imagestream/kicad/AP2000/README.TXT

These files have been created in prerelease version 6 of KiCAD. If Version 6 isn't released yet then to use them you will need to download a nightly build of KiCAD. NB Nightly builds my have issues so please check the issue tracker.   

To generate proper SMT positioning file for JLCPCB use this script:
~/JLCKicadTools//jlc_kicad_tools/generate_jlc_files.py -n AP3500 .
