imagestream/kicad/AP2100.ls1043/docs/AP2100-timeline-10-16.pdf

| | | 5/20 6/20 7/20 8/20 9/20 10/20 11/20 12/20
20 | 25 | 1 | 8 | 15 | 22 | 29 | 6 | 13 | 20 | 27 | 3 | 10 | 17 | 24 | 31 | 7 | 14 | 21 | 28 | 5 | 12 | 19 | 26 | 2 | 9 | 16 | 23 | 30 | 7 | 14
AP2100 | 0h | 60%
Block design | 0h | 100%
Initial design discussions, specificati... | 0 | 100%
CAD program evaluation | 0 | 100%
BOM / Parts management evaluation | 0 | 100%
KiCad training | 0 | 100%
Initial project setup, cad symbol libra... | 0 | 100%
Power requirements / spec design | 0 | 100%
Requirements review / refinement wi... | 0 | 100%
PoE block | 0 | 100%
Power block | 0 | 100%
Memory block | 0 | 100%
Add missing voltages to power | 0 | 100%
eMMC flash block | 0 | 100%
CPU Power Block | 0 | 100%
Camera research | 0 | 100%
JTAG / Serial / Reset block | 0 | 100%
USB | 0 | 100%
Ethernet block | 0 | 100%
mPCIe block | 0 | 100%
Mounting holes / heatsink block | 0 | 100%
Review | 0 | 100%
Layout / Routing | 0h | 23%
PoE | 0 | 100%
Power | 0 | 20%
Ethernet | 0 | 0%
eMMC flash | 0 | 0%
Memory | 0 | 0%
USB | 0 | 0%
JTAG / Serial | 0 | 0%
Camera mounting | 0 | 0%
Review | 0 | 0%
Production / assembly | 0h | 0%
BOM Parts acquisition 5 units | 0 | 0%
PCB fab - PCBWay | 0 | 0%
PCB assembly 1 unit | 0 | 0%
Debugging / initial turn on | 0 | 0%
Software load / initial testing | 0 | 0%
Rework layout for issues discovered | 0 | 0%
PCB fab - PCBWay | 0 | 0%
PCB assembly 3 units | 0 | 0%
Testing / prep to ship 3 units to Mexi... | 0 | 0%
Software | 0h | 0%
Add custom device tree to Opuntia / ... | 0 | 0%
Custom flash layout for MAC storage... | 0 | 0%
Customize scripts for board | 0 | 0%

Scott Yoder
Scott Yoder
Scott Yoder
Scott Yoder
Scott Yoder
Scott Yoder
Scott Yoder
Scott Yoder
Scott Yoder
Scott Yoder
Scott Yoder
Scott Yoder
Scott Yoder
Josh Snyder, Scott Yoder
Scott Yoder
Scott Yoder
Scott Yoder
Scott Yoder
Scott Yoder
Scott Yoder

Scott Yoder
Scott Yoder
Scott Yoder
Scott Yoder
Scott Yoder
Scott Yoder
Scott Yoder
Scott Yoder
Scott Yoder

Scott Yoder
Scott Yoder
Scott Yoder
Scott Yoder
Josh Snyder, Scott Yoder
Scott Yoder
Scott Yoder
Scott Yoder
Scott Yoder

Scott Yoder
Scott Yoder
Scott Yoder

20 | 25 | 1 | 8 | 15 | 22 | 29 | 6 | 13 | 20 | 27 | 3 | 10 | 17 | 24 | 31 | 7 | 14 | 21 | 28 | 5 | 12 | 19 | 26 | 2 | 9 | 16 | 23 | 30 | 7 | 14
5/20 | 6/20 | 7/20 | 8/20 | 9/20 | 10/20 | 11/20 | 12/20
Make custom U-boot | 0 | 0%
Camera software | 0 | 0%
Security chip programming | 0 | 0%
Production system integrations | 0 | 0%
Unrelated tasks | 0h | 100%
Reinstall / fix Queretero Cloud | 0 | 100%
Envoy-based Prototype | 0 | 100%

Scott Yoder
Scott Yoder
Scott Yoder
Scott Yoder

Scott Yoder
Scott Yoder

Powered by TCPDF (www.tcpdf.org)
