imagestream/kicad/AP2100.ls1043/docs/AP2100-timeline-09-23.pdf

20 | 25 | 1 | 8 | 15 | 22 | 29 | 6 | 13 | 20 | 27 | 3 | 10 | 17 | 24 | 31 | 7 | 14 | 21 | 28 | 5 | 12 | 19 | 26 | 2 | 9 | 16 | 23 | 30 | 7
5/20 | 6/20 | 7/20 | 8/20 | 9/20 | 10/20 | 11/20 | 12/20
AP2100 | 52%
Block design | 84%
Initial design discussions, specificati... | 100%
CAD program evaluation | 100%
BOM / Parts management evaluation | 100%
KiCad training | 100%
Initial project setup, cad symbol libra... | 100%
Power requirements / spec design | 100%
Requirements review / refinement wi... | 100%
PoE block | 100%
Power block | 100%
Memory block | 100%
Add missing voltages to power | 100%
eMMC flash block | 100%
CPU Power Block | 100%
Camera research | 100%
JTAG / Serial / Reset block | 20%
USB | 0%
Ethernet block | 0%
mPCIe block | 0%
Mounting holes / heatsink block | 0%
Review | 0%
Layout / Routing | 0%
Memory | 0%
eMMC flash | 0%
Ethernet | 0%
USB | 0%
MIPI | 0%
JTAG / Serial | 0%
PoE | 0%
Power | 0%
Camera mounting | 0%
Review | 0%
Production / assembly | 0%
BOM Parts acquisition 5 units | 0%
PCB fab - PCBWay | 0%
PCB assembly 1 unit | 0%
Debugging / initial turn on | 0%
Software load / initial testing | 0%
Rework layout for issues discovered | 0%
PCB fab - PCBWay | 0%
PCB assembly 3 units | 0%
Testing / prep to ship 3 units to Mexi... | 0%
Software | 0%
Add custom device tree to Opuntia / ... | 0%
Custom flash layout for MAC storage... | 0%

Scott Yoder
Scott Yoder
Scott Yoder
Scott Yoder
Scott Yoder
Scott Yoder
Scott Yoder
Scott Yoder
Scott Yoder
Scott Yoder
Scott Yoder
Scott Yoder
Scott Yoder
Scott Yoder
Scott Yoder
Scott Yoder
Scott Yoder
Scott Yoder
Scott Yoder
Scott Yoder

Scott Yoder
Scott Yoder
Scott Yoder
Scott Yoder
Scott Yoder
Scott Yoder
Scott Yoder
Scott Yoder
Scott Yoder
Scott Yoder

Scott Yoder
Scott Yoder
Scott Yoder
Scott Yoder
Scott Yoder
Scott Yoder
Scott Yoder
Scott Yoder
Scott Yoder

Scott Yoder
Scott Yoder

20 | 25 | 1 | 8 | 15 | 22 | 29 | 6 | 13 | 20 | 27 | 3 | 10 | 17 | 24 | 31 | 7 | 14 | 21 | 28 | 5 | 12 | 19 | 26 | 2 | 9 | 16 | 23 | 30 | 7
5/20 | 6/20 | 7/20 | 8/20 | 9/20 | 10/20 | 11/20 | 12/20
Customize scripts for board | 0%
Make custom U-boot | 0%
Camera software | 0%
Security chip programming | 0%
Production system integrations | 0%
Unrelated tasks | 100%
Reinstall / fix Queretero Cloud | 100%
Envoy-based Prototype | 100%

Scott Yoder
Scott Yoder
Scott Yoder
Scott Yoder
Scott Yoder

Scott Yoder
Scott Yoder

Powered by TCPDF (www.tcpdf.org)
