imagestream/kicad/AP2100.ls1043/docs/AP2100-timeline.pdf

| | | 5/20 6/20 7/20 8/20 9/20 10/20 11/20
20 | 25 | 1 | 8 | 15 | 22 | 29 | 6 | 13 | 20 | 27 | 3 | 10 | 17 | 24 | 31 | 7 | 14 | 21 | 28 | 5 | 12 | 19 | 26 | 2 | 9 | 16 | 23
AP2100 | 0h | 33%
Block design | 0h | 80%
Initial design discussions, specificati... | 0 | 100%
CAD program evaluation | 0 | 100%
BOM / Parts management evaluation | 0 | 100%
KiCad training | 0 | 100%
Initial project setup, cad symbol libra... | 0 | 100%
Power requirements / spec design | 0 | 100%
Requirements review / refinement wi... | 0 | 100%
PoE block | 0 | 100%
Power block | 0 | 100%
Memory block | 0 | 100%
eMMC flash block | 0 | 30%
JTAG / Serial / Reset block | 0 | 0%
USB / mipi block | 0 | 0%
Ethernet block | 0 | 0%
mPCIe block | 0 | 0%
Mounting holes / heatsink block | 0 | 0%
Review | 0 | 0%
Layout / Routing | 0h | 0%
Memory | 0 | 0%
eMMC flash | 0 | 0%
Ethernet | 0 | 0%
USB | 0 | 0%
MIPI | 0 | 0%
JTAG / Serial | 0 | 0%
PoE | 0 | 0%
Power | 0 | 0%
Review | 0 | 0%
Production / assembly | 0h | 0%
BOM Parts acquisition 5 units | 0 | 0%
PCB fab - PCBWay | 0 | 0%
PCB assembly 1 unit | 0 | 0%
Debugging / initial turn on | 0 | 0%
Software load / initial testing | 0 | 0%
Rework layout for issues discovered | 0 | 0%
PCB fab - PCBWay | 0 | 0%
PCB assembly 3 units | 0 | 0%
Testing / prep to ship 3 units to Mexi... | 0 | 0%
Software | 0h | 0%
Add custom device tree to Opuntia / ... | 0 | 0%
Custom flash layout for MAC storage... | 0 | 0%
Customize scripts for board | 0 | 0%
Make custom U-boot | 0 | 0%
Security chip programming | 0 | 0%
Production system integrations | 0 | 0%

Scott Yoder
Scott Yoder
Scott Yoder
Scott Yoder
Scott Yoder
Scott Yoder
Scott Yoder
Scott Yoder
Scott Yoder
Scott Yoder
Scott Yoder
Scott Yoder
Scott Yoder
Scott Yoder
Scott Yoder
Scott Yoder
Scott Yoder

Scott Yoder
Scott Yoder
Scott Yoder
Scott Yoder
Scott Yoder
Scott Yoder
Scott Yoder
Scott Yoder
Scott Yoder

Scott Yoder
Scott Yoder
Scott Yoder
Scott Yoder
Scott Yoder
Scott Yoder
Scott Yoder
Scott Yoder
Scott Yoder

Scott Yoder
Scott Yoder
Scott Yoder
Scott Yoder
Scott Yoder
Scott Yoder

Powered by TCPDF (www.tcpdf.org)
