imagestream/kicad/AP2100.ls1043/docs/Future-For-ImageStream-5.pdf

CONFIDENTIAL | 1

# Future Electronics Intelligent Solutions For IS ImageStream Internet Solutions

# WiFi AP / Router June 2, 2020

## Michael.Leung@FutureElectronics.com

# http://www.imagestream.com/ Selma, Texas

# Imagestream Team

# Scott Yoder, syoder@imagestream.com Josh Snyder, josh@imagestream.com

# Carlos.Martinez@FutureElectronics.com, Strategic Account Manager Puspa.Kunwor@FutureElectronics.com, Applications Engineer

Erwin.Wolniewitz@FutureElectronics.com, Regional Sales Manager, Future Intelligent Solutions

# Michael.Leung@FutureElectronics.com, Networking Specialist, Future Intelligent Solutions

# Requirements

# - SFP+ - 2.5G PoE (802.at) - GigE - 2 mPCIe to 3 mPCIe - 1 GB DDR to 2GB - Unique ID, to generate unique password per device - WiFI Modules

- 88w9064
- 88w8964

# - OpenWRT - Open vSwitch

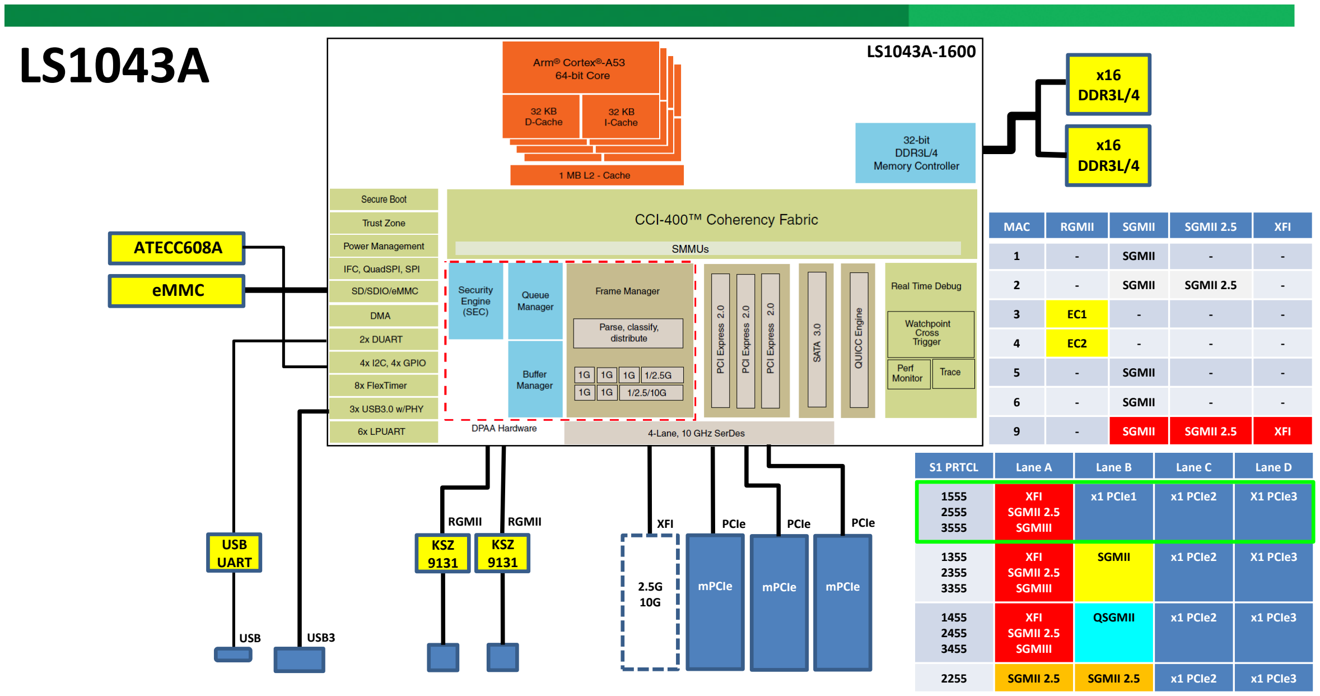
[picture p1: figure]
eMMC; mPCIe; USB; USB3; S1 PRTCL; Lane A; Lane B; Lane C; Lane D; XFI SGMII 2.5 SGMIII; x1 PCIe1; x1 PCIe2; X1 PCIe3; SGMII; QSGMII; x1 PCIe3; SGMII 2.5; RGMII; KSZ 9131; PCIe; MAC; XFI; x16 DDR3L/4; ATECC608A; USB UART

# Design Details

# LS1043A

### LS1043A-1600

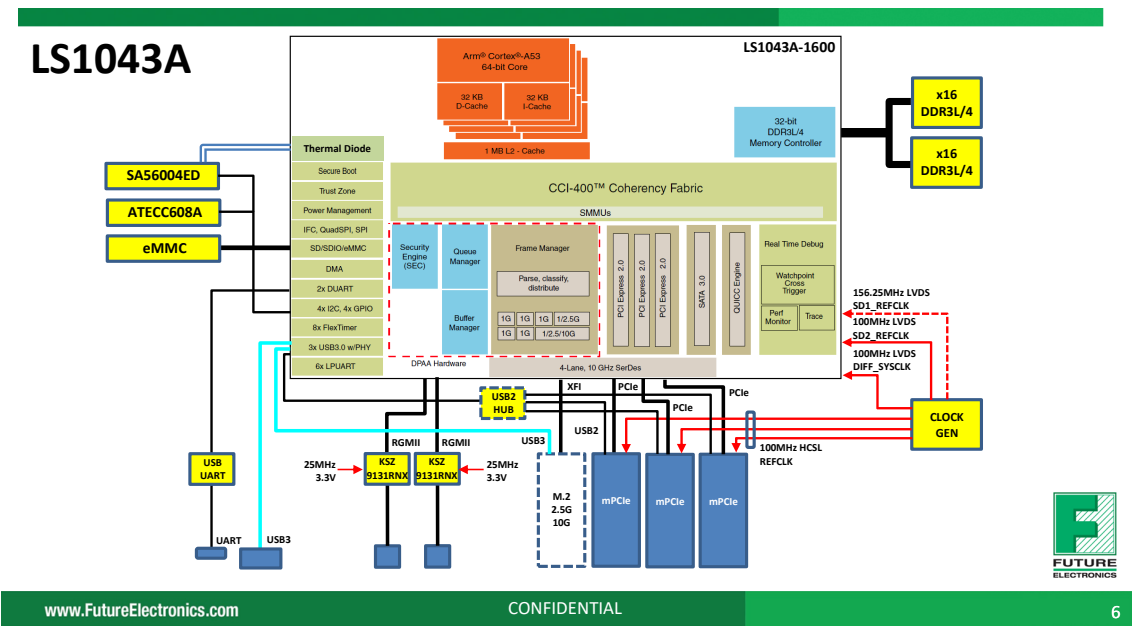
[picture p2: page 6]
eMMC; mPCIe; UART; USB3; RGMII; KSZ 9131RNX; PCIe; x16 DDR3L/4; ATECC608A; XFI; CLOCK; USB2; GEN; USB UART; USB2 HUB; 100MHz HCSL REFCLK; Thermal Diode; 100MHz LVDS SD2_REFCLK; 156.25MHz LVDS SD1_REFCLK; 100MHz LVDS DIFF_SYSCLK; 25MHz 3.3V

# LS1043A Clocks

156.25

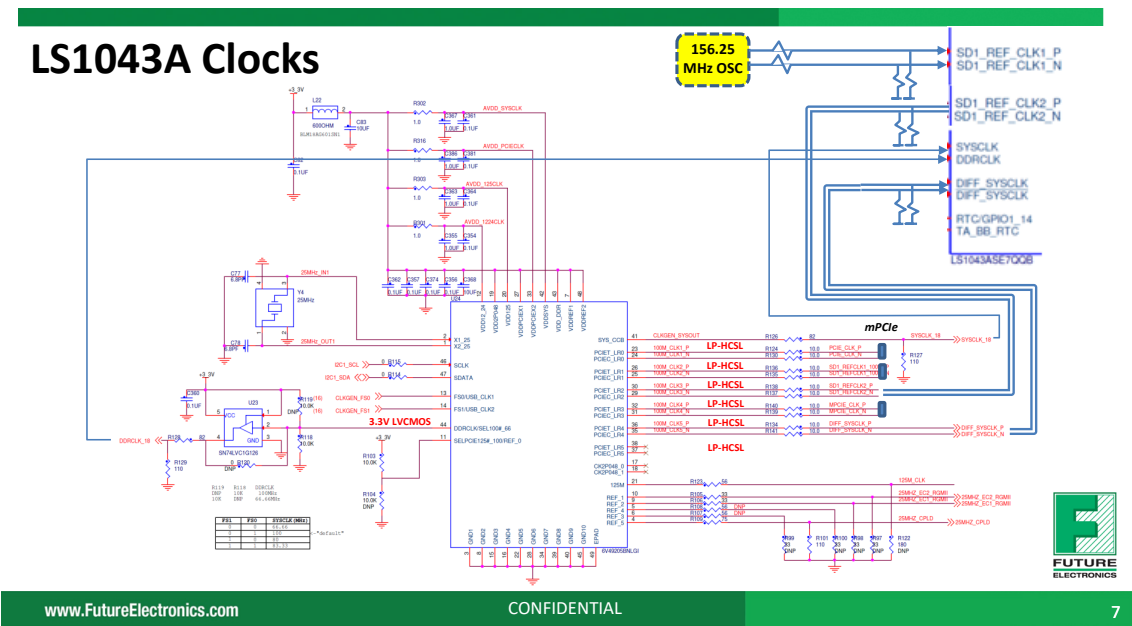
[picture p3: page 7]
mPCIe; MHz OSC; 3.3V LVCMOS; LP-HCSL

MFR | Qty | Devices (all commercial Temp) | Description | Stuffing Option
NXP | 1 | LS1043ASN7KQB LS1043ASN7MQB LS1043ASN7PQB LS1043ASN7QQB | LS1043A-1000, DDR-1600, (use ASE if crypto rqd) LS1043A-1200, DDR-1600, (use ASE if crypto rqd) LS1043A-1400, DDR-1600, (use ASE if crypto rqd) LS1043A-1600, DDR-1600, (use ASE if crypto rqd)
Kingston | 1 | EMMC04G-M627 | 4GB eMMC
Alliance Memory Alliance Memory Kingston Kingston ------------------------------Alliance Memory Kingston Samsung | 2 AS4C512M16D3LC-12BCN | AS4C512M16D3L-12BCN D2516ECBDXGGGB-U B5116ECMDXGGB-U -----------------------------------------------------------------AS4C256M16D4-93BCN D2516ACPCXGPH-U K4A8G165WC-BCRC | 4Gbit DDR3L (256Mx16)-1600 8Gbit DDR3L (512Mx16)-1600 4Gbit DDR3L (256Mx16)-1600 8Gbit DDR3L (512Mx16)-1600 ---------------------------------------------------------------------4Gbit DDR4 (256Mx16)-2400 4Gbit DDR4 (256Mx16)-2400 8Gbit DDR4 (512Mx16)-2400
Microchip | 1 | ATECC608A-TFLXTLSU | Secure Element (TrustFlexTLS Provisioned) UDFN
Microchip | 2 | KSZ9131RNX | RGMII GigE PHY
NXP Onsemi | 1 SA56004AD | ADM1032ARZ | Remote and Local Thermal Monitor (± 1⁰C)
FTDI Microchip | 1 FT230XQ | MCP2200-I/MQ | USB UART
Microchip | 1 | USB2513B/M2 USB2514B/M2 | 3-port USB2 Hub 4-port USB2 Hub | Optional
Renesas/IDT | 1 | 6V49205BNLGI | Clock Generator
Renesas/IDT | 1 | XUN515156.250000 | 156.25MHz HCSL Osc, Pin 1 Enb, 1.8V, 50ppm, 400fs,5x3mm | Optional
| 3 mPCIe Socket
| 1 | | M.2 Socket | Optional

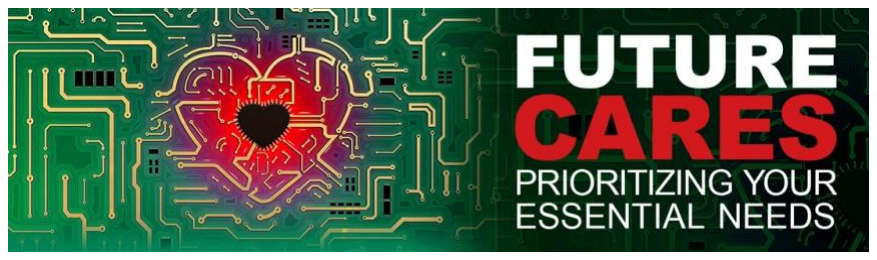
[picture p4: figure]
