imagestream/kicad/AP2000/Labels/TopLabel-Body.pdf

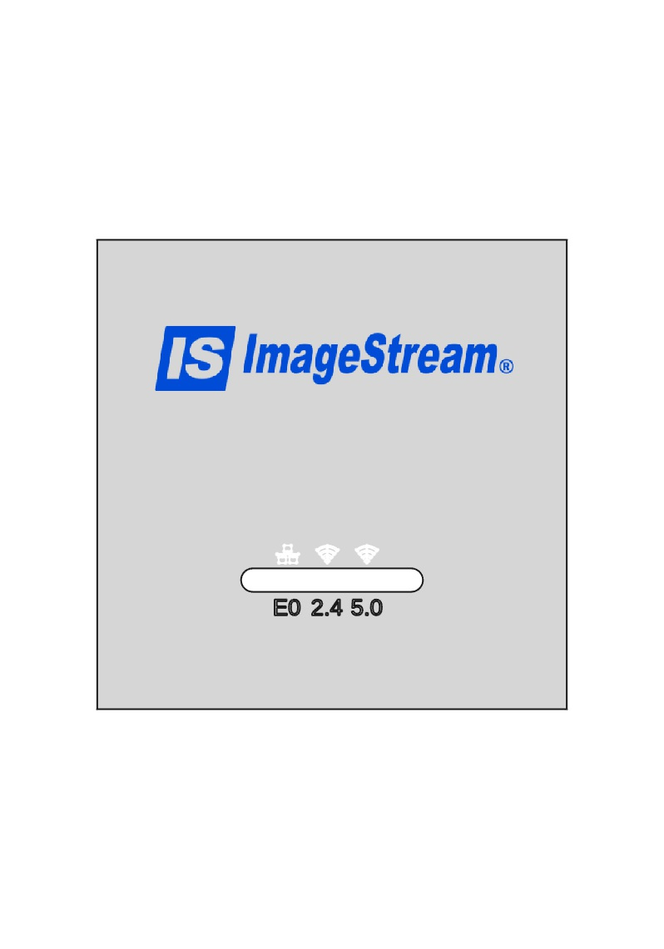
[picture p5: page 1]
