imagestream/kicad/AP2100.ls1043/docs/Future-For-ImageStream-3.pdf

CONFIDENTIAL | 1

# Future Electronics Intelligent Solutions For IS ImageStream Internet Solutions

# WiFi AP / Router May 22, 2020

# Michael.Leung@FutureElectronics.com

# http://www.imagestream.com/ Selma, Texas

# Imagestream Team

# Scott Yoder, syoder@imagestream.com Josh Snyder, josh@imagestream.com

# Carlos.Martinez@FutureElectronics.com, Strategic Account Manager Puspa.Kunwor@FutureElectronics.com, Applications Engineer

Erwin.Wolniewitz@FutureElectronics.com, Regional Sales Manager, Future Intelligent Solutions

# Michael.Leung@FutureElectronics.com, Networking Specialist, Future Intelligent Solutions

# Requirements

# - SFP+ - 2.5G PoE (802.at) - GigE - 2 mPCIe to 3 mPCIe - 1 GB DDR to 2GB - Unique ID, to generate unique password per device - WiFI Modules

- 88w9064
- 88w8964

# - OpenWRT - Open vSwitch

# Options

# Low End - LS1012A

# High End - LS1023A/LS1043A - LS1026A/LS1046A

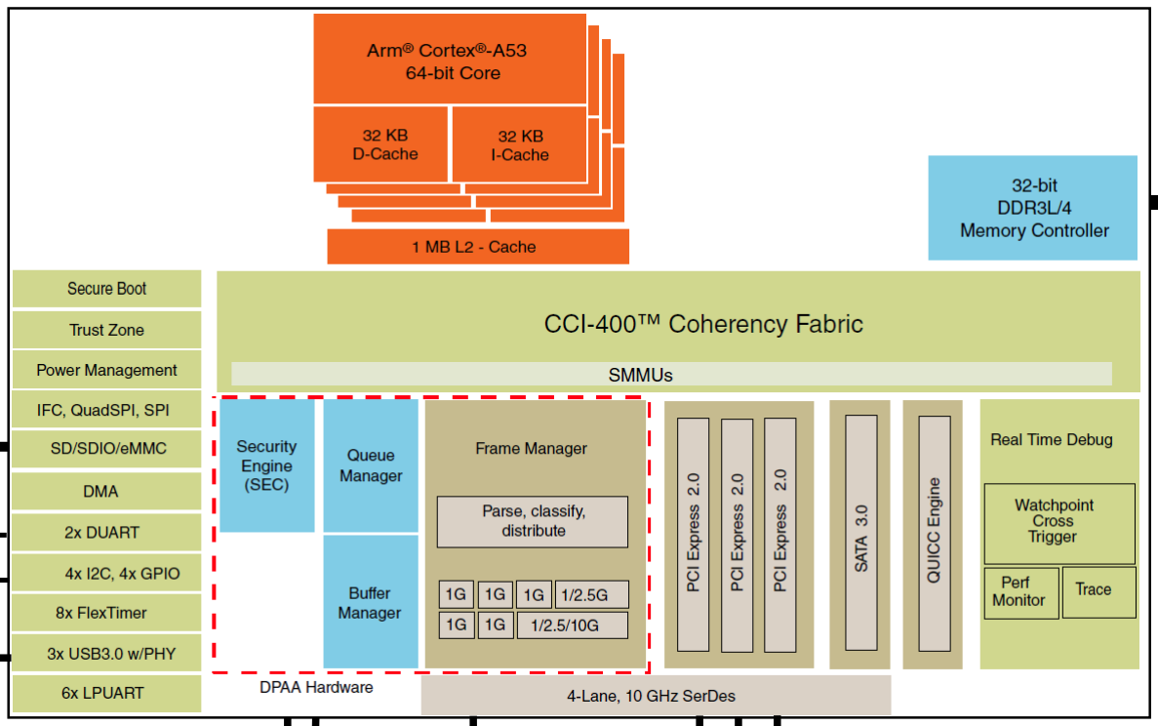
[picture p6: figure]

## eMMC

1/2.5G/
10G
SFP+

1/2.5G
SFP

M.2/
mPCIe

UART USB3

VSC
7224

M.2/
mPCIe
S1 PRTCL | Lane A | Lane B | Lane C | Lane D
1555 2555 3555 | XFI SGMII 2.5 SGMIII | x1 PCIe1 | x1 PCIe2 | X1 PCIe3
1355 2355 3355 | XFI SGMII 2.5 SGMIII | SGMII | x1 PCIe2 | X1 PCIe3
1455 2455 3455 | XFI SGMII 2.5 SGMIII | QSGMII | x1 PCIe2 | x1 PCIe3
2255 | SGMII 2.5 | SGMII 2.5 | x1 PCIe2 | x1 PCIe3
RGMII | RGMII
KSZ
9131

KSZ
9131

XFI

PCIe | PCIe

M.2/
mPCIe

PCIe

MAC | RGMII | SGMII | SGMII 2.5 | XFI
1 | - | SGMII | - | -
2 | - | SGMII | SGMII 2.5 | -
3 | EC1 | - | - | -
4 | EC2 | - | - | -
5 | - | SGMII | - | -
6 | - | SGMII | - | -
9 | - | SGMII | SGMII 2.5 | XFI

# [1] LS1043A

x16

### DDR3L/4

x16

### DDR3L/4

## ATECC608A

802.3at
PoE PD

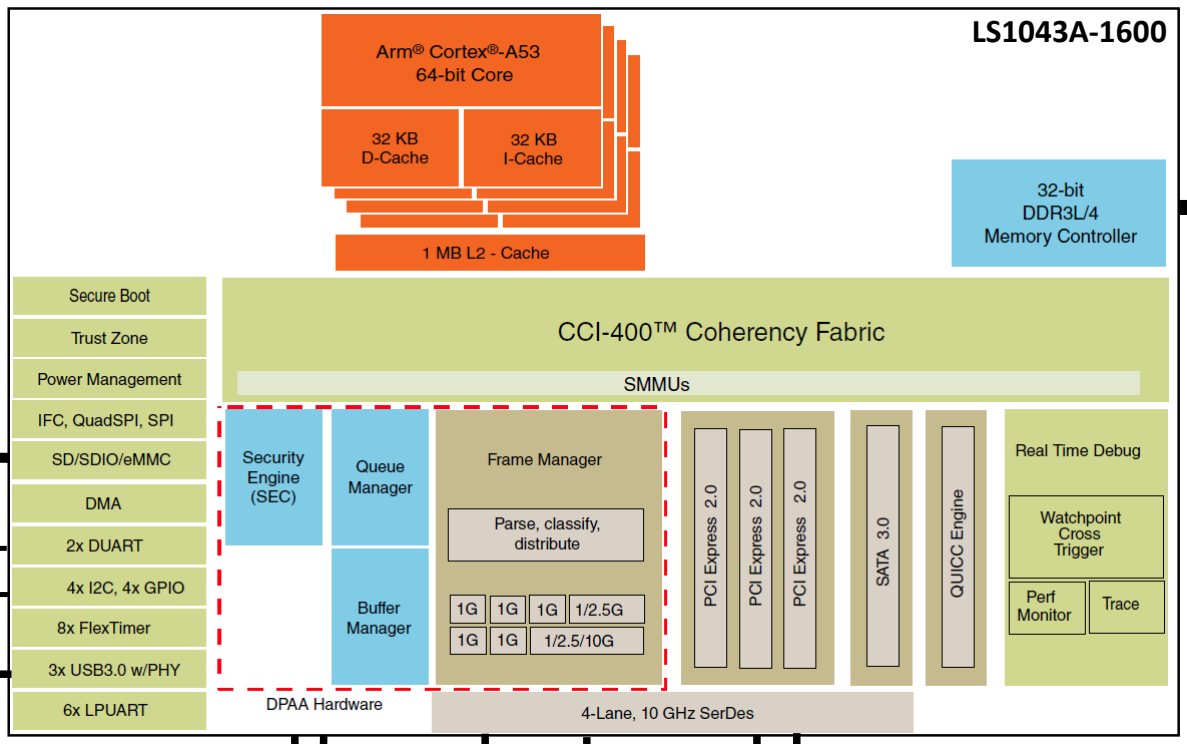
[picture p7: figure]

## eMMC

1/2.5G/
10G
SFP+

M.2/
mPCIe

UART USB3

VSC
7224

M.2/
mPCIe
S1 PRTCL | Lane A | Lane B | Lane C | Lane D
1555 2555 3555 | XFI SGMII 2.5 SGMIII | x1 PCIe1 | x1 PCIe2 | X1 PCIe3
1355 2355 3355 | XFI SGMII 2.5 SGMIII | SGMII | x1 PCIe2 | X1 PCIe3
1455 2455 3455 | XFI SGMII 2.5 SGMIII | QSGMII | x1 PCIe2 | x1 PCIe3
RGMII | RGMII
KSZ
9131

KSZ
9131

XFI

PCIe | PCIe
MAC | RGMII | SGMII | SGMII 2.5 | XFI
1 | - | SGMII | - | -
2 | - | SGMII | SGMII 2.5 | -
3 | EC1 | - | - | -
4 | EC2 | - | - | -
5 | - | SGMII | - | -
6 | - | SGMII | - | -
9 | - | SGMII | SGMII 2.5 | XFI

1/2.5G
SFP

AQR
109

1000BASE-T

# [2] LS1043A

x16

### DDR3L/4

x16

### DDR3L/4

## ATECC608A

802.3at
PoE PD

## eMMC

1/2.5G
SFP

M.2/
mPCIe

UART USB3

VSC
7224

M.2/
mPCIe
S1 PRTCL | Lane A | Lane B | Lane C | Lane D
1555 2555 3555 | XFI SGMII 2.5 SGMIII | x1 PCIe1 | x1 PCIe2 | X1 PCIe3
1355 2355 3355 | XFI SGMII 2.5 SGMIII | SGMII | x1 PCIe2 | X1 PCIe3
1455 2455 3455 | XFI SGMII 2.5 SGMIII | QSGMII | x1 PCIe2 | x1 PCIe3
RGMII | RGMII
KSZ
9131

KSZ
9131

XFI

PCIe | PCIe
MAC | RGMII | SGMII | SGMII 2.5 | XFI
1 | - | SGMII | - | -
2 | - | SGMII | SGMII 2.5 | -
3 | EC1 | - | - | -
4 | EC2 | - | - | -
5 | - | SGMII | - | -
6 | - | SGMII | - | -
9 | - | SGMII | SGMII 2.5 | XFI

1/2.5G
SFP

AQR
109

2.5GBASE-T

# [3] LS1043A

x16

### DDR3L/4

x16

### DDR3L/4

## ATECC608A

802.3at
PoE PD

1/2.5G
SFP

AQR
109

1000BASE-T

## eMMC

1/2.5G/
10G
SFP+

M.2/
mPCIe

UART USB3

VSC
7224

M.2/
mPCIe
S1 PRTCL | Lane A | Lane B | Lane C | Lane D
1555 2555 3555 | XFI SGMII 2.5 SGMIII | x1 PCIe1 | x1 PCIe2 | X1 PCIe3
1355 2355 3355 | XFI SGMII 2.5 SGMIII | SGMII | x1 PCIe2 | X1 PCIe3
1455 2455 3455 | XFI SGMII 2.5 SGMIII | QSGMII | x1 PCIe2 | x1 PCIe3
RGMII | RGMII
KSZ
9131

KSZ
9131

XFI

PCIe | PCIe

M.2/
mPCIe

PCIe

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

# [4] LS1043A

x16

### DDR3L/4

x16

### DDR3L/4

## ATECC608A

802.3at
PoE PD

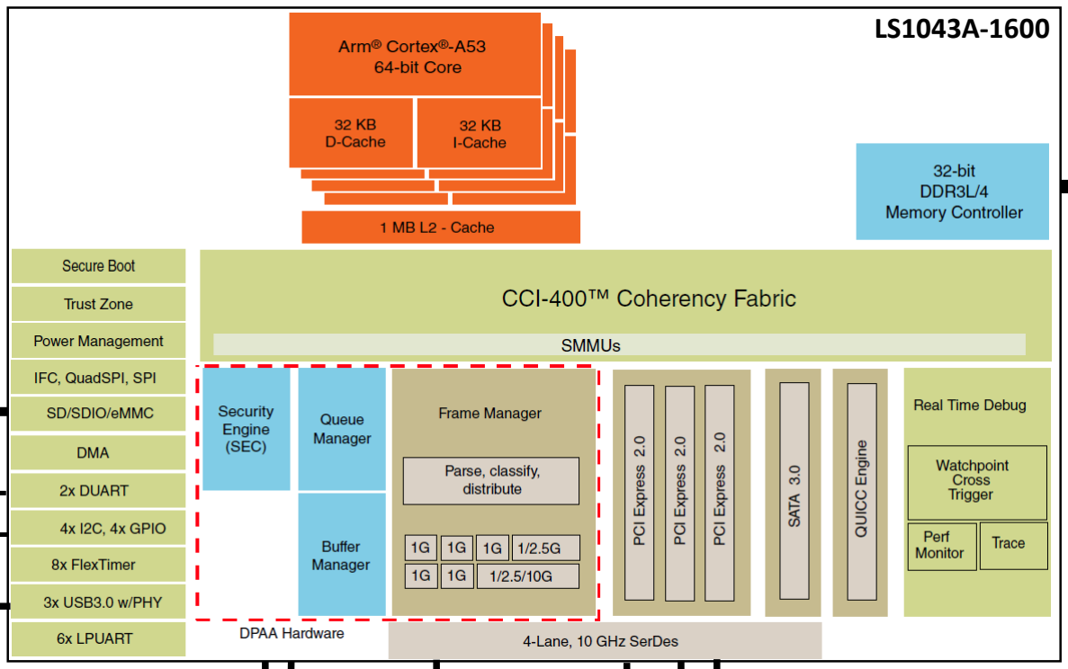
[picture p8: figure]

# [5] LS1043A

AQR
107/9

nBASE-T

## eMMC

1/2.5G/
10G
SFP+

M.2/
mPCIe

UART USB3

VSC
7224

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

KSZ
9131
PCIe | PCIe

M.2/
mPCIe

PCIe

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

x16

### DDR3L/4

x16

### DDR3L/4

## ATECC608A

802.3at
PoE PD

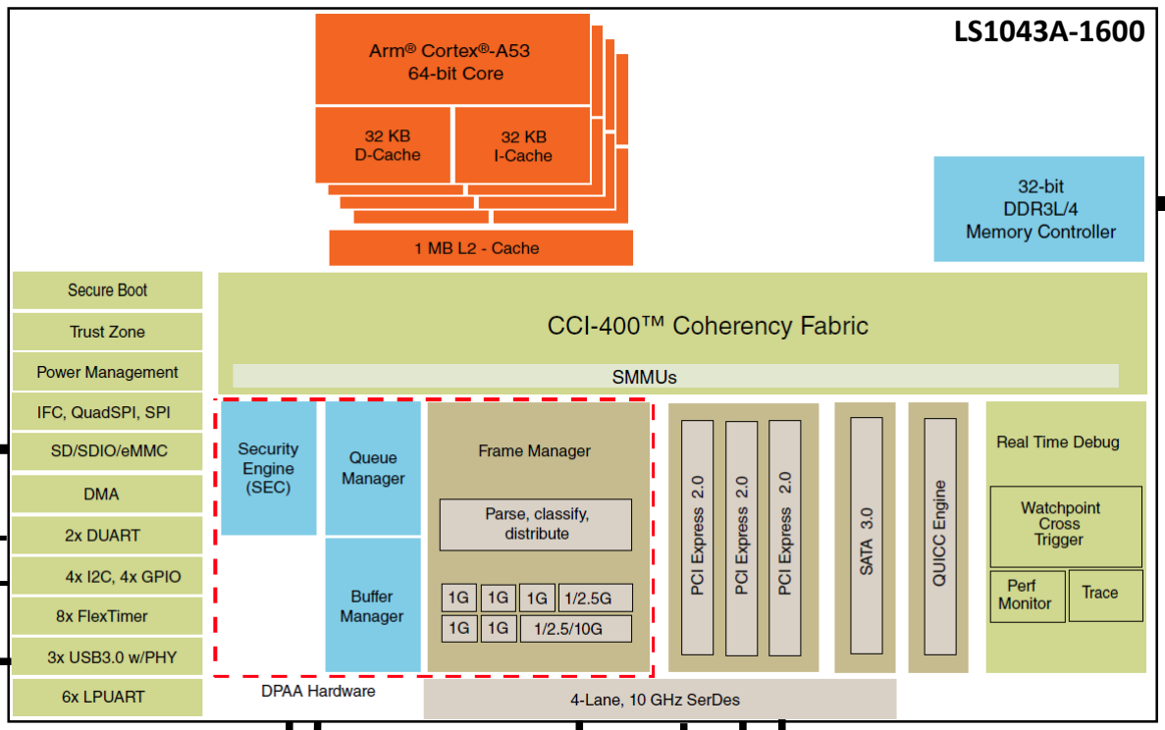
[picture p9: figure]

1/2.5G
SFP

AQR
107/9

10GBASE-T
2.5GBASE-T

## eMMC

M.2/
mPCIe

UART USB3

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

KSZ
9131
PCIe | PCIe

M.2/
mPCIe

PCIe

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

# [6] LS1043A

x16

### DDR3L/4

x16

### DDR3L/4

## ATECC608A

802.3at
PoE PD

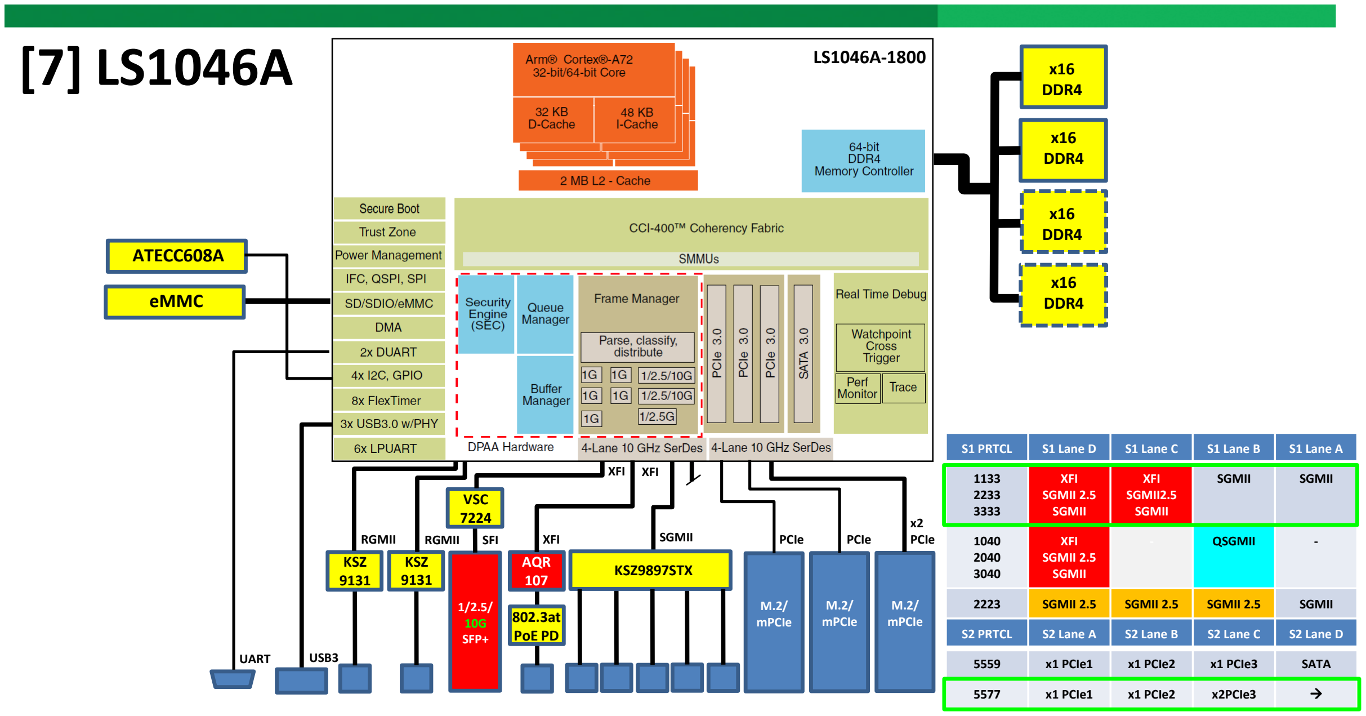
[picture p10: figure]
S2 PRTCL; S2 Lane A; S2 Lane B; S2 Lane C; S2 Lane D; x1 PCIe1; x1 PCIe2; x1 PCIe3; SATA; x2PCIe3; eMMC; 1/2.5/ 10G SFP+; UART; USB3; S1 PRTCL; S1 Lane D; S1 Lane C; S1 Lane B; S1 Lane A; XFI SGMII 2.5 SGMII; XFI SGMII2.5 SGMII; SGMII; QSGMII; SGMII 2.5; VSC 7224; M.2/ mPCIe; RGMII; KSZ 9131; XFI; SFI; 1/2.5G SFP; AQR 107; KSZ9897STX; PCIe; x2 PCIe; x16 DDR4; ATECC608A; 802.3at PoE PD

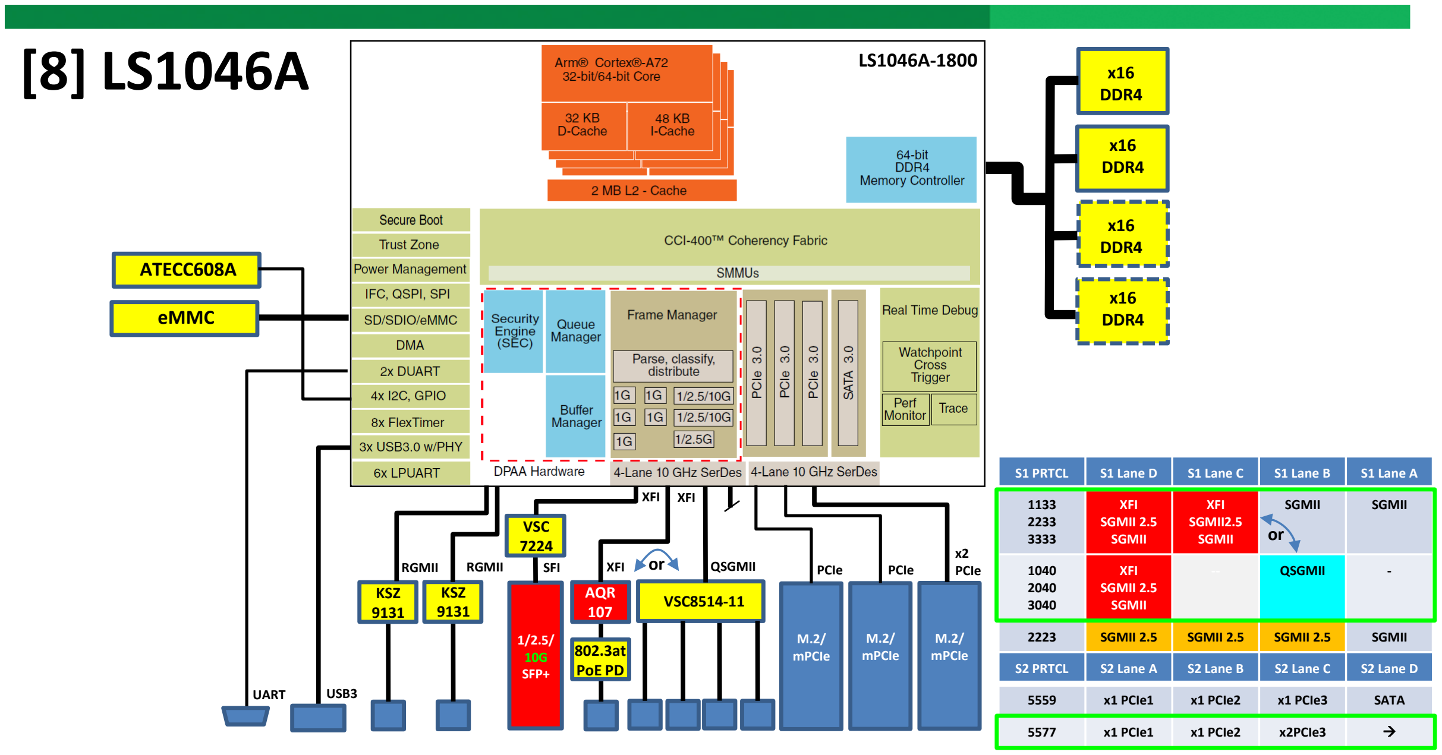
[picture p11: figure]
S2 PRTCL; S2 Lane A; S2 Lane B; S2 Lane C; S2 Lane D; x1 PCIe1; x1 PCIe2; x1 PCIe3; SATA; x2PCIe3; eMMC; 1/2.5/ 10G SFP+; UART; USB3; S1 PRTCL; S1 Lane D; S1 Lane C; S1 Lane B; S1 Lane A; XFI SGMII 2.5 SGMII; XFI SGMII2.5 SGMII; SGMII or; SGMII; QSGMII; SGMII 2.5; VSC 7224; M.2/ mPCIe; RGMII; KSZ 9131; XFI; SFI; 1/2.5G SFP; AQR 107; VSC8514-11; PCIe; x2 PCIe; x16 DDR4; ATECC608A; 802.3at PoE PD

# Summary

Option | 1 | 2 | 3 | 4 | 5 | 6 | 7 | 8
Processor | LS1043A | LS1043A | LS1043A | LS1043A | LS1043A | LS1043A | LS1046A | LS1046A
mPCIe/M.2 | 3 mPCIe | 2 mPCIe | 2 mPCIe | 2/[3]mPCIe | 3 mPCIe | 3 mPCIe | 3 mPCIe | 3 mPCIe
SFP+ | 1G SFP 2.5G SFP 10G SFP+ | 1G SFP 2.5G SFP 10G SFP+ | 1G SFP 2.5G SFP - | 1G SFP 2.5G SFP [10G SFP+] | [1G SFP 2.5G SFP 10G SFP+ ] | - 1G SFP | 2.5G SFP 10G SFP+ | 1G SFP 2.5G SFP 10G SFP+
nBase-T | -- | 1GBase-T - | 1GBase-T 2.5GBase-T | [1GBase-T] [2.5GBase-T] | [1GBase-T 2.5GBase-T 10GBaseT] | 1GBase-T 2.5GBase-T 10GBaseT | 1GBase-T 2.5GBase-T 10GBaseT | [1GBase-T 2.5GBase-T 10GBaseT]
1000Base-T | 2 GigE | 2 GigE | 2 GigE | 2 GigE | 2 GigE | 2 GigE | 2 GigE + 5 Switched | 2+[4] GigE
Notes | | | | Configurable Combo | Either SFP+ or 10GBase-T | | Both SFP+ and 10GBase-T | Either 4 more 1G or 10GBase-T
