imagestream/kicad/AP2000/Labels/AP2000.png

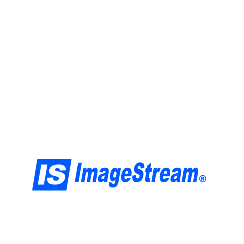
AP2000/Labels/AP2000.png
