imagestream/kicad/AP2000/Labels/TopLabel.FCStd

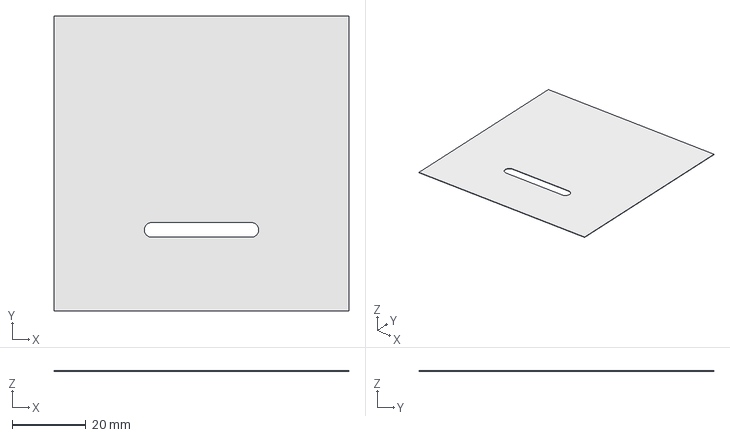
[picture p13: CAD file, 2021-09-24]
AP2000/Labels/TopLabel.FCStd
80.0 x 80.0 x 0.175 mm
