imagestream/kicad/AP2100.ls1043/docs/Enclosure_Top.FCStd

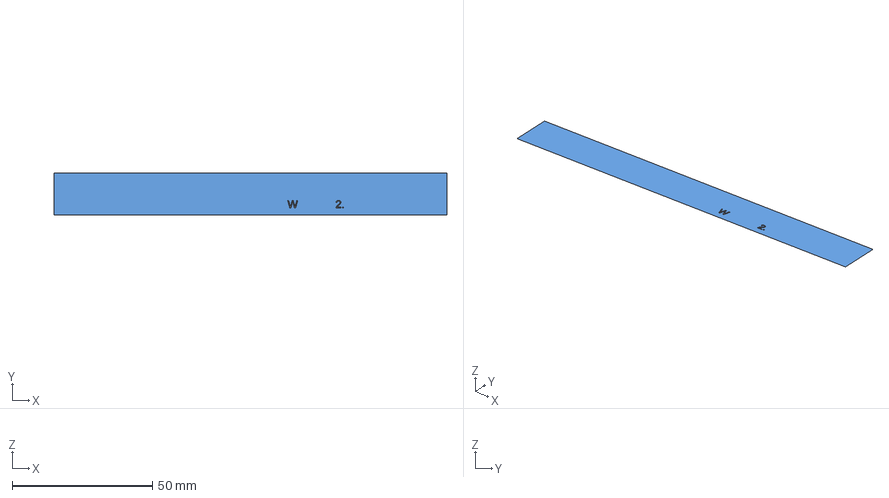
[picture p14: CAD file, 2020-09-23]
AP2100.ls1043/docs/Enclosure_Top.FCStd
140.0 x 15.0 x 0 mm
ShapeString
ShapeString001
ShapeString003
ShapeString002
Rectangle
