imagestream/kicad/AP2000/HeatSink/AP2000_HeatSink.FCStd

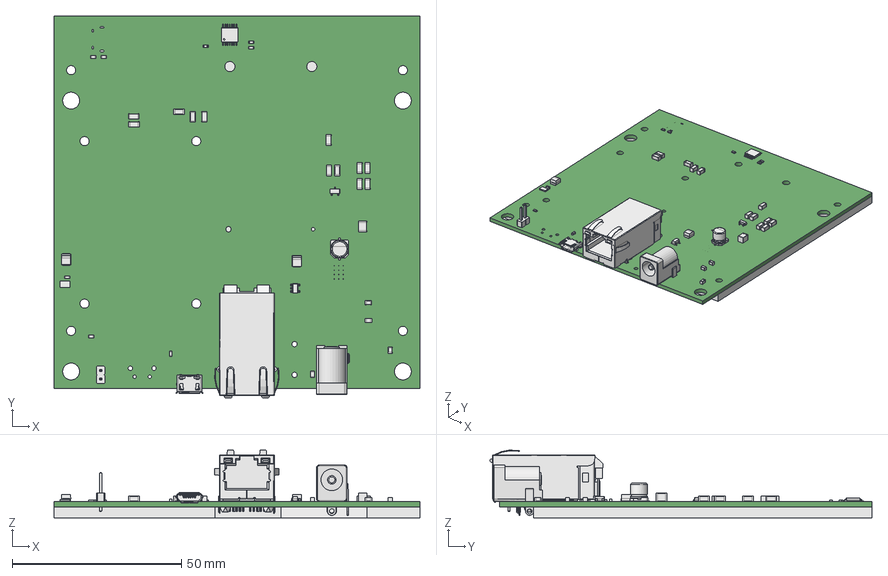
[picture p15: CAD file, 2021-09-24]
AP2000/HeatSink/AP2000_HeatSink.FCStd
108.0 x 112.8 x 20.0 mm
AP2000_PCB
