imagestream/kicad/AP2000/Labels/TopLabel-Body.dxf

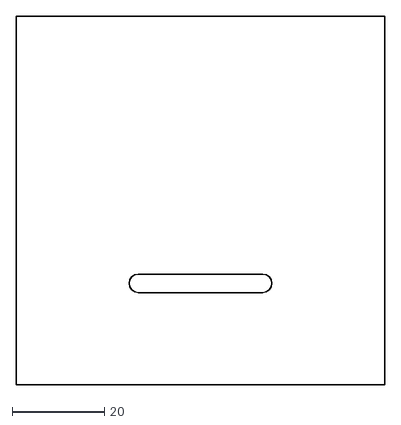
[picture p16: CAD file, 2021-09-24]
AP2000/Labels/TopLabel-Body.dxf
80.0 x 80.0
