imagestream/kicad/AP2100.ls1043/docs/Enclosure Bottom_2020-07-15_19-27-11.dxf

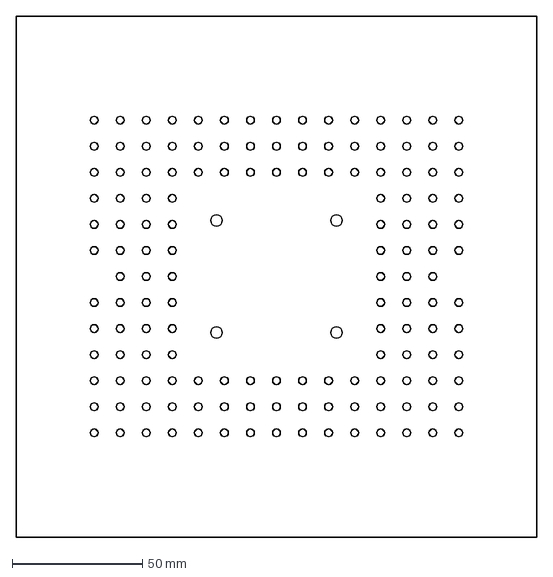
[picture p17: CAD file, 2020-09-23]
AP2100.ls1043/docs/Enclosure Bottom_2020-07-15_19-27-11.dxf
200.0 x 200.0 mm
