imagestream/kicad/AP2000/HeatSink/AP2000_HeatSink-BodyPocket001.dxf

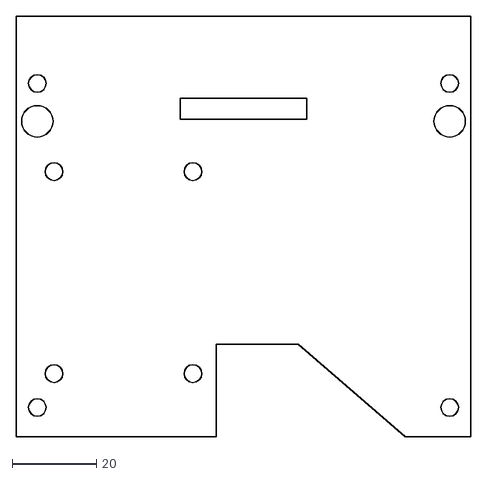
[picture p18: CAD file, 2021-09-24]
AP2000/HeatSink/AP2000_HeatSink-BodyPocket001.dxf
108.0 x 100.0
