imagestream/kicad/AP2100.ls1043/docs/Front Cutout_2020-07-15_19-18-49.dxf

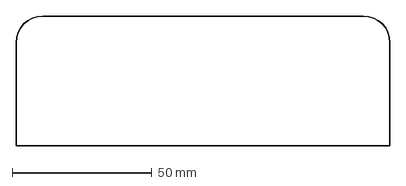
[picture p19: CAD file, 2020-09-23]
AP2100.ls1043/docs/Front Cutout_2020-07-15_19-18-49.dxf
134.0 x 46.5 mm
