imagestream/kicad/AP2100.ls1043/docs/Enclosure top_2020-07-15_19-33-49.dxf

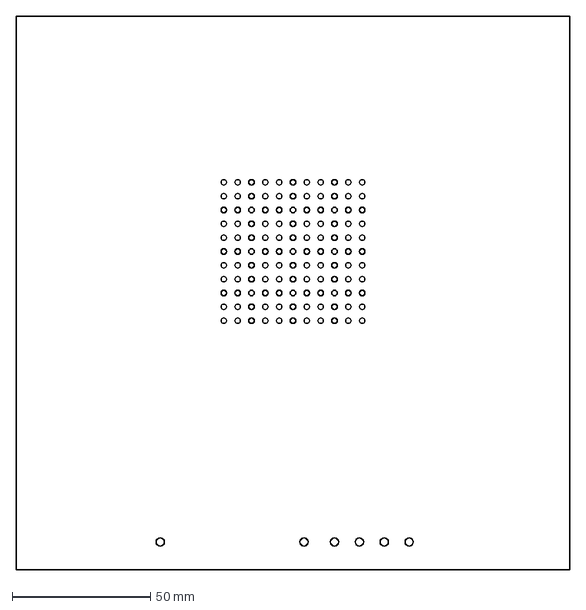
[picture p20: CAD file, 2020-09-23]
AP2100.ls1043/docs/Enclosure top_2020-07-15_19-33-49.dxf
200.0 x 200.0 mm
