imagestream/kicad/AP2000/shapes3D/10118194-0001LF.step

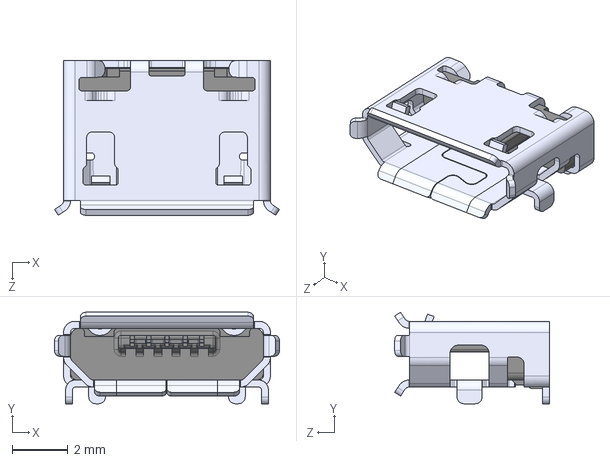
[picture p21: CAD file, 2021-09-22]
AP2000/shapes3D/10118194-0001LF.step
8.05 x 3.27 x 5.53 mm
