imagestream/kicad/(list of files, cad)

Other CAD files:
AP2000/HeatSink/AP2000_HeatSink-BodyXY_Plane039.dxf
AP2000/Labels/ISLogo.dxf
AP2000/HeatSink/AP2000_HeatSink-AP2000 1.dxf
