imagestream/kicad/AP2000/TopCoverVents/FoxAlienSetup.txt

Machine coords for 0 0 0: -38.2 -60.5 2.172

baud 115200
