imagestream/kicad/AP2100.ls1043/docs/Reference Docs/Other Designs/SPF-28673_B.pdf

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
# Table of Contents

# DDR

# 2 Notes

3

# Revisions

Rev | Description
X1 | Original Release

Approved Date

### Dec 05, 2014

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
# IFC BUS CPU MISC & MBED ETHERNET RGMII & 1588 ETHERNET SGMII SERDES & CLK SDHC & USB CPLD & DIP SW CPU POWER

# TWR-LS1021A-PB

# POWER SUPPLY (3.3V & MISC) POWER SUPPLY (VR500 PMIC) TWR-ELEV CON

### TWR-LS1021A draft revision for Rev2.0 LS1021A/LS1020A silicon

# Revision History

X1

### Rev

# 15 2D-ACE

### 1. Change PWR Solution by FSL parts 2. Support deep-sleep 3. Changed NOR flash to MT28EW01GABA1HJS-0SIT

4. Changed IFC_ADDR[16:18] connection from SOC to NOR directly.

### 5. Added IFC_ADDR[15] to ELEV D76 pin

6. Added C363 for USB_HVDD filter circuit.

### Tom Sun

A | RevA Final Release | Jan 20, 2015 | Tom Sun
A | No circuit change only upgrade document revision.
B | 1. Remove mux part U39, U38 and C331, C348;
2. Change SATA connector to Molex 67800-5025.
3. Add J24 SATA PWR.
4. Add U54, U55 INA220 instead of LTC2945 current monitor.
5. RGMII_PHY_INT_N_18 go through CPLD then to SOC INT.

### 6. Asleep LED driver changed to always ON +3V3_PMIC

7. Connect IRQ_C from ELEV to CPLD.
8. R746 changed to 47ohm.
B | RevB Final Release | May 29, 2015 | Tom Sun

Drawing Title:

Size | Document Number | Rev
Date: | Sheet | of

Page Title:

Designer:

Drawn by:

Approved:

## Digital Networking Product Group

6501 William Cannon Drive West
Austin, TX 78735-8598
This document contains information proprietary to Freescale and shall not be used for engineering design, procurement or manufacture in whole or in part without the express written permission of Freescale.
ICAP Classification: | FCP: | FIUO: | PUBI:
SCH-28673 PDF: SPF-28673 | B

# TWR-LS1021A-PB

C

Sunday, May 31, 2015

## COVER PAGE

Gan Fulian/B27268

Tom Sun

Gan Fulian/B27268

1 | 15 ____ | ____ X Drawing Title: Size | Document Number | Rev Date: | Sheet | of Page Title: Designer: Drawn by: Approved:

## Digital Networking Product Group

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

## COVER PAGE

Gan Fulian/B27268

Tom Sun

Gan Fulian/B27268

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

## Digital Networking Product Group

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

## COVER PAGE

Gan Fulian/B27268

Tom Sun

Gan Fulian/B27268

1 | 15 ____ | ____ X

Copyright 2015, by Freescale.

# The enclosed files are for reference purposes only and are not warranted as

to suitability for any other purposes.

# Copyright Freescale, 1999-2015 ALL RIGHTS RESERVED

# You are hereby granted a copyright license to use, modify the enclosed PCB layout and/or Schematics files, soley in conjunction with the development and marketing of your products whitch use and incorporate microprocessors whitch implement the PowerPC(TM) architecture

manufactured by Freescale.

# No licenses are granted by implication, estoppels or otherwise under any

patents or trademarks of Freescale.

These files are provided on an "AS IS" basis and without warranty. To the maximum extent permitted by applicable law, FREESCALE DISCLAIMS ALL WARRANTIES WHETHER EXPRESS OR IMPLIED, INCLUDING IMPLIED WARRANTIES OF MECHANTABILTY OR FITNESS FOR A PARTICULAR PURPOSE AND ANY WARRANTY AGAINST INFRINGEMENT WITH REGARD TO THE DESIGN FILES (INCLUDING ANY ANY MODIFIED VERSIONS THEREOF) AND ANY ACCOMPANYING

WRITTEN MATERIALS.

# To the maximum extent permitted by applicable law, IN NO EVENT SHALL FREESCALE BE LIABLE FOR ANY DAMAGES WHATSOEVER (INCLUDING WITHOUT LIMITATION, DAMAGES FOR LOSS OF BUSINESS PROFITS, BUSINESS INTERRUPTION, LOSS OF BUSINESS INFORMATION, OR OTHER PECUNIARY LOSS)

ARISING OF THE USE OR INABILITY TO USE THESE DESIGN FILES.

# Freescale assumes no responsibility for the maintenance and

support of the PCB design files.

Copyright 2015, by Freescale.

# The enclosed files are for reference purposes only and are not warranted as

to suitability for any other purposes.

# Copyright Freescale, 1999-2015 ALL RIGHTS RESERVED

# You are hereby granted a copyright license to use, modify the enclosed PCB layout and/or Schematics files, soley in conjunction with the development and marketing of your products whitch use and incorporate microprocessors whitch implement the PowerPC(TM) architecture

manufactured by Freescale.

# No licenses are granted by implication, estoppels or otherwise under any

patents or trademarks of Freescale.

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

WRITTEN MATERIALS.

# To the maximum extent permitted by applicable law, IN NO EVENT SHALL FREESCALE BE LIABLE FOR ANY DAMAGES WHATSOEVER (INCLUDING WITHOUT LIMITATION, DAMAGES FOR LOSS OF BUSINESS PROFITS, BUSINESS INTERRUPTION, LOSS OF BUSINESS INFORMATION, OR OTHER PECUNIARY LOSS)

ARISING OF THE USE OR INABILITY TO USE THESE DESIGN FILES.

# Freescale assumes no responsibility for the maintenance and

support of the PCB design files.

Copyright 2015, by Freescale.

# The enclosed files are for reference purposes only and are not warranted as

to suitability for any other purposes.

# Copyright Freescale, 1999-2015 ALL RIGHTS RESERVED

# You are hereby granted a copyright license to use, modify the enclosed PCB layout and/or Schematics files, soley in conjunction with the development and marketing of your products whitch use and incorporate microprocessors whitch implement the PowerPC(TM) architecture

manufactured by Freescale.

# No licenses are granted by implication, estoppels or otherwise under any

patents or trademarks of Freescale.

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

WRITTEN MATERIALS.

# To the maximum extent permitted by applicable law, IN NO EVENT SHALL FREESCALE BE LIABLE FOR ANY DAMAGES WHATSOEVER (INCLUDING WITHOUT LIMITATION, DAMAGES FOR LOSS OF BUSINESS PROFITS, BUSINESS INTERRUPTION, LOSS OF BUSINESS INFORMATION, OR OTHER PECUNIARY LOSS)

ARISING OF THE USE OR INABILITY TO USE THESE DESIGN FILES.

# Freescale assumes no responsibility for the maintenance and

support of the PCB design files.

# 1. Unless Otherwise Specified: All resistors are in ohms, 5%, 1/8 Watt

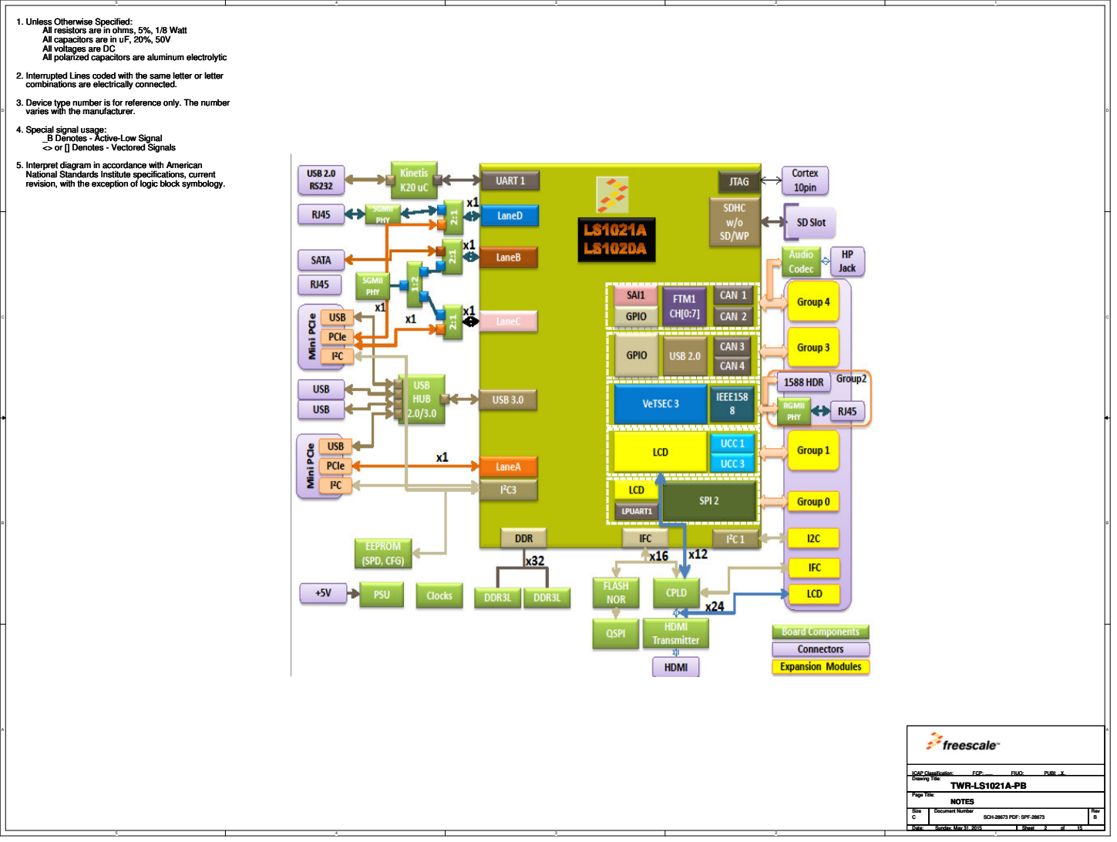
[picture p22: page 2]
NOTES; ___X Drawing Title: Size; Document Number; Rev Date:; Sheet; of Page Title: ICAP Classification:; FCP:; FIUO:; PUBI: SCH-28673 PDF: SPF-28673; B TWR-LS1021A-PB C; Sunday, May 31, 2015 NOTES

1. Unless Otherwise Specified:

All resistors are in ohms, 5%, 1/8 Watt
All capacitors are in uF, 20%, 50V
All voltages are DC
All polarized capacitors are aluminum electrolytic

2. Interrupted Lines coded with the same letter or letter
combinations are electrically connected.

3. Device type number is for reference only. The number
varies with the manufacturer.

4. Special signal usage:

_B Denotes - Active-Low Signal
<> or [] Denotes - Vectored Signals

5. Interpret diagram in accordance with American
National Standards Institute specifications, current
revision, with the exception of logic block symbology.

### 4G_DDR3_SDRAM_256MX16

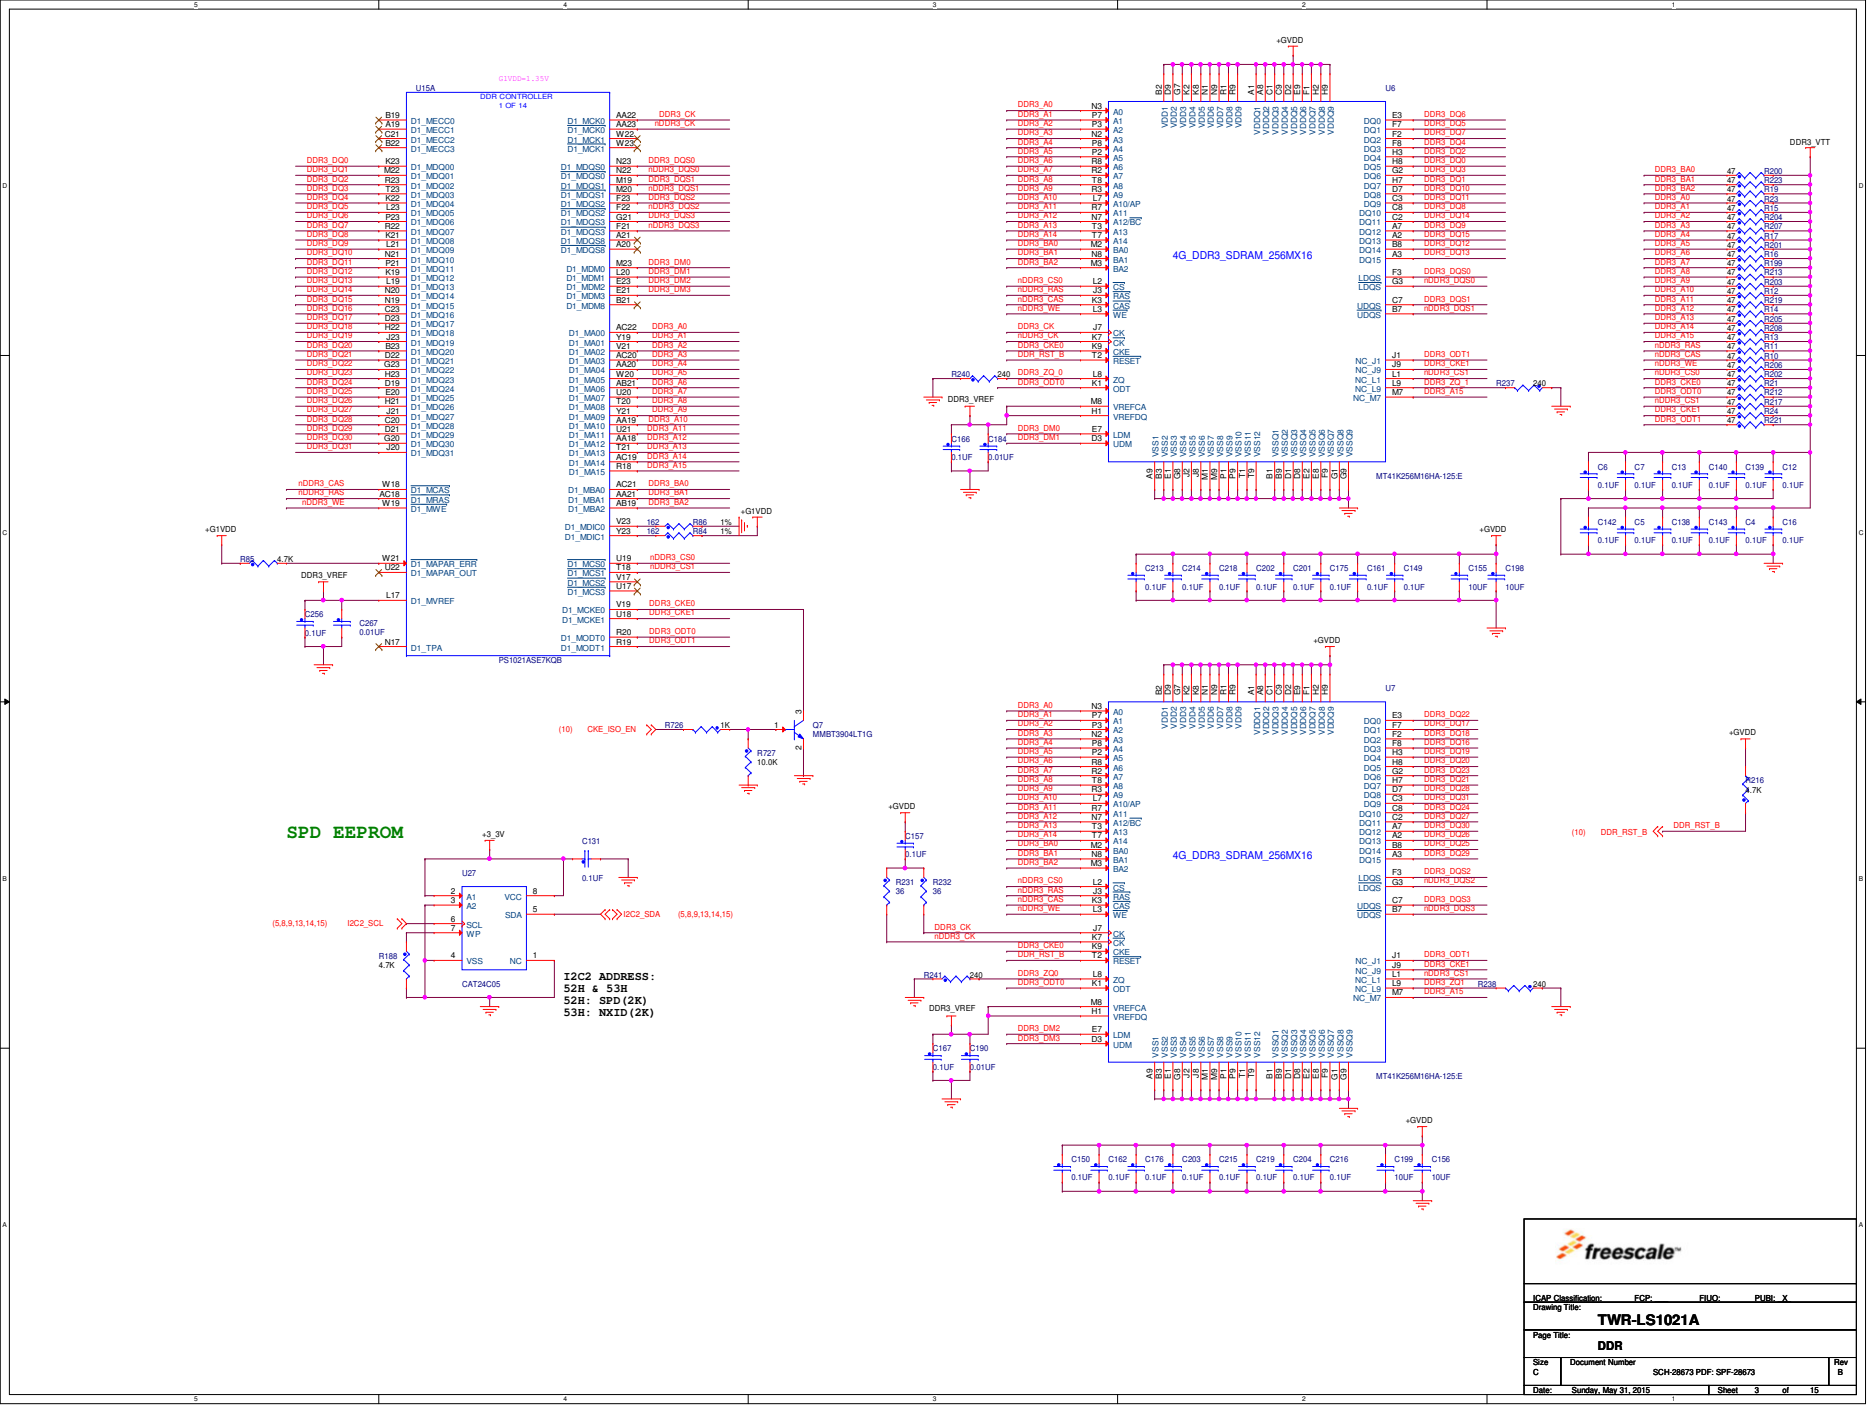
[picture p23: page 3]

## NOR FLASH

# BVDD-3.3V

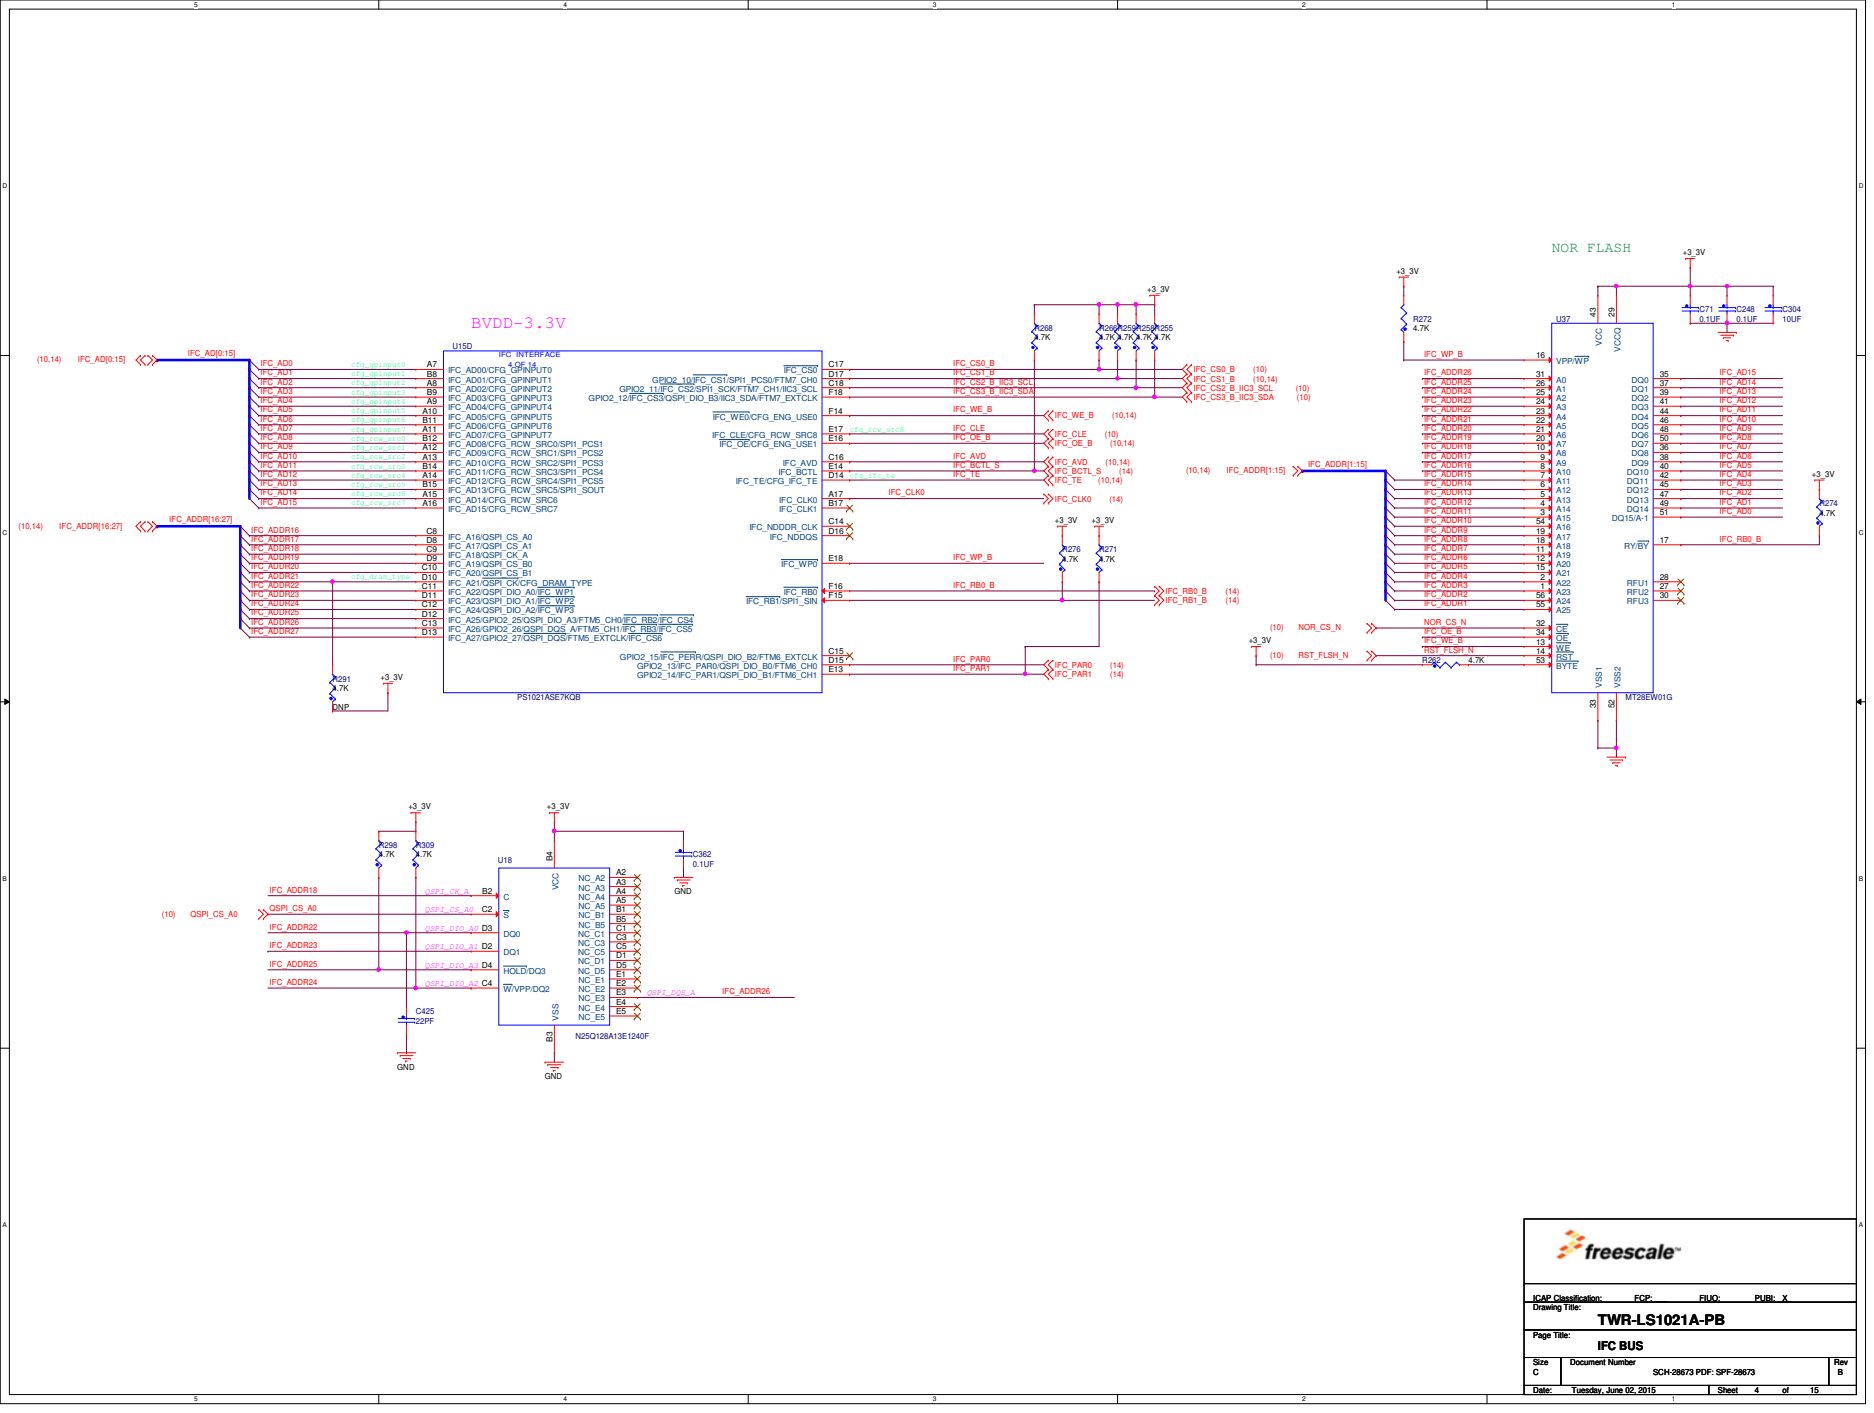
[picture p24: page 4]

# JTAG

## SPI2 MUX

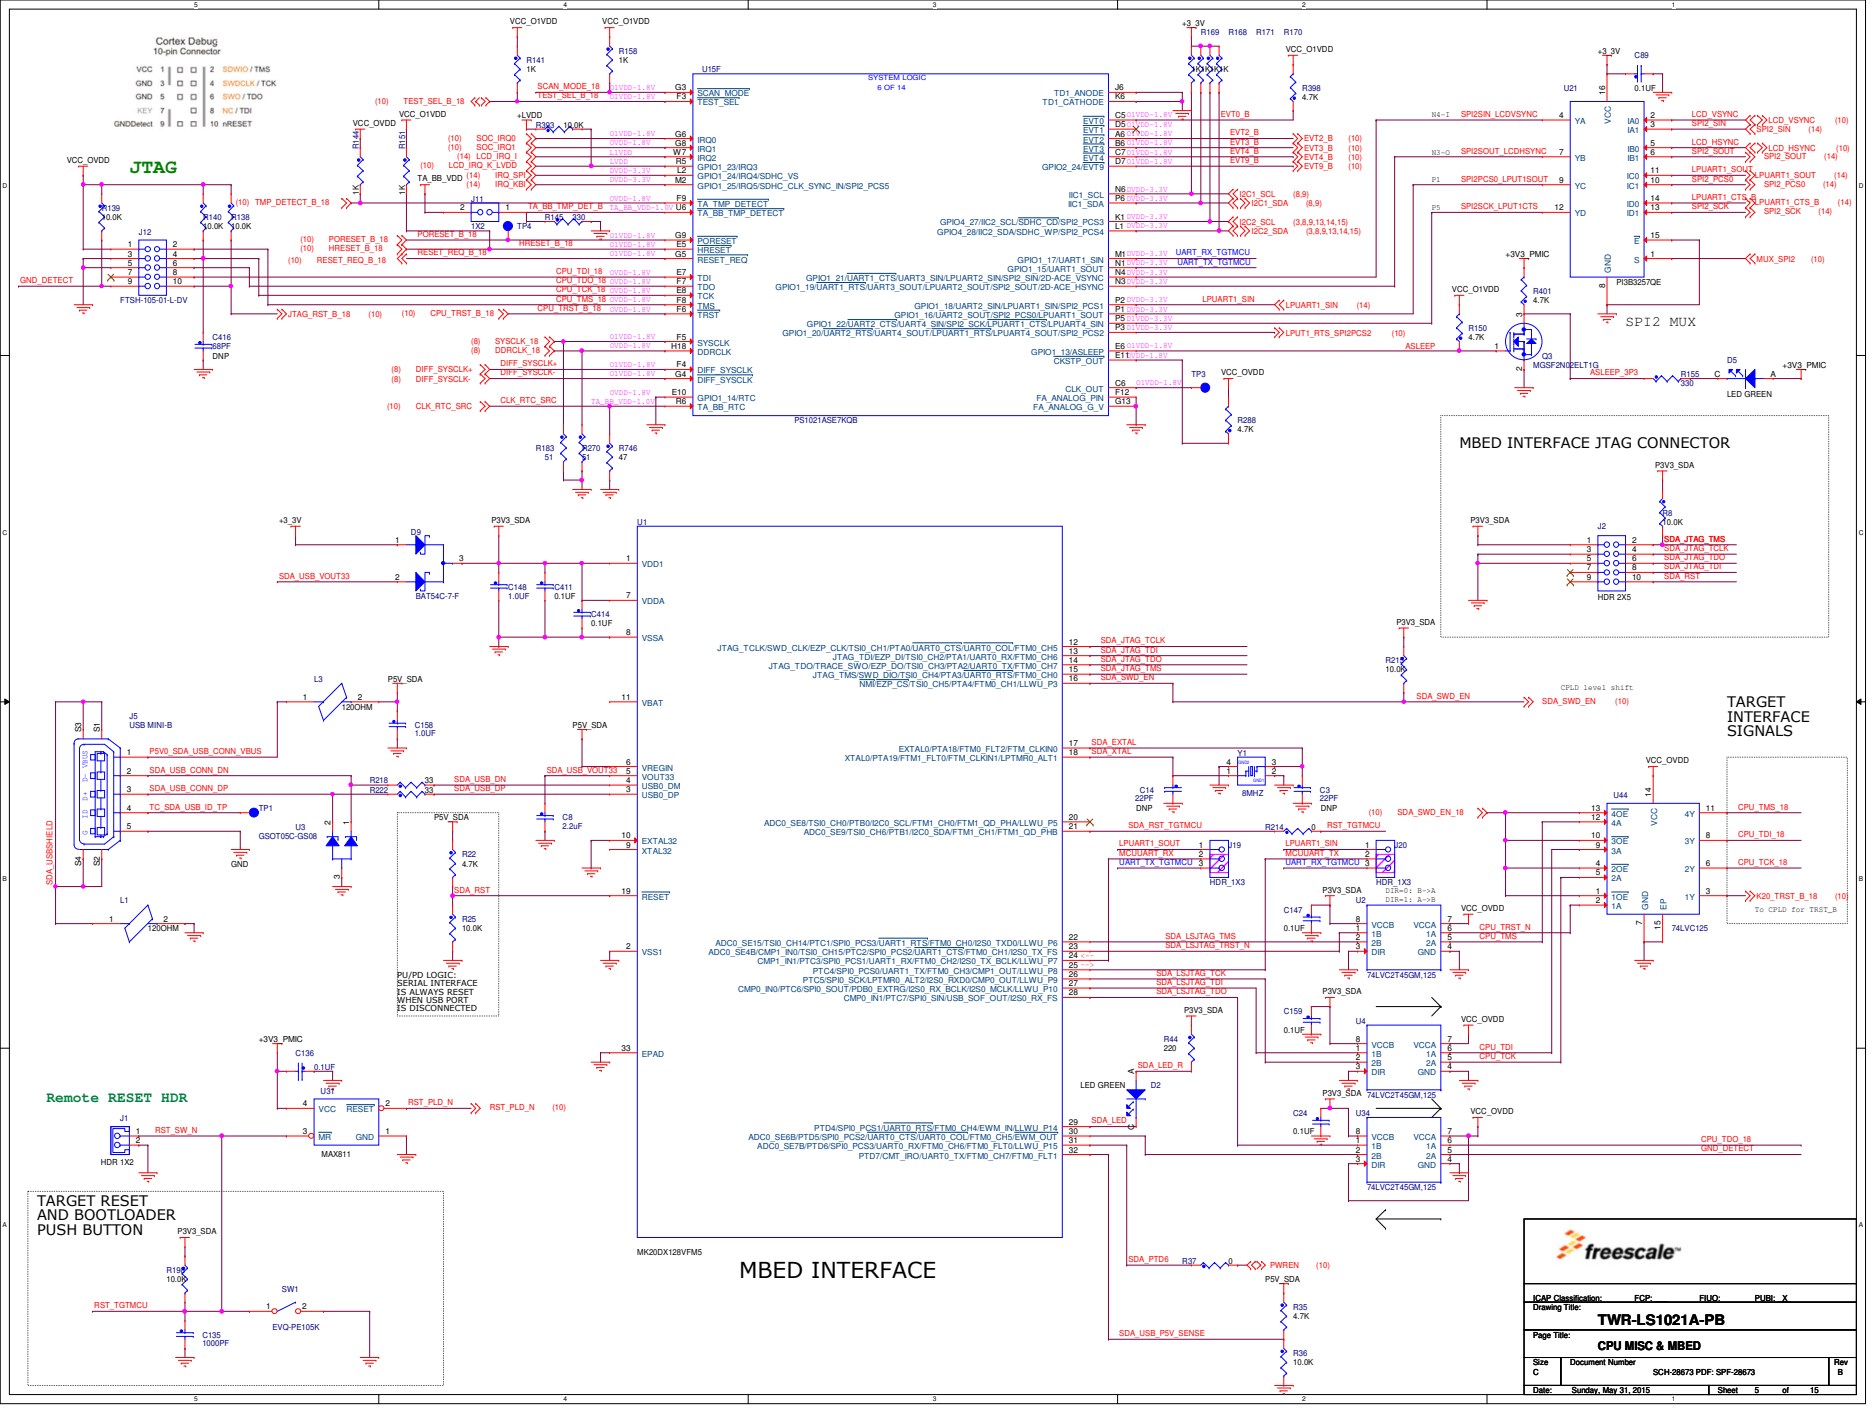
[picture p25: page 5]

MBED INTERFACE JTAG CONNECTOR

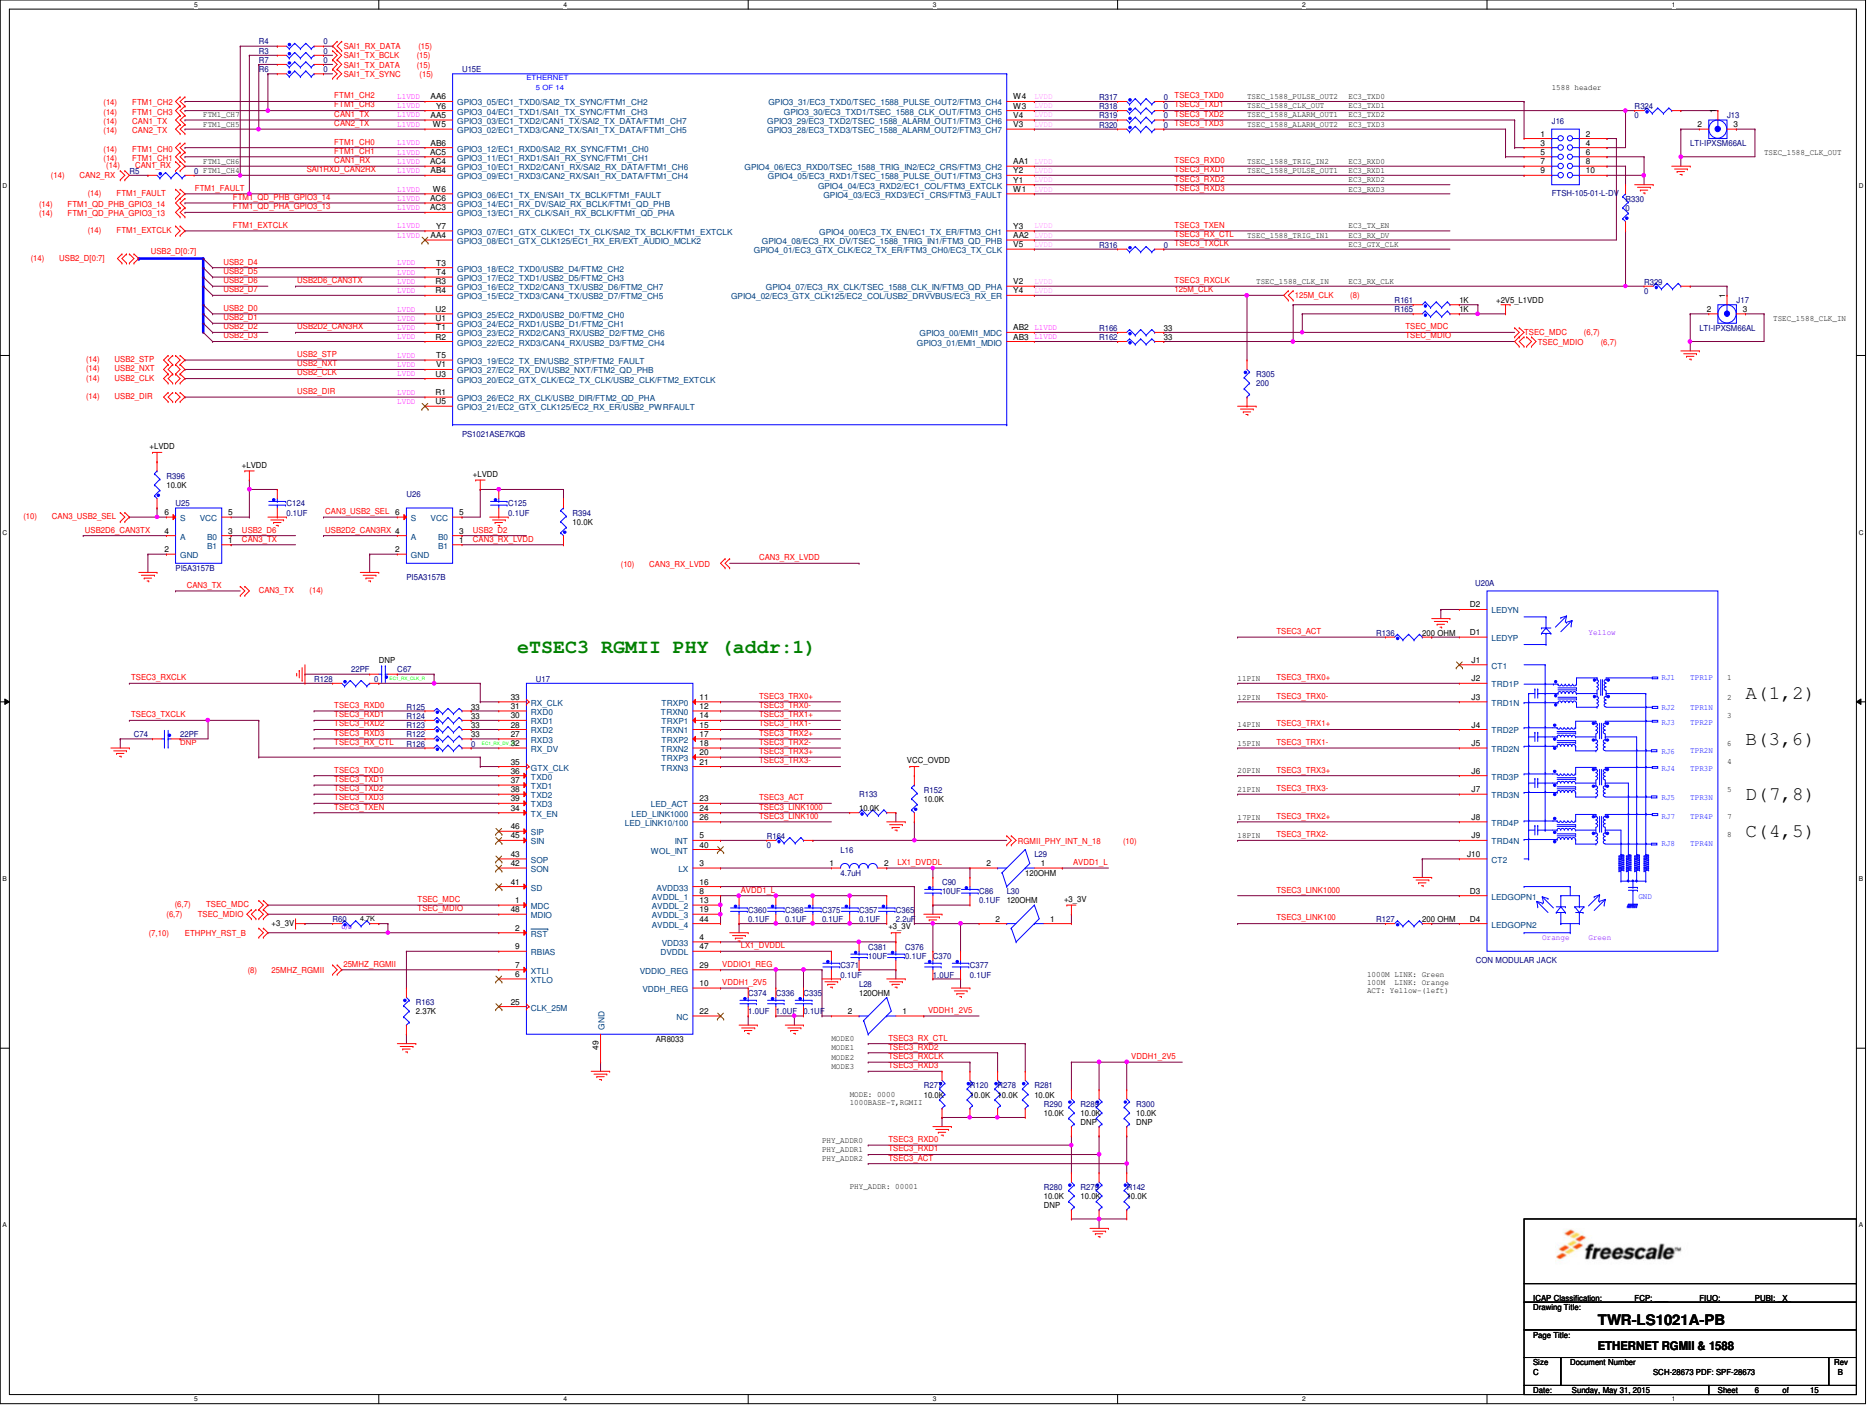
[picture p26: page 6]

# eTSEC2 SGMII2 PHY (addr:0)

B

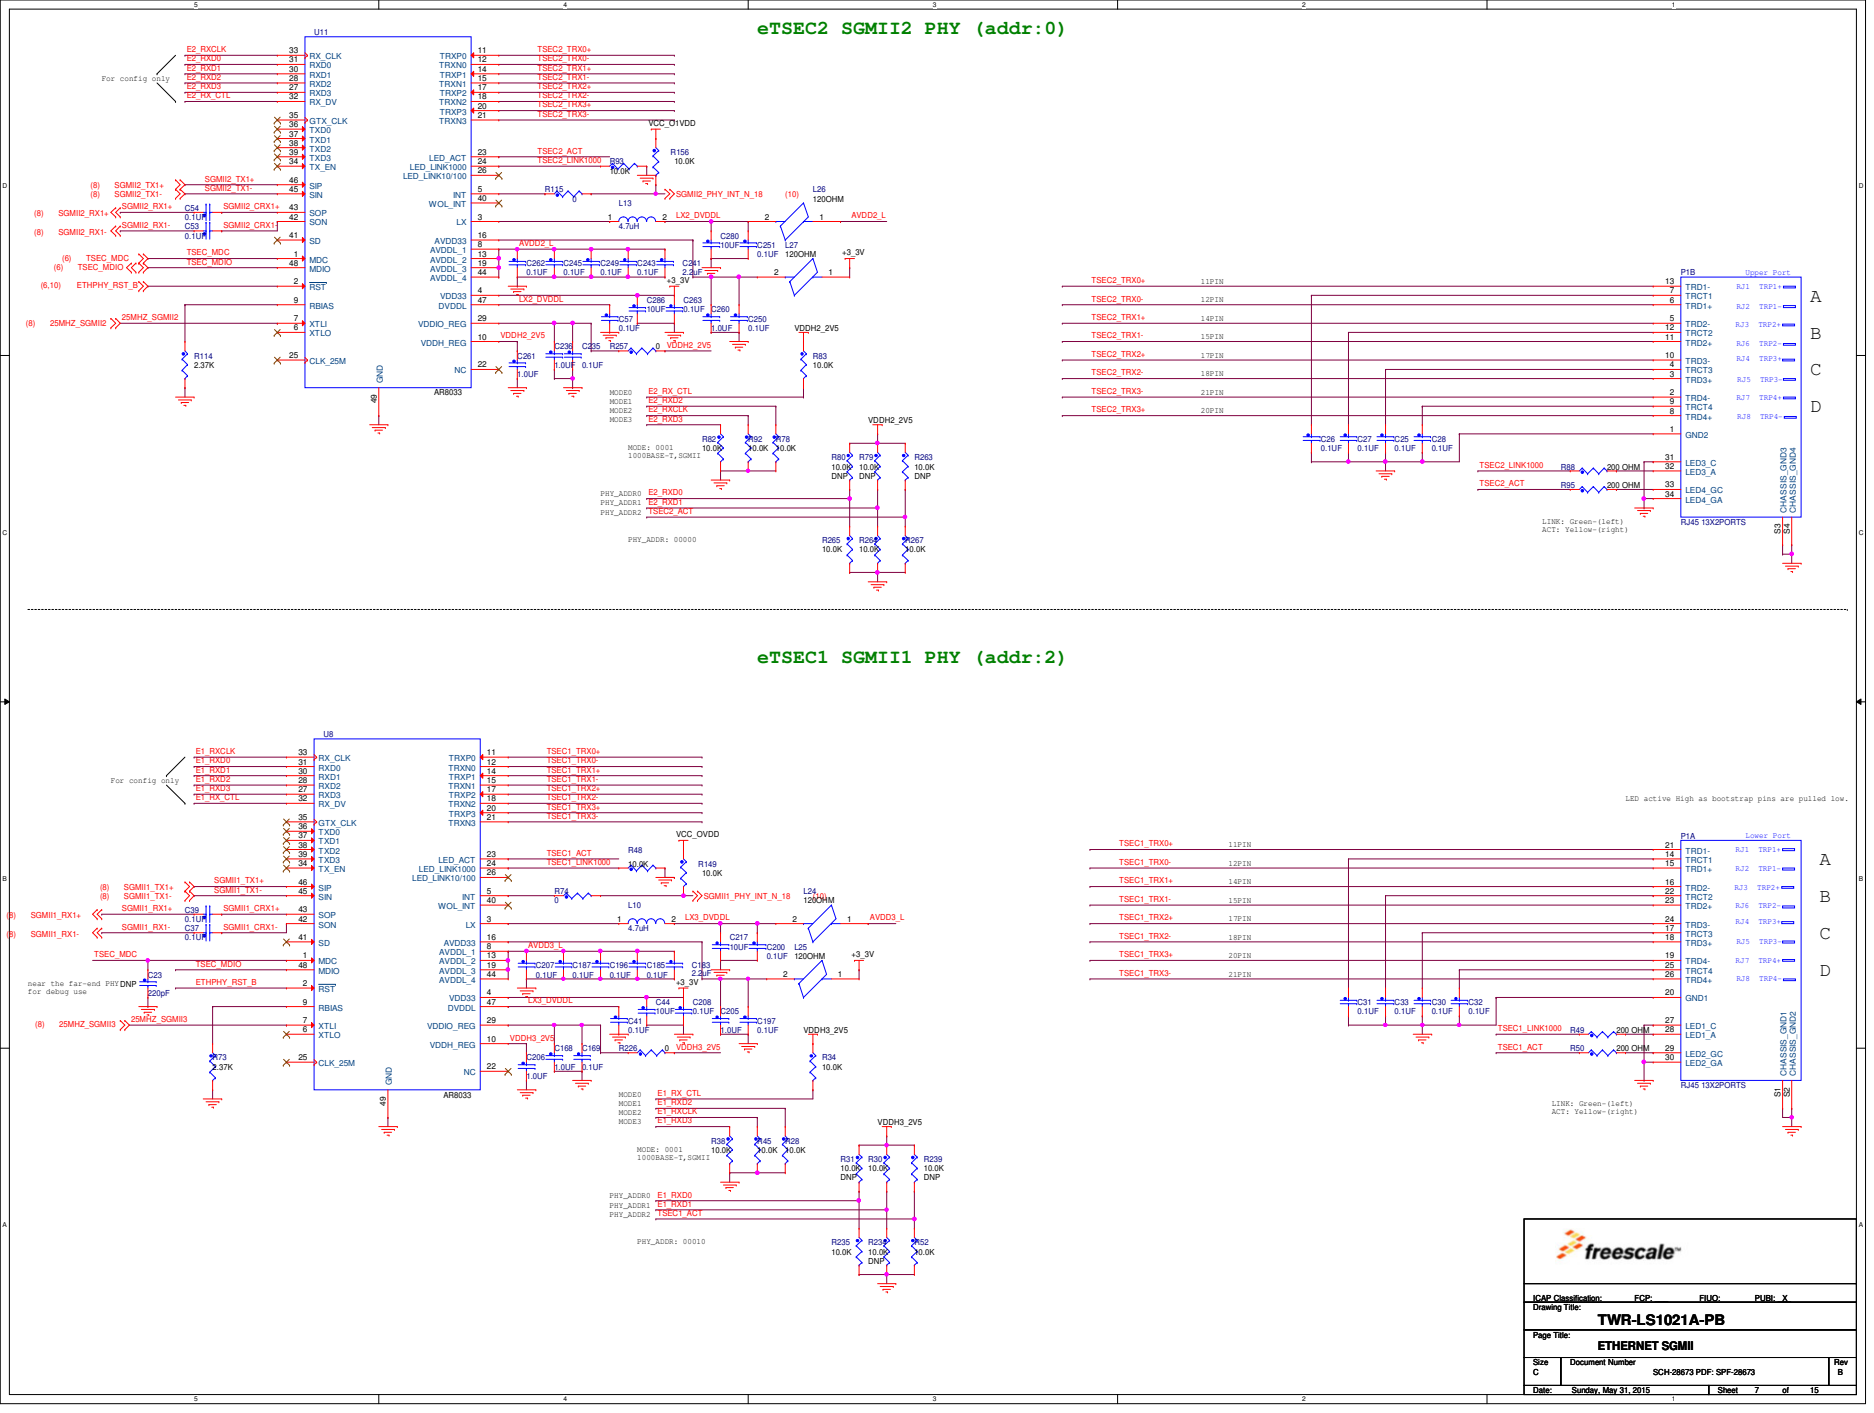
[picture p27: page 7]

LED active High as bootstrap pins are pulled low.

near the far-end PHY
for debug use

# MINI PCI EXPRESS1

# SATA

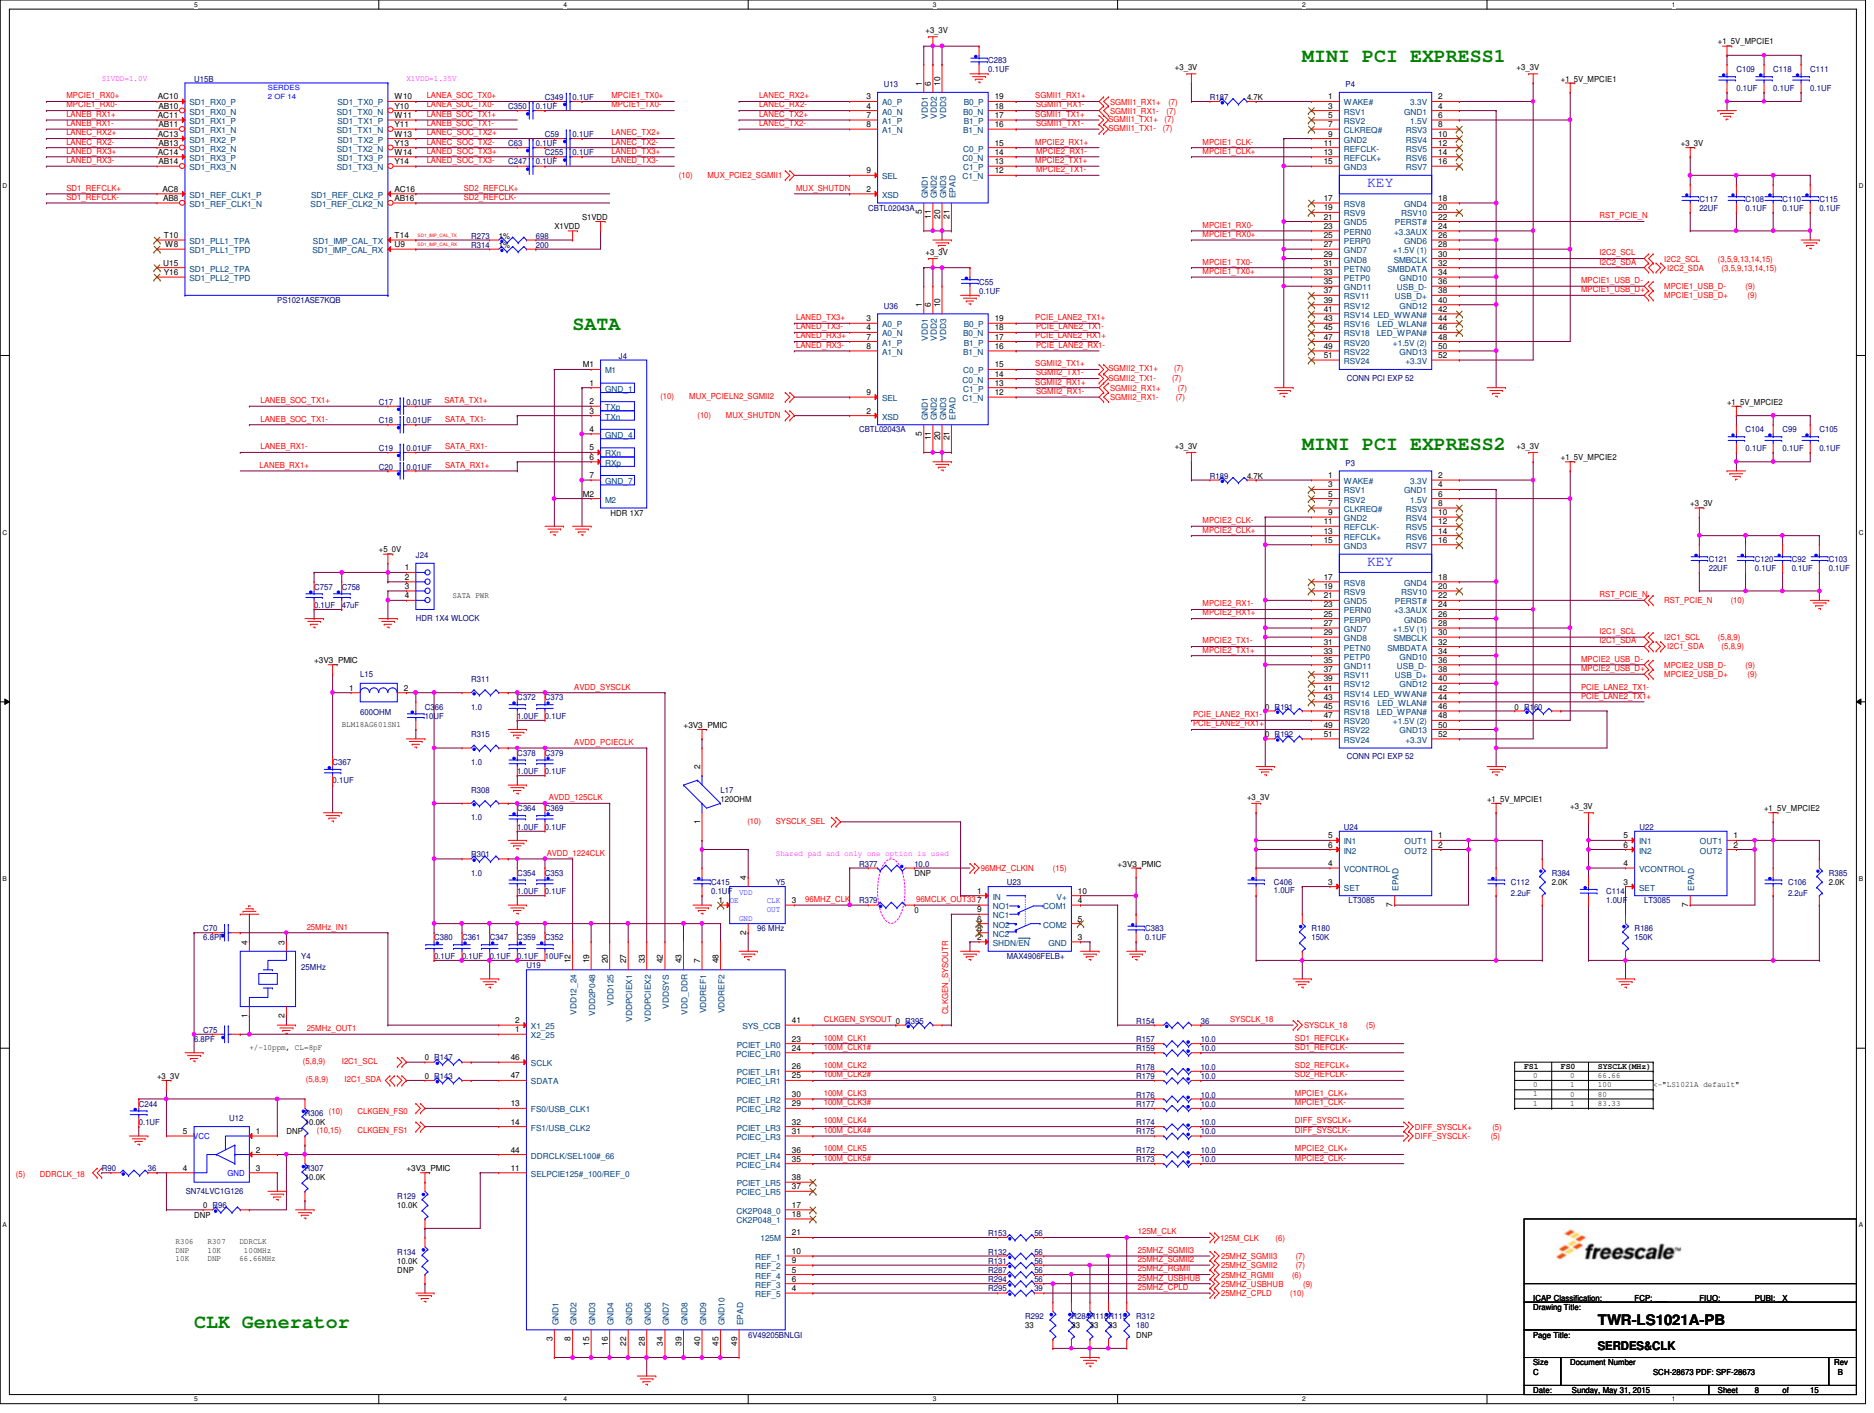
[picture p28: page 8]

Shared pad and only one option is used

FS1 | FS0 | SYSCLK(MHz)
0 | 0 | 66.66
0 | 1 | 100
1 | 0 | 80
1 | 1 | 83.33

# SDHC

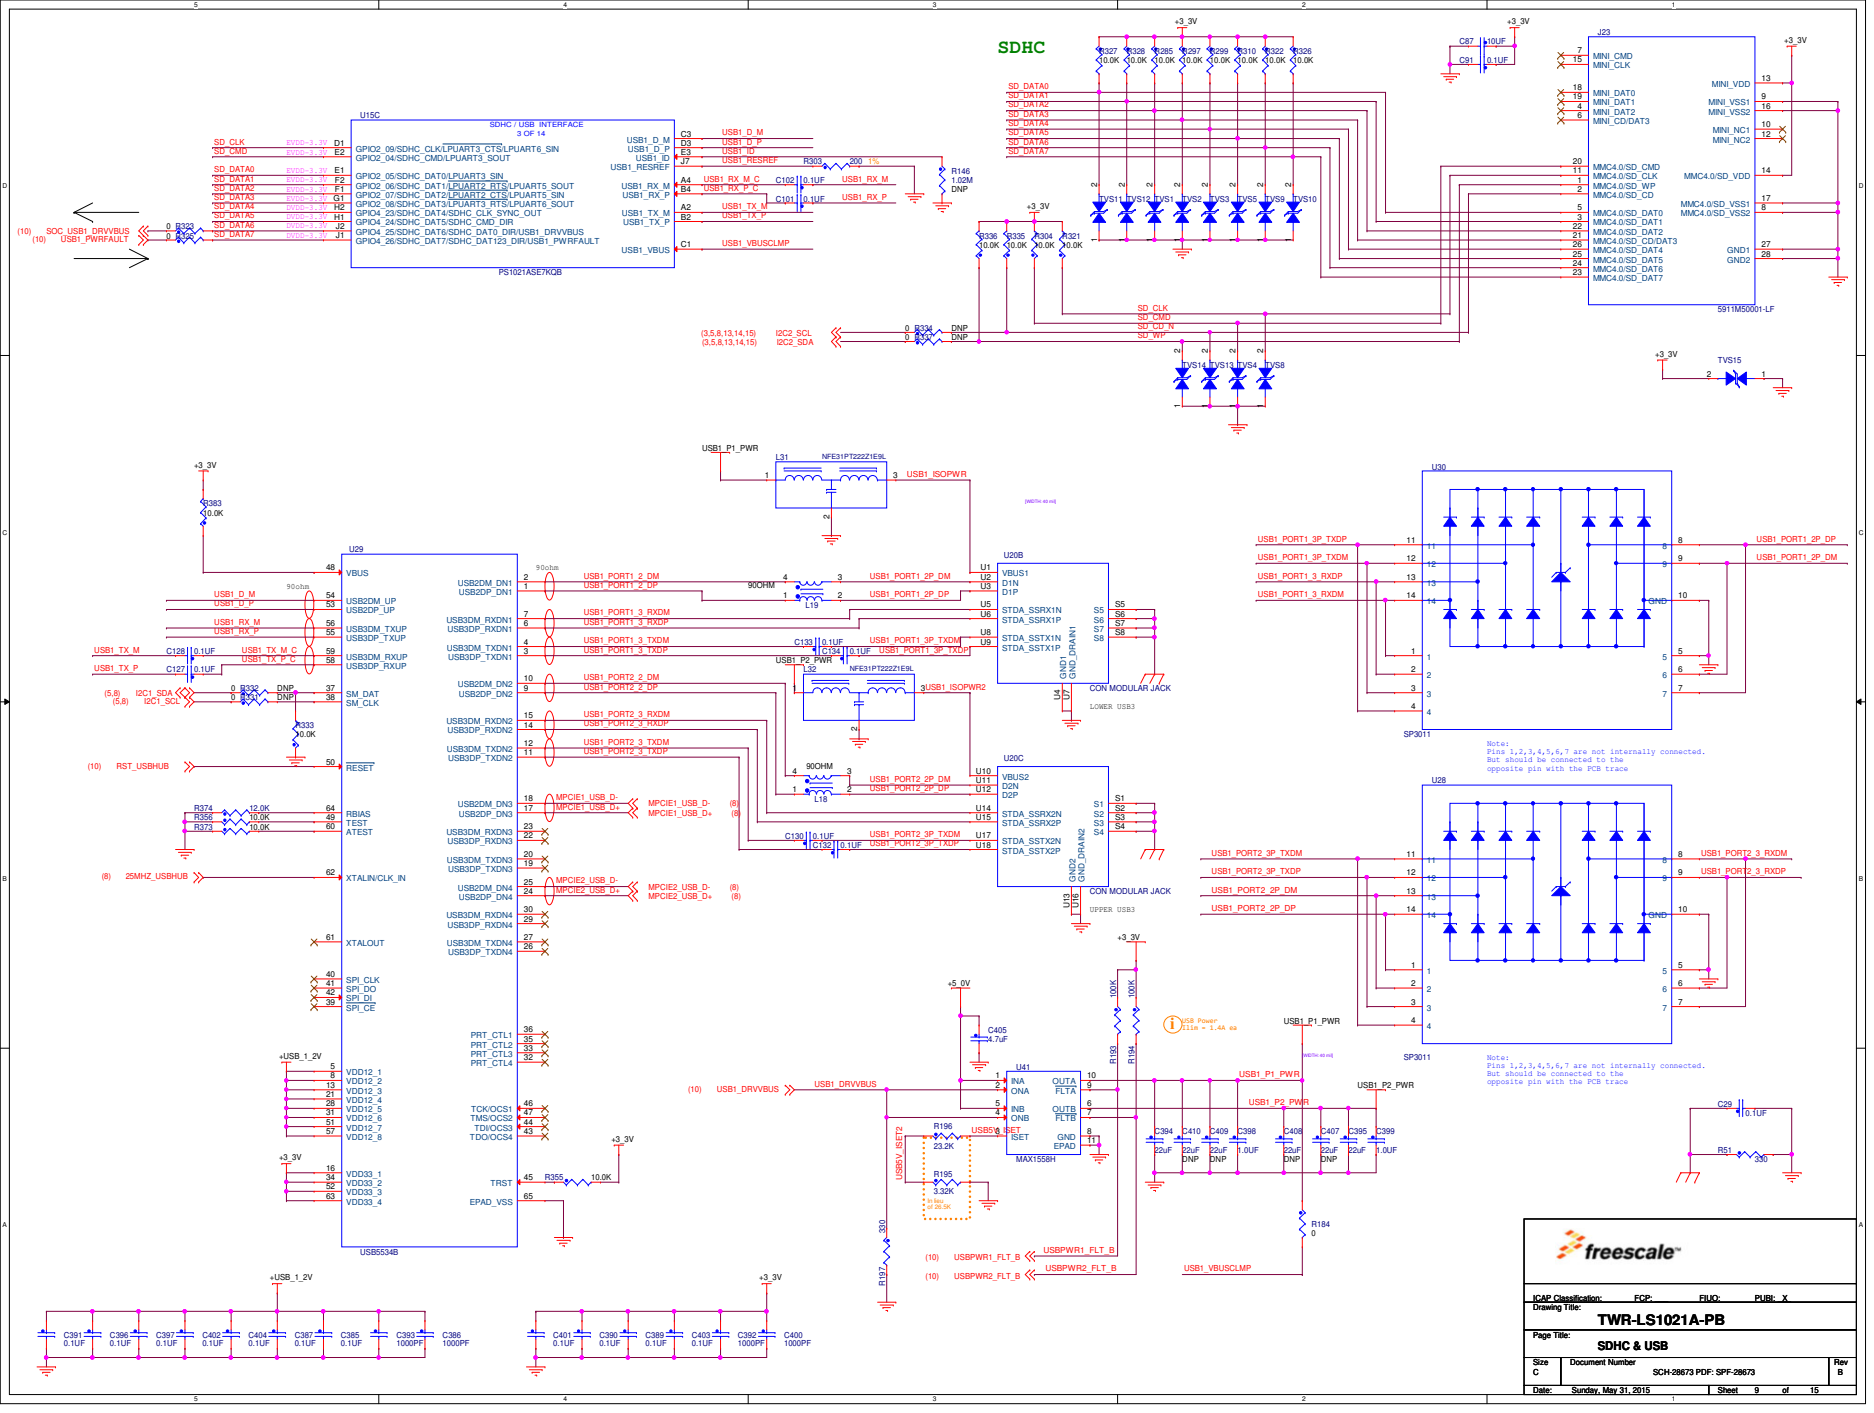
[picture p29: page 9]

Note:
Pins 1,2,3,4,5,6,7 are not internally connected.
But should be connected to the
opposite pin with the PCB trace

i USB Power Ilim = 1.4A ea

BANK7 | BANK6
BANK2 | BANK3

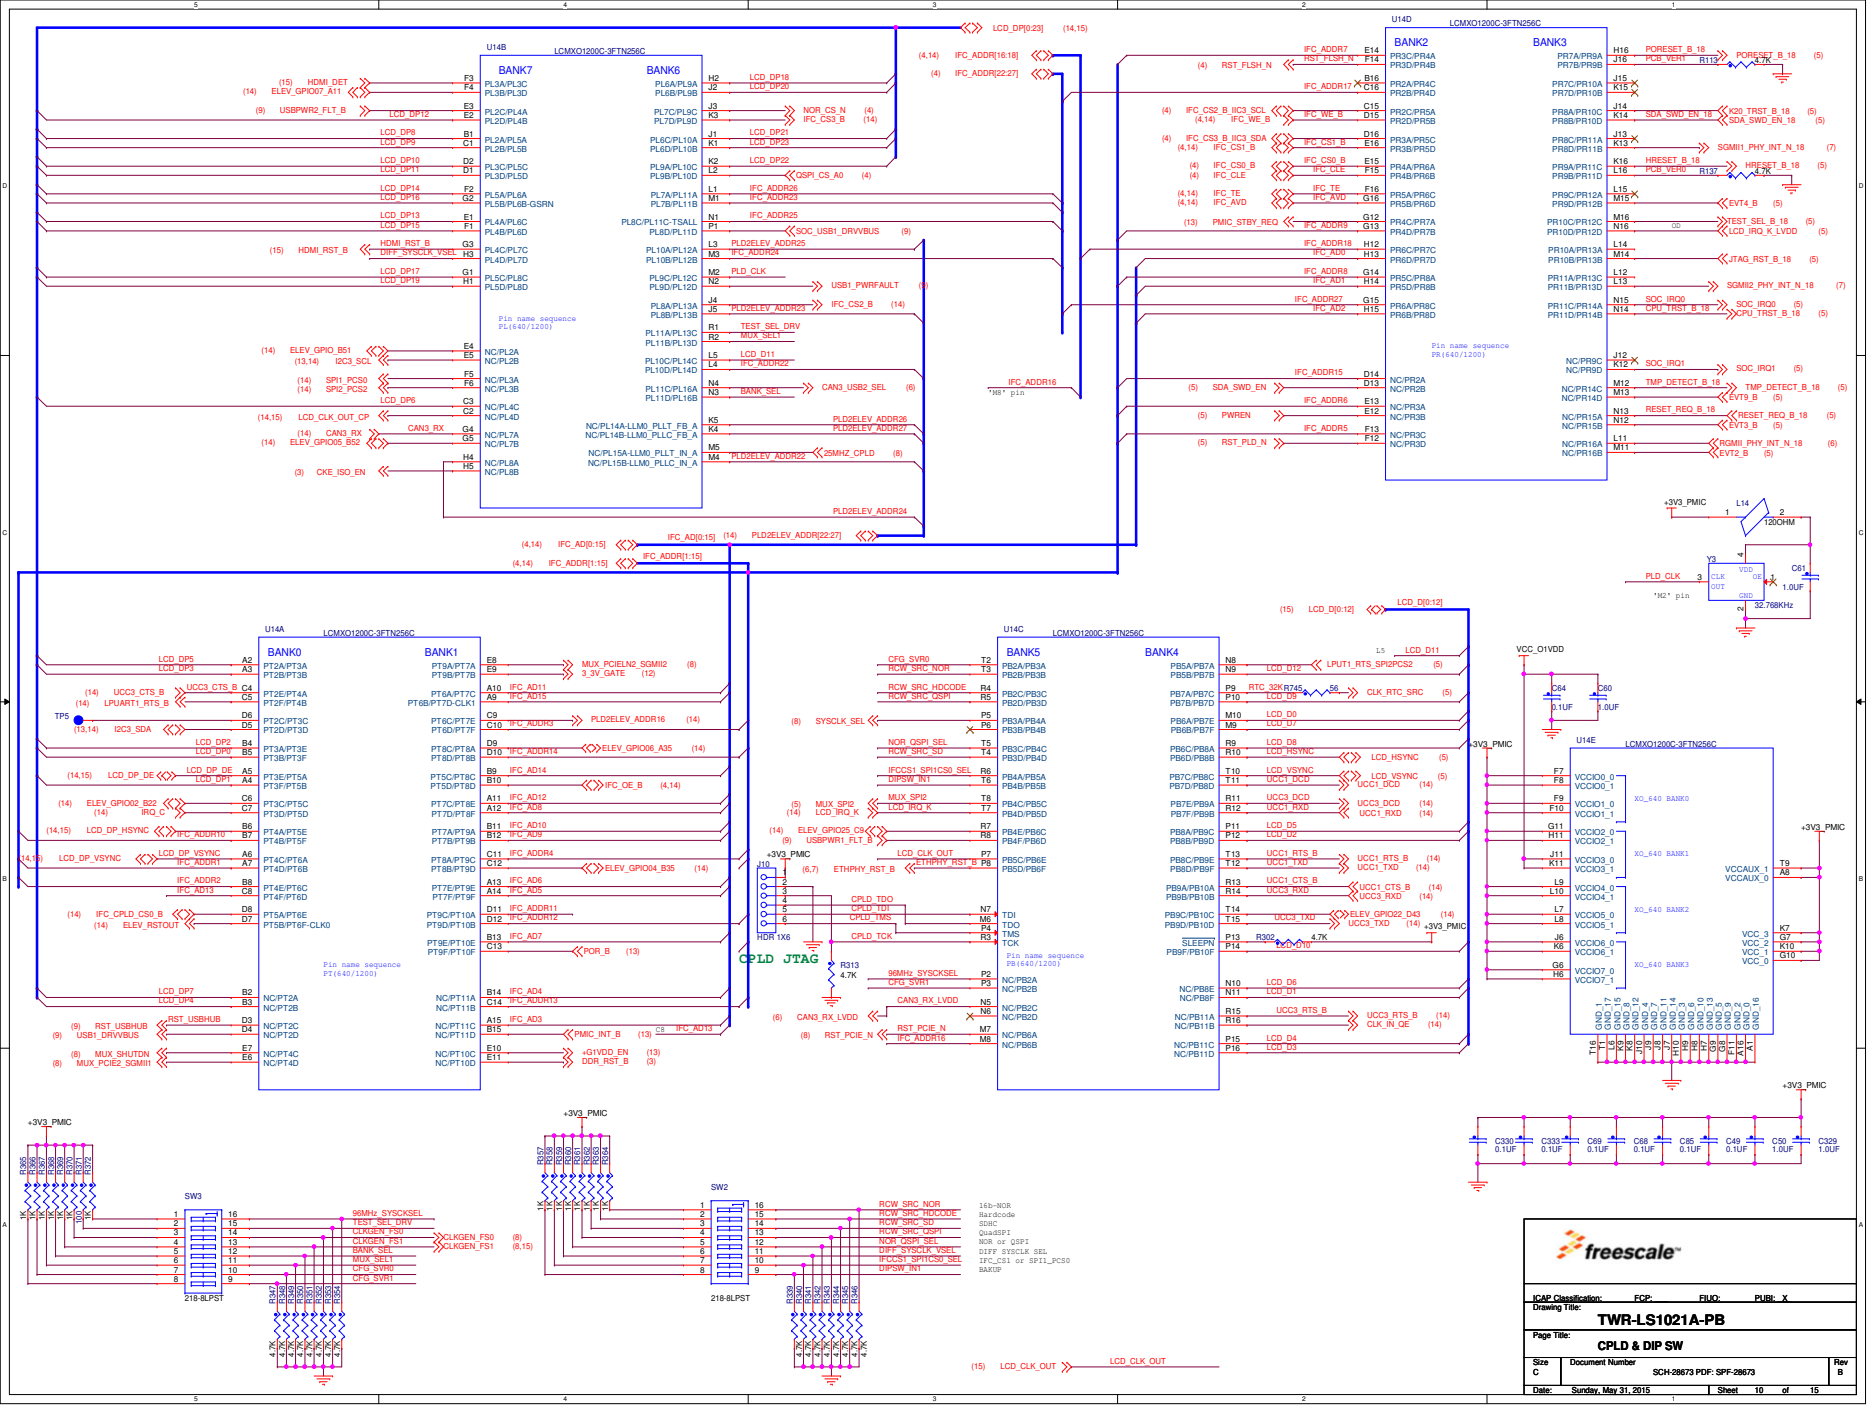
[picture p30: page 10]

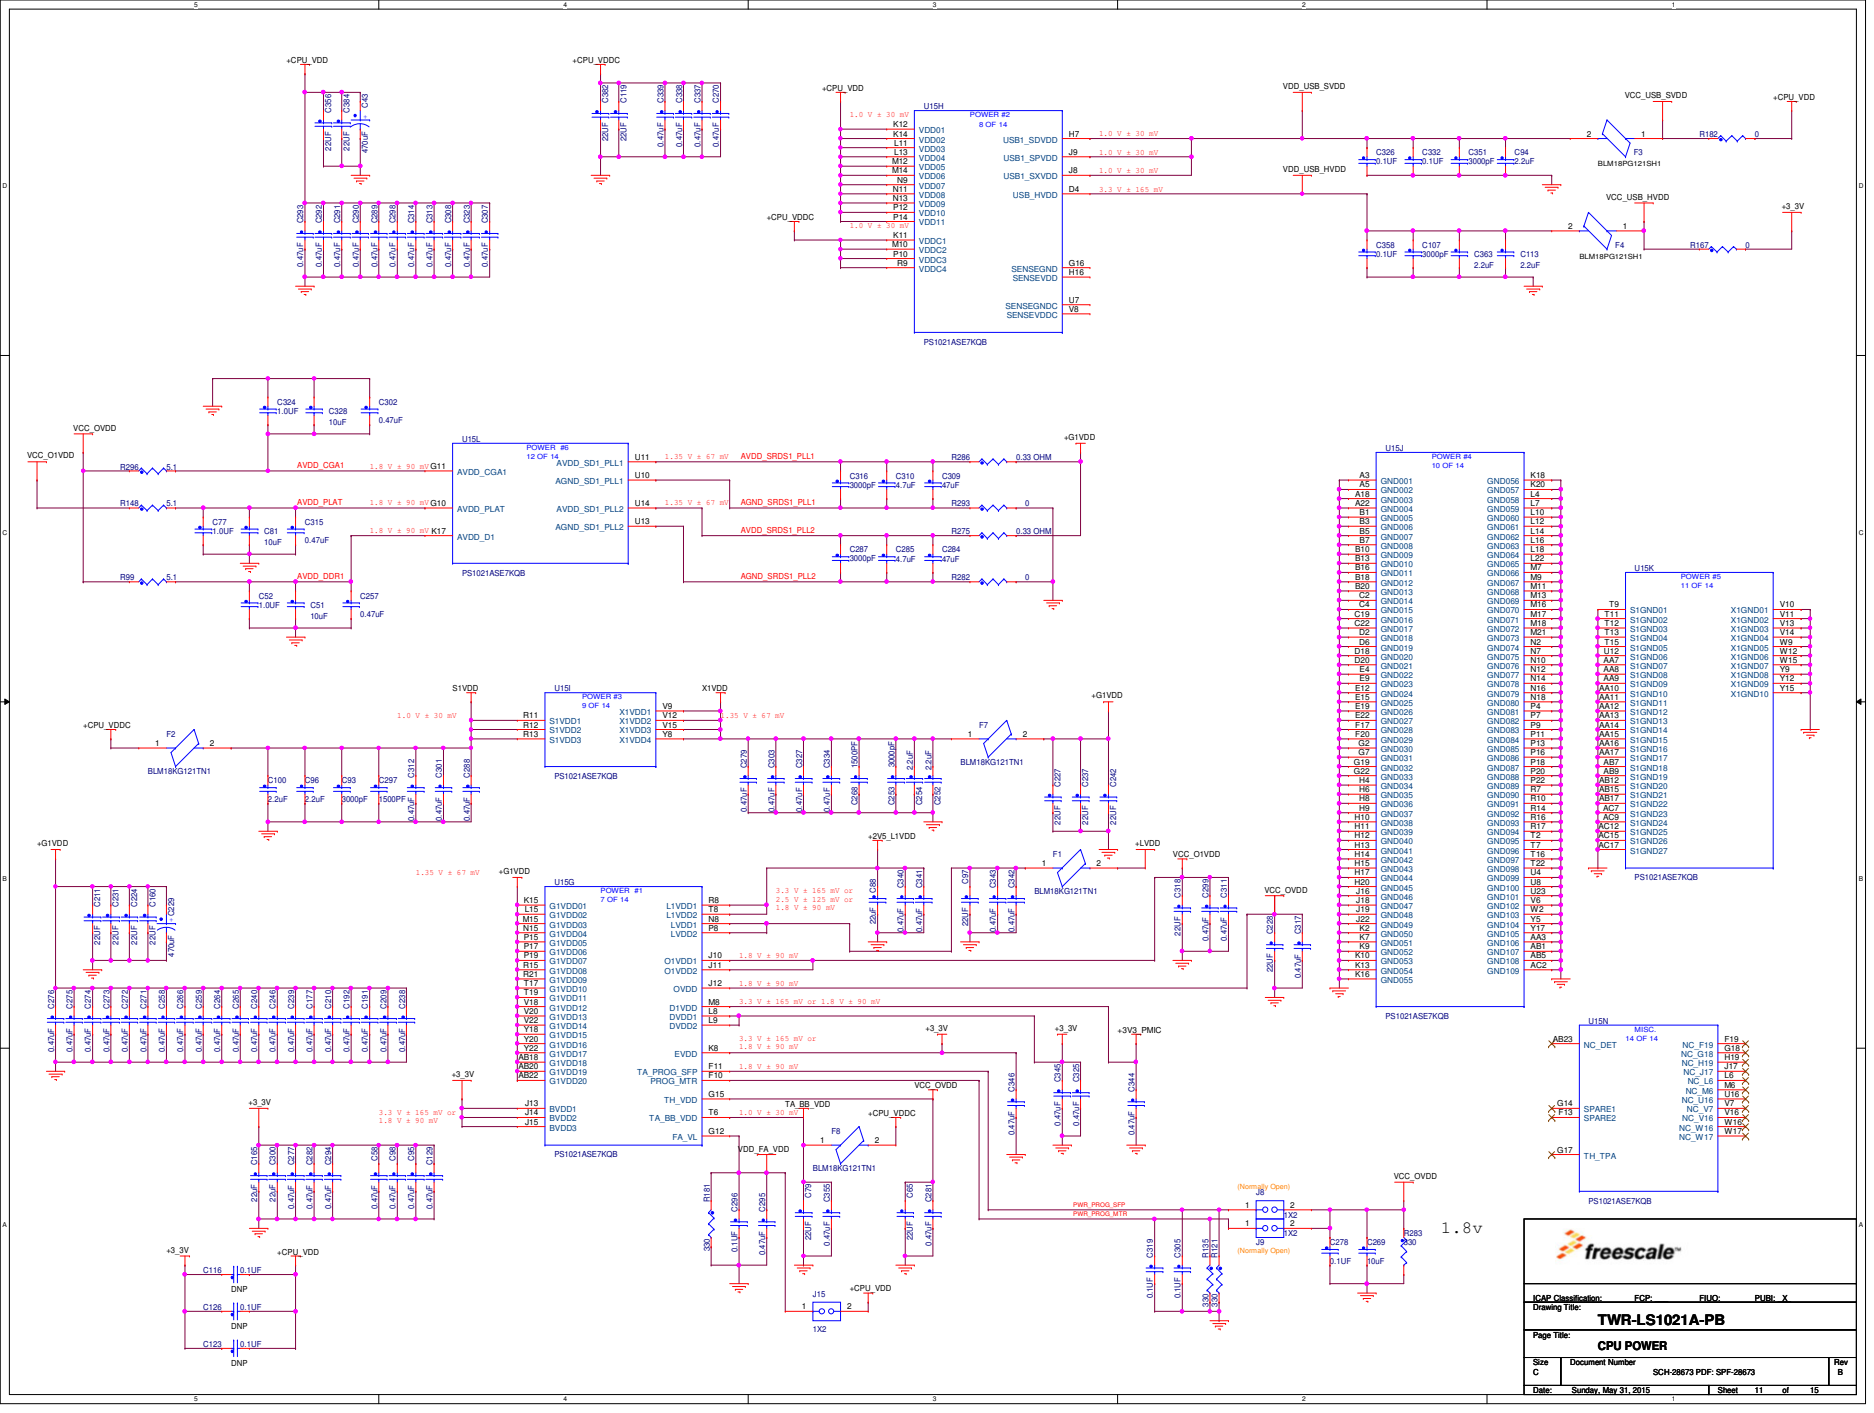
[picture p31: page 11]

# ALWAYS ON

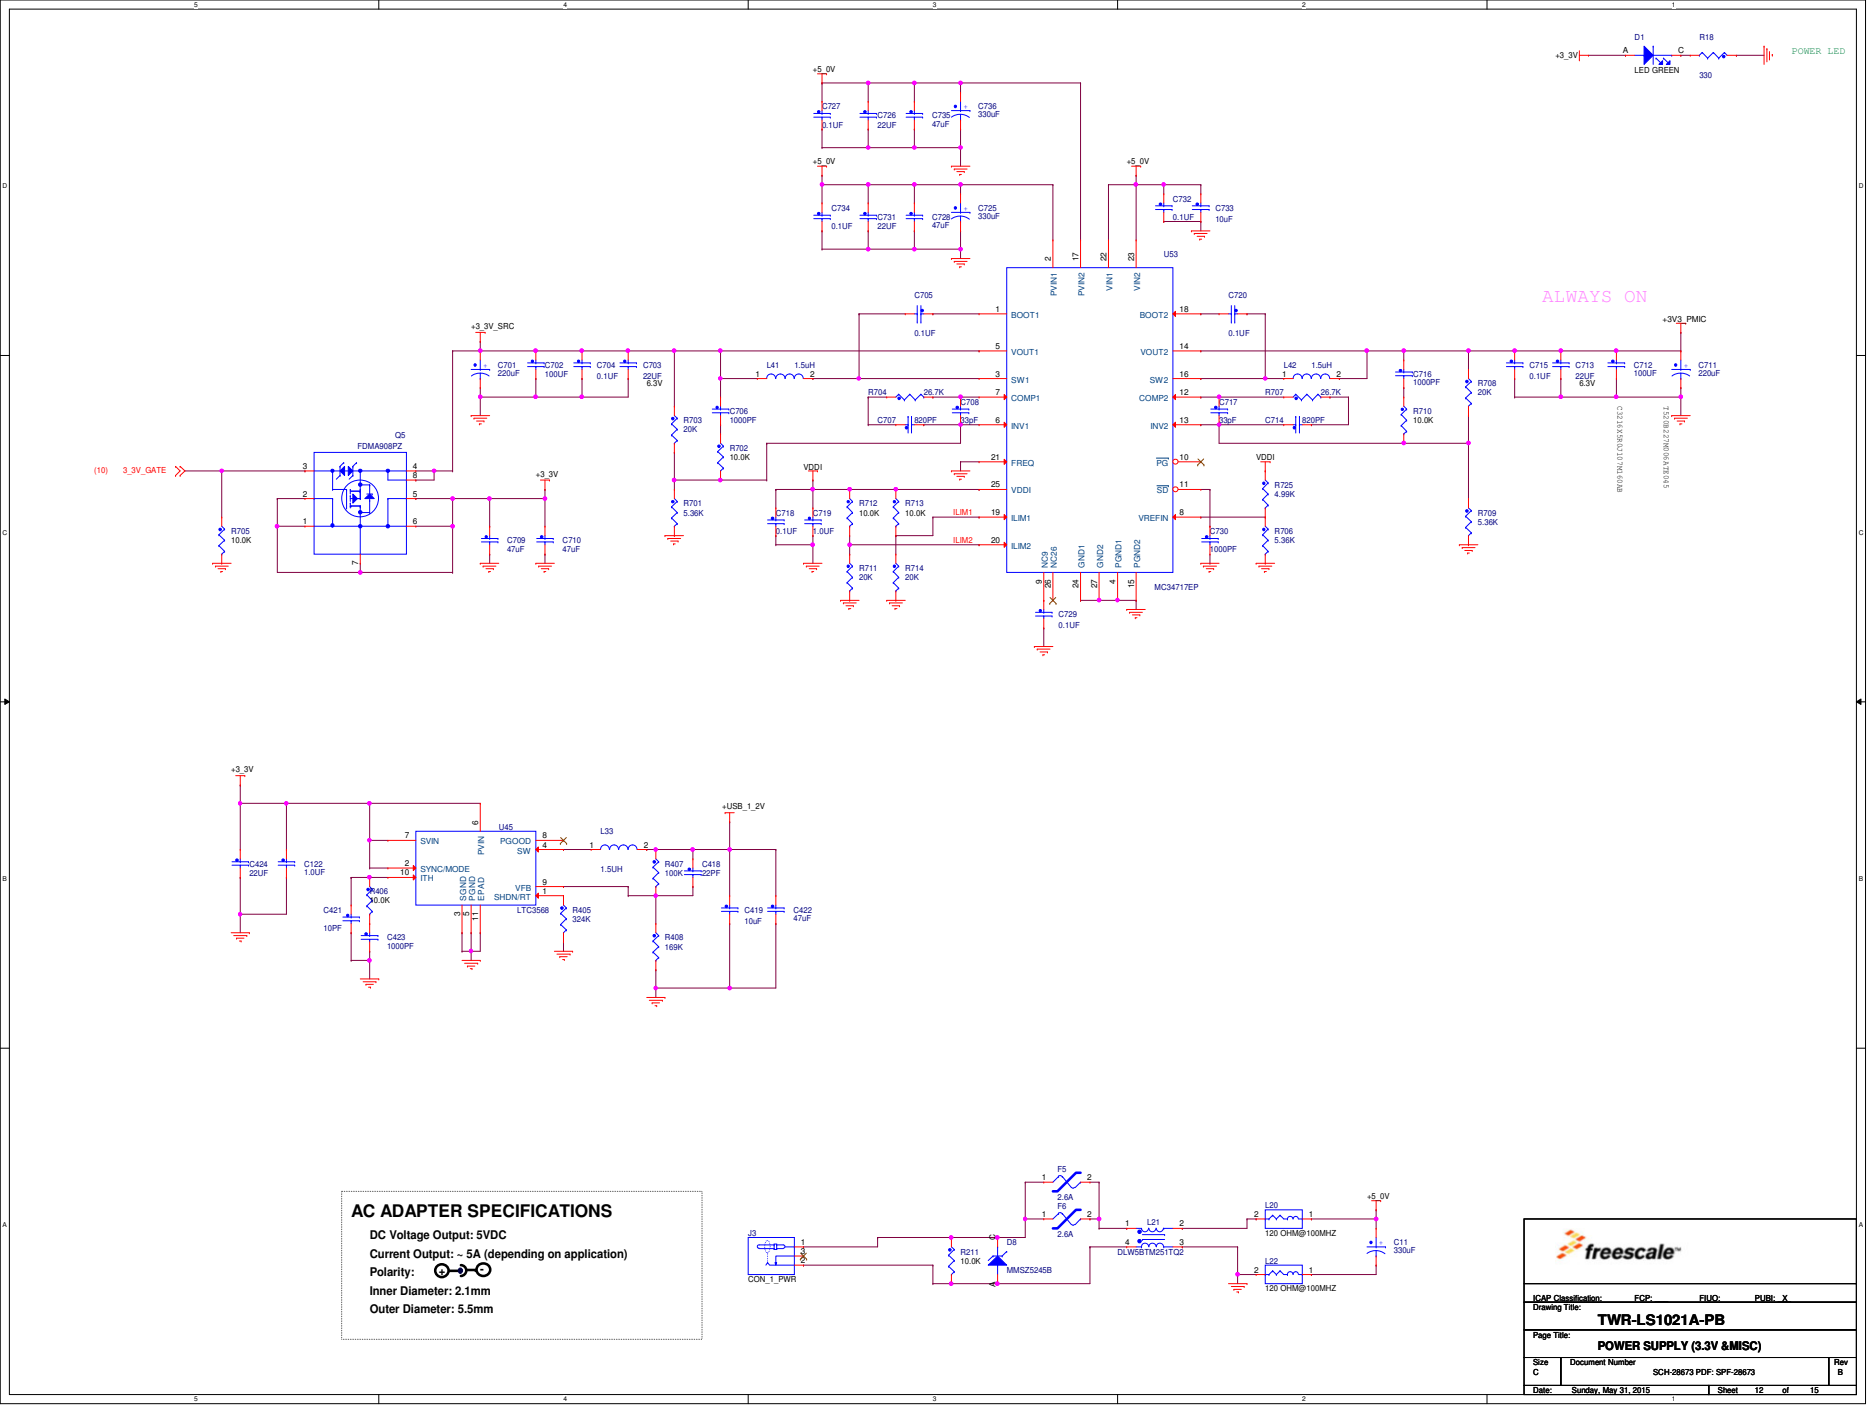
[picture p32: page 12]

DC Voltage Output: 5VDC
Current Output: ~ 5A (depending on application)
Polarity:
Inner Diameter: 2.1mm
Outer Diameter: 5.5mm

250mA

350mA

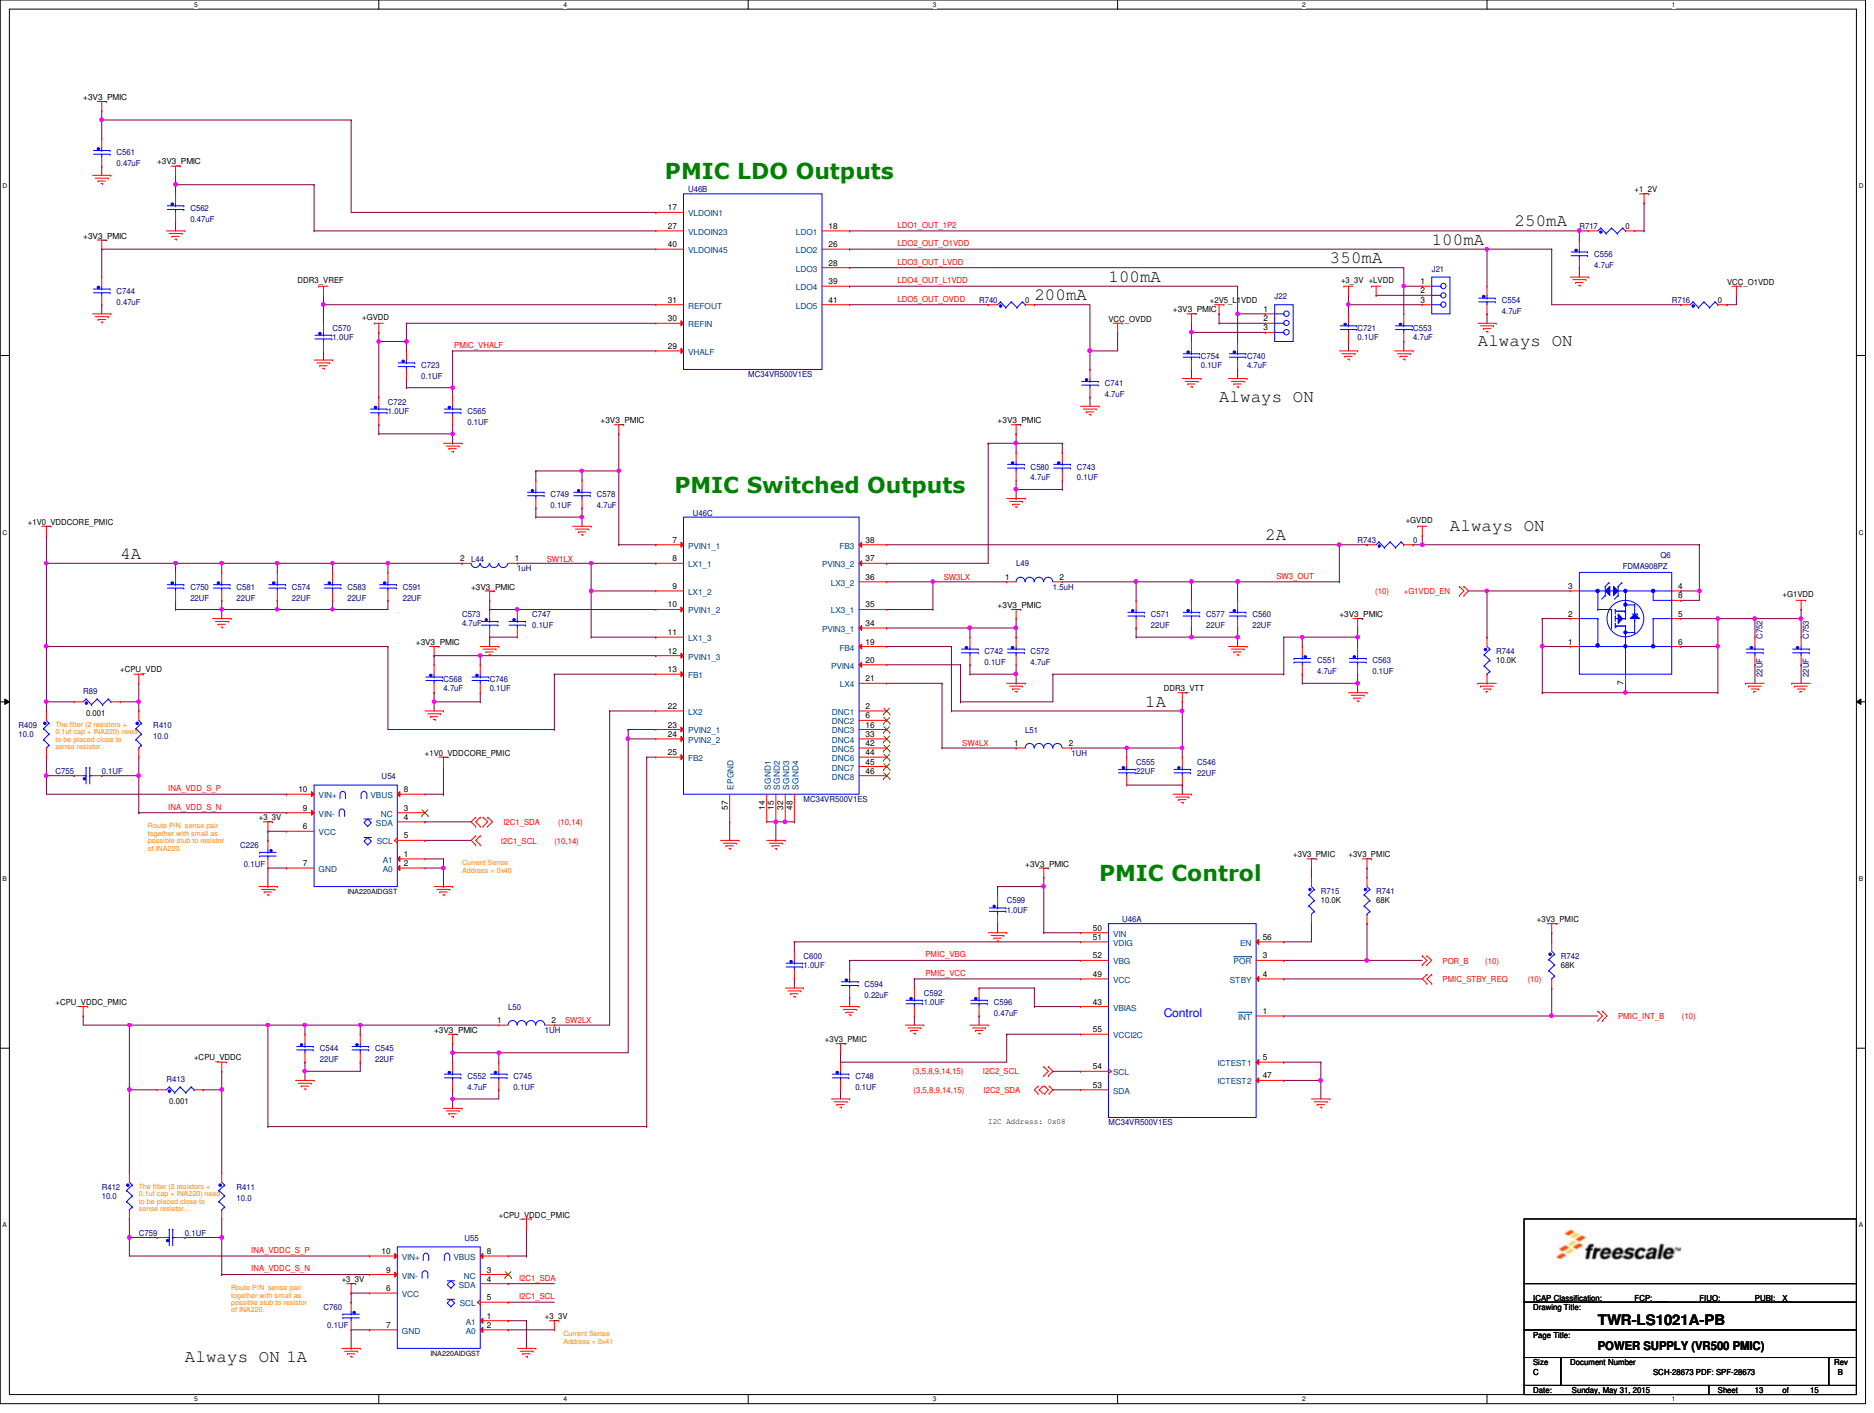
[picture p33: page 13]

The filter (2 resistors +
0.1uf cap + INA220) need
to be placed close to
sense resistor .

Route P/N sense pair
together with small as
possible stub to resistor
of INA220.

PRIMARY | SECONDARY

# SPI1

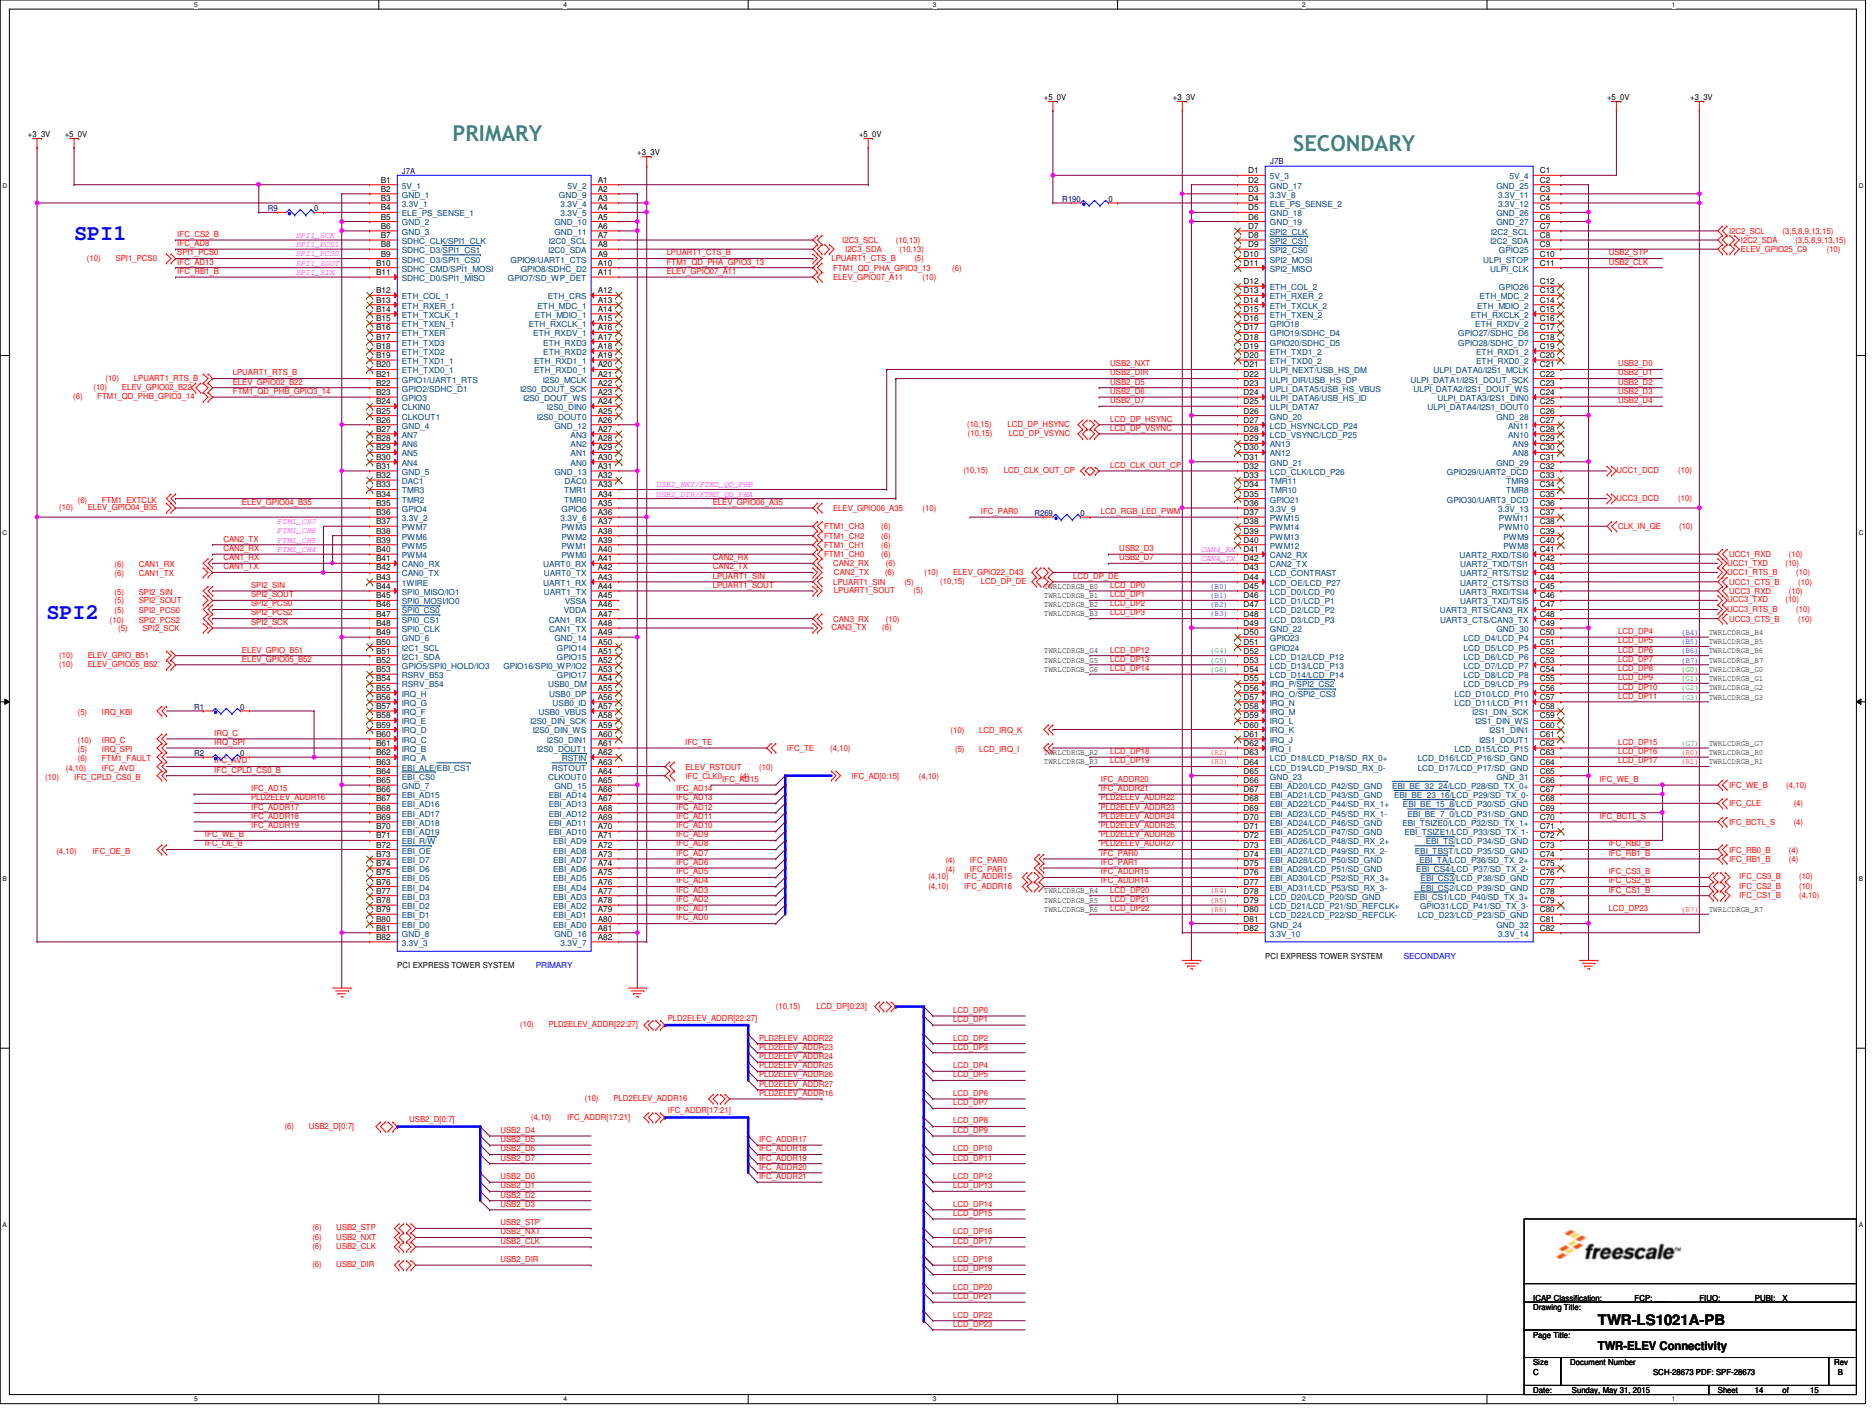
[picture p34: page 14]

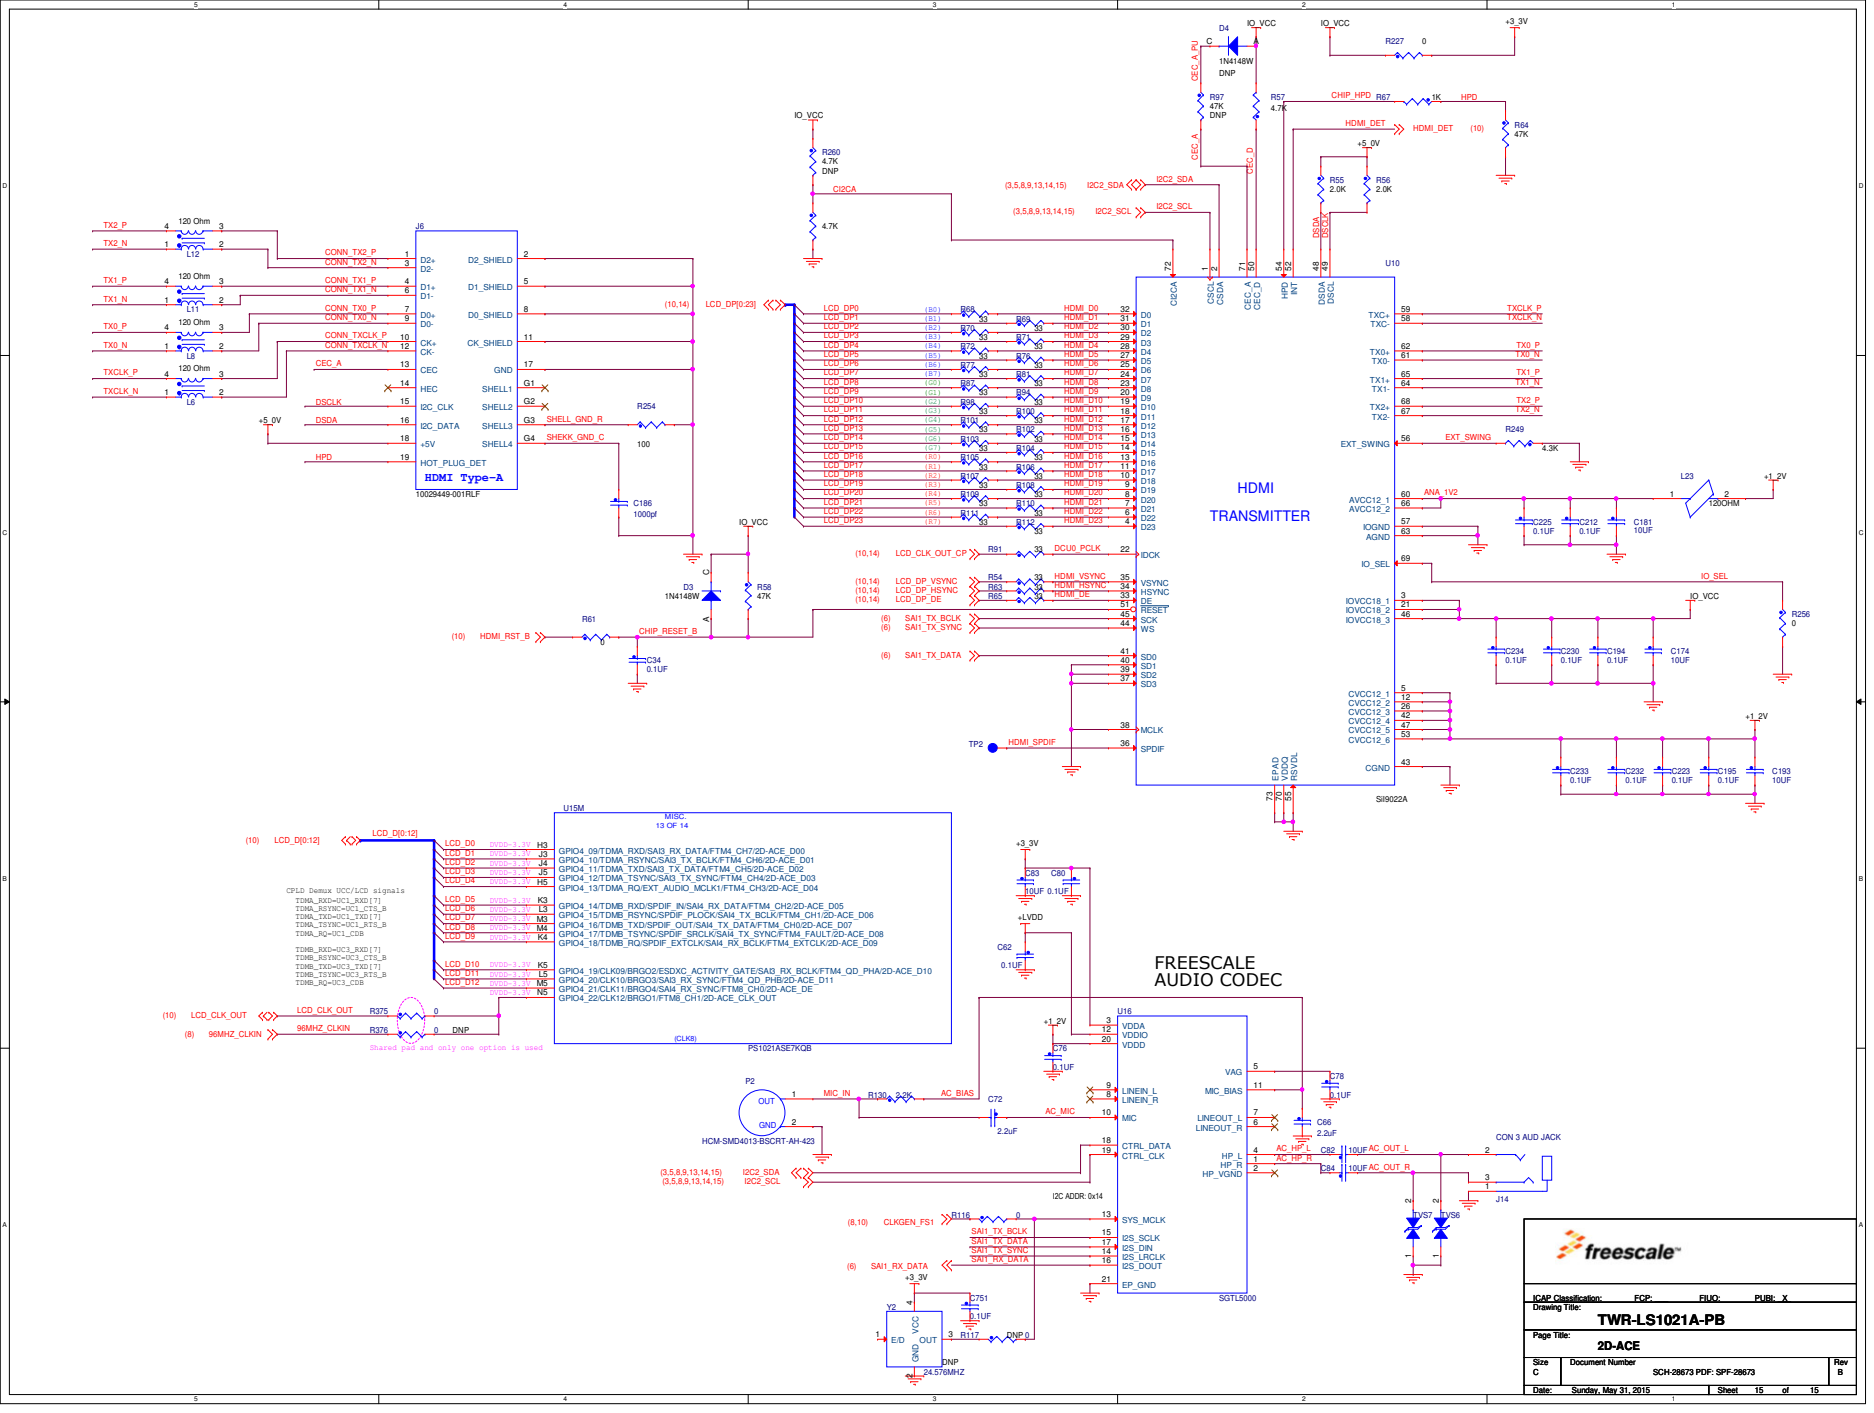
[picture p35: page 15]

Shared pad and only one option is used
