imagestream/kicad/AP2100.ls1043/docs/Reference Docs/Other Designs/SPF-28872_D.pdf

# Table of Contents

All information is subject to change without notice.

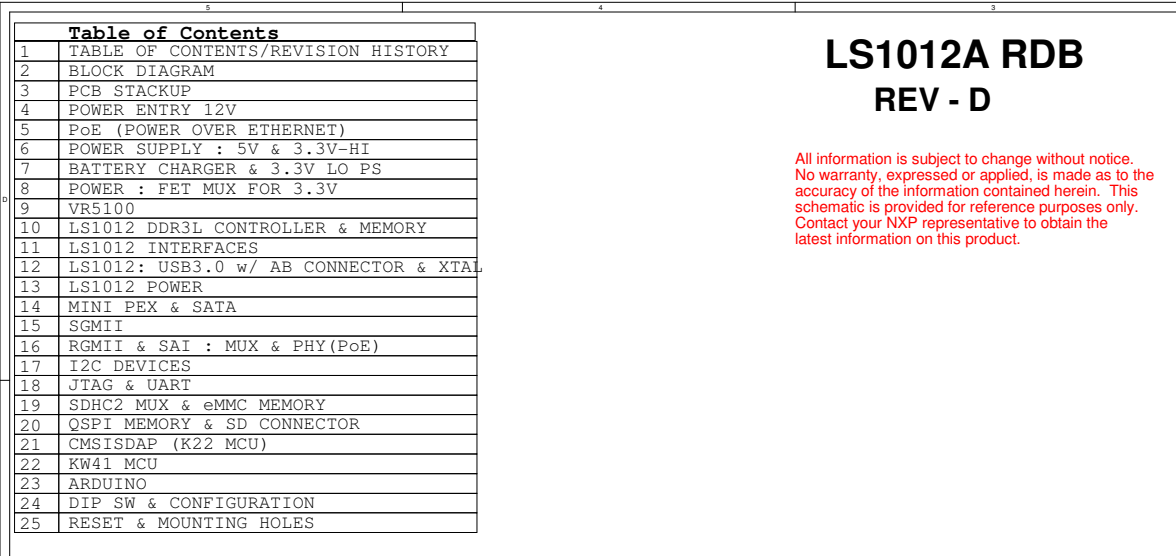
[picture p36: page 1]
LS1012A RDB; REV - D; Drawing Title:; Size; Document Number; Rev; Date:; Sheet; Page Title:; ICAP Classification:; IUO:; PUBI:; SCH-28872 PDF: SPF-28872; LS1012ARDB; Wednesday, October 26, 2016; 001_TABLE OF CONTENTS; X ___ ___ Drawing Title:

Rev | Date | Changes
X1 | 10/09/2015 | First Release
X2 | 18/09/2015 | Implemented internal review comments
X3 | 19/11/2015 | Implemented changes required for Layout.
A | 23/11/2015 | A85 Release. Implemented Power_OK changes.
AX1 | 28/12/2015 | A70 Release: Architecture changes for UART & JTAG MUX.
15/1/2016 | A70 Release: UART transceiver and bringup erratas AX2 .
B A85 Release. 28/1/2016
BX1 | 28/4/2016 | Implemented bringup errata. Refre Errata for more details.
C | 03/05/2016 | A85 Release.
CX1 | 03/06/2016 | Added on board oscillator(25MHz) with Clock buffer to provide reference clock for LS1012 SOC and SGMII PHY. Errata in power mux 3.3V.

1 | TABLE OF CONTENTS/REVISION HISTORY
2 | BLOCK DIAGRAM
3 | PCB STACKUP
4 | POWER ENTRY 12V
5 | PoE (POWER OVER ETHERNET)
6 | POWER SUPPLY : 5V & 3.3V-HI
7 | BATTERY CHARGER & 3.3V LO PS
8 | POWER : FET MUX FOR 3.3V
9 | VR5100
10 | LS1012 DDR3L CONTROLLER & MEMORY
11 | LS1012 INTERFACES
12 | LS1012: USB3.0 w/ AB CONNECTOR & XTAL
13 | LS1012 POWER
14 | MINI PEX & SATA
15 | SGMII
16 | RGMII & SAI : MUX & PHY(PoE)
17 | I2C DEVICES
18 | JTAG & UART
19 | SDHC2 MUX & eMMC MEMORY
20 | QSPI MEMORY & SD CONNECTOR
21 | CMSISDAP (K22 MCU)
22 | KW41 MCU
23 | ARDUINO
24 | DIP SW & CONFIGURATION
25 | RESET & MOUNTING HOLES

No warranty, expressed or applied, is made as to the
accuracy of the information contained herein. This
schematic is provided for reference purposes only.
Contact your NXP representative to obtain the
latest information on this product.

D | 26/10/2016 | A085 release.

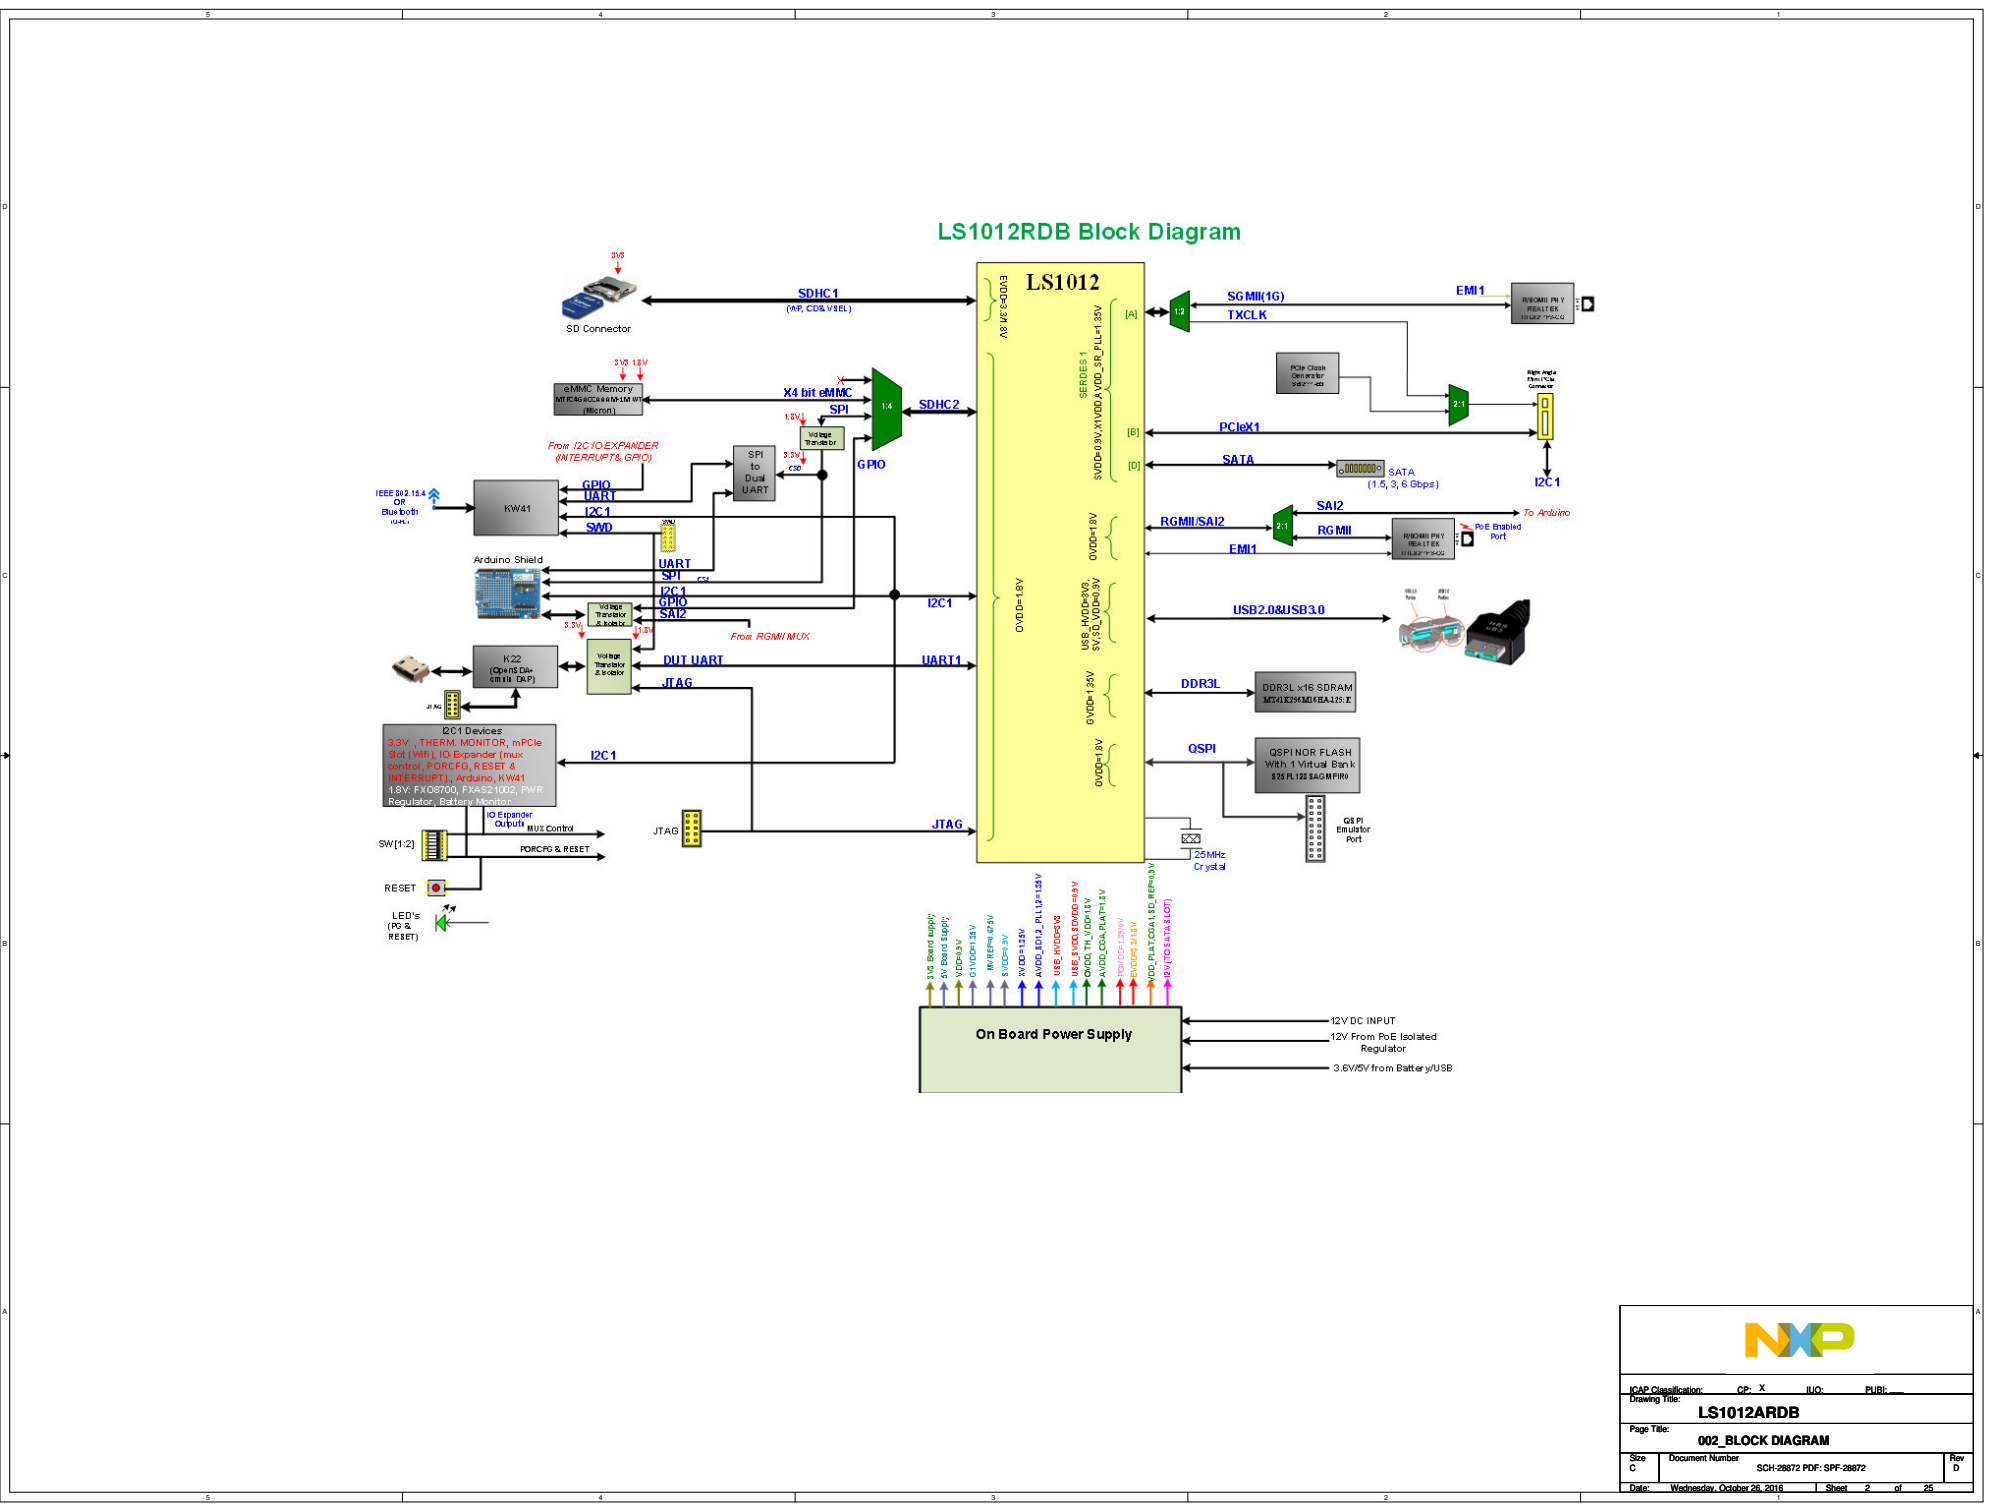
[picture p37: page 2]
Drawing Title:; ICAP Classification:; IUO:; PUBI:; 002_BLOCK DIAGRAM; X ___ ___ Drawing Title:

# PCB STACKUP

# NOTE:

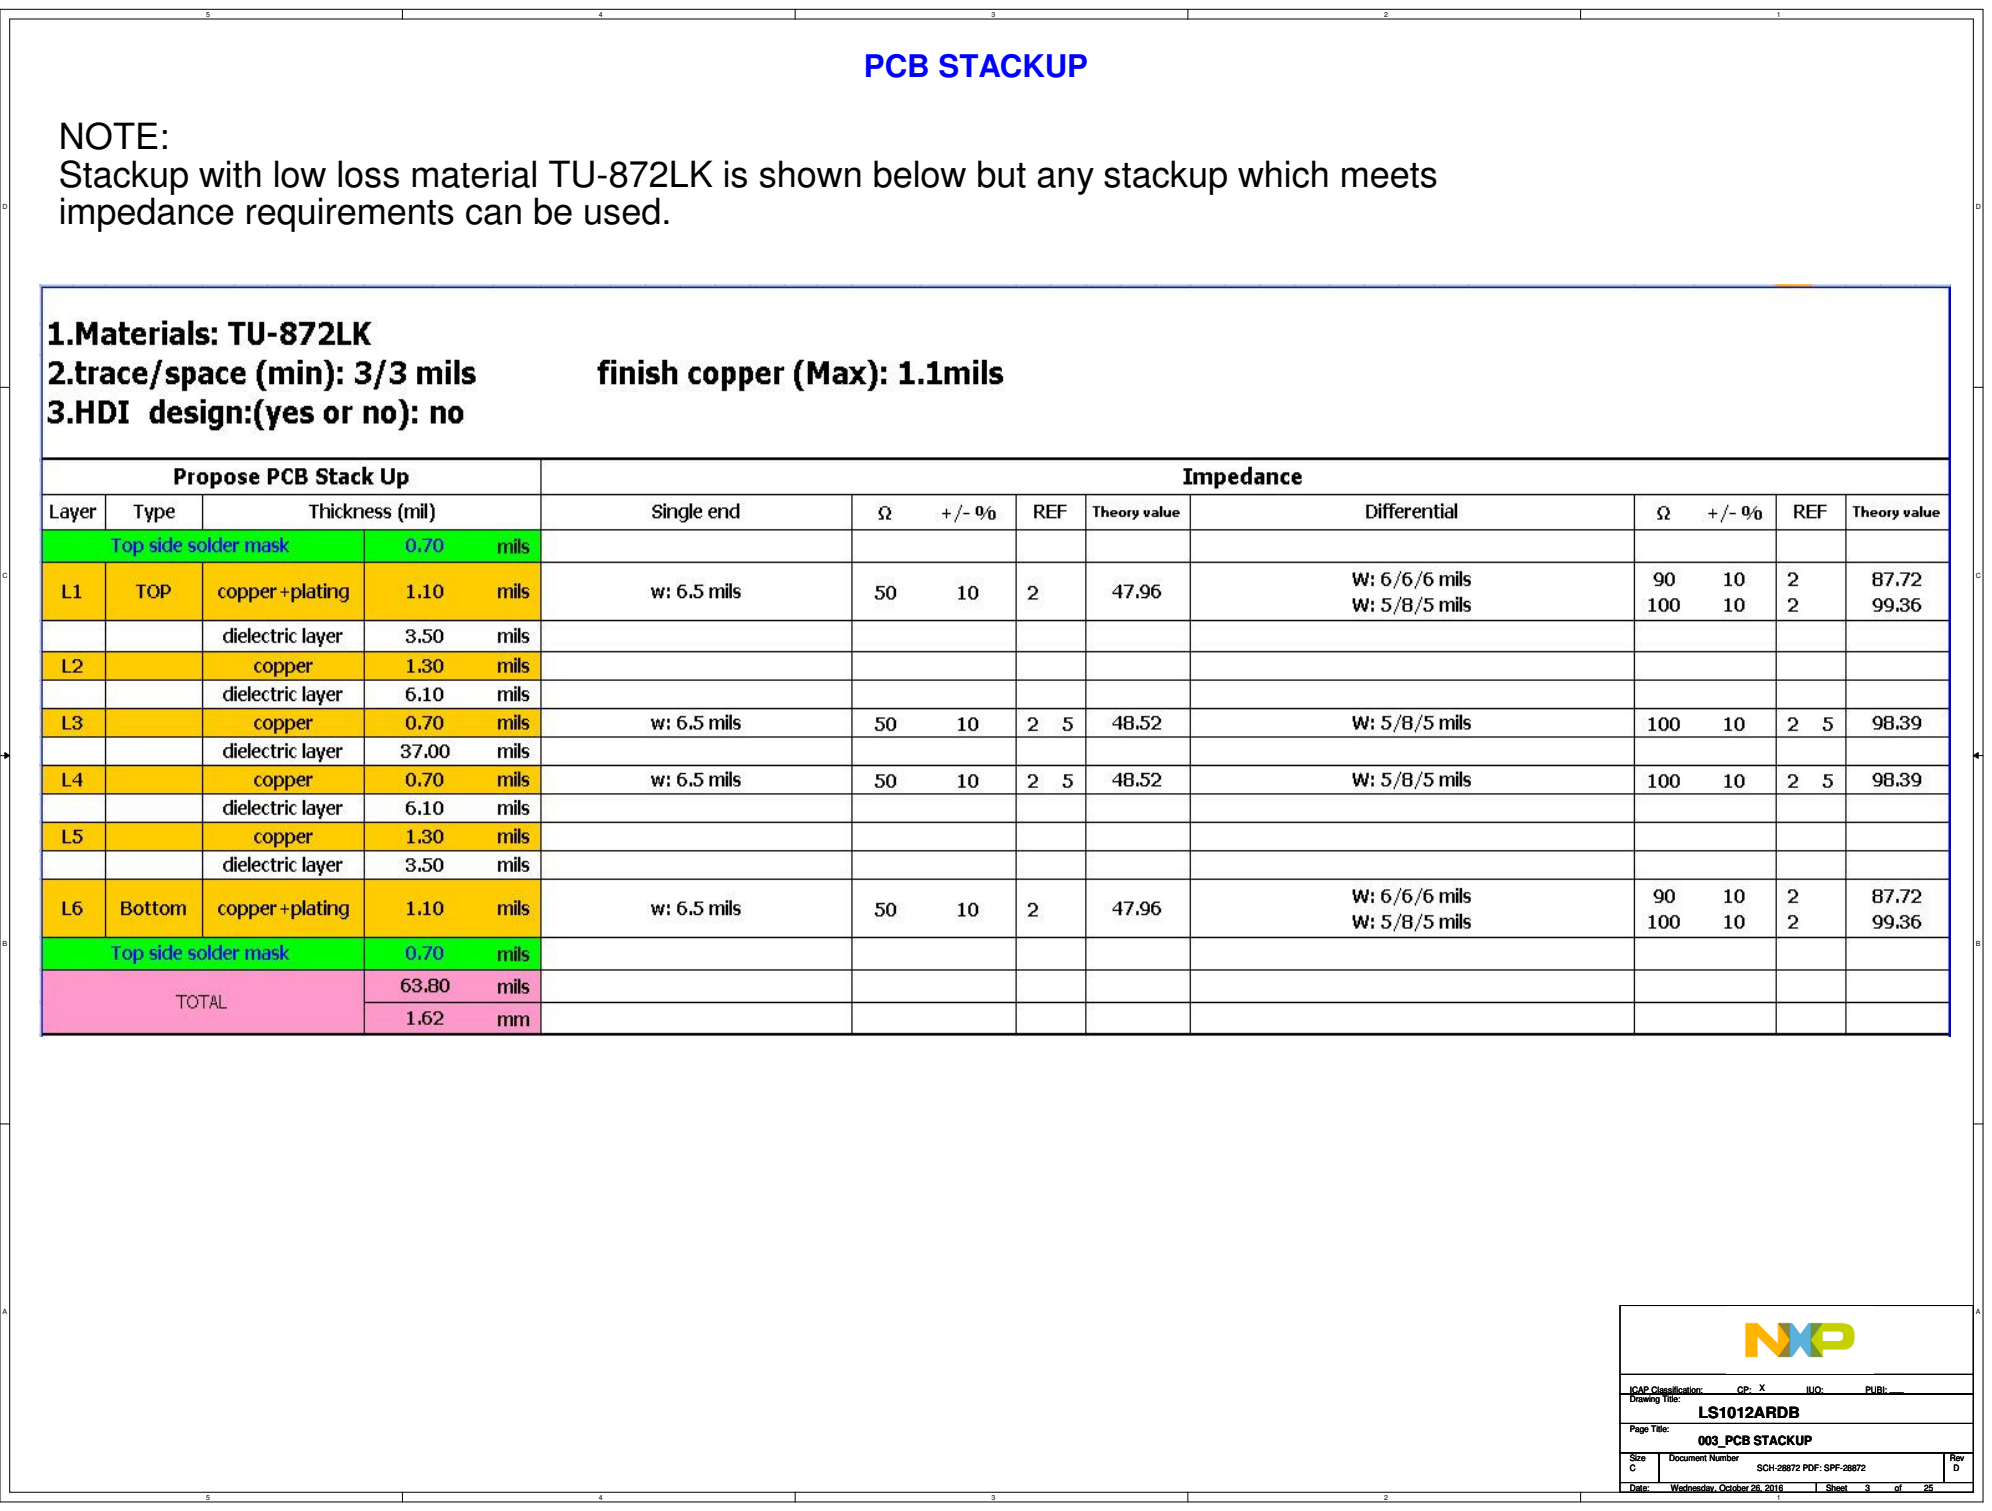
[picture p38: page 3]
Drawing Title:; ICAP Classification:; IUO:; PUBI:; 003_PCB STACKUP; X ___ ___ Drawing Title:

Stackup with low loss material TU-872LK is shown below but any stackup which meets
impedance requirements can be used.

# POWER ENTRY AND MULTIPLEXING

# 2512 Package to

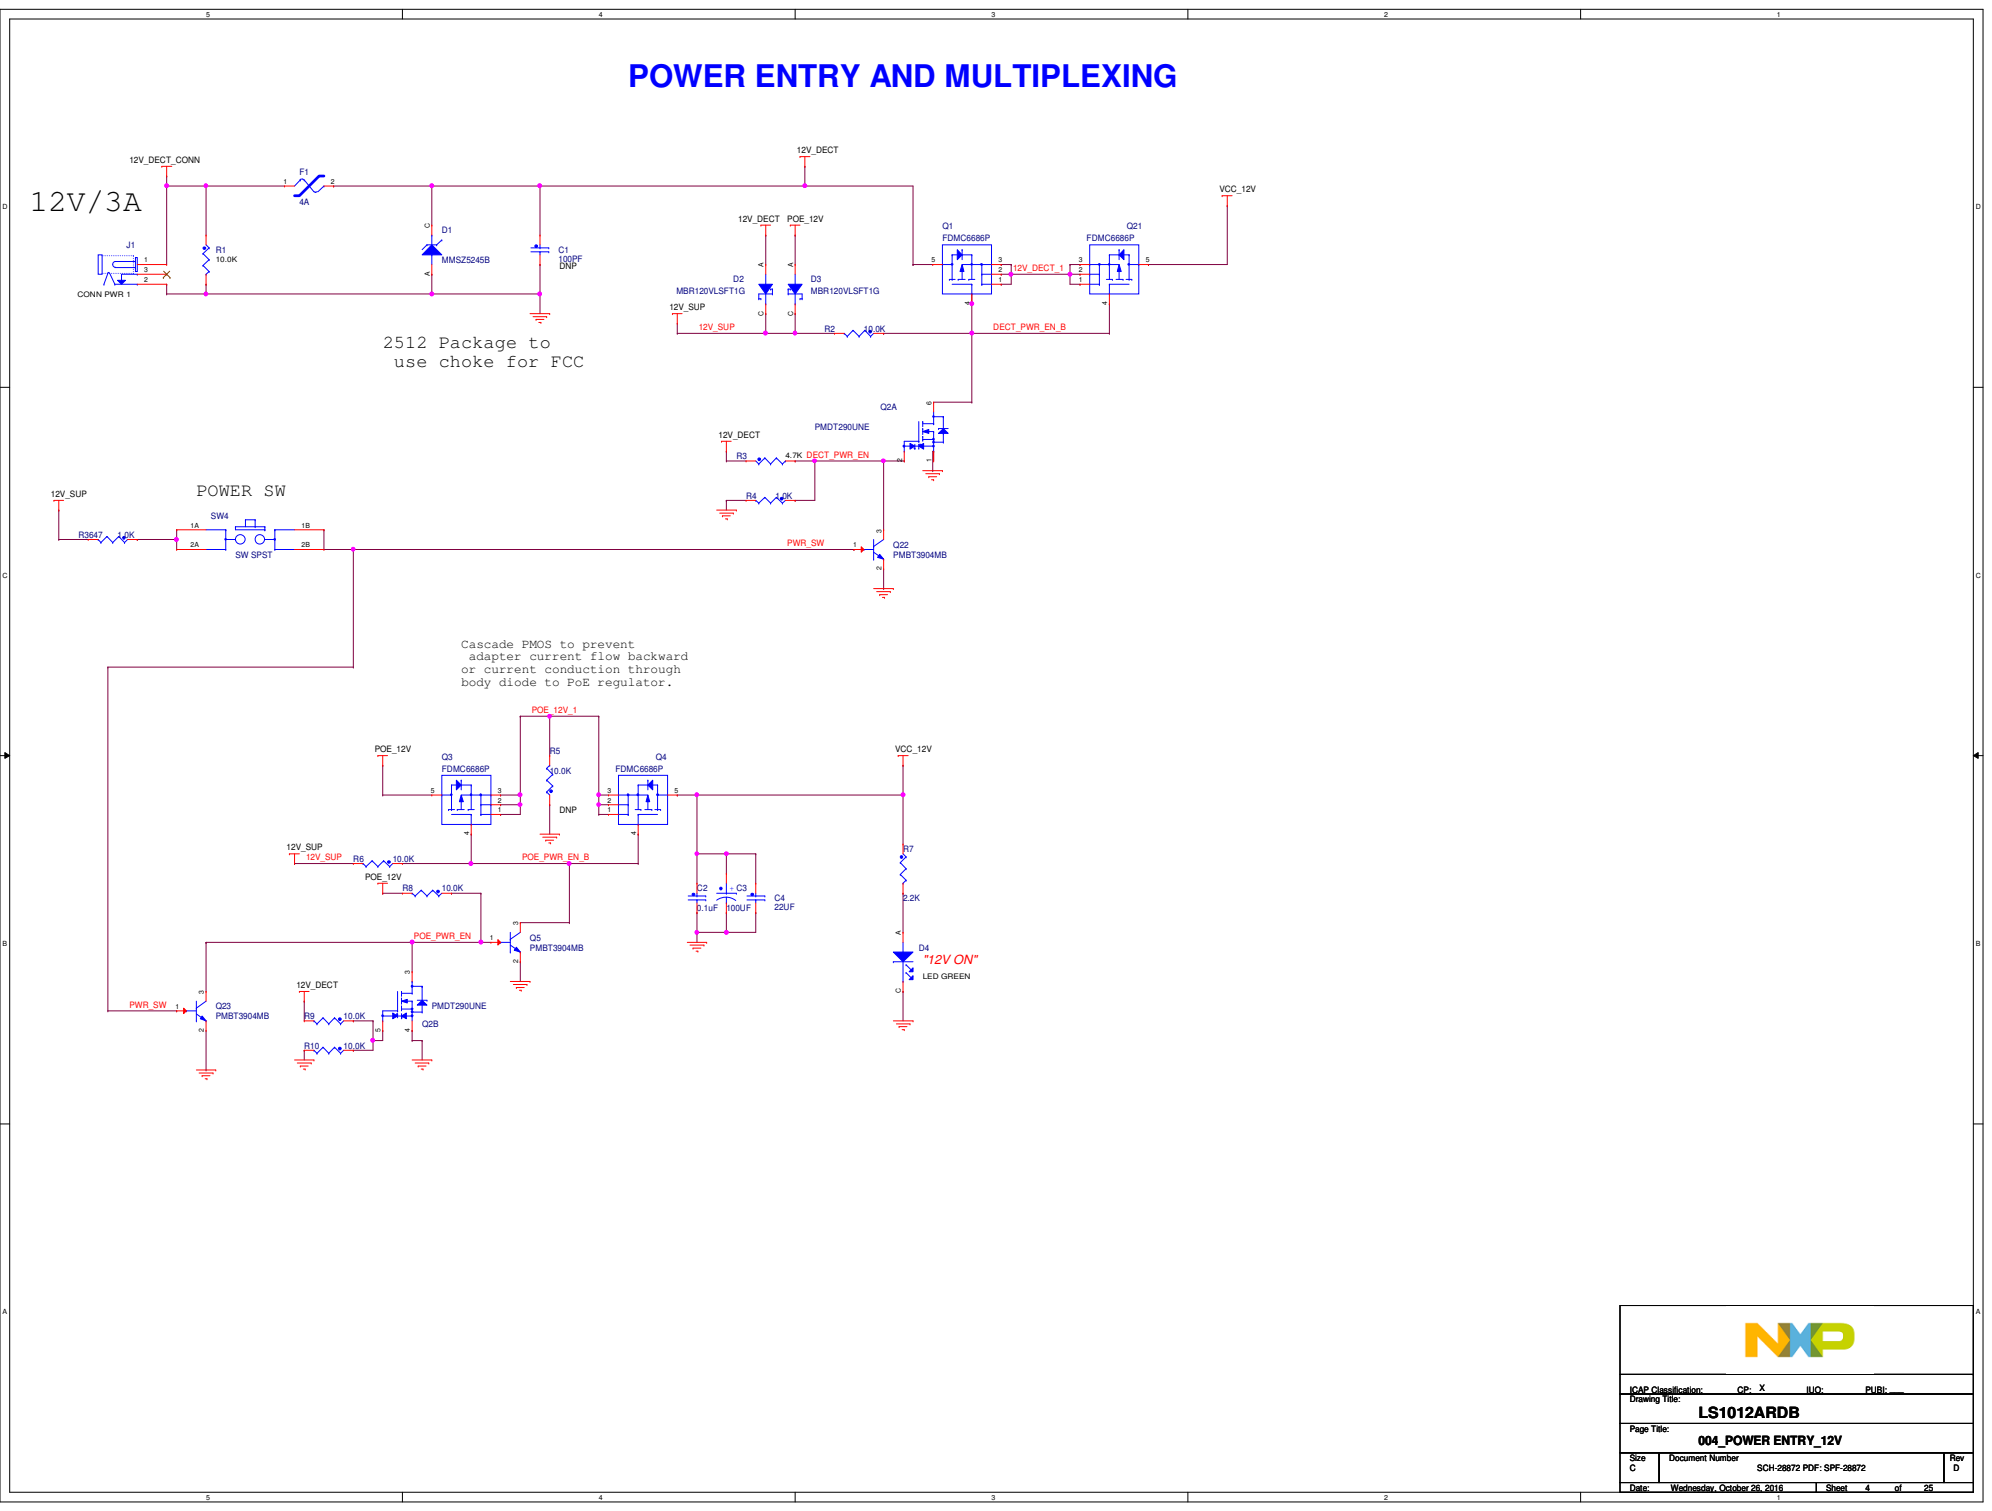
[picture p39: page 4]

use choke for FCC

Cascade PMOS to prevent
adapter current flow backward
or current conduction through
body diode to PoE regulator.

# POE 12V/2.1A, 802.3.at

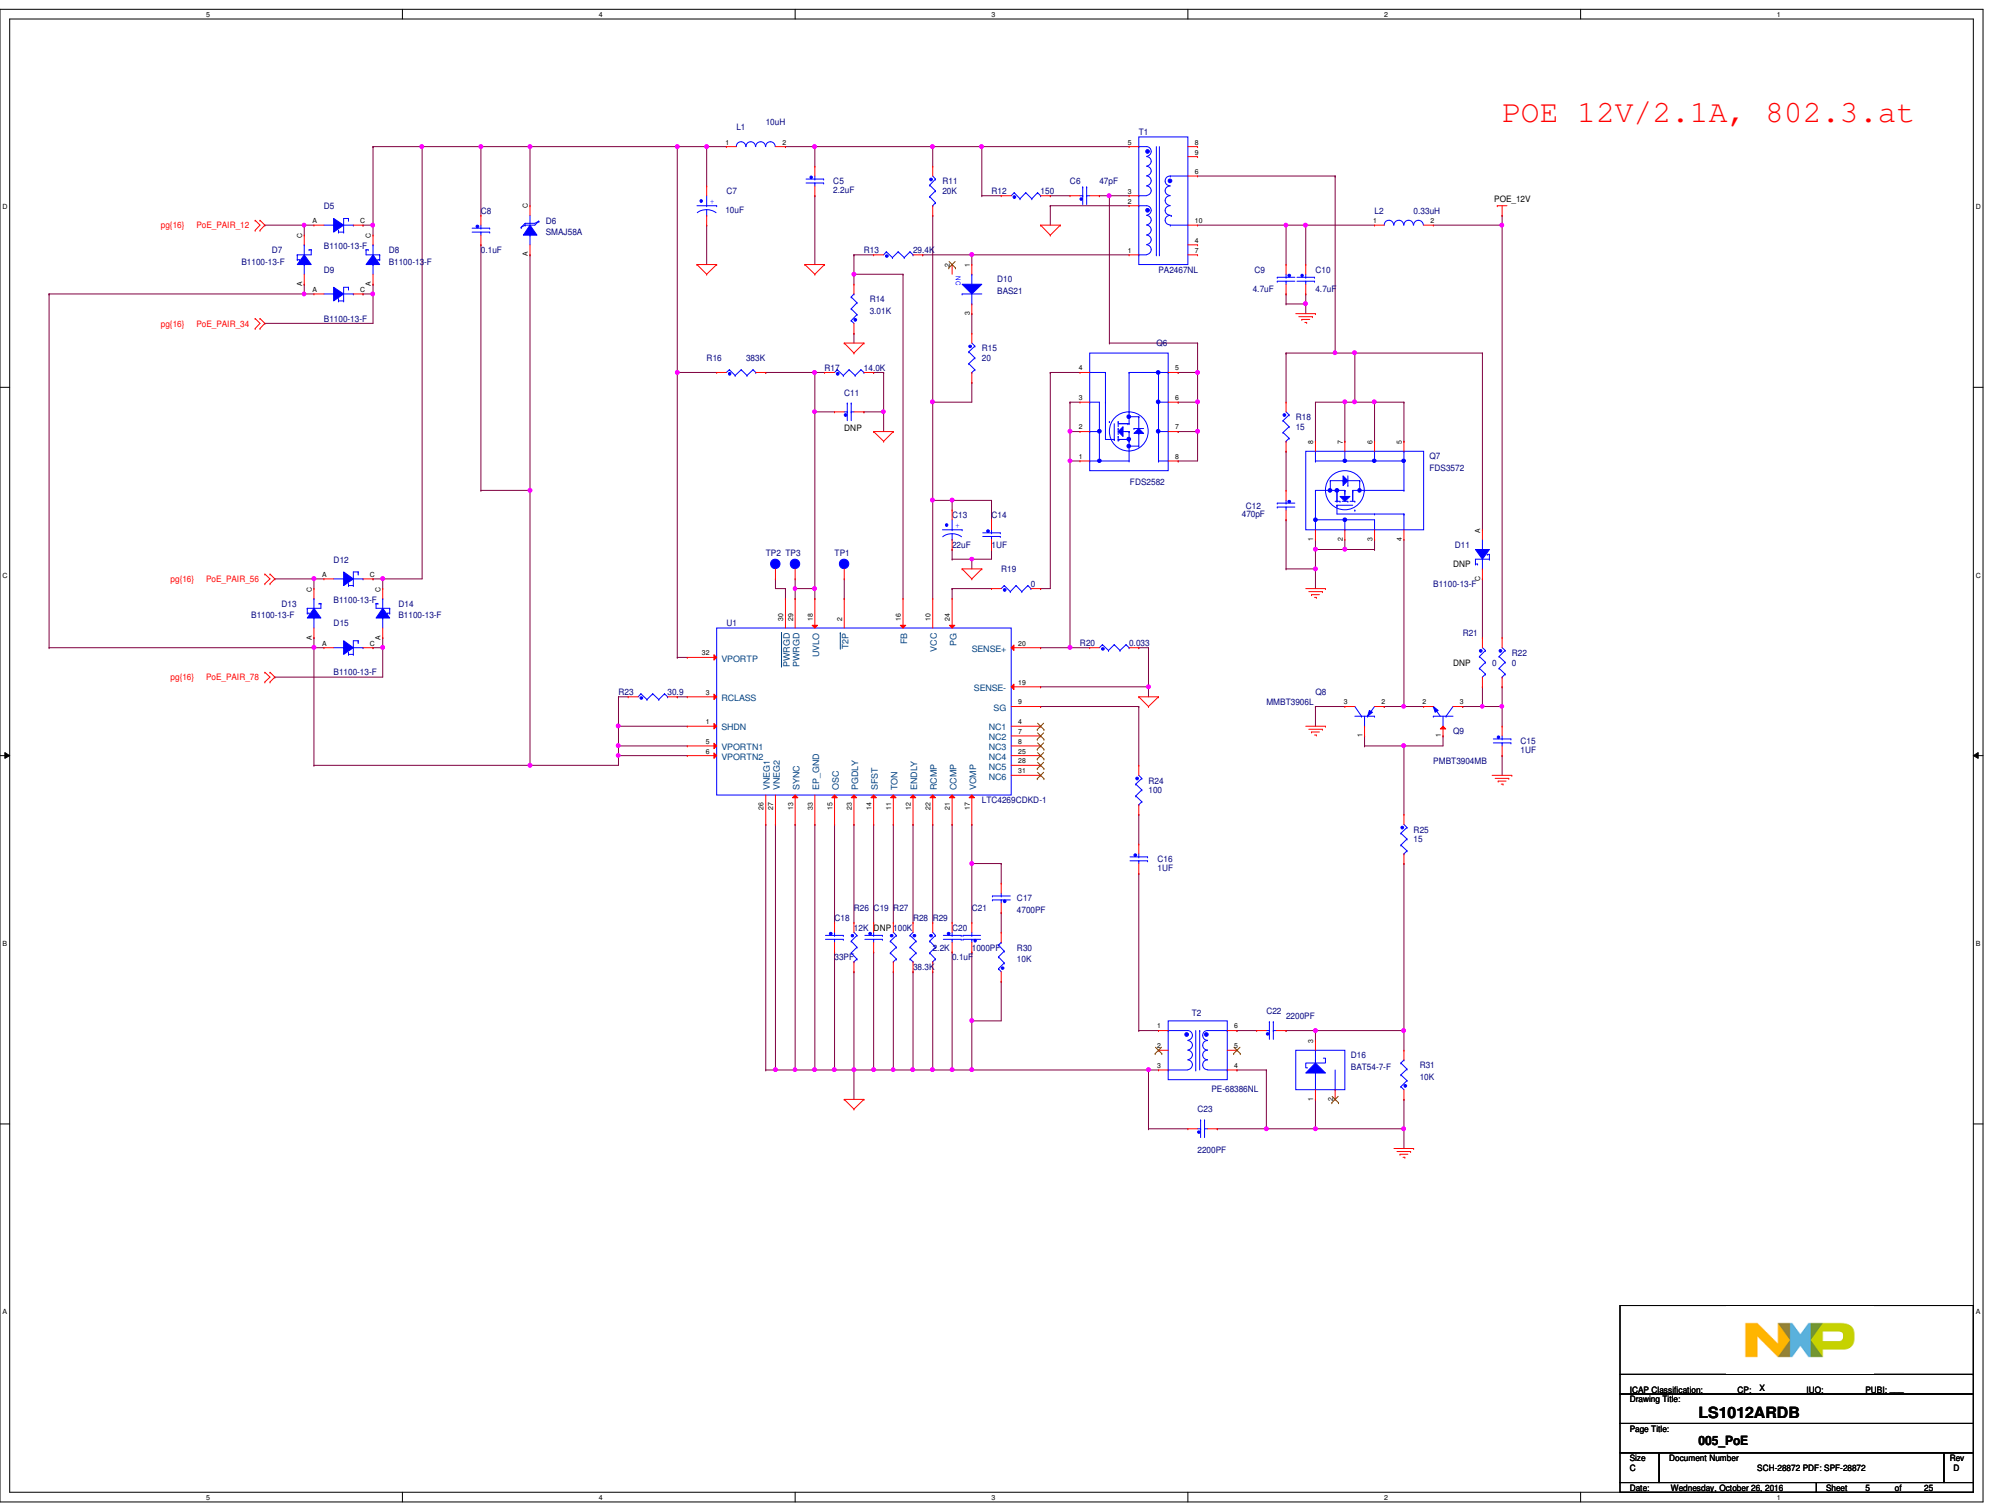
[picture p40: page 5]

## Pulled 'S_CTRL' high for enable 2.5mSec internal soft start

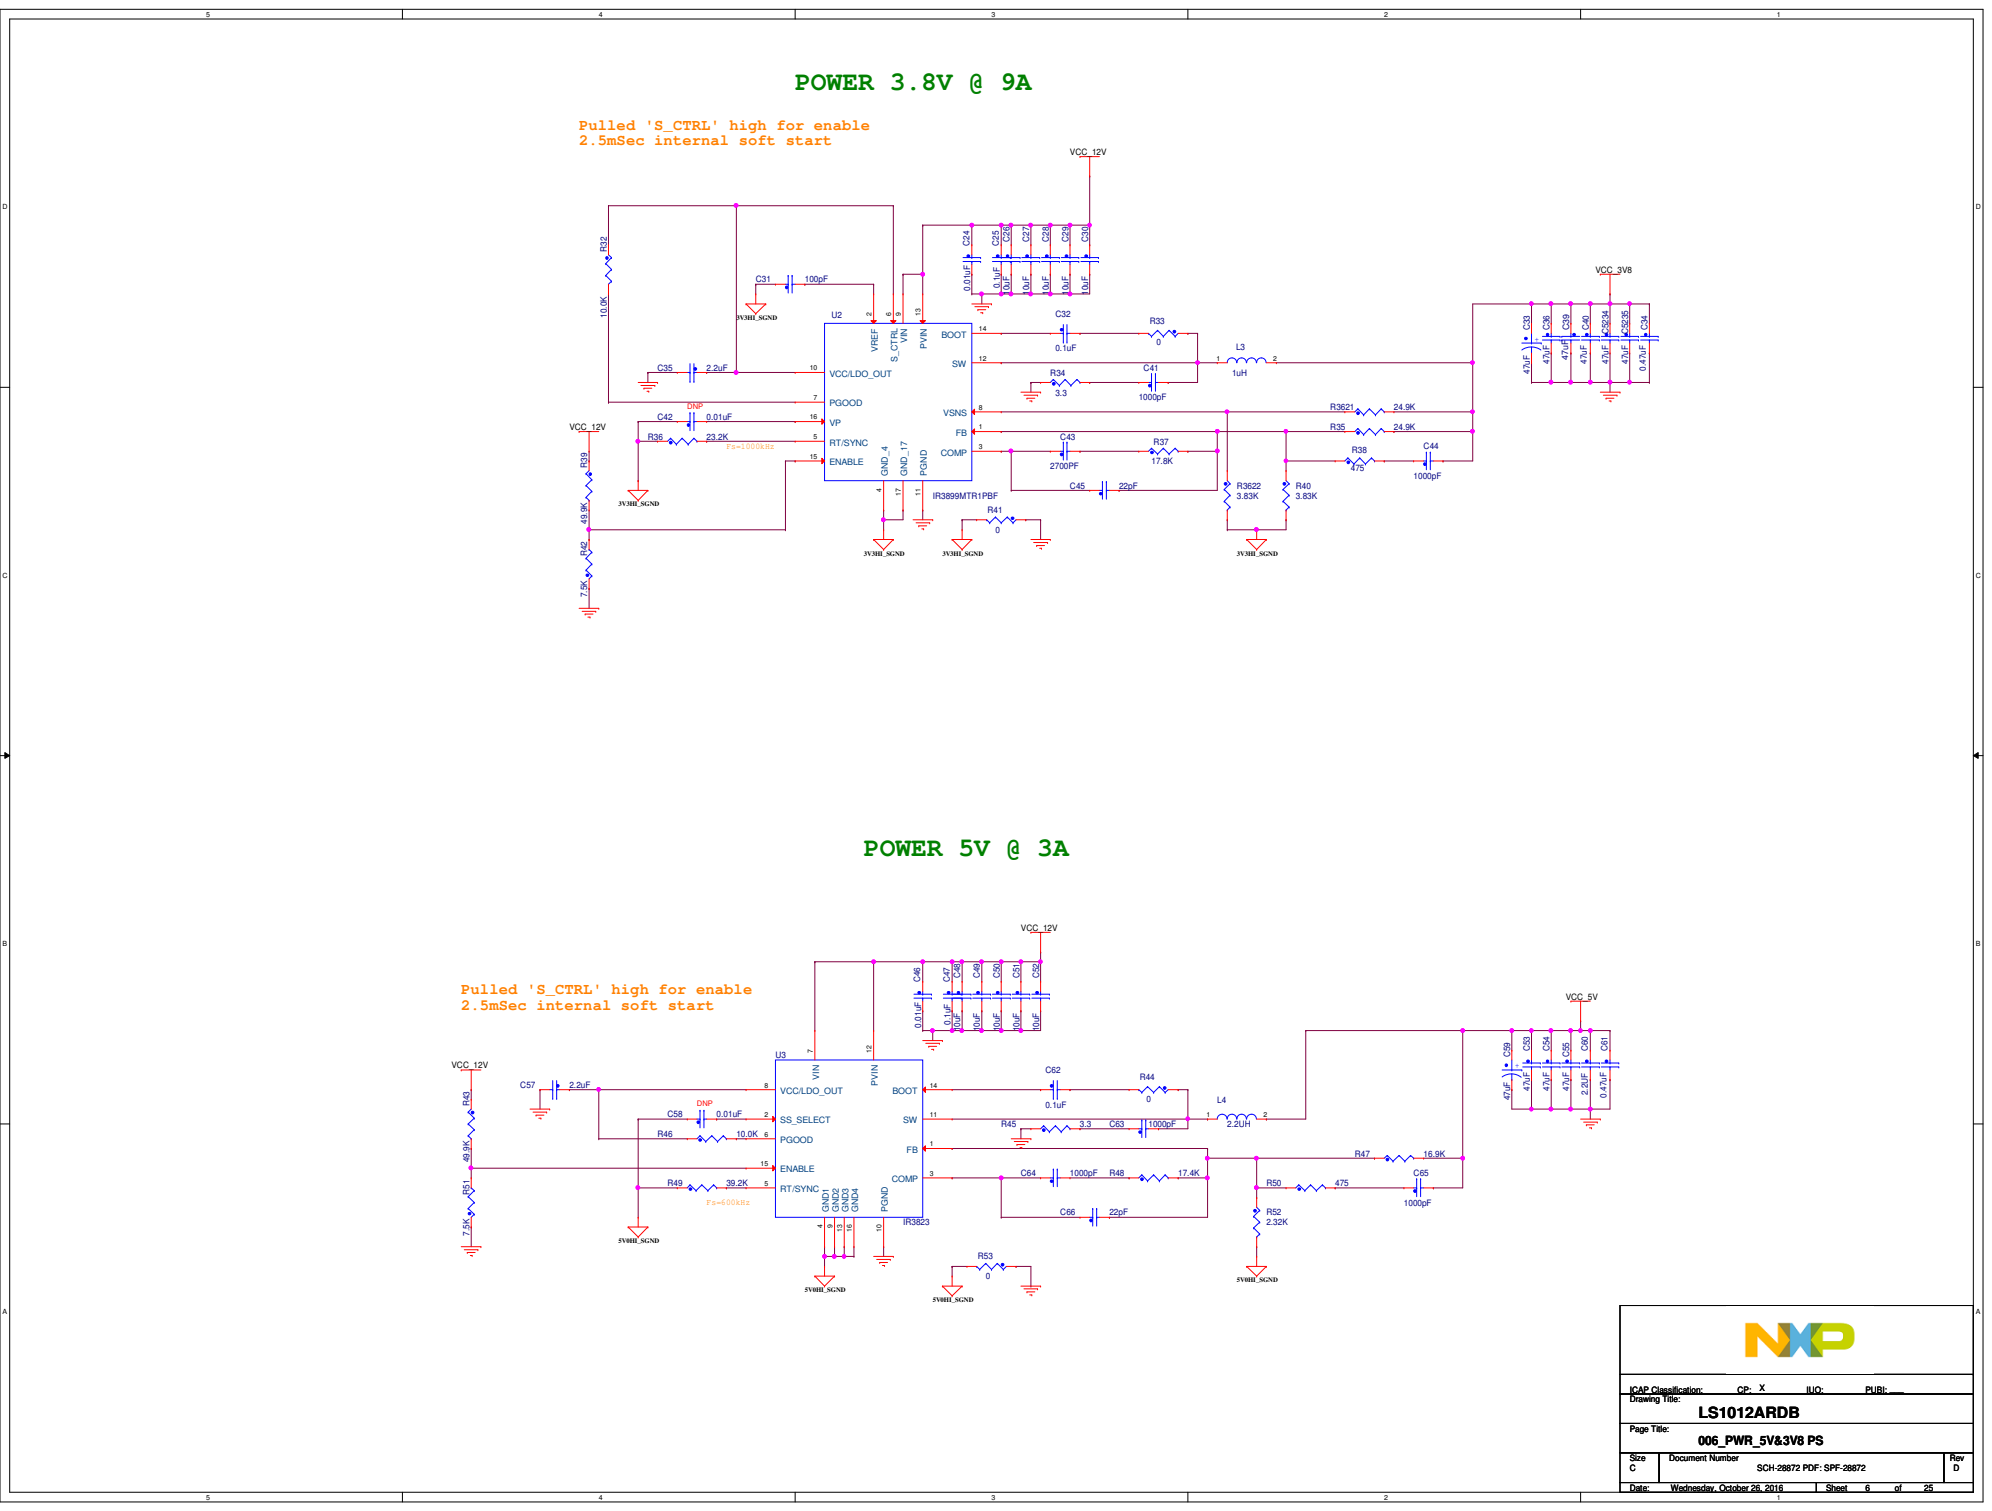
[picture p41: page 6]

Pulled 'S_CTRL' high for enable
2.5mSec internal soft start

# Li-Ion/Li-Poly Batteries

3.6V-4.2V

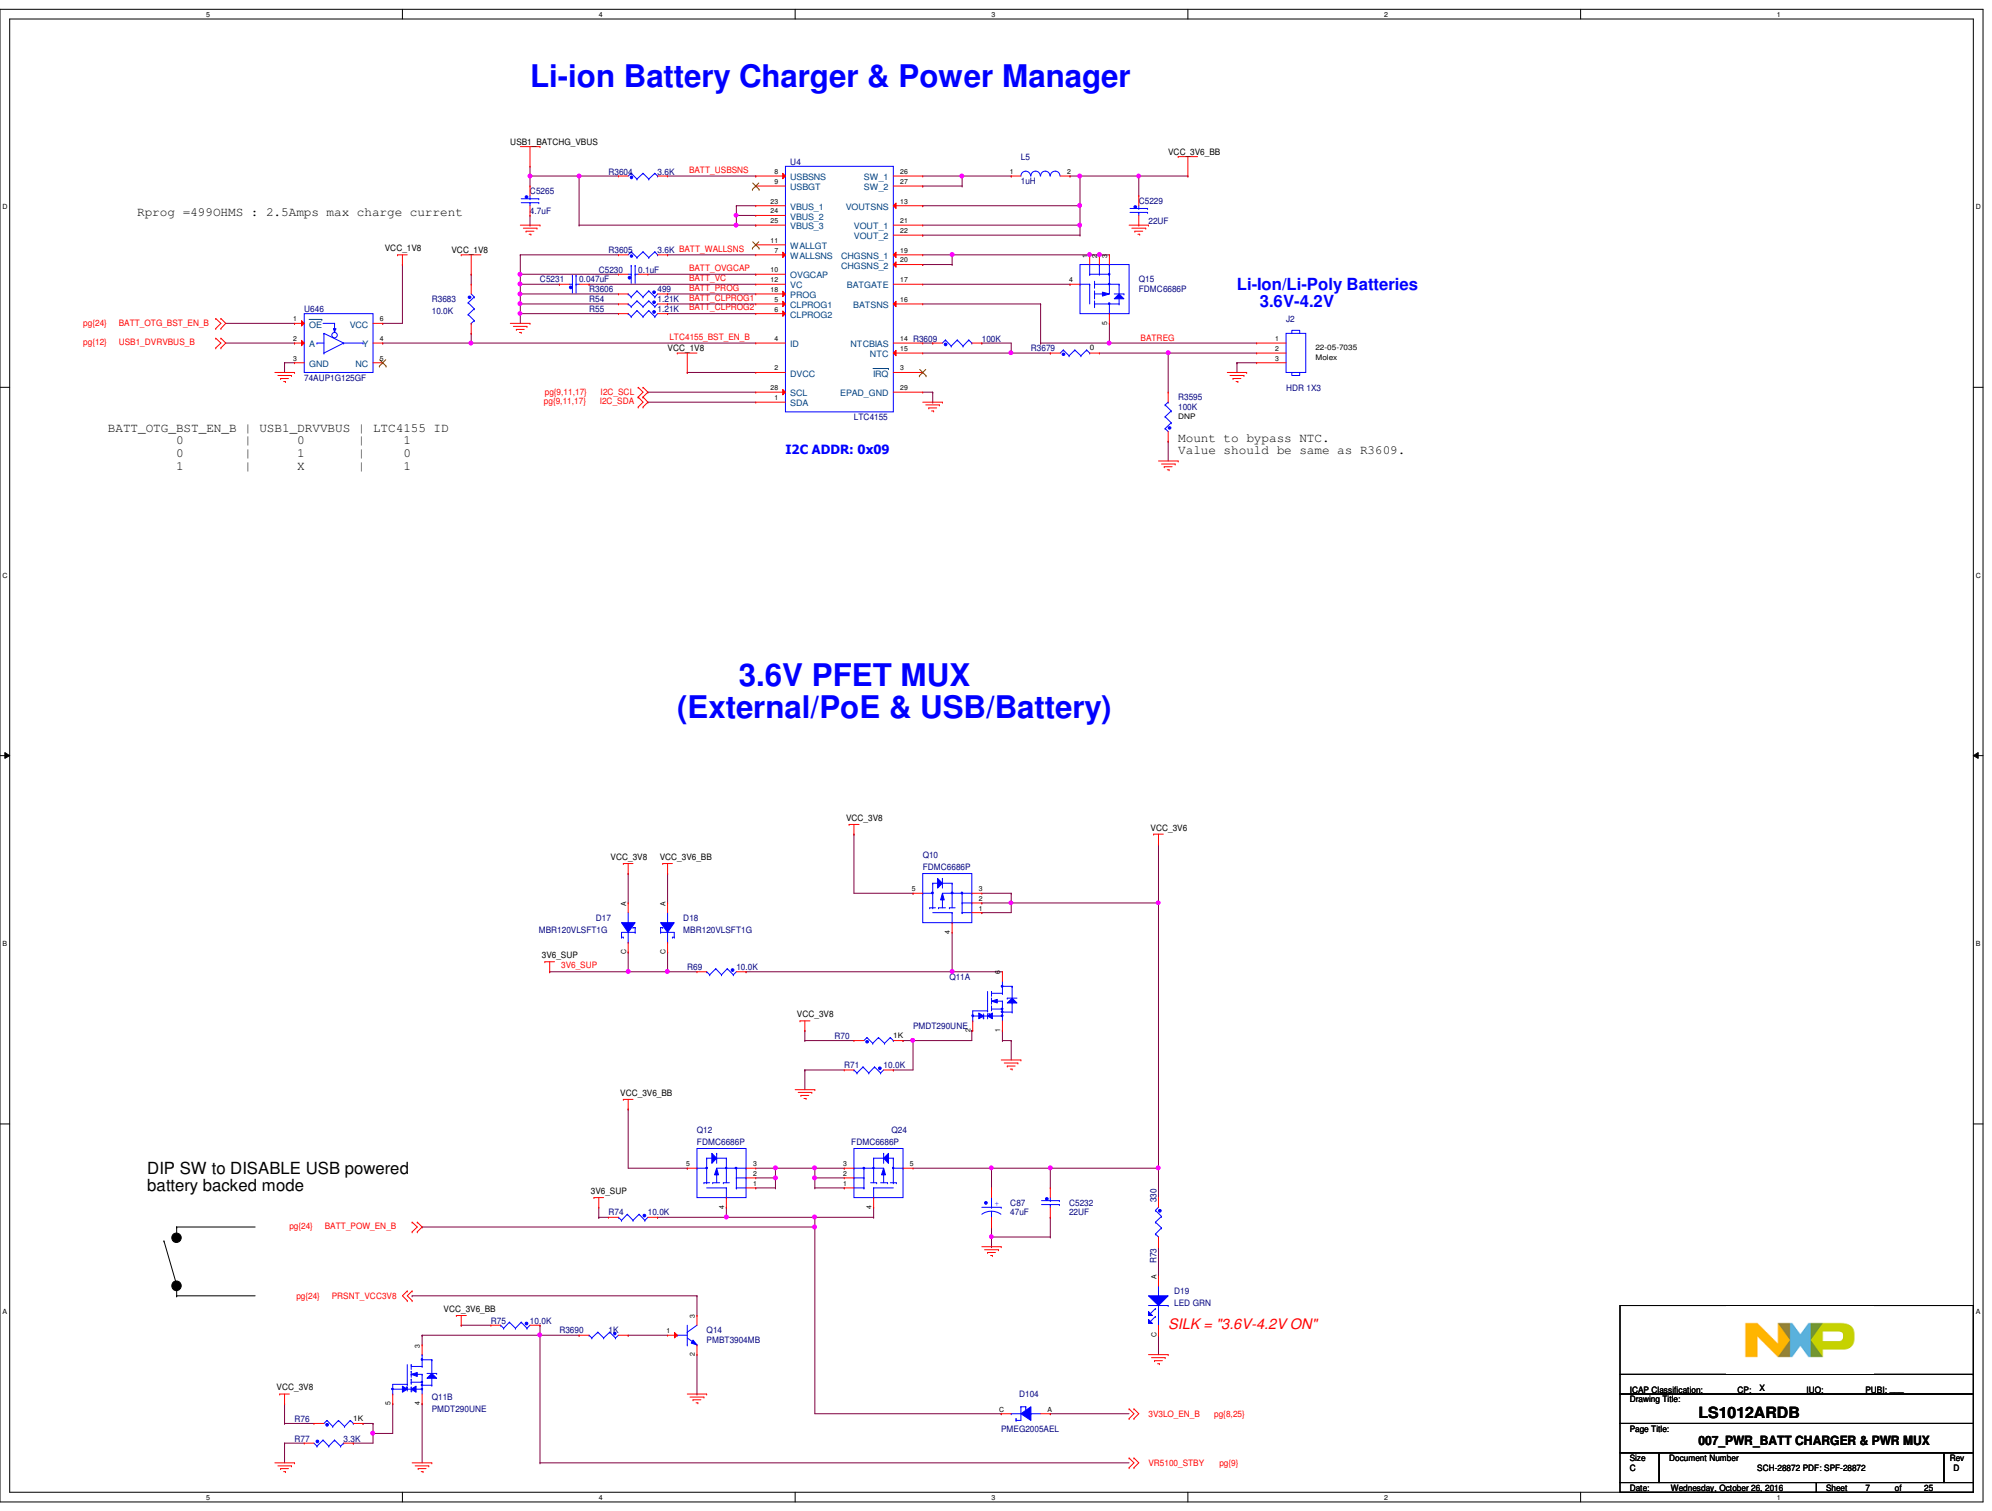
[picture p42: page 7]

Li-ion Battery Charger & Power Manager

Rprog =499OHMS : 2.5Amps max charge current

DNP
Mount to bypass NTC.
Value should be same as R3609.

3.6V PFET MUX
(External/PoE & USB/Battery)

DIP SW to DISABLE USB powered
battery backed mode

# POWER 3.3V

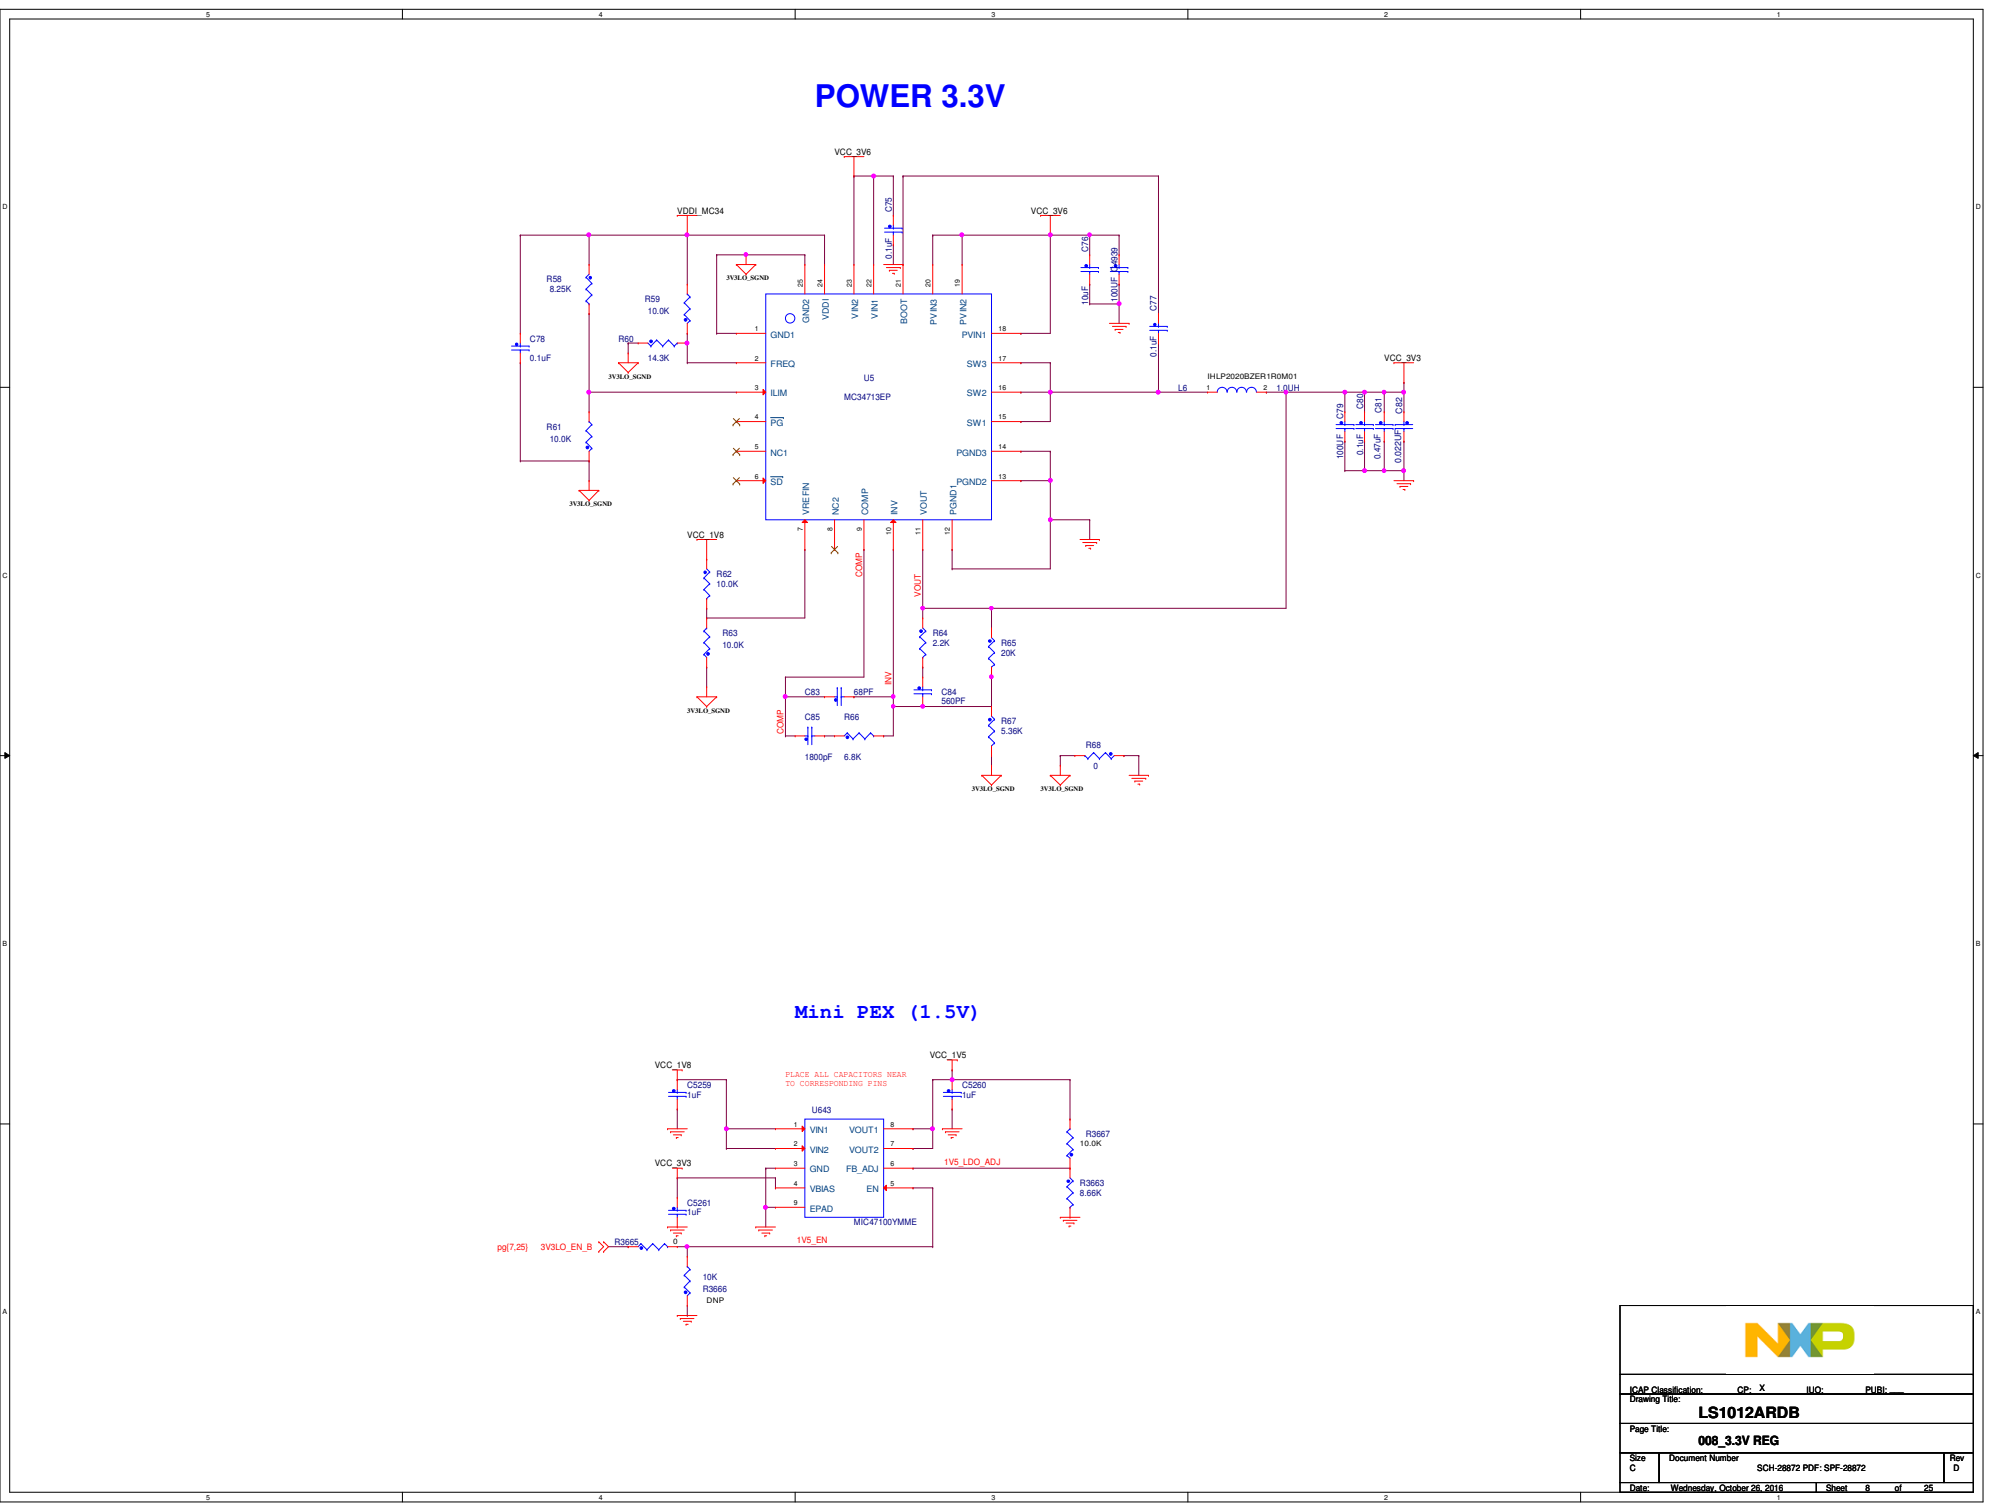
[picture p43: page 8]

PLACE ALL CAPACITORS NEAR
TO CORRESPONDING PINS

3.5A

1.25A

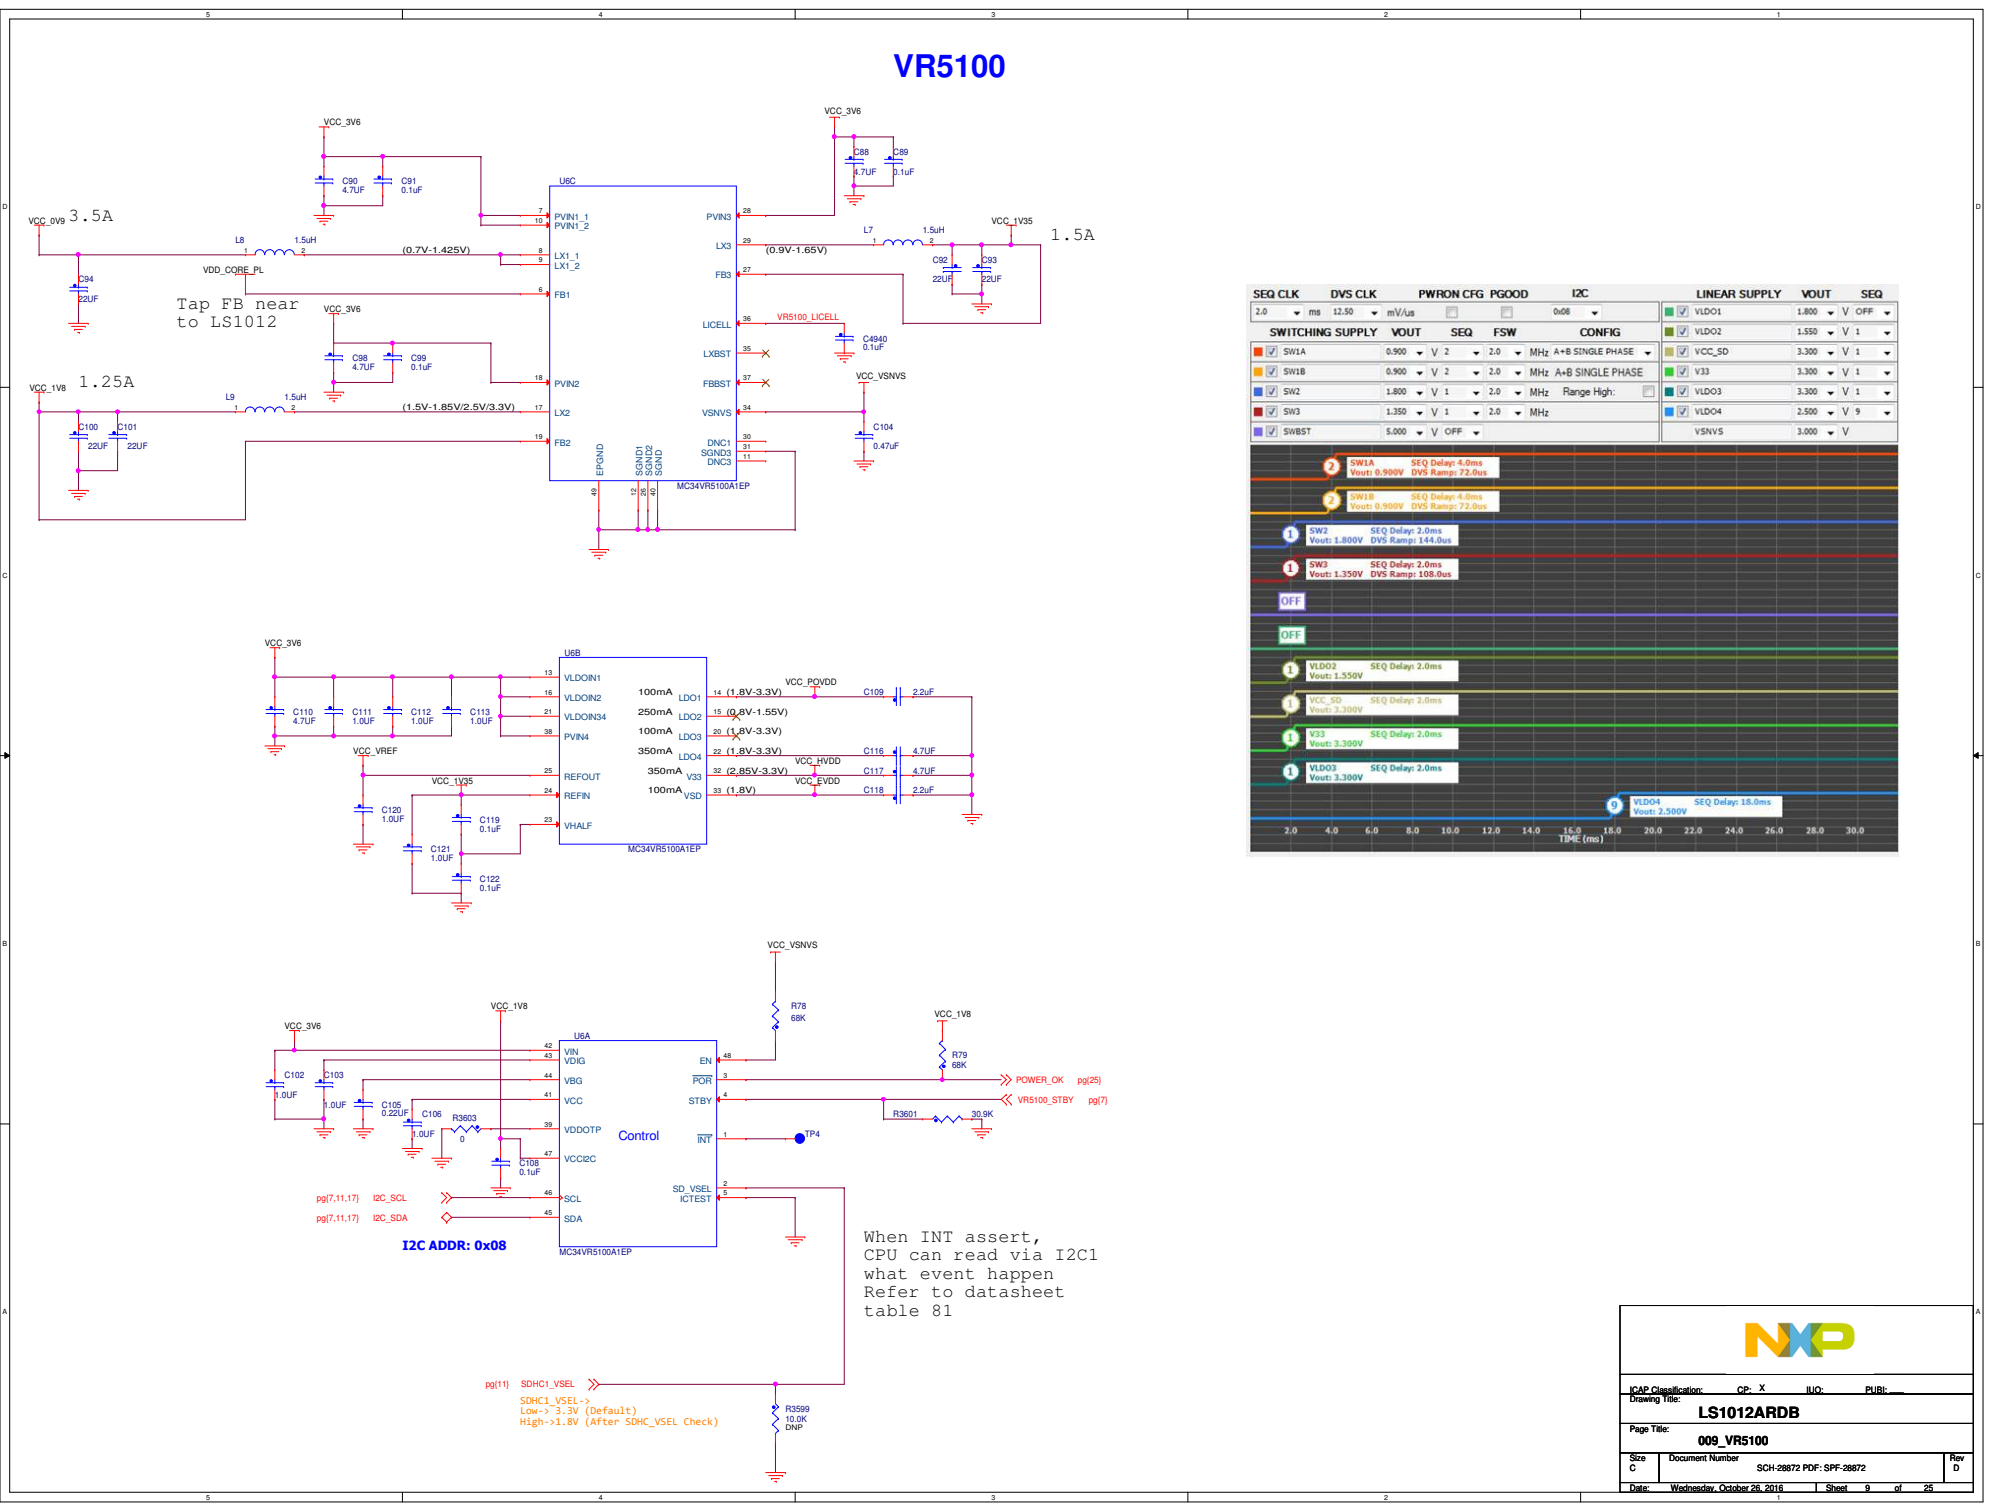
[picture p44: page 9]

When INT assert,
CPU can read via I2C1
what event happen
Refer to datasheet
table 81

# LS1012 DDR3L CONTROLLER BLOCK

### 8G_DDR3_SDRAM_512MX16

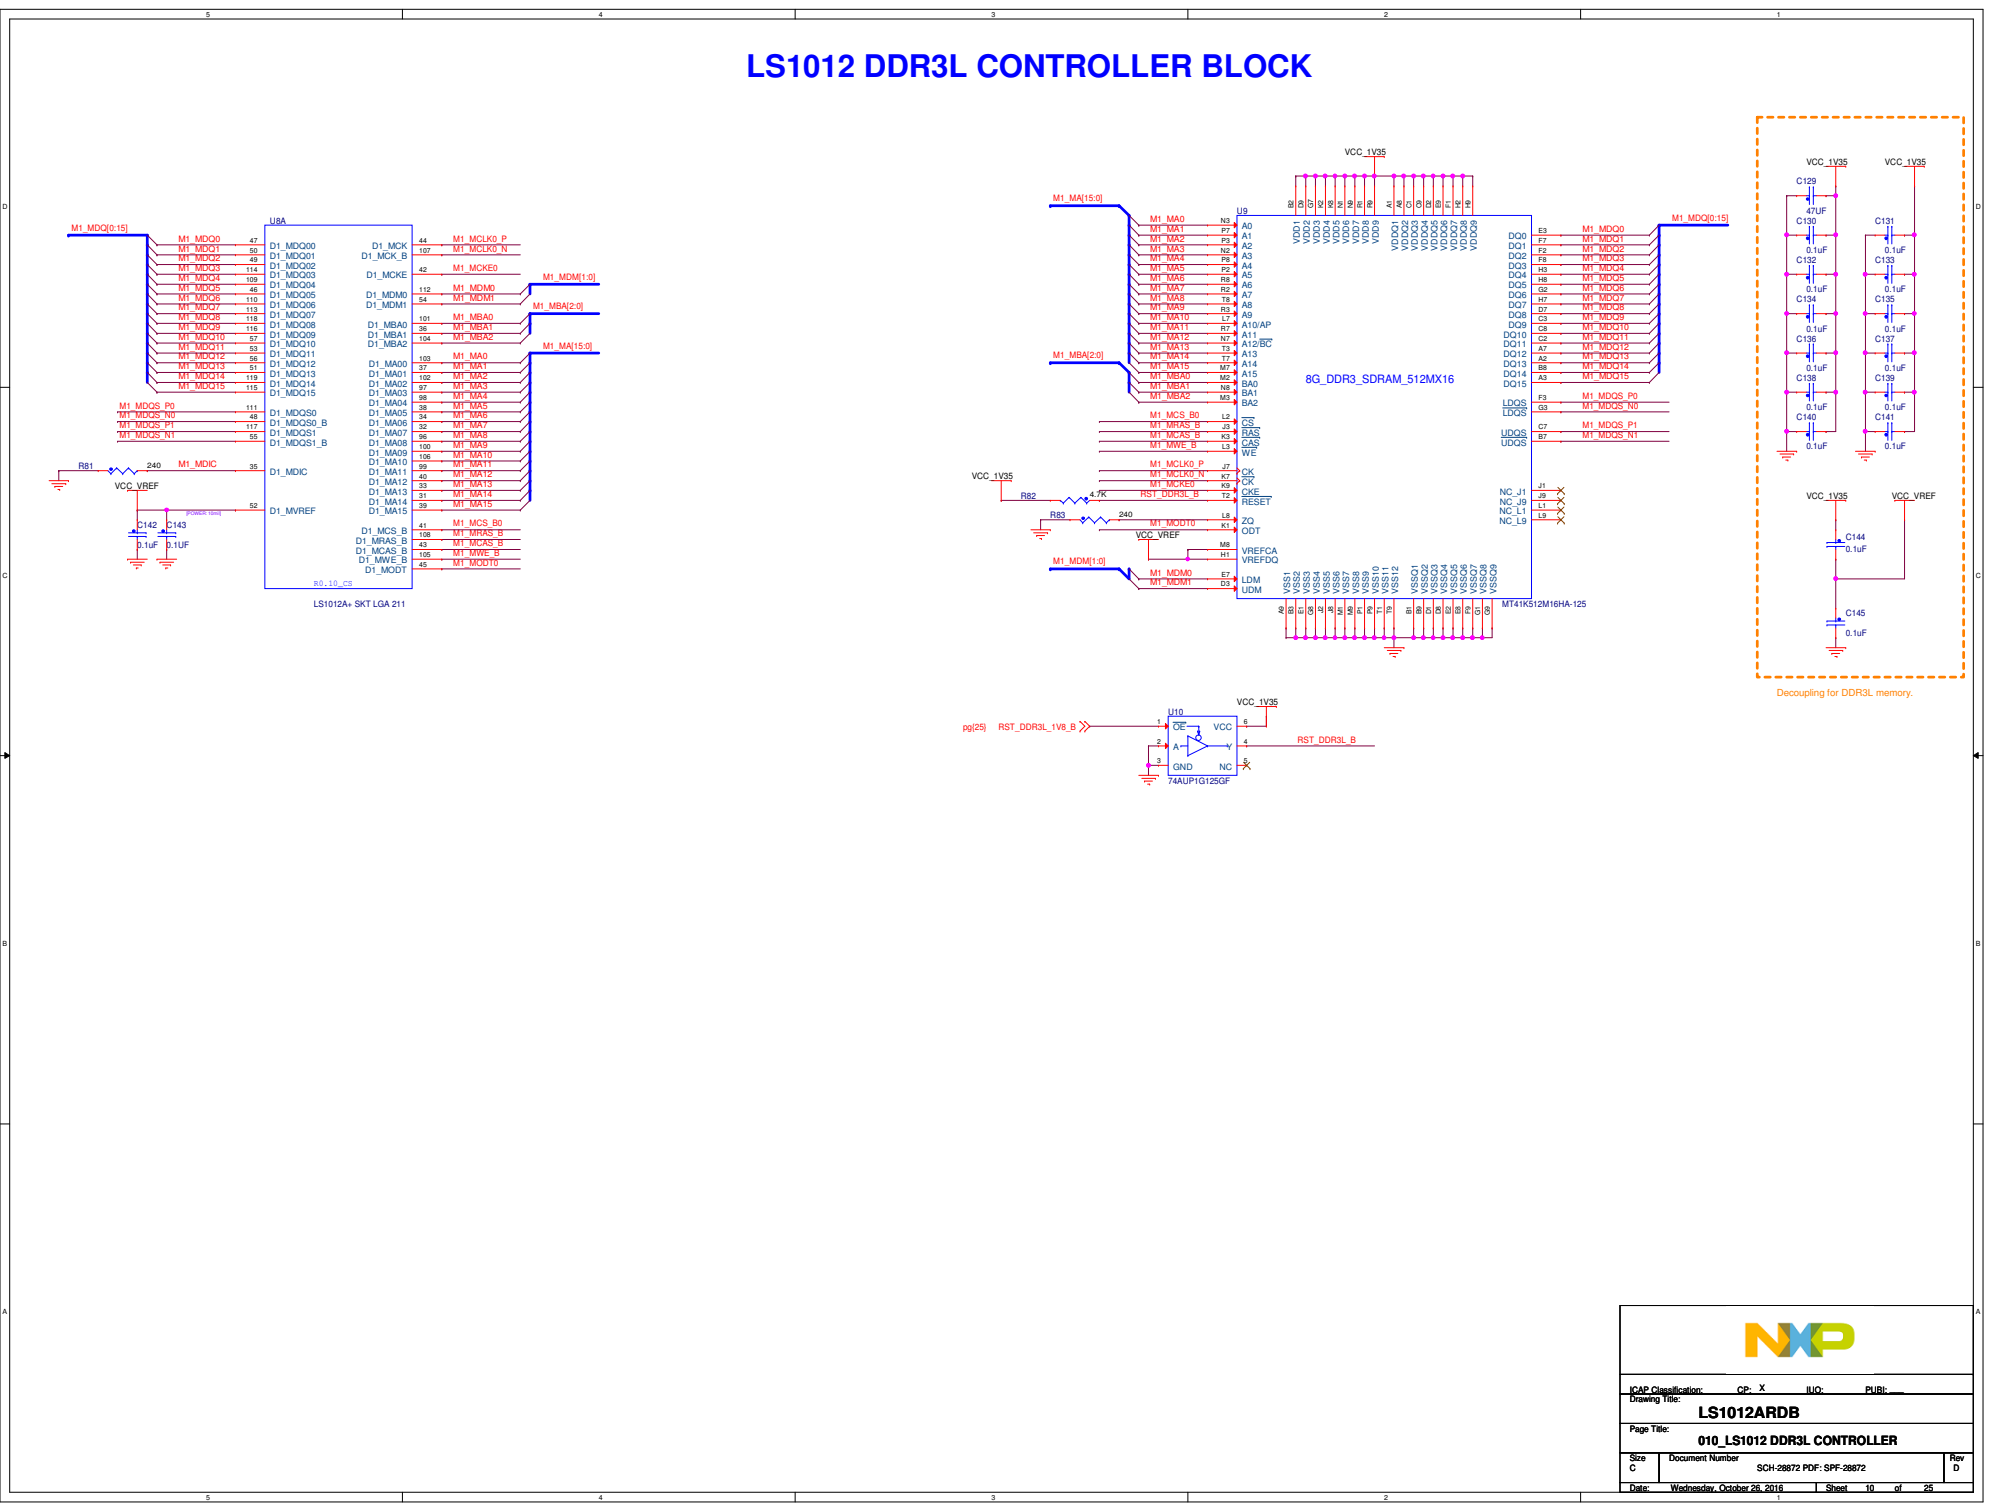
[picture p45: page 10]

# LS1012 SERDES BLOCK

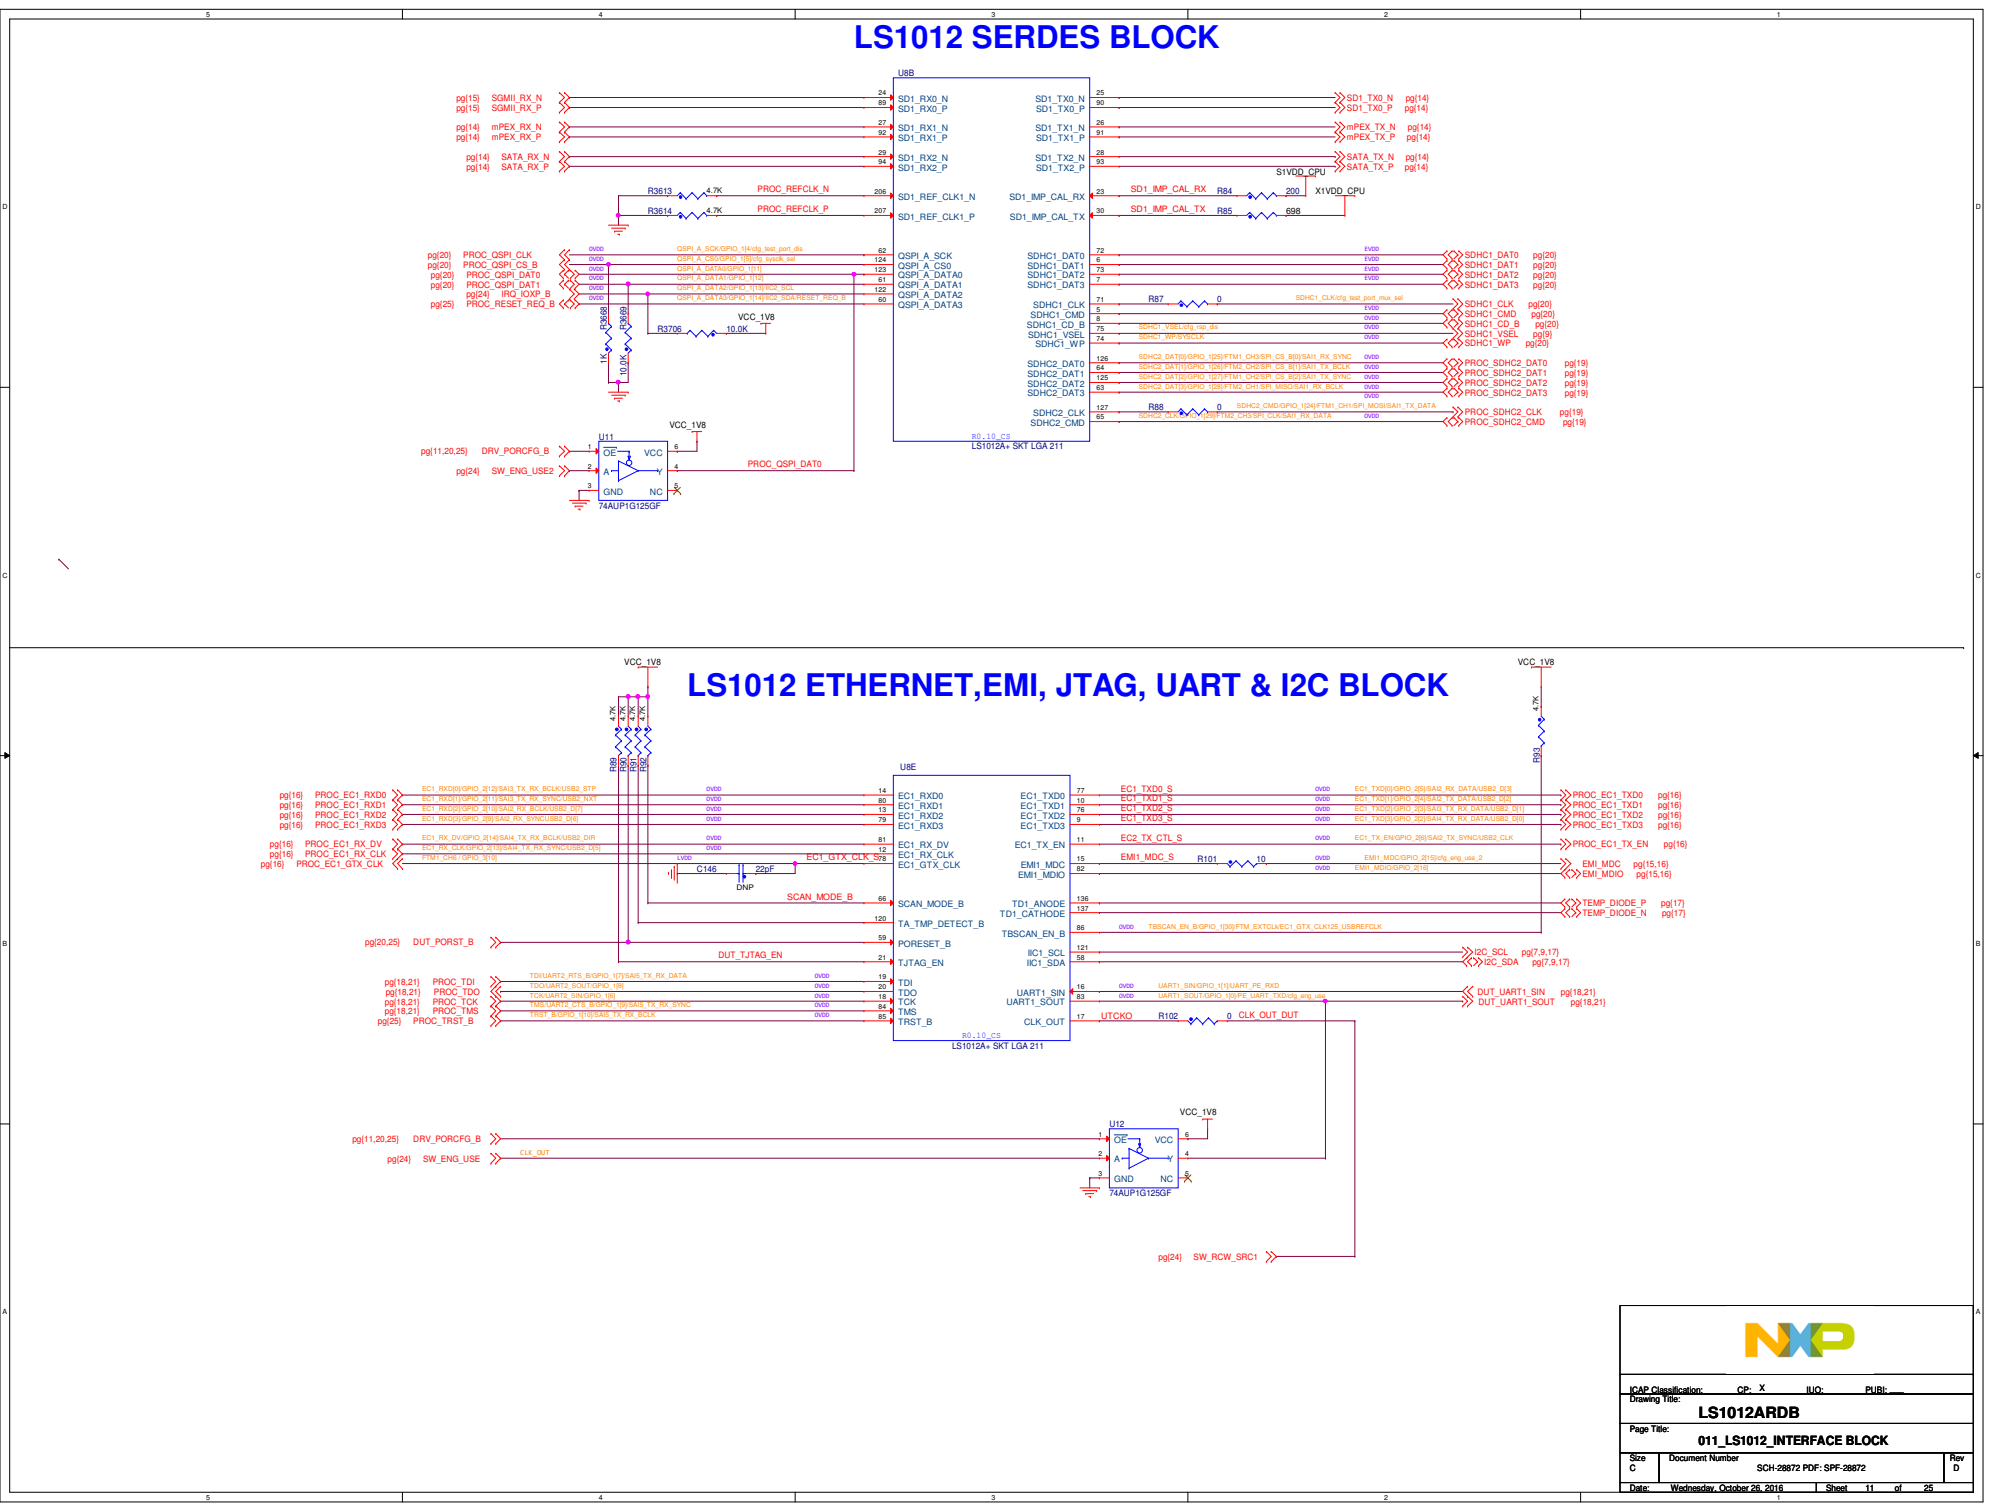
[picture p46: page 11]

VCC_1V8
LS1012 ETHERNET,EMI, JTAG, UART & I2C BLOCK

# USB3.0 CONTROLLER

## NOTE:

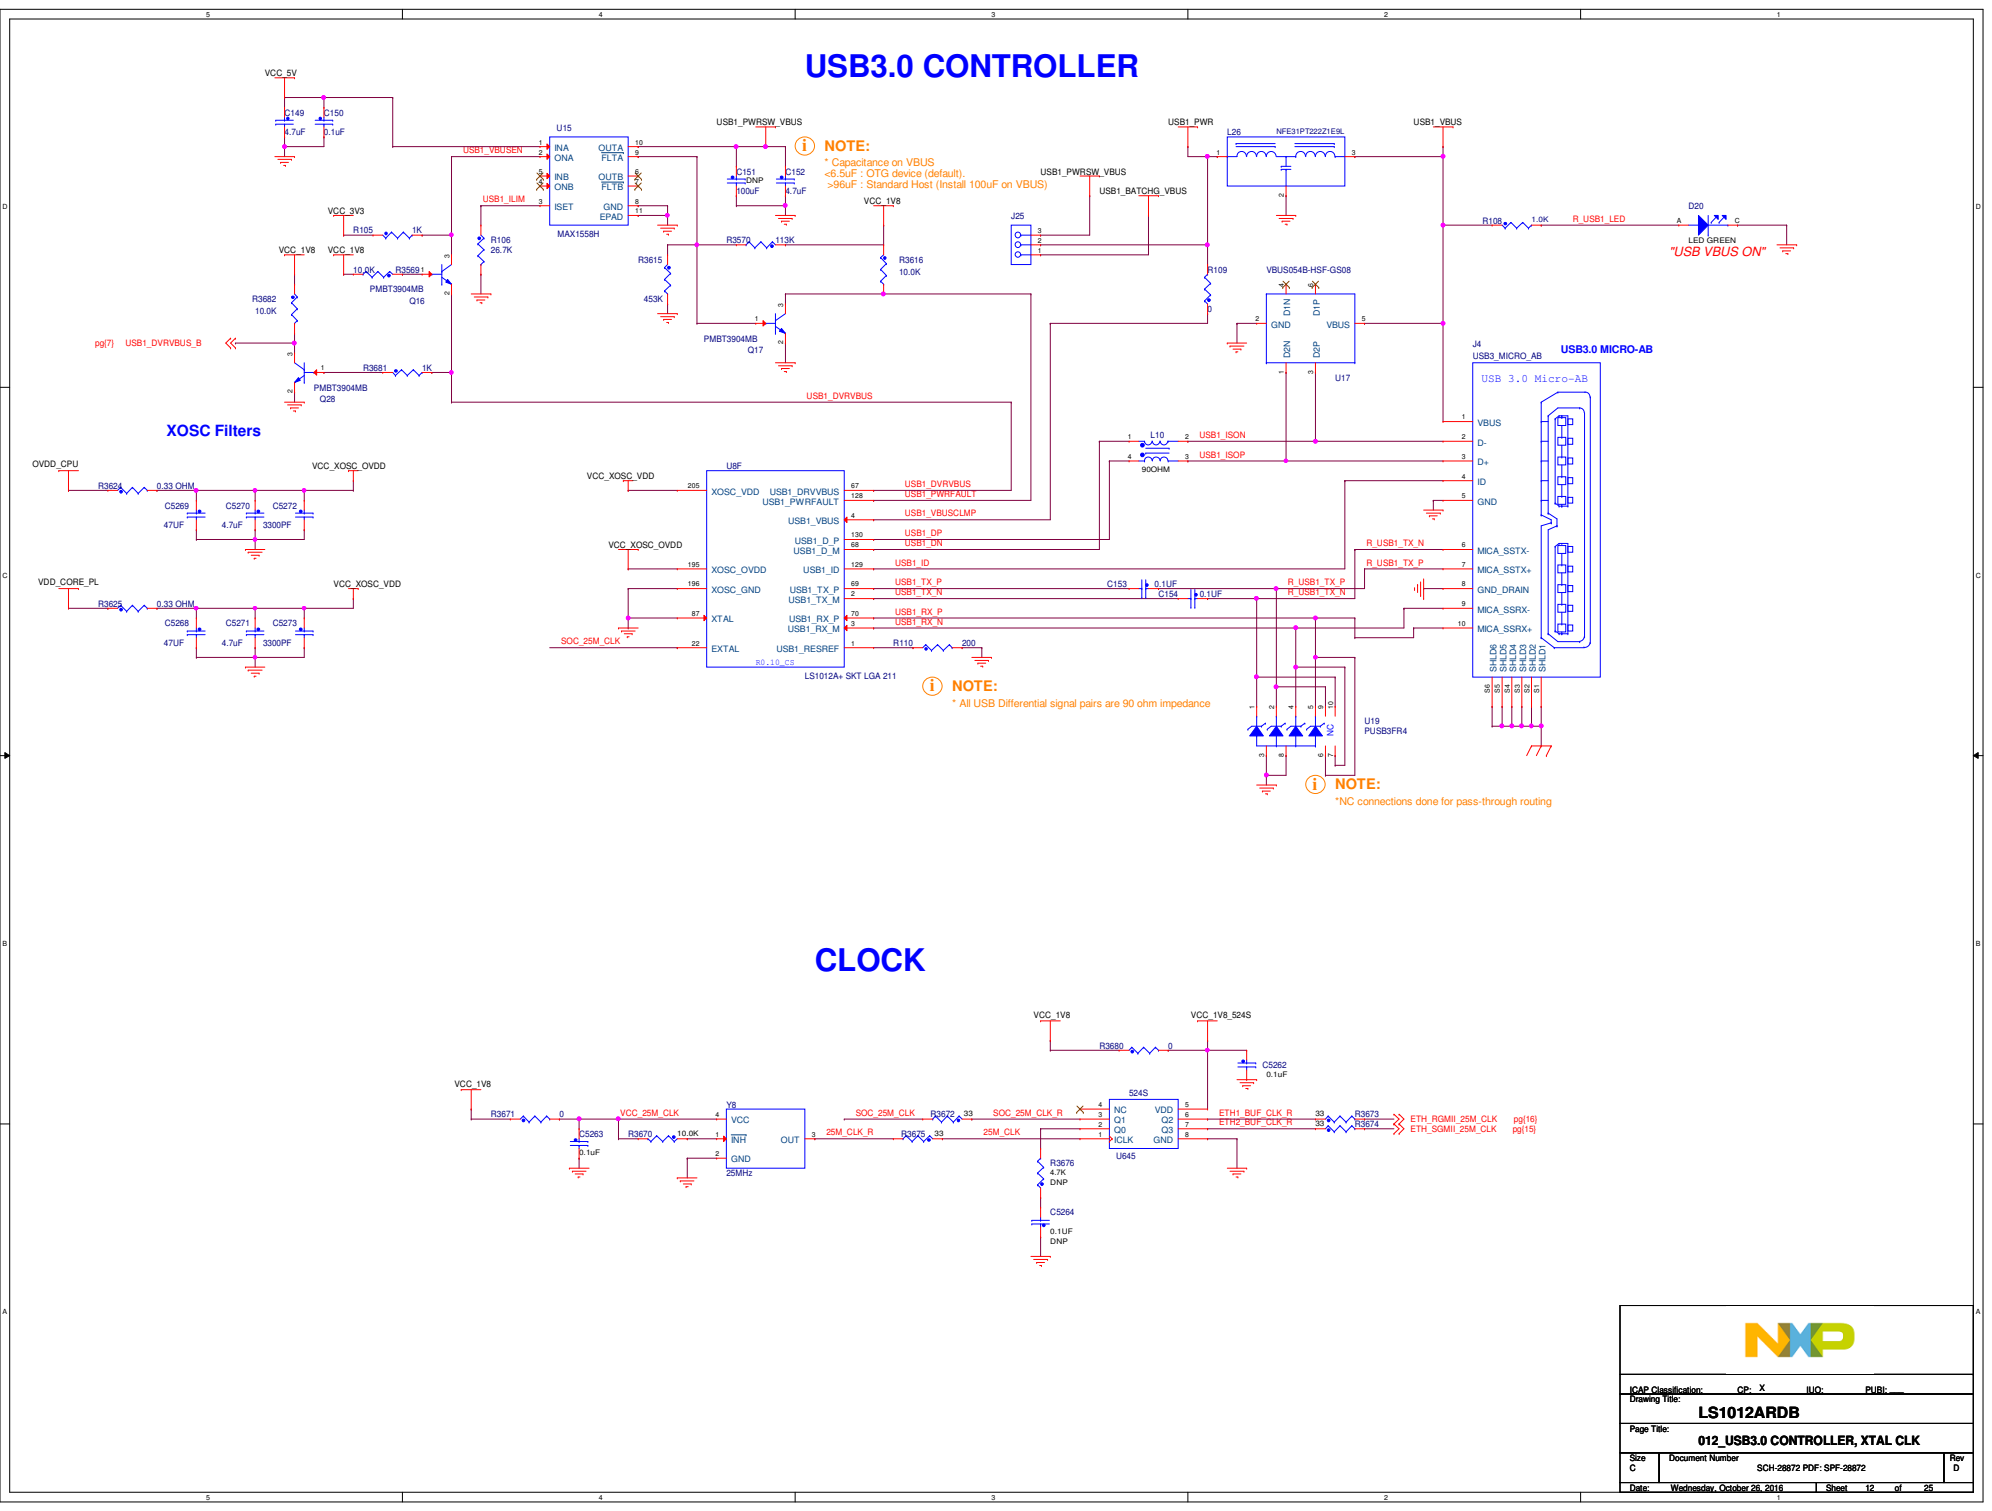
[picture p47: page 12]

* Capacitance on VBUS
<6.5uF : OTG device (default).
>96uF : Standard Host (Install 100uF on VBUS)

* All USB Differential signal pairs are 90 ohm impedance

NOTE:
*NC connections done for pass-through routing

# LS1012 POWER BLOCK

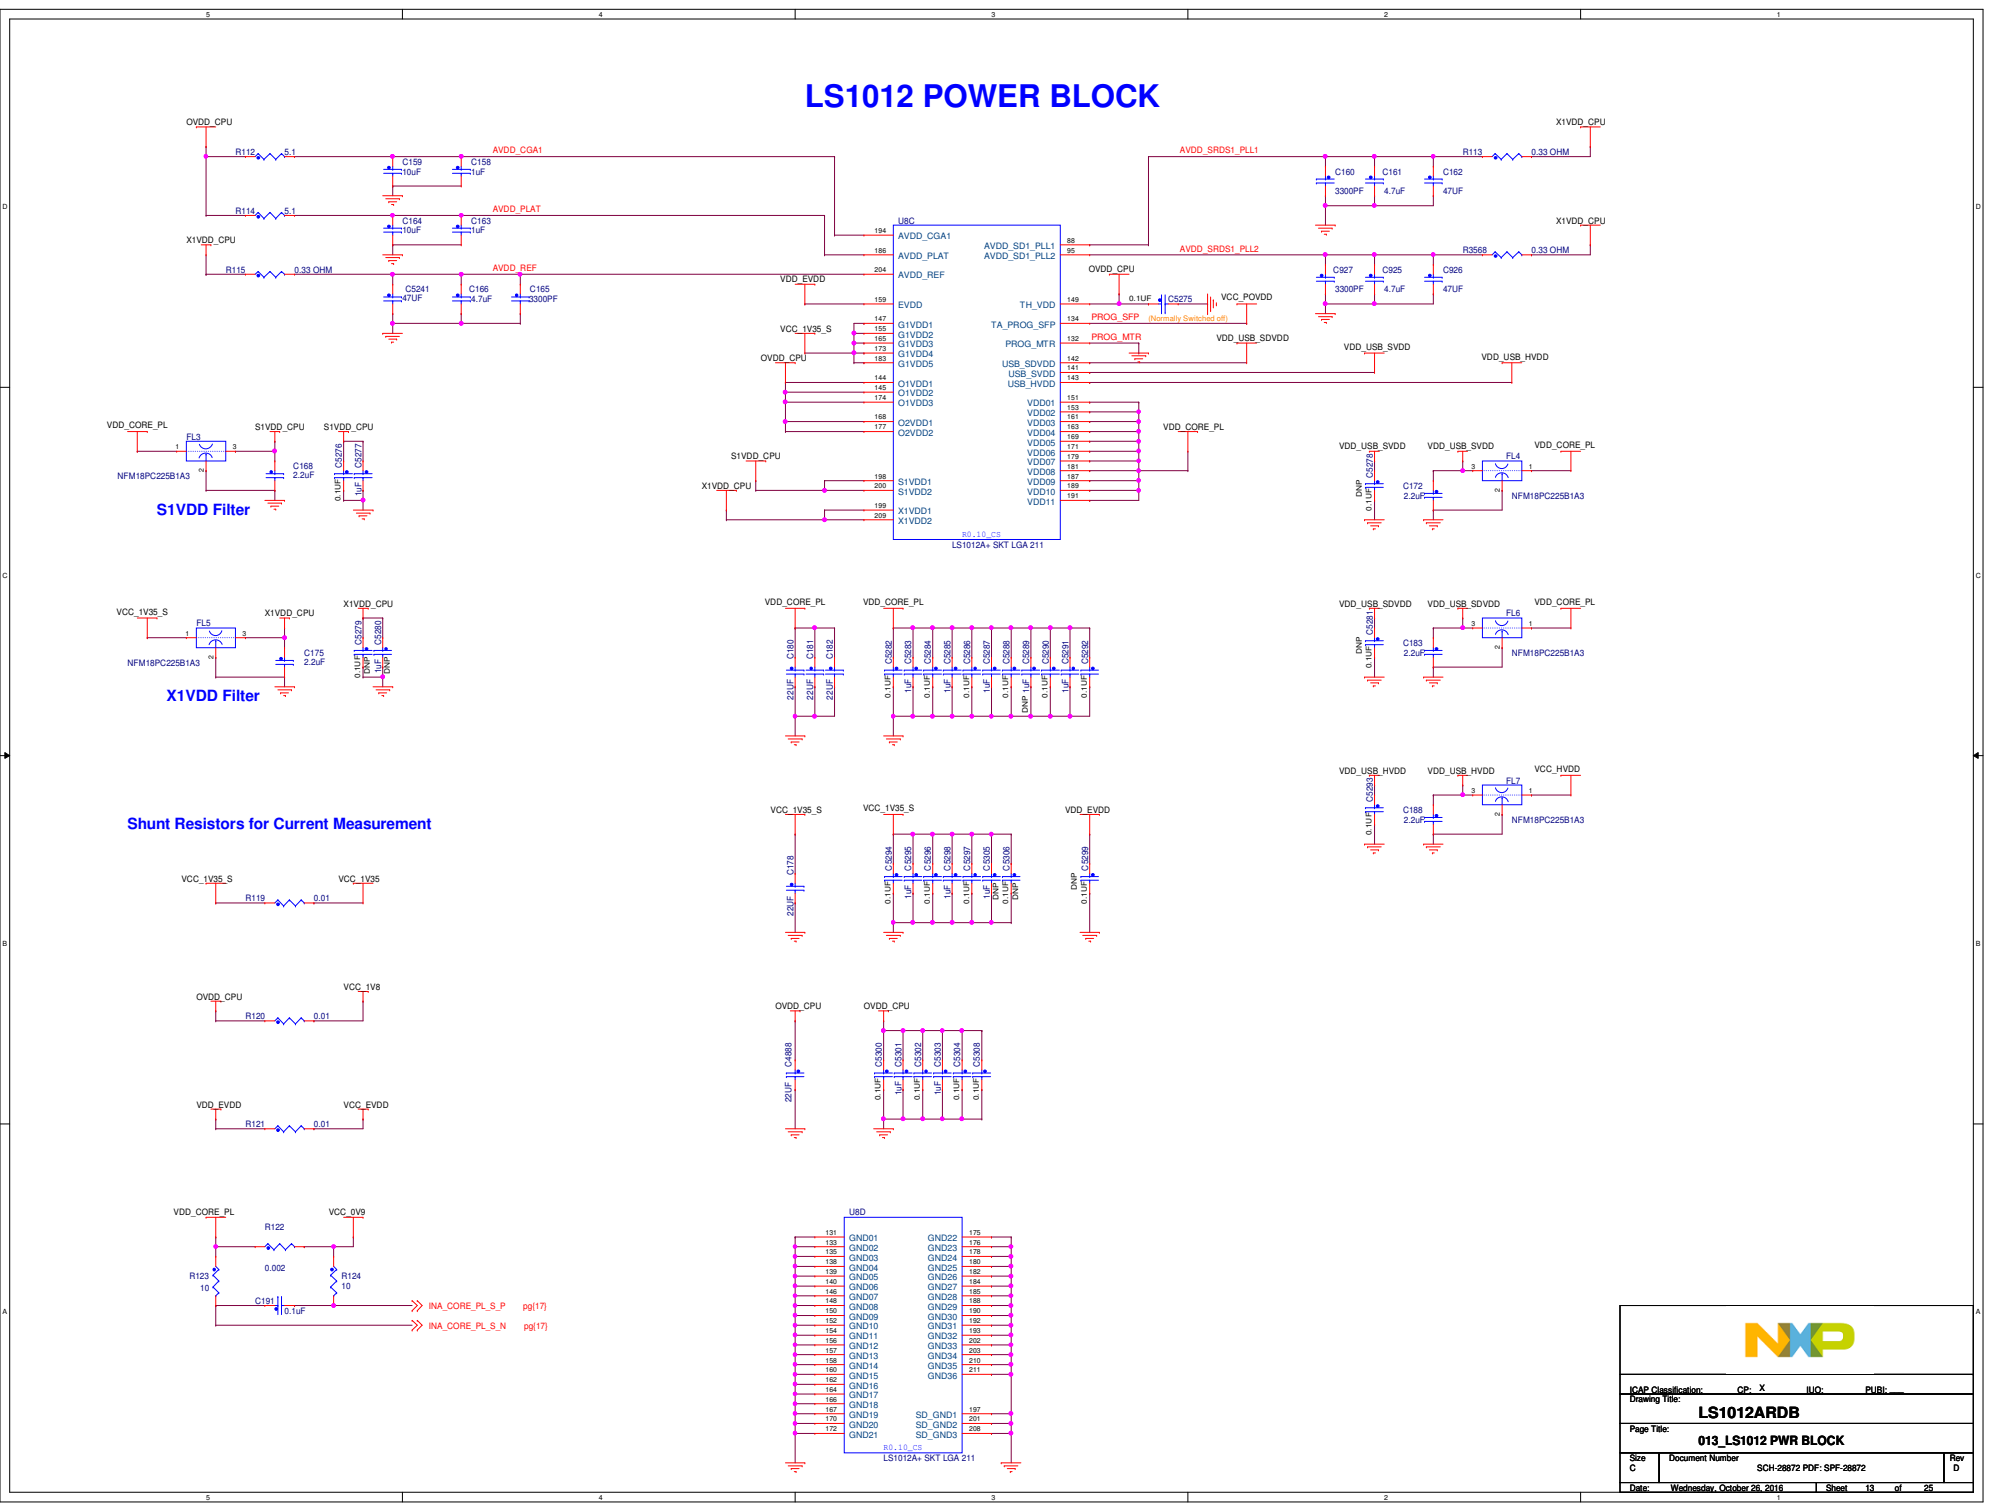
[picture p48: page 13]

Shunt Resistors for Current Measurement

# SERDES LANEA MUX

# SERDES MUXES

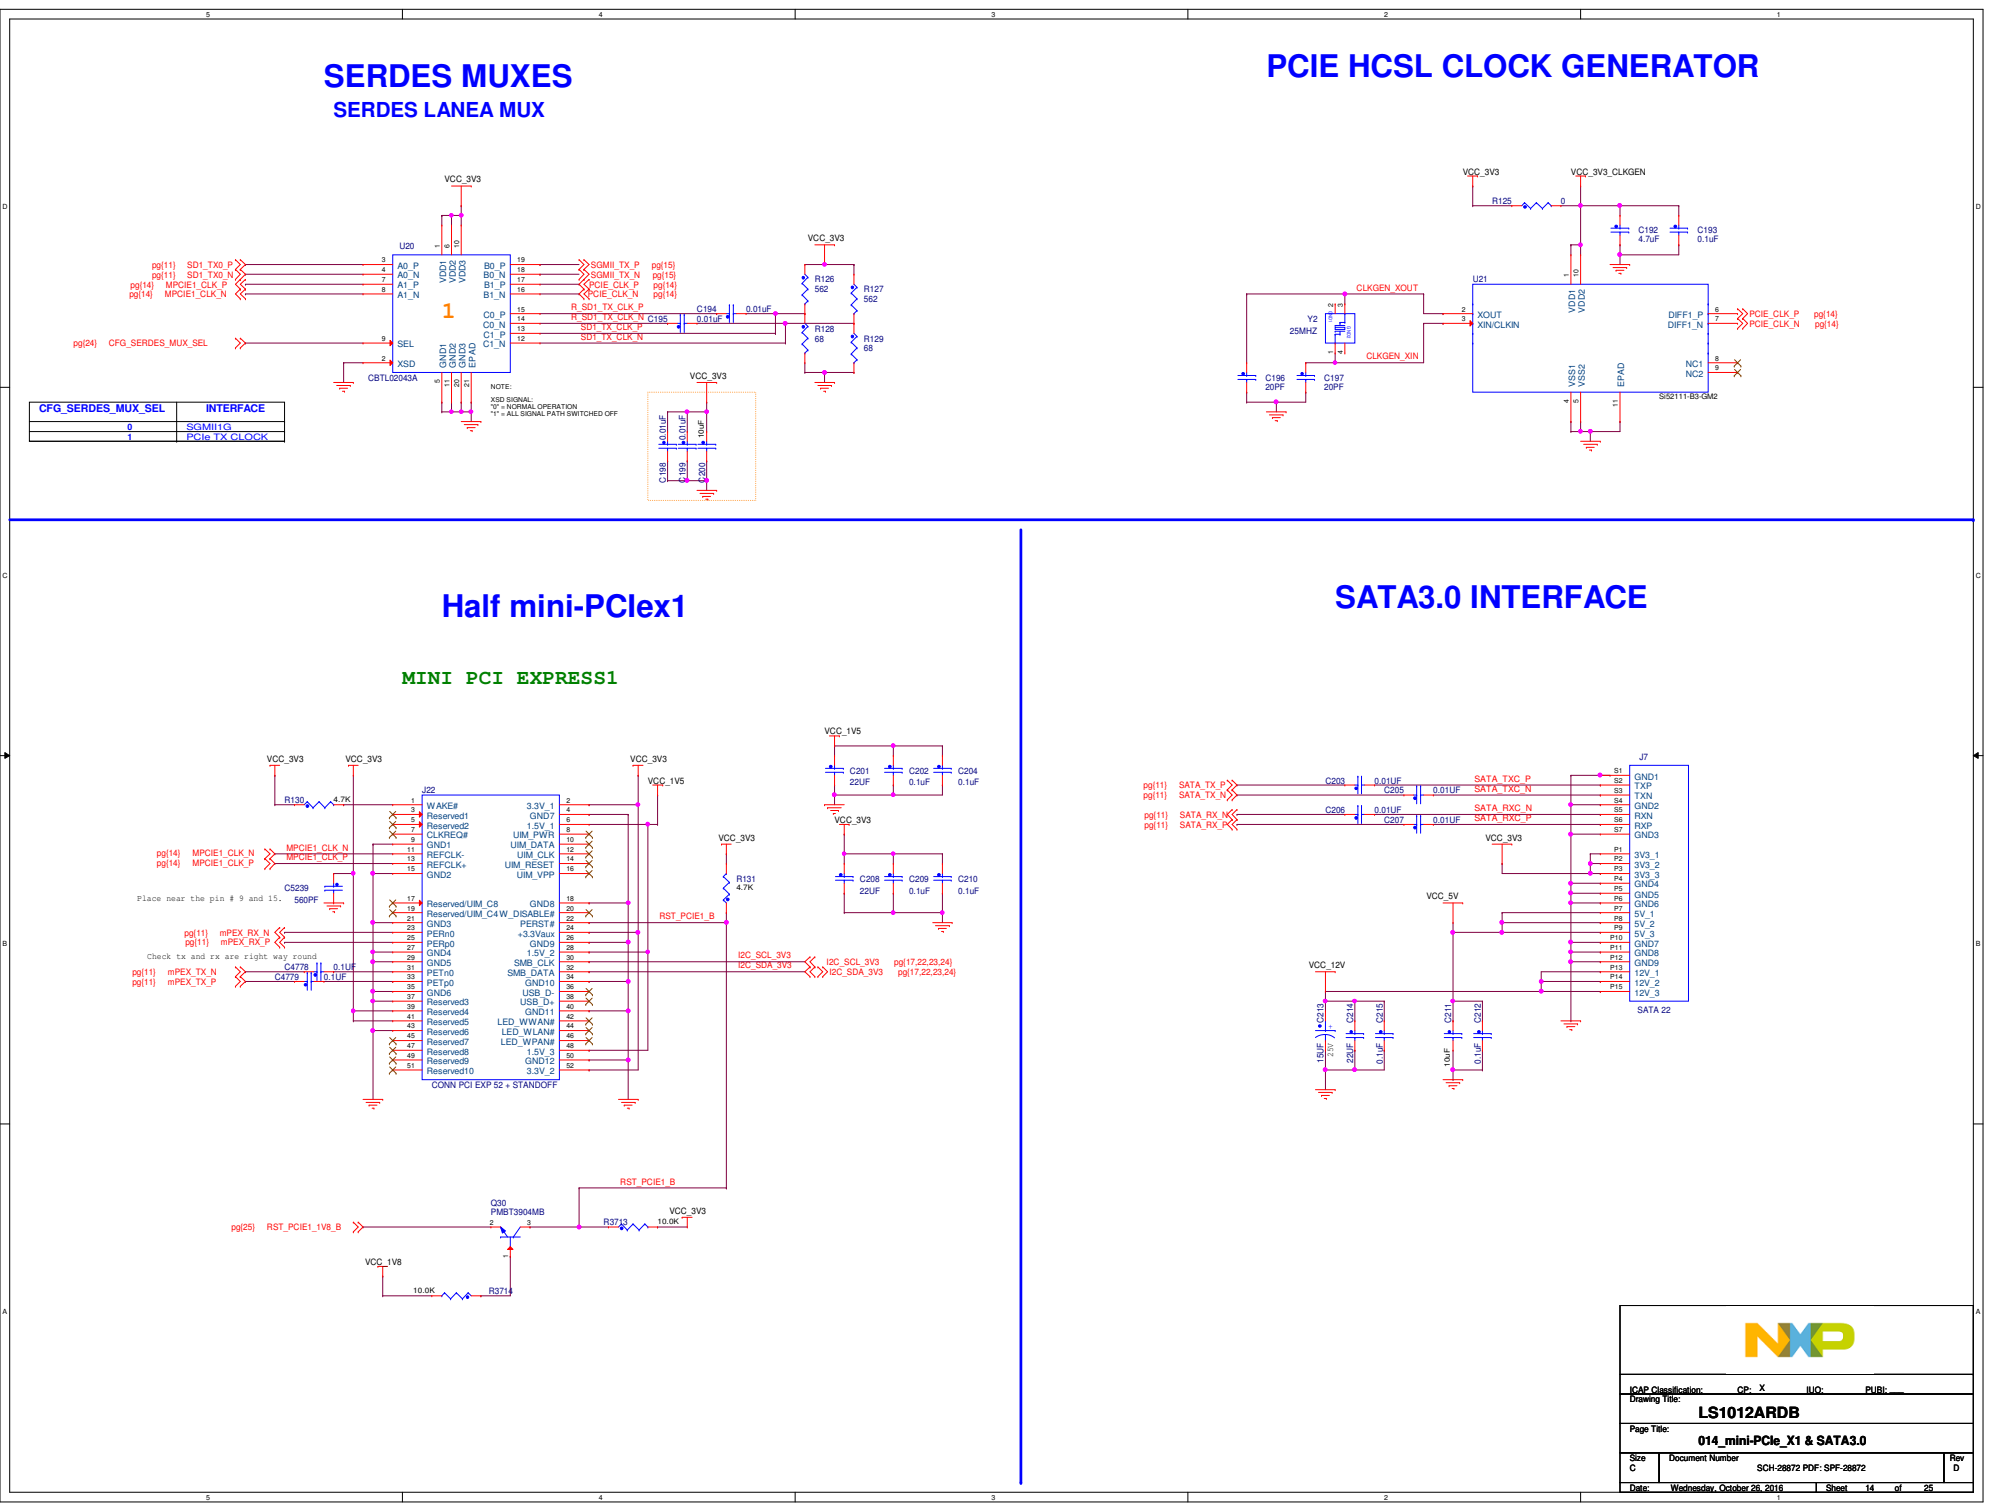
[picture p49: page 14]

PCIE HCSL CLOCK GENERATOR

XSD SIGNAL:
"0" = NORMAL OPERATION
"1" = ALL SIGNAL PATH SWITCHED OFF

Place near the pin # 9 and 15.

Check tx and rx are right way round

CONN PCI EXP 52 + STANDOFF

# ETHERNET SGMII PHY INTERFACE

# ETHERNET PORT CONNECTORS

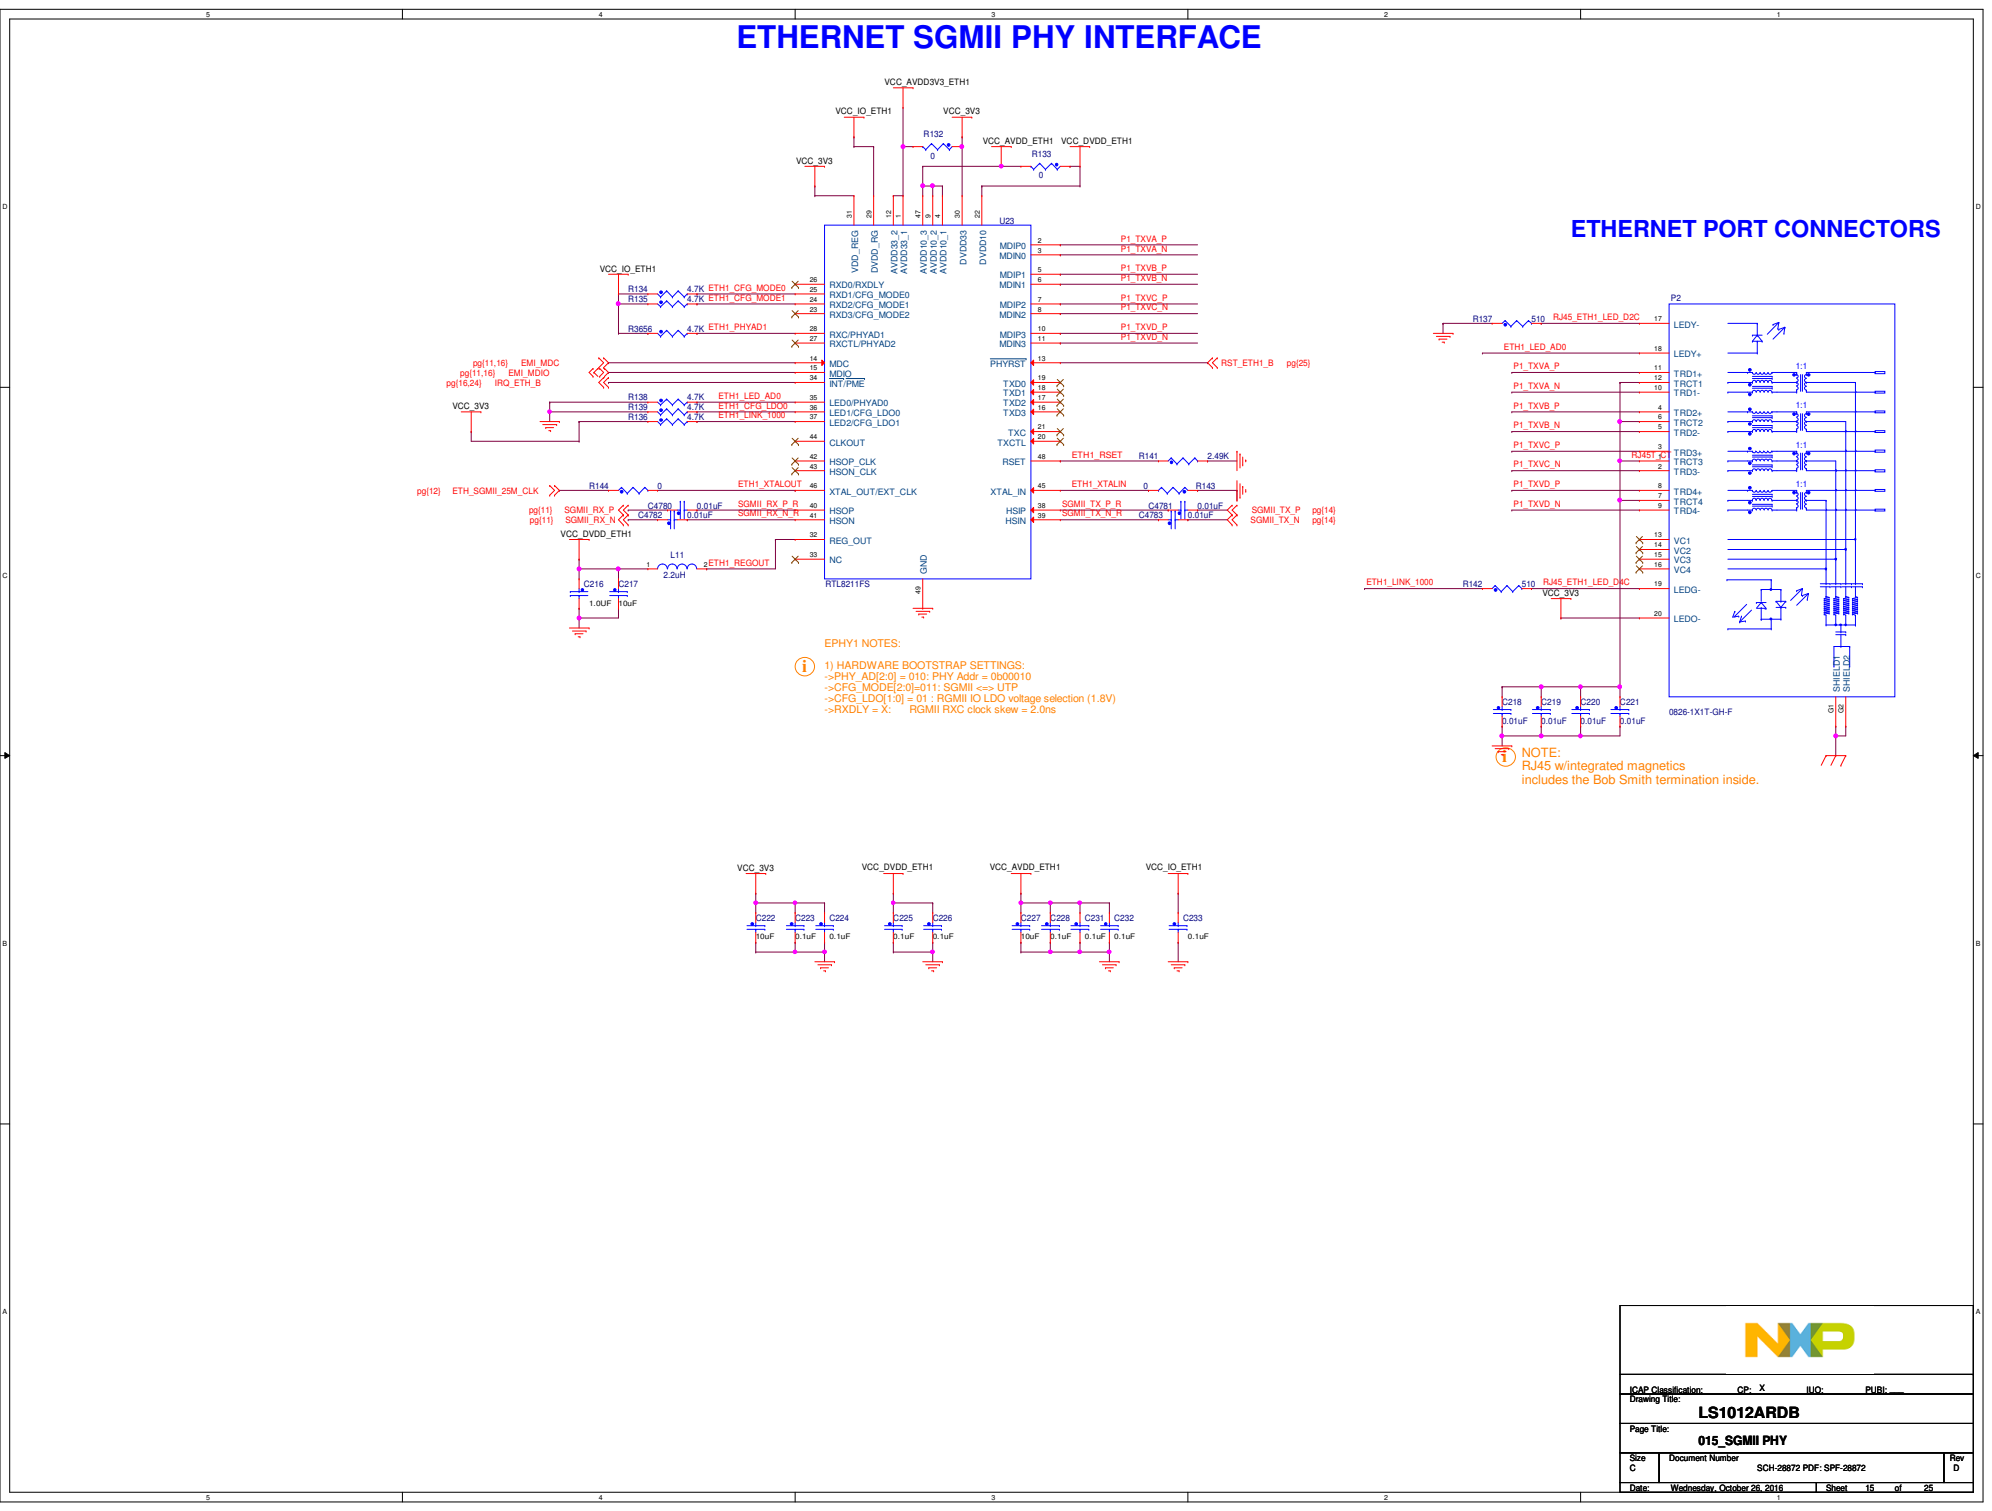
[picture p50: page 15]

EPHY1 NOTES:
1) HARDWARE BOOTSTRAP SETTINGS:
->PHY_AD[2:0] = 010: PHY Addr = 0b00010
->CFG_MODE[2:0]=011: SGMII <=> UTP
->CFG_LDO[1:0] = 01 : RGMII IO LDO voltage selection (1.8V)

NOTE:
RJ45 w/integrated magnetics
includes the Bob Smith termination inside.

# ETHERNET RGMII PHY INTERFACE

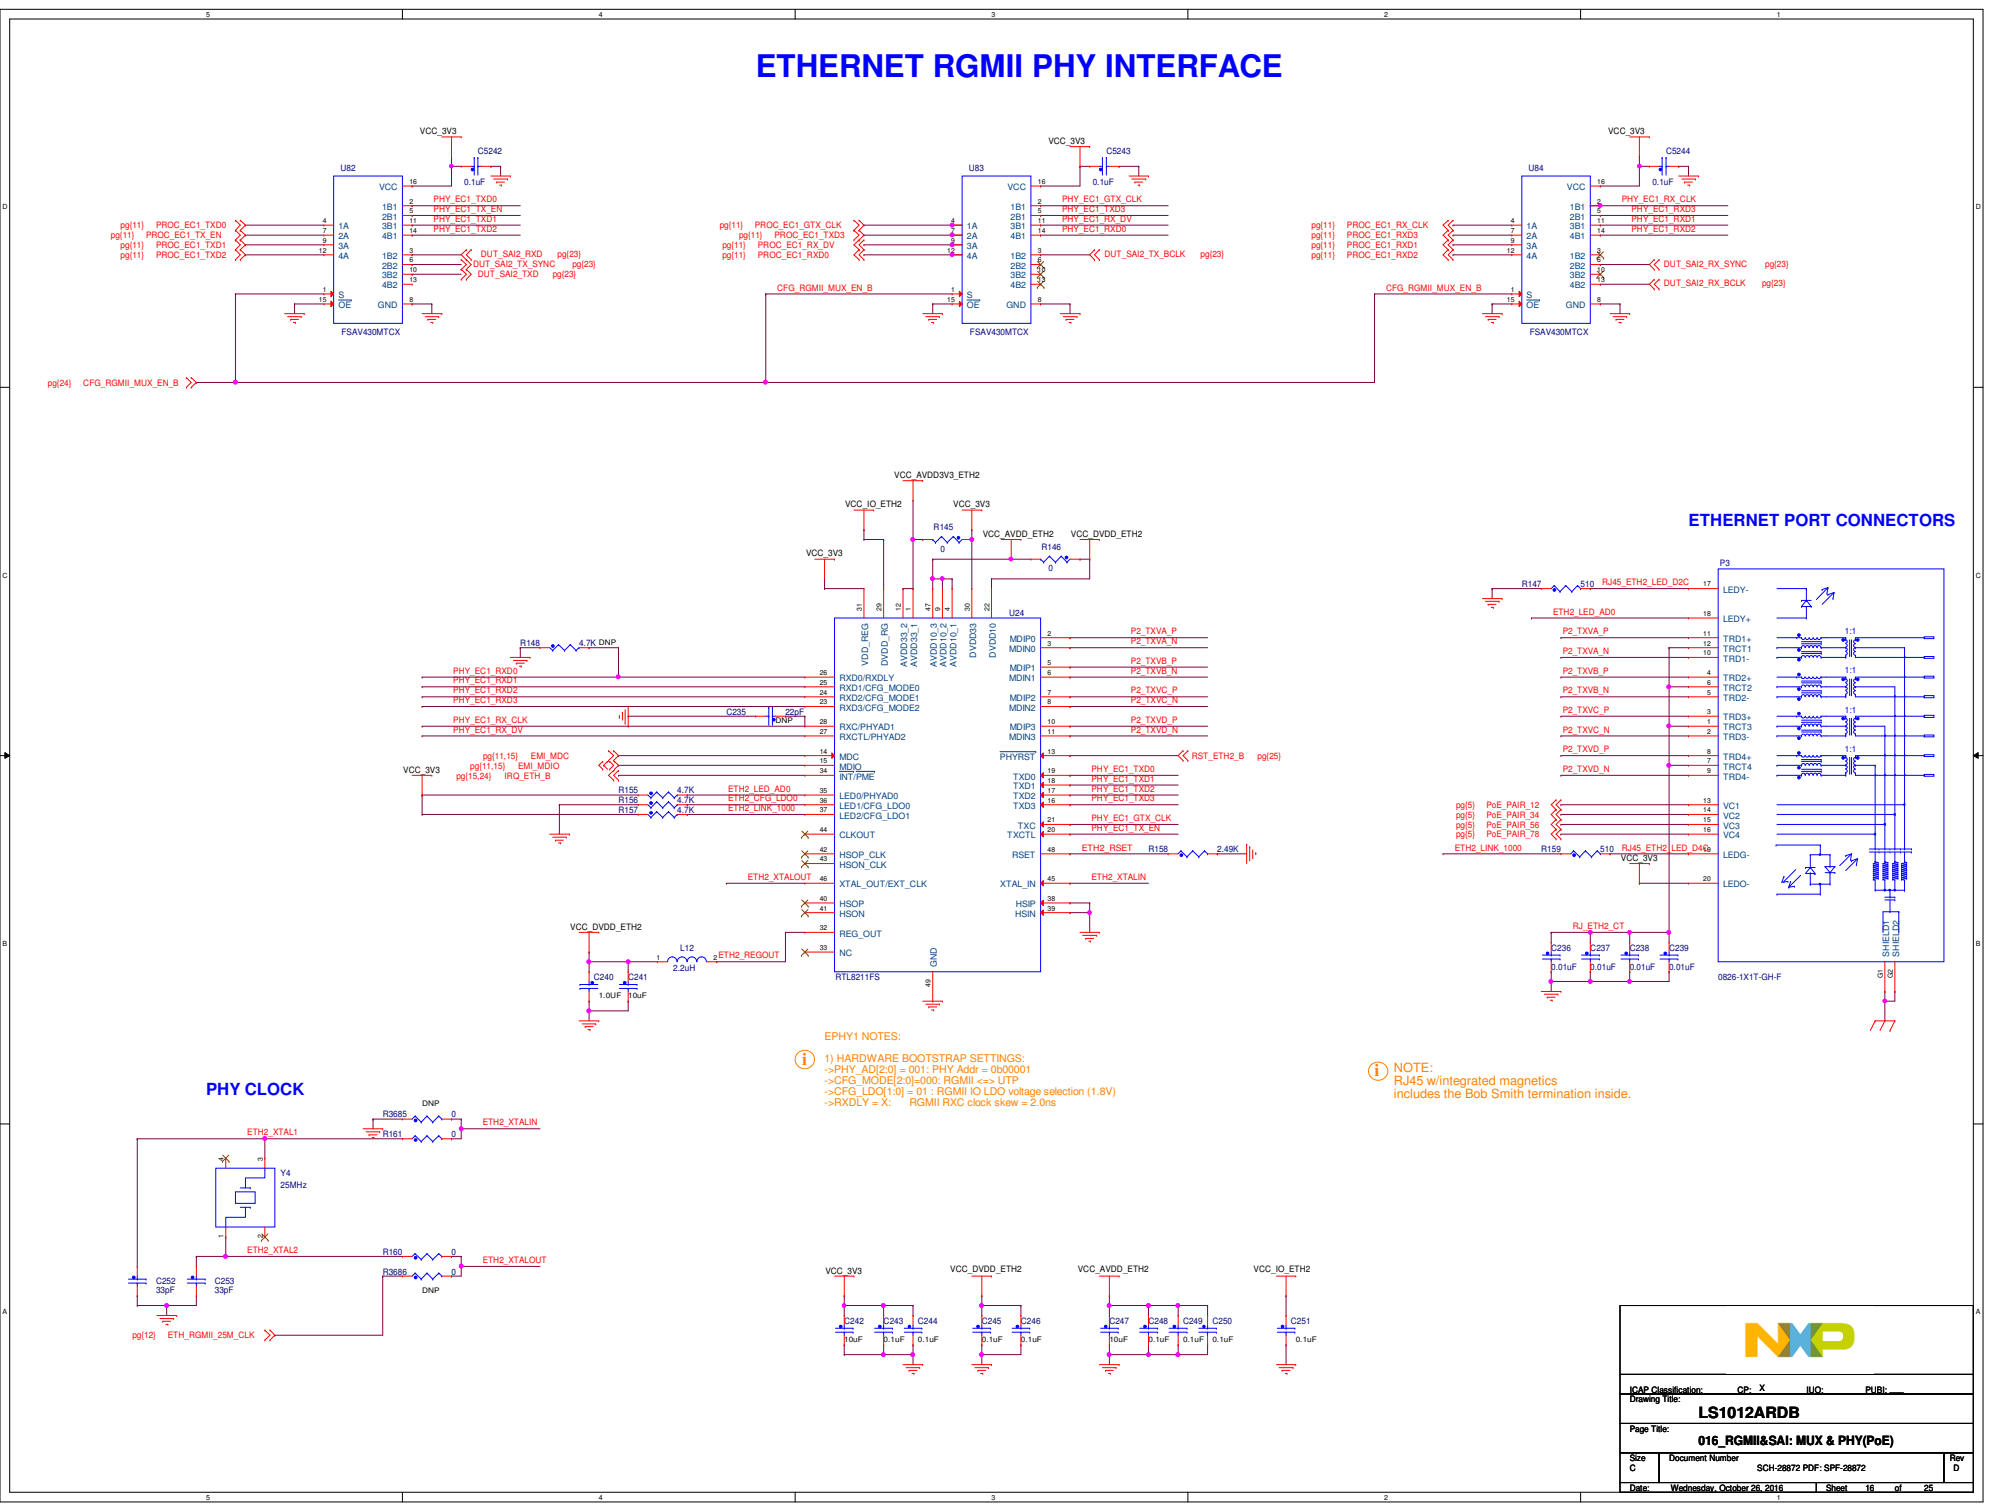
[picture p51: page 16]

EPHY1 NOTES:
1) HARDWARE BOOTSTRAP SETTINGS:
->PHY_AD[2:0] = 001: PHY Addr = 0b00001
->CFG_MODE[2:0]=000: RGMII <=> UTP
->CFG_LDO[1:0] = 01 : RGMII IO LDO voltage selection (1.8V)

RJ45 w/integrated magnetics
includes the Bob Smith termination inside.

016_RGMII&SAI: MUX & PHY(PoE)

# Gyroscope

# Accelerometer

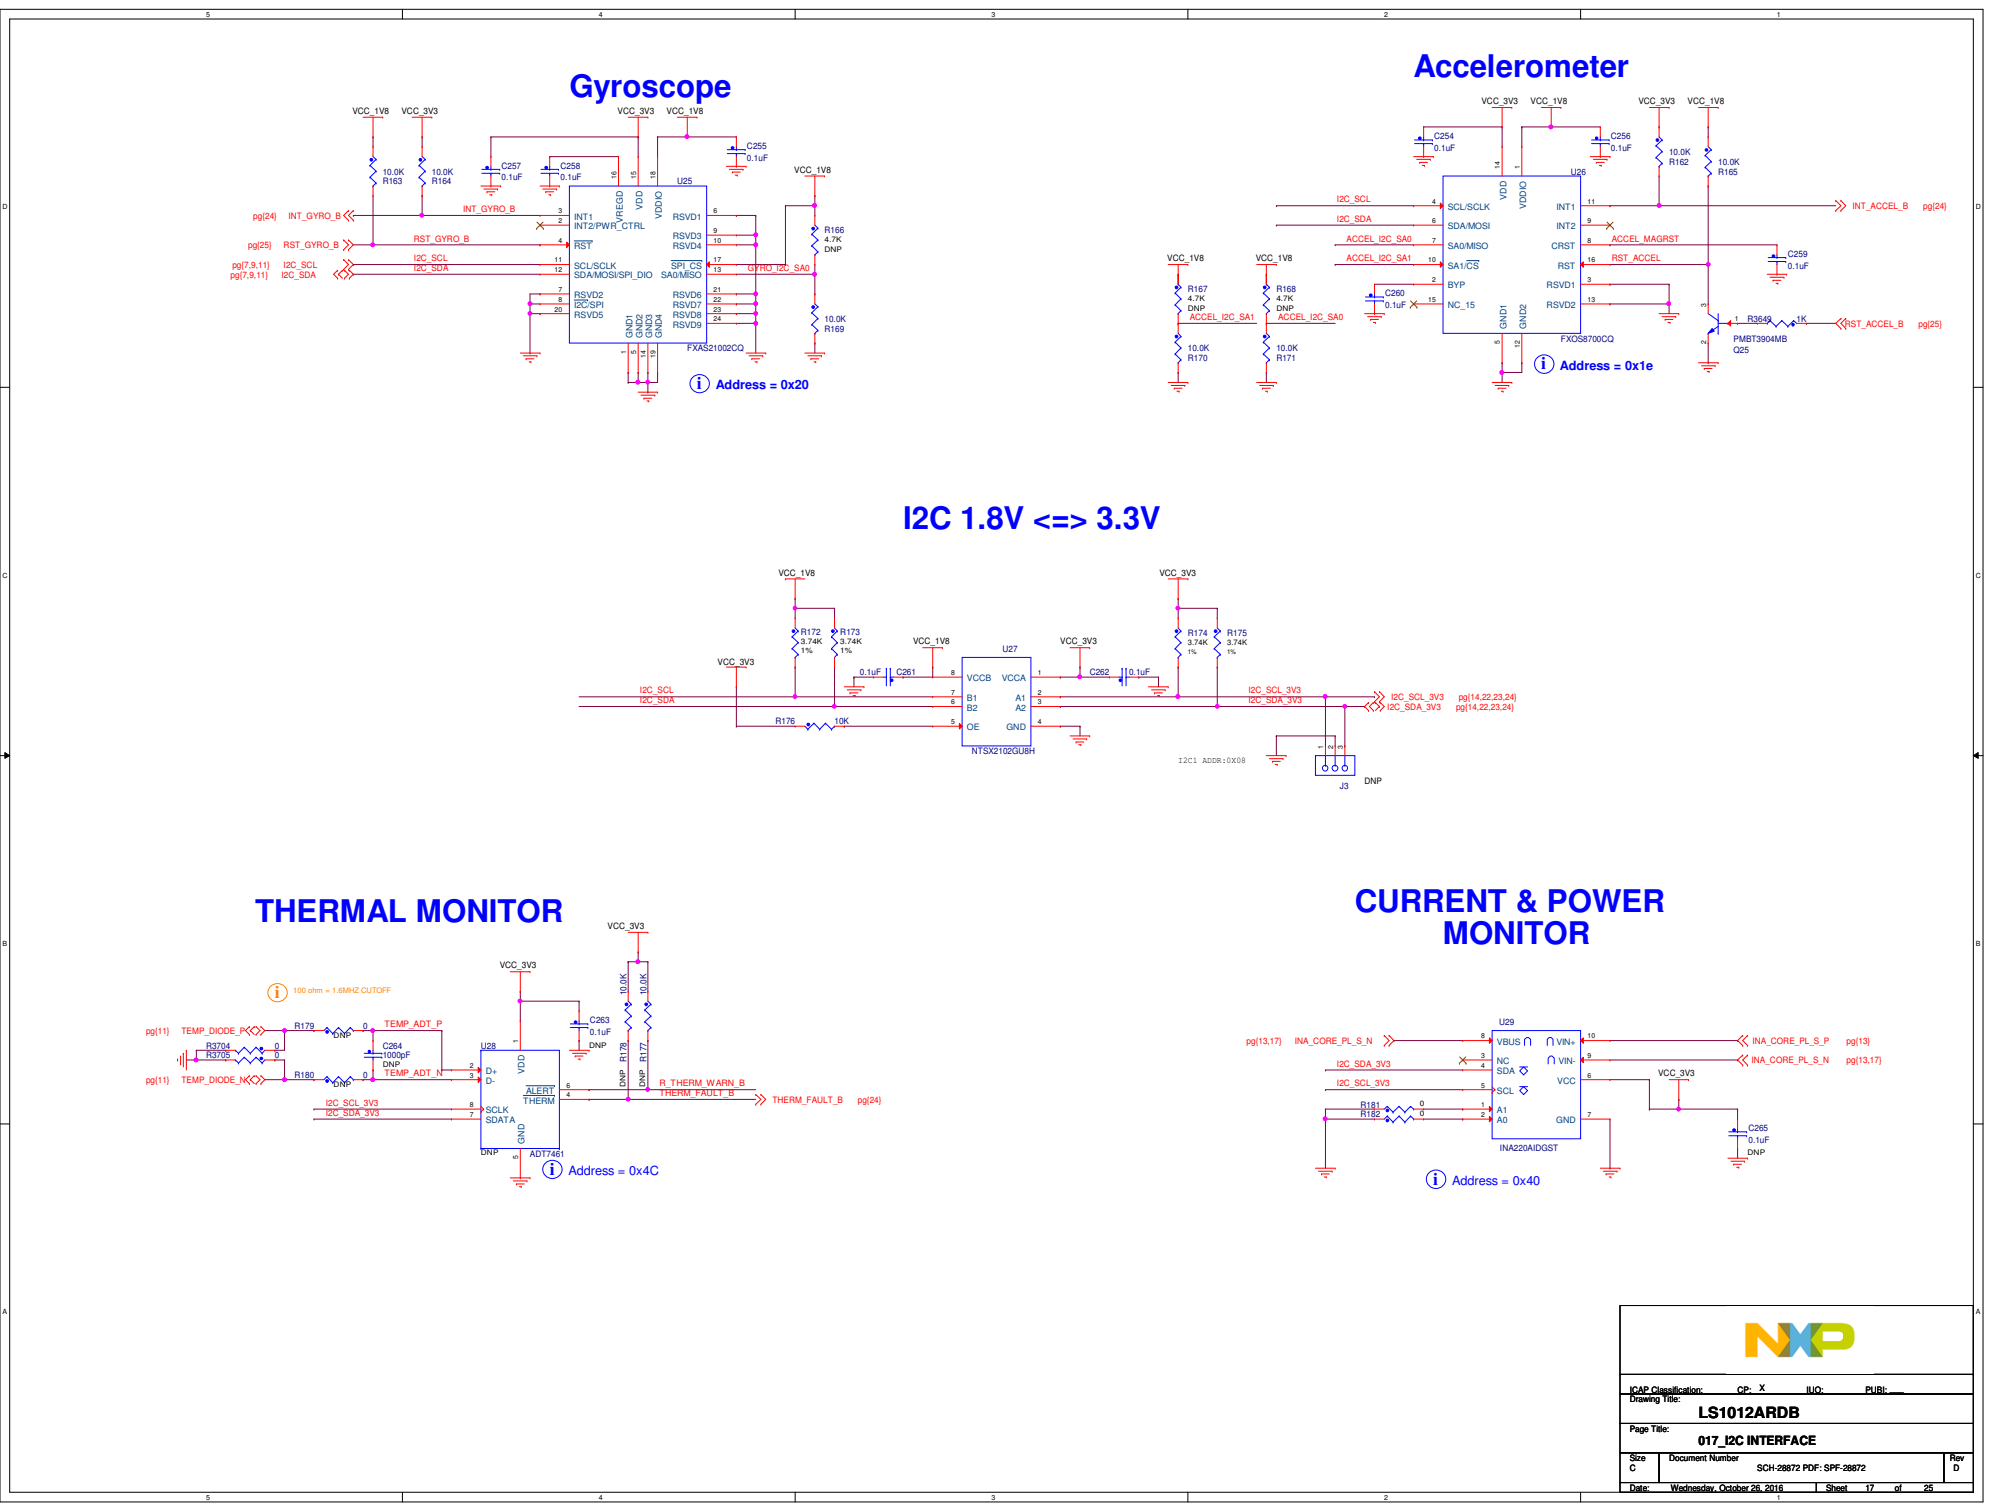
[picture p52: page 17]

# ARM JTAG CONNECTION

# JTAG

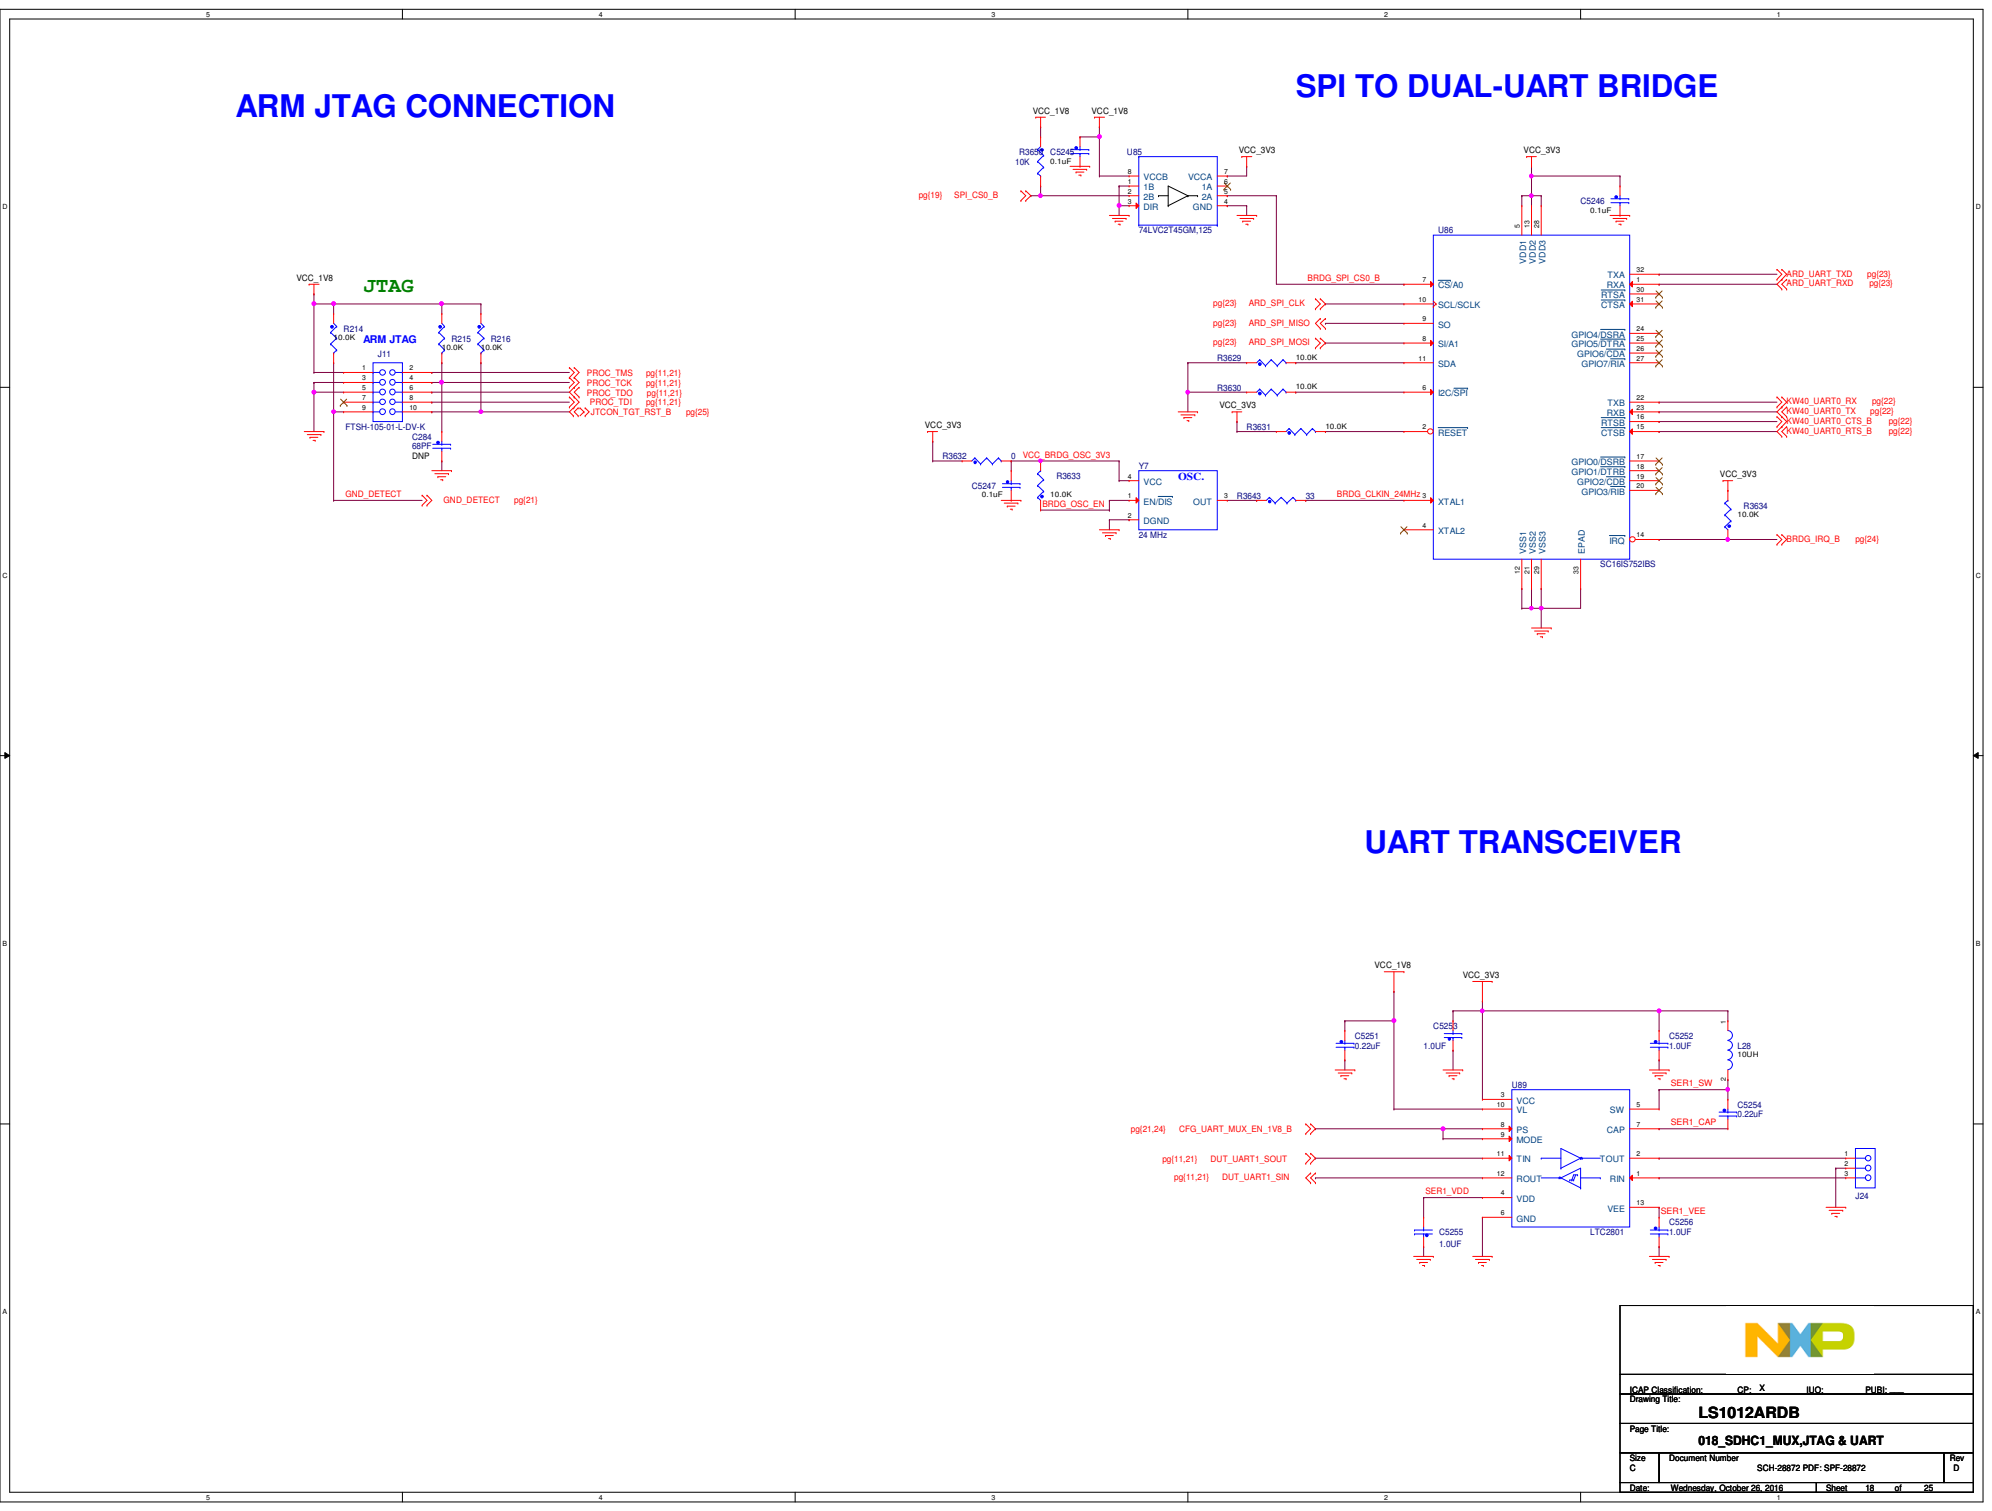
[picture p53: page 18]

SPI TO DUAL-UART BRIDGE

# SDHC2 MUX

# eMMC on SDHC2

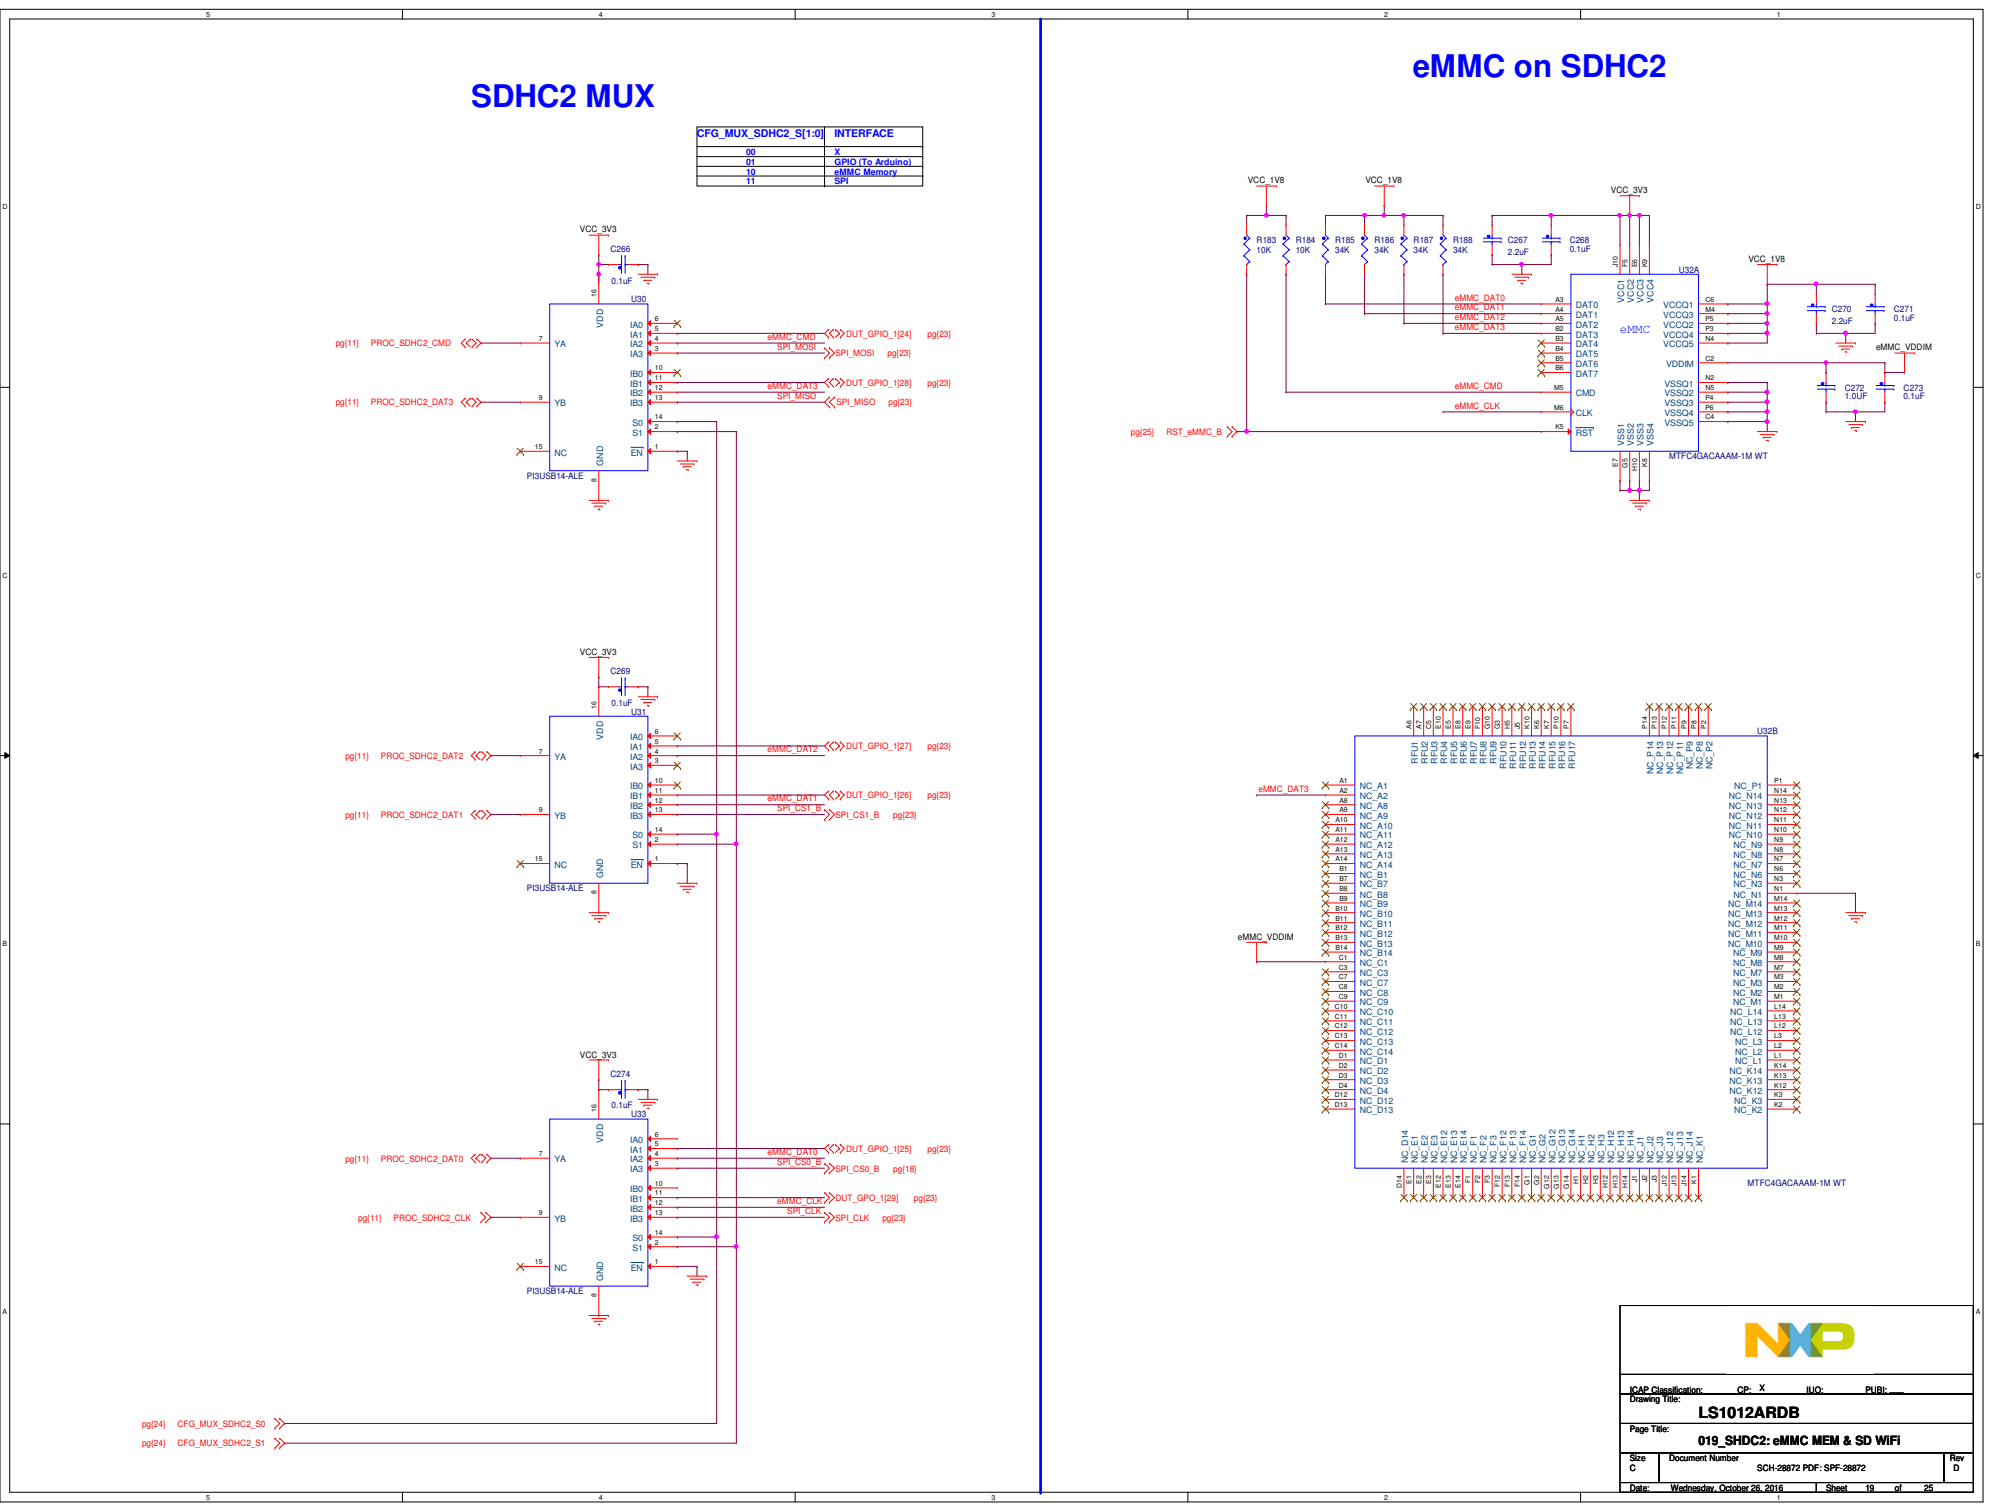
[picture p54: page 19]

019_SHDC2: eMMC MEM & SD WiFi

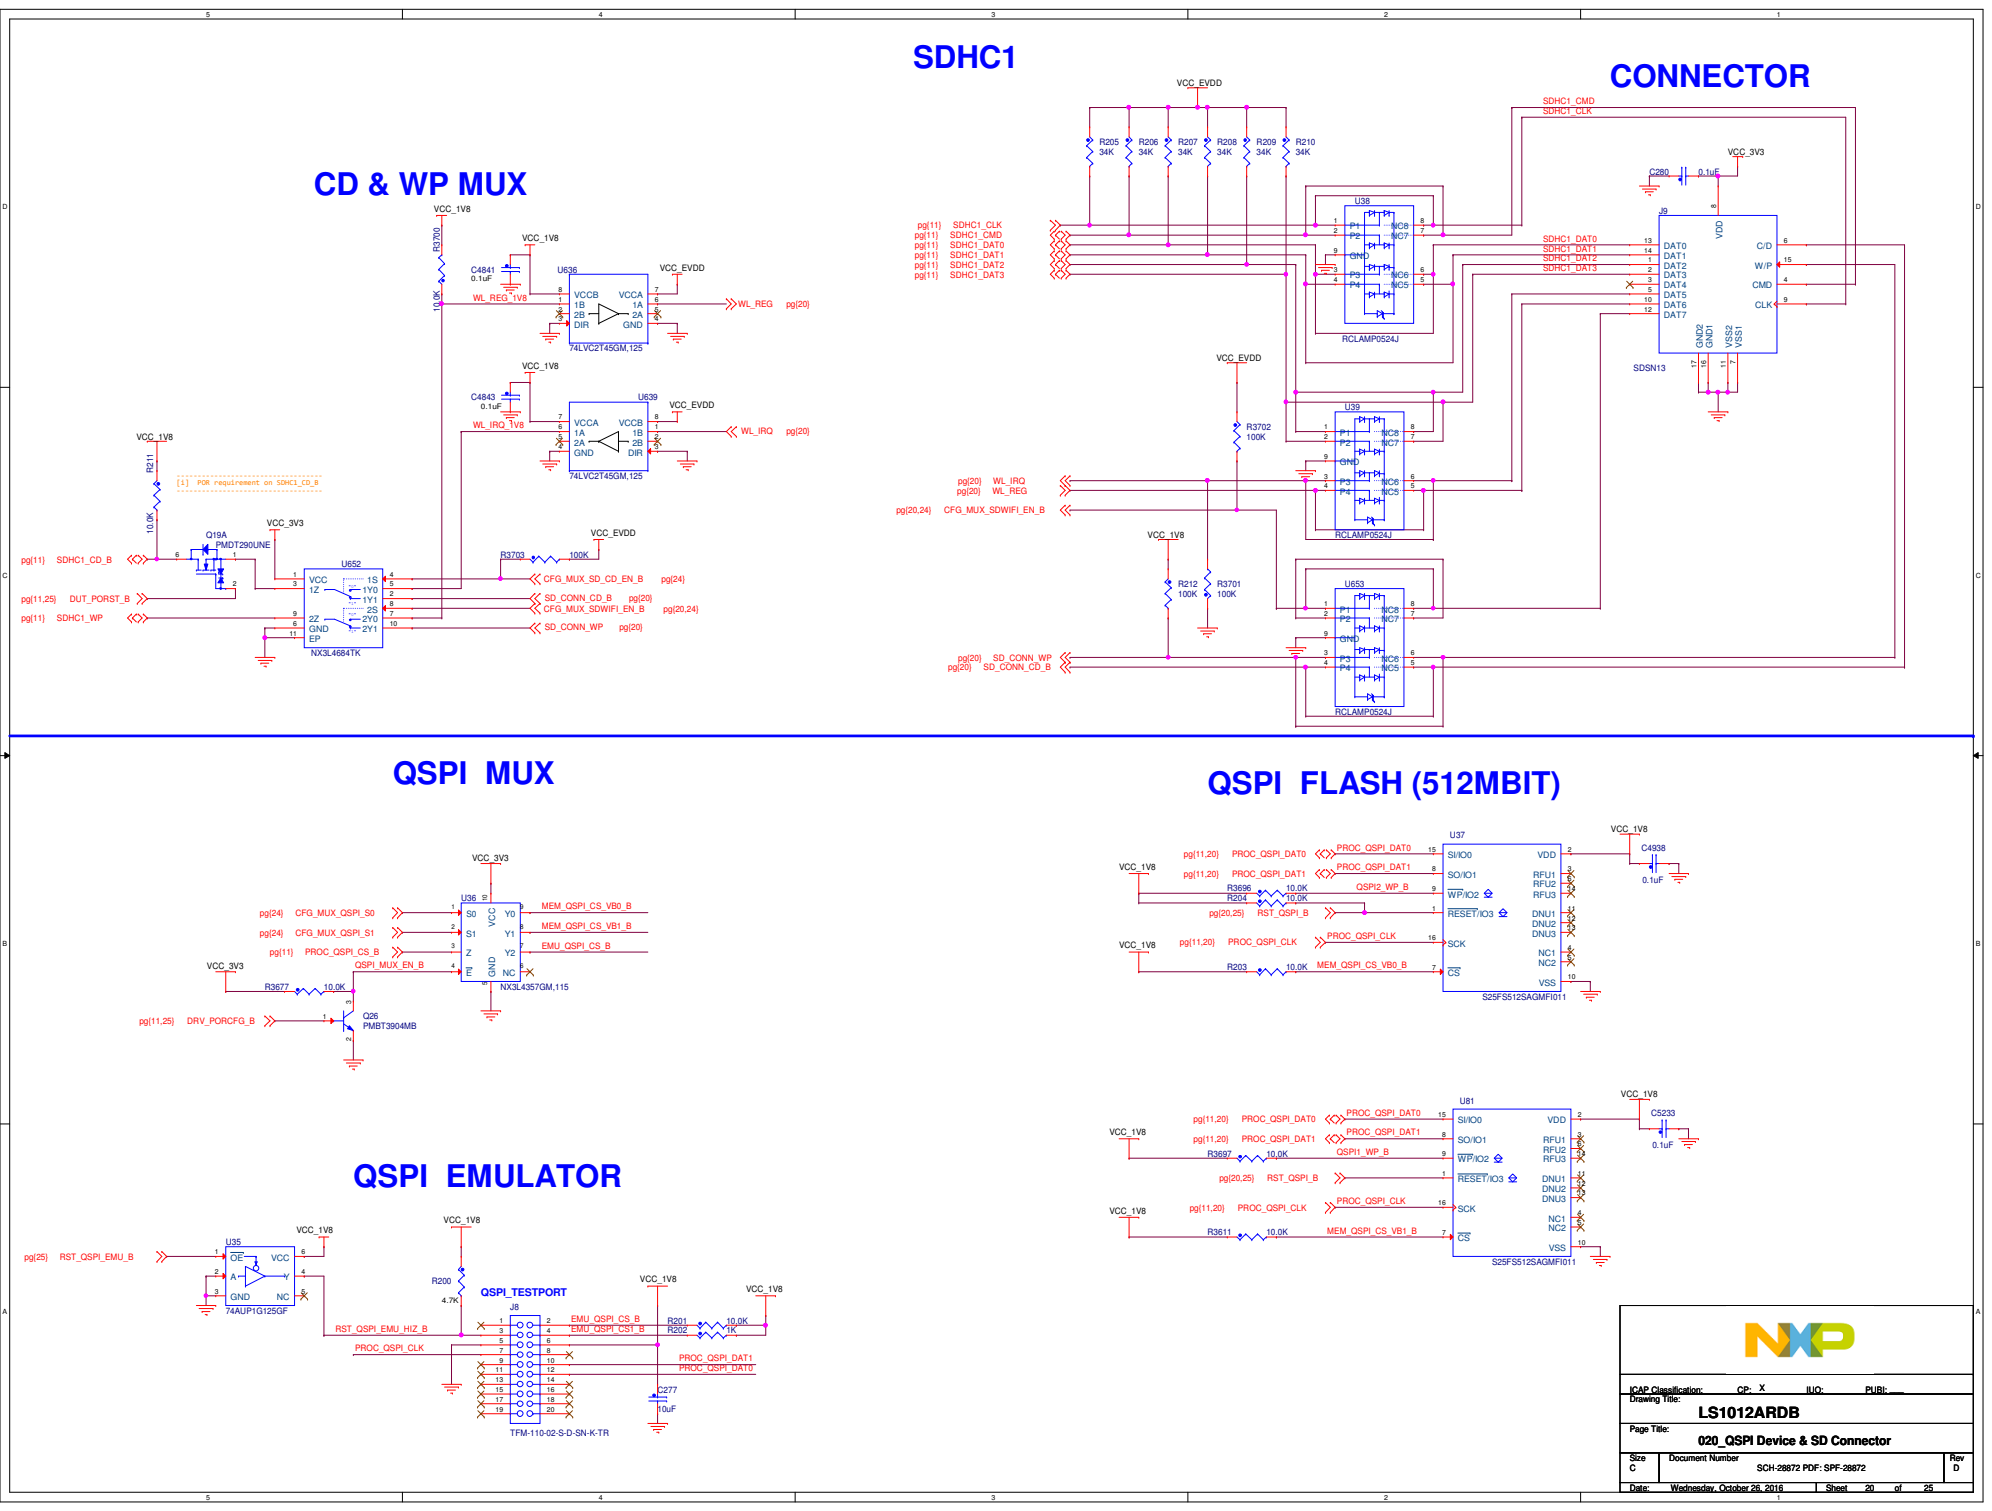
[picture p55: page 20]

## K22 JTAG CONNECTOR

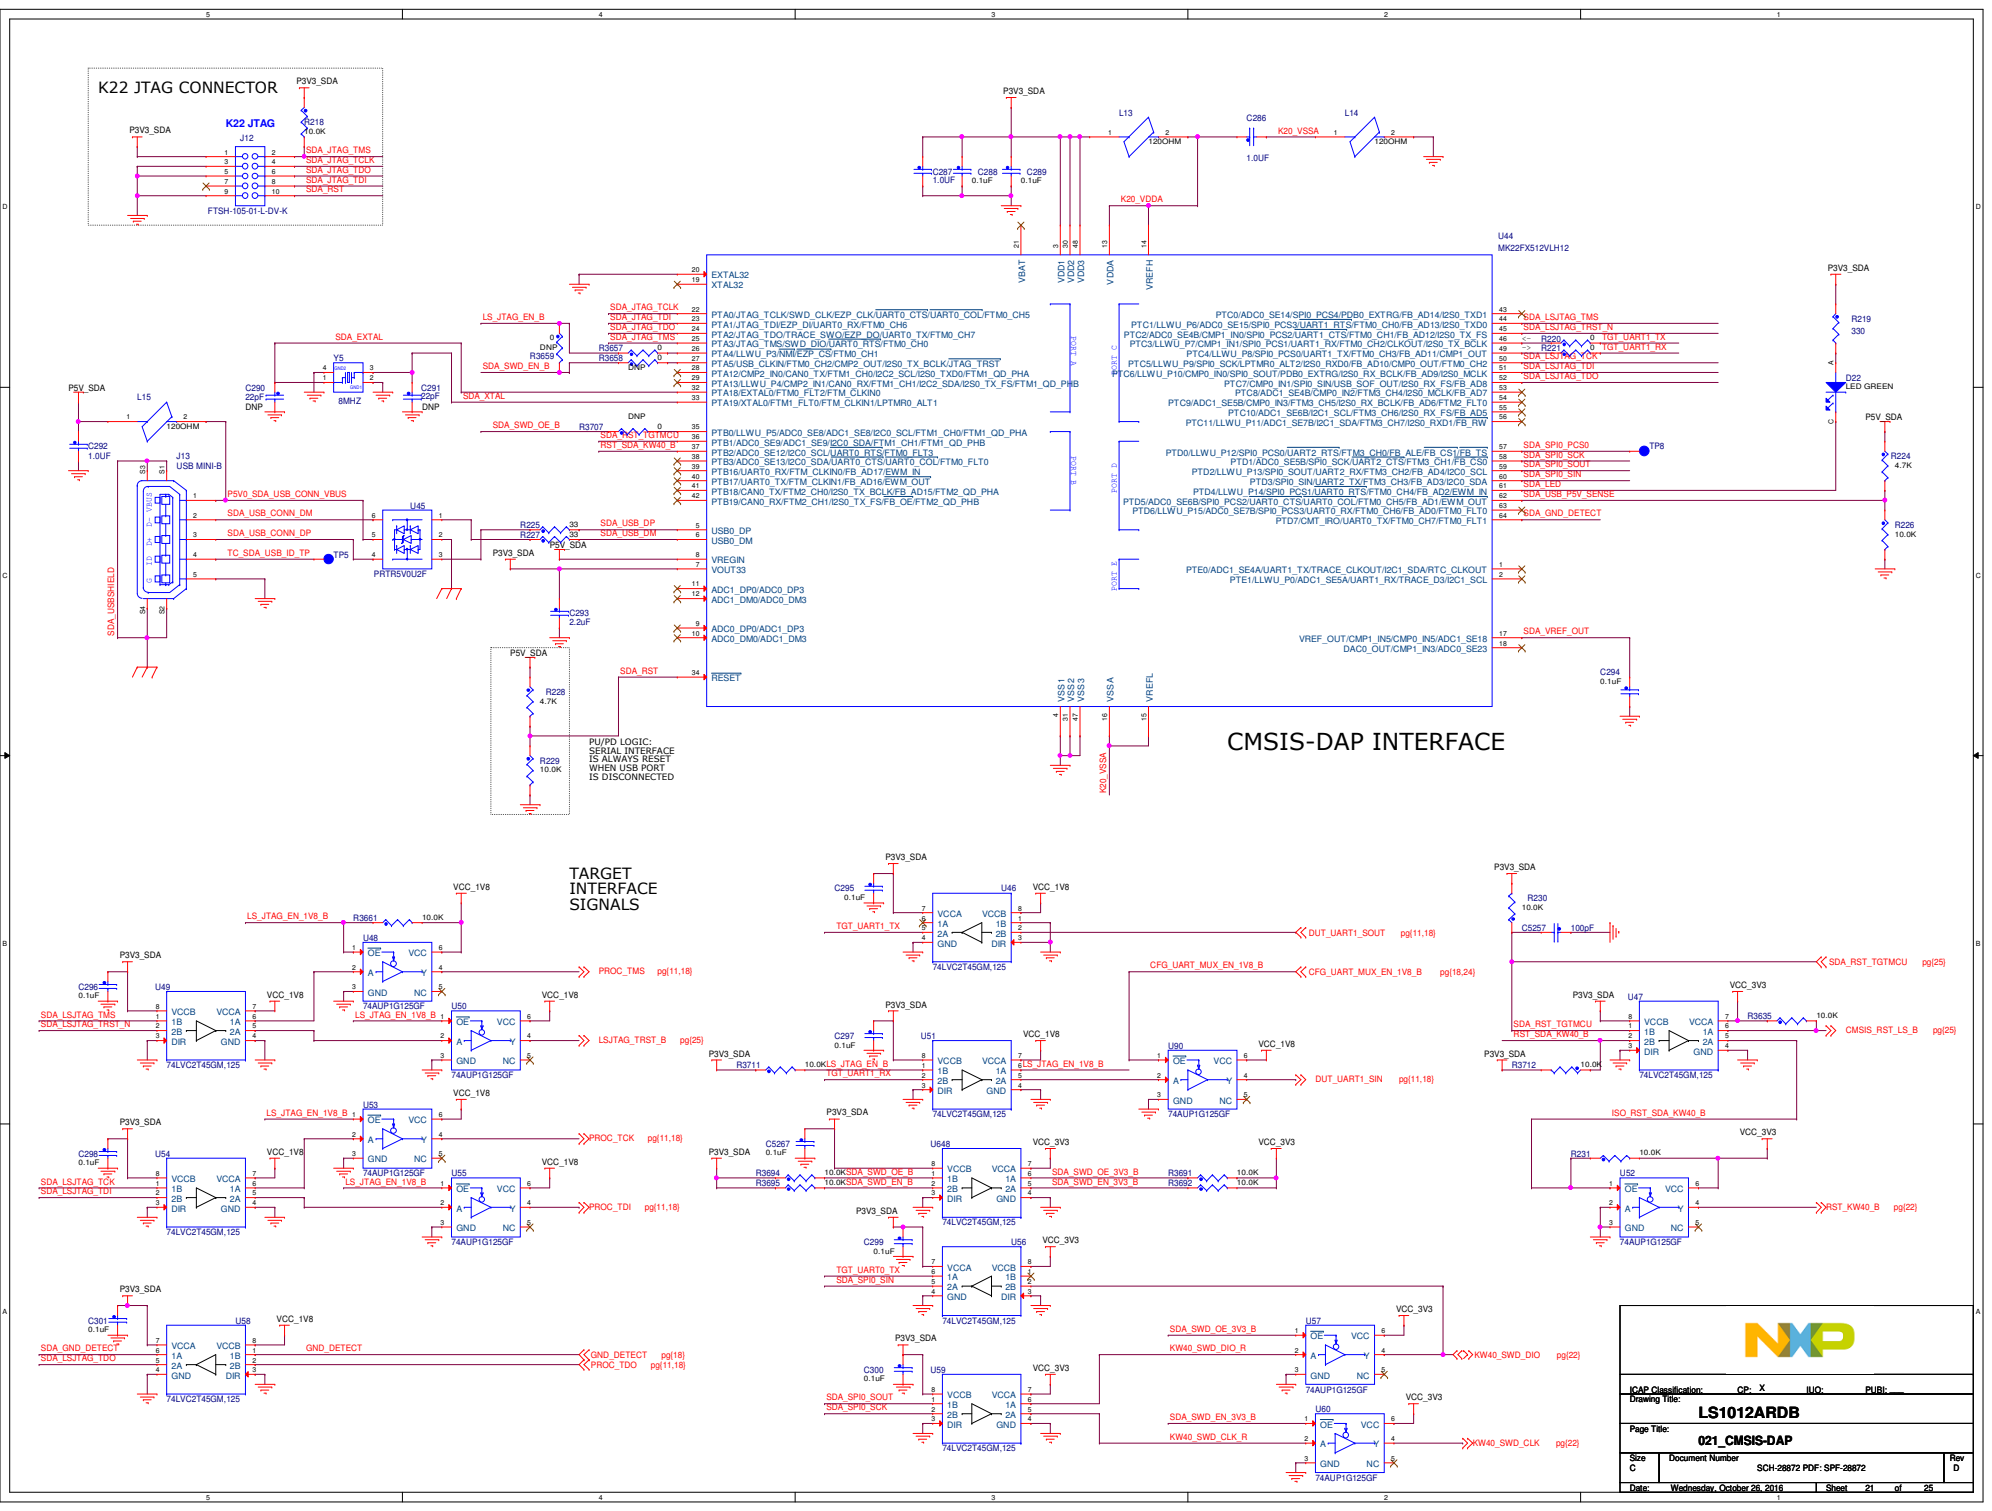
[picture p56: page 21]

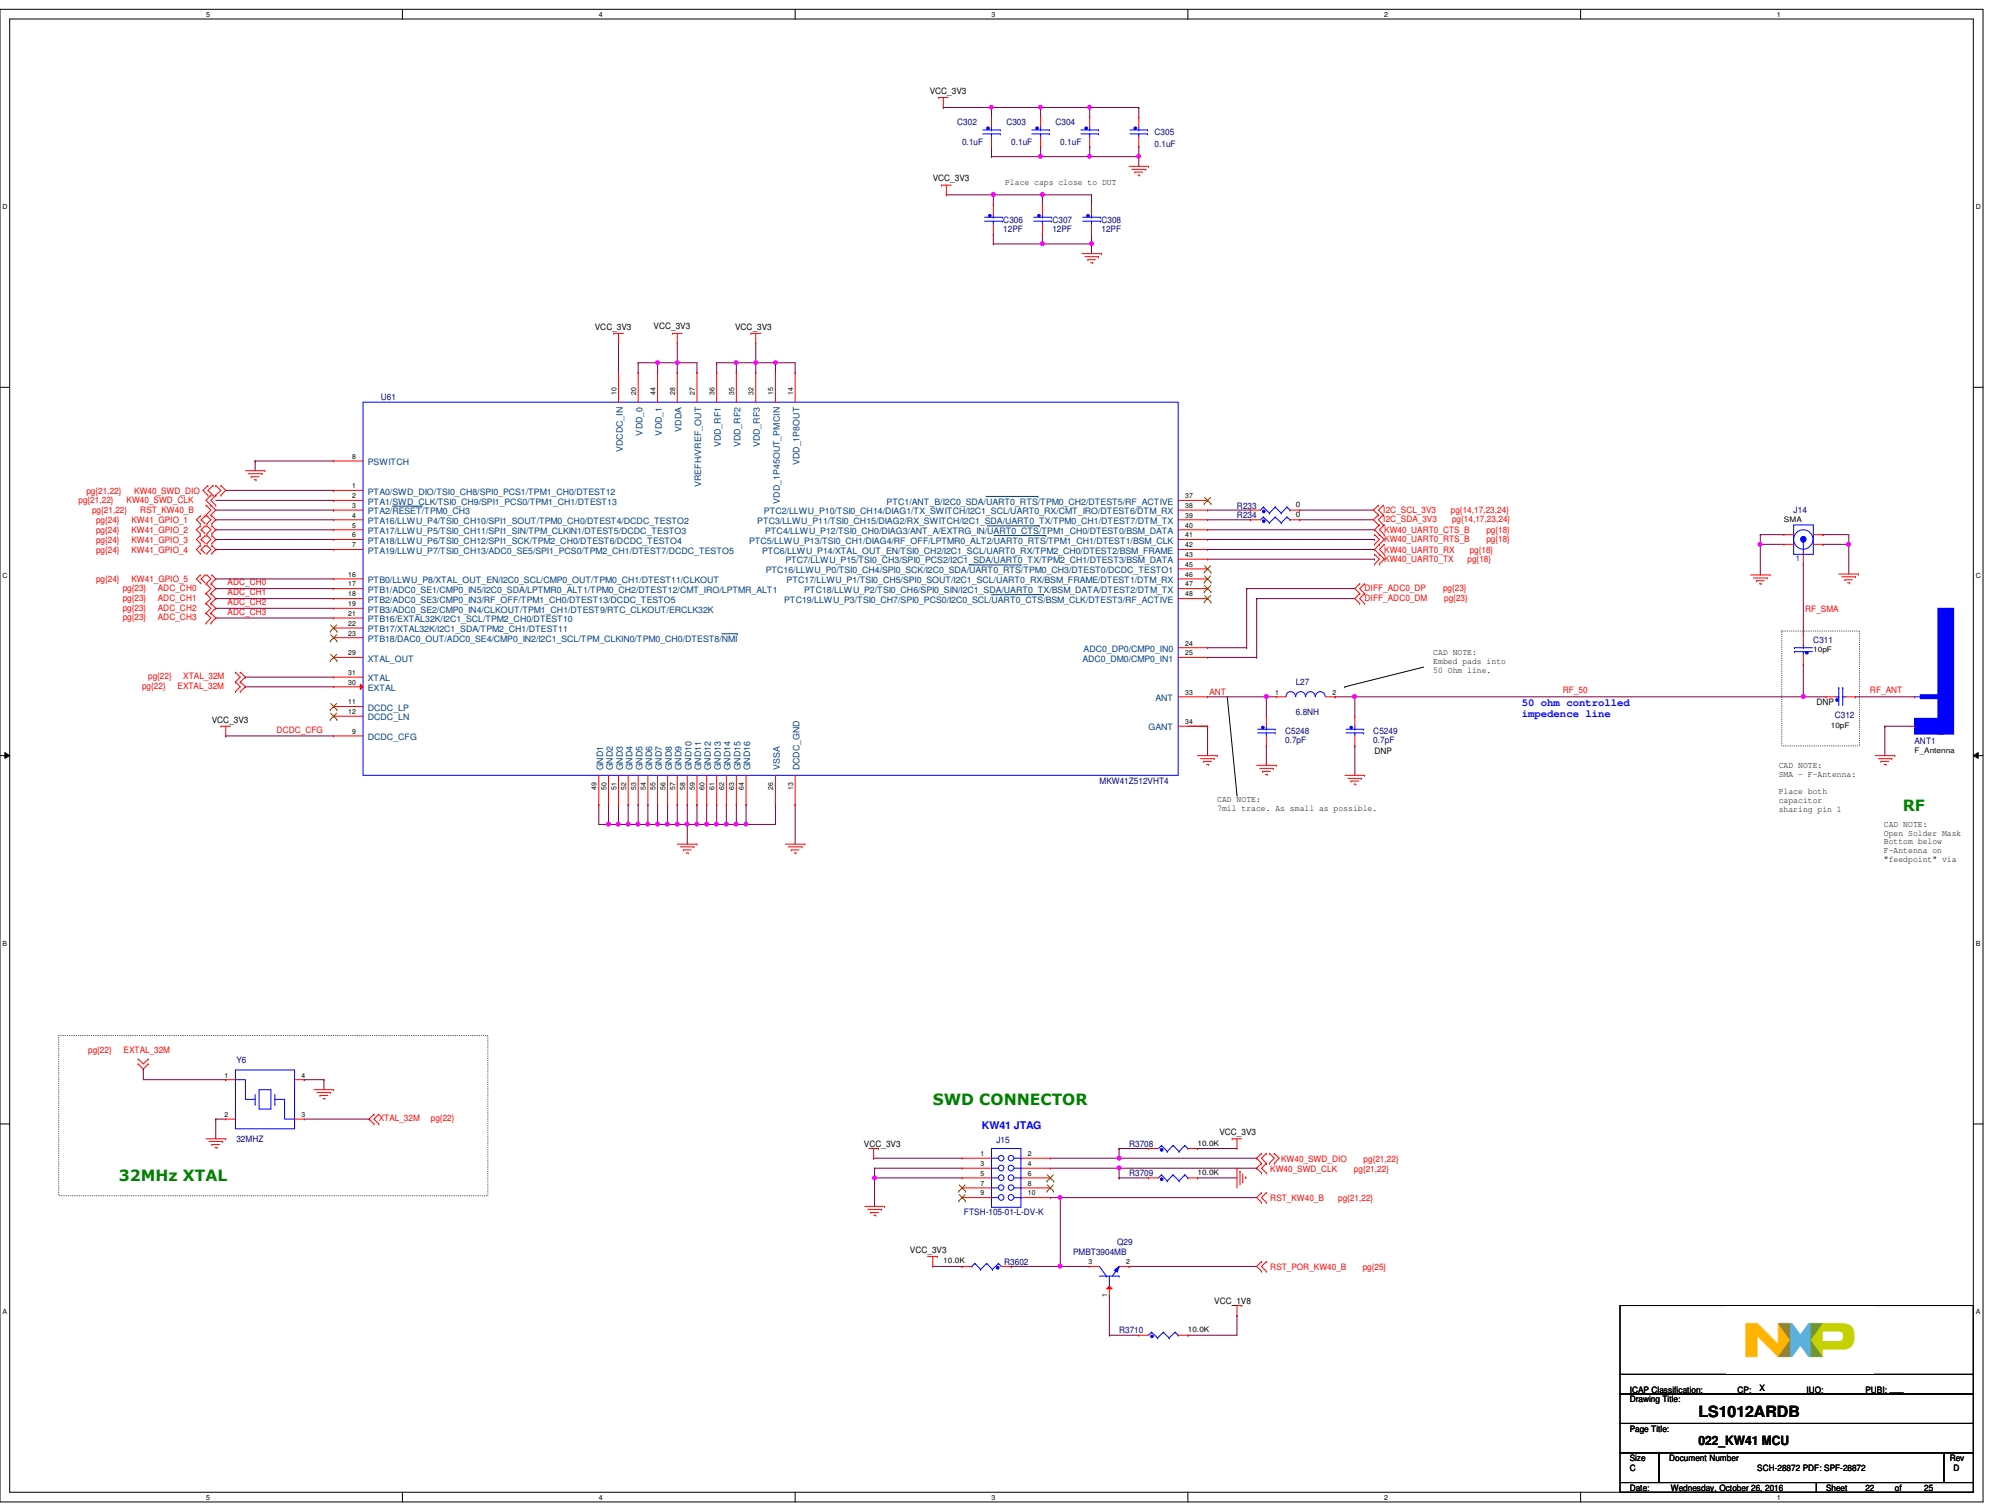
[picture p57: page 22]

Place caps close to DUT

CAD NOTE:
7mil trace. As small as possible.

### OPTIONAL PROVISION FOR I2S ON SPI IO

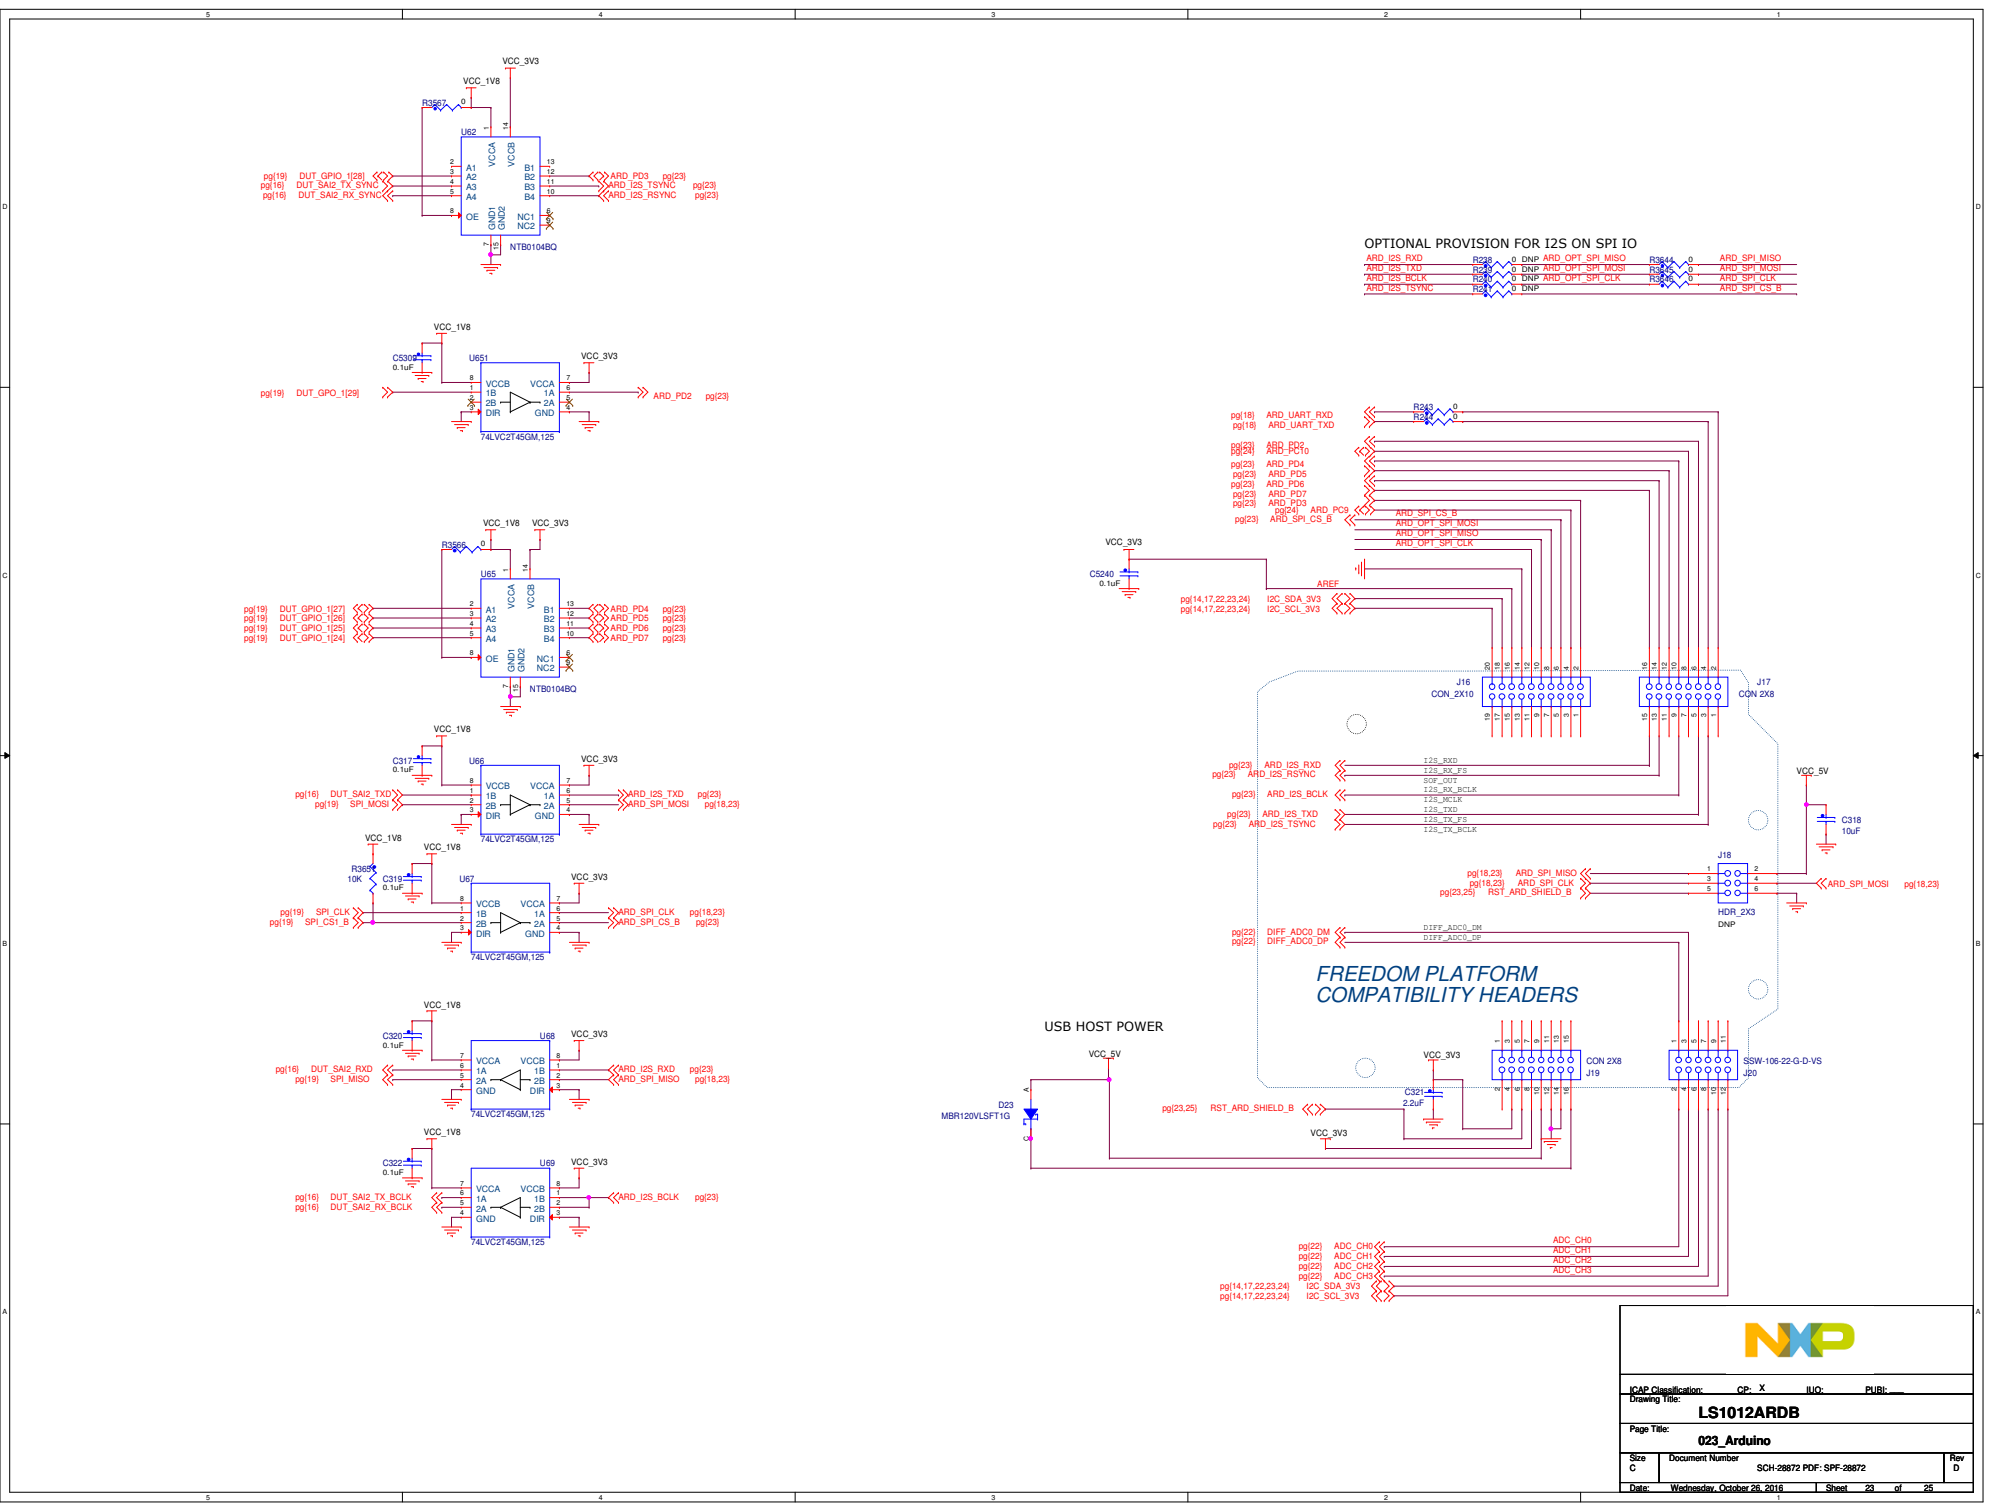
[picture p58: page 23]

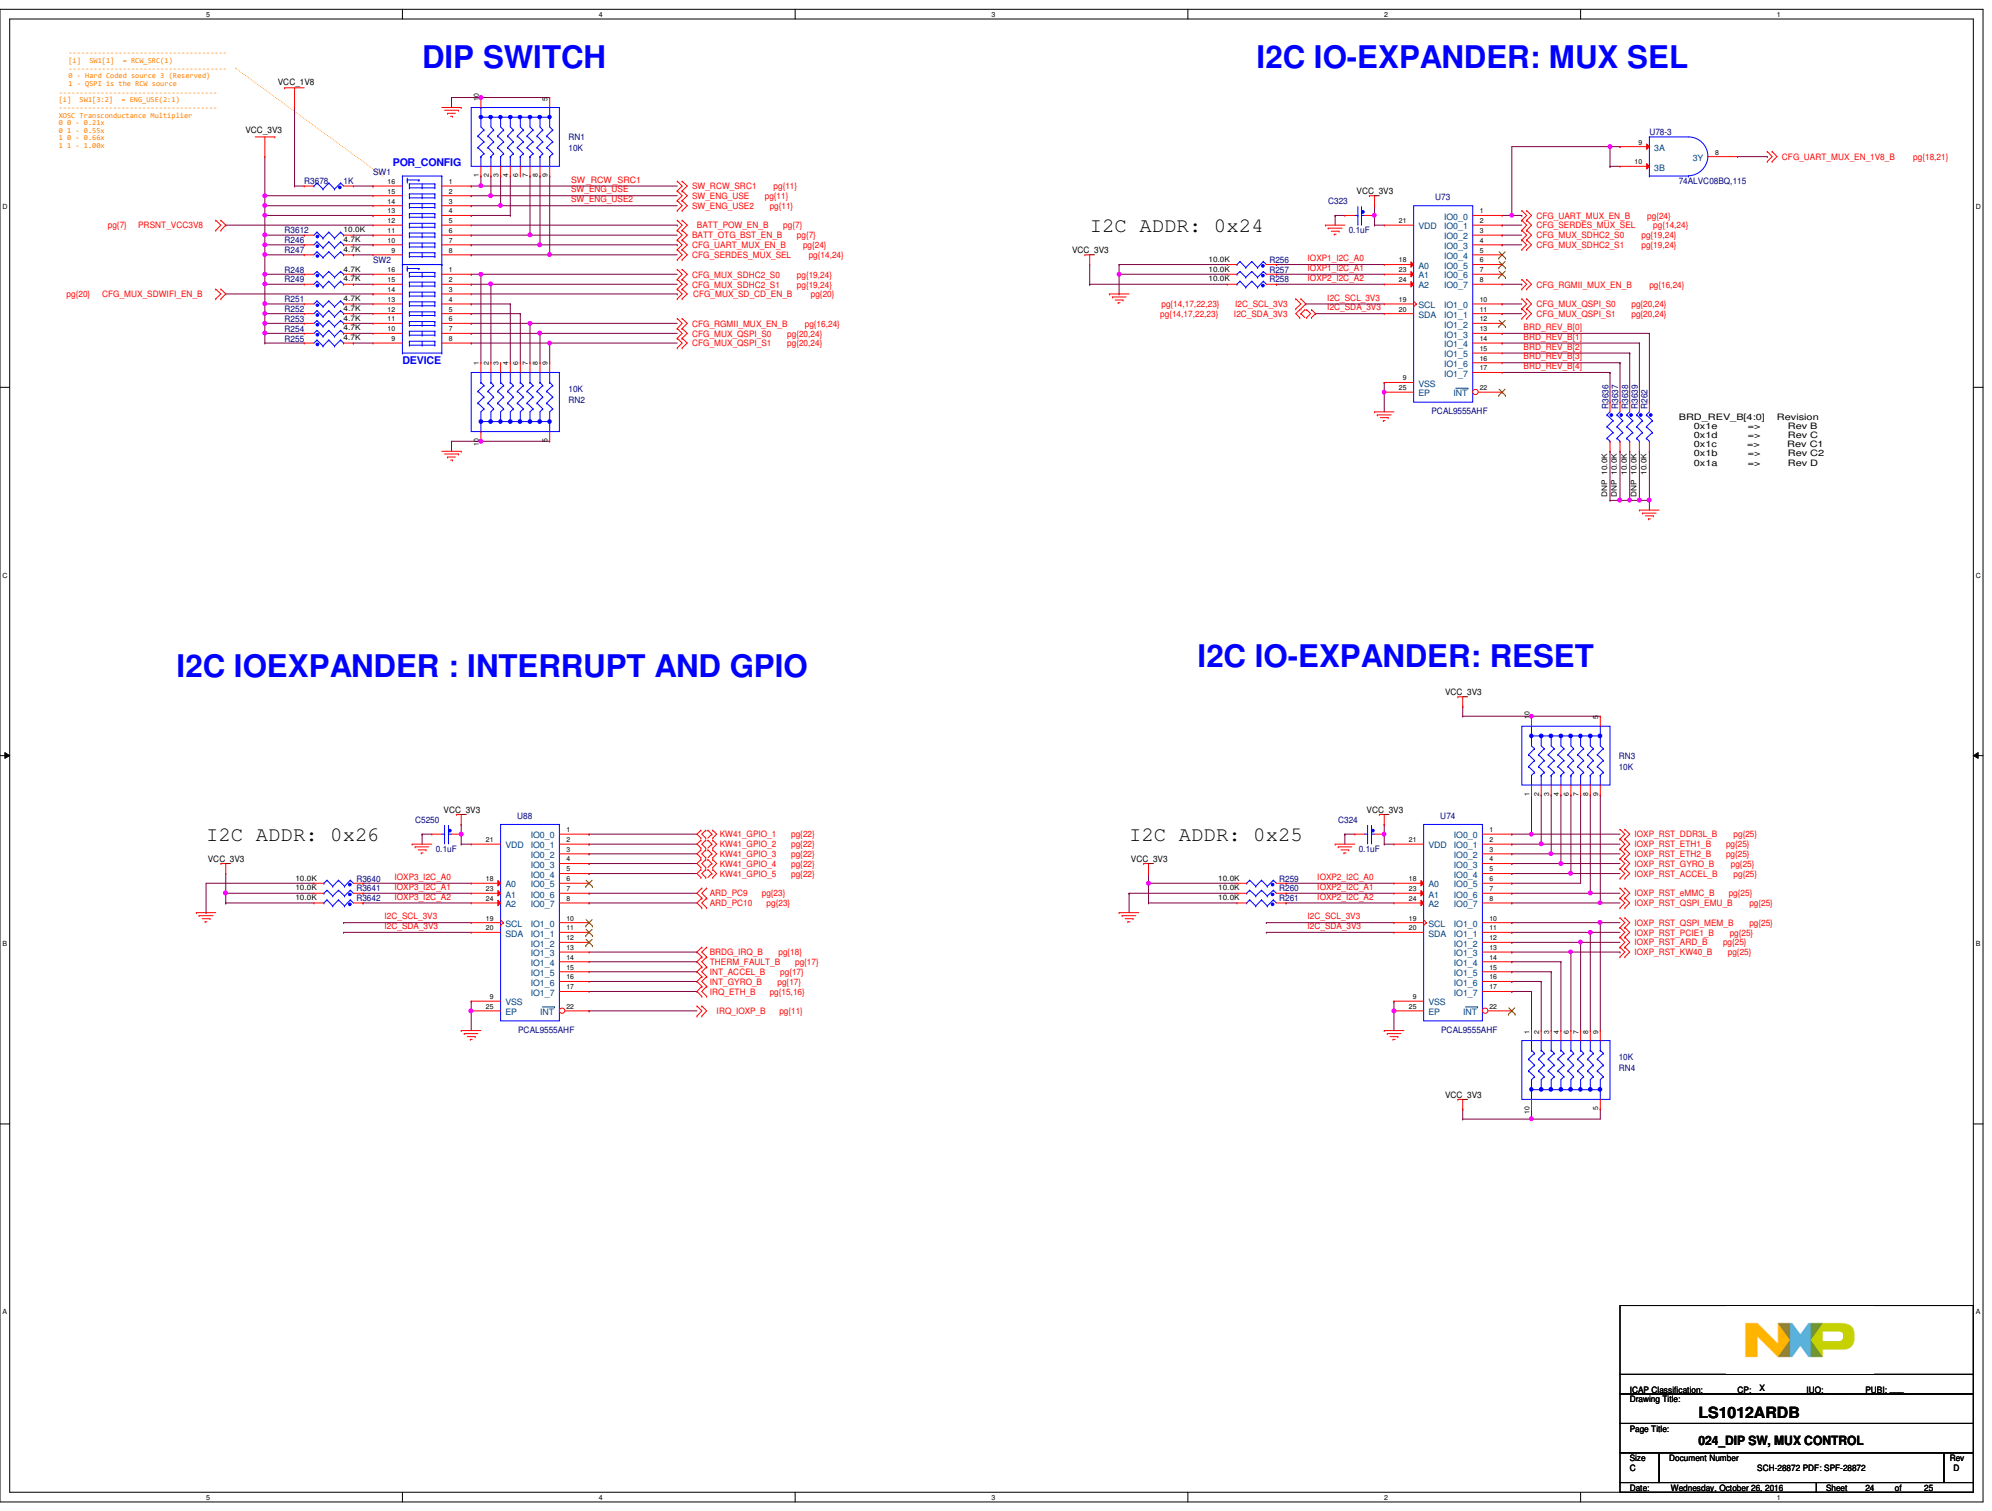
[picture p59: page 24]

## TARGET RESET AND BOOTLOADER

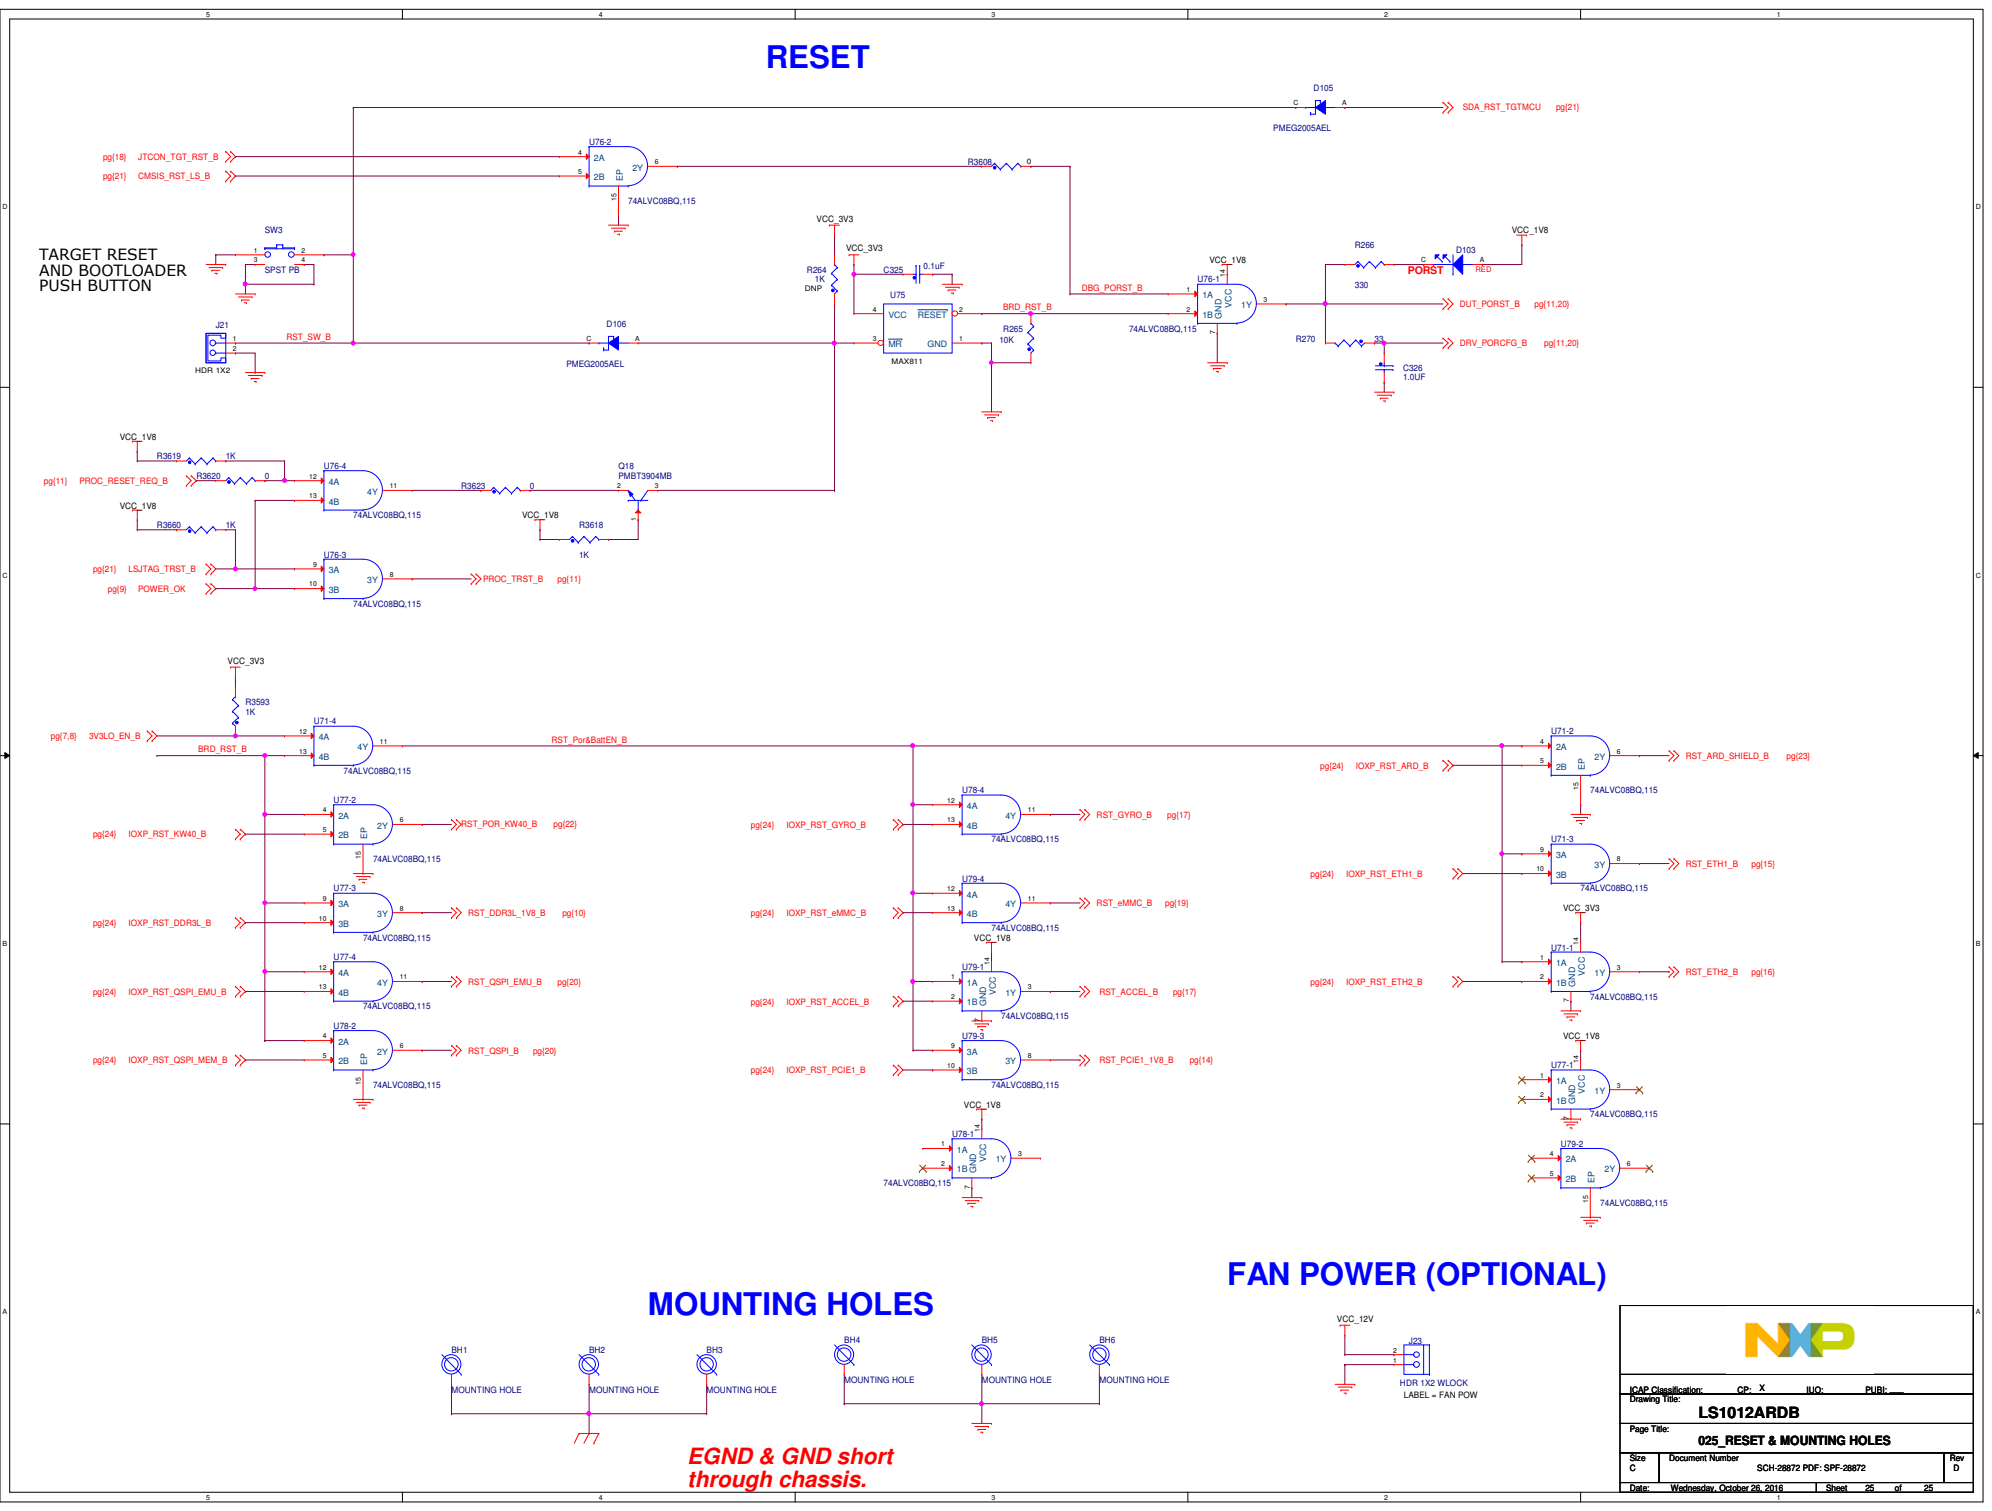
[picture p60: page 25]
