imagestream/kicad/AP3100/AP3100.pdf

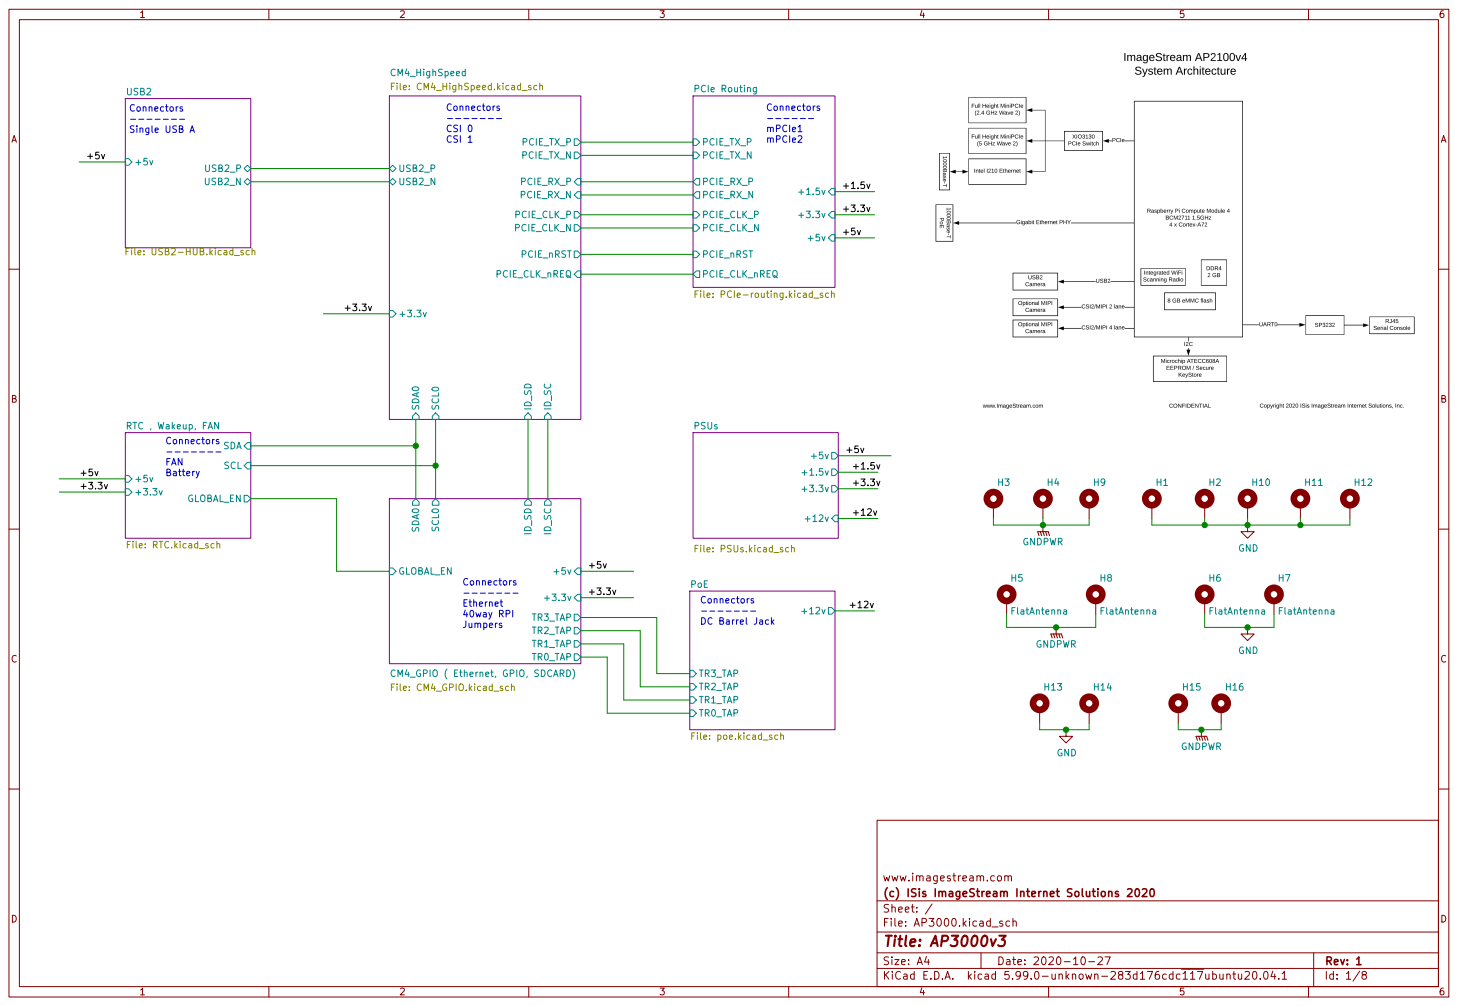
[picture p61: page 1]

File: RTC.kicad_sch SCL SDA GLOBAL_EN

------- DC Barrel Jack Connectors
------- FAN

www.imagestream.com
File: AP3000.kicad_sch Sheet: / (c) ISis ImageStream Internet Solutions 2020

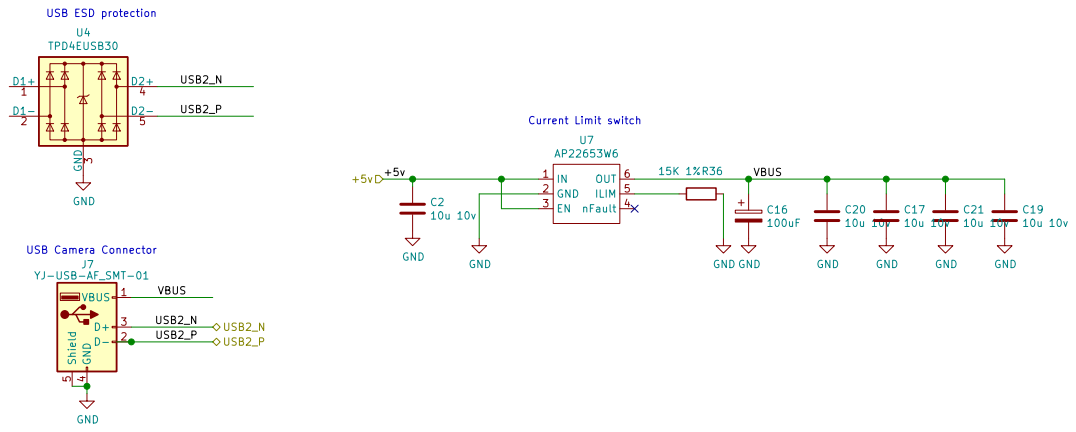
[picture p62: page 2]

www.imagestream.com
/ (c) ISis ImageStream Internet Solutions 2020
File: USB2-HUB.kicad_sch Sheet: /USB2
Id: 2/8 Title: AP3000v3

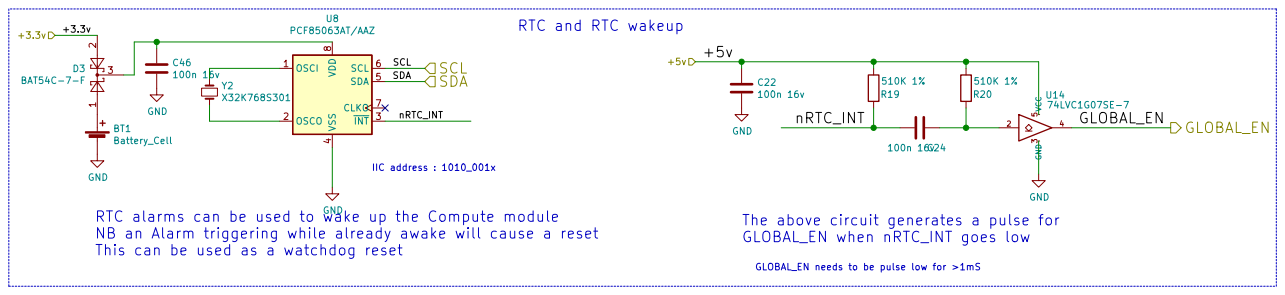
[picture p63: page 3]

RTC and RTC wakeup

2 D3 3 BAT54C-7-F OSCI 1 OSCO 2 ~INT~3 VSS

4 SDA 5 SCL 6 CLKO 7 VDD

IIC address : 1010_001x RTC alarms can be used to wake up the Compute module

The above circuit generates a pulse for
GLOBAL_EN when nRTC_INT goes low

NB an Alarm triggering while already awake will cause a reset
This can be used as a watchdog reset

GLOBAL_EN needs to be pulse low for >1mS

www.imagestream.com
(c) ISis ImageStream Internet Solutions 2020
Sheet: /RTC , Wakeup, FAN/
File: RTC.kicad_sch
Id: 3/8 Title: AP3000v3

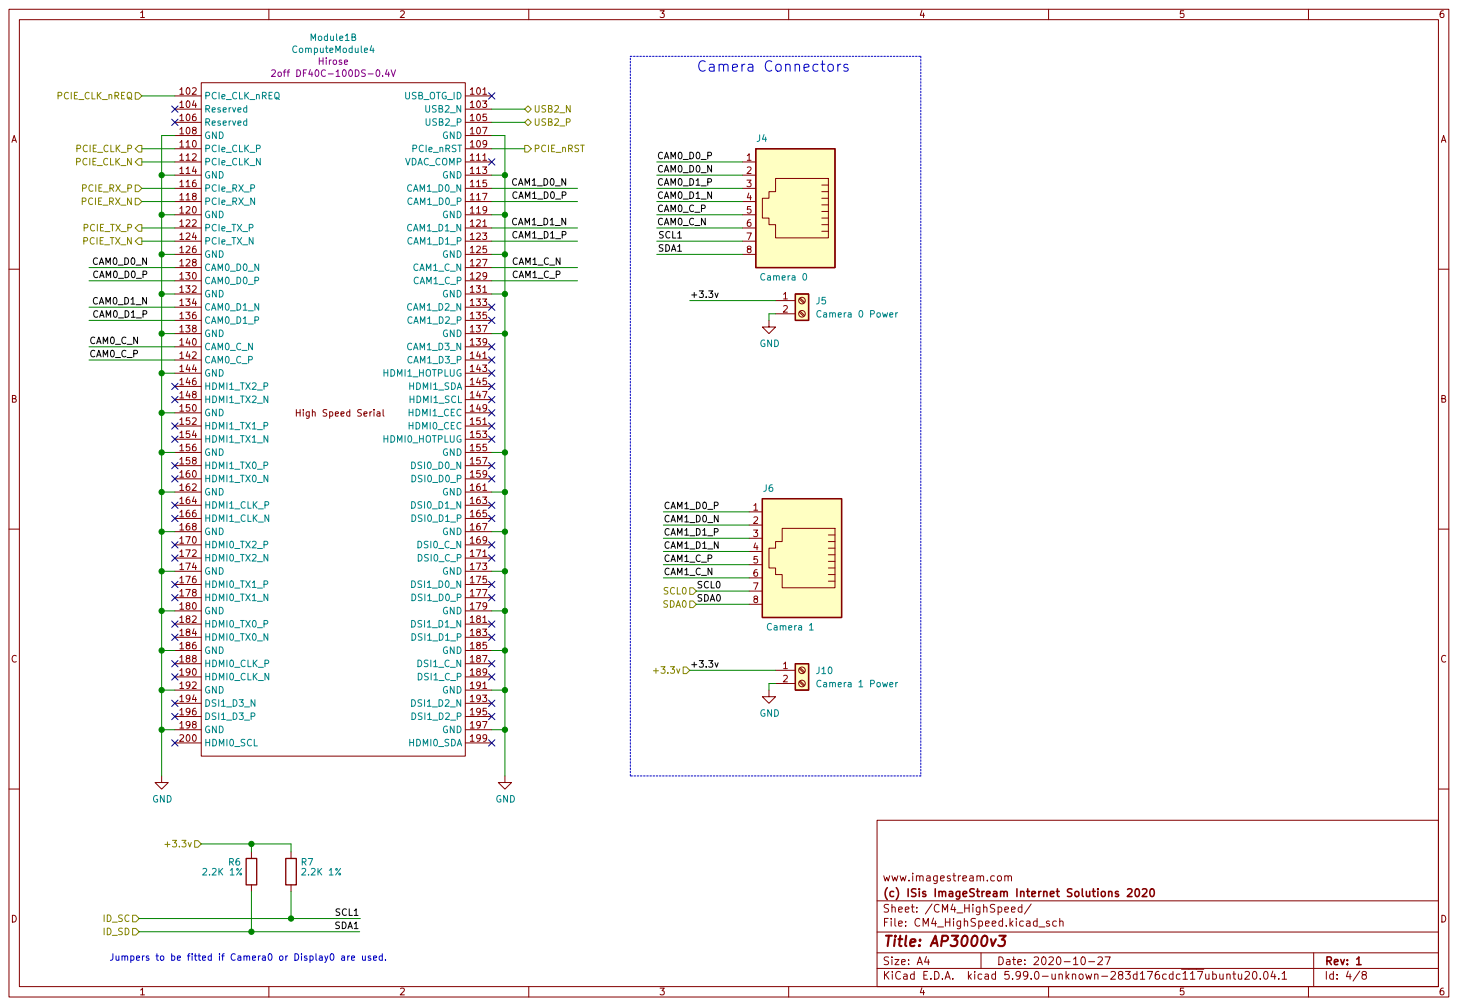
[picture p64: page 4]

(c) ISis ImageStream Internet Solutions 2020
Sheet: /CM4_HighSpeed/
File: CM4_HighSpeed.kicad_sch
Id: 4/8 Title: AP3000v3

Jumpers to be fitted if Camera0 or Display0 are used.

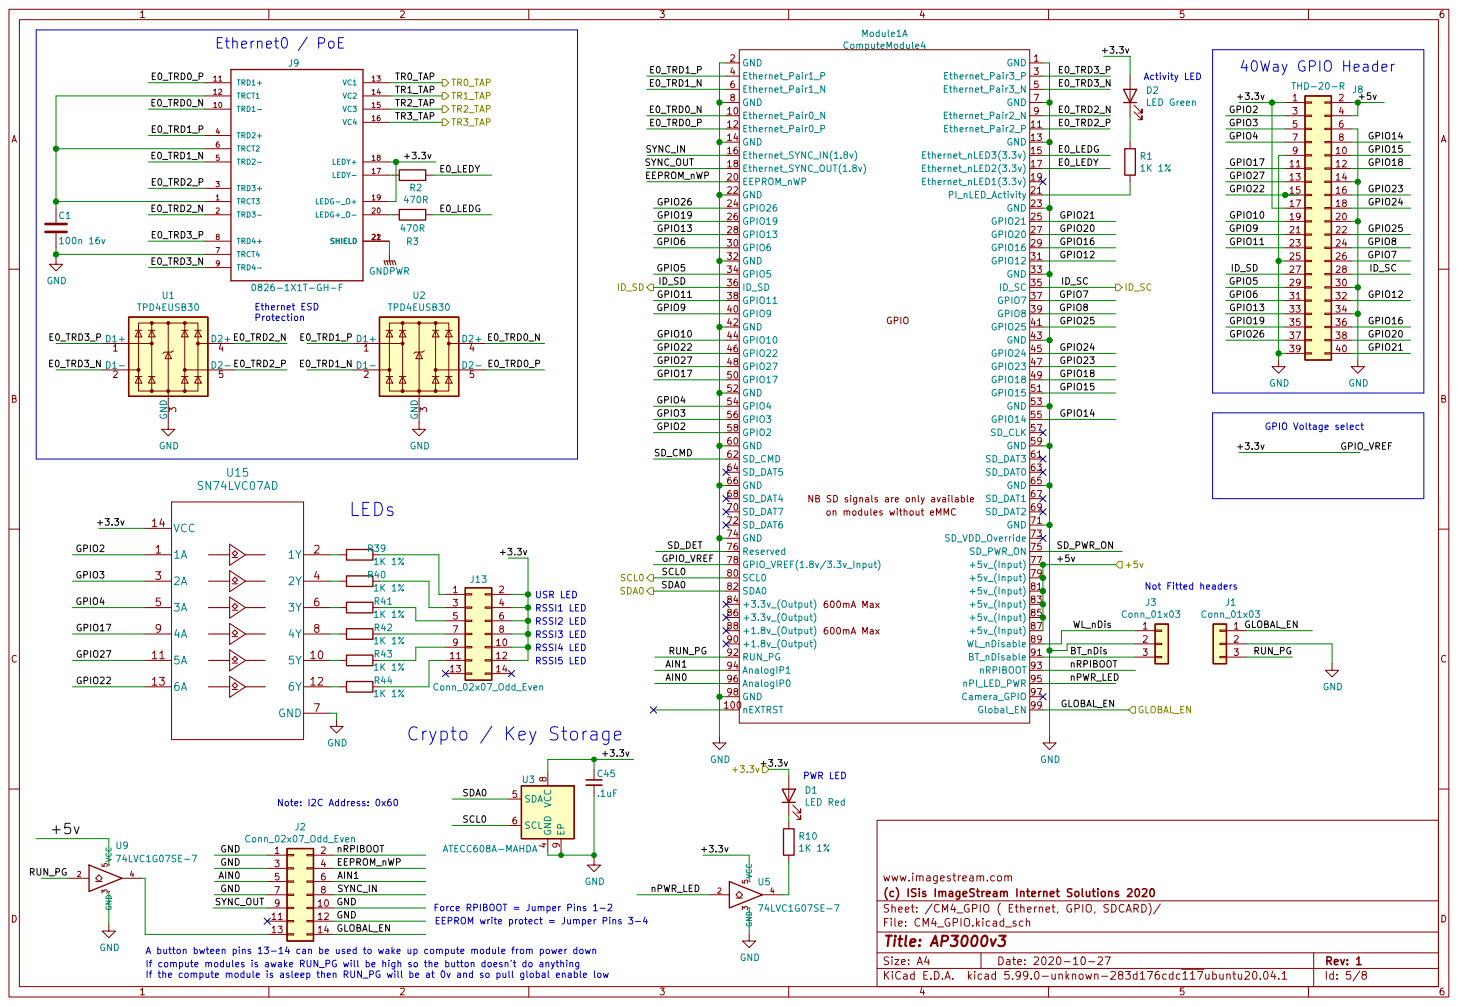
[picture p65: page 5]

600mA Max 600mA Max NB SD signals are only available

www.imagestream.com
(c) ISis ImageStream Internet Solutions 2020
Sheet: /CM4_GPIO ( Ethernet, GPIO, SDCARD)/
File: CM4_GPIO.kicad_sch
Id: 5/8 Title: AP3000v3

Force RPIBOOT = Jumper Pins 1-2
EEPROM write protect = Jumper Pins 3-4

If compute modules is awake RUN_PG will be high so the button doesn't do anything
If the compute module is asleep then RUN_PG will be at 0v and so pull global enable low

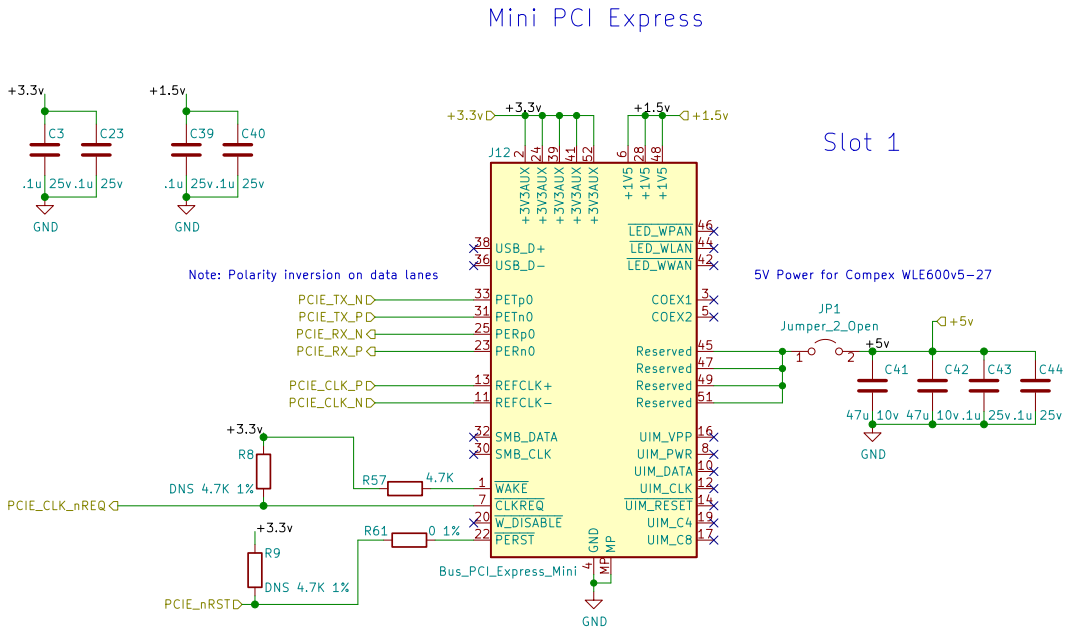
[picture p66: page 6]

4 +3V3AUX 41 ~LED_WWAN42 ~LED_WLAN44 Reserved 45 ~LED_WPAN46 Reserved 47 +1V5 48 Reserved 49 COEX2 5 Reserved 51 +3V3AUX 52 +1V5

www.imagestream.com
(c) ISis ImageStream Internet Solutions 2020
Sheet: /PCIe Routing/
File: PCIe-routing.kicad_sch
Id: 6/8 Title: AP3000v3

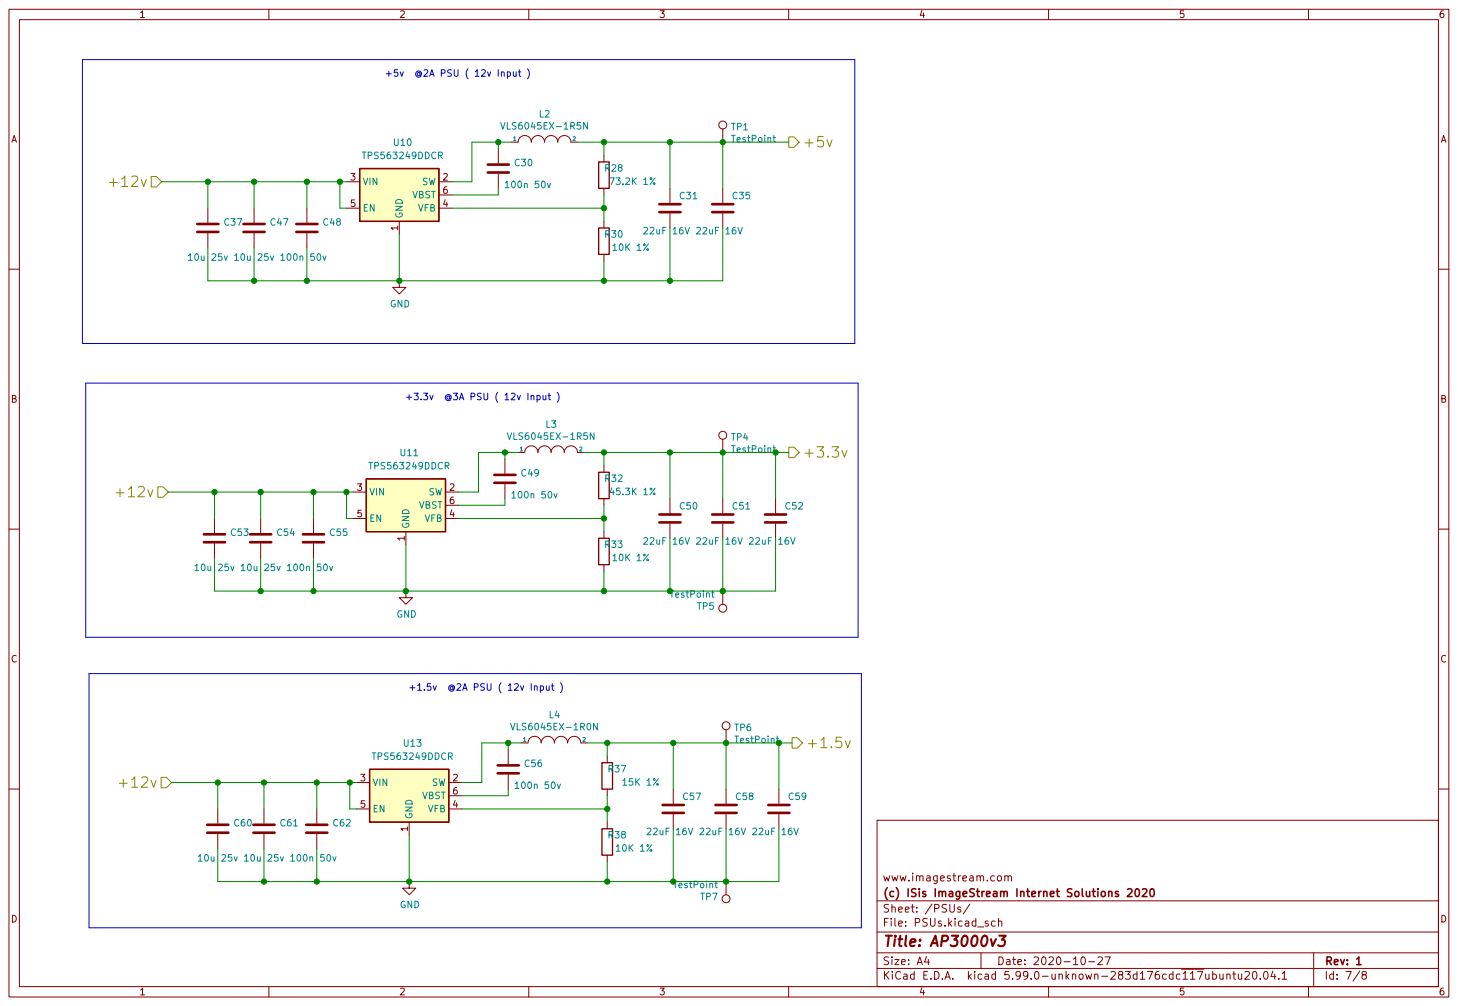
[picture p67: page 7]

1 SW 2 VIN 3 VFB 4 EN 5 VBST 6 U10 TPS563249DDCR

1 SW 2 VIN 3 VFB 4 EN 5 VBST 6 U11 TPS563249DDCR

1 SW 2 VIN 3 VFB 4 EN 5 VBST 6 U13 TPS563249DDCR

www.imagestream.com
File: PSUs.kicad_sch Sheet: /PSUs/ (c) ISis ImageStream Internet Solutions 2020

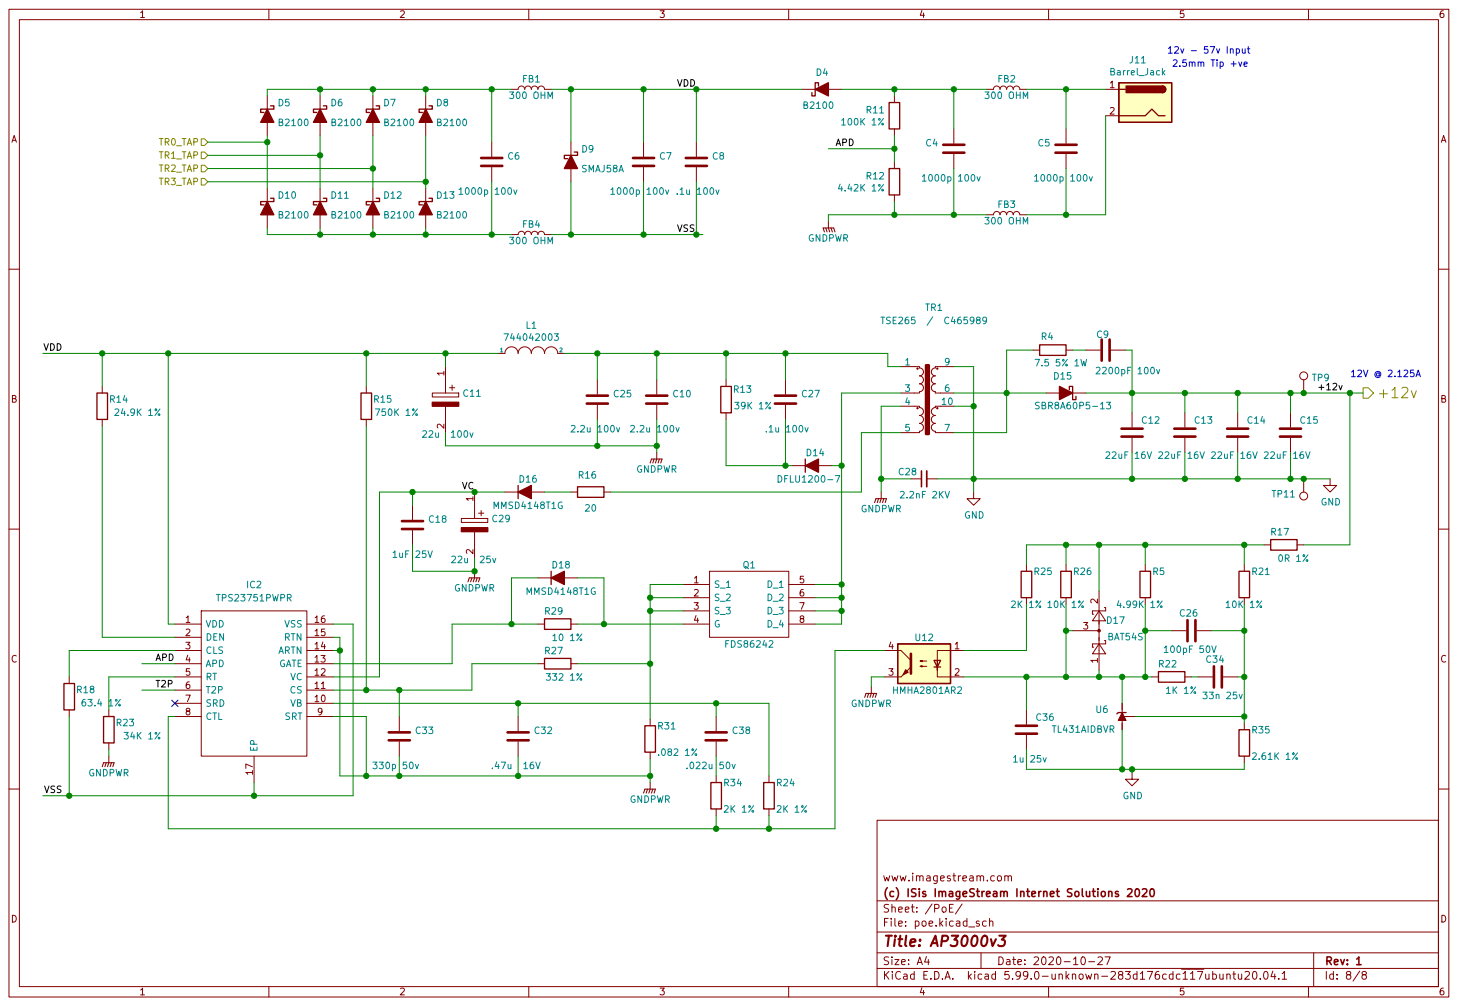
[picture p68: page 8]

www.imagestream.com
File: poe.kicad_sch Sheet: /PoE/ (c) ISis ImageStream Internet Solutions 2020
