imagestream/kicad/Taylor's Water Layout/Taylor's Water Layout-F_Silkscreen.pdf

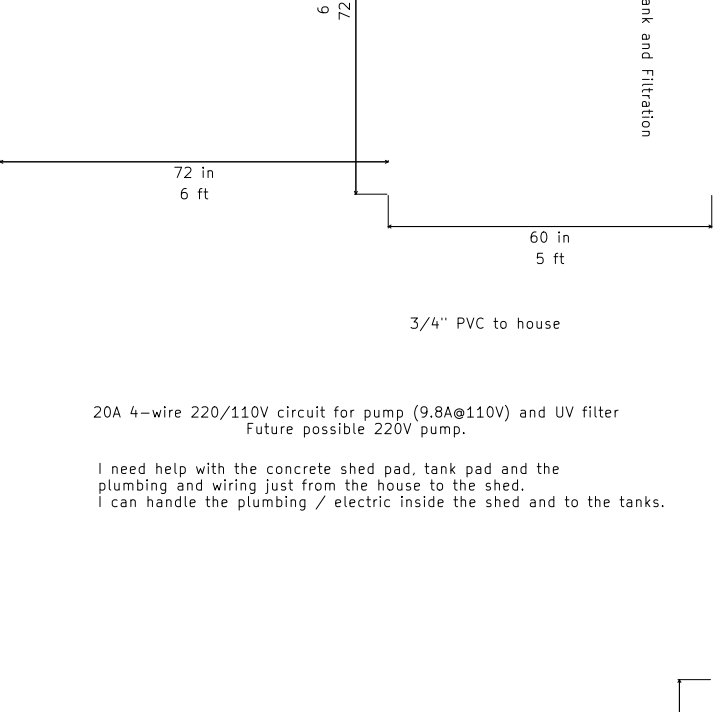
[picture p69: page 1]

20A 4-wire 220/110V circuit for pump (9.8A@110V) and UV filter

I need help with the concrete shed pad, tank pad and the
plumbing and wiring just from the house to the shed.
