imagestream/kicad/AP2100.ls1043/AP2100.pdf

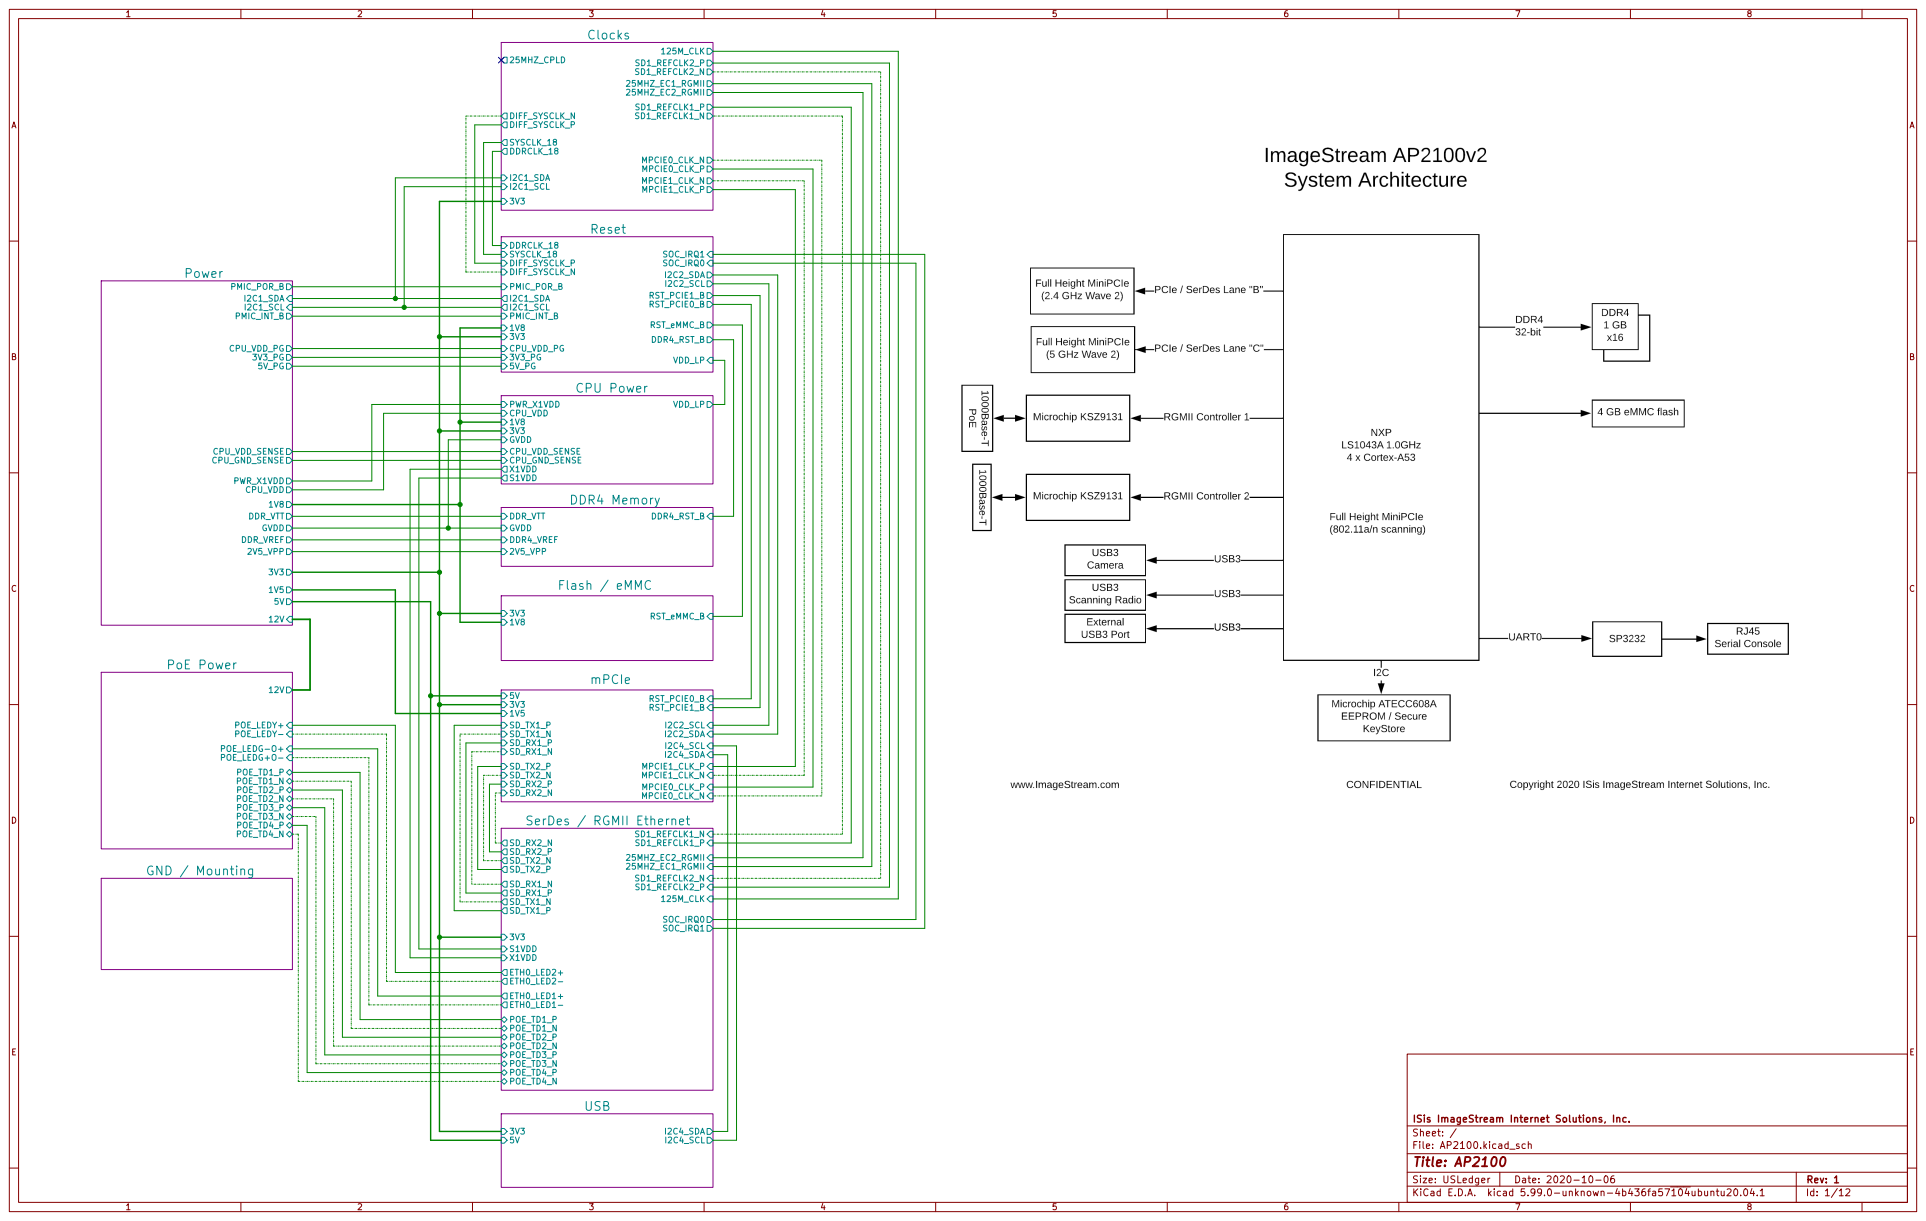
[picture p70: page 1]

ISis ImageStream Internet Solutions, Inc.
File: AP2100.kicad_sch Sheet: /
Id: 1/12 Title: AP2100

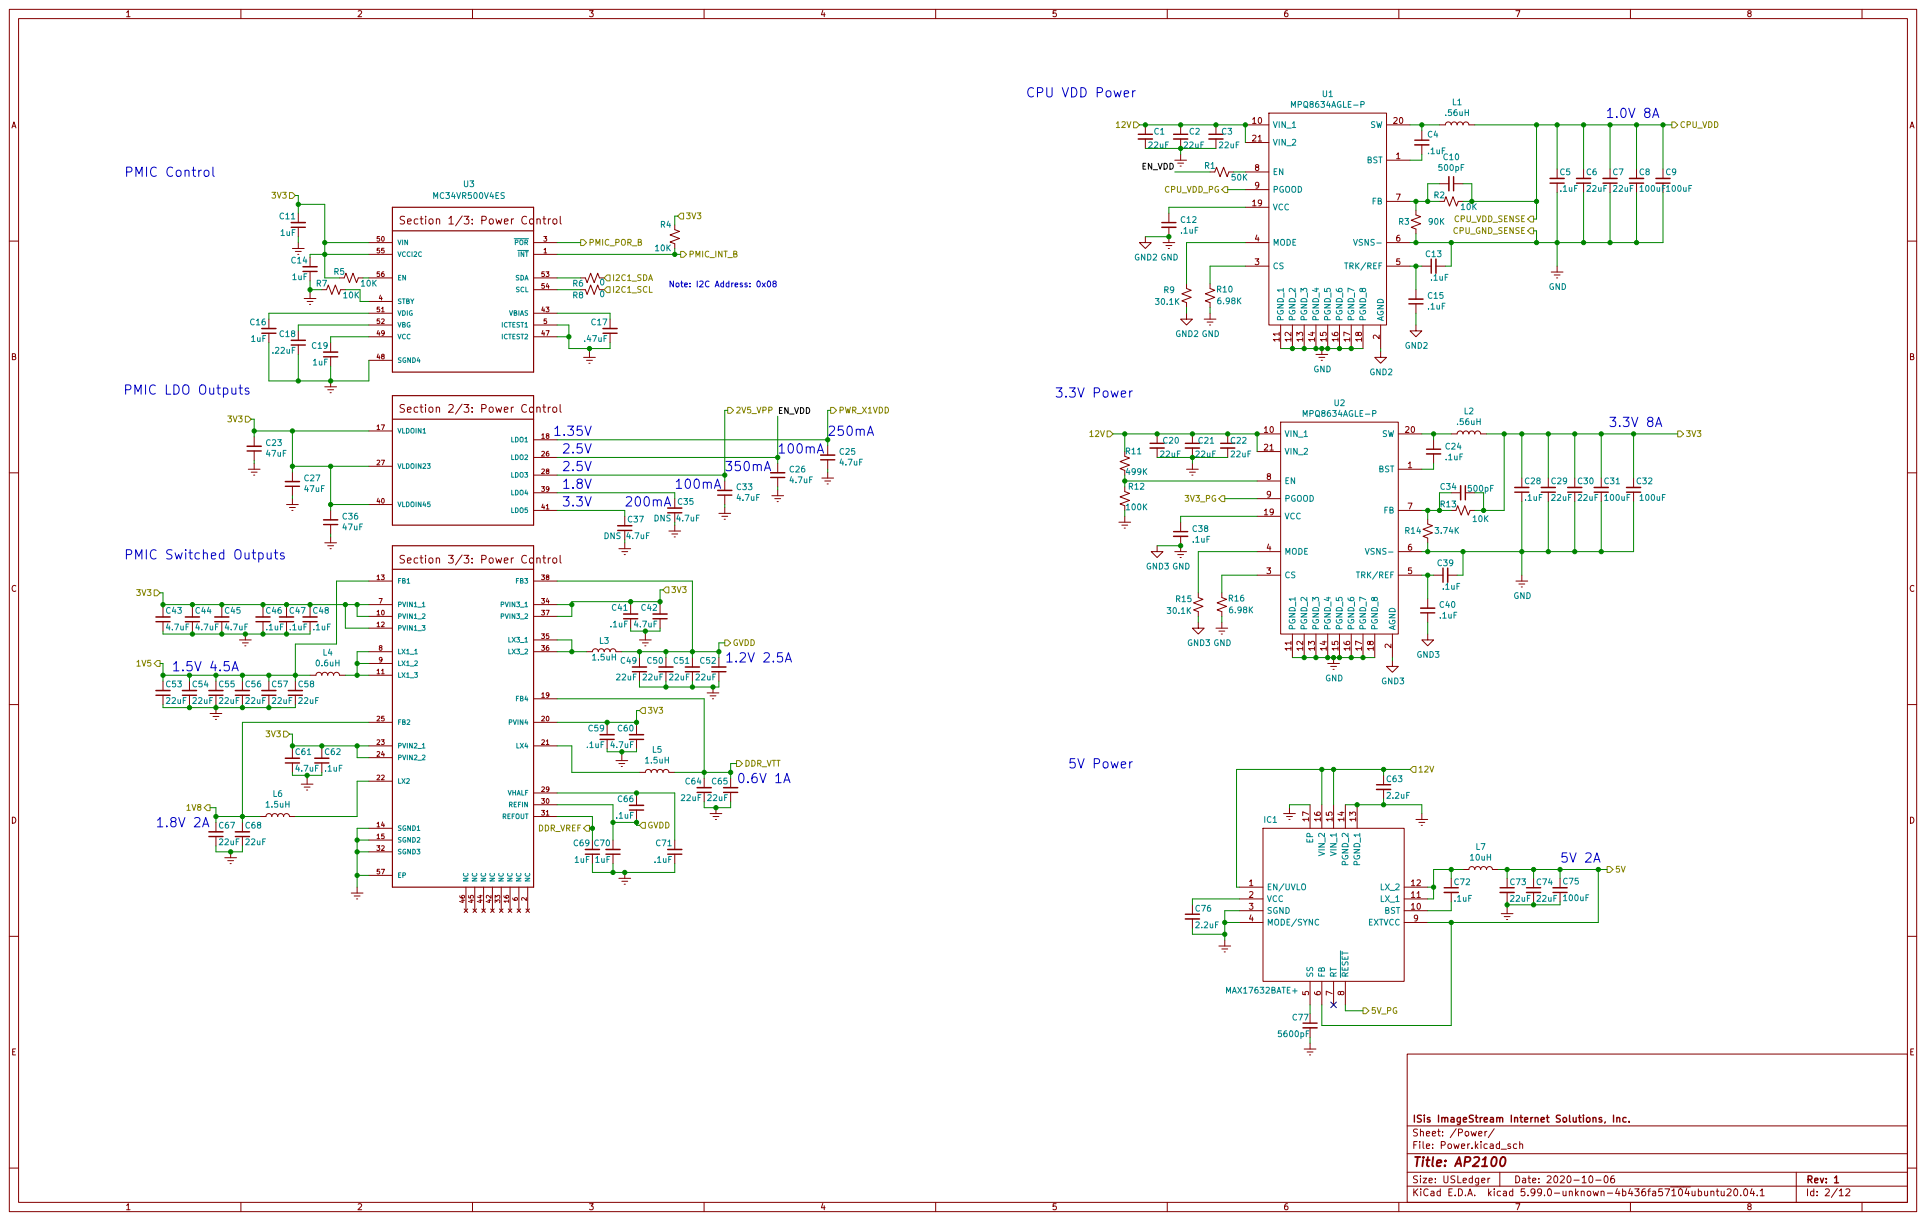
[picture p71: page 2]

2 SW 20 VIN_2 21 CS 3 MODE 4 TRK/REF 5 VSNS- 6 FB 7 EN 8 PGOOD 9 U1 MPQ8634AGLE-P L1

2 SW 20 VIN_2 21 CS 3 MODE 4 TRK/REF 5 VSNS- 6 FB 7 EN 8 PGOOD 9 U2 MPQ8634AGLE-P C67

6 NC 16 NC 33 NC 42 NC 44 NC 45 NC 46 PVIN1_2 10 PVIN1_3 12

File: Power.kicad_sch Sheet: /Power/
Id: 2/12 Title: AP2100

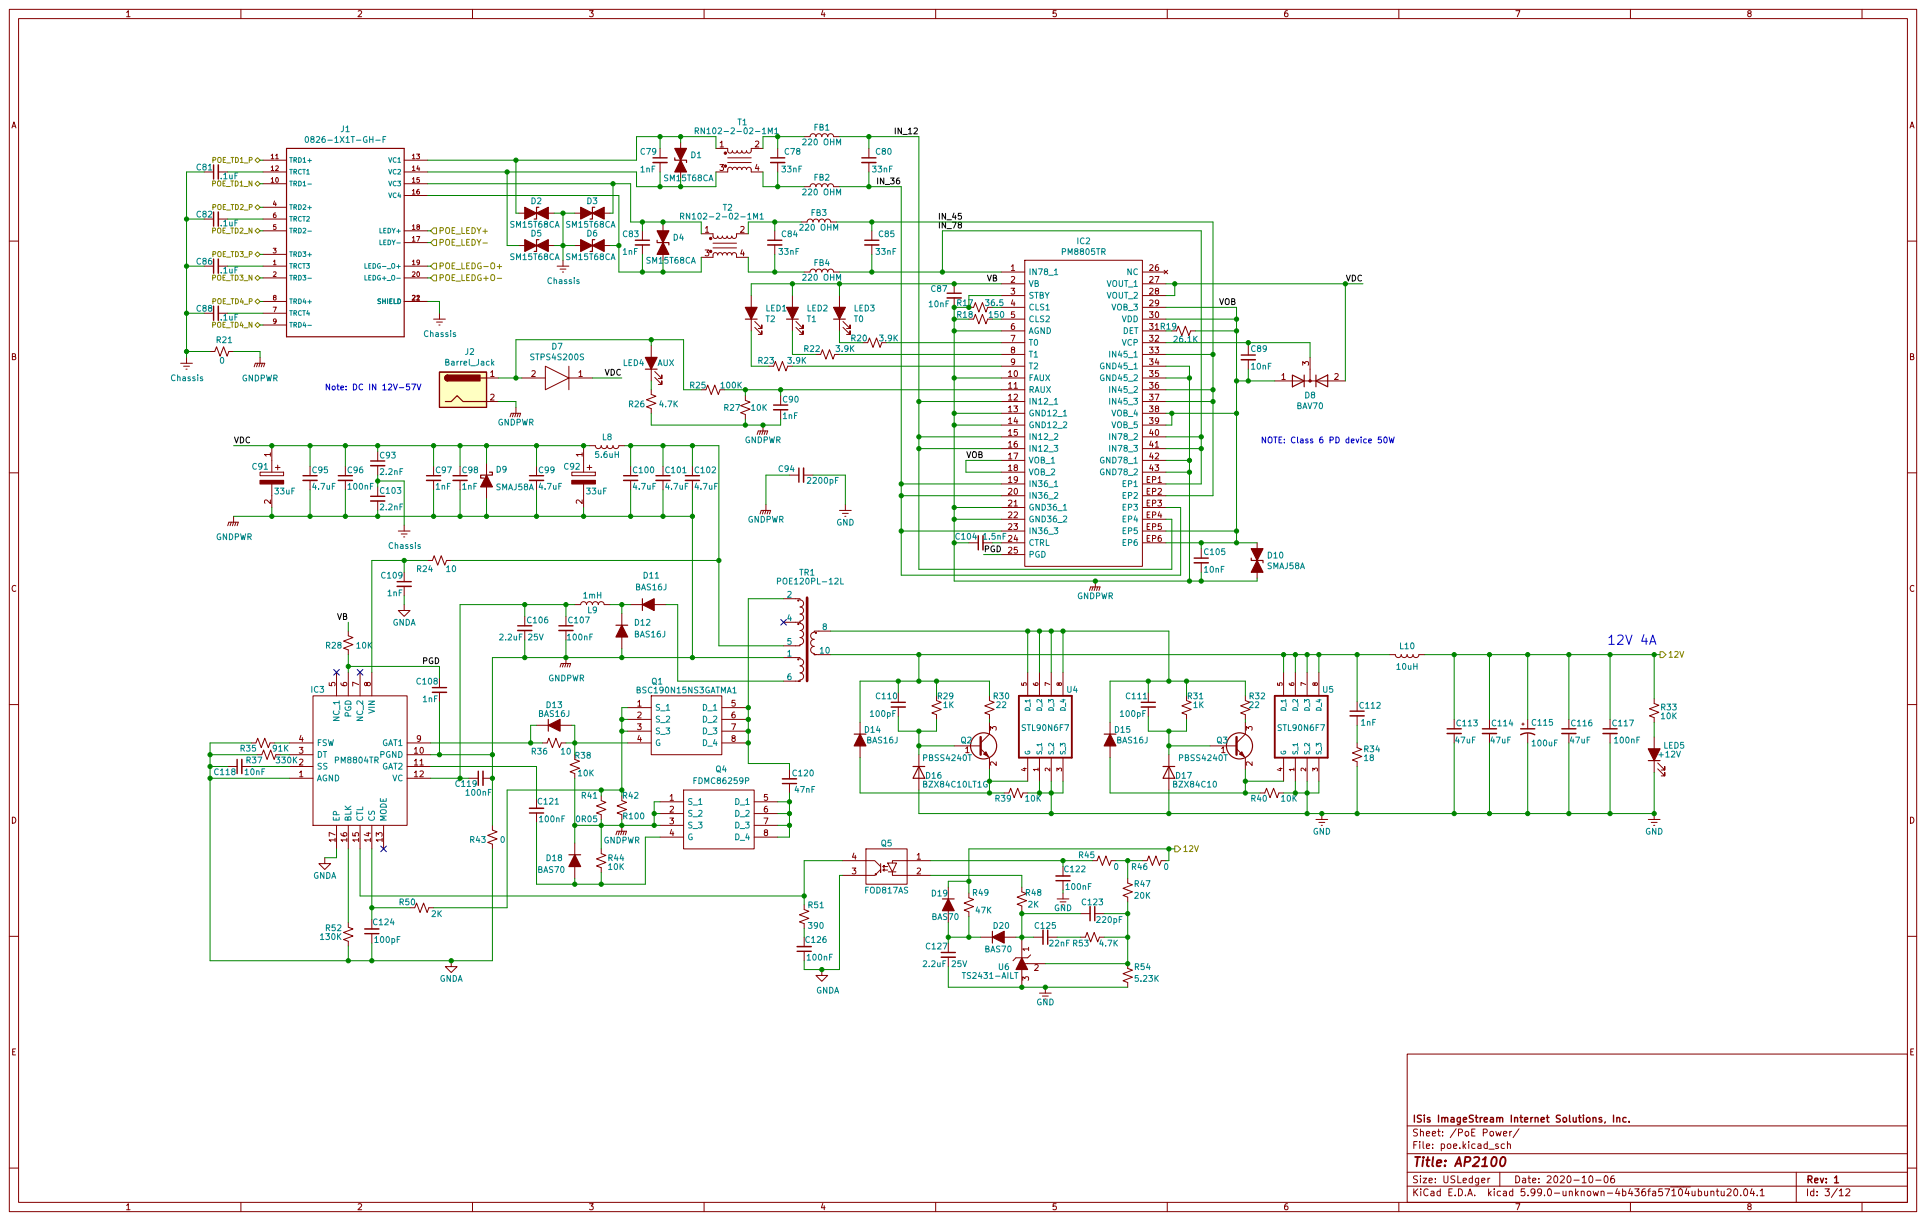
[picture p72: page 3]

4.7uF D12 BAS16J GNDPWR

IN36_2 20 GND36_1 21 GND36_2 22

ISis ImageStream Internet Solutions, Inc.
File: poe.kicad_sch Sheet: /PoE Power/
Id: 3/12 Title: AP2100

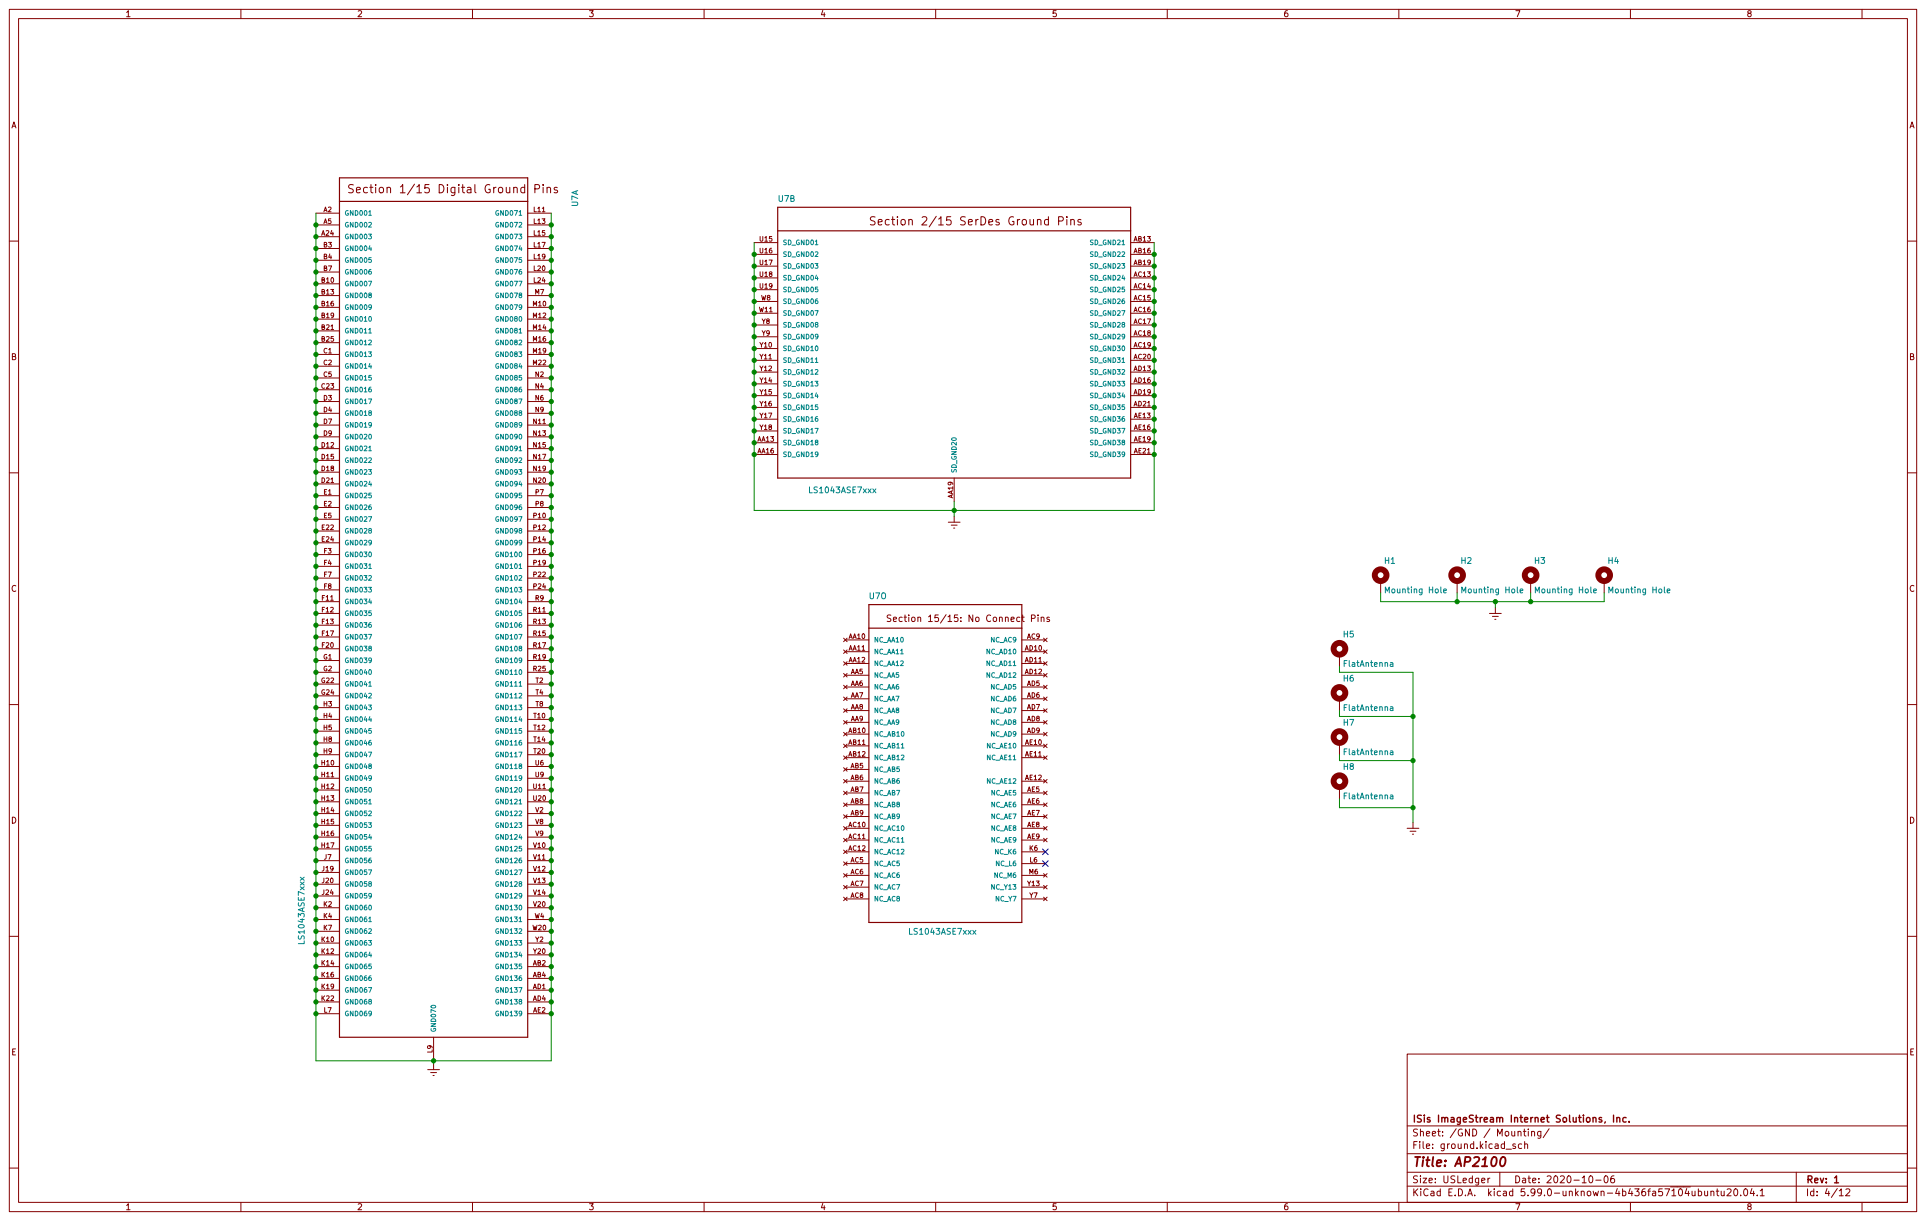
[picture p73: page 4]

LS1043ASE7xxx Section 1/15 Digital Ground Pins

Section 2/15 SerDes Ground Pins

ISis ImageStream Internet Solutions, Inc.
Sheet: /GND / Mounting/
File: ground.kicad_sch
Id: 4/12 Title: AP2100

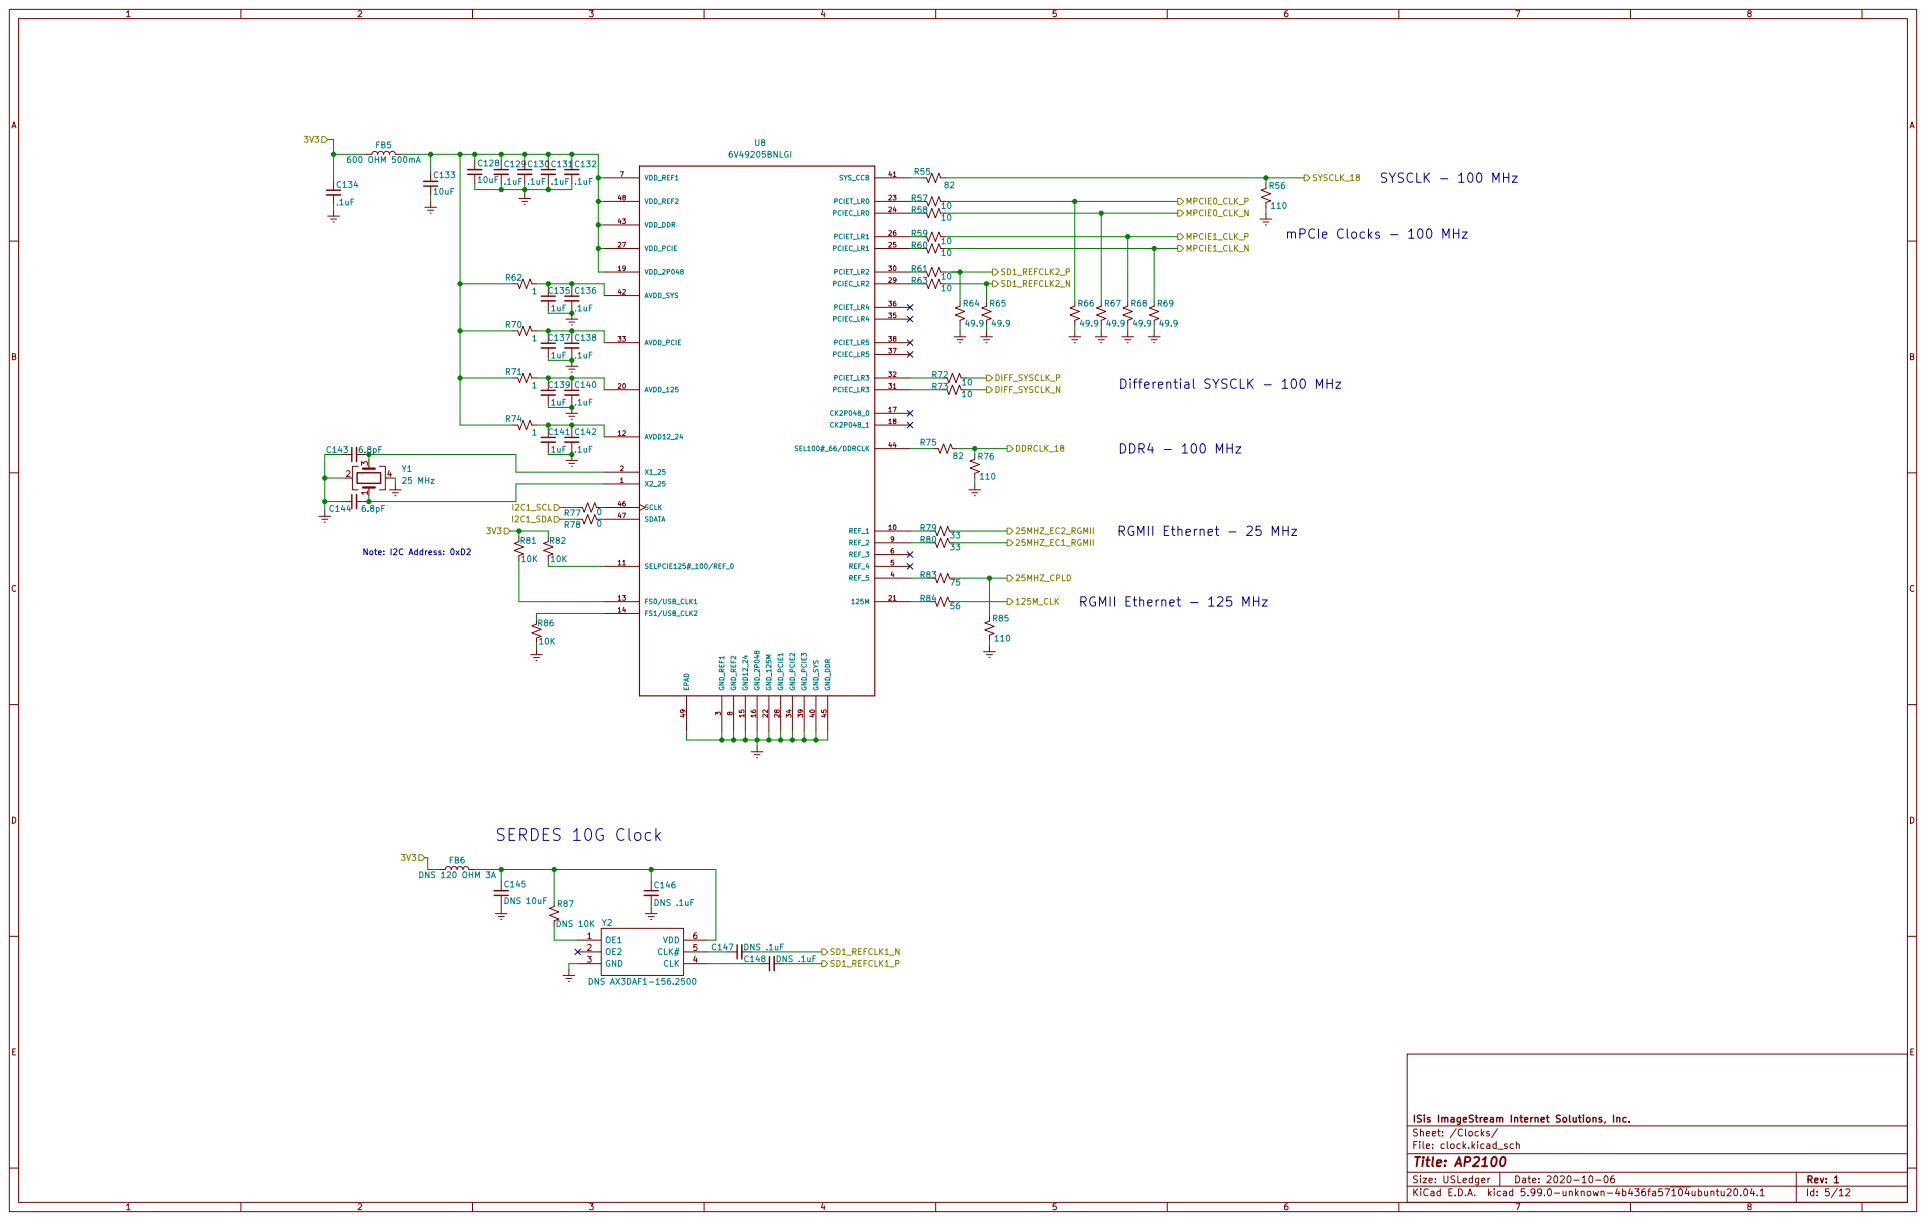
[picture p74: page 5]

ISis ImageStream Internet Solutions, Inc.
File: clock.kicad_sch Sheet: /Clocks/
Id: 5/12 Title: AP2100

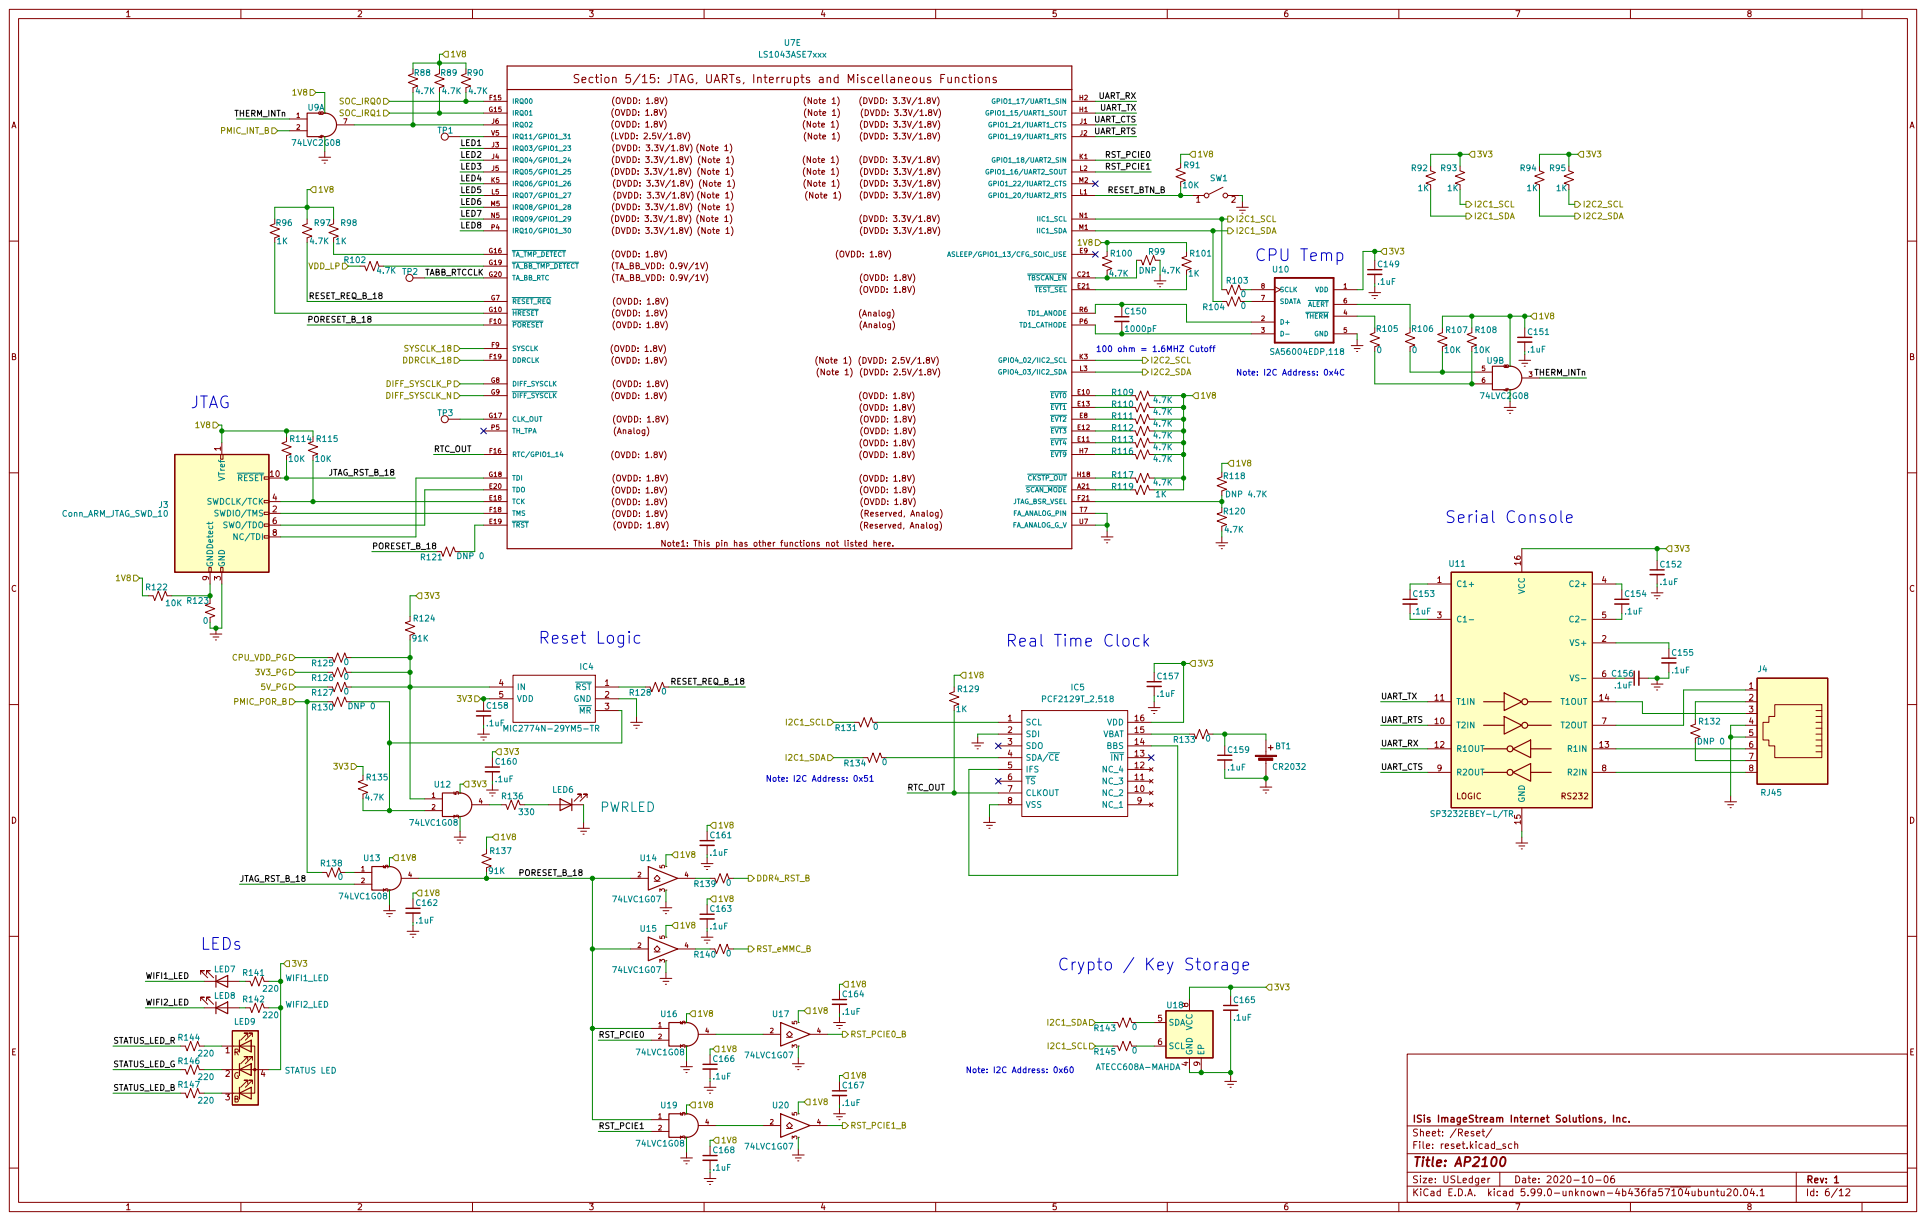
[picture p75: page 6]

Section 5/15: JTAG, UARTs, Interrupts and Miscellaneous Functions

3 SWDCLK/TCK 4 SWO/TDO 6 NC/TDI 8 GNDDetect 9

Note1: This pin has other functions not listed here.

ISis ImageStream Internet Solutions, Inc. C165

File: reset.kicad_sch Sheet: /Reset/
Id: 6/12 Title: AP2100

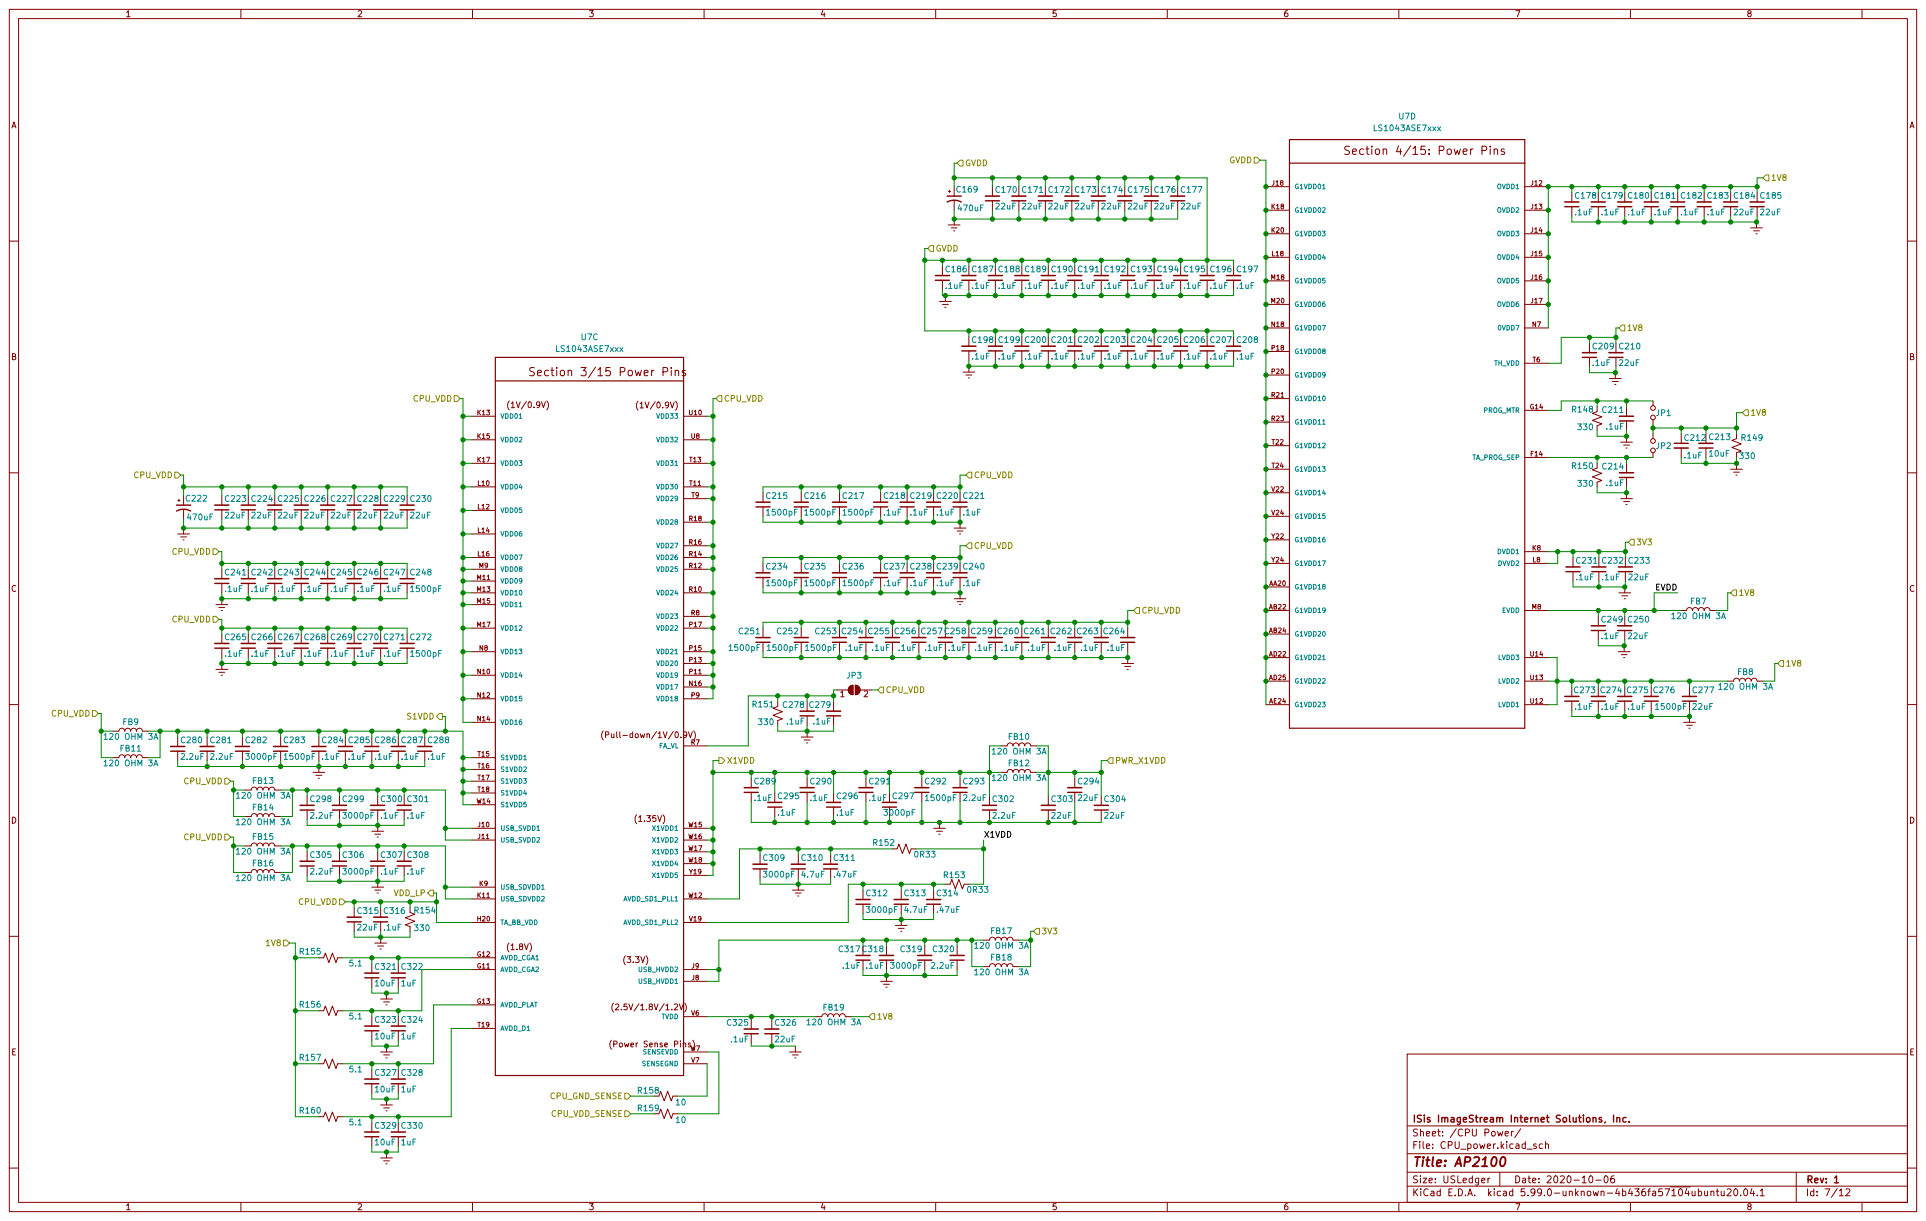
[picture p76: page 7]

ISis ImageStream Internet Solutions, Inc. C287

File: CPU_power.kicad_sch Sheet: /CPU Power/
Id: 7/12 Title: AP2100

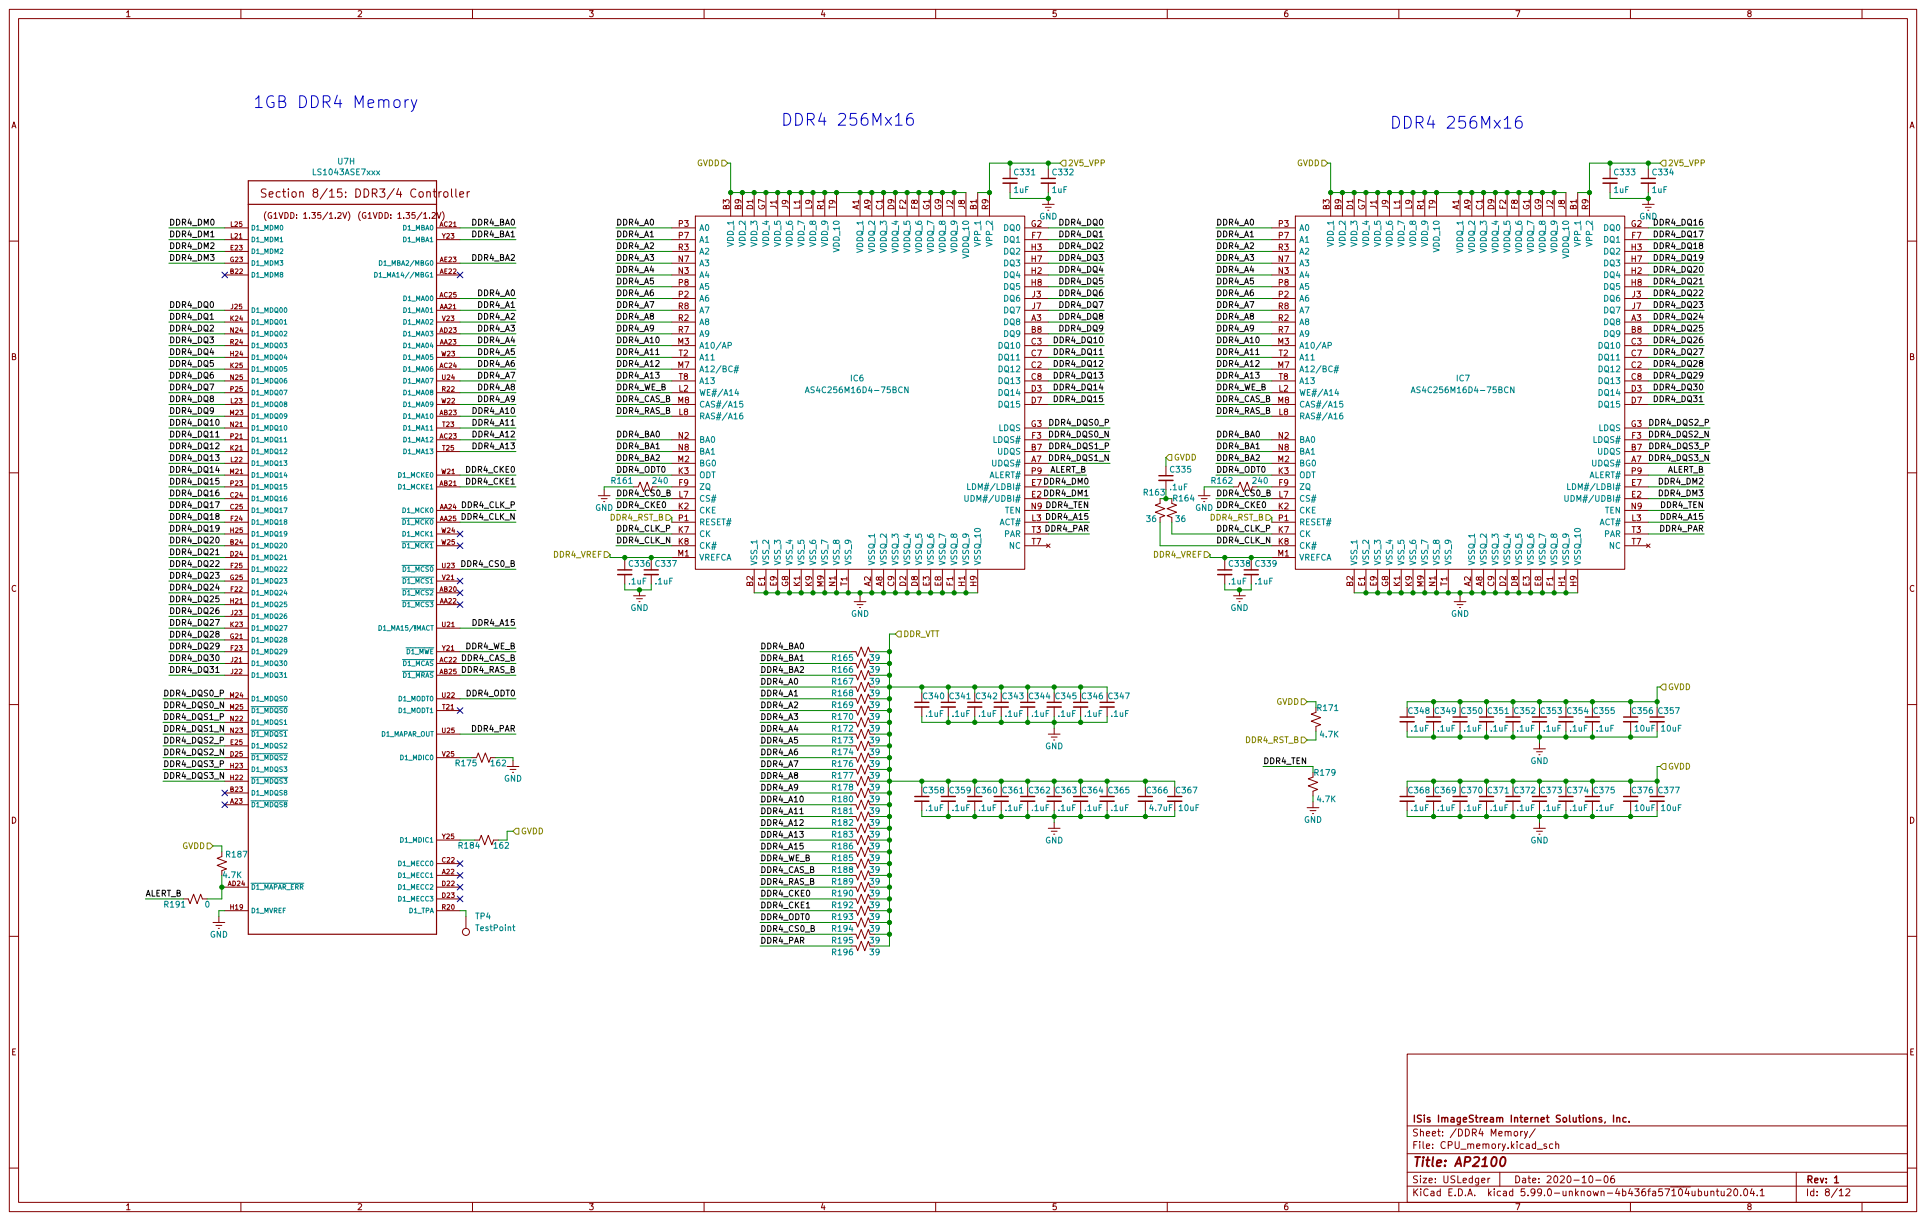
[picture p77: page 8]

ISis ImageStream Internet Solutions, Inc. C351

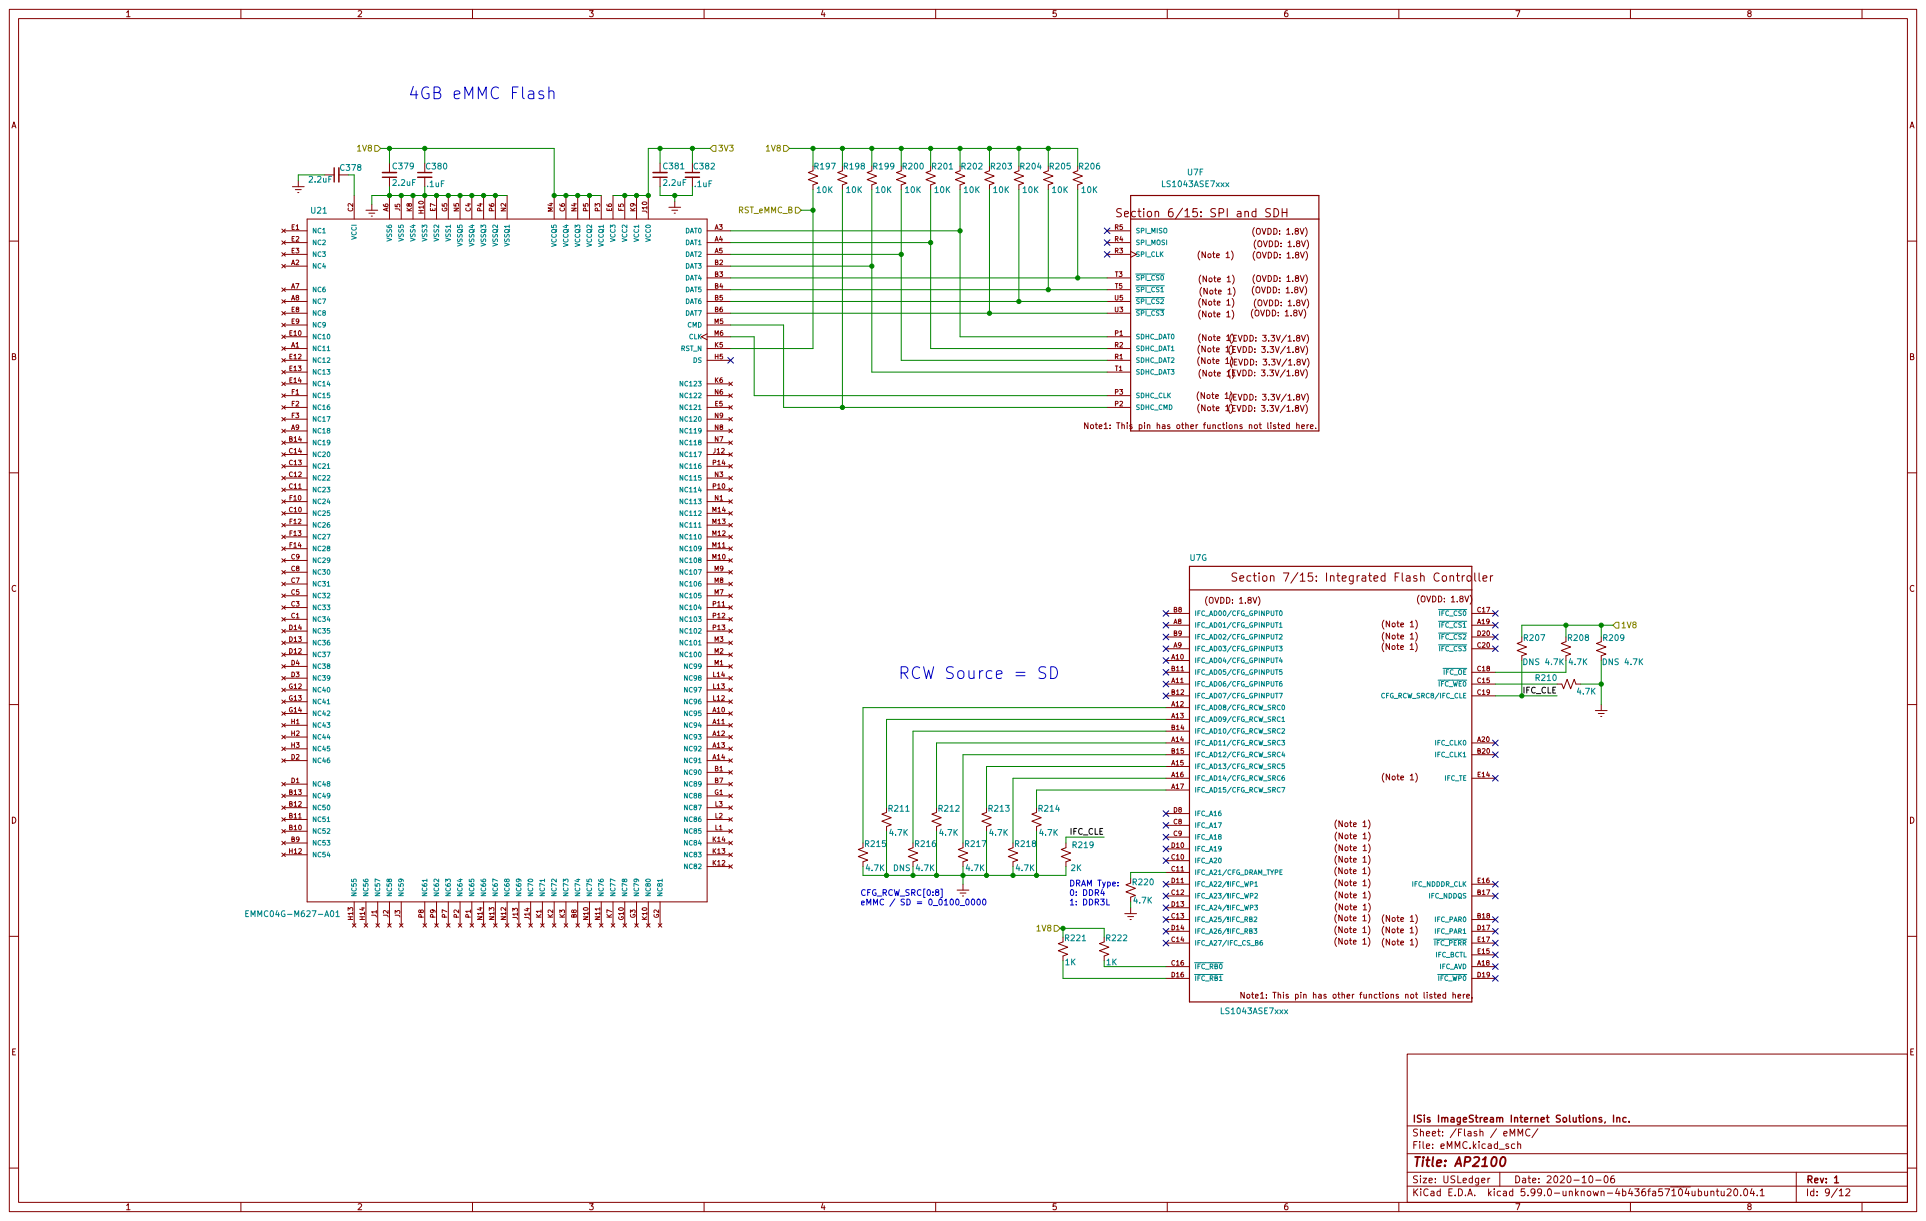
[picture p78: page 9]

Section 6/15: SPI and SDH

Note1: This pin has other functions not listed here.

Section 7/15: Integrated Flash Controller

ISis ImageStream Internet Solutions, Inc. R219

File: eMMC.kicad_sch Sheet: /Flash / eMMC/
Id: 9/12 Title: AP2100

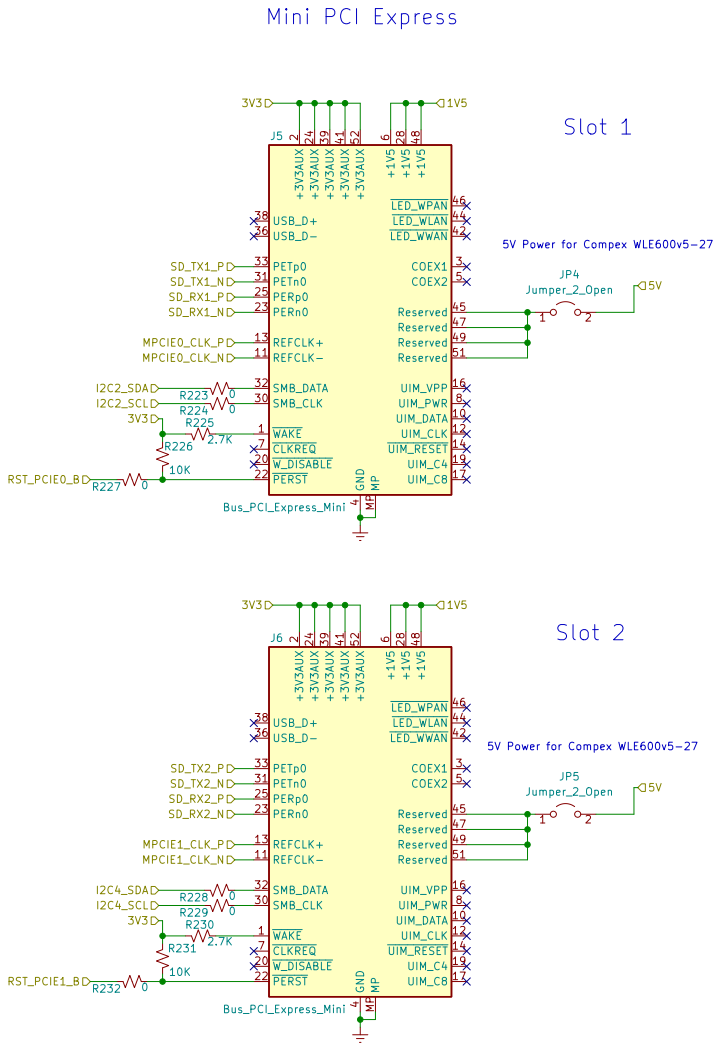
[picture p79: page 10]

File: PCIe.kicad_sch Sheet: /mPCIe/
Id: 10/12 Title: AP2100

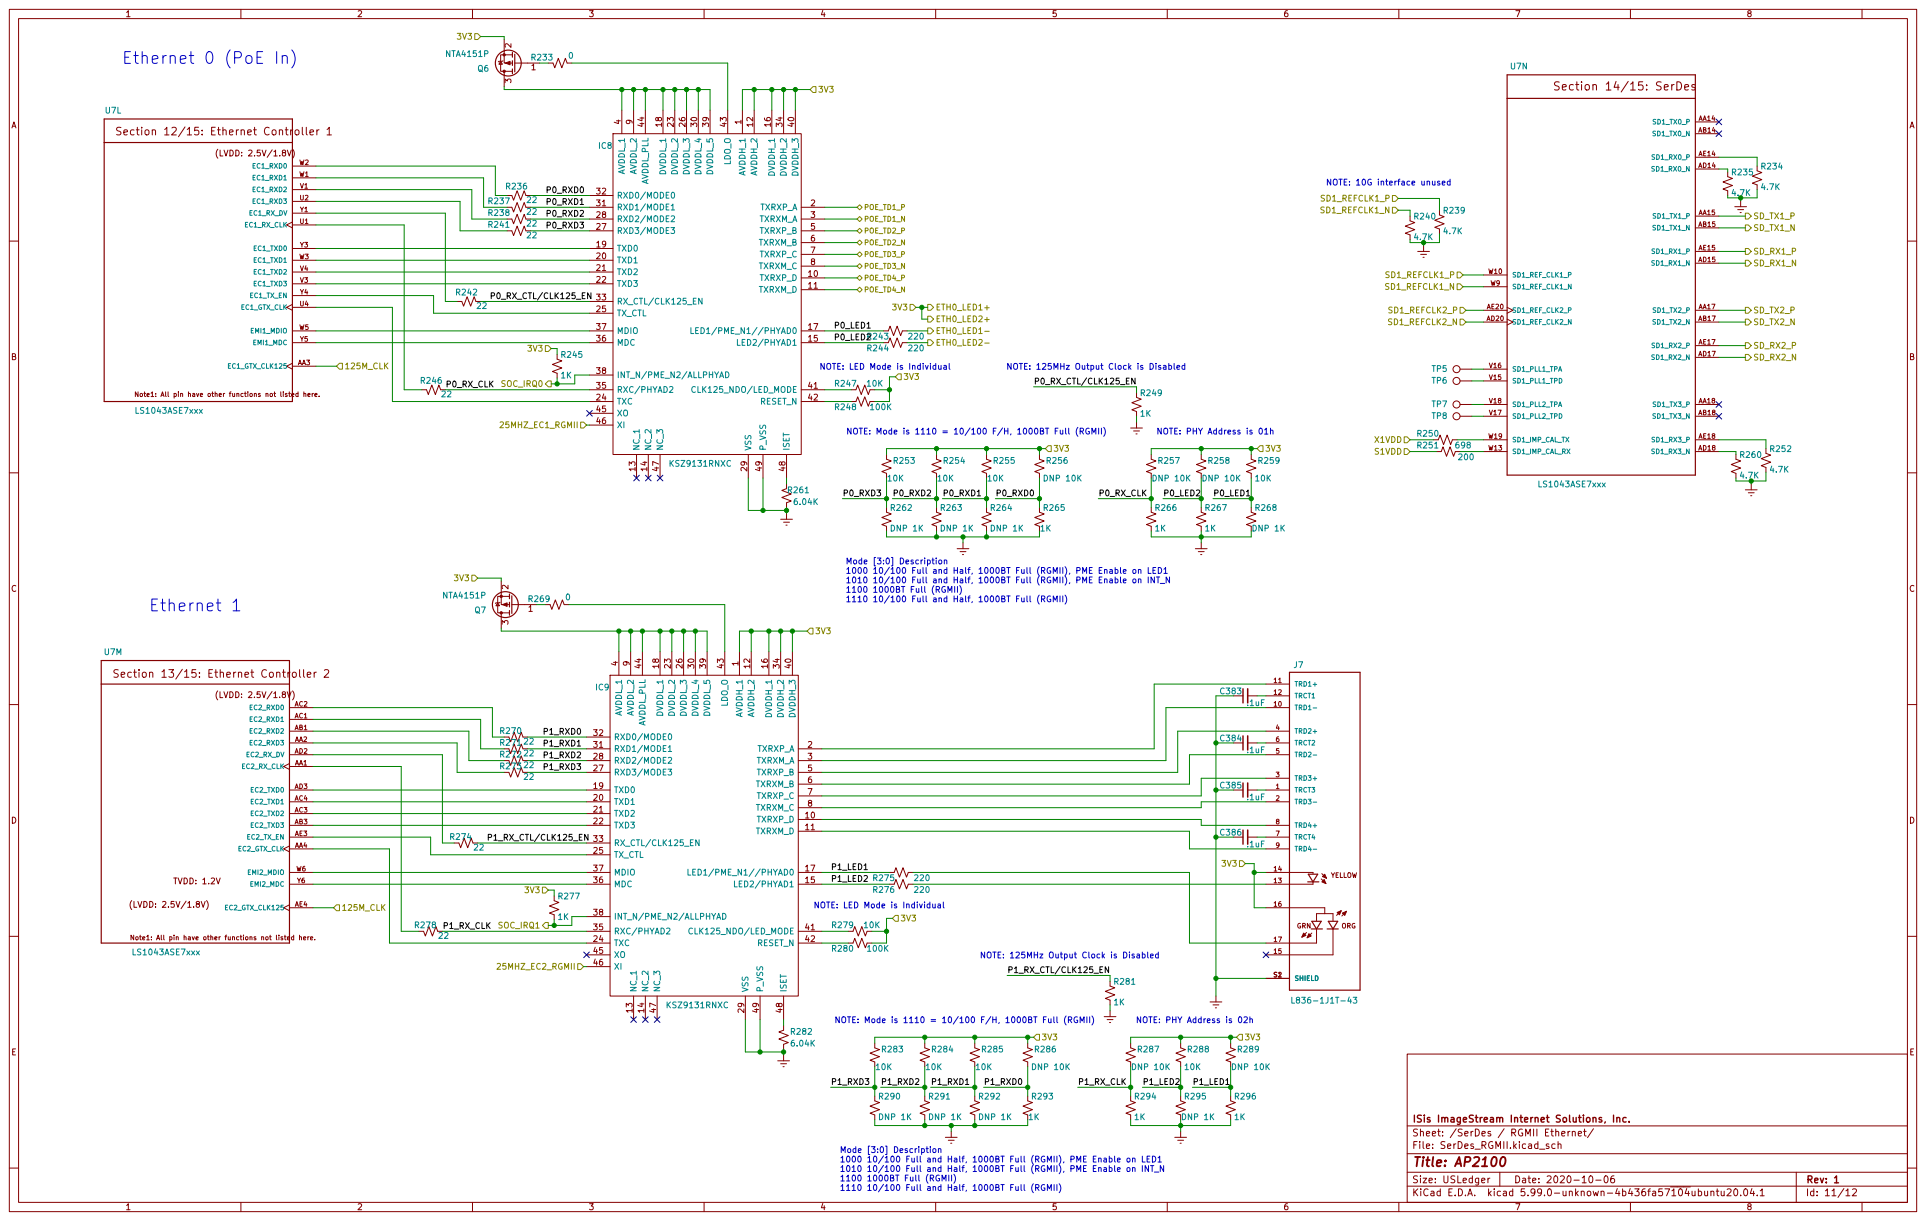
[picture p80: page 11]

(LVDD: 2.5V/1.8V) Note1: All pin have other functions not listed here. Section 12/15: Ethernet Controller 1

NOTE: LED Mode is Individual

NOTE: 125MHz Output Clock is Disabled
P0_RX_CTL/CLK125_EN

Mode [3:0] Description
1000 10/100 Full and Half, 1000BT Full (RGMII), PME Enable on LED1
1010 10/100 Full and Half, 1000BT Full (RGMII), PME Enable on INT_N
1100 1000BT Full (RGMII)
1110 10/100 Full and Half, 1000BT Full (RGMII)

(LVDD: 2.5V/1.8V) Note1: All pin have other functions not listed here. Section 13/15: Ethernet Controller 2

NOTE: Mode is 1110 = 10/100 F/H, 1000BT Full (RGMII)

ISis ImageStream Internet Solutions, Inc.
File: SerDes_RGMII.kicad_sch Sheet: /SerDes / RGMII Ethernet/
Id: 11/12 Title: AP2100

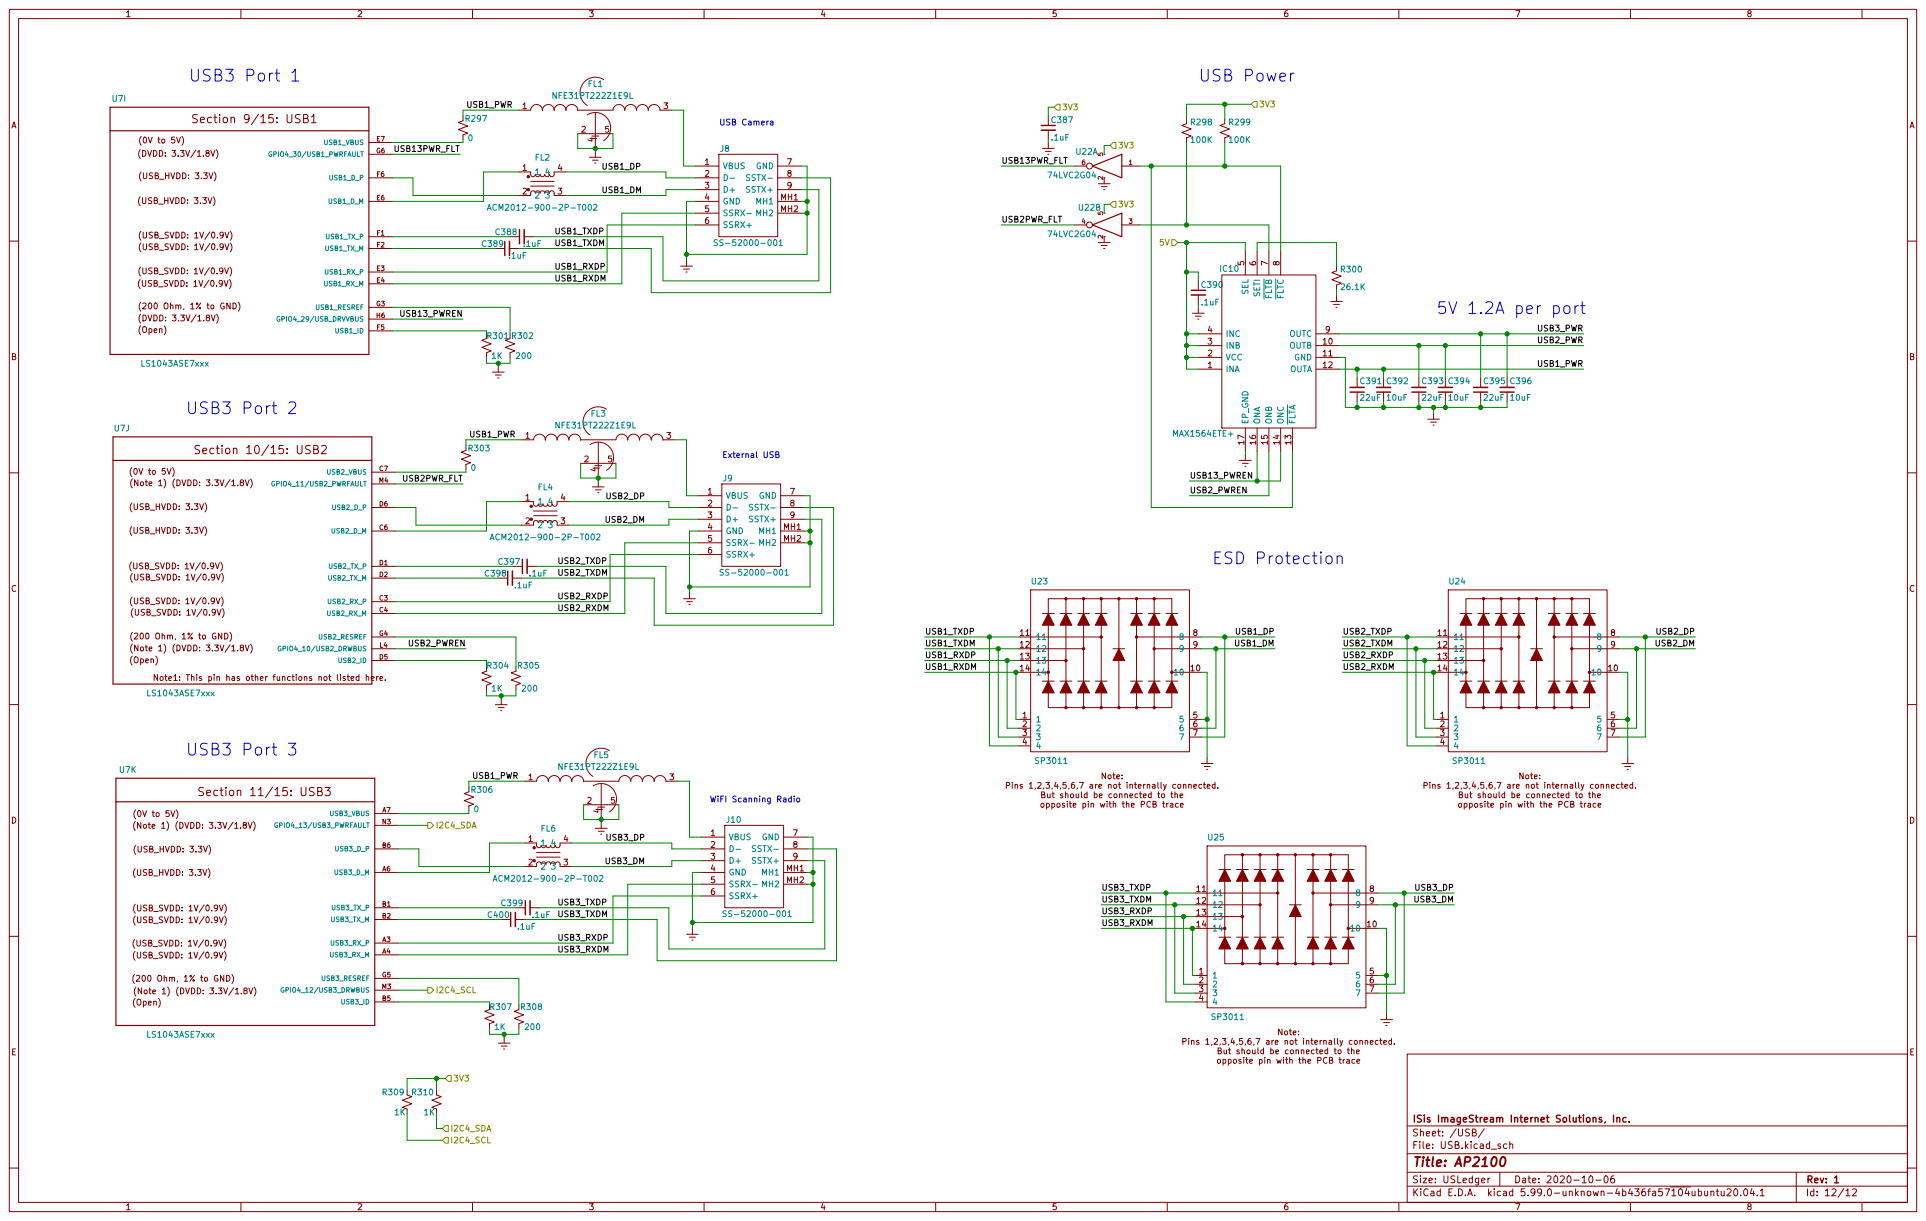
[picture p81: page 12]

Note1: This pin has other functions not listed here.

Pins 1,2,3,4,5,6,7 are not internally connected.

But should be connected to the

opposite pin with the PCB trace

11 11
12 12

ISis ImageStream Internet Solutions, Inc.
File: USB.kicad_sch Sheet: /USB/
Id: 12/12 Title: AP2100
