imagestream/kicad/CM4IO/RPI-CM4IOv5b-Gerber170920/CM4IOv5-F_Cu.pdf

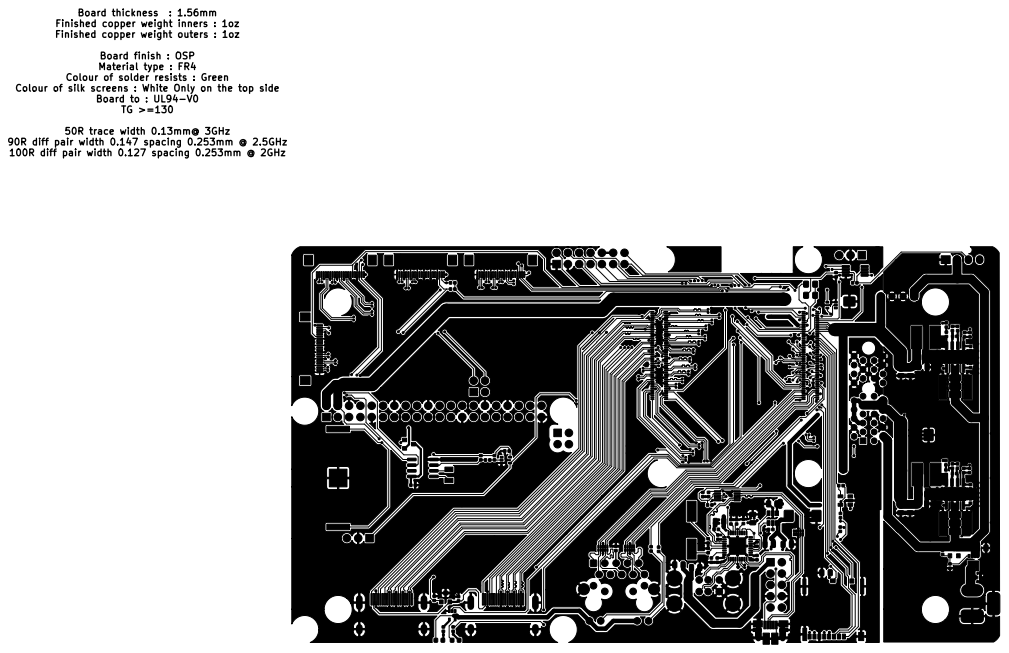
[picture p82: page 1]

Board thickness : 1.56mm
Finished copper weight inners : 1oz
Finished copper weight outers : 1oz Board finish : OSP Material type : FR4 Colour of solder resists : Green Colour of silk screens : White Only on the top side Board to : UL94-V0 TG >=130

90R diff pair width 0.147 spacing 0.253mm @ 2.5GHz
100R diff pair width 0.127 spacing 0.253mm @ 2GHz
