imagestream/kicad/CM4IO/RPI-CM4IOv5b-Gerber170920/CM4IOv5-F_Silkscreen.pdf

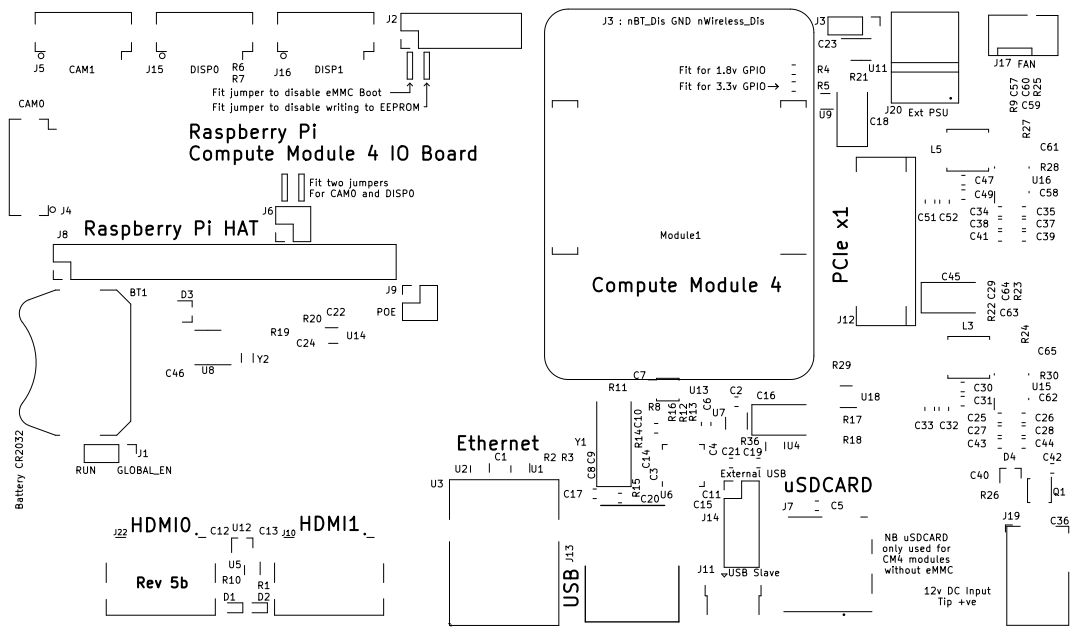
[picture p83: page 1]

Rev 5bRaspberry Pi
Compute Module 4 IO Board

Fit for 3.3v GPIO Fit jumper to disable writing to EEPROM

NB uSDCARD only used for CM4 modules without eMMC
