imagestream/kicad/AP3100/pcb.pdf

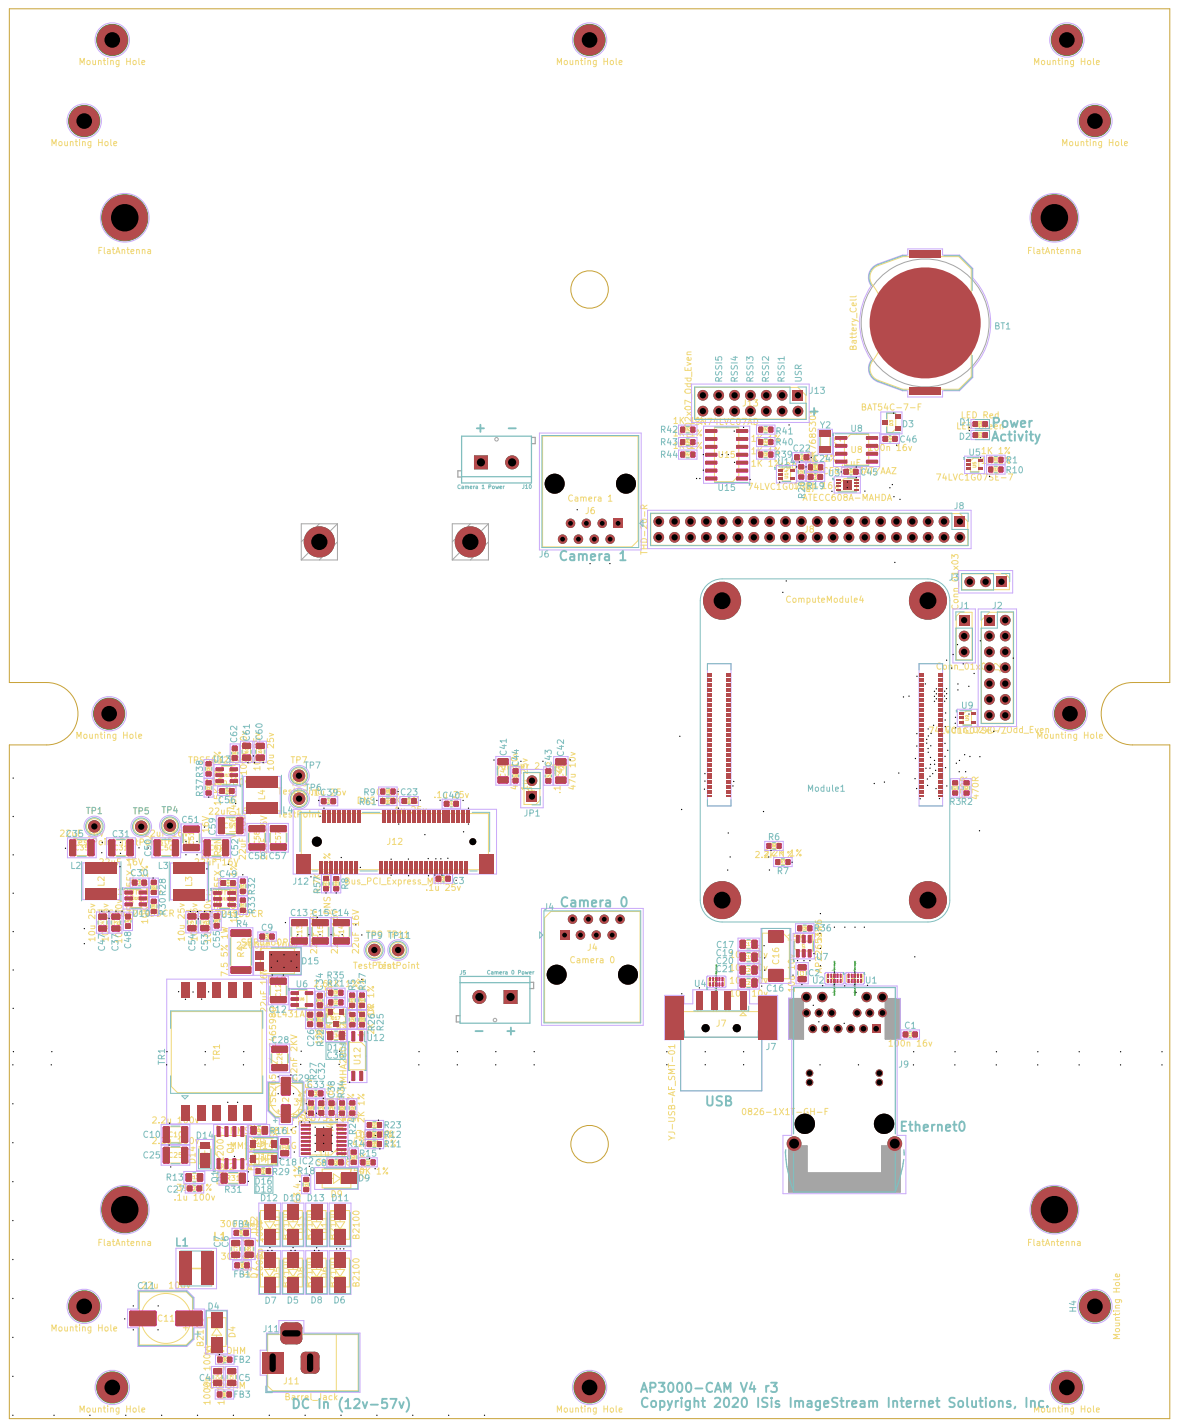
[picture p96: page 1]
