imagestream/kicad/Taylor's Water Layout/output.pdf

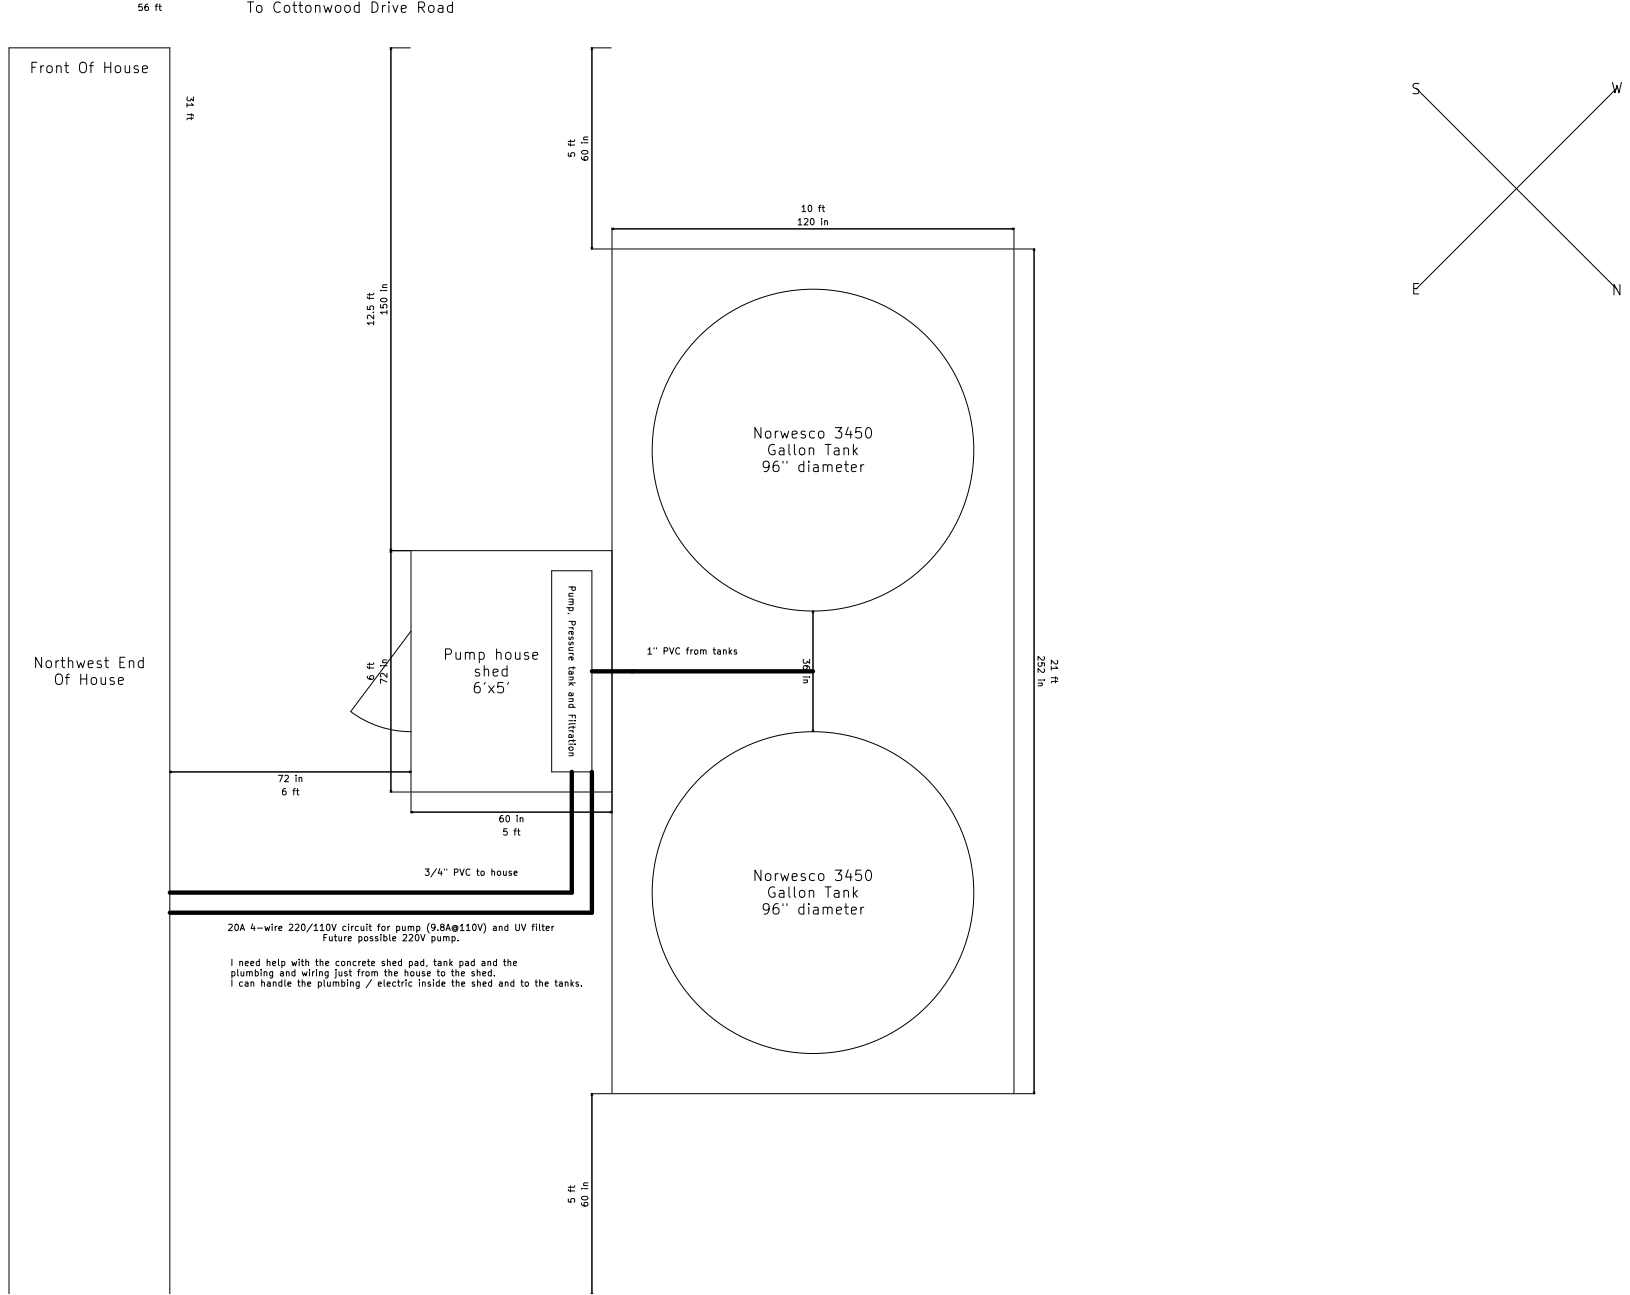
[picture p97: page 1]
