imagestream/kicad/Taylor's Water Layout/Taylor's Water Layout-F_Cu.pdf

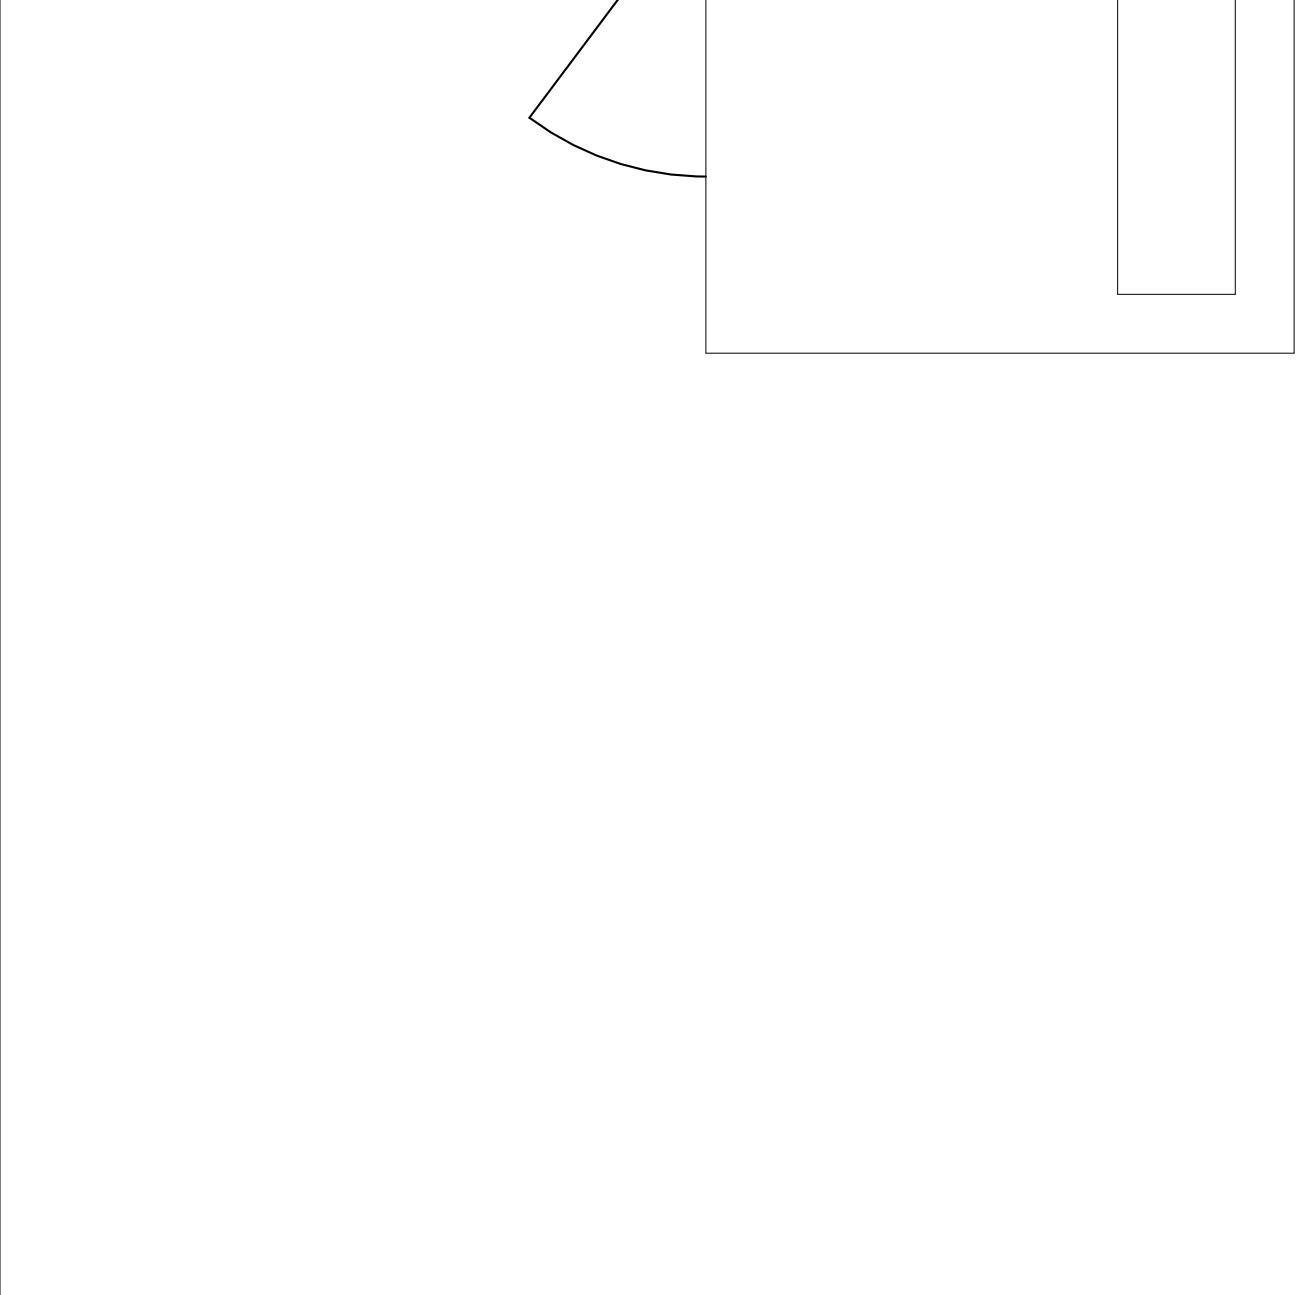
[picture p98: page 1]
