imagestream/kicad/Hydroponics/Hydroponics.pdf

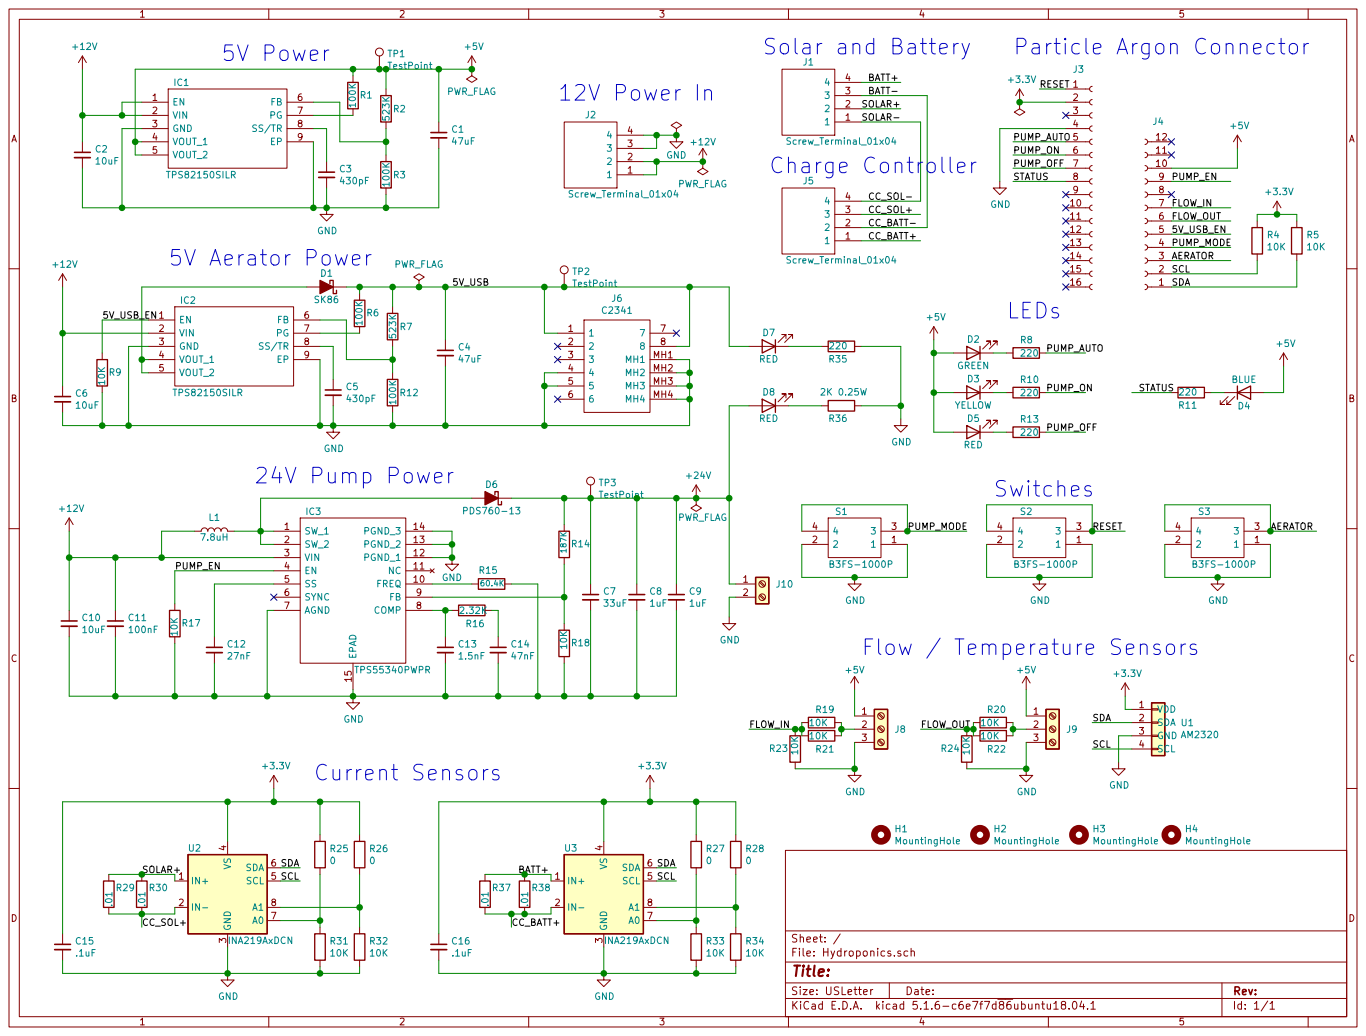
[picture p99: page 1]

File: Hydroponics.sch Sheet: /
