imagestream/kicad/CM4IO/RPI-CM4IOv5b-Gerber170920/CM4IOv5-B_Cu.pdf

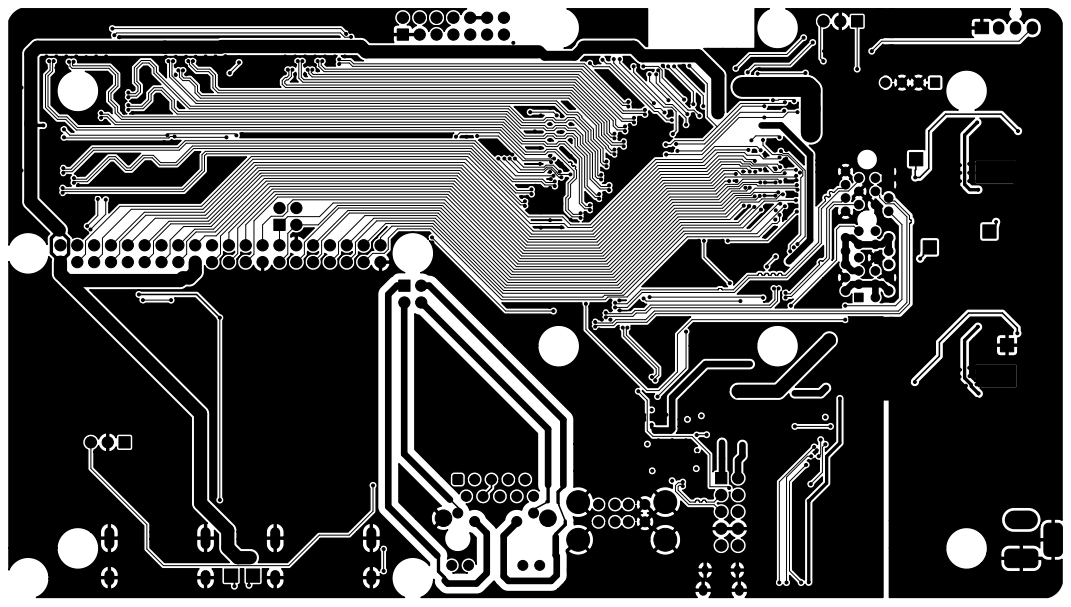
[picture p100: page 1]
