imagestream/kicad/CM4IO/RPI-CM4IOv5b-Gerber170920/CM4IOv5-B_Mask.pdf

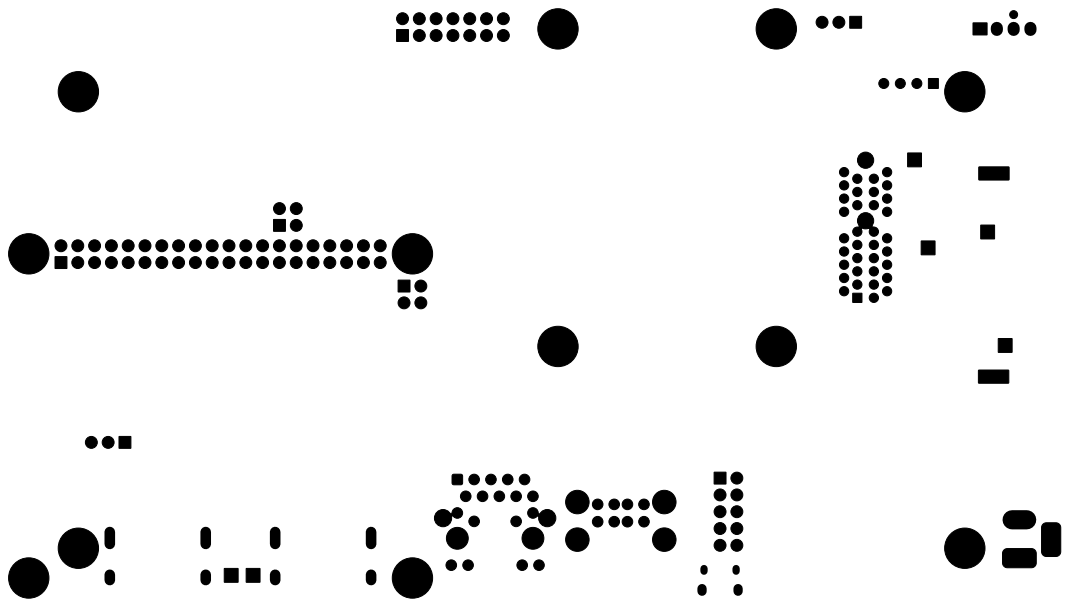
[picture p101: page 1]
