imagestream/kicad/CM4IO/RPI-CM4IOv5b-Gerber170920/CM4IOv5-Edge_Cuts.pdf

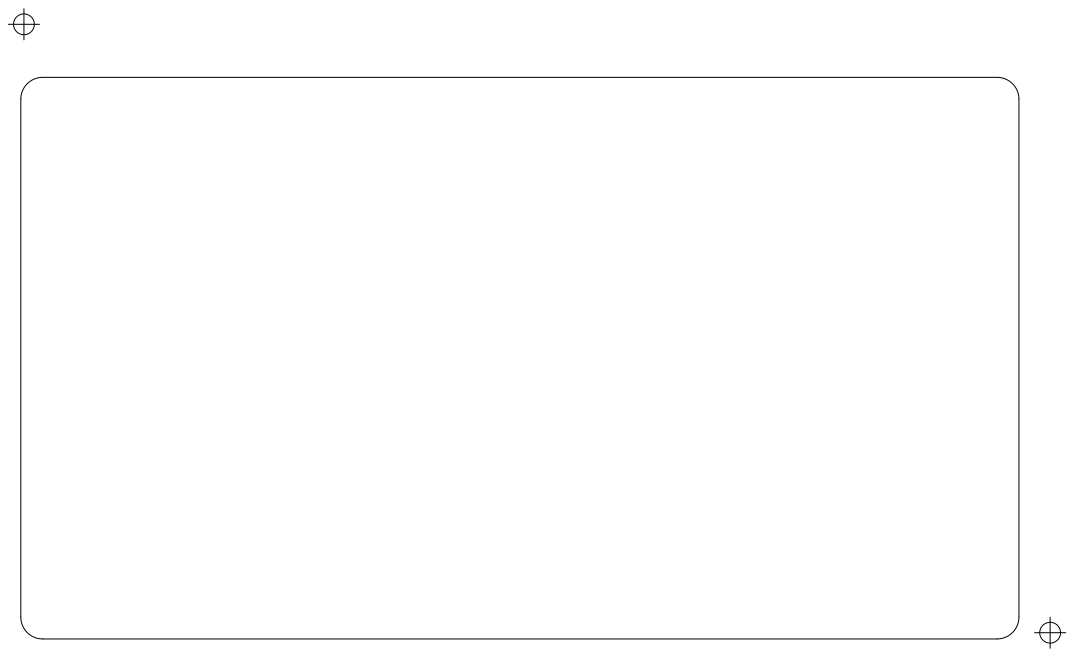
[picture p102: page 1]
