imagestream/kicad/CM4IO/RPI-CM4IOv5b-Gerber170920/CM4IOv5-F_Mask.pdf

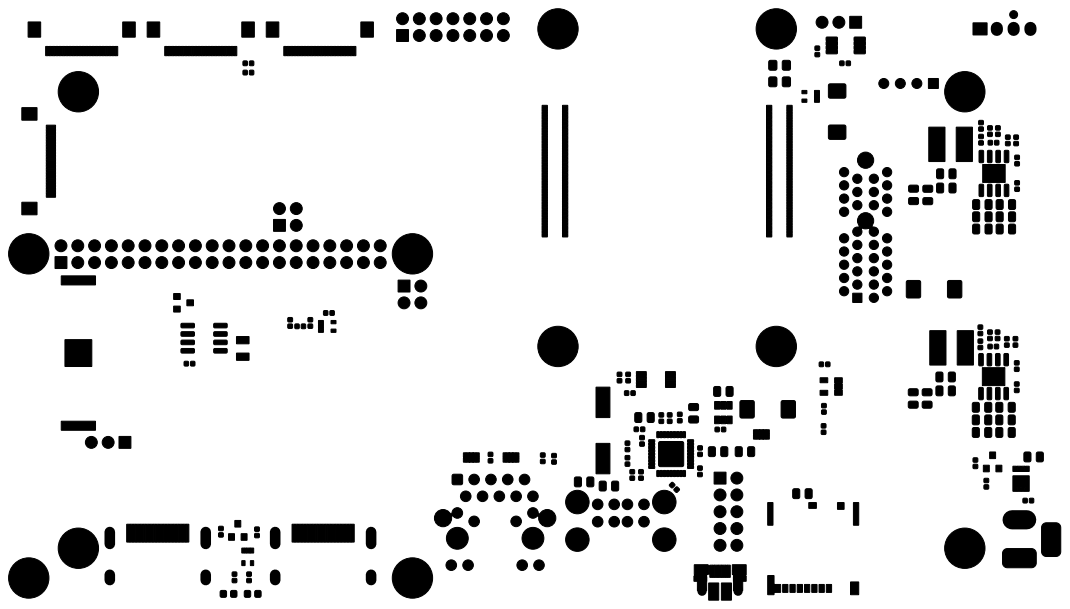
[picture p103: page 1]
