imagestream/kicad/CM4IO/RPI-CM4IOv5b-Gerber170920/CM4IOv5-F_Paste.pdf

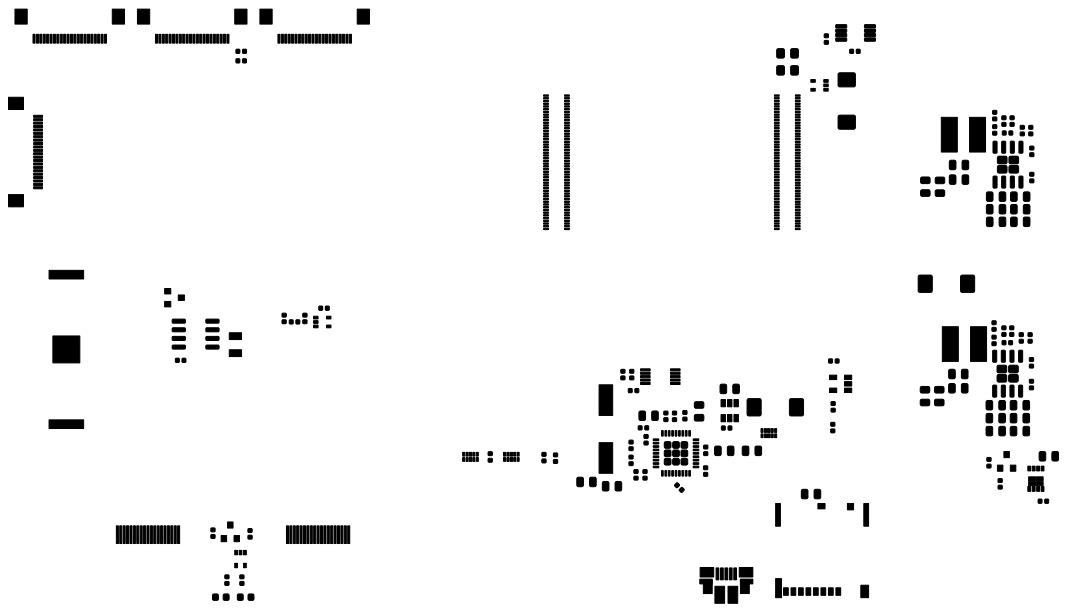
[picture p104: page 1]
