imagestream/kicad/CM4IO/RPI-CM4IOv5b-Gerber170920/CM4IOv5-In1_Cu.pdf

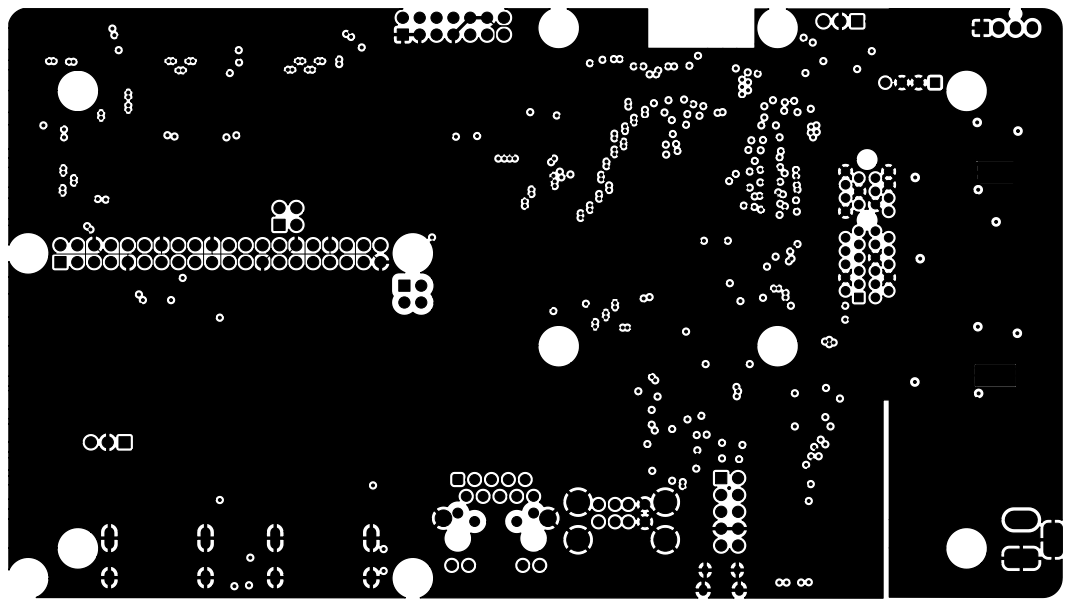
[picture p105: page 1]
