imagestream/kicad/CM4IO/RPI-CM4IOv5b-Gerber170920/CM4IOv5-In2_Cu.pdf

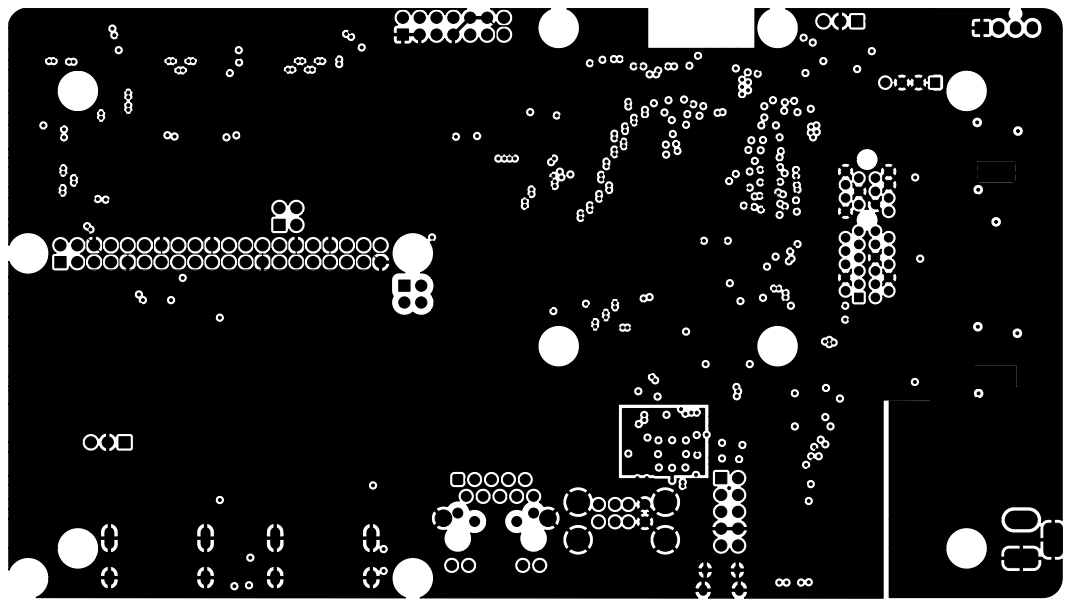
[picture p106: page 1]
