imagestream/kicad/AP2100.ls1043/docs/PCB_Enclosure Bottom_2020-07-15_19-28-57.pdf

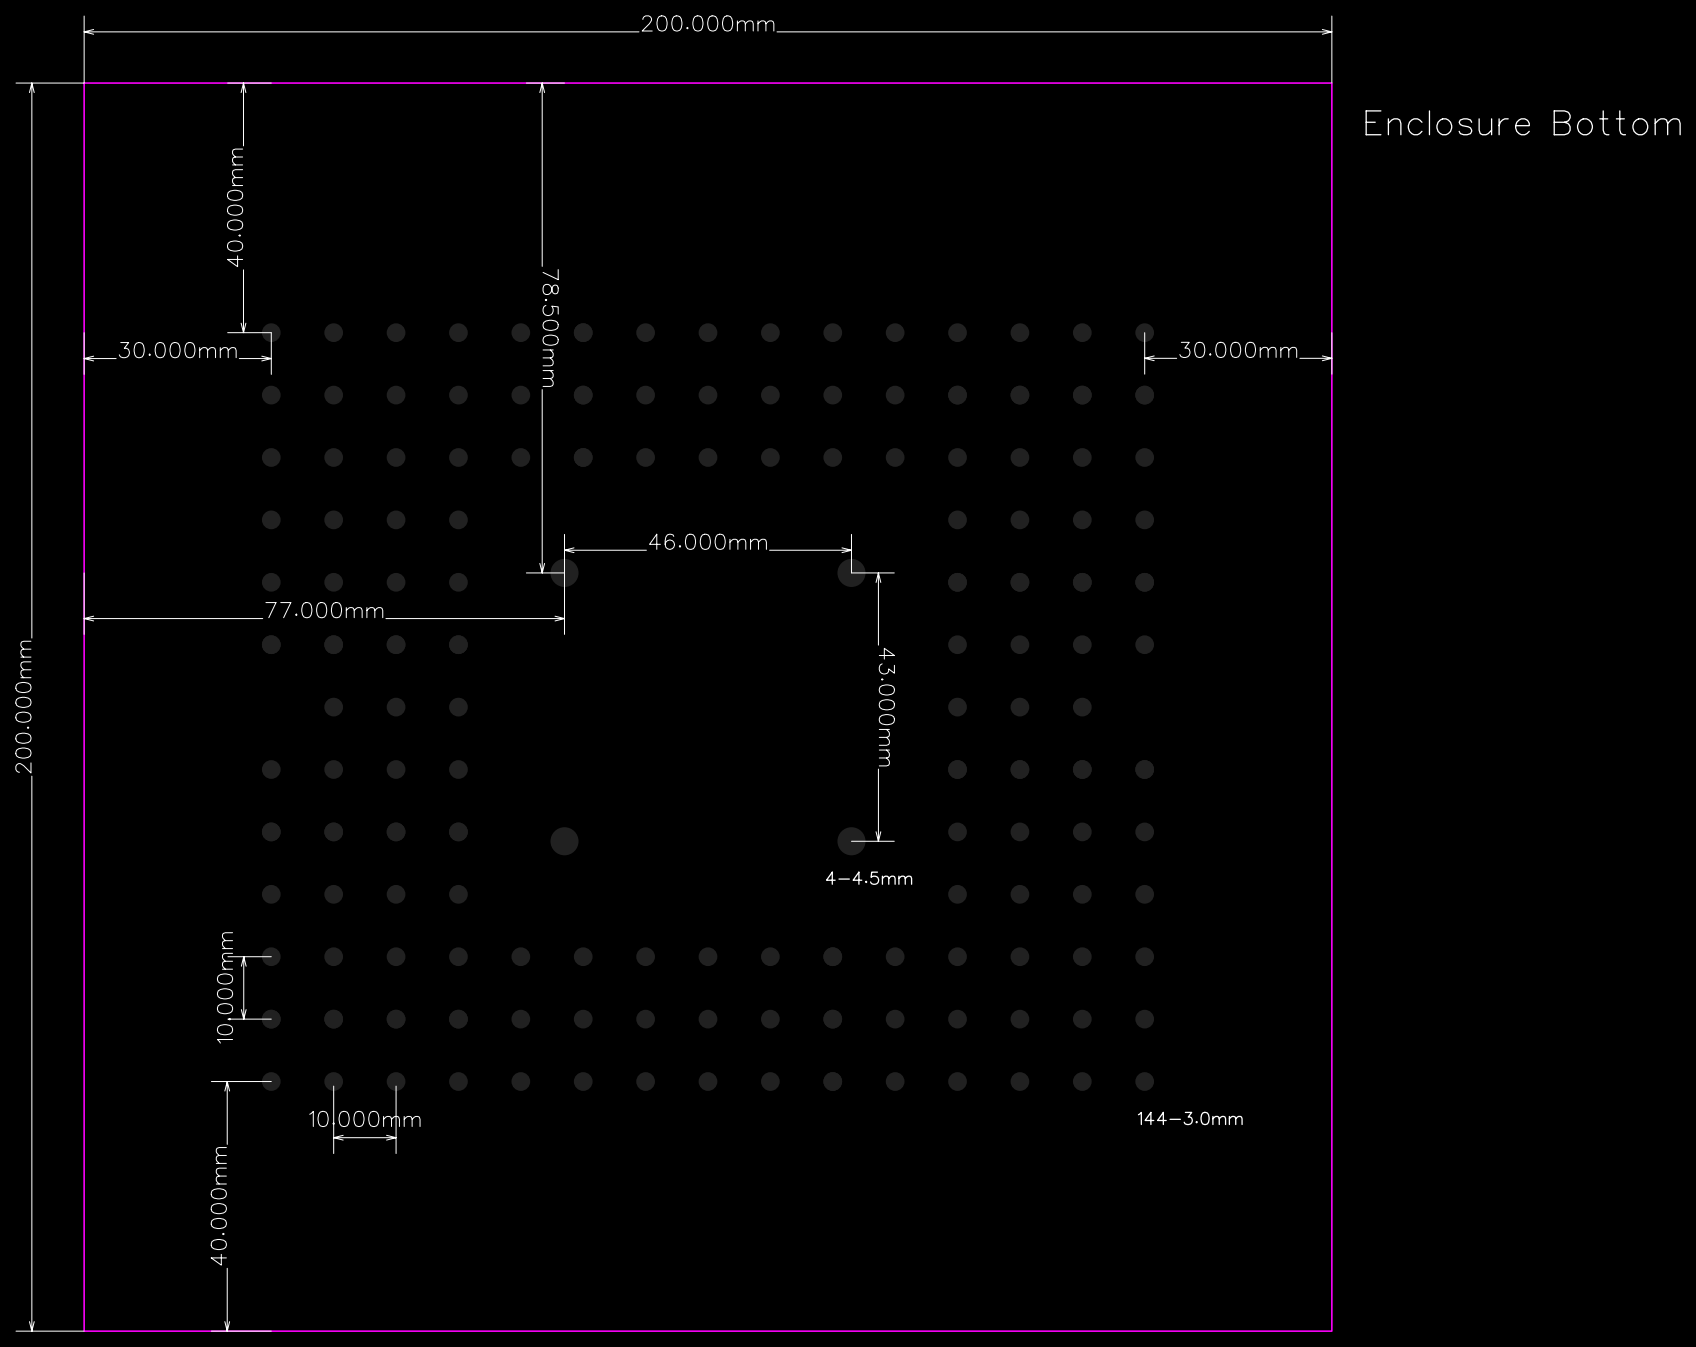
[picture p107: page 1]
