imagestream/kicad/AP2100.ls1043/docs/PCB_Enclosure top_2020-07-15_19-33-21.pdf

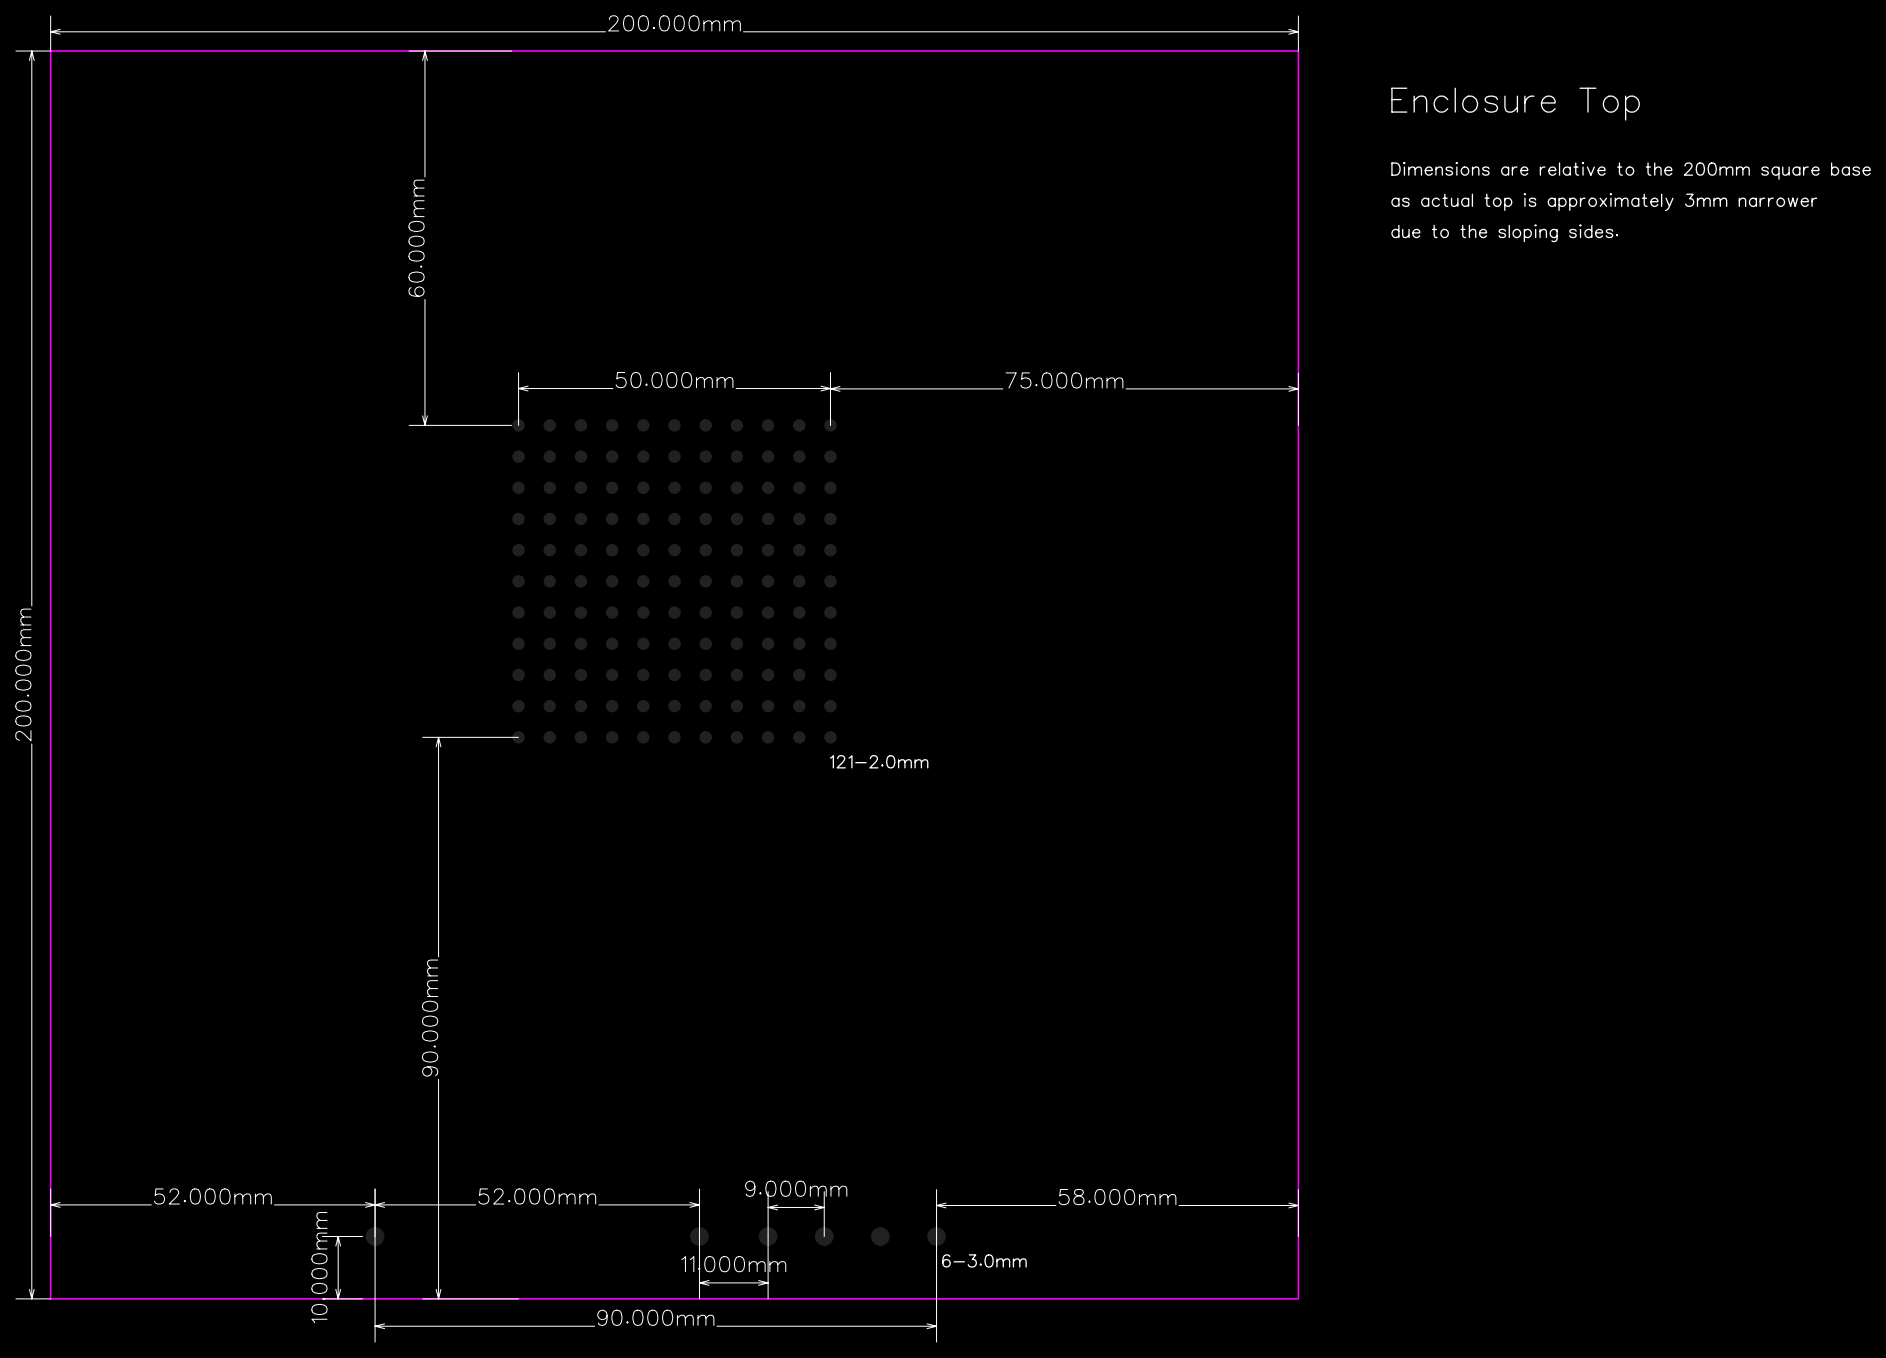
[picture p108: page 1]
