imagestream/kicad/AP2100.ls1043/docs/PCB_Front Cutout_2020-07-15_19-15-34.pdf

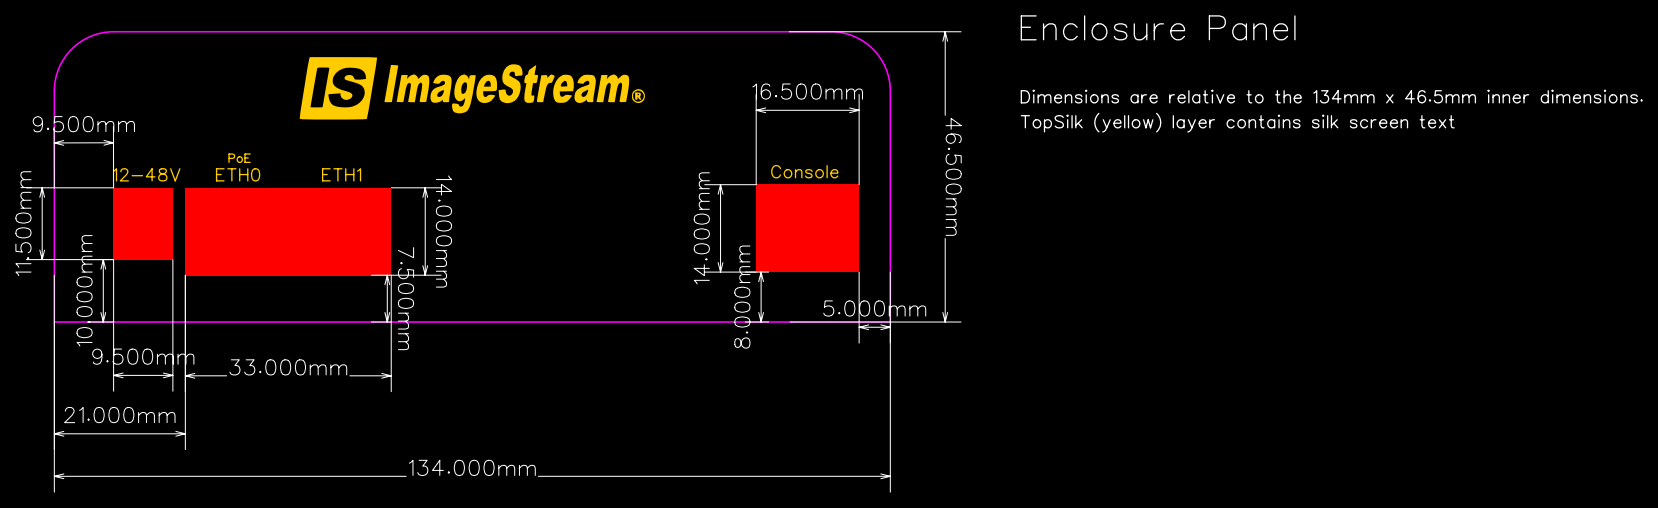
[picture p109: page 1]
