imagestream/kicad/AP2000/AP2000.kicad_pcb

## KiCad design AP2000/AP2000.kicad_pcb (2021-09-24)

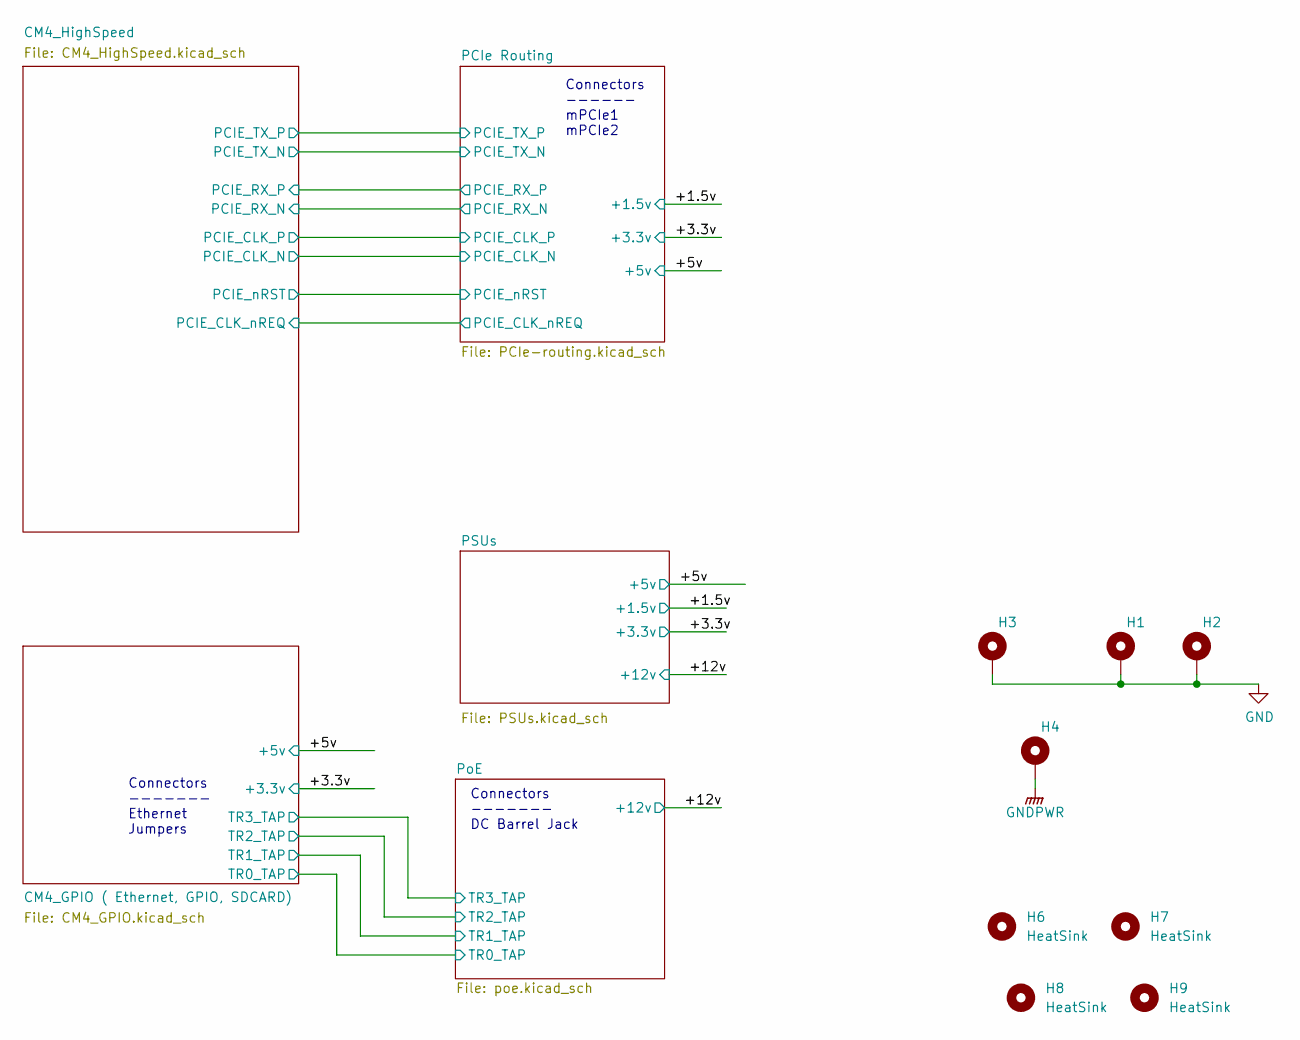
[picture p110: schematic AP2000.kicad_sch, AP3500v2]

Parts:
H1: HeatSink; MountingHole_3.7mm_Pad_TopBottom
H2, H3, H4: Mounting Hole; MountingHole_3.7mm_Pad_TopBottom
H6, H7, H8, H9: HeatSink; CM4_Mounting_Hole

Connections:
GND: H1.1, H2.1, H3.1; also elsewhere on the board
GNDPWR: H4.1; also elsewhere on the board

Notes on the sheet:
Connectors ------- Ethernet Jumpers
Connectors ------- DC Barrel Jack
Connectors ------ mPCIe1 mPCIe2

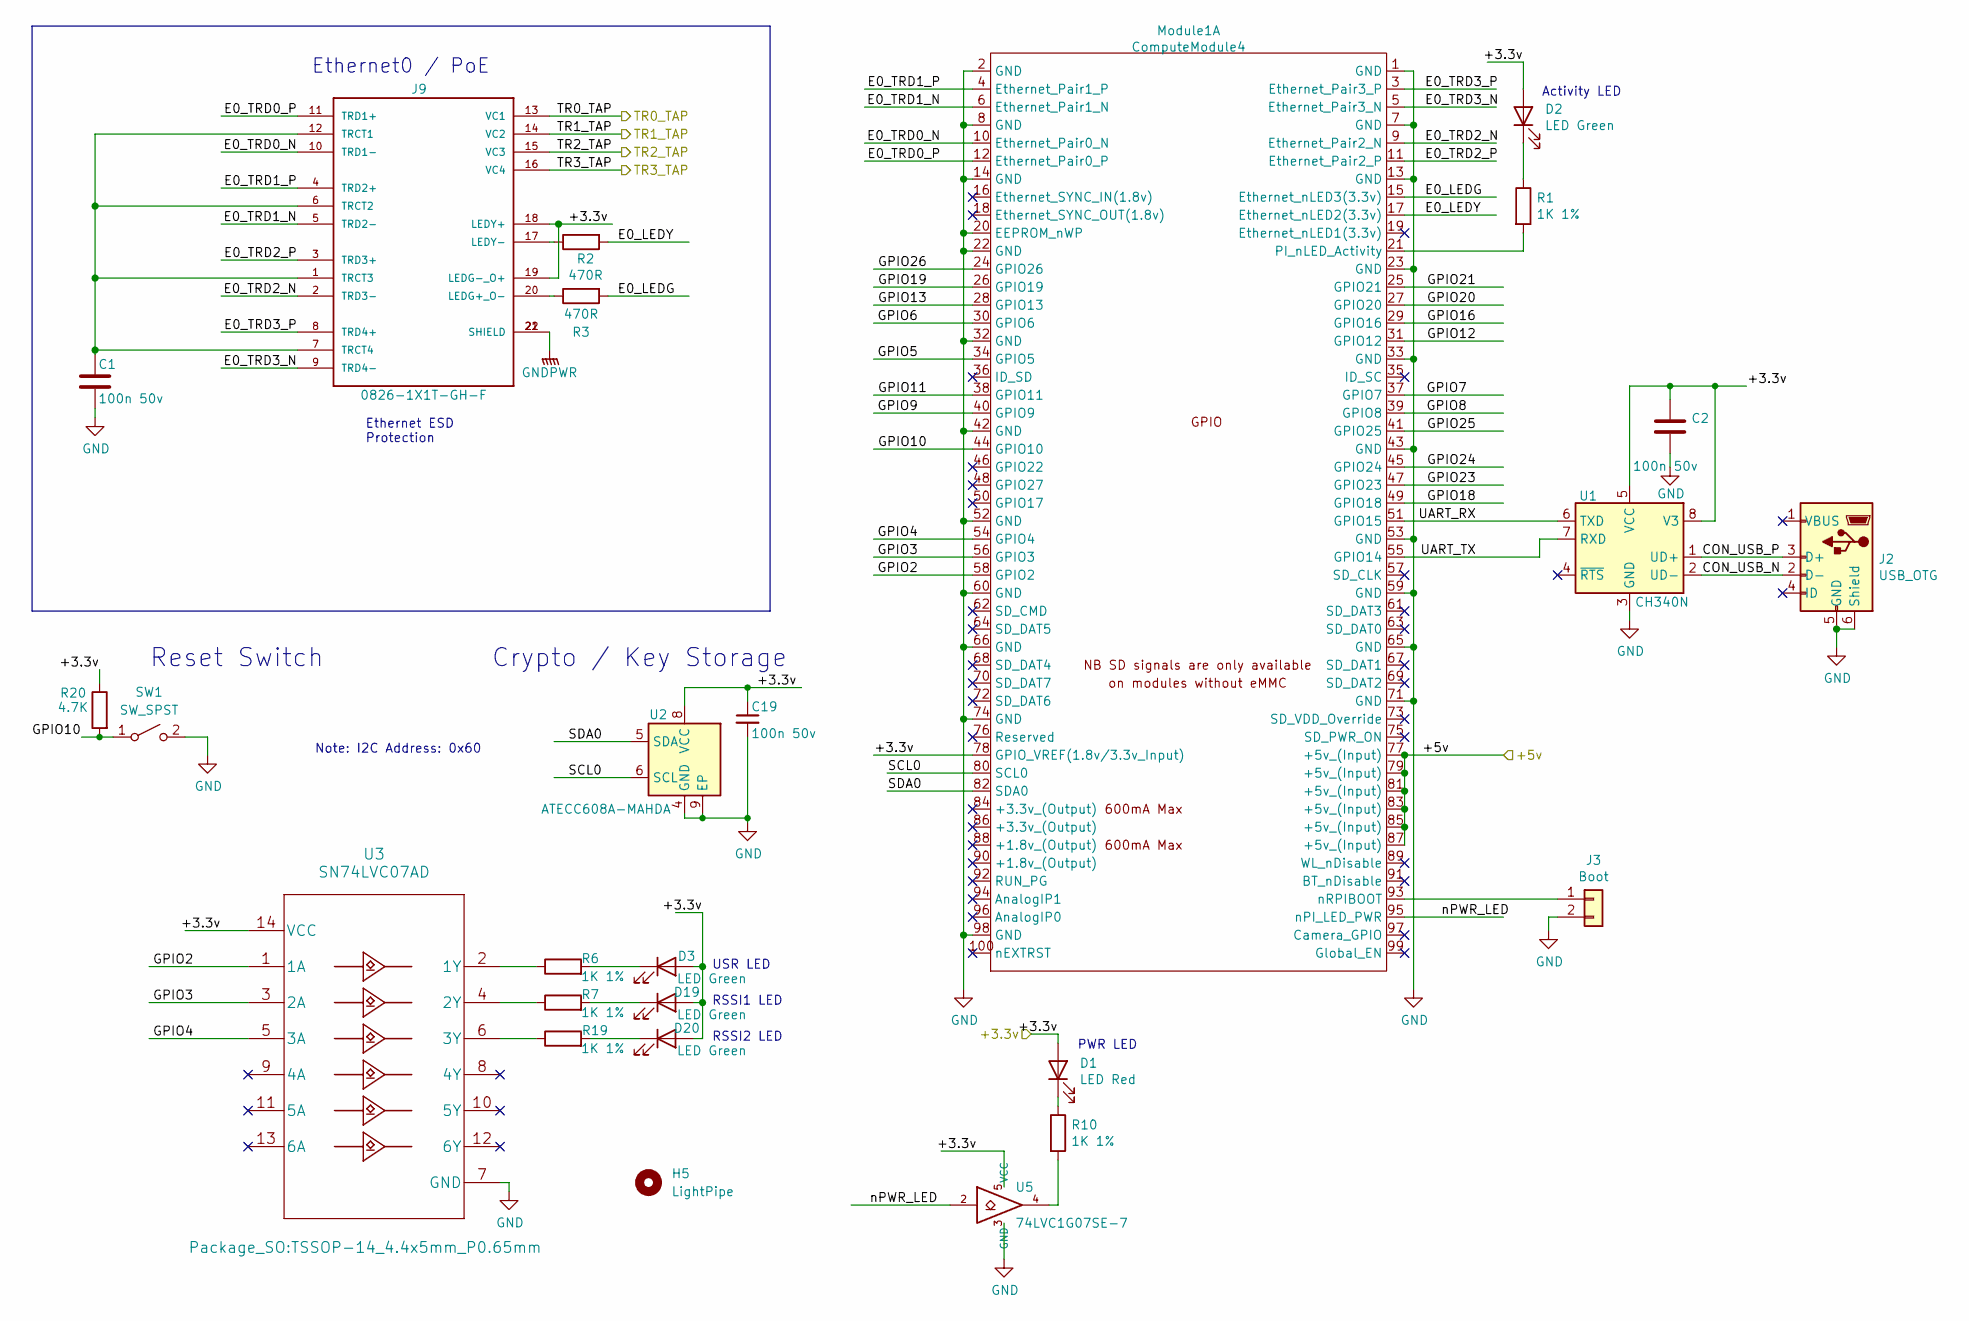
[picture p111: schematic CM4_GPIO.kicad_sch, AP3500v2]

Parts:
C1, C2: 100n 50v; C_0603_1608Metric; Part Description 100nF 10% or 20% 50V Ceramic Capacitor 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; LCSC C14663
C19: 100n 50v; C_0603_1608Metric; PartsBoxID 0603-100nF-X7R-50V; LCSC C14663
D1: LED Red; LED_0603_1608Metric; Part Description Red 620nm LED Indication - Discrete 2.2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; LCSC C2286
D2, D3, D19, D20: LED Green; LED_0603_1608Metric; Part Description Green 572nm LED Indication - Discrete 2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; LCSC C72043
H5: LightPipe; VCC_LightPipe_7511A62
J2: USB_OTG; AMPHENOL_10118194-0001LF; Part Description USB - micro B USB 2.0 Receptacle Connec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; LCSC C132563
J3: Boot; PinHeader_1x02_P2.54mm_Vertical; Part Description PinHeader_2x07_P2.54mm_Vertical
J9: 0826-1X1T-GH-F; BEL_0826-1X1T-GH-F; PartsBoxID 0826-1X1T-GH-F
Module1: ComputeModule4; Raspberry-Pi-4-Compute-Module; Part Description 100 Position Connector Receptacle, Cent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
R1, R6, R7, R10, R19: 1K 1%; R_0603_1608Metric; Part Description Resistor 1K M1005 1% 63mW; LCSC C21190
R2, R3: 470R; R_0603_1608Metric; Part Description Resistor 470R M1005 1% 63mW; LCSC C23179
R20: 4.7K; R_0603_1608Metric; PartsBoxID 0603-4.7K-1%; LCSC C23162
SW1: SW_SPST; SWITCH TACTILE SPST-NO 0.05A 12V; PartsBox PTS645VK582LFS
U1: CH340N; SOP-8_5.28x5.23mm_P1.27mm
U2: ATECC608A-MAHDA; DFN-8-1EP_3x2mm_P0.5mm_EP1.3x1.5mm; PartsBoxID ATECC608A-MAHDA-T
U3: SN74LVC07AD; TSSOP-14_4.4x5mm_P0.65mm; PartsBoxID SN74LVC07AD; LCSC C7809
U5: 74LVC1G07SE-7; SOT-23-5; Part Description Buffer, Non-Inverting 1 Element 1 Bit p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; LCSC C7829

Connections:
/+3.3v: C2.1, C19.1, D1.2 (A), D2.2 (A), D3.2 (A), D19.2 (A), D20.2 (A), J9.18 (LEDY+), J9.19 (LEDG-_O+), Module1.78 (GPIO_VREF(1.8v/3.3v_Input)), R20.1, U1.5 (VCC), U1.8 (V3), U2.8 (VCC), U3.14 (VCC), U5.5 (VCC); also elsewhere on the board
/+5v: Module1.77 (+5v_(Input)), Module1.79 (+5v_(Input)), Module1.81 (+5v_(Input)), Module1.83 (+5v_(Input)), Module1.85 (+5v_(Input)), Module1.87 (+5v_(Input)); also elsewhere on the board
/CM4_GPIO ( Ethernet, GPIO, SDCARD)/CON_USB_N: J2.2 (D-), U1.2 (UD-)
/CM4_GPIO ( Ethernet, GPIO, SDCARD)/CON_USB_P: J2.3 (D+), U1.1 (UD+)
/CM4_GPIO ( Ethernet, GPIO, SDCARD)/E0_LEDG: Module1.15 (Ethernet_nLED3(3.3v)), R3.2
/CM4_GPIO ( Ethernet, GPIO, SDCARD)/E0_LEDY: Module1.17 (Ethernet_nLED2(3.3v)), R2.2
/CM4_GPIO ( Ethernet, GPIO, SDCARD)/E0_TRD0_N: J9.10 (TRD1-), Module1.10 (Ethernet_Pair0_N)
/CM4_GPIO ( Ethernet, GPIO, SDCARD)/E0_TRD0_P: J9.11 (TRD1+), Module1.12 (Ethernet_Pair0_P)
/CM4_GPIO ( Ethernet, GPIO, SDCARD)/E0_TRD1_N: J9.5 (TRD2-), Module1.6 (Ethernet_Pair1_N)
/CM4_GPIO ( Ethernet, GPIO, SDCARD)/E0_TRD1_P: J9.4 (TRD2+), Module1.4 (Ethernet_Pair1_P)
/CM4_GPIO ( Ethernet, GPIO, SDCARD)/E0_TRD2_N: J9.2 (TRD3-), Module1.9 (Ethernet_Pair2_N)
/CM4_GPIO ( Ethernet, GPIO, SDCARD)/E0_TRD2_P: J9.3 (TRD3+), Module1.11 (Ethernet_Pair2_P)
/CM4_GPIO ( Ethernet, GPIO, SDCARD)/E0_TRD3_N: J9.9 (TRD4-), Module1.5 (Ethernet_Pair3_N)
/CM4_GPIO ( Ethernet, GPIO, SDCARD)/E0_TRD3_P: J9.8 (TRD4+), Module1.3 (Ethernet_Pair3_P)
/CM4_GPIO ( Ethernet, GPIO, SDCARD)/GPIO2: Module1.58 (GPIO2), U3.1 (1A)
/CM4_GPIO ( Ethernet, GPIO, SDCARD)/GPIO3: Module1.56 (GPIO3), U3.3 (2A)
/CM4_GPIO ( Ethernet, GPIO, SDCARD)/GPIO4: Module1.54 (GPIO4), U3.5 (3A)
/CM4_GPIO ( Ethernet, GPIO, SDCARD)/GPIO5: Module1.34 (GPIO5)
/CM4_GPIO ( Ethernet, GPIO, SDCARD)/GPIO6: Module1.30 (GPIO6)
/CM4_GPIO ( Ethernet, GPIO, SDCARD)/GPIO7: Module1.37 (GPIO7)
/CM4_GPIO ( Ethernet, GPIO, SDCARD)/GPIO8: Module1.39 (GPIO8)
/CM4_GPIO ( Ethernet, GPIO, SDCARD)/GPIO9: Module1.40 (GPIO9)
/CM4_GPIO ( Ethernet, GPIO, SDCARD)/GPIO10: Module1.44 (GPIO10), R20.2, SW1.1 (A)
/CM4_GPIO ( Ethernet, GPIO, SDCARD)/GPIO11: Module1.38 (GPIO11)
/CM4_GPIO ( Ethernet, GPIO, SDCARD)/GPIO12: Module1.31 (GPIO12)
/CM4_GPIO ( Ethernet, GPIO, SDCARD)/GPIO13: Module1.28 (GPIO13)
/CM4_GPIO ( Ethernet, GPIO, SDCARD)/GPIO16: Module1.29 (GPIO16)
/CM4_GPIO ( Ethernet, GPIO, SDCARD)/GPIO18: Module1.49 (GPIO18)
/CM4_GPIO ( Ethernet, GPIO, SDCARD)/GPIO19: Module1.26 (GPIO19)
/CM4_GPIO ( Ethernet, GPIO, SDCARD)/GPIO20: Module1.27 (GPIO20)
/CM4_GPIO ( Ethernet, GPIO, SDCARD)/GPIO21: Module1.25 (GPIO21)
/CM4_GPIO ( Ethernet, GPIO, SDCARD)/GPIO23: Module1.47 (GPIO23)
/CM4_GPIO ( Ethernet, GPIO, SDCARD)/GPIO24: Module1.45 (GPIO24)
/CM4_GPIO ( Ethernet, GPIO, SDCARD)/GPIO25: Module1.41 (GPIO25)
/CM4_GPIO ( Ethernet, GPIO, SDCARD)/GPIO26: Module1.24 (GPIO26)
/CM4_GPIO ( Ethernet, GPIO, SDCARD)/SCL0: Module1.80 (SCL0), U2.6 (SCL)
/CM4_GPIO ( Ethernet, GPIO, SDCARD)/SDA0: Module1.82 (SDA0), U2.5 (SDA)
/CM4_GPIO ( Ethernet, GPIO, SDCARD)/TR0_TAP: J9.13 (VC1); also elsewhere on the board
/CM4_GPIO ( Ethernet, GPIO, SDCARD)/TR1_TAP: J9.14 (VC2); also elsewhere on the board
/CM4_GPIO ( Ethernet, GPIO, SDCARD)/TR2_TAP: J9.15 (VC3); also elsewhere on the board
/CM4_GPIO ( Ethernet, GPIO, SDCARD)/TR3_TAP: J9.16 (VC4); also elsewhere on the board
/CM4_GPIO ( Ethernet, GPIO, SDCARD)/UART_RX: Module1.51 (GPIO15), U1.6 (TXD)
/CM4_GPIO ( Ethernet, GPIO, SDCARD)/UART_TX: Module1.55 (GPIO14), U1.7 (RXD)
/CM4_GPIO ( Ethernet, GPIO, SDCARD)/nPWR_LED: Module1.95 (nPI_LED_PWR), U5.2
GND: C1.2, C2.2, C19.2, J2.5 (GND), J2.6 (Shield), J3.2, Module1.1 (GND), Module1.2 (GND), Module1.7 (GND), Module1.8 (GND), Module1.13 (GND), Module1.14 (GND), Module1.20 (EEPROM_nWP), Module1.22 (GND), Module1.23 (GND), Module1.32 (GND), Module1.33 (GND), Module1.42 (GND), Module1.43 (GND), Module1.52 (GND), Module1.53 (GND), Module1.59 (GND), Module1.60 (GND), Module1.65 (GND), Module1.66 (GND), Module1.71 (GND), Module1.74 (GND), Module1.98 (GND), SW1.2 (B), U1.3 (GND), U2.4 (GND), U2.9 (EP), U3.7 (GND), U5.3 (GND); also elsewhere on the board
GNDPWR: J9.21 (SHIELD), J9.22 (SHIELD); also elsewhere on the board
unnamed: C1.1, J9.1 (TRCT3), J9.6 (TRCT2), J9.7 (TRCT4), J9.12 (TRCT1)
unnamed: D1.1 (K), R10.1
unnamed: D2.1 (K), R1.1
unnamed: D3.1 (K), R6.2
unnamed: D19.1 (K), R7.2
unnamed: D20.1 (K), R19.2
unnamed: J3.1, Module1.93 (nRPIBOOT)
unnamed: J9.17 (LEDY-), R2.1
unnamed: J9.20 (LEDG+_O-), R3.1
unnamed: Module1.21 (PI_nLED_Activity), R1.2
unnamed: R6.1, U3.2 (1Y)
unnamed: R7.1, U3.4 (2Y)
unnamed: R10.2, U5.4
unnamed: R19.1, U3.6 (3Y)

Notes on the sheet:
Ethernet0 / PoE
Reset Switch
Ethernet ESD Protection
Note: I2C Address: 0x60
USR LED
RSSI1 LED
RSSI2 LED
Crypto / Key Storage
PWR LED
Activity LED

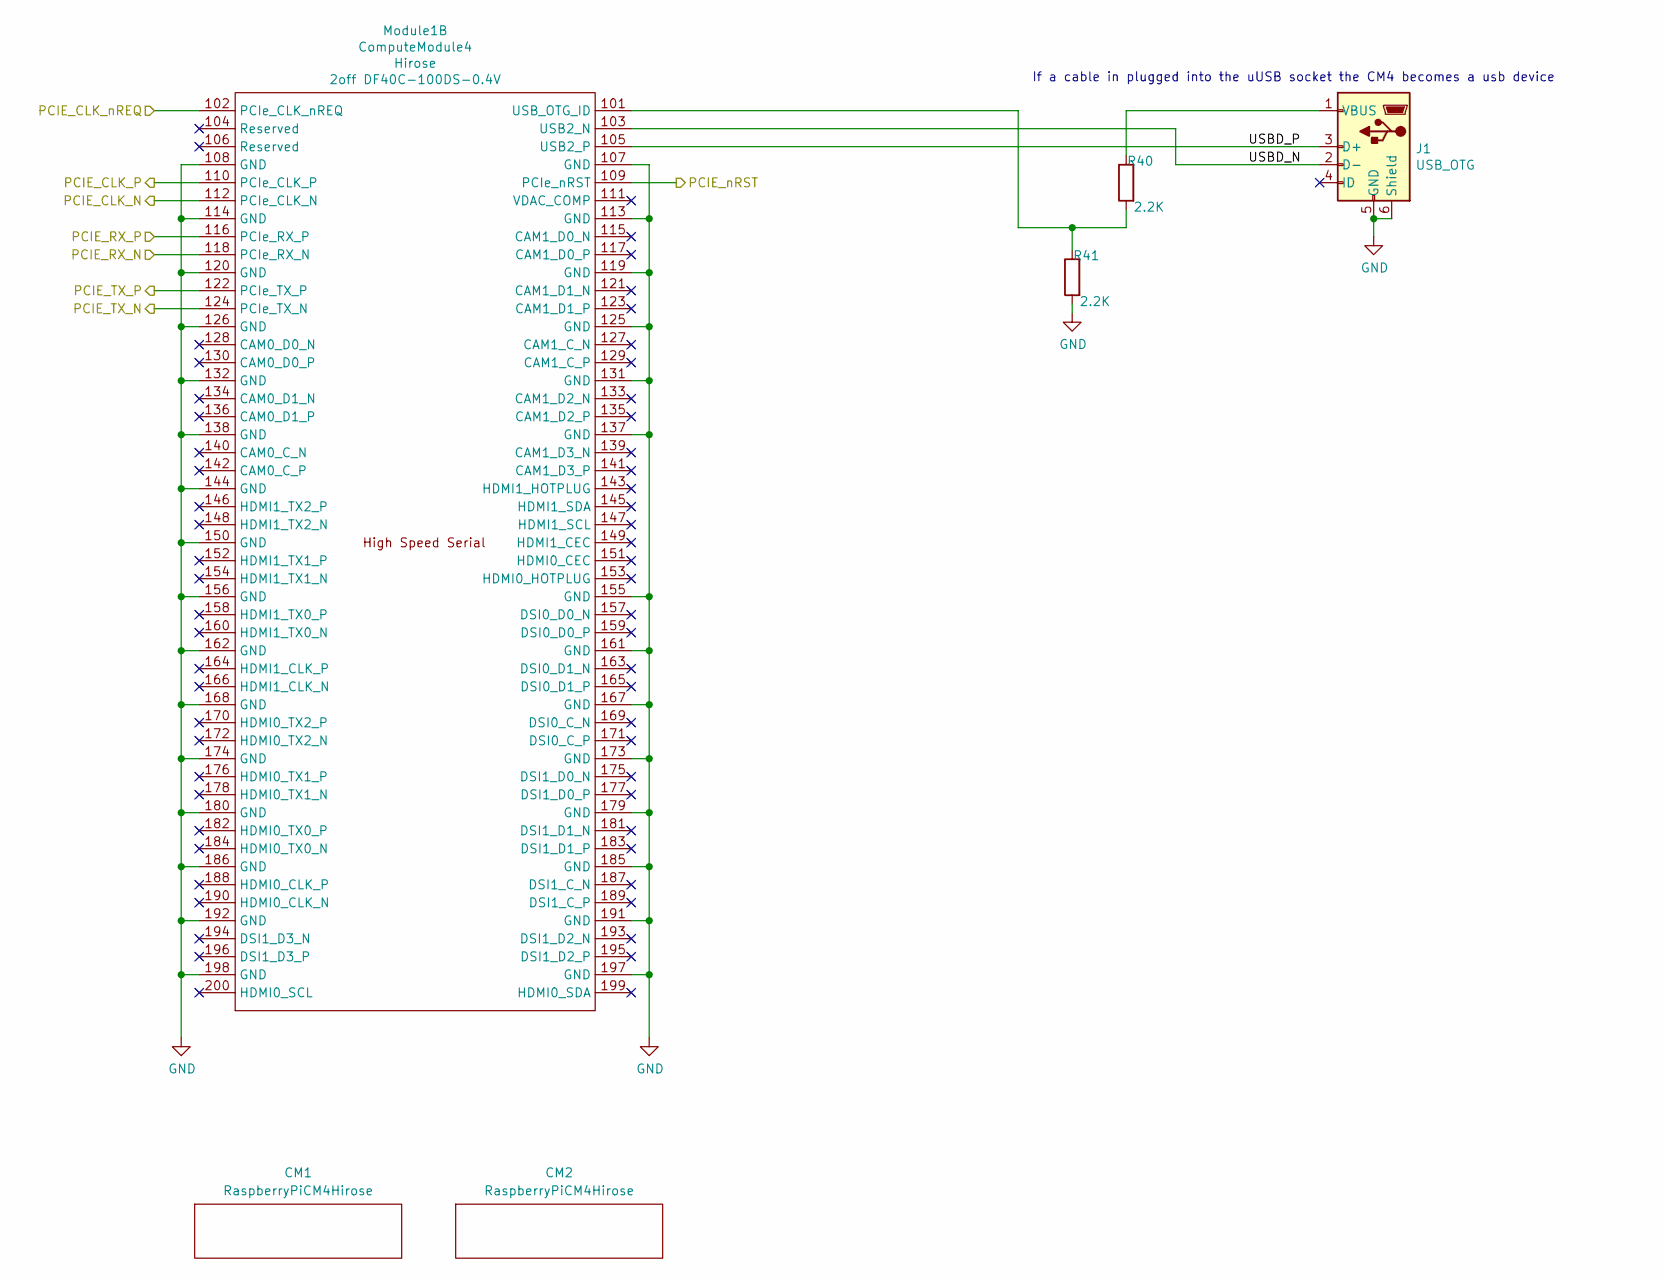
[picture p112: schematic CM4_HighSpeed.kicad_sch, AP3500v2]

Parts:
CM1, CM2: RaspberryPiCM4Hirose; Hirose-DF40C-100DS-0.4V; LCSC C424649
J1: USB_OTG; AMPHENOL_10118194-0001LF; Part Description USB - micro B USB 2.0 Receptacle Connec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; LCSC C132563
Module1: ComputeModule4; Raspberry-Pi-4-Compute-Module; Part Description 100 Position Connector Receptacle, Cent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
R40, R41: 2.2K; R_0603_1608Metric; PartsBoxID 0603-2.2K-1%; LCSC C4190

Connections:
/CM4_HighSpeed/PCIE_CLK_N: Module1.112 (PCIe_CLK_N); also elsewhere on the board
/CM4_HighSpeed/PCIE_CLK_P: Module1.110 (PCIe_CLK_P); also elsewhere on the board
/CM4_HighSpeed/PCIE_CLK_nREQ: Module1.102 (PCIe_CLK_nREQ); also elsewhere on the board
/CM4_HighSpeed/PCIE_RX_N: Module1.118 (PCIe_RX_N); also elsewhere on the board
/CM4_HighSpeed/PCIE_RX_P: Module1.116 (PCIe_RX_P); also elsewhere on the board
/CM4_HighSpeed/PCIE_TX_N: Module1.124 (PCIe_TX_N); also elsewhere on the board
/CM4_HighSpeed/PCIE_TX_P: Module1.122 (PCIe_TX_P); also elsewhere on the board
/CM4_HighSpeed/PCIE_nRST: Module1.109 (PCIe_nRST); also elsewhere on the board
/CM4_HighSpeed/USBD_N: J1.2 (D-), Module1.103 (USB2_N)
/CM4_HighSpeed/USBD_P: J1.3 (D+), Module1.105 (USB2_P)
GND: J1.5 (GND), J1.6 (Shield), Module1.107 (GND), Module1.108 (GND), Module1.113 (GND), Module1.114 (GND), Module1.119 (GND), Module1.120 (GND), Module1.125 (GND), Module1.126 (GND), Module1.131 (GND), Module1.132 (GND), Module1.137 (GND), Module1.138 (GND), Module1.144 (GND), Module1.150 (GND), Module1.155 (GND), Module1.156 (GND), Module1.161 (GND), Module1.162 (GND), Module1.167 (GND), Module1.168 (GND), Module1.173 (GND), Module1.174 (GND), Module1.179 (GND), Module1.180 (GND), Module1.185 (GND), Module1.186 (GND), Module1.191 (GND), Module1.192 (GND), Module1.197 (GND), Module1.198 (GND), R41.2; also elsewhere on the board
unnamed: J1.1 (VBUS), R40.1
unnamed: Module1.101 (USB_OTG_ID), R40.2, R41.1

Notes on the sheet:
If a cable in plugged into the uUSB socket the CM4 becomes a usb device

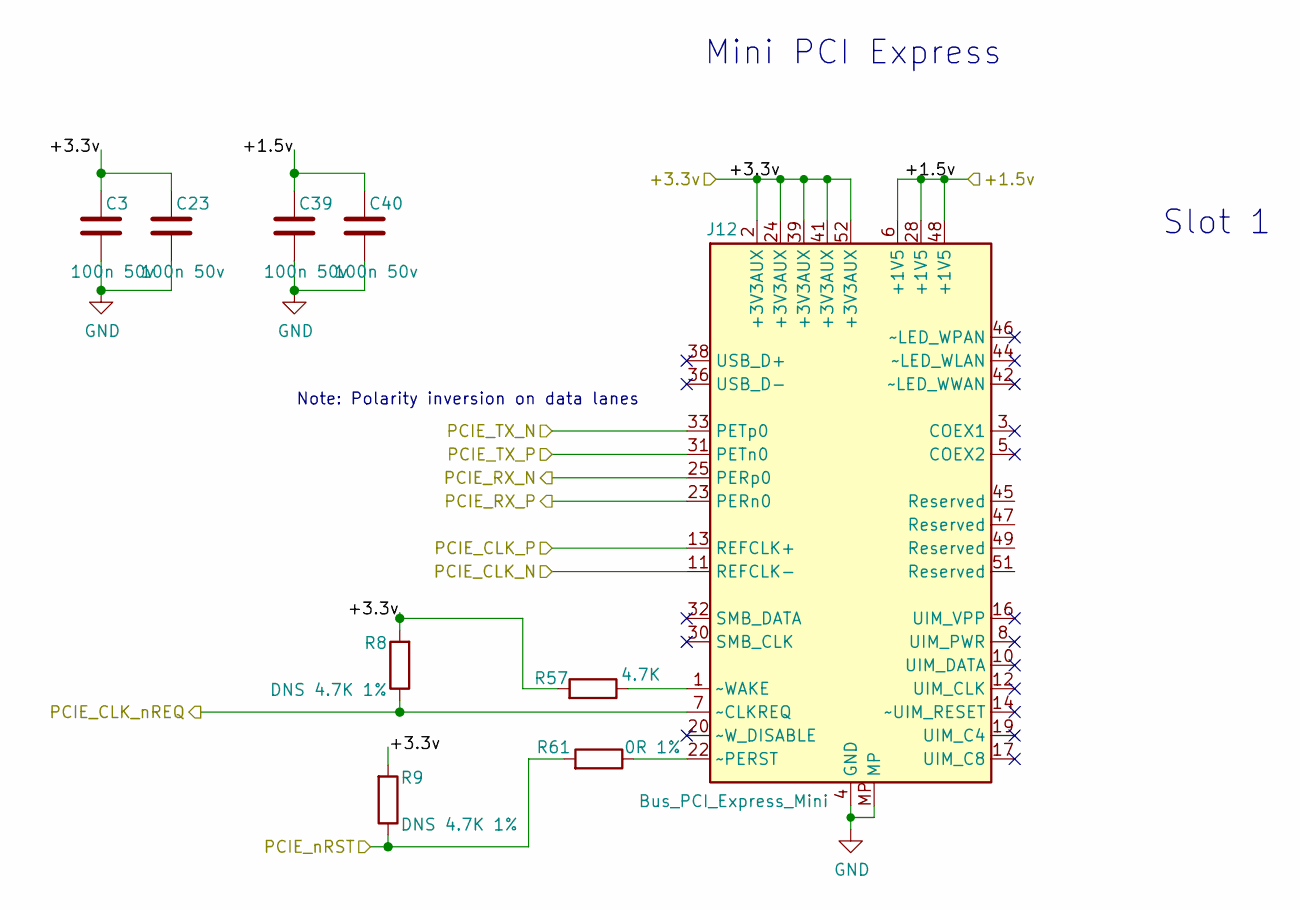
[picture p113: schematic PCIe-routing.kicad_sch, AP3500v2]

Parts:
C3, C23, C39, C40: 100n 50v; C_0603_1608Metric; Part Description .1uF 10% or 20% 25V Ceramic Capacitor X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; LCSC C14663
J12: Bus_PCI_Express_Mini; BUS_PCI_Express_Mini_Full; PartsBoxID 1775838-2; LCSC C404121
R8, R9: DNS 4.7K 1%; R_0603_1608Metric; PartsBoxID 0603-4.7K-1%
R57: 4.7K; R_0603_1608Metric; PartsBoxID 0603-4.7K-1%; LCSC C23162
R61: 0R 1%; R_0603_1608Metric; LCSC C21189

Connections:
/+1.5v: C39.1, C40.1, J12.6 (+1V5), J12.28 (+1V5), J12.48 (+1V5); also elsewhere on the board
/+3.3v: C3.1, C23.1, J12.2 (+3V3AUX), J12.24 (+3V3AUX), J12.39 (+3V3AUX), J12.41 (+3V3AUX), J12.52 (+3V3AUX), R8.2, R9.2, R57.2; also elsewhere on the board
/CM4_HighSpeed/PCIE_CLK_N: J12.11 (REFCLK-); also elsewhere on the board
/CM4_HighSpeed/PCIE_CLK_P: J12.13 (REFCLK+); also elsewhere on the board
/CM4_HighSpeed/PCIE_CLK_nREQ: J12.7 (~CLKREQ), R8.1; also elsewhere on the board
/CM4_HighSpeed/PCIE_RX_N: J12.25 (PERp0); also elsewhere on the board
/CM4_HighSpeed/PCIE_RX_P: J12.23 (PERn0); also elsewhere on the board
/CM4_HighSpeed/PCIE_TX_N: J12.33 (PETp0); also elsewhere on the board
/CM4_HighSpeed/PCIE_TX_P: J12.31 (PETn0); also elsewhere on the board
/CM4_HighSpeed/PCIE_nRST: R9.1, R61.2; also elsewhere on the board
GND: C3.2, C23.2, C39.2, C40.2, J12.4 (GND), J12.9 (GND), J12.15 (GND), J12.18 (GND), J12.21 (GND), J12.26 (GND), J12.27 (GND), J12.29 (GND), J12.34 (GND), J12.35 (GND), J12.37 (GND), J12.40 (GND), J12.43 (GND), J12.50 (GND), J12.MP; also elsewhere on the board
unnamed: J12.1 (~WAKE), R57.1
unnamed: J12.22 (~PERST), R61.1

Notes on the sheet:
Note: Polarity inversion on data lanes
Mini PCI Express
Slot 1

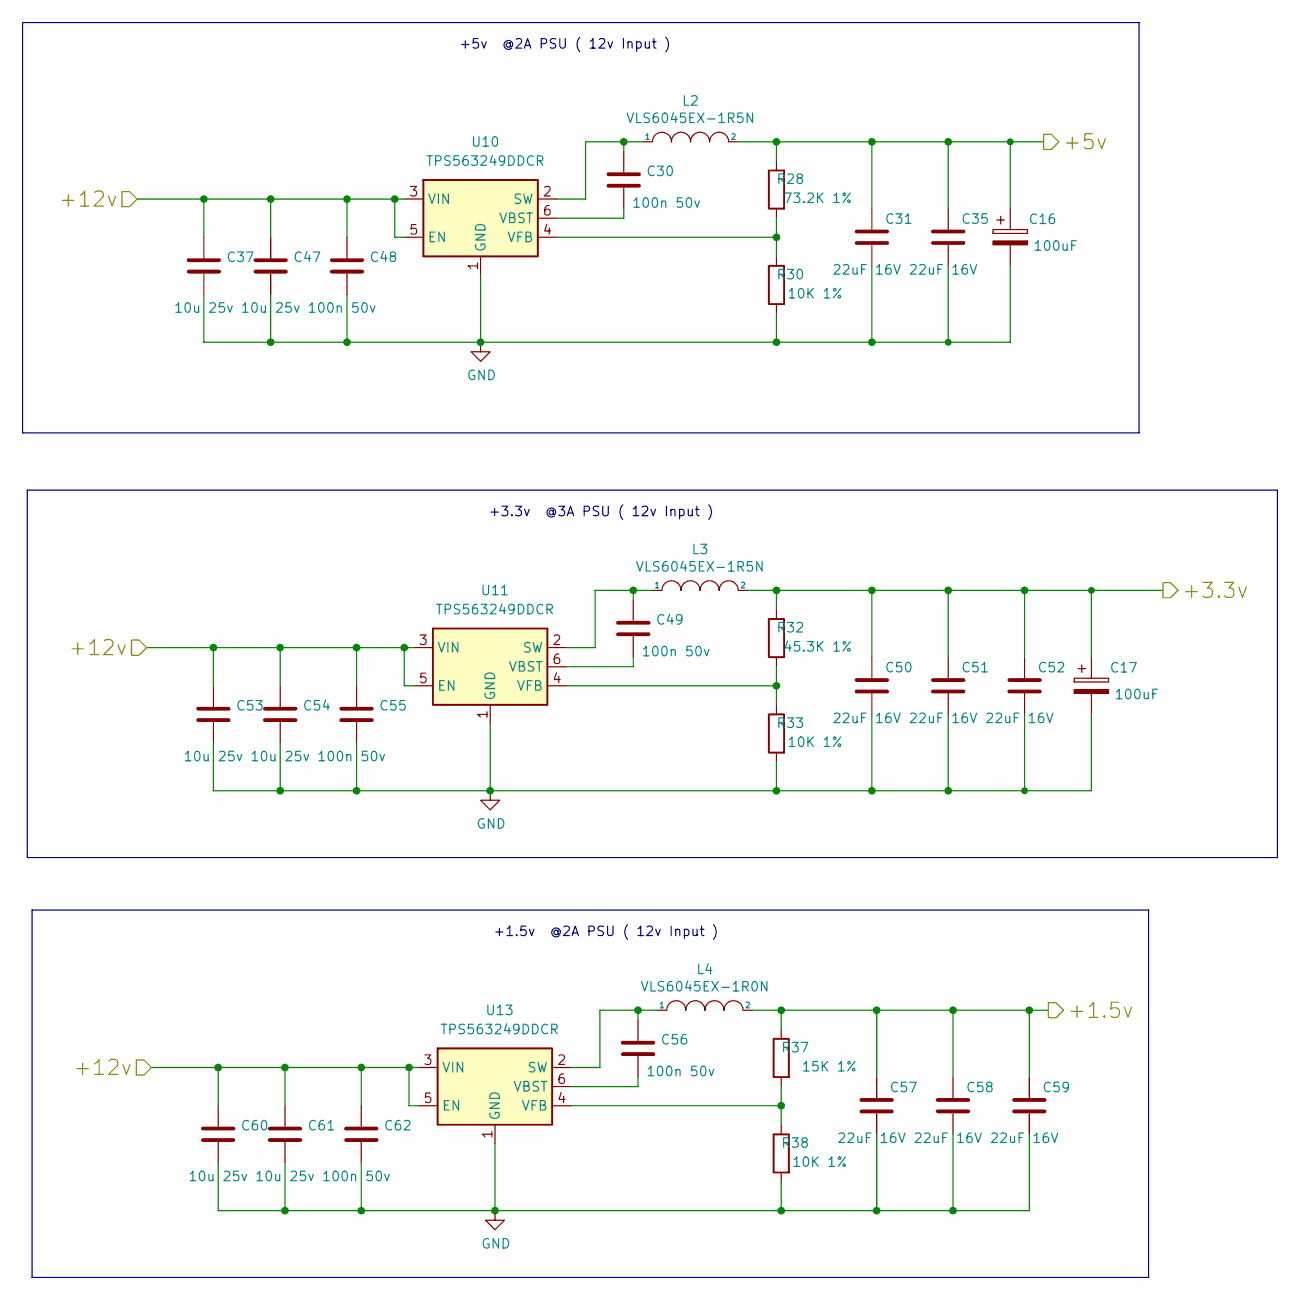
[picture p114: schematic PSUs.kicad_sch, AP3500v2]

Parts:
C16, C17: 100uF; CP_EIA-3528-21_Kemet-B_Pad1.50x2.35mm_HandSolder; Part Description Capacitor, SP-Cap, 100u, 6.3V, 15mR ESR; LCSC C16133
C30, C49, C56: 100n 50v; C_0603_1608Metric; LCSC C14663
C31, C35, C50, C51, C52, C57, C58, C59: 22uF 16V; C_1206_3216Metric; Part Description GCM32ER71C226KE19L; LCSC C90146
C37, C47, C53, C54, C60, C61: 10u 25v; C_0805_2012Metric; Part Description 10uF 10% or 20% 10V Ceramic Capacitor X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; LCSC C15850
C48, C55, C62: 100n 50v; C_0603_1608Metric; Part Description 100nF 10% or 20% 50V Ceramic Capacitor 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; LCSC C14663
L2, L3: VLS6045EX-1R5N; L_TDK_VLS6045; PartsBoxID VLS6045EX-1R5N
L4: VLS6045EX-1R0N; L_TDK_VLS6045; PartsBoxID VLS6045EX-1R0N
R28: 73.2K 1%; R_0603_1608Metric; LCSC C14890
R30, R33, R38: 10K 1%; R_0603_1608Metric; LCSC C25804
R32: 45.3K 1%; R_0603_1608Metric; LCSC C23058
R37: 15K 1%; R_0603_1608Metric; LCSC C22809
U10, U11, U13: TPS563249DDCR; SOT-23-6; PartsBoxID TPS563249DDCR

Connections:
/+1.5v: C57.1, C58.1, C59.1, L4.2, R37.1; also elsewhere on the board
/+3.3v: C17.1, C50.1, C51.1, C52.1, L3.2, R32.1; also elsewhere on the board
/+5v: C16.1, C31.1, C35.1, L2.2, R28.1; also elsewhere on the board
/+12v: C37.1, C47.1, C48.1, C53.1, C54.1, C55.1, C60.1, C61.1, C62.1, U10.3 (VIN), U10.5 (EN), U11.3 (VIN), U11.5 (EN), U13.3 (VIN), U13.5 (EN); also elsewhere on the board
GND: C16.2, C17.2, C31.2, C35.2, C37.2, C47.2, C48.2, C50.2, C51.2, C52.2, C53.2, C54.2, C55.2, C57.2, C58.2, C59.2, C60.2, C61.2, C62.2, R30.2, R33.2, R38.2, U10.1 (GND), U11.1 (GND), U13.1 (GND); also elsewhere on the board
unnamed: C30.1, L2.1, U10.2 (SW)
unnamed: C30.2, U10.6 (VBST)
unnamed: C49.1, L3.1, U11.2 (SW)
unnamed: C49.2, U11.6 (VBST)
unnamed: C56.1, L4.1, U13.2 (SW)
unnamed: C56.2, U13.6 (VBST)
unnamed: R28.2, R30.1, U10.4 (VFB)
unnamed: R32.2, R33.1, U11.4 (VFB)
unnamed: R37.2, R38.1, U13.4 (VFB)

Notes on the sheet:
+5v @2A PSU ( 12v Input )
+3.3v @3A PSU ( 12v Input )
+1.5v @2A PSU ( 12v Input )

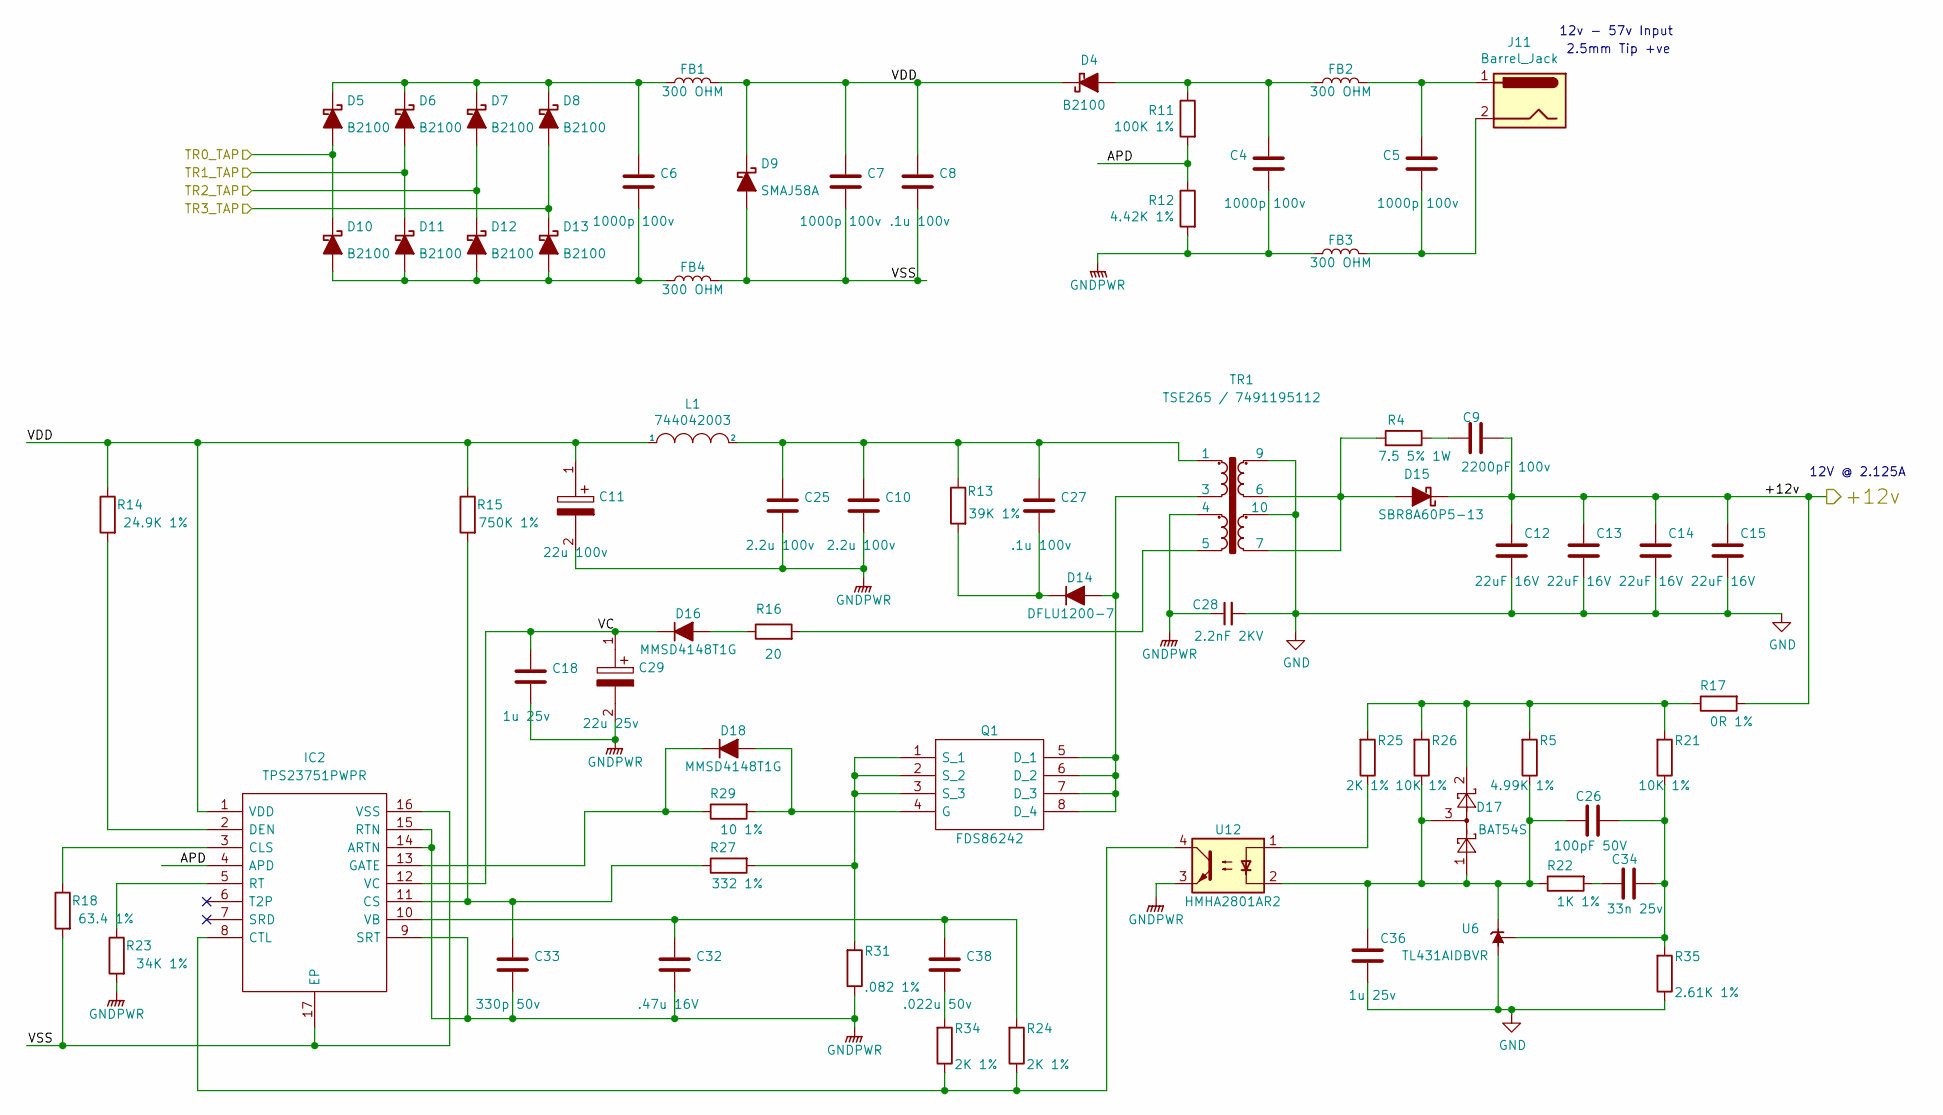
[picture p115: schematic poe.kicad_sch, AP3500v2]

Parts:
C4, C5, C6, C7: 1000p 100v; C_0805_2012Metric; Part Description 1000pF 10% or 20% 100V Ceramic Capacito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; LCSC C15177
C8, C27: .1u 100v; C_0603_1608Metric; Part Description .1uF 10% or 20% 100V Ceramic Capacitor 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; LCSC C15725
C9: 2200pF 100v; C_0603_1608Metric; Part Description 0603-2200pF-X7R-100V; LCSC C22423
C10, C25: 2.2u 100v; C_1210_3225Metric; LCSC C55151
C11: 22u 100v; CP_Elec_8x10.5; PartsBoxID AEC-SMD-8mm-22uF-100VDC-20%; LCSC C249491
C12, C13, C14, C15: 22uF 16V; C_1206_3216Metric; Part Description GCM32ER71C226KE19L; LCSC C90146
C18: 1u 25v; C_0805_2012Metric; Part Description C2012X5R1E105K; LCSC C89190
C26: 100pF 50V; C_0603_1608Metric; LCSC C14858
C28: 2.2nF 2KV; C_1210_3225Metric; PartsBoxID 1210-2.2nF-X7R-2KV; LCSC C173219
C29: 22u 25v; CP_Elec_5x5.4; PartsBoxID EEEFK1E220R; LCSC C239255
C32: .47u 16V; C_0603_1608Metric; Part Description .47uF 10% or 20% 16V Ceramic Capacitor 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; LCSC C1623
C33: 330p 50v; C_0603_1608Metric; Part Description 330pF 10% or 20% 50V Ceramic Capacitor 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; LCSC C1664
C34: 33n 25v; C_0603_1608Metric; LCSC C21117
C36: 1u 25v; C_0805_2012Metric; LCSC C89190
C38: .022u 50v; C_0603_1608Metric; Part Description .022uF 10% or 20% 50V Ceramic Capacitor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; LCSC C21122
D4, D5, D6, D7, D8, D10, D11, D12, D13: B2100; D_SMA; PartsBoxID B2100AE-13; LCSC C388246
D9: SMAJ58A; D_SMA; PartsBoxID SMAJ58A; Mouser Part Number 576-SMAJ58A
D14: DFLU1200-7; D_PowerDI-123; PartsBoxID DFLU1200-7
D15: SBR8A60P5-13; D_PowerDI-5; PartsBoxID SBR8A60P5-13
D16, D18: MMSD4148T1G; D_SOD-123; PartsBoxID MMSD4148T1G; LCSC C132796
D17: BAT54S; SOT-23; PartsBoxID BAT54SW-7-F; LCSC C727126
FB1, FB2, FB3, FB4: 300 OHM; L_0805_2012Metric; PartsBoxID 742792641; LCSC C56066
IC2: TPS23751PWPR; HTSSOP-16-1EP_4.4x5mm_P0.65mm_EP3.4x5mm_Mask2.46x2.31mm_The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; Manufacturer_Part_Number TPS23751PWPR; Mouser Part Number 595-TPS23751PWPR
J11: Barrel_Jack; BarrelJack_Horizontal; PartsBoxID BJ-2.5MM
L1: 744042003; WE-TPC_4818_482892-744042003; PartsBoxID 744042003
Q1: FDS86242; SO-8_3.9x4.9mm_P1.27mm; PartsBoxID FDS86242; LCSC C148410
R4: 7.5 5% 1W; R_2512_6332Metric; Part Description Resistor 7.5 2512 5% 1W; LCSC C35217
R5: 4.99K 1%; R_0603_1608Metric; LCSC C23046
R11: 100K 1%; R_0603_1608Metric; Part Description Resistor 100K 0402 1% 63mW; LCSC C25803
R12: 4.42K 1%; R_0603_1608Metric; LCSC C23043
R13: 39K 1%; R_0805_2012Metric; Part Description Resistor 39K 0805 1% 250mW; LCSC C25826
R14: 24.9K 1%; R_0603_1608Metric; Part Description Resistor 24.9K 0603 .1% 63mW; LCSC C25962
R15: 750K 1%; R_0603_1608Metric; Part Description Resistor 750K 0402 1% 63mW; LCSC C23240
R16: 20; R_0805_2012Metric; PartsBoxID CRCW080520R0JNEA; LCSC C17544
R17: 0R 1%; R_0603_1608Metric; Part Description Resistor 49.9 0402 1% 63mW; LCSC C21189
R18: 63.4 1%; R_0603_1608Metric; Part Description Resistor 63.4 0402 1% 100mW; LCSC C23223
R21, R26: 10K 1%; R_0603_1608Metric; Part Description Resistor 10K 0402 1% 63mW; LCSC C25804
R22: 1K 1%; R_0603_1608Metric; LCSC C21190
R23: 34K 1%; R_0603_1608Metric; Part Description Resistor 34K 0402 1% 63mW; LCSC C23008
R24, R25, R34: 2K 1%; R_0603_1608Metric; LCSC C22975
R27: 332 1%; R_0603_1608Metric; Part Description Resistor 332 0402 1% 63mW; LCSC C23007
R29: 10 1%; R_0603_1608Metric; Part Description Resistor 43.2 0402 1% 63mW; LCSC C22859
R31: .082 1%; R_1206_3216Metric; LCSC C247543
R35: 2.61K 1%; R_0603_1608Metric; LCSC C22942
TR1: TSE265 / 7491195112; Transformer_EP13; PartsBoxID 7491195112
U6: TL431AIDBVR; SOT-23; PartsBoxID TL431AIDBVR; LCSC C23892
U12: HMHA2801AR2; SOP-4_4.4x2.6mm_P1.27mm; PartsBoxID HMHA2801AR2; LCSC C258257

Connections:
/+12v: C9.2, C12.1, C13.1, C14.1, C15.1, D15.1 (K), R17.2; also elsewhere on the board
/CM4_GPIO ( Ethernet, GPIO, SDCARD)/TR0_TAP: D5.2 (A), D10.1 (K); also elsewhere on the board
/CM4_GPIO ( Ethernet, GPIO, SDCARD)/TR1_TAP: D6.2 (A), D11.1 (K); also elsewhere on the board
/CM4_GPIO ( Ethernet, GPIO, SDCARD)/TR2_TAP: D7.2 (A), D12.1 (K); also elsewhere on the board
/CM4_GPIO ( Ethernet, GPIO, SDCARD)/TR3_TAP: D8.2 (A), D13.1 (K); also elsewhere on the board
/PoE/APD: IC2.4 (APD), R11.2, R12.1
/PoE/VC: C18.1, C29.1, D16.1 (K), IC2.12 (VC)
/PoE/VDD: C7.1, C8.1, C11.1, D4.1 (K), D9.1 (K), FB1.2, IC2.1 (VDD), L1.1, R14.1, R15.1
/PoE/VSS: C7.2, C8.2, D9.2 (A), FB4.2, IC2.16 (VSS), IC2.17 (EP), R18.2
GND: C12.2, C13.2, C14.2, C15.2, C28.2, C36.2, R35.1, TR1.9, TR1.10, U6.3 (A); also elsewhere on the board
GNDPWR: C4.2, C10.2, C11.2, C18.2, C25.2, C28.1, C29.2, C32.2, C33.2, FB3.2, IC2.9 (SRT), IC2.14 (ARTN), IC2.15 (RTN), R12.2, R23.2, R31.1, TR1.4, U12.3; also elsewhere on the board
unnamed: C4.1, D4.2 (A), FB2.2, R11.1
unnamed: C5.1, FB2.1, J11.1
unnamed: C5.2, FB3.1, J11.2
unnamed: C6.1, D5.1 (K), D6.1 (K), D7.1 (K), D8.1 (K), FB1.1
unnamed: C6.2, D10.2 (A), D11.2 (A), D12.2 (A), D13.2 (A), FB4.1
unnamed: C9.1, R4.1
unnamed: C10.1, C25.1, C27.1, L1.2, R13.1, TR1.1
unnamed: C26.1, C36.1, D17.1, D17.3, R5.1, R22.1, R26.1, U6.1 (K), U12.2
unnamed: C26.2, C34.2, R21.1, R35.2, U6.2 (REF)
unnamed: C27.2, D14.1 (K), R13.2
unnamed: C32.1, C38.1, IC2.10 (VB), R24.2
unnamed: C33.1, IC2.11 (CS), R15.2, R27.1
unnamed: C34.1, R22.2
unnamed: C38.2, R34.2
unnamed: D14.2 (A), Q1.5 (D_1), Q1.6 (D_2), Q1.7 (D_3), Q1.8 (D_4), TR1.3
unnamed: D15.2 (A), R4.2, TR1.6, TR1.7
unnamed: D16.2 (A), R16.1
unnamed: D17.2, R5.2, R17.1, R21.2, R25.2, R26.2
unnamed: D18.1 (K), IC2.13 (GATE), R29.1
unnamed: D18.2 (A), Q1.4 (G), R29.2
unnamed: IC2.2 (DEN), R14.2
unnamed: IC2.3 (CLS), R18.1
unnamed: IC2.5 (RT), R23.1
unnamed: IC2.8 (CTL), R24.1, R34.1, U12.4
unnamed: Q1.1 (S_1), Q1.2 (S_2), Q1.3 (S_3), R27.2, R31.2
unnamed: R16.2, TR1.5
unnamed: R25.1, U12.1

Notes on the sheet:
2.5mm Tip +ve
12v - 57v Input
12V @ 2.125A
