imagestream/kicad/AP2000/AP2000.kicad_pcb

## KiCad design AP2000/AP2000.kicad_pcb (continued)

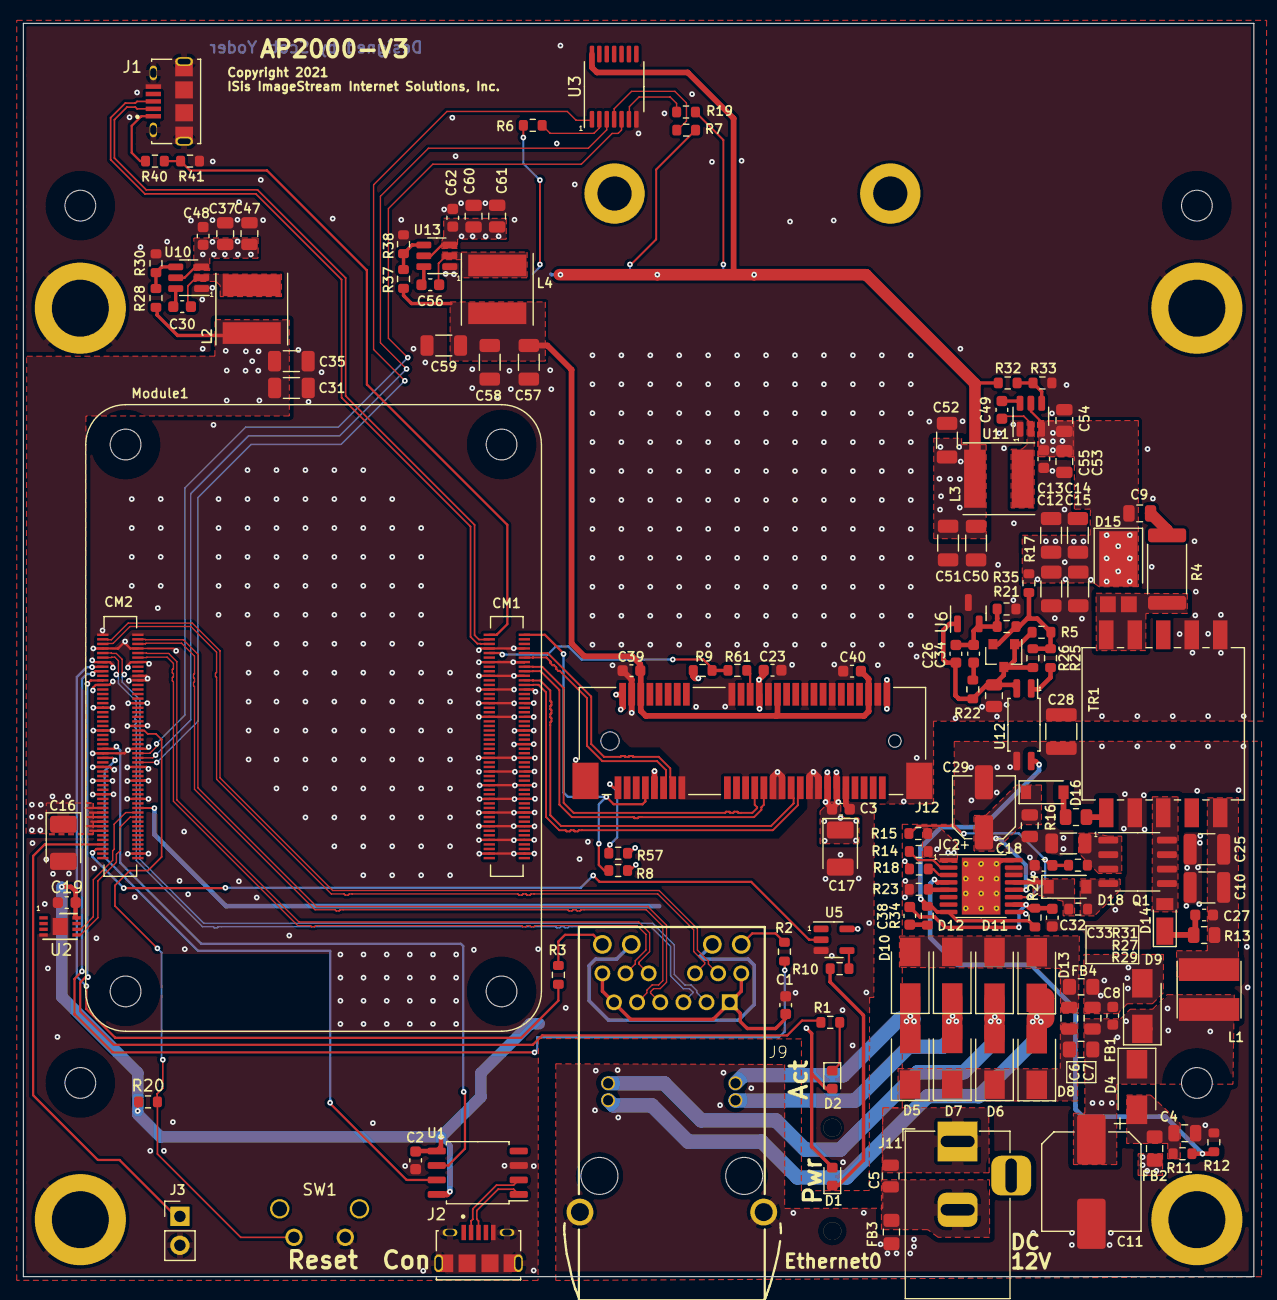
[picture p116: board AP2000.kicad_pcb from above]

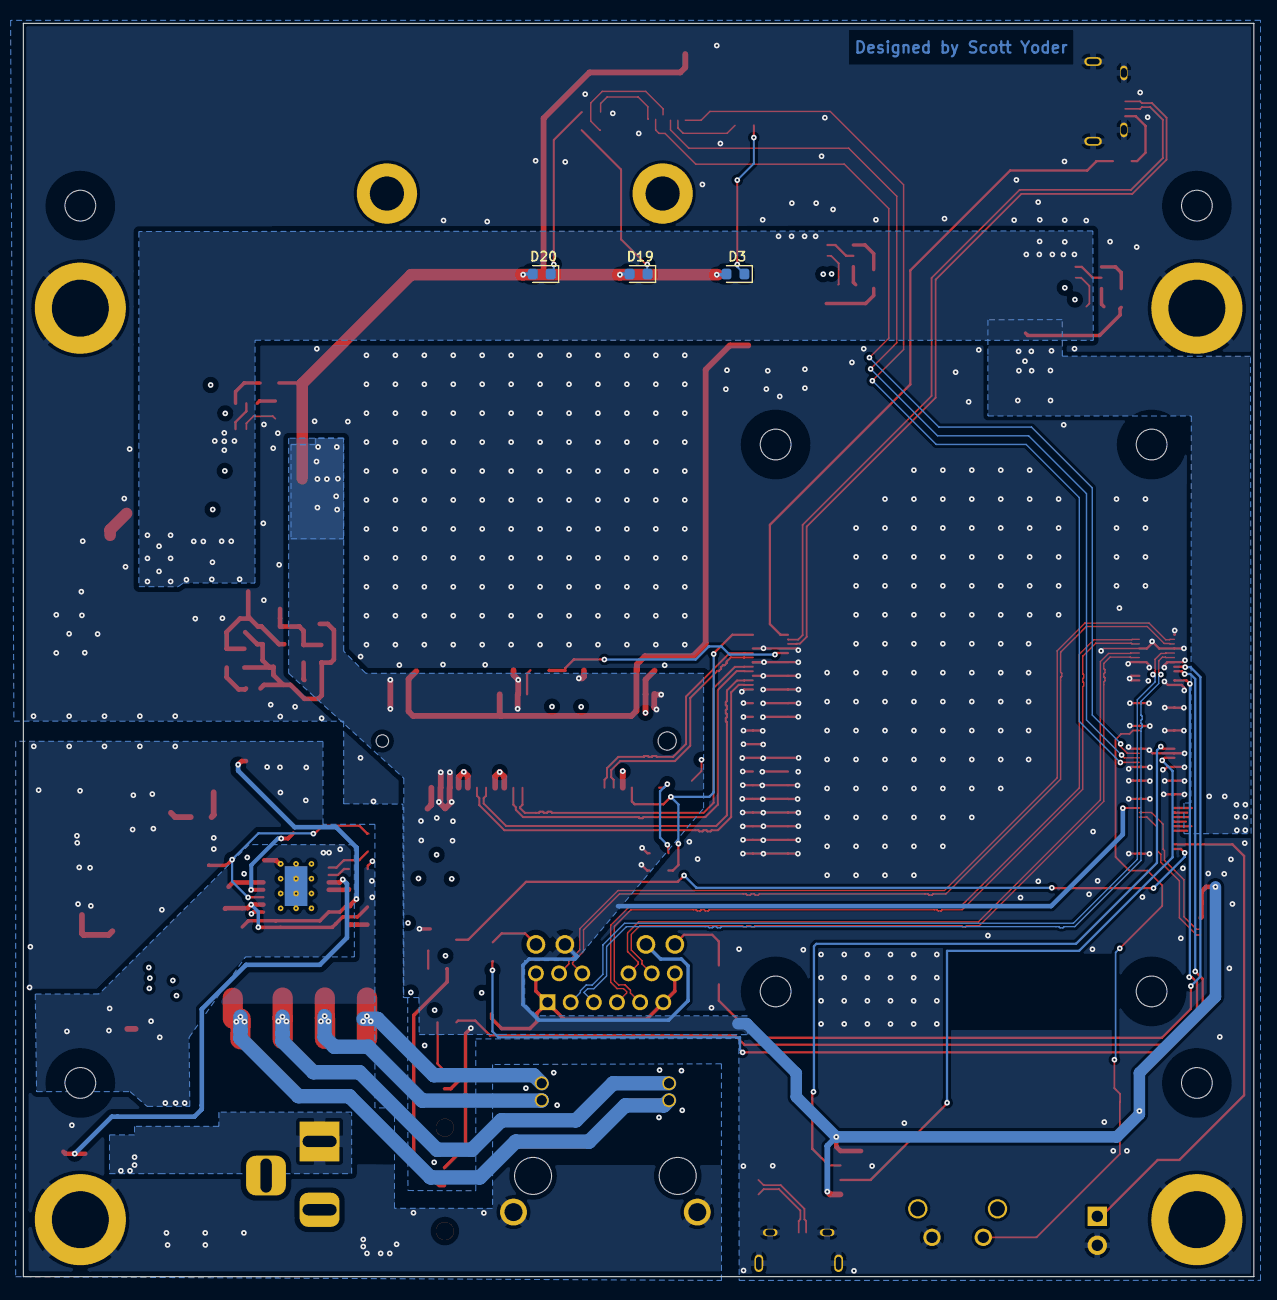
[picture p117: board AP2000.kicad_pcb from below]

Board: 4 copper layers, 108.0 x 110.0 mm, 152 parts (3 on the bottom side), 99 nets.
