imagestream/kicad/CM4IO/CM4IOv5.kicad_pcb

## KiCad design CM4IO/CM4IOv5.kicad_pcb (continued)

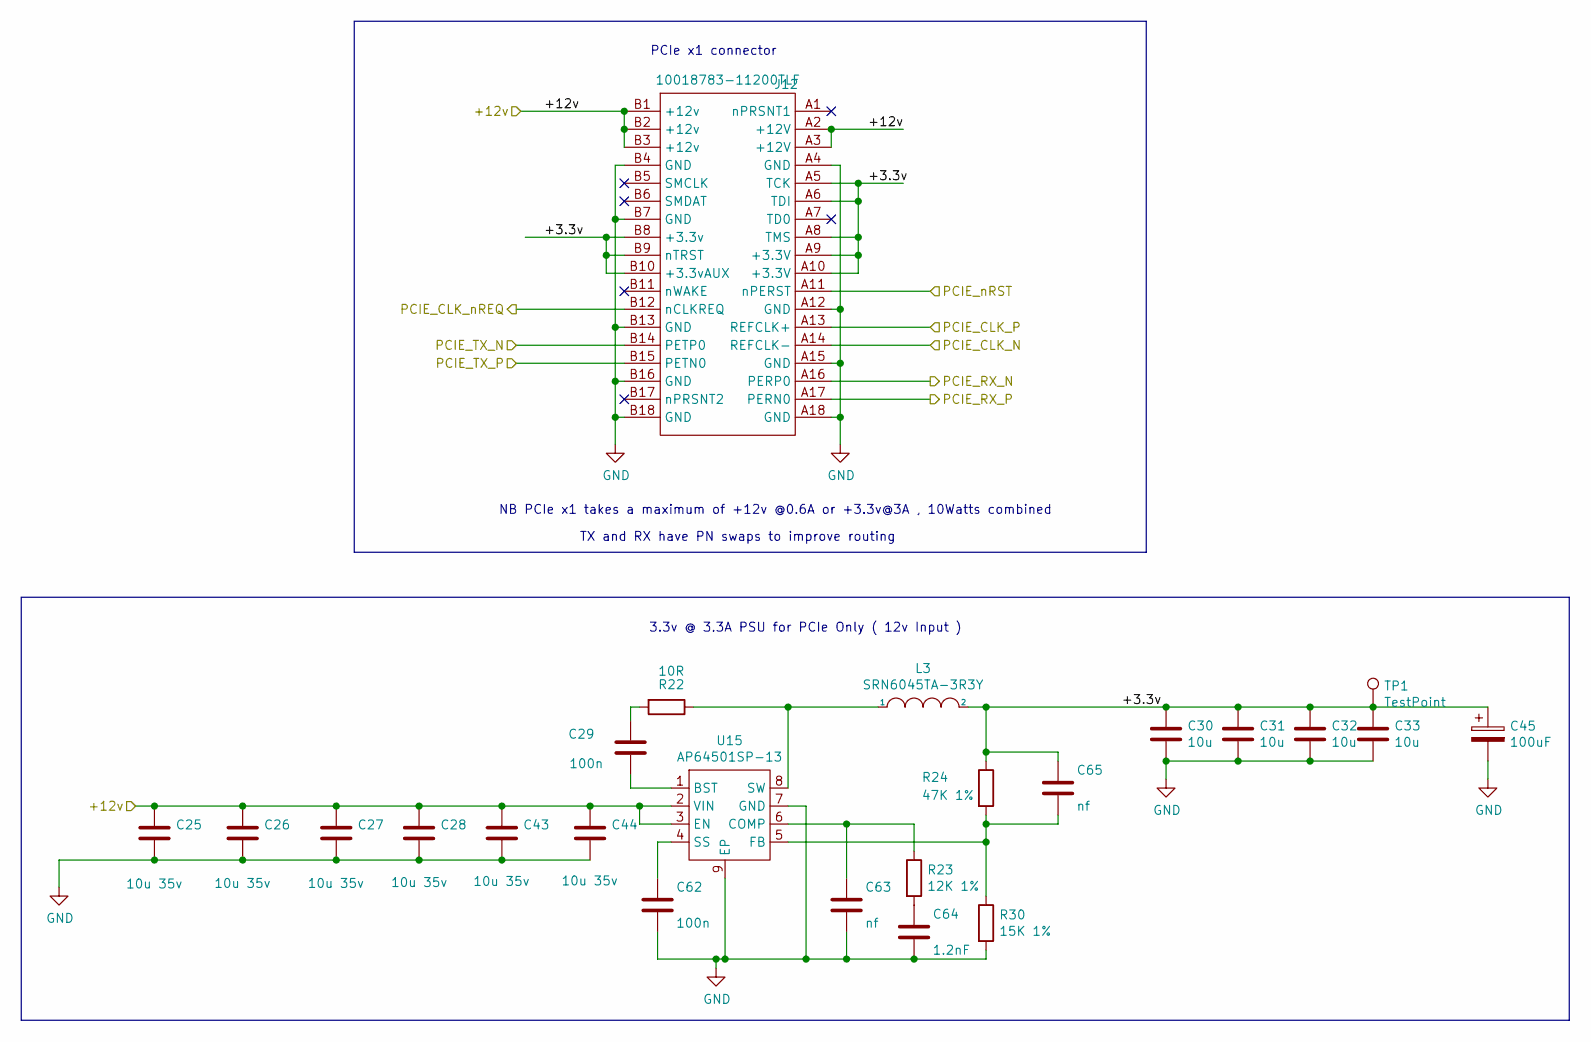
[picture p121: schematic PCIe-routing.kicad_sch, Compute Module 4 IO Board - PCIe]

Parts:
C25, C26, C27, C28, C43, C44: 10u 35v; C_0805_2012Metric; Part Description 10uF 10% or 20% 35V Ceramic Capacitor X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
C29, C62: 100n; C_0402_1005Metric; Part Description 0.1uF 10% 16V Ceramic Capacitor X7R 040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
C30, C31, C32, C33: 10u; C_0805_2012Metric; Part Description 10uF 10% 10V Ceramic Capacitor X7R 0805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
C45: 100uF; CP_EIA-7343-31_Kemet-D; Part Description Capacitor, SP-Cap, 100u, 6.3V, 15mR ESR
C63: nf; C_0402_1005Metric
C64: 1.2nF; C_0402_1005Metric; Part Description 1200pF 10% 10V Ceramic Capacitor X5R 04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
C65: nf; C_0402_1005Metric; Part Description 27pF 5% 50V Ceramic Capacitor C0G, NP0 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
J12: 10018783-11200TLF; PCIex1-36; Part Description PCI Express/PCI Connectors PCIE THROUGH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
L3: SRN6045TA-3R3Y; L_Bourns_SRN6045TA; Part Description 3.3µH Semi-Shielded Wirewound Inductor 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
R22: 10R; R_0402_1005Metric; Part Description Resistor 10R M1005 1% 63mW
R23: 12K 1%; R_0402_1005Metric; Part Description Resistor 12K M1005 1% 63mW
R24: 47K 1%; R_0402_1005Metric; Part Description Resistor 47K M1005 1% 63mW
R30: 15K 1%; R_0402_1005Metric; Part Description Resistor 15K M1005 1% 63mW
TP1: TestPoint; TestPoint_Pad_2.0x2.0mm
U15: AP64501SP-13; SOIC-8-1EP_3.9x4.9mm_P1.27mm_EP2.95x4.9mm_Mask2.71x3.4mm_Th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; Part Description Buck Switching Regulator IC Positive Ad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

Connections:
/+12v: C25.1, C26.1, C27.1, C28.1, C43.1, C44.1, J12.A2 (+12V), J12.A3 (+12V), J12.B1 (+12v), J12.B2 (+12v), J12.B3 (+12v), U15.2 (VIN), U15.3 (EN); also elsewhere on the board
/PCIE_CLK_N: J12.A14 (REFCLK-); also elsewhere on the board
/PCIE_CLK_P: J12.A13 (REFCLK+); also elsewhere on the board
/PCIE_CLK_nREQ: J12.B12 (nCLKREQ); also elsewhere on the board
/PCIE_RX_N: J12.A16 (PERP0); also elsewhere on the board
/PCIE_RX_P: J12.A17 (PERN0); also elsewhere on the board
/PCIE_TX_N: J12.B14 (PETP0); also elsewhere on the board
/PCIE_TX_P: J12.B15 (PETN0); also elsewhere on the board
/PCIE_nRST: J12.A11 (nPERST); also elsewhere on the board
/PCIe-connector/+3.3v: C30.1, C31.1, C32.1, C33.1, C45.1, C65.1, J12.A5 (TCK), J12.A6 (TDI), J12.A8 (TMS), J12.A9 (+3.3V), J12.A10 (+3.3V), J12.B8 (+3.3v), J12.B9 (nTRST), J12.B10 (+3.3vAUX), L3.2, R24.1, TP1.1
GND: C25.2, C26.2, C27.2, C28.2, C30.2, C31.2, C32.2, C33.2, C43.2, C44.2, C45.2, C62.2, C63.2, C64.2, J12.A4 (GND), J12.A12 (GND), J12.A15 (GND), J12.A18 (GND), J12.B4 (GND), J12.B7 (GND), J12.B13 (GND), J12.B16 (GND), J12.B18 (GND), R30.2, U15.7 (GND), U15.9 (EP); also elsewhere on the board
unnamed: C29.1, R22.2
unnamed: C29.2, U15.1 (BST)
unnamed: C62.1, U15.4 (SS)
unnamed: C63.1, R23.1, U15.6 (COMP)
unnamed: C64.1, R23.2
unnamed: C65.2, R24.2, R30.1, U15.5 (FB)
unnamed: L3.1, R22.1, U15.8 (SW)

Notes on the sheet:
NB PCIe x1 takes a maximum of +12v @0.6A or +3.3v@3A , 10Watts combined
TX and RX have PN swaps to improve routing
3.3v @ 3.3A PSU for PCIe Only ( 12v Input )
PCIe x1 connector

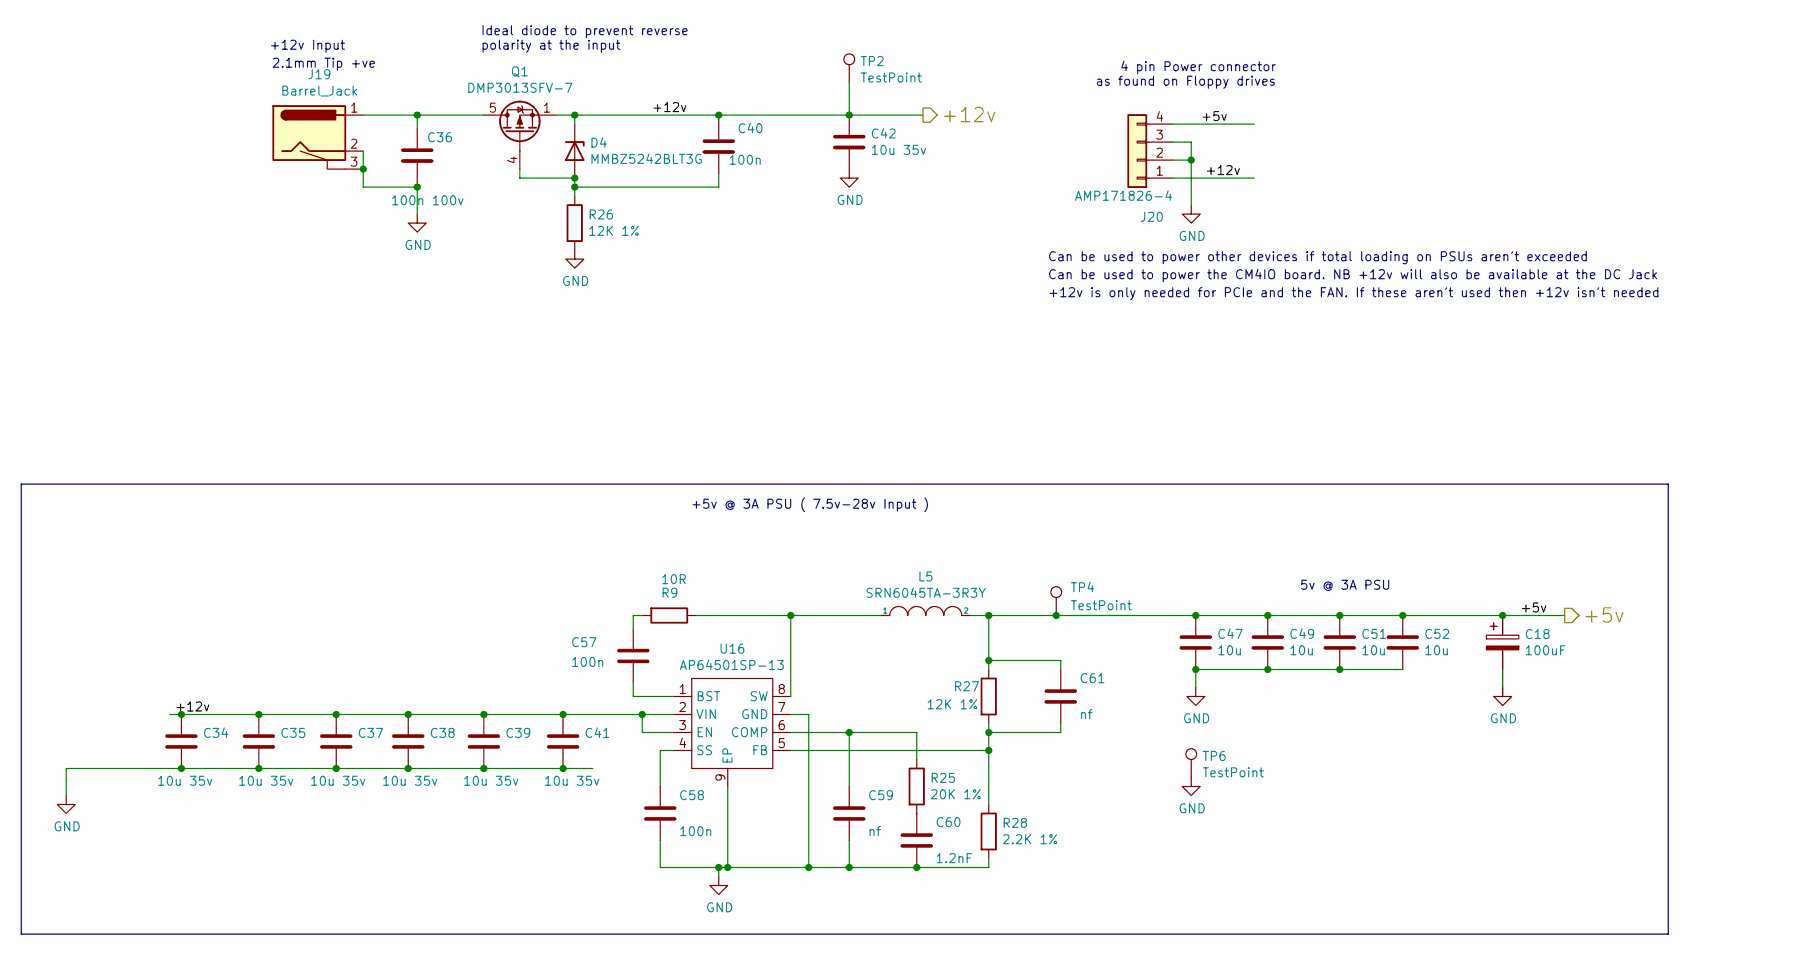
[picture p122: schematic PSUs.kicad_sch, Compute Module 4 IO Board - PSUs]

Parts:
C18: 100uF; CP_EIA-7343-31_Kemet-D; Part Description Capacitor, SP-Cap, 100u, 6.3V, 15mR ESR
C34, C35, C37, C38, C39, C41, C42: 10u 35v; C_0805_2012Metric; Part Description 10uF 10% or 20% 35V Ceramic Capacitor X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
C36: 100n 100v; C_0402_1005Metric; Part Description 0.1uF 10% 100V Ceramic Capacitor X5R 04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
C40, C57, C58: 100n; C_0402_1005Metric; Part Description 0.1uF 10% 16V Ceramic Capacitor X7R 040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
C47, C49, C51, C52: 10u; C_0805_2012Metric; Part Description 10uF 10% 10V Ceramic Capacitor X7R 0805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
C59: nf; C_0402_1005Metric
C60: 1.2nF; C_0402_1005Metric; Part Description 1200pF 10% 10V Ceramic Capacitor X5R 04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
C61: nf; C_0402_1005Metric; Part Description 220 pF, 50 V, 0402 [1005 Metric], ± 5%,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
D4: MMBZ5242BLT3G; D_SOT-23_ANK; Part Description Zener Diode 12V 225mW 5% Surface Mount 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
J19: Barrel_Jack; BarrelJack_Horizontal; Part Description DC Power Connectors PCB 2.1MM
J20: AMP171826-4; TE_171826-4; Part Description Wire-To-Board Connector, Right Angle, 2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
L5: SRN6045TA-3R3Y; L_Bourns_SRN6045TA; Part Description 3.3µH Semi-Shielded Wirewound Inductor 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
Q1: DMP3013SFV-7; Diodes_PowerDI3333-8; Part Description DMP3013SFV-7 - Power MOSFET, P Channel,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
R9: 10R; R_0402_1005Metric; Part Description Resistor 10R M1005 1% 63mW
R25: 20K 1%; R_0402_1005Metric; Part Description Resistor 20K M1005 1% 63mW
R26, R27: 12K 1%; R_0402_1005Metric; Part Description Resistor 12K M1005 1% 63mW
R28: 2.2K 1%; R_0402_1005Metric; Part Description Resistor 2.2K M1005 1% 63mW
TP2, TP4, TP6: TestPoint; TestPoint_Pad_2.0x2.0mm
U16: AP64501SP-13; SOIC-8-1EP_3.9x4.9mm_P1.27mm_EP2.95x4.9mm_Mask2.71x3.4mm_Th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; Part Description Buck Switching Regulator IC Positive Ad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

Connections:
/+5v: C18.1, C47.1, C49.1, C51.1, C52.1, C61.1, J20.4, L5.2, R27.1, TP4.1; also elsewhere on the board
/+12v: C34.1, C35.1, C37.1, C38.1, C39.1, C40.1, C41.1, C42.1, D4.1 (K), J20.1, Q1.1 (S), Q1.2 (S), Q1.3 (S), TP2.1, U16.2 (VIN), U16.3 (EN); also elsewhere on the board
GND: C18.2, C34.2, C35.2, C36.2, C37.2, C38.2, C39.2, C41.2, C42.2, C47.2, C49.2, C51.2, C52.2, C58.2, C59.2, C60.2, J19.2, J19.3, J20.2, J20.3, R26.2, R28.2, TP6.1, U16.7 (GND), U16.9 (EP); also elsewhere on the board
unnamed: C36.1, J19.1, Q1.5 (D)
unnamed: C40.2, D4.2 (A), Q1.4 (G), R26.1
unnamed: C57.1, R9.2
unnamed: C57.2, U16.1 (BST)
unnamed: C58.1, U16.4 (SS)
unnamed: C59.1, R25.1, U16.6 (COMP)
unnamed: C60.1, R25.2
unnamed: C61.2, R27.2, R28.1, U16.5 (FB)
unnamed: L5.1, R9.1, U16.8 (SW)

Notes on the sheet:
+12v Input
2.1mm Tip +ve
Ideal diode to prevent reverse polarity at the input
+5v @ 3A PSU ( 7.5v-28v Input )
Can be used to power other devices if total loading on PSUs aren't exceeded
Can be used to power the CM4IO board. NB +12v will also be available at the DC Jack
+12v is only needed for PCIe and the FAN. If these aren't used then +12v isn't needed
4 pin Power connector as found on Floppy drives
5v @ 3A PSU

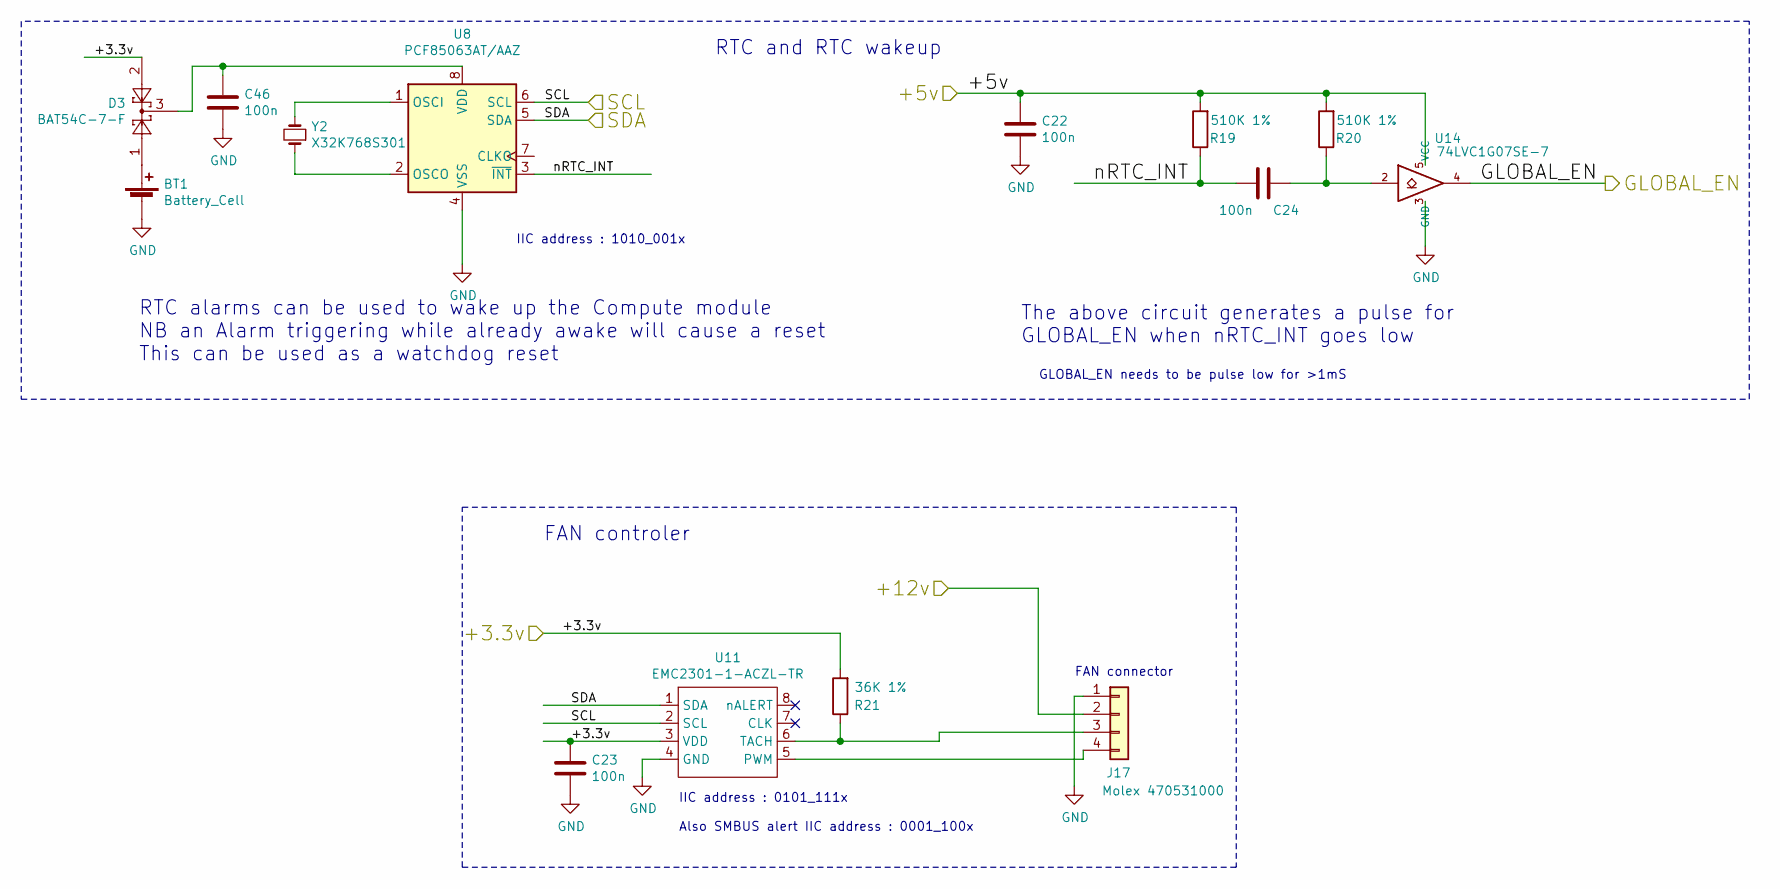
[picture p123: schematic RTC.kicad_sch, Compute Module 4 IO Board - RTC - FAN]

Parts:
BT1: Battery_Cell; BatteryHolder_Keystone_3034_1x20mm; Part Description Battery Retainer Coin, 20.0mm 1 Cell SM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
C22, C23, C24, C46: 100n; C_0402_1005Metric; Part Description 0.1uF 10% 16V Ceramic Capacitor X7R 040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
D3: BAT54C-7-F; SOT-23; Part Description Diode Array 1 Pair Common Cathode Schot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
J17: Molex 470531000; FanPinHeader_1x04_P2.54mm_Vertical; Part Description Connector Header Through Hole 4 positio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
R19, R20: 510K 1%; R_0402_1005Metric; Part Description Resistor 510K M1005 1% 63mW
R21: 36K 1%; R_0402_1005Metric; Part Description Resistor 36K M1005 1% 63mW
U8: PCF85063AT/AAZ; SOIC-8_3.9x4.9mm_P1.27mm; Part Description Real Time Clock (RTC) IC Clock/Calendar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
U11: EMC2301-1-ACZL-TR; SOIC-8_5.23x5.23mm_P1.27mm; Part Description Motor Driver PWM 8-MSOP
U14: 74LVC1G07SE-7; SOT-353_SC-70-5; Part Description Buffer, Non-Inverting 1 Element 1 Bit p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
Y2: X32K768S301; Crystal_SMD_3215-2Pin_3.2x1.5mm; Part Description Crystal 32.768KHz 7pF 20pmm

Connections:
/+3.3v: C23.1, D3.2, R21.2, U11.3 (VDD); also elsewhere on the board
/+5v: C22.1, R19.2, R20.2, U14.5 (VCC); also elsewhere on the board
/+12v: J17.2; also elsewhere on the board
/GLOBAL_EN: U14.4; also elsewhere on the board
/RTC , Wakeup, FAN/nRTC_INT: C24.2, R19.1, U8.3 (~INT~)
/SCL0: U8.6 (SCL), U11.2 (SCL); also elsewhere on the board
/SDA0: U8.5 (SDA), U11.1 (SDA); also elsewhere on the board
GND: BT1.2 (-), C22.2, C23.2, C46.2, J17.1, U8.4 (VSS), U11.4 (GND), U14.3 (GND); also elsewhere on the board
unnamed: BT1.1 (+), D3.1
unnamed: C24.1, R20.1, U14.2
unnamed: C46.1, D3.3, U8.8 (VDD)
unnamed: J17.3, R21.1, U11.6 (TACH)
unnamed: J17.4, U11.5 (PWM)
unnamed: U8.1 (OSCI), Y2.2
unnamed: U8.2 (OSCO), Y2.1

Notes on the sheet:
RTC alarms can be used to wake up the Compute module NB an Alarm triggering while already awake will cause a reset This can be used as a watchdog reset
IIC address : 1010_001x
FAN controler
IIC address : 0101_111x
Also SMBUS alert IIC address : 0001_100x
RTC and RTC wakeup
The above circuit generates a pulse for GLOBAL_EN when nRTC_INT goes low
GLOBAL_EN needs to be pulse low for >1mS
FAN connector

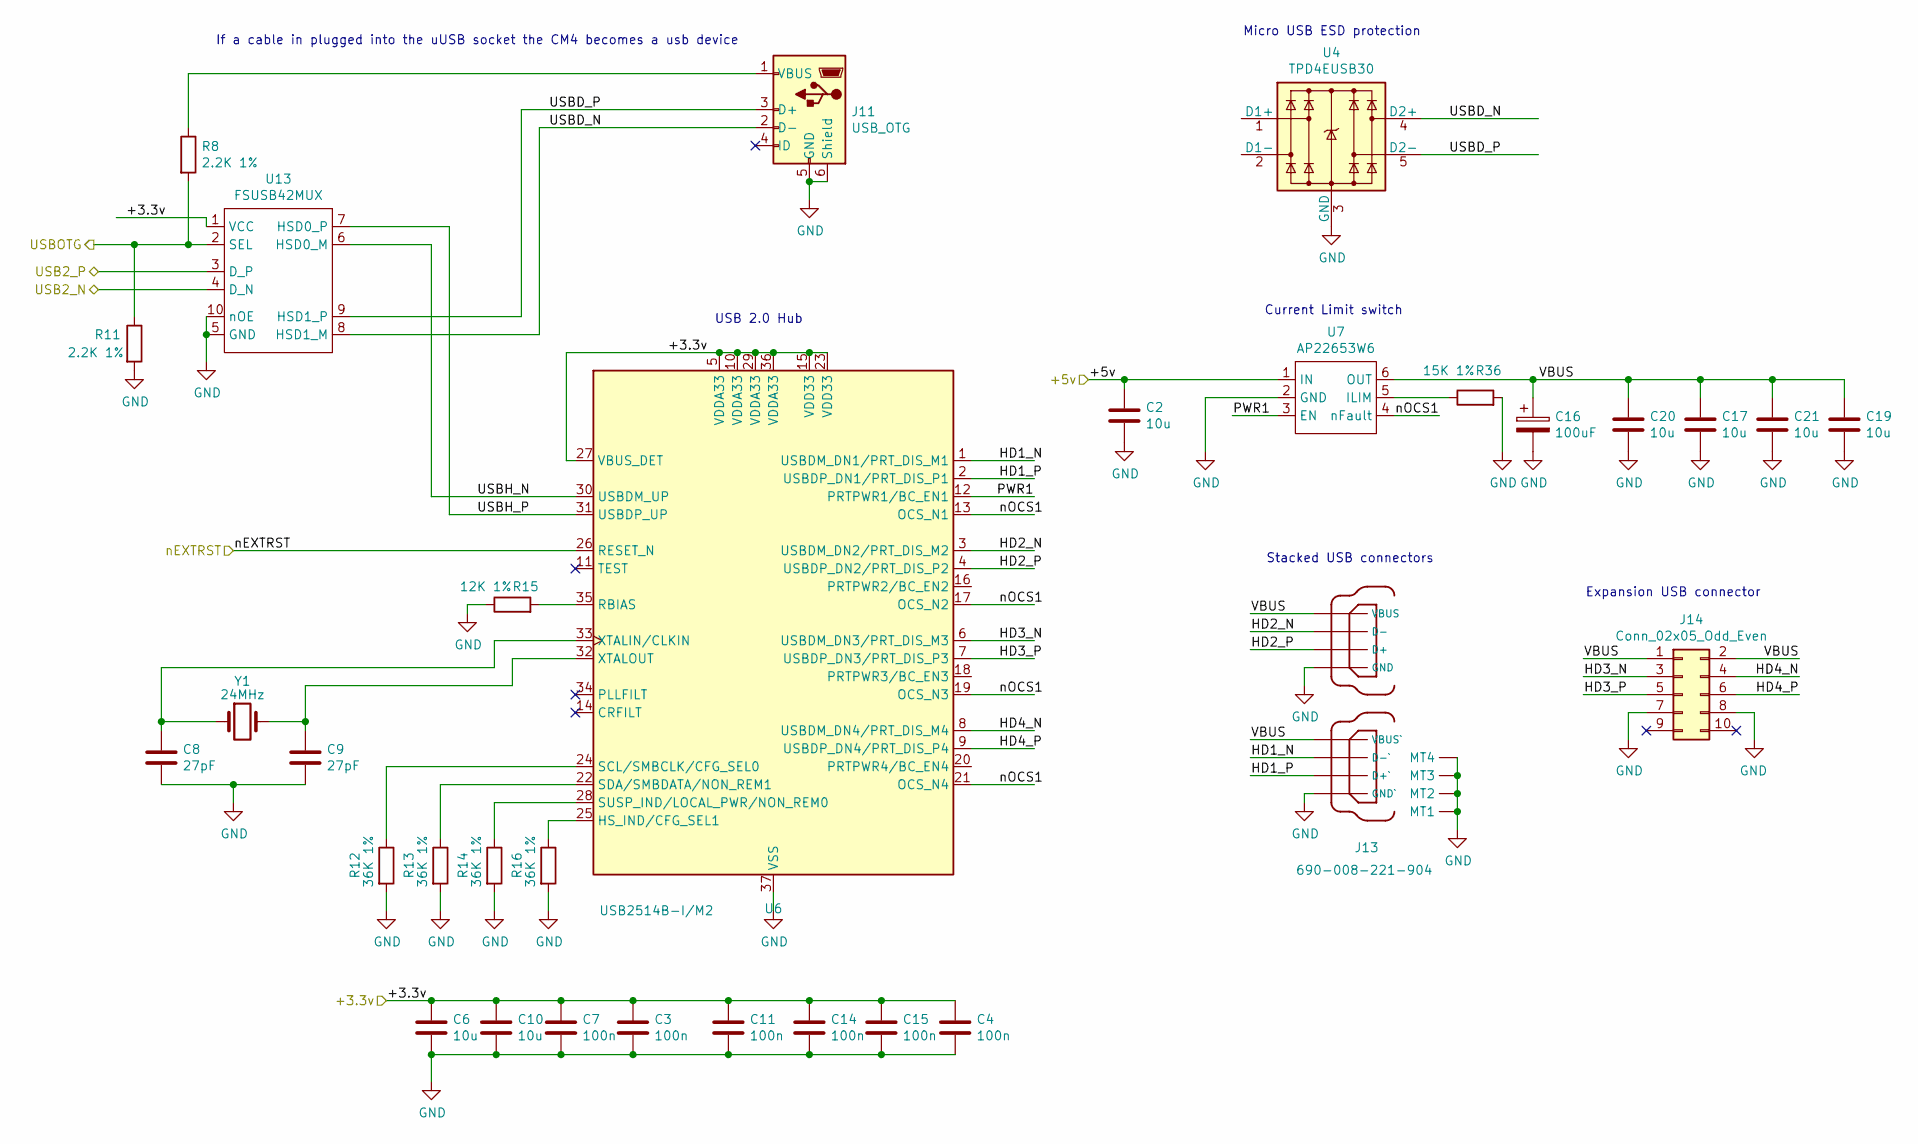
[picture p124: schematic USB2-HUB.kicad_sch, Compute Module 4 IO Board - USB]

Parts:
C2, C6, C10, C17, C19, C20, C21: 10u; C_0805_2012Metric; Part Description 10uF 10% 10V Ceramic Capacitor X7R 0805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
C3, C4, C7, C11, C14, C15: 100n; C_0402_1005Metric; Part Description 0.1uF 10% 16V Ceramic Capacitor X7R 040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
C8, C9: 27pF; C_0402_1005Metric; Part Description 27pF 5% 50V Ceramic Capacitor C0G, NP0 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
C16: 100uF; CP_EIA-7343-31_Kemet-D; Part Description Capacitor, SP-Cap, 100u, 6.3V, 15mR ESR
J11: USB_OTG; USB_Micro-B_EDAC_UCON00686; Part Description USB - micro B USB 2.0 Receptacle Connec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
J13: 690-008-221-904; MOLEX_USB_67298-4090; Part Description USB-A (USB TYPE-A), Stacked Receptacle 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
J14: Conn_02x05_Odd_Even; PinHeader_2x05_P2.54mm_Vertical; Part Description PinHeader_2x05_P2.54mm_Vertical
R8, R11: 2.2K 1%; R_0402_1005Metric; Part Description Resistor 2.2K M1005 1% 63mW
R12, R13, R14, R16: 36K 1%; R_0402_1005Metric; Part Description Resistor 36K M1005 1% 63mW
R15: 12K 1%; R_0402_1005Metric; Part Description Resistor 12K M1005 1% 63mW
R36: 15K 1%; R_0402_1005Metric; Part Description Resistor 15K M1005 1% 63mW
U4: TPD4EUSB30; USON-10_2.5x1.0mm_P0.5mm; Part Description Quad TVS diode for high speed signals (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
U6: USB2514B-I/M2; QFN-36-1EP_6x6mm_P0.5mm_EP3.7x3.7mm; Part Description USB Hub Controller USB Interface 36-SQF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
U7: AP22653W6; SOT-23-6; Part Description Power Switch/Driver 1:1 P-Channel 2.1A 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
U13: FSUSB42MUX; MSOP-10_3x3mm_P0.5mm; Part Description USB Switch IC 1 Channel 10-MSOP
Y1: 24MHz; Crystal_SMD_HC49-SD; Part Description 24MHz Crystal 18pf 30ppm 30ppm

Connections:
/+3.3v: C3.1, C4.1, C6.1, C7.1, C10.1, C11.1, C14.1, C15.1, U6.5 (VDDA33), U6.10 (VDDA33), U6.15 (VDD33), U6.23 (VDD33), U6.27 (VBUS_DET), U6.29 (VDDA33), U6.36 (VDDA33), U13.1 (VCC); also elsewhere on the board
/+5v: C2.1, U7.1 (IN); also elsewhere on the board
/USB2-HUB/HD1_N: J13.2 (D-`), U6.1 (USBDM_DN1/PRT_DIS_M1)
/USB2-HUB/HD1_P: J13.3 (D+`), U6.2 (USBDP_DN1/PRT_DIS_P1)
/USB2-HUB/HD2_N: J13.6 (D-), U6.3 (USBDM_DN2/PRT_DIS_M2)
/USB2-HUB/HD2_P: J13.7 (D+), U6.4 (USBDP_DN2/PRT_DIS_P2)
/USB2-HUB/HD3_N: J14.3, U6.6 (USBDM_DN3/PRT_DIS_M3)
/USB2-HUB/HD3_P: J14.5, U6.7 (USBDP_DN3/PRT_DIS_P3)
/USB2-HUB/HD4_N: J14.4, U6.8 (USBDM_DN4/PRT_DIS_M4)
/USB2-HUB/HD4_P: J14.6, U6.9 (USBDP_DN4/PRT_DIS_P4)
/USB2-HUB/PWR1: U6.12 (PRTPWR1/BC_EN1), U7.3 (EN)
/USB2-HUB/USBD_N: J11.2 (D-), U4.4 (D2+), U4.7, U13.8 (HSD1_M)
/USB2-HUB/USBD_P: J11.3 (D+), U4.5 (D2-), U4.6, U13.9 (HSD1_P)
/USB2-HUB/USBH_N: U6.30 (USBDM_UP), U13.6 (HSD0_M)
/USB2-HUB/USBH_P: U6.31 (USBDP_UP), U13.7 (HSD0_P)
/USB2-HUB/VBUS: C16.1, C17.1, C19.1, C20.1, C21.1, J13.1 (VBUS`), J13.5 (VBUS), J14.1, J14.2, U7.6 (OUT)
/USB2-HUB/nOCS1: U6.13 (OCS_N1), U6.17 (OCS_N2), U6.19 (OCS_N3), U6.21 (OCS_N4), U7.4 (nFault)
/USB2_N: U13.4 (D_N); also elsewhere on the board
/USB2_P: U13.3 (D_P); also elsewhere on the board
/USBOTG: R8.2, R11.1, U13.2 (SEL); also elsewhere on the board
/nEXTRST: U6.26 (RESET_N); also elsewhere on the board
GND: C2.2, C3.2, C4.2, C6.2, C7.2, C8.2, C9.2, C10.2, C11.2, C14.2, C15.2, C16.2, C17.2, C19.2, C20.2, C21.2, J11.5 (GND), J11.6 (Shield), J13.4 (GND`), J13.8 (GND), J13.MT1, J13.MT2, J13.MT3, J13.MT4, J14.7, J14.8, R11.2, R12.2, R13.2, R14.2, R15.1, R16.2, R36.2, U4.3 (GND), U4.8 (GND), U6.37 (VSS), U7.2 (GND), U13.5 (GND), U13.10 (nOE); also elsewhere on the board
unnamed: C8.1, U6.33 (XTALIN/CLKIN), Y1.1
unnamed: C9.1, U6.32 (XTALOUT), Y1.2
unnamed: J11.1 (VBUS), R8.1
unnamed: R12.1, U6.24 (SCL/SMBCLK/CFG_SEL0)
unnamed: R13.1, U6.22 (SDA/SMBDATA/NON_REM1)
unnamed: R14.1, U6.28 (SUSP_IND/LOCAL_PWR/NON_REM0)
unnamed: R15.2, U6.35 (RBIAS)
unnamed: R16.1, U6.25 (HS_IND/CFG_SEL1)
unnamed: R36.1, U7.5 (ILIM)
unnamed: U4.1 (D1+), U4.10
unnamed: U4.2 (D1-), U4.9

Notes on the sheet:
If a cable in plugged into the uUSB socket the CM4 becomes a usb device
USB 2.0 Hub
Current Limit switch
Micro USB ESD protection
Stacked USB connectors
Expansion USB connector

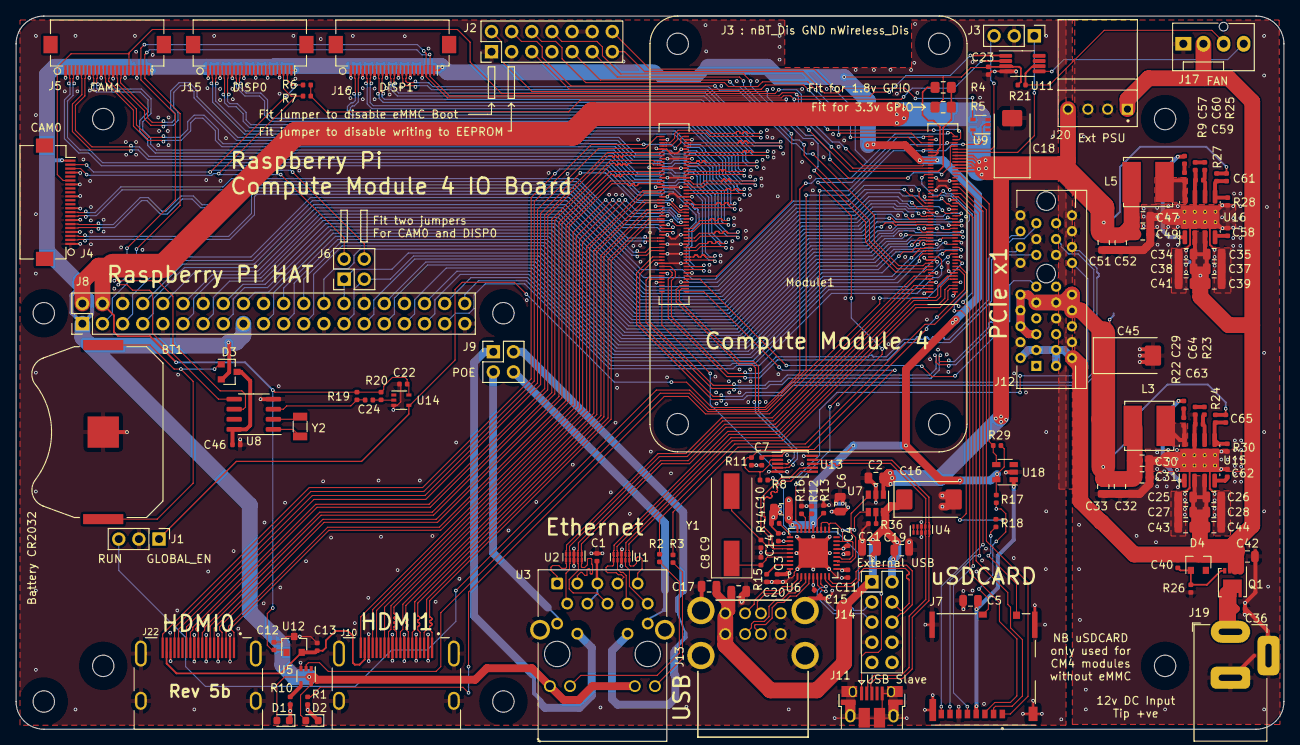
[picture p125: board CM4IOv5.kicad_pcb from above]

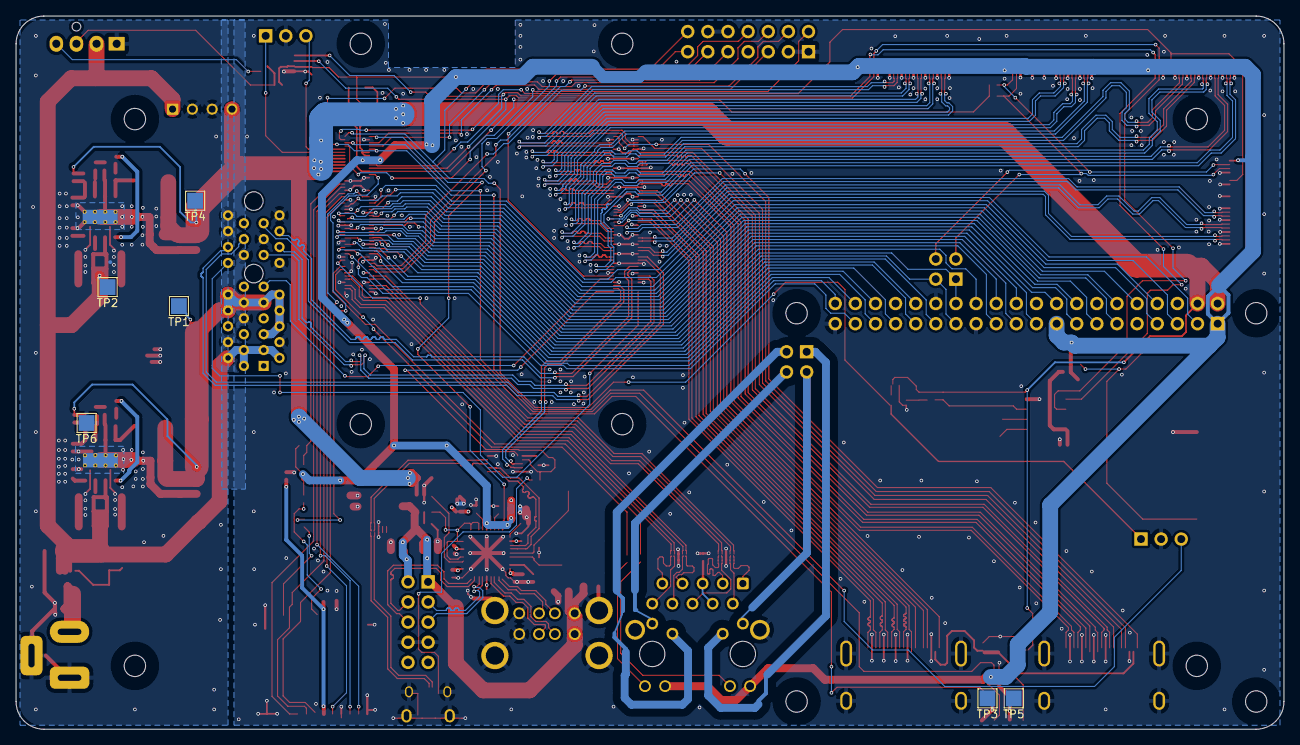
[picture p126: board CM4IOv5.kicad_pcb from below]

Board: 4 copper layers, 160.0 x 90.0 mm, 151 parts (6 on the bottom side), 204 nets.
