imagestream/kicad/AP2100.ls1043/AP2100.kicad_pcb

## KiCad design AP2100.ls1043/AP2100.kicad_pcb (2020-10-23)

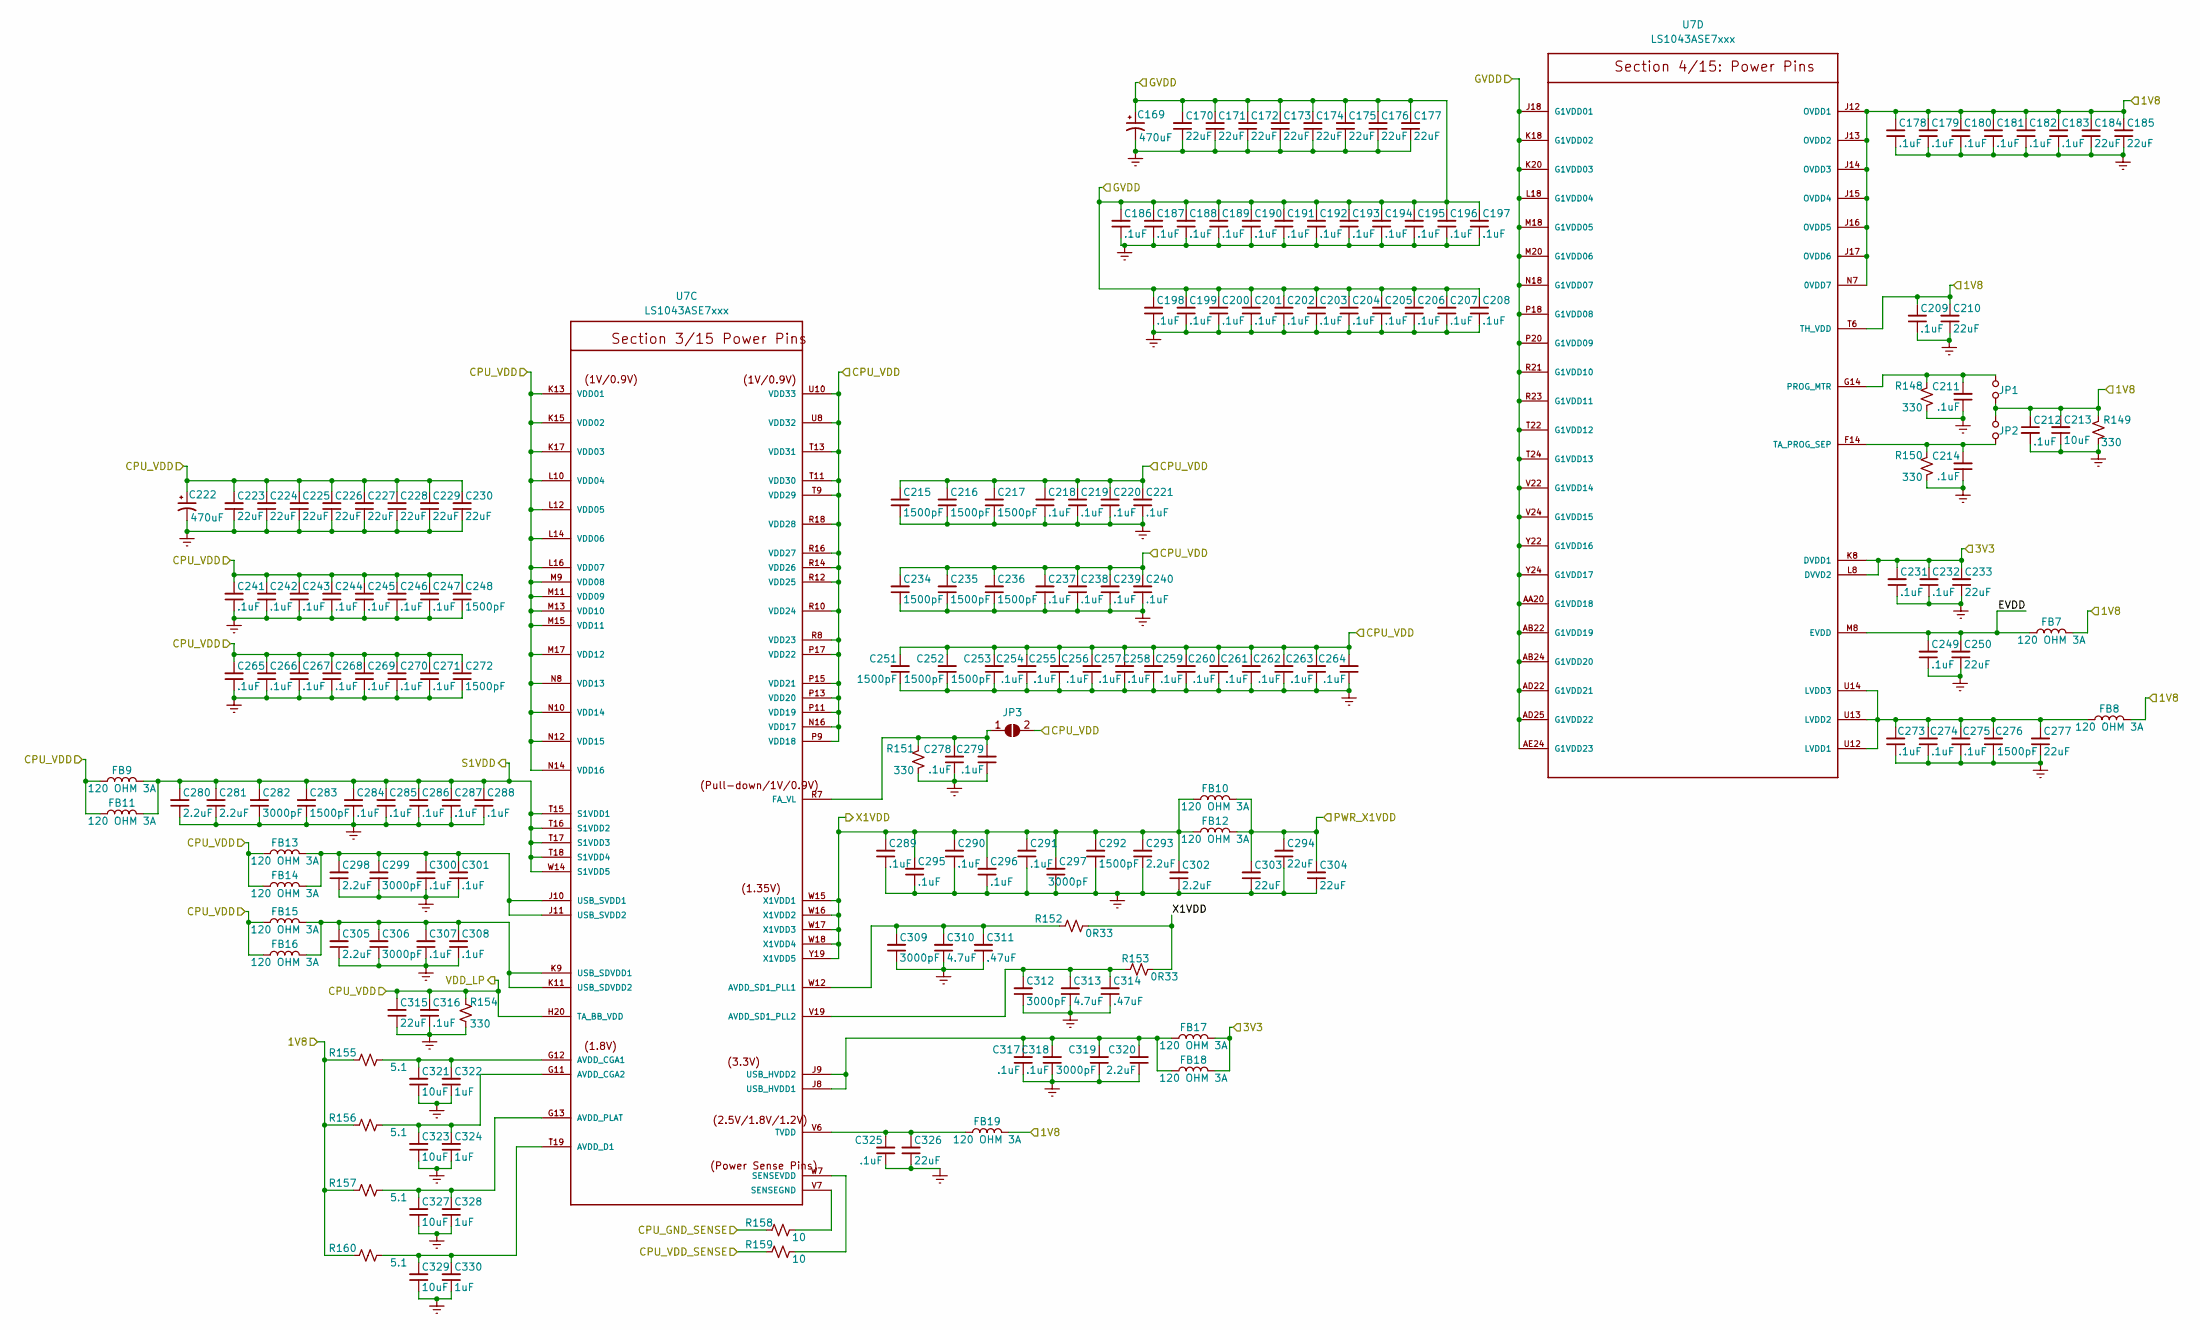
[picture p127: schematic CPU_power.kicad_sch, AP2100]

Parts:
C169, C222: 470uF; C_Elec_10x10.2; PartsBoxID EEHZK1E471P
C170, C171, C172, C173, C174, C175, C176, C177, C184, C185, C210, C223, C224, C225, C226, C227, C228, C229, C230, C233, C250, C277, C294, C303, C304, C315, C326: 22uF; C_0805_2012Metric; PartsBoxID 0805-22uF-X5R-25V
C178, C179, C180, C181, C182, C183, C186, C187, C188, C189, C190, C191, C192, C193, C194, C195, C196, C197, C198, C199, C200, C201, C202, C203, C204, C205, C206, C207, C208, C209, C211, C212, C214, C218, C219, C220, C221, C231, C232, C237, C238, C239, C240, C241, C242, C243, C244, C245, C246, C247, C249, C254, C255, C256, C257, C258, C259, C260, C261, C262, C263, C264, C265, C266, C267, C268, C269, C270, C271, C273, C274, C275, C278, C279, C284, C285, C286, C287, C288, C289, C290, C291, C295, C296, C300, C301, C307, C308, C316, C317, C318, C325: .1uF; C_0201_0603Metric; PartsBoxID 0201-.1uF-X5R-25V
C213, C321, C323, C327, C329: 10uF; C_0805_2012Metric; PartsBoxID 0805-10uF-X7R-6.3V
C215, C216, C217, C234, C235, C236, C248, C251, C252, C253, C272, C276, C283: 1500pF; C_0201_0603Metric; PartsBoxID 0201-1500pF-X5R-25V
C280, C281, C293, C298, C302, C305, C320: 2.2uF; C_0402_1005Metric; PartsBoxID 0402-2.2uF-X5R-25V
C282, C297, C299, C306, C309, C312, C319: 3000pF; C_0402_1005Metric; PartsBoxID 0402-3000pF-X7R-10V
C292: 1500pF; C_0402_1005Metric; PartsBoxID 0402-1500pF-X7R-25V
C310, C313: 4.7uF; C_0805_2012Metric; PartsBoxID 0805-4.7uF-X7R-25V
C311, C314: .47uF; C_0603_1608Metric; PartsBoxID 0603-.47uF-X7R-25V
C322, C324, C328, C330: 1uF; C_0201_0603Metric; PartsBoxID 0201-1uF-X5R-6.3V
FB7, FB8, FB9, FB10, FB11, FB12, FB13, FB14, FB15, FB16, FB17, FB18, FB19: 120 OHM 3A; L_0603_1608Metric; PartsBoxID 0603-120R-3A
JP1, JP2, JP3: SolderJumper_2_Open; SolderJumper-2_P1.3mm_Open_TrianglePad1.0x1.5mm
R148, R149, R150, R151, R154: 330; R_0402_1005Metric; PartsBoxID 0402-330R-1%
R152, R153: 0R33; R_0402_1005Metric; PartsBoxID 0402-0R33-1%
R155, R156, R157, R160: 5.1; R_0402_1005Metric; PartsBoxID 0402-5R1-1%
R158, R159: 10; R_0402_1005Metric; PartsBoxID 0402-10R-1%
U7: LS1043ASE7xxx; BGA621C80P25X25_2100X2100X192N; PartsBoxID LS1043ASE7

Connections:
/1V8: C178.2, C179.2, C180.2, C181.2, C182.2, C183.2, C184.2, C185.2, C209.2, C210.2, C212.1, C213.2, FB7.1, FB8.1, FB19.1, JP1.1, JP2.2, R149.1, R155.1, R156.1, R157.1, R160.1, U7.J12 (OVDD1), U7.J13 (OVDD2), U7.J14 (OVDD3), U7.J15 (OVDD4), U7.J16 (OVDD5), U7.J17 (OVDD6), U7.N7 (0VDD7), U7.T6 (TH_VDD); also elsewhere on the board
/3V3: C231.2, C232.2, C233.2, FB17.1, FB18.1, U7.K8 (DVDD1), U7.L8 (DVVD2); also elsewhere on the board
/CPU Power/EVDD: C249.2, C250.2, FB7.2, U7.M8 (EVDD)
/CPU_VDD_SENSE: C215.2, C216.2, C217.2, C218.2, C219.2, C220.2, C221.2, C222.1, C223.2, C224.2, C225.2, C226.2, C227.2, C228.2, C229.2, C230.2, C234.2, C235.2, C236.2, C237.2, C238.2, C239.2, C240.2, C241.2, C242.2, C243.2, C244.2, C245.2, C246.2, C247.2, C248.2, C251.2, C252.2, C253.2, C254.2, C255.2, C256.2, C257.2, C258.2, C259.2, C260.2, C261.2, C262.2, C263.2, C264.2, C265.2, C266.2, C267.2, C268.2, C269.2, C270.2, C271.2, C272.2, C315.2, C316.2, FB9.1, FB11.1, FB13.1, FB14.1, FB15.1, FB16.1, JP3.2 (B), R154.2, R159.2, U7.H20 (TA_BB_VDD), U7.K13 (VDD01), U7.K15 (VDD02), U7.K17 (VDD03), U7.L10 (VDD04), U7.L12 (VDD05), U7.L14 (VDD06), U7.L16 (VDD07), U7.M9 (VDD08), U7.M11 (VDD09), U7.M13 (VDD10), U7.M15 (VDD11), U7.M17 (VDD12), U7.N8 (VDD13), U7.N10 (VDD14), U7.N12 (VDD15), U7.N14 (VDD16), U7.N16 (VDD17), U7.P9 (VDD18), U7.P11 (VDD19), U7.P13 (VDD20), U7.P15 (VDD21), U7.P17 (VDD22), U7.R8 (VDD23), U7.R10 (VDD24), U7.R12 (VDD25), U7.R14 (VDD26), U7.R16 (VDD27), U7.R18 (VDD28), U7.T9 (VDD29), U7.T11 (VDD30), U7.T13 (VDD31), U7.U8 (VDD32), U7.U10 (VDD33); also elsewhere on the board
/GVDD: C169.1, C170.2, C171.2, C172.2, C173.2, C174.2, C175.2, C176.2, C177.2, C186.2, C187.2, C188.2, C189.2, C190.2, C191.2, C192.2, C193.2, C194.2, C195.2, C196.2, C197.2, C198.2, C199.2, C200.2, C201.2, C202.2, C203.2, C204.2, C205.2, C206.2, C207.2, C208.2, U7.AA20 (G1VDD18), U7.AB22 (G1VDD19), U7.AB24 (G1VDD20), U7.AD22 (G1VDD21), U7.AD25 (G1VDD22), U7.AE24 (G1VDD23), U7.J18 (G1VDD01), U7.K18 (G1VDD02), U7.K20 (G1VDD03), U7.L18 (G1VDD04), U7.M18 (G1VDD05), U7.M20 (G1VDD06), U7.N18 (G1VDD07), U7.P18 (G1VDD08), U7.P20 (G1VDD09), U7.R21 (G1VDD10), U7.R23 (G1VDD11), U7.T22 (G1VDD12), U7.T24 (G1VDD13), U7.V22 (G1VDD14), U7.V24 (G1VDD15), U7.Y22 (G1VDD16), U7.Y24 (G1VDD17); also elsewhere on the board
/PWR_X1VDD: C294.2, C303.2, C304.2, FB10.2, FB12.2; also elsewhere on the board
/S1VDD: C280.2, C281.2, C282.2, C283.2, C284.2, C285.2, C286.2, C287.2, C288.2, FB9.2, FB11.2, U7.T15 (S1VDD1), U7.T16 (S1VDD2), U7.T17 (S1VDD3), U7.T18 (S1VDD4), U7.W14 (S1VDD5); also elsewhere on the board
/X1VDD: C289.2, C290.2, C291.2, C292.2, C293.2, C295.2, C296.2, C297.2, C302.2, FB10.1, FB12.1, R152.2, R153.2, U7.W15 (X1VDD1), U7.W16 (X1VDD2), U7.W17 (X1VDD3), U7.W18 (X1VDD4), U7.Y19 (X1VDD5); also elsewhere on the board
unnamed: C211.2, JP1.2, R148.2, U7.G14 (PROG_MTR)
unnamed: C214.2, JP2.1, R150.2, U7.F14 (TA_PROG_SEP)
unnamed: C273.2, C274.2, C275.2, C276.2, C277.2, FB8.2, U7.U12 (LVDD1), U7.U13 (LVDD2), U7.U14 (LVDD3)
unnamed: C278.2, C279.2, JP3.1 (A), R151.2, U7.R7 (FA_VL)
unnamed: C298.2, C299.2, C300.2, C301.2, FB13.2, FB14.2, U7.J10 (USB_SVDD1), U7.J11 (USB_SVDD2)
unnamed: C305.2, C306.2, C307.2, C308.2, FB15.2, FB16.2, U7.K9 (USB_SDVDD1), U7.K11 (USB_SDVDD2)
unnamed: C309.2, C310.2, C311.2, R152.1, U7.W12 (AVDD_SD1_PLL1)
unnamed: C312.2, C313.2, C314.2, R153.1, U7.V19 (AVDD_SD1_PLL2)
unnamed: C317.2, C318.2, C319.2, C320.2, FB17.2, FB18.2, U7.J8 (USB_HVDD1), U7.J9 (USB_HVDD2)
unnamed: C321.2, C322.2, R155.2, U7.G12 (AVDD_CGA1)
unnamed: C323.2, C324.2, R156.2, U7.G11 (AVDD_CGA2)
unnamed: C325.2, C326.2, FB19.2, U7.V6 (TVDD)
unnamed: C327.2, C328.2, R157.2, U7.G13 (AVDD_PLAT)
unnamed: C329.2, C330.2, R160.2, U7.T19 (AVDD_D1)
unnamed: R158.1, U7.V7 (SENSEGND)
unnamed: R159.1, U7.W7 (SENSEVDD)
