imagestream/kicad/AP2100.ls1043/AP2100.kicad_pcb

## KiCad design AP2100.ls1043/AP2100.kicad_pcb (continued)

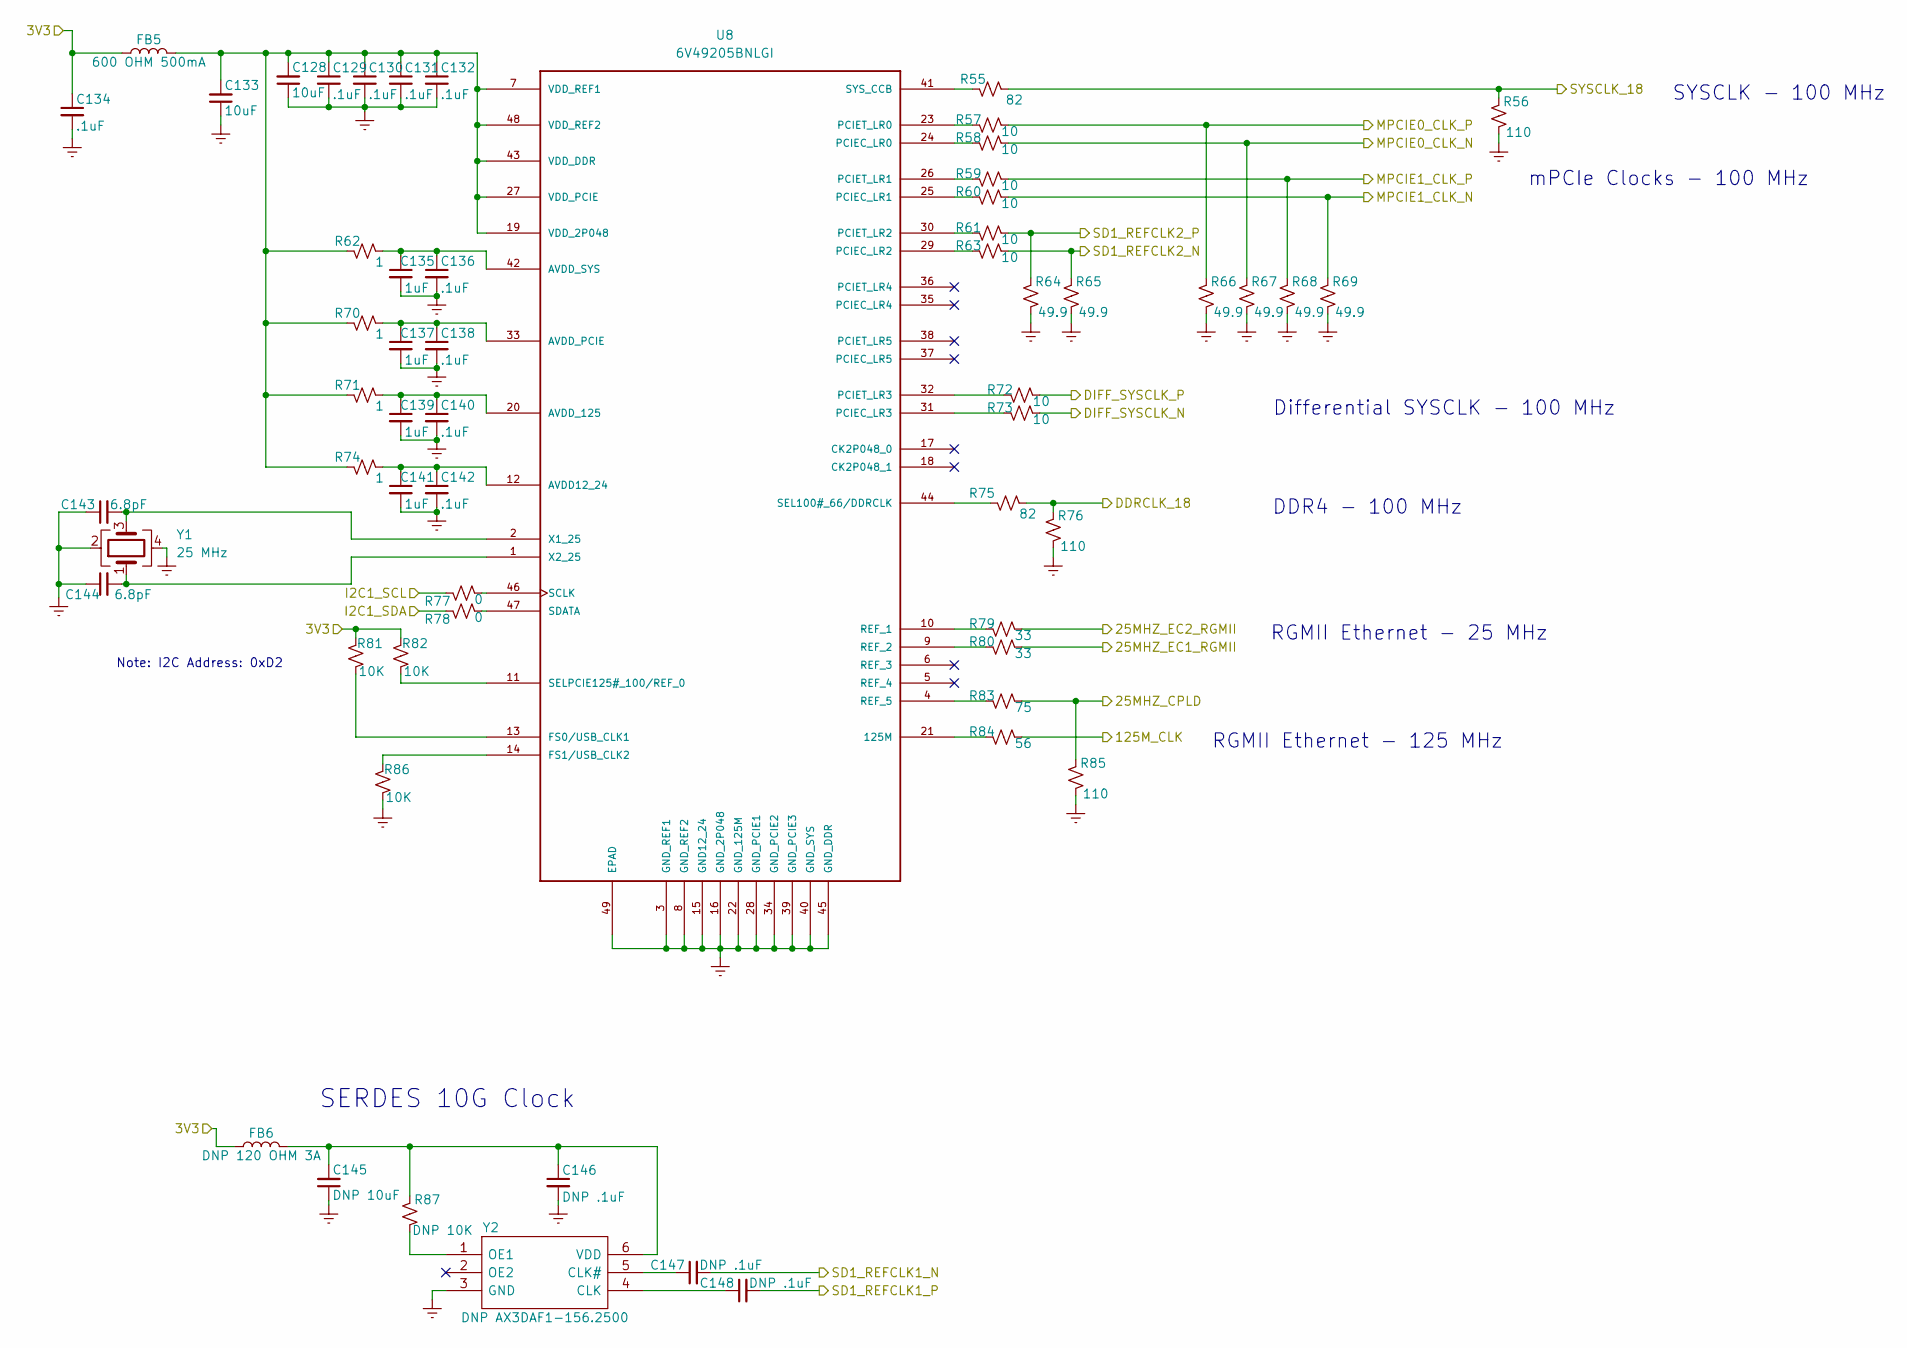
[picture p128: schematic clock.kicad_sch, AP2100]

Parts:
C128, C133: 10uF; C_0805_2012Metric; PartsBoxID 0805-10uF-X7R-6.3V
C129, C130, C131, C132, C134, C136, C138, C140, C142: .1uF; C_0402_1005Metric; PartsBoxID 0402-.1uF-X5R-25V
C135, C137, C139, C141: 1uF; C_0402_1005Metric; PartsBoxID 0402-1uF-X5R-25V
C143, C144: 6.8pF; C_0402_1005Metric; PartsBoxID 0402-6.8pF-C0G-25V
C145: DNP 10uF; C_0805_2012Metric; PartsBoxID 0805-10uF-X7R-6.3V
C146, C147, C148: DNP .1uF; C_0402_1005Metric; PartsBoxID 0402-.1uF-X5R-25V
FB5: 600 OHM 500mA; L_0603_1608Metric; PartsBoxID 0603-600R-500mA
FB6: DNP 120 OHM 3A; L_0603_1608Metric; PartsBoxID 0603-120R-3A
R55, R75: 82; R_0402_1005Metric; PartsBoxID 0402-82R-1%
R56, R76, R85: 110; R_0402_1005Metric; PartsBoxID 0402-110R-1%
R57, R58, R59, R60, R61, R63, R72, R73: 10; R_0402_1005Metric; PartsBoxID 0402-10R-1%
R62, R70, R71, R74: 1; R_0402_1005Metric; PartsBoxID 0402-1R-1%
R64, R65, R66, R67, R68, R69: 49.9; R_0402_1005Metric; PartsBoxID 0402-49.9-1%
R77, R78: 0; R_0402_1005Metric; PartsBoxID 0402-0R-1%
R79, R80: 33; R_0402_1005Metric; PartsBoxID 0402-33R-1%
R81, R82, R86: 10K; R_0402_1005Metric; PartsBoxID 0402-10K-1%
R83: 75; R_0402_1005Metric; PartsBoxID 0402-75R-1%
R84: 56; R_0402_1005Metric; PartsBoxID 0402-56R-1%
R87: DNP 10K; R_0402_1005Metric; PartsBoxID 0402-10K-1%
U8: 6V49205BNLGI; QFP50P700X700X90-49N; PartsBoxID 6V49205BNLGI
Y1: 25 MHz; Crystal_SMD_3225-4Pin_3.2x2.5mm; PartsBoxID ABM8W-25.0000MHZ-7-D1X-T3
Y2: DNP AX3DAF1-156.2500; AX3DCF11562500; Manufacturer_Part_Number AX3DAF1-156.2500

Connections:
/3V3: C134.1, FB5.2, FB6.1, R81.1, R82.1; also elsewhere on the board
/25MHZ_CPLD: R83.2, R85.2
/25MHZ_EC1_RGMII: R80.2; also elsewhere on the board
/25MHZ_EC2_RGMII: R79.2; also elsewhere on the board
/125M_CLK: R84.2; also elsewhere on the board
/DDRCLK_18: R75.2, R76.2; also elsewhere on the board
/DIFF_SYSCLK_N: R73.2; also elsewhere on the board
/DIFF_SYSCLK_P: R72.2; also elsewhere on the board
/I2C1_SCL: R77.1; also elsewhere on the board
/I2C1_SDA: R78.1; also elsewhere on the board
/MPCIE0_CLK_N: R58.2, R67.2; also elsewhere on the board
/MPCIE0_CLK_P: R57.2, R66.2; also elsewhere on the board
/MPCIE1_CLK_N: R60.2, R69.2; also elsewhere on the board
/MPCIE1_CLK_P: R59.2, R68.2; also elsewhere on the board
/SD1_REFCLK1_N: C147.2; also elsewhere on the board
/SD1_REFCLK1_P: C148.2; also elsewhere on the board
/SD1_REFCLK2_N: R63.2, R65.2; also elsewhere on the board
/SD1_REFCLK2_P: R61.2, R64.2; also elsewhere on the board
/SYSCLK_18: R55.2, R56.2; also elsewhere on the board
unnamed: C128.2, C129.1, C130.1, C131.1, C132.1, C133.2, FB5.1, R62.1, R70.1, R71.1, R74.1, U8.7 (VDD_REF1), U8.19 (VDD_2P048), U8.27 (VDD_PCIE), U8.43 (VDD_DDR), U8.48 (VDD_REF2)
unnamed: C135.1, C136.1, R62.2, U8.42 (AVDD_SYS)
unnamed: C137.1, C138.1, R70.2, U8.33 (AVDD_PCIE)
unnamed: C139.1, C140.1, R71.2, U8.20 (AVDD_125)
unnamed: C141.1, C142.1, R74.2, U8.12 (AVDD12_24)
unnamed: C143.2, U8.2 (X1_25), Y1.3
unnamed: C144.2, U8.1 (X2_25), Y1.1
unnamed: C145.2, C146.1, FB6.2, R87.2, Y2.6 (VDD)
unnamed: C147.1, Y2.5 (CLK#)
unnamed: C148.1, Y2.4 (CLK)
unnamed: R55.1, U8.41 (SYS_CCB)
unnamed: R57.1, U8.23 (PCIET_LR0)
unnamed: R58.1, U8.24 (PCIEC_LR0)
unnamed: R59.1, U8.26 (PCIET_LR1)
unnamed: R60.1, U8.25 (PCIEC_LR1)
unnamed: R61.1, U8.30 (PCIET_LR2)
unnamed: R63.1, U8.29 (PCIEC_LR2)
unnamed: R72.1, U8.32 (PCIET_LR3)
unnamed: R73.1, U8.31 (PCIEC_LR3)
unnamed: R75.1, U8.44 (SEL100#_66/DDRCLK)
unnamed: R77.2, U8.46 (SCLK)
unnamed: R78.2, U8.47 (SDATA)
unnamed: R79.1, U8.10 (REF_1)
unnamed: R80.1, U8.9 (REF_2)
unnamed: R81.2, U8.13 (FS0/USB_CLK1)
unnamed: R82.2, U8.11 (SELPCIE125#_100/REF_0)
unnamed: R83.1, U8.4 (REF_5)
unnamed: R84.1, U8.21 (125M)
unnamed: R86.1, U8.14 (FS1/USB_CLK2)
unnamed: R87.1, Y2.1 (OE1)

Notes on the sheet:
Note: I2C Address: 0xD2
SERDES 10G Clock
DDR4 - 100 MHz
RGMII Ethernet - 125 MHz
RGMII Ethernet - 25 MHz
Differential SYSCLK - 100 MHz
mPCIe Clocks - 100 MHz
SYSCLK - 100 MHz

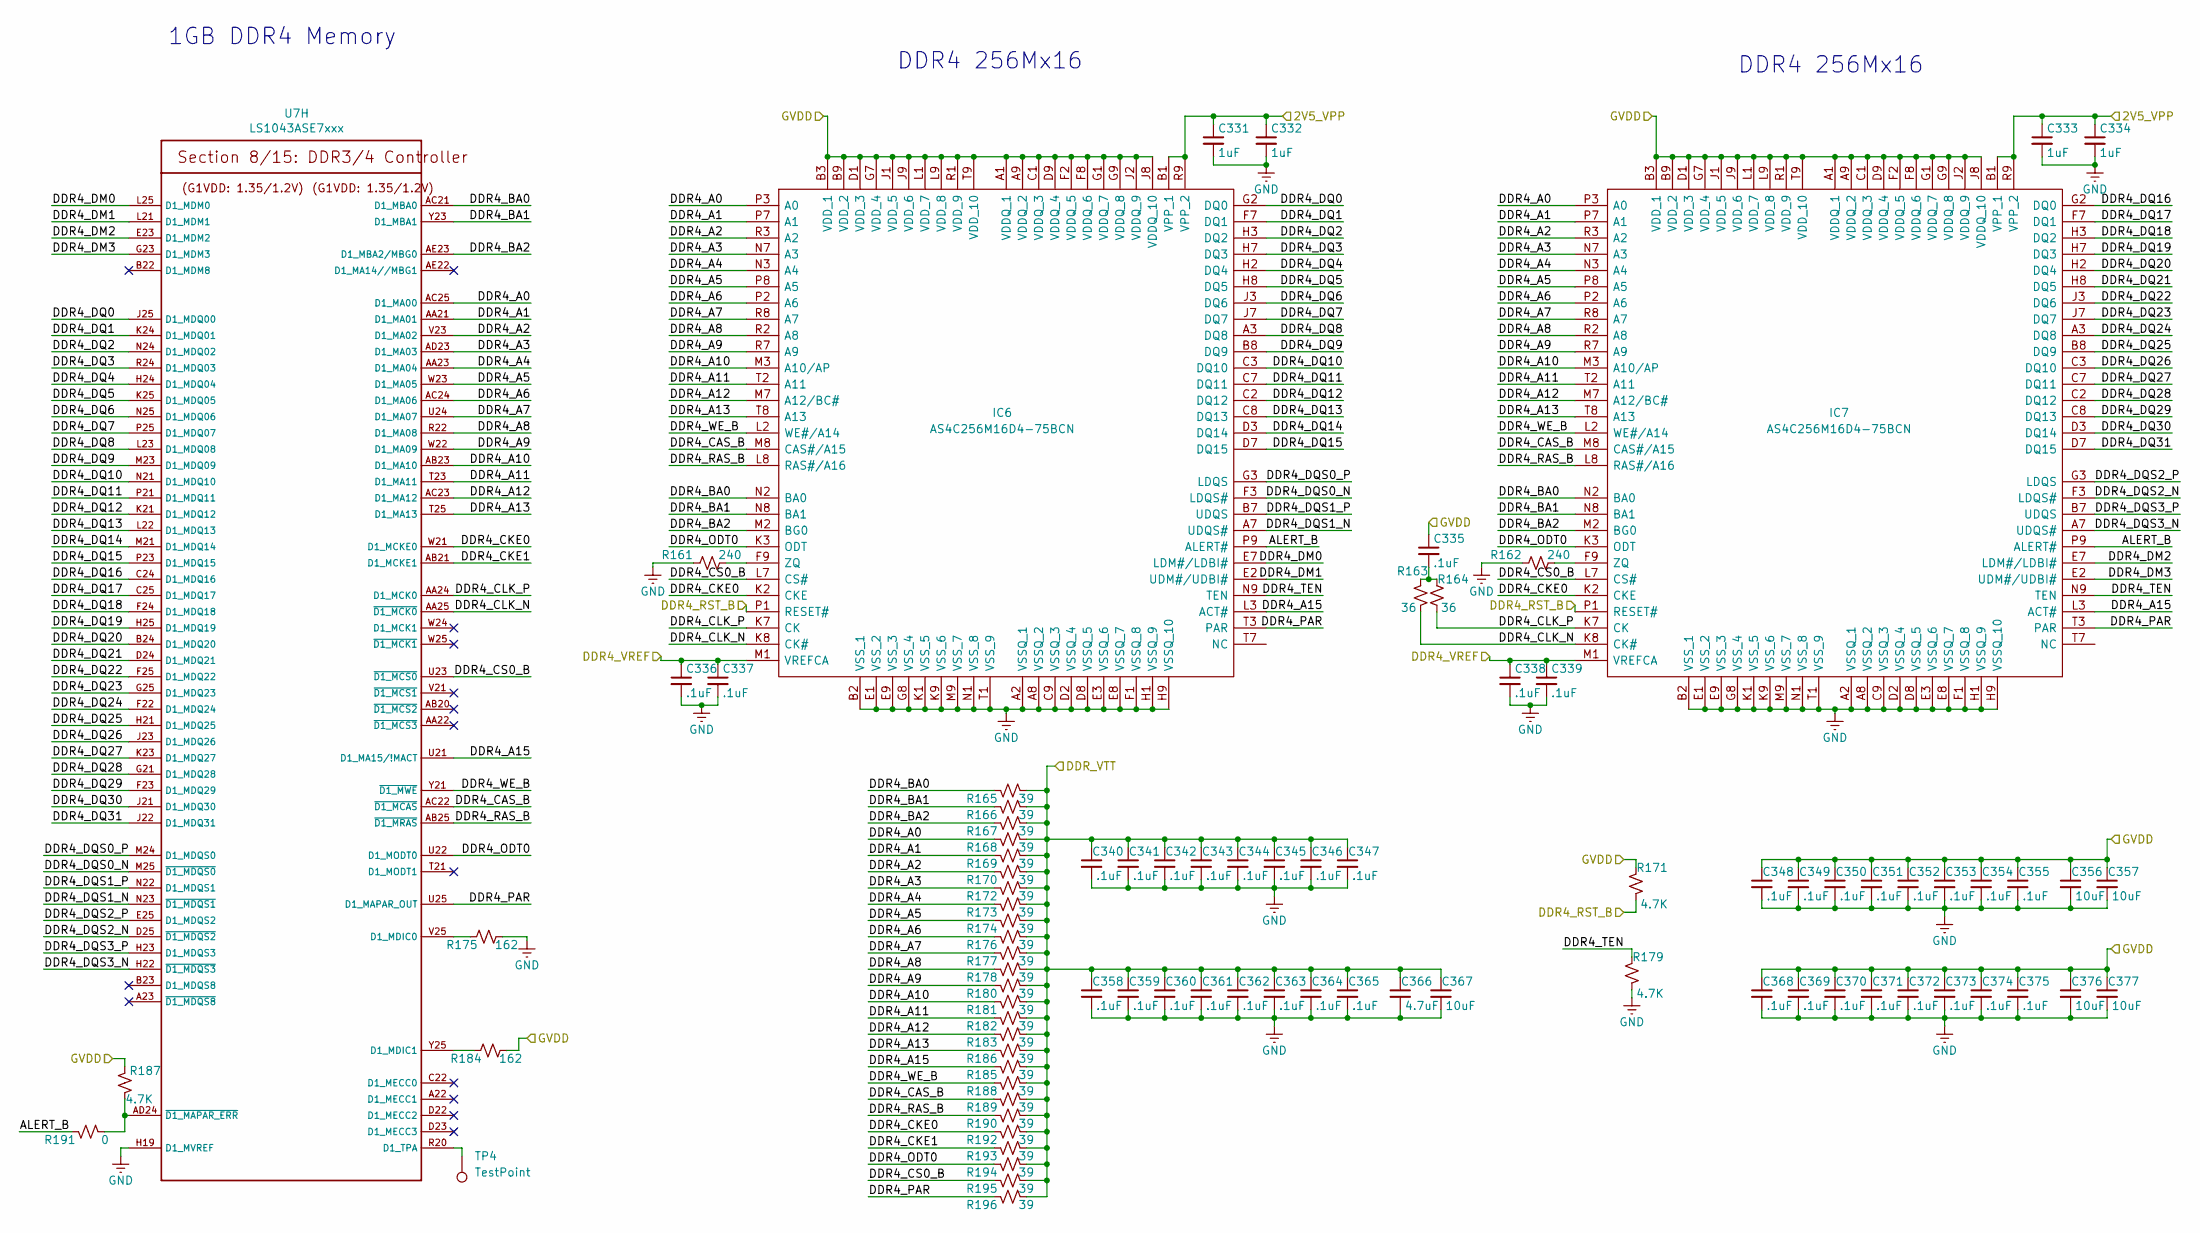
[picture p129: schematic CPU_memory.kicad_sch, AP2100]

Parts:
C331, C332, C333, C334: 1uF; C_0402_1005Metric; PartsBoxID 0402-1uF-X7R-6.3V
C335, C336, C337, C338, C339, C340, C341, C342, C343, C344, C345, C346, C347, C348, C349, C350, C351, C352, C353, C354, C355, C358, C359, C360, C361, C362, C363, C364, C365, C368, C369, C370, C371, C372, C373, C374, C375: .1uF; C_0402_1005Metric; PartsBoxID 0402-.1uF-X7R-6.3V
C356, C357, C367, C376, C377: 10uF; C_0805_2012Metric; PartsBoxID 0805-10uF-X7R-6.3V
C366: 4.7uF; C_0805_2012Metric; PartsBoxID 0805-4.7uF-X7R-25V
IC6, IC7: AS4C256M16D4-75BCN; BGA96C80P9X16_750X1350X120; Manufacturer_Part_Number AS4C256M16D4-75BINTR; Mouser Part Number 913-256M16D4-75BINTR
R161, R162: 240; R_0402_1005Metric; PartsBoxID 0402-240R-1%
R163, R164: 36; R_0402_1005Metric; PartsBoxID 0402-36R-1%
R165, R166, R167, R168, R169, R170, R172, R173, R174, R176, R177, R178, R180, R181, R182, R183, R185, R186, R188, R189, R190, R192, R193, R194, R195, R196: 39; R_0402_1005Metric; PartsBoxID 0402-39R-1%
R171, R179, R187: 4.7K; R_0402_1005Metric; PartsBoxID 0402-4.7K-1%
R175, R184: 162; R_0402_1005Metric; PartsBoxID 0402-162R-1%
R191: 0; R_0402_1005Metric; PartsBoxID 0402-0R-1%
TP4: TestPoint; TestPoint_Pad_D1.0mm
U7: LS1043ASE7xxx; BGA621C80P25X25_2100X2100X192N; PartsBoxID LS1043ASE7

Connections:
/2V5_VPP: C331.1, C332.1, C333.1, C334.1, IC6.B1 (VPP_1), IC6.R9 (VPP_2), IC7.B1 (VPP_1), IC7.R9 (VPP_2); also elsewhere on the board
/DDR4 Memory/ALERT_B: IC6.P9 (ALERT#), IC7.P9 (ALERT#), R191.2
/DDR4 Memory/DDR4_A0: IC6.P3 (A0), IC7.P3 (A0), R168.1, U7.AC25 (D1_MA00)
/DDR4 Memory/DDR4_A1: IC6.P7 (A1), IC7.P7 (A1), R169.1, U7.AA21 (D1_MA01)
/DDR4 Memory/DDR4_A2: IC6.R3 (A2), IC7.R3 (A2), R170.1, U7.V23 (D1_MA02)
/DDR4 Memory/DDR4_A3: IC6.N7 (A3), IC7.N7 (A3), R172.1, U7.AD23 (D1_MA03)
/DDR4 Memory/DDR4_A4: IC6.N3 (A4), IC7.N3 (A4), R173.1, U7.AA23 (D1_MA04)
/DDR4 Memory/DDR4_A5: IC6.P8 (A5), IC7.P8 (A5), R174.1, U7.W23 (D1_MA05)
/DDR4 Memory/DDR4_A6: IC6.P2 (A6), IC7.P2 (A6), R176.1, U7.AC24 (D1_MA06)
/DDR4 Memory/DDR4_A7: IC6.R8 (A7), IC7.R8 (A7), R177.1, U7.U24 (D1_MA07)
/DDR4 Memory/DDR4_A8: IC6.R2 (A8), IC7.R2 (A8), R178.1, U7.R22 (D1_MA08)
/DDR4 Memory/DDR4_A9: IC6.R7 (A9), IC7.R7 (A9), R180.1, U7.W22 (D1_MA09)
/DDR4 Memory/DDR4_A10: IC6.M3 (A10/AP), IC7.M3 (A10/AP), R181.1, U7.AB23 (D1_MA10)
/DDR4 Memory/DDR4_A11: IC6.T2 (A11), IC7.T2 (A11), R182.1, U7.T23 (D1_MA11)
/DDR4 Memory/DDR4_A12: IC6.M7 (A12/BC#), IC7.M7 (A12/BC#), R183.1, U7.AC23 (D1_MA12)
/DDR4 Memory/DDR4_A13: IC6.T8 (A13), IC7.T8 (A13), R185.1, U7.T25 (D1_MA13)
/DDR4 Memory/DDR4_A15: IC6.L3 (ACT#), IC7.L3 (ACT#), R186.1, U7.U21 (D1_MA15/!MACT)
/DDR4 Memory/DDR4_BA0: IC6.N2 (BA0), IC7.N2 (BA0), R165.1, U7.AC21 (D1_MBA0)
/DDR4 Memory/DDR4_BA1: IC6.N8 (BA1), IC7.N8 (BA1), R166.1, U7.Y23 (D1_MBA1)
/DDR4 Memory/DDR4_BA2: IC6.M2 (BG0), IC7.M2 (BG0), R167.1, U7.AE23 (D1_MBA2/MBG0)
/DDR4 Memory/DDR4_CAS_B: IC6.M8 (CAS#/A15), IC7.M8 (CAS#/A15), R189.1, U7.AC22 (~D1_MCAS~)
/DDR4 Memory/DDR4_CKE0: IC6.K2 (CKE), IC7.K2 (CKE), R192.1, U7.W21 (D1_MCKE0)
/DDR4 Memory/DDR4_CKE1: R193.1, U7.AB21 (D1_MCKE1)
/DDR4 Memory/DDR4_CLK_N: IC6.K8 (CK#), IC7.K8 (CK#), R163.1, U7.AA25 (~D1_MCK0~)
/DDR4 Memory/DDR4_CLK_P: IC6.K7 (CK), IC7.K7 (CK), R164.1, U7.AA24 (D1_MCK0)
/DDR4 Memory/DDR4_CS0_B: IC6.L7 (CS#), IC7.L7 (CS#), R195.1, U7.U23 (~D1_MCS0~)
/DDR4 Memory/DDR4_DM0: IC6.E7 (LDM#/LDBI#), U7.L25 (D1_MDM0)
/DDR4 Memory/DDR4_DM1: IC6.E2 (UDM#/UDBI#), U7.L21 (D1_MDM1)
/DDR4 Memory/DDR4_DM2: IC7.E7 (LDM#/LDBI#), U7.E23 (D1_MDM2)
/DDR4 Memory/DDR4_DM3: IC7.E2 (UDM#/UDBI#), U7.G23 (D1_MDM3)
/DDR4 Memory/DDR4_DQ0: IC6.G2 (DQ0), U7.J25 (D1_MDQ00)
/DDR4 Memory/DDR4_DQ1: IC6.F7 (DQ1), U7.K24 (D1_MDQ01)
/DDR4 Memory/DDR4_DQ2: IC6.H3 (DQ2), U7.N24 (D1_MDQ02)
/DDR4 Memory/DDR4_DQ3: IC6.H7 (DQ3), U7.R24 (D1_MDQ03)
/DDR4 Memory/DDR4_DQ4: IC6.H2 (DQ4), U7.H24 (D1_MDQ04)
/DDR4 Memory/DDR4_DQ5: IC6.H8 (DQ5), U7.K25 (D1_MDQ05)
/DDR4 Memory/DDR4_DQ6: IC6.J3 (DQ6), U7.N25 (D1_MDQ06)
/DDR4 Memory/DDR4_DQ7: IC6.J7 (DQ7), U7.P25 (D1_MDQ07)
/DDR4 Memory/DDR4_DQ8: IC6.A3 (DQ8), U7.L23 (D1_MDQ08)
/DDR4 Memory/DDR4_DQ9: IC6.B8 (DQ9), U7.M23 (D1_MDQ09)
/DDR4 Memory/DDR4_DQ10: IC6.C3 (DQ10), U7.N21 (D1_MDQ10)
/DDR4 Memory/DDR4_DQ11: IC6.C7 (DQ11), U7.P21 (D1_MDQ11)
/DDR4 Memory/DDR4_DQ12: IC6.C2 (DQ12), U7.K21 (D1_MDQ12)
/DDR4 Memory/DDR4_DQ13: IC6.C8 (DQ13), U7.L22 (D1_MDQ13)
/DDR4 Memory/DDR4_DQ14: IC6.D3 (DQ14), U7.M21 (D1_MDQ14)
/DDR4 Memory/DDR4_DQ15: IC6.D7 (DQ15), U7.P23 (D1_MDQ15)
/DDR4 Memory/DDR4_DQ16: IC7.G2 (DQ0), U7.C24 (D1_MDQ16)
/DDR4 Memory/DDR4_DQ17: IC7.F7 (DQ1), U7.C25 (D1_MDQ17)
/DDR4 Memory/DDR4_DQ18: IC7.H3 (DQ2), U7.F24 (D1_MDQ18)
/DDR4 Memory/DDR4_DQ19: IC7.H7 (DQ3), U7.H25 (D1_MDQ19)
/DDR4 Memory/DDR4_DQ20: IC7.H2 (DQ4), U7.B24 (D1_MDQ20)
/DDR4 Memory/DDR4_DQ21: IC7.H8 (DQ5), U7.D24 (D1_MDQ21)
/DDR4 Memory/DDR4_DQ22: IC7.J3 (DQ6), U7.F25 (D1_MDQ22)
/DDR4 Memory/DDR4_DQ23: IC7.J7 (DQ7), U7.G25 (D1_MDQ23)
/DDR4 Memory/DDR4_DQ24: IC7.A3 (DQ8), U7.F22 (D1_MDQ24)
/DDR4 Memory/DDR4_DQ25: IC7.B8 (DQ9), U7.H21 (D1_MDQ25)
/DDR4 Memory/DDR4_DQ26: IC7.C3 (DQ10), U7.J23 (D1_MDQ26)
/DDR4 Memory/DDR4_DQ27: IC7.C7 (DQ11), U7.K23 (D1_MDQ27)
/DDR4 Memory/DDR4_DQ28: IC7.C2 (DQ12), U7.G21 (D1_MDQ28)
/DDR4 Memory/DDR4_DQ29: IC7.C8 (DQ13), U7.F23 (D1_MDQ29)
/DDR4 Memory/DDR4_DQ30: IC7.D3 (DQ14), U7.J21 (D1_MDQ30)
/DDR4 Memory/DDR4_DQ31: IC7.D7 (DQ15), U7.J22 (D1_MDQ31)
/DDR4 Memory/DDR4_DQS0_N: IC6.F3 (LDQS#), U7.M25 (~D1_MDQS0~)
/DDR4 Memory/DDR4_DQS0_P: IC6.G3 (LDQS), U7.M24 (D1_MDQS0)
/DDR4 Memory/DDR4_DQS1_N: IC6.A7 (UDQS#), U7.N23 (~D1_MDQS1~)
/DDR4 Memory/DDR4_DQS1_P: IC6.B7 (UDQS), U7.N22 (D1_MDQS1)
/DDR4 Memory/DDR4_DQS2_N: IC7.F3 (LDQS#), U7.D25 (~D1_MDQS2~)
/DDR4 Memory/DDR4_DQS2_P: IC7.G3 (LDQS), U7.E25 (D1_MDQS2)
/DDR4 Memory/DDR4_DQS3_N: IC7.A7 (UDQS#), U7.H22 (~D1_MDQS3~)
/DDR4 Memory/DDR4_DQS3_P: IC7.B7 (UDQS), U7.H23 (D1_MDQS3)
/DDR4 Memory/DDR4_ODT0: IC6.K3 (ODT), IC7.K3 (ODT), R194.1, U7.U22 (D1_MODT0)
/DDR4 Memory/DDR4_PAR: IC6.T3 (PAR), IC7.T3 (PAR), R196.1, U7.U25 (D1_MAPAR_OUT)
/DDR4 Memory/DDR4_RAS_B: IC6.L8 (RAS#/A16), IC7.L8 (RAS#/A16), R190.1, U7.AB25 (~D1_MRAS~)
/DDR4 Memory/DDR4_TEN: IC6.N9 (TEN), IC7.N9 (TEN), R179.1
/DDR4 Memory/DDR4_WE_B: IC6.L2 (WE#/A14), IC7.L2 (WE#/A14), R188.1, U7.Y21 (~D1_MWE~)
/DDR4_RST_B: IC6.P1 (RESET#), IC7.P1 (RESET#), R171.2; also elsewhere on the board
/DDR_VREF: C336.1, C337.1, C338.1, C339.1, IC6.M1 (VREFCA), IC7.M1 (VREFCA); also elsewhere on the board
/DDR_VTT: C340.1, C341.1, C342.1, C343.1, C344.1, C345.1, C346.1, C347.1, C358.1, C359.1, C360.1, C361.1, C362.1, C363.1, C364.1, C365.1, C366.1, C367.1, R165.2, R166.2, R167.2, R168.2, R169.2, R170.2, R172.2, R173.2, R174.2, R176.2, R177.2, R178.2, R180.2, R181.2, R182.2, R183.2, R185.2, R186.2, R188.2, R189.2, R190.2, R192.2, R193.2, R194.2, R195.2, R196.2; also elsewhere on the board
/GVDD: C335.1, C348.1, C349.1, C350.1, C351.1, C352.1, C353.1, C354.1, C355.1, C356.1, C357.1, C368.1, C369.1, C370.1, C371.1, C372.1, C373.1, C374.1, C375.1, C376.1, C377.1, IC6.A1 (VDDQ_1), IC6.A9 (VDDQ_2), IC6.B3 (VDD_1), IC6.B9 (VDD_2), IC6.C1 (VDDQ_3), IC6.D1 (VDD_3), IC6.D9 (VDDQ_4), IC6.F2 (VDDQ_5), IC6.F8 (VDDQ_6), IC6.G1 (VDDQ_7), IC6.G7 (VDD_4), IC6.G9 (VDDQ_8), IC6.J1 (VDD_5), IC6.J2 (VDDQ_9), IC6.J8 (VDDQ_10), IC6.J9 (VDD_6), IC6.L1 (VDD_7), IC6.L9 (VDD_8), IC6.R1 (VDD_9), IC6.T9 (VDD_10), IC7.A1 (VDDQ_1), IC7.A9 (VDDQ_2), IC7.B3 (VDD_1), IC7.B9 (VDD_2), IC7.C1 (VDDQ_3), IC7.D1 (VDD_3), IC7.D9 (VDDQ_4), IC7.F2 (VDDQ_5), IC7.F8 (VDDQ_6), IC7.G1 (VDDQ_7), IC7.G7 (VDD_4), IC7.G9 (VDDQ_8), IC7.J1 (VDD_5), IC7.J2 (VDDQ_9), IC7.J8 (VDDQ_10), IC7.J9 (VDD_6), IC7.L1 (VDD_7), IC7.L9 (VDD_8), IC7.R1 (VDD_9), IC7.T9 (VDD_10), R171.1, R184.2, R187.2; also elsewhere on the board
unnamed: C335.2, R163.2, R164.2
unnamed: IC6.F9 (ZQ), R161.2
unnamed: IC7.F9 (ZQ), R162.2
unnamed: R175.1, U7.V25 (D1_MDIC0)
unnamed: R184.1, U7.Y25 (D1_MDIC1)
unnamed: R187.1, R191.1, U7.AD24 (~D1_MAPAR_ERR~)
unnamed: TP4.1, U7.R20 (D1_TPA)

Notes on the sheet:
1GB DDR4 Memory
DDR4 256Mx16

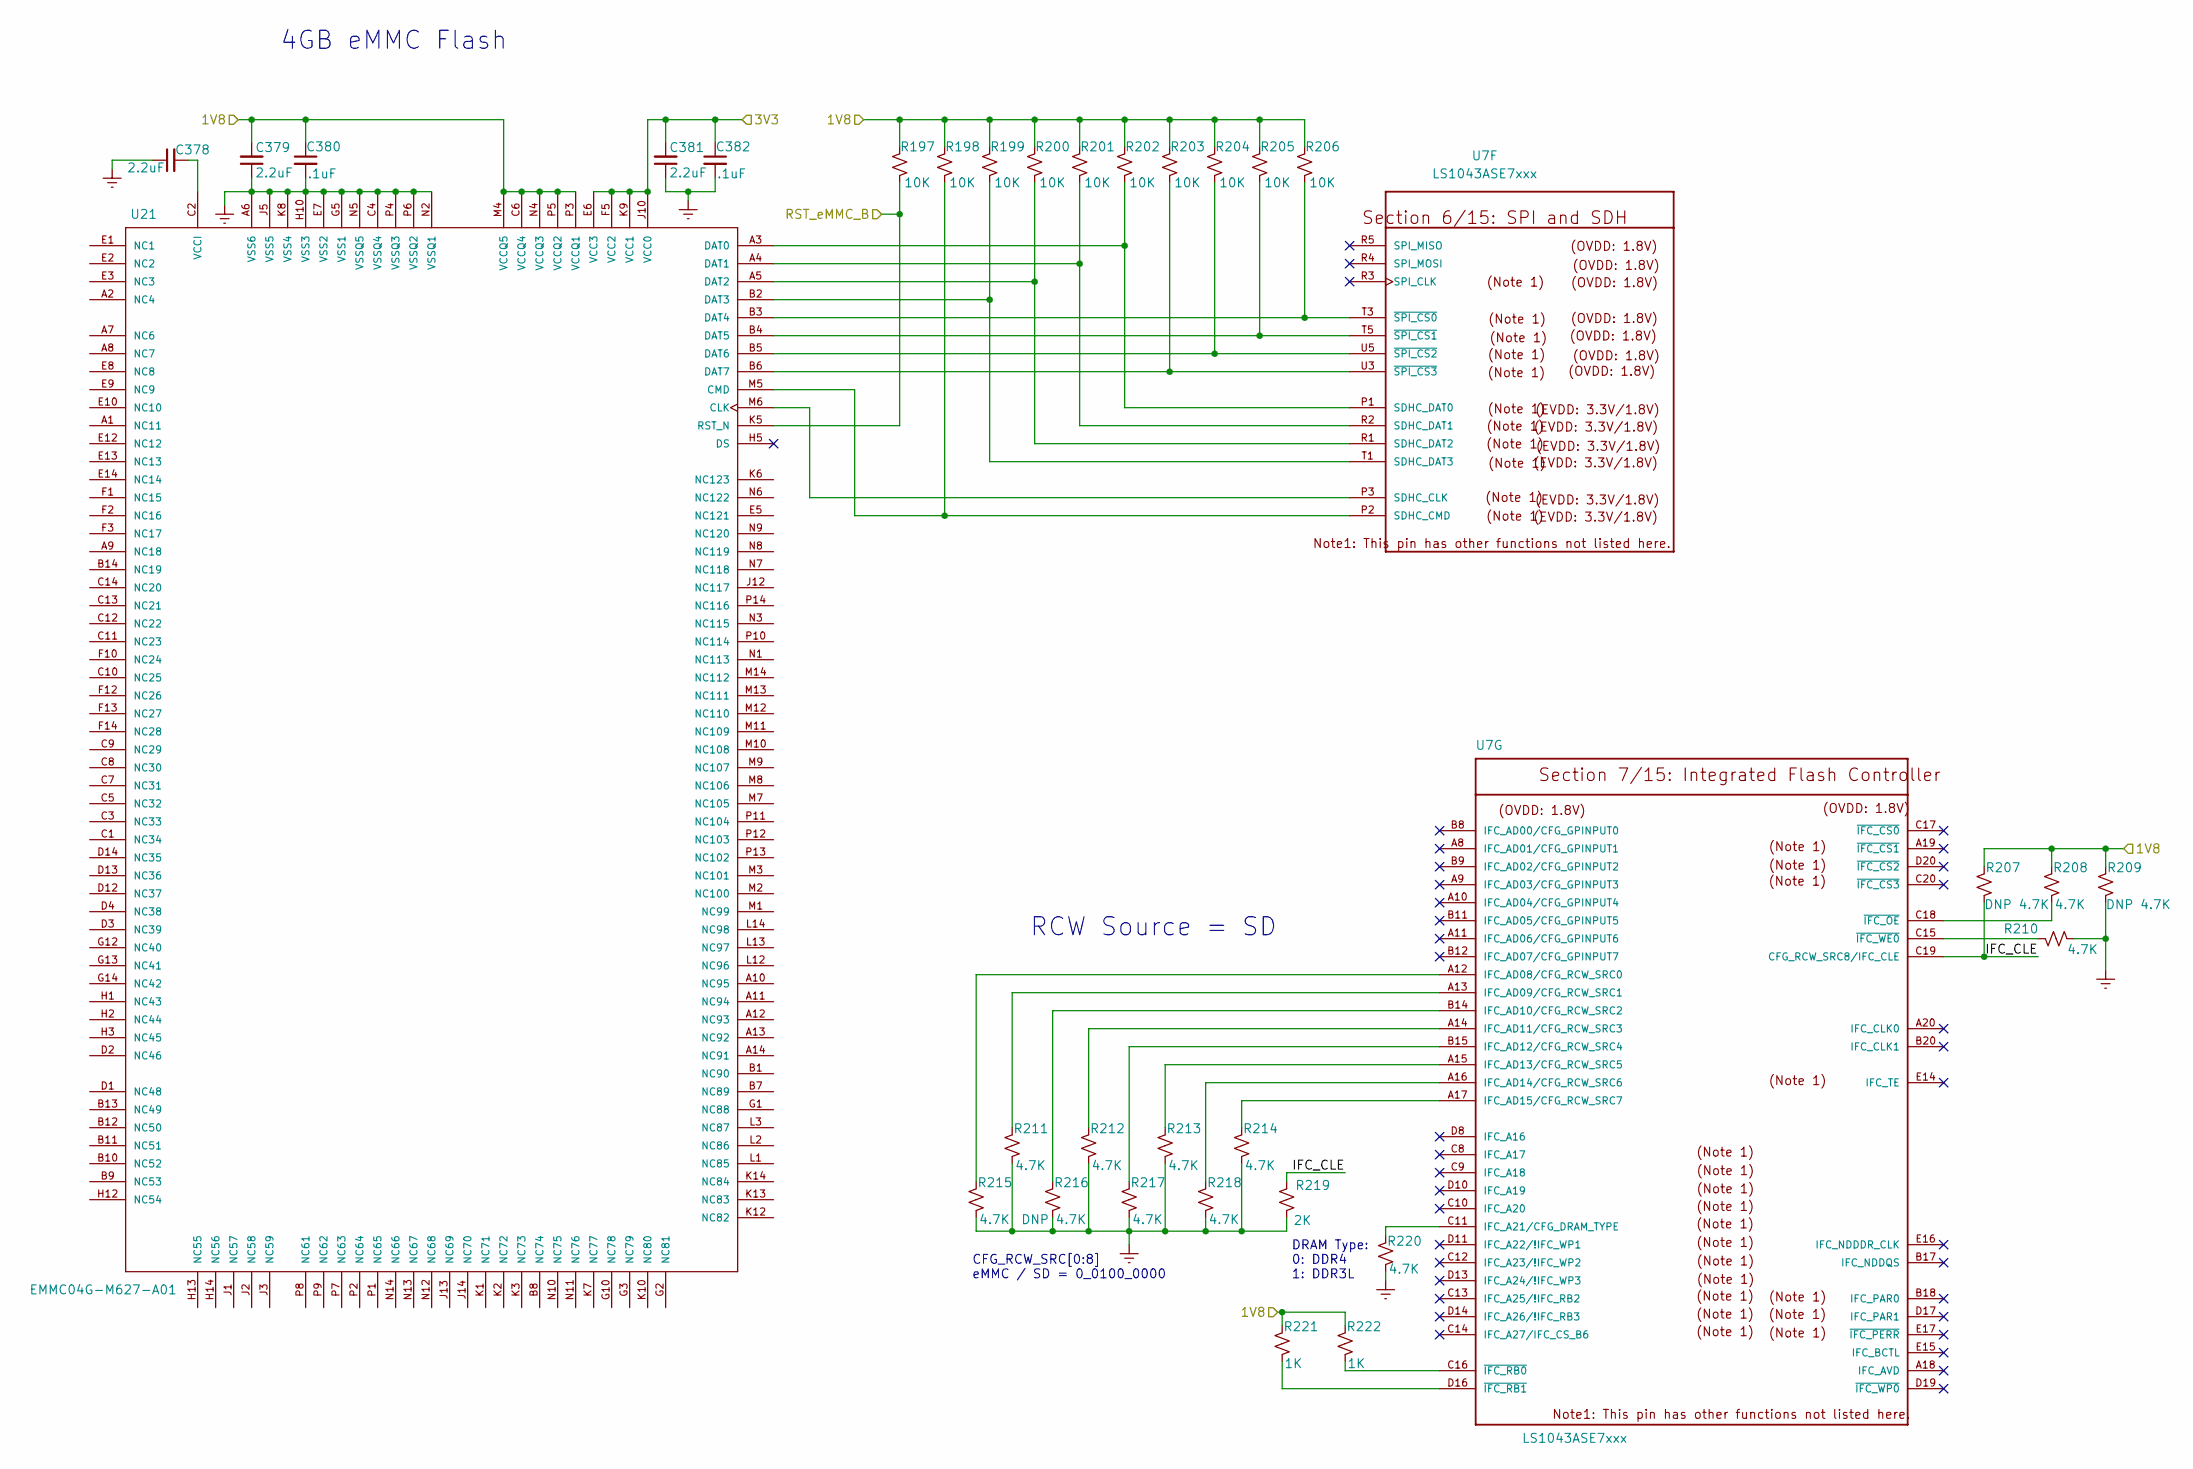
[picture p130: schematic eMMC.kicad_sch, AP2100]

Parts:
C378, C379, C381: 2.2uF; C_0603_1608Metric; PartsBoxID 0603-2.2uF-X5R-16V
C380, C382: .1uF; C_0402_1005Metric; PartsBoxID 0402-.1uF-X7R-6.3V
R197, R198, R199, R200, R201, R202, R203, R204, R205, R206: 10K; R_0402_1005Metric; PartsBoxID 0402-10K-1%
R207, R209, R216: DNP 4.7K; R_0402_1005Metric; PartsBoxID 0402-4.7K-1%
R208, R210, R211, R212, R213, R214, R215, R217, R218, R220: 4.7K; R_0402_1005Metric; PartsBoxID 0402-4.7K-1%
R219: 2K; R_0402_1005Metric; PartsBoxID 0402-2K-1%
R221, R222: 1K; R_0402_1005Metric; PartsBoxID 0402-1K-1%
U7: LS1043ASE7xxx; BGA621C80P25X25_2100X2100X192N; PartsBoxID LS1043ASE7
U21: EMMC04G-M627-A01; BGA153N50P14X14_1300X1150X100N; PartsBoxID EMMC-4GB-WFBGA153

Connections:
/1V8: C379.2, C380.1, R197.1, R198.1, R199.1, R200.1, R201.1, R202.1, R203.1, R204.1, R205.1, R206.1, R207.1, R208.1, R209.1, R221.1, R222.1, U21.C6 (VCCQ4), U21.M4 (VCCQ5), U21.N4 (VCCQ3), U21.P3 (VCCQ1), U21.P5 (VCCQ2); also elsewhere on the board
/3V3: C381.2, C382.1, U21.E6 (VCC3), U21.F5 (VCC2), U21.J10 (VCC0), U21.K9 (VCC1); also elsewhere on the board
/Flash / eMMC/IFC_CLE: R207.2, R219.2, U7.C19 (CFG_RCW_SRC8/IFC_CLE)
/RST_eMMC_B: R197.2, U21.K5 (RST_N); also elsewhere on the board
unnamed: C378.2, U21.C2 (VCCI)
unnamed: R198.2, U7.P2 (SDHC_CMD), U21.M5 (CMD)
unnamed: R199.2, U7.T1 (SDHC_DAT3), U21.B2 (DAT3)
unnamed: R200.2, U7.R1 (SDHC_DAT2), U21.A5 (DAT2)
unnamed: R201.2, U7.R2 (SDHC_DAT1), U21.A4 (DAT1)
unnamed: R202.2, U7.P1 (SDHC_DAT0), U21.A3 (DAT0)
unnamed: R203.2, U7.U3 (~SPI_CS3~), U21.B6 (DAT7)
unnamed: R204.2, U7.U5 (~SPI_CS2~), U21.B5 (DAT6)
unnamed: R205.2, U7.T5 (~SPI_CS1~), U21.B4 (DAT5)
unnamed: R206.2, U7.T3 (~SPI_CS0~), U21.B3 (DAT4)
unnamed: R208.2, U7.C18 (~IFC_OE~)
unnamed: R210.1, U7.C15 (~IFC_WE0~)
unnamed: R211.1, U7.A13 (IFC_AD09/CFG_RCW_SRC1)
unnamed: R212.1, U7.A14 (IFC_AD11/CFG_RCW_SRC3)
unnamed: R213.1, U7.A15 (IFC_AD13/CFG_RCW_SRC5)
unnamed: R214.1, U7.A17 (IFC_AD15/CFG_RCW_SRC7)
unnamed: R215.1, U7.A12 (IFC_AD08/CFG_RCW_SRC0)
unnamed: R216.1, U7.B14 (IFC_AD10/CFG_RCW_SRC2)
unnamed: R217.1, U7.B15 (IFC_AD12/CFG_RCW_SRC4)
unnamed: R218.1, U7.A16 (IFC_AD14/CFG_RCW_SRC6)
unnamed: R220.1, U7.C11 (IFC_A21/CFG_DRAM_TYPE)
unnamed: R221.2, U7.D16 (~IFC_RB1~)
unnamed: R222.2, U7.C16 (~IFC_RB0~)
unnamed: U7.P3 (SDHC_CLK), U21.M6 (CLK)

Notes on the sheet:
4GB eMMC Flash
CFG_RCW_SRC[0:8] eMMC / SD = 0_0100_0000
RCW Source = SD
DRAM Type: 0: DDR4 1: DDR3L

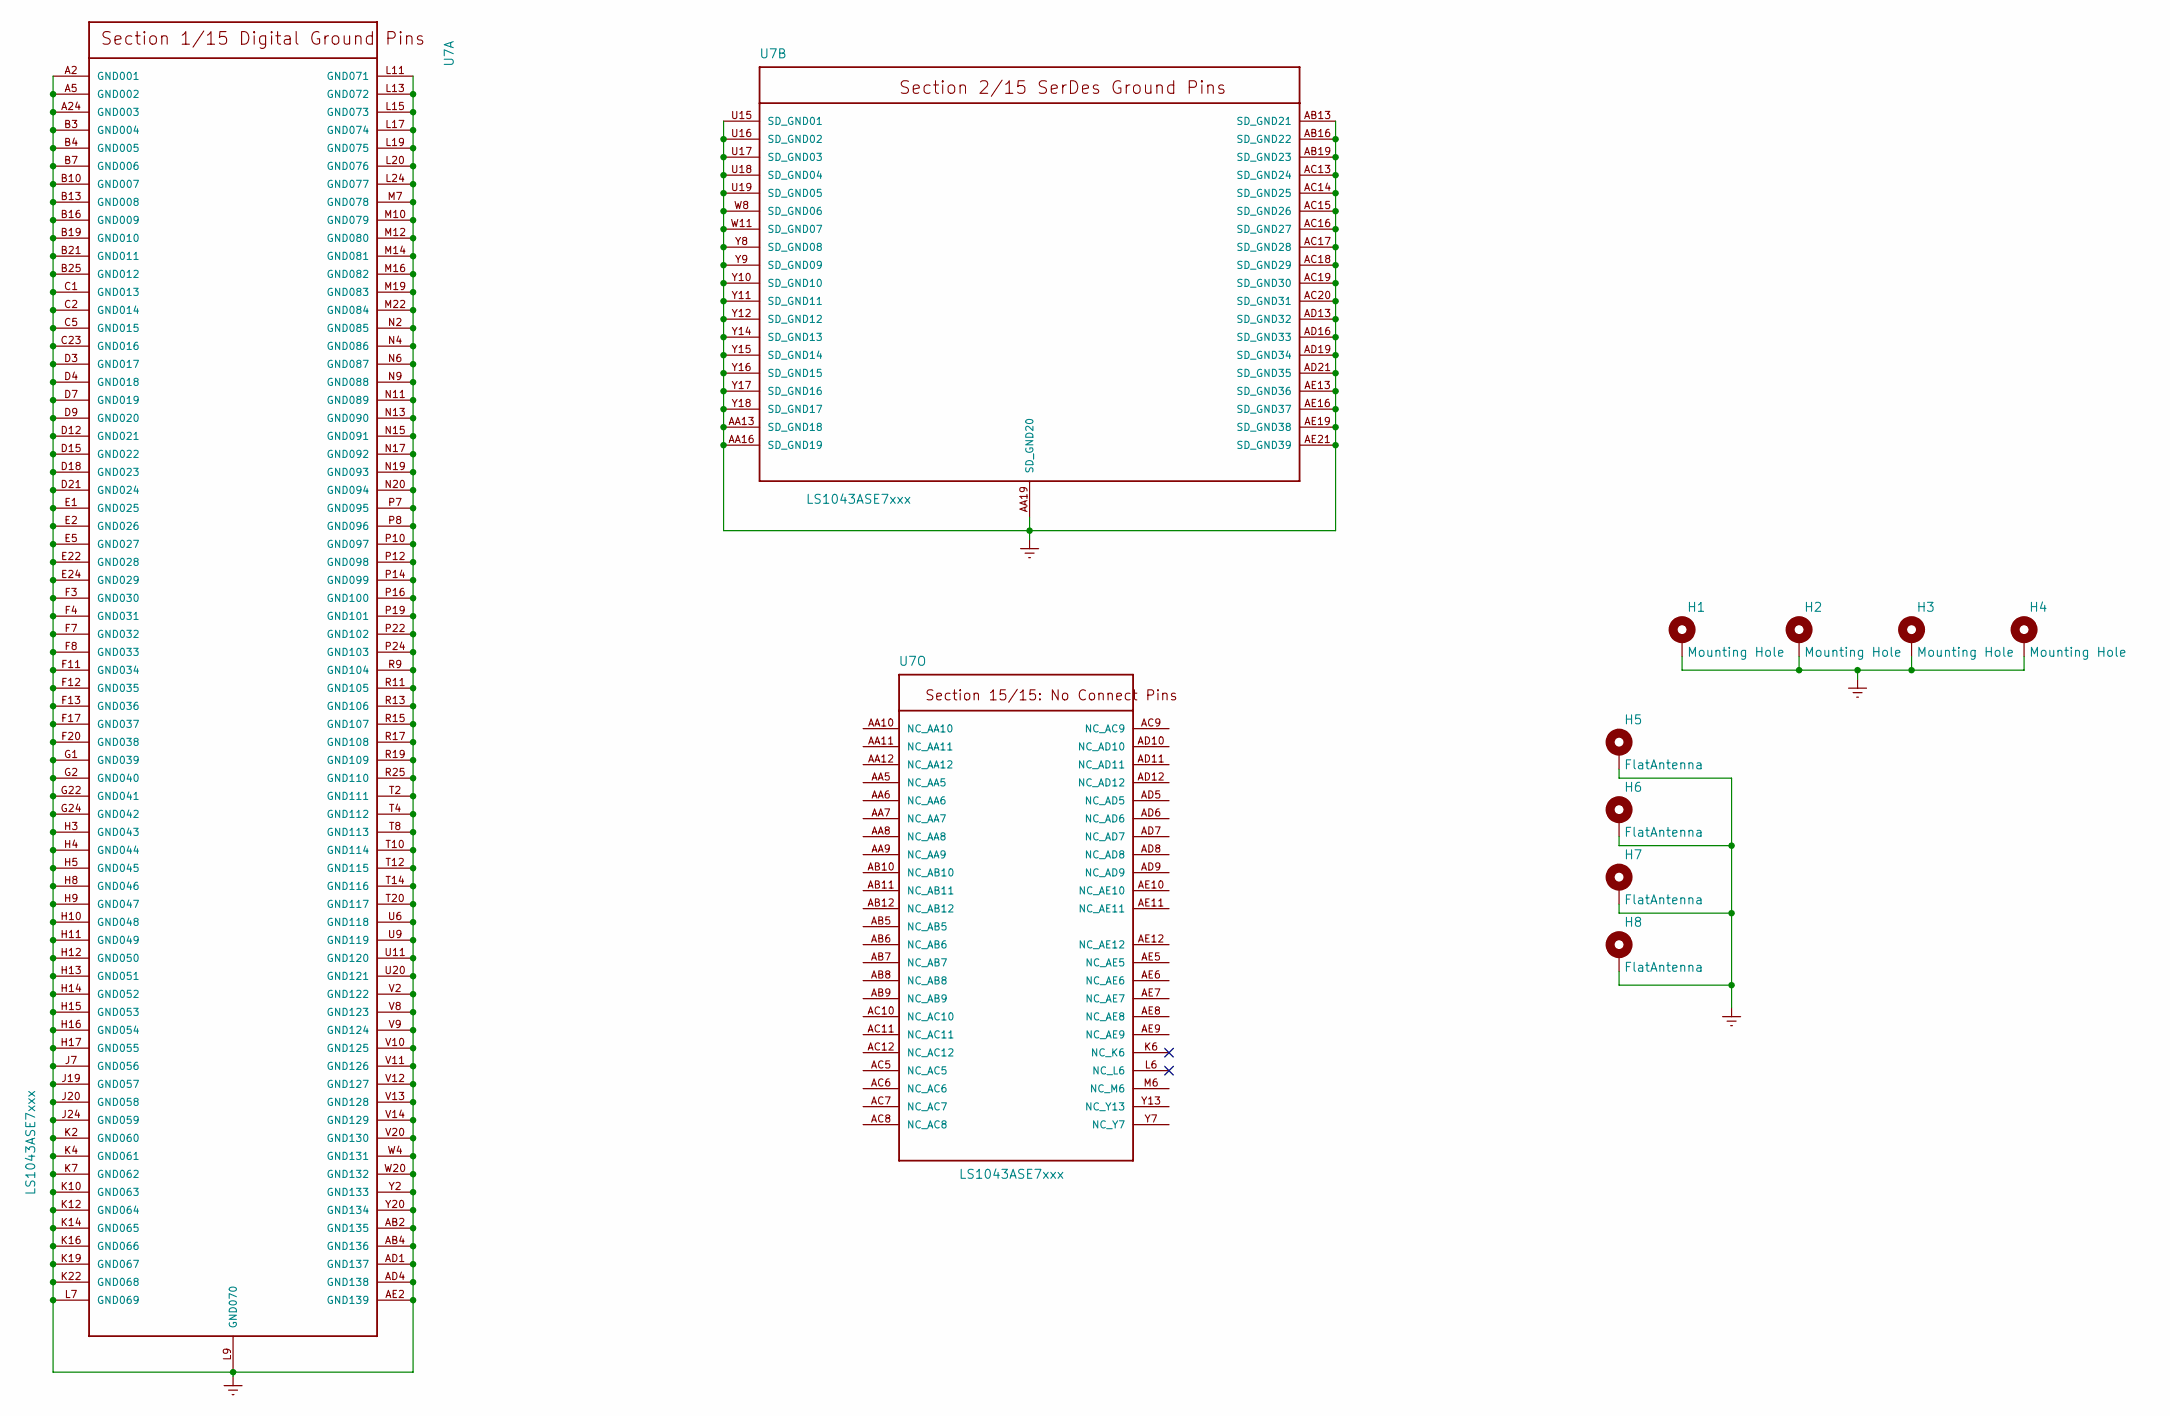
[picture p131: schematic ground.kicad_sch, AP2100]

Parts:
H1, H2, H3, H4: Mounting Hole; MountingHole_2.5mm_Pad_TopBottom
H5, H6, H7, H8: FlatAntenna; MountingHole_4.4mm_Pad_TopOnly
U7: LS1043ASE7xxx; BGA621C80P25X25_2100X2100X192N; PartsBoxID LS1043ASE7
