imagestream/kicad/AP2100.ls1043/AP2100.kicad_pcb

## KiCad design AP2100.ls1043/AP2100.kicad_pcb (continued)

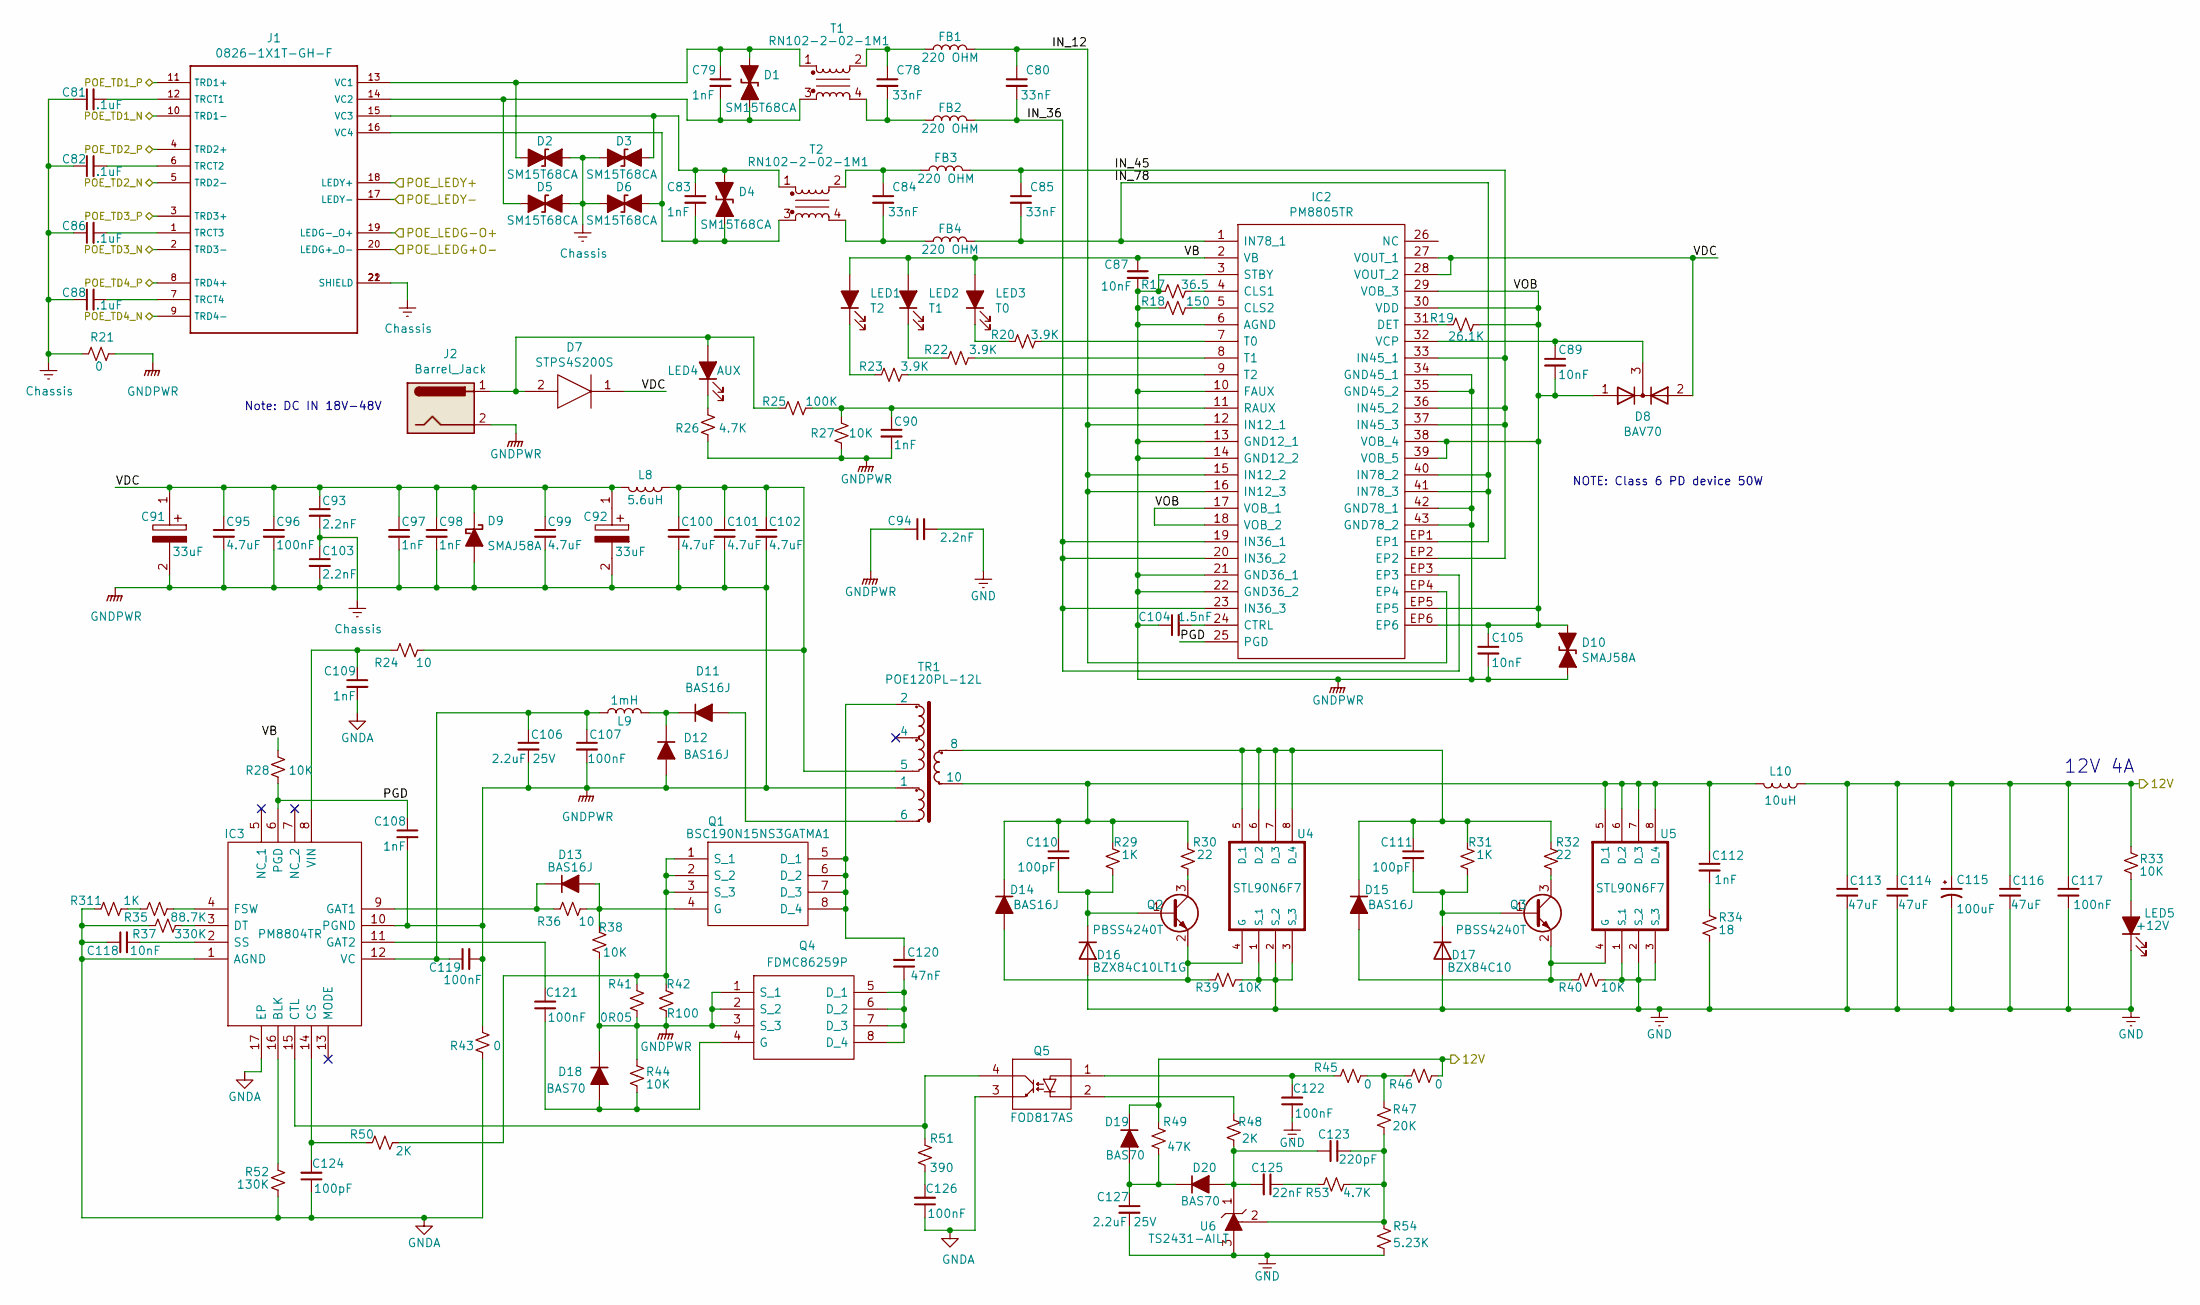
[picture p132: schematic poe.kicad_sch, AP2100]

Parts:
C78, C80, C84, C85: 33nF; C_0805_2012Metric; PartsBoxID 0805-33nF-X7R-100V
C79, C83, C97, C98, C108, C109, C112: 1nF; C_0805_2012Metric; PartsBoxID 0805-1nF-X7R-250V
C81, C82, C86, C88: .1uF; C_0402_1005Metric; PartsBoxID 0402-.1uF-X5R-25V
C87, C89, C118: 10nF; C_0603_1608Metric; PartsBoxID 0603-10nF-X7R-100V
C90: 1nF; C_0603_1608Metric; PartsBoxID 0603-1nF-X7R-100V
C91, C92: 33uF; CAPAE1030X1050N; PartsBoxID EEE-FK2A330P
C93, C94, C103: 2.2nF; C_1812_4532Metric; PartsBoxID 1812-2.2nF-X7R-2KV
C95, C99, C100, C101, C102: 4.7uF; C_1210_3225Metric; PartsBoxID 1210-4.7uF-X7R-100V
C96: 100nF; C_0805_2012Metric; PartsBoxID 0805-100nF-X7R-100V
C104: 1.5nF; C_0603_1608Metric; PartsBoxID 0603-1.5nF-X7R-100V
C105: 10nF; C_0805_2012Metric; PartsBoxID 0805-10nF-X7R-100V
C106, C127: 2.2uF 25V; C_0805_2012Metric; PartsBoxID 0805-2.2uF-X7R-25V
C107, C117, C119, C121, C122: 100nF; C_0603_1608Metric; PartsBoxID 0603-100nF-X7R-25V
C110, C111: 100pF; C_0805_2012Metric; PartsBoxID 0805-100pF-X7R-50V
C113, C114, C116: 47uF; C_1210_3225Metric; PartsBoxID 1210-47uF-X5R-16V
C115: 100uF; CP_Elec_6.3x5.9; PartsBoxID EEEFK1C101P
C120: 47nF; C_1206_3216Metric; PartsBoxID 1206-47nF-X7R-200V
C123: 220pF; C_0603_1608Metric; PartsBoxID 0603-220pF-X7R-100V
C124: 100pF; C_0603_1608Metric; PartsBoxID 0603-100pF-X7R-100V
C125: 22nF; C_0603_1608Metric; PartsBoxID 0603-22nF-X7R-100V
C126: 100nF; C_0603_1608Metric; PartsBoxID 0603-100nF-X7R-100V
D1, D2, D3, D4, D5, D6: SM15T68CA; D_SMC; PartsBoxID SM15T68CA
D7: STPS4S200S; DIOM8059X265N; PartsBoxID STPS4S200S; Mouser Part Number 511-STPS4S200S
D8: BAV70; SOT-23; PartsBoxID BAV70
D9: SMAJ58A; D_SMA; PartsBoxID SMAJ58A; Mouser Part Number 576-SMAJ58A
D10: SMAJ58A; D_SMA; PartsBoxID SMAJ58A
D11, D12, D13, D14, D15: BAS16J; D_SOD-323; PartsBoxID BAS16J
D16: BZX84C10LT1G; SOT-23; PartsBoxID BZX84C10LT1G
D17: BZX84C10; SOT-23; PartsBoxID BZX84C10
D18, D19, D20: BAS70; D_SOD-323; PartsBoxID BAS70
FB1, FB2, FB3, FB4: 220 OHM; L_0805_2012Metric; PartsBoxID MPZ2012S221AT000
IC2: PM8805TR; PartsBoxID PM8805TR; Mouser Part Number 511-PM8805TR
IC3: PM8804TR; QFN50P340X340X90-17N; PartsBoxID PM8804TR
J1: 0826-1X1T-GH-F; BEL_0826-1X1T-GH-F; PartsBoxID 0826-1X1T-GH-F
J2: Barrel_Jack; BarrelJack_Horizontal; PartsBoxID BJ-2.5MM
L8: 5.6uH; L_Coilcraft_XAL5030; PartsBoxID XAL50-5.6-R; Mouser Part Number 710-7443631000
L9: 1mH; L_Coilcraft_LPS4018; PartsBoxID LPS4018-105MRB
L10: 10uH; WE-HCF_201322; PartsBoxID 7443631000; Mouser Part Number 710-7443631000
LED1: T2; LED_0603_1608Metric; PartsBoxID 0603-LED-RED
LED2: T1; LED_0603_1608Metric; PartsBoxID 0603-LED-RED
LED3: T0; LED_0603_1608Metric; PartsBoxID 0603-LED-RED
LED4: AUX; LED_0603_1608Metric; PartsBoxID 0603-LED-RED
LED5: +12V; LED_0603_1608Metric; PartsBoxID 0603-LED-RED
Q1: BSC190N15NS3GATMA1; TRANS_BSC100N06LS3GATMA1; PartsBoxID BSC190N15NS3GATMA1; Mouser Part Number 726-BSC190N15NS3GATM
Q2, Q3: PBSS4240T; SOT-23; PartsBoxID PBSS4240T,215
Q4: FDMC86259P; FDMC86160; PartsBoxID FDMC86259P; Mouser Part Number 512-FDMC86259P
Q5: FOD817AS; SOP254P1016X385-4N; PartsBoxID FOD817AS; Mouser Part Number 512-FOD817AS
R17: 36.5; R_0805_2012Metric; PartsBoxID 0805-36R5-1%
R18: 150; R_0805_2012Metric; PartsBoxID 0805-150R-1%
R19: 26.1K; R_0603_1608Metric; PartsBoxID 0603-26.1K-1%
R20, R22, R23: 3.9K; R_0603_1608Metric; PartsBoxID 0603-3.9K-1%
R21: 0; R_2010_5025Metric; PartsBoxID 2010-0R-1%
R24, R36: 10; R_0805_2012Metric; PartsBoxID 0805-10R-1%
R25: 100K; R_0603_1608Metric; PartsBoxID 0603-100K-1%
R26, R53: 4.7K; R_0603_1608Metric; PartsBoxID 0603-4.7K-1%
R27, R28, R33, R39, R40, R44: 10K; R_0603_1608Metric; PartsBoxID 0603-10K-1%
R29, R31, R311: 1K; R_0603_1608Metric; PartsBoxID 0603-1K-1%
R30, R32: 22; R_0603_1608Metric; PartsBoxID 0603-22R-1%
R34: 18; R_0805_2012Metric; PartsBoxID 0805-18R-1%
R35: 88.7K; R_0603_1608Metric; PartsBoxID 0603-88.7K-1%
R37: 330K; R_0603_1608Metric; PartsBoxID 0603-330K-1%
R38: 10K; R_0805_2012Metric; PartsBoxID 0805-10K-1%
R41: 0R05; R_1210_3225Metric; PartsBoxID 1210-0R05-1%
R42: R100; R_1210_3225Metric; PartsBoxID 1210-R100-1%
R43: 0; R_1206_3216Metric; PartsBoxID 1206-0R-1%
R45, R46: 0; R_0603_1608Metric; PartsBoxID 0603-0R-1%
R47: 20K; R_0603_1608Metric; PartsBoxID 0603-20K-1%
R48, R50: 2K; R_0603_1608Metric; PartsBoxID 0603-2K-1%
R49: 47K; R_0603_1608Metric; PartsBoxID 0603-47K-1%
R51: 390; R_0603_1608Metric; PartsBoxID 0603-390R-1%
R52: 130K; R_0603_1608Metric; PartsBoxID 0603-130K-1%
R54: 5.23K; R_0603_1608Metric; PartsBoxID 0603-5.23K-1%
T1, T2: RN102-2-02-1M1; Choke_Schaffner_RN102-04-14.0x14.0mm; PartsBoxID RN102-2-02-1M1
TR1: POE120PL-12L; Transformer_Coilcraft_POE120PL; PartsBoxID POE120PL-12L_
U4, U5: STL90N6F7; TRANS_STL60P4LLF6; PartsBoxID STL90N6F7
U6: TS2431-AILT; SOT-23-3; PartsBoxID TS2431AILT

Connections:
/3V3: J1.18 (LEDY+), J1.19 (LEDG-_O+); also elsewhere on the board
/12V: C113.1, C114.1, C115.1, C116.1, C117.1, D19.1 (K), L10.2, R33.2, R46.1, R49.2; also elsewhere on the board
/ETH0_LED1-: J1.20 (LEDG+_O-); also elsewhere on the board
/ETH0_LED2-: J1.17 (LEDY-); also elsewhere on the board
/POE_TD1_N: J1.10 (TRD1-); also elsewhere on the board
/POE_TD1_P: J1.11 (TRD1+); also elsewhere on the board
/POE_TD2_N: J1.5 (TRD2-); also elsewhere on the board
/POE_TD2_P: J1.4 (TRD2+); also elsewhere on the board
/POE_TD3_N: J1.2 (TRD3-); also elsewhere on the board
/POE_TD3_P: J1.3 (TRD3+); also elsewhere on the board
/POE_TD4_N: J1.9 (TRD4-); also elsewhere on the board
/POE_TD4_P: J1.8 (TRD4+); also elsewhere on the board
/PoE Power/IN_12: C80.1, FB1.2, IC2.12 (IN12_1), IC2.15 (IN12_2), IC2.16 (IN12_3), IC2.EP4
/PoE Power/IN_36: C80.2, FB2.2, IC2.19 (IN36_1), IC2.20 (IN36_2), IC2.23 (IN36_3), IC2.EP3
/PoE Power/IN_45: C85.1, FB3.2, IC2.33 (IN45_1), IC2.36 (IN45_2), IC2.37 (IN45_3), IC2.EP2
/PoE Power/IN_78: C85.2, FB4.2, IC2.1 (IN78_1), IC2.40 (IN78_2), IC2.41 (IN78_3), IC2.EP1
/PoE Power/PGD: C108.1, IC2.25 (PGD), IC3.6 (PGD), R28.2
/PoE Power/VB: C87.1, IC2.2 (VB), LED1.2 (A), LED2.2 (A), LED3.2 (A), R28.1
/PoE Power/VDC: C91.1, C92.1, C93.1, C95.1, C96.1, C97.1, C98.1, C99.1, D7.1, D8.2 (A), D9.1 (K), IC2.27 (VOUT_1), IC2.28 (VOUT_2), L8.1
/PoE Power/VOB: C89.2, C105.1, D8.1 (A), D10.1 (A1), IC2.17 (VOB_1), IC2.18 (VOB_2), IC2.29 (VOB_3), IC2.30 (VDD), IC2.38 (VOB_4), IC2.39 (VOB_5), IC2.EP5, IC2.EP6, R19.1
Earth: C81.1, C82.1, C86.1, C88.1, C93.2, C103.1, D2.1 (A1), D3.2 (A2), D5.1 (A1), D6.2 (A2), J1.21 (SHIELD), J1.22 (SHIELD), R21.2
GNDA: C109.2, C118.1, C124.1, C126.1, IC3.1 (AGND), IC3.17 (EP), Q5.3, R35.1, R37.1, R43.2, R52.1, R311.1, R311.2
GNDPWR: C87.2, C90.2, C91.2, C92.2, C94.1, C95.2, C96.2, C97.2, C98.2, C99.2, C100.2, C101.2, C102.2, C103.2, C104.1, C105.2, C106.2, C107.2, C108.2, C119.2, D9.2 (A), D10.2 (A2), D12.2 (A), D18.1 (K), IC2.3 (STBY), IC2.6 (AGND), IC2.10 (FAUX), IC2.13 (GND12_1), IC2.14 (GND12_2), IC2.21 (GND36_1), IC2.22 (GND36_2), IC2.34 (GND45_1), IC2.35 (GND45_2), IC2.42 (GND78_1), IC2.43 (GND78_2), IC3.10 (PGND), J2.2, Q4.1 (S_1), Q4.2 (S_2), Q4.3 (S_3), R17.2, R18.2, R21.1, R26.2, R27.2, R38.1, R41.1, R42.1, R43.1, R44.1, TR1.1
unnamed: C78.1, FB1.1, T1.2
unnamed: C78.2, FB2.1, T1.4
unnamed: C79.1, D1.1 (A1), D2.2 (A2), J1.13 (VC1), T1.1
unnamed: C79.2, D1.2 (A2), D5.2 (A2), J1.14 (VC2), T1.3
unnamed: C81.2, J1.12 (TRCT1)
unnamed: C82.2, J1.6 (TRCT2)
unnamed: C83.1, D3.1 (A1), D4.1 (A1), J1.15 (VC3), T2.1
unnamed: C83.2, D4.2 (A2), D6.1 (A1), J1.16 (VC4), T2.3
unnamed: C84.1, FB3.1, T2.2
unnamed: C84.2, FB4.1, T2.4
unnamed: C86.2, J1.1 (TRCT3)
unnamed: C88.2, J1.7 (TRCT4)
unnamed: C89.1, D8.3 (K), IC2.32 (VCP)
unnamed: C90.1, IC2.11 (RAUX), R25.1, R27.1
unnamed: C100.1, C101.1, C102.1, L8.2, R24.2, TR1.5
unnamed: C104.2, IC2.24 (CTRL)
unnamed: C106.1, C107.1, C119.1, IC3.12 (VC), L9.1
unnamed: C109.1, IC3.8 (VIN), R24.1
unnamed: C110.1, C112.1, D14.1 (K), L10.1, R29.1, R30.1, TR1.10, U5.5 (D_1), U5.6 (D_2), U5.7 (D_3), U5.8 (D_4)
unnamed: C110.2, D16.3 (K), Q2.1 (B), R29.2
unnamed: C111.1, D15.1 (K), R31.1, R32.1, TR1.8, U4.5 (D_1), U4.6 (D_2), U4.7 (D_3), U4.8 (D_4)
unnamed: C111.2, D17.3 (K), Q3.1 (B), R31.2
unnamed: C112.2, R34.1
unnamed: C118.2, IC3.2 (SS)
unnamed: C120.1, Q4.5 (D_1), Q4.6 (D_2), Q4.7 (D_3), Q4.8 (D_4)
unnamed: C120.2, Q1.5 (D_1), Q1.6 (D_2), Q1.7 (D_3), Q1.8 (D_4), TR1.2
unnamed: C121.1, D18.2 (A), Q4.4 (G), R44.2
unnamed: C121.2, IC3.11 (GAT2)
unnamed: C122.2, Q5.1, R45.2
unnamed: C123.1, R47.1, R53.1, R54.1, U6.2 (REF)
unnamed: C123.2, C125.2, D20.2 (A), R48.1, U6.1 (K)
unnamed: C124.2, IC3.14 (CS), R50.2
unnamed: C125.1, R53.2
unnamed: C126.2, R51.2
unnamed: C127.1, D19.2 (A), D20.1 (K), R49.1
unnamed: D7.2, J2.1, LED4.2 (A), R25.2
unnamed: D11.1 (K), D12.1 (K), L9.2
unnamed: D11.2 (A), TR1.6
unnamed: D13.1 (K), IC3.9 (GAT1), R36.1
unnamed: D13.2 (A), Q1.4 (G), R36.2, R38.2
unnamed: D14.2 (A), Q2.2 (E), R39.2, U4.4 (G)
unnamed: D15.2 (A), Q3.2 (E), R40.2, U5.4 (G)
unnamed: IC2.4 (CLS1), R17.1
unnamed: IC2.5 (CLS2), R18.1
unnamed: IC2.7 (T0), R20.1
unnamed: IC2.8 (T1), R22.1
unnamed: IC2.9 (T2), R23.1
unnamed: IC2.31 (DET), R19.2
unnamed: IC3.3 (DT), R37.2
unnamed: IC3.4 (FSW), R35.2
unnamed: IC3.15 (CTL), Q5.4, R51.1
unnamed: IC3.16 (BLK), R52.2
unnamed: LED1.1 (K), R23.2
unnamed: LED2.1 (K), R22.2
unnamed: LED3.1 (K), R20.2
unnamed: LED4.1 (K), R26.1
unnamed: LED5.2 (A), R33.1
unnamed: Q1.1 (S_1), Q1.2 (S_2), Q1.3 (S_3), R41.2, R42.2, R50.1
unnamed: Q2.3 (C), R30.2
unnamed: Q3.3 (C), R32.2
unnamed: Q5.2, R48.2
unnamed: R45.1, R46.2, R47.2

Notes on the sheet:
Note: DC IN 18V-48V
NOTE: Class 6 PD device 50W
12V 4A

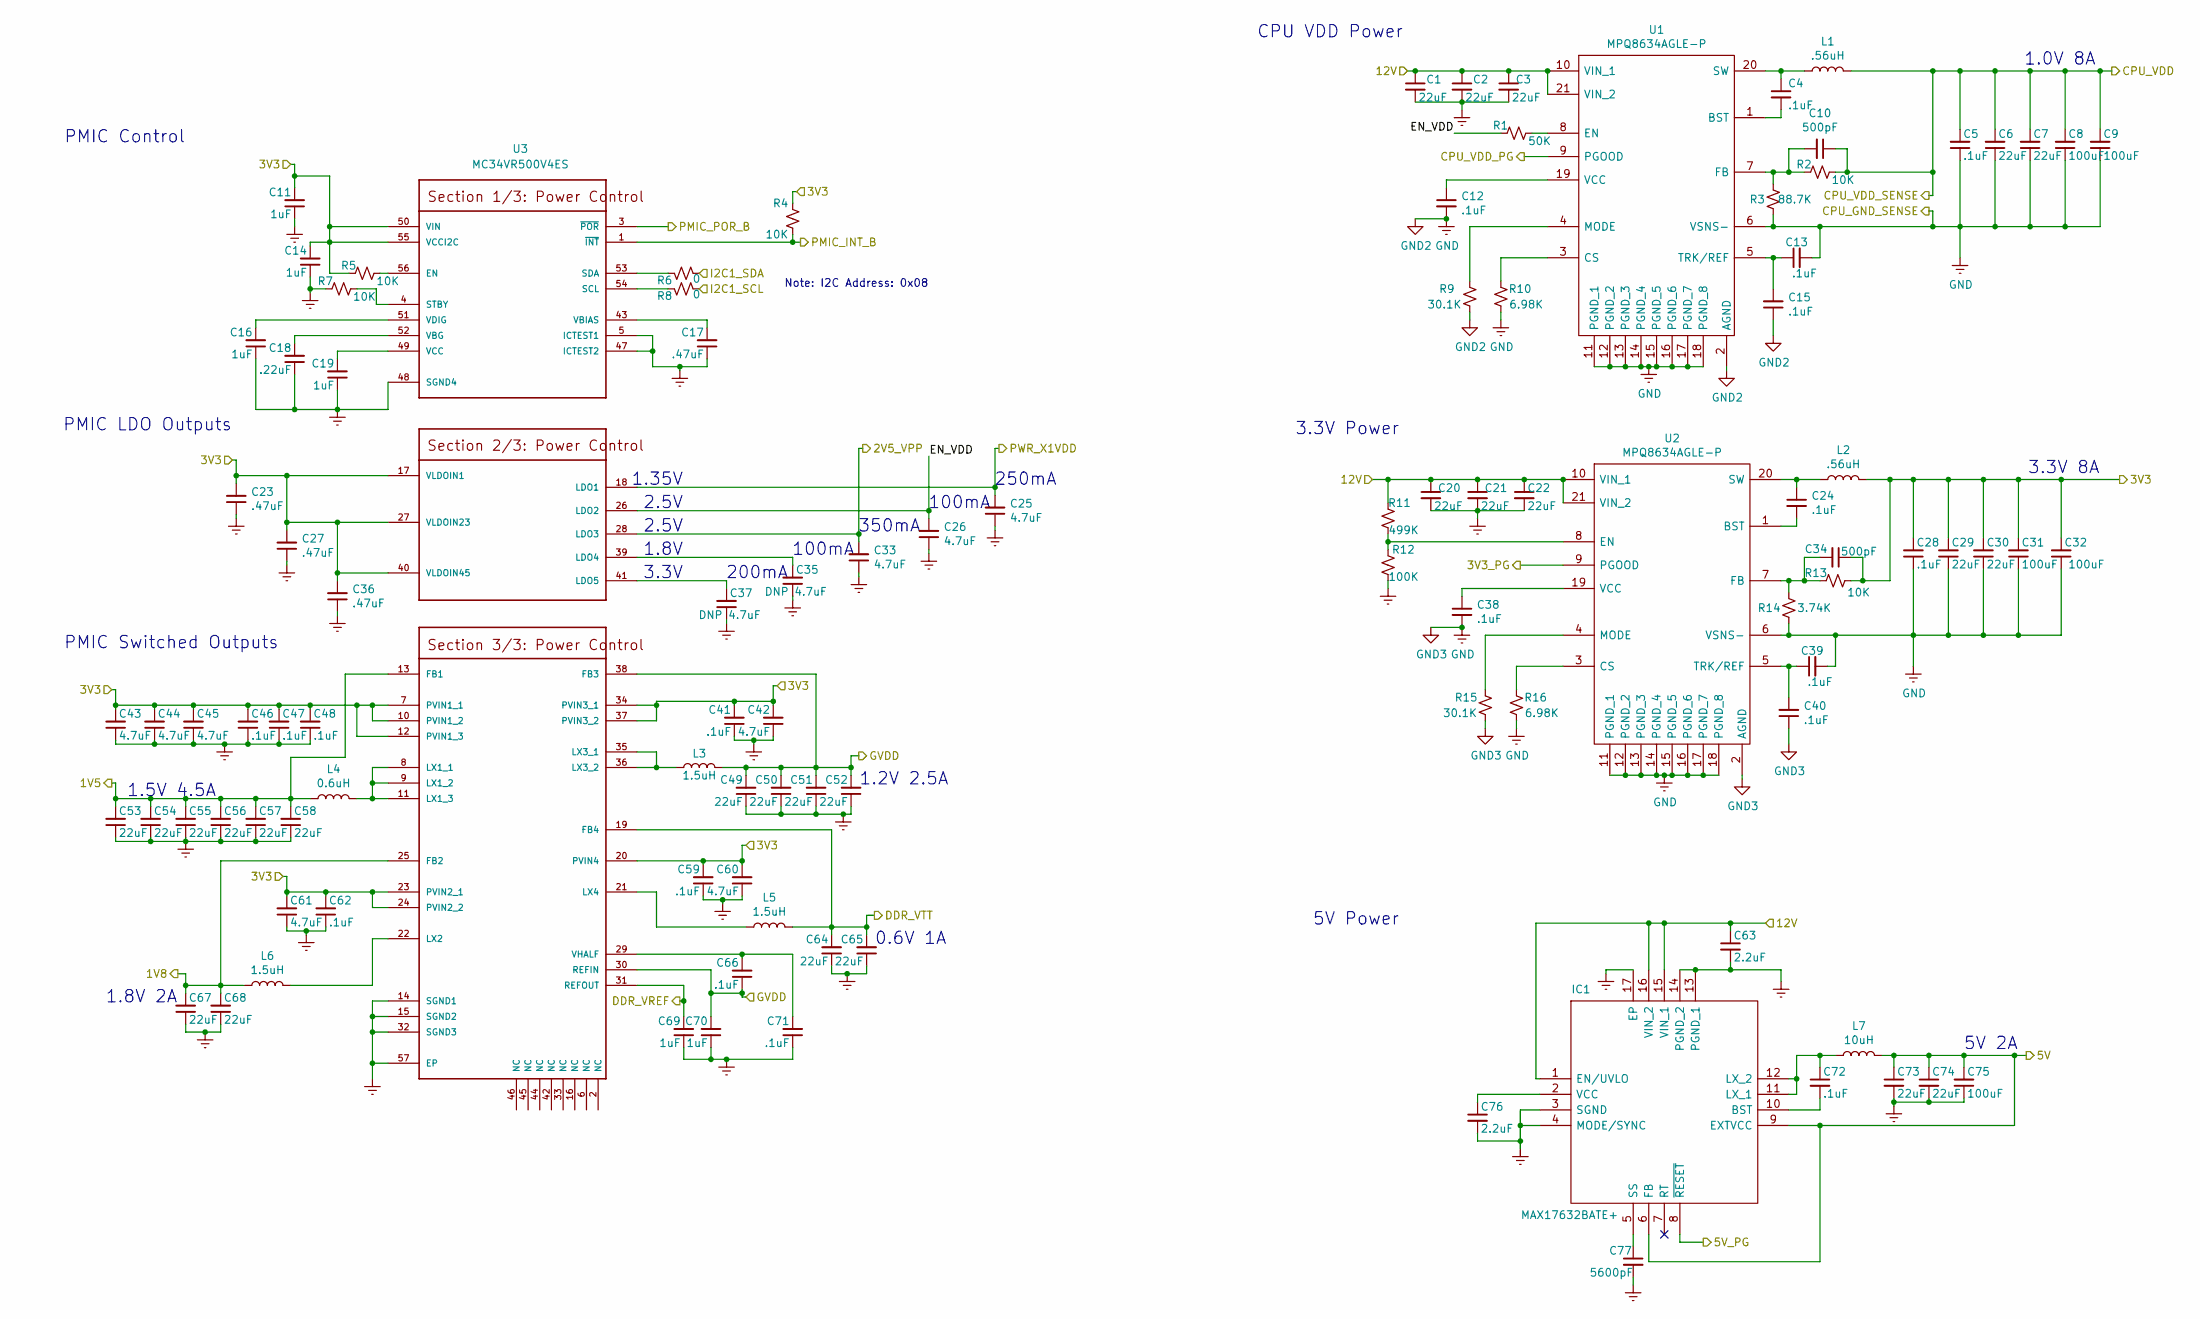
[picture p133: schematic Power.kicad_sch, AP2100]

Parts:
C1, C2, C3, C6, C7, C20, C21, C22, C29, C30, C73, C74: 22uF; C_1210_3225Metric; PartsBoxID 1210-22uF-X7R-25V
C4, C5, C12, C13, C15, C24, C28, C38, C39, C40, C72: .1uF; C_0603_1608Metric; PartsBoxID 0603-.1uF-X7R-25V
C8, C9, C31, C32, C75: 100uF; C_1210_3225Metric; PartsBoxID 1210-100uF-X5R-6.3V
C10, C34: 500pF; C_0603_1608Metric; PartsBoxID 0603-500pF-C0G-50V
C11, C14, C16, C19, C69, C70: 1uF; C_0402_1005Metric; PartsBoxID 0402-1uF-X5R-25V
C17: .47uF; C_0603_1608Metric; PartsBoxID 0603-.47uF-X5R-16V
C18: .22uF; C_0402_1005Metric; PartsBoxID 0402-.22uF-X5R-16V
C23, C27, C36: .47uF; C_0603_1608Metric; PartsBoxID 0603-.47uF-X7R-25V
C25, C26, C33, C42, C43, C44, C45, C60, C61: 4.7uF; C_0805_2012Metric; PartsBoxID 0805-4.7uF-X5R-16V
C35, C37: DNP 4.7uF; C_0805_2012Metric; PartsBoxID 0805-4.7uF-X5R-16V
C41, C46, C47, C48, C59, C62, C66, C71: .1uF; C_0402_1005Metric; PartsBoxID 0402-.1uF-X5R-16V
C49, C50, C51, C52, C53, C54, C55, C56, C57, C58, C64, C65, C67, C68: 22uF; C_0805_2012Metric; PartsBoxID 0805-22uF-X5R-25V
C63, C76: 2.2uF; C_1210_3225Metric; PartsBoxID 1210-2.2uF-X7R-25V
C77: 5600pF; C_0603_1608Metric; PartsBoxID 0603-5600pF-C0G-50V
IC1: MAX17632BATE+; QFN50P300X300X80-17N; Manufacturer_Part_Number MAX17632BATE+; Mouser Part Number 700-MAX17632BATE+
L1, L2: .56uH; L_13.5x12.5mm_H6mm; PartsBoxID HCMA1305-R56-R
L3, L5, L6: 1.5uH; L_Coilcraft_XxL4040; PartsBoxID XAL40-1.5-R
L4: 0.6uH; L_Coilcraft_XxL4040; PartsBoxID XAL40-0.6-R
L7: 10uH; L_Coilcraft_XAL5030; PartsBoxID XAL50-10-R
R1: 50K; R_0402_1005Metric; PartsBoxID 0402-50K-1%
R2, R13: 10K; R_0603_1608Metric; PartsBoxID 0603-10K-1%
R3: 88.7K; R_0603_1608Metric; PartsBoxID 0603-88.7K-1%
R4, R5, R7: 10K; R_0402_1005Metric; PartsBoxID 0402-10K-1%
R6, R8: 0; R_0402_1005Metric; PartsBoxID 0402-0R-1%
R9, R15: 30.1K; R_0603_1608Metric; PartsBoxID 0603-30.1K-1%
R10, R16: 6.98K; R_0603_1608Metric; PartsBoxID 0603-6.98K-1%
R11: 499K; R_0402_1005Metric; PartsBoxID 0402-499K-1%
R12: 100K; R_0402_1005Metric; PartsBoxID 0402-100K-1%
R14: 3.74K; R_0603_1608Metric; PartsBoxID 0603-3.7K-1%
U1, U2: MPQ8634AGLE-P; QFN45P300X400X100-21N; PartsBoxID MPQ8634AGLE-P
U3: MC34VR500V4ES; QFN50P800X800X90-57N; PartsBoxID MC34VR500V4ES

Connections:
/1V5: C53.2, C54.2, C55.2, C56.2, C57.2, C58.2, L4.1, U3.13 (FB1); also elsewhere on the board
/1V8: C67.2, C68.2, L6.1, U3.25 (FB2); also elsewhere on the board
/2V5_VPP: C33.2, U3.28 (LDO3); also elsewhere on the board
/3V3: C11.2, C14.2, C23.2, C27.2, C28.2, C29.2, C30.2, C31.2, C32.2, C34.1, C36.2, C41.2, C42.2, C43.2, C44.2, C45.2, C46.2, C47.2, C48.2, C59.2, C60.2, C61.2, C62.2, L2.2, R4.2, R5.1, R13.2, U3.7 (PVIN1_1), U3.10 (PVIN1_2), U3.12 (PVIN1_3), U3.17 (VLDOIN1), U3.20 (PVIN4), U3.23 (PVIN2_1), U3.24 (PVIN2_2), U3.27 (VLDOIN23), U3.34 (PVIN3_1), U3.37 (PVIN3_2), U3.40 (VLDOIN45), U3.50 (VIN), U3.55 (VCCI2C); also elsewhere on the board
/3V3_PG: U2.9 (PGOOD); also elsewhere on the board
/5V: C73.1, C74.1, C75.2, IC1.6 (FB), IC1.9 (EXTVCC), L7.2; also elsewhere on the board
/5V_PG: IC1.8 (~RESET); also elsewhere on the board
/12V: C1.1, C2.1, C3.1, C20.1, C21.1, C22.1, C63.1, IC1.1 (EN/UVLO), IC1.15 (VIN_1), IC1.16 (VIN_2), R11.2, U1.10 (VIN_1), U1.21 (VIN_2), U2.10 (VIN_1), U2.21 (VIN_2); also elsewhere on the board
/CPU_VDD_PG: U1.9 (PGOOD); also elsewhere on the board
/CPU_VDD_SENSE: C5.2, C6.2, C7.2, C8.2, C9.2, C10.1, L1.2, R2.2; also elsewhere on the board
/DDR_VREF: C69.2, U3.31 (REFOUT); also elsewhere on the board
/DDR_VTT: C64.2, C65.2, L5.1, U3.19 (FB4); also elsewhere on the board
/GVDD: C49.2, C50.2, C51.2, C52.2, C66.1, C70.2, L3.1, U3.30 (REFIN), U3.38 (FB3); also elsewhere on the board
/I2C1_SCL: R8.2; also elsewhere on the board
/I2C1_SDA: R6.2; also elsewhere on the board
/PMIC_INT_B: R4.1, U3.1 (~INT~); also elsewhere on the board
/PMIC_POR_B: U3.3 (~POR~); also elsewhere on the board
/PWR_X1VDD: C25.2, U3.18 (LDO1); also elsewhere on the board
/Power/EN_VDD: C26.2, R1.1, U3.26 (LDO2)
unnamed: C4.1, L1.1, U1.20 (SW)
unnamed: C4.2, U1.1 (BST)
unnamed: C10.2, R2.1, R3.2, U1.7 (FB)
unnamed: C12.1, U1.19 (VCC)
unnamed: C13.1, C15.2, U1.5 (TRK/REF)
unnamed: C16.2, U3.51 (VDIG)
unnamed: C17.2, U3.43 (VBIAS)
unnamed: C18.2, U3.52 (VBG)
unnamed: C19.2, U3.49 (VCC)
unnamed: C24.1, L2.1, U2.20 (SW)
unnamed: C24.2, U2.1 (BST)
unnamed: C34.2, R13.1, R14.2, U2.7 (FB)
unnamed: C35.2, U3.39 (LDO4)
unnamed: C37.2, U3.41 (LDO5)
unnamed: C38.1, U2.19 (VCC)
unnamed: C39.1, C40.2, U2.5 (TRK/REF)
unnamed: C66.2, C71.2, U3.29 (VHALF)
unnamed: C72.1, IC1.11 (LX_1), IC1.12 (LX_2), L7.1
unnamed: C72.2, IC1.10 (BST)
unnamed: C76.1, IC1.2 (VCC)
unnamed: C77.1, IC1.5 (SS)
unnamed: L3.2, U3.35 (LX3_1), U3.36 (LX3_2)
unnamed: L4.2, U3.8 (LX1_1), U3.9 (LX1_2), U3.11 (LX1_3)
unnamed: L5.2, U3.21 (LX4)
unnamed: L6.2, U3.22 (LX2)
unnamed: R1.2, U1.8 (EN)
unnamed: R5.2, U3.56 (EN)
unnamed: R6.1, U3.53 (SDA)
unnamed: R7.2, U3.4 (STBY)
unnamed: R8.1, U3.54 (SCL)
unnamed: R9.1, U1.4 (MODE)
unnamed: R10.2, U1.3 (CS)
unnamed: R11.1, R12.2, U2.8 (EN)
unnamed: R15.1, U2.4 (MODE)
unnamed: R16.2, U2.3 (CS)

Notes on the sheet:
1.8V 2A
PMIC Control
1.5V 4.5A
PMIC LDO Outputs
PMIC Switched Outputs
1.35V
2.5V
1.8V
3.3V
200mA
100mA
1.2V 2.5A
0.6V 1A
350mA
Note: I2C Address: 0x08
250mA
3.3V Power
5V Power
CPU VDD Power
5V 2A
1.0V 8A
3.3V 8A

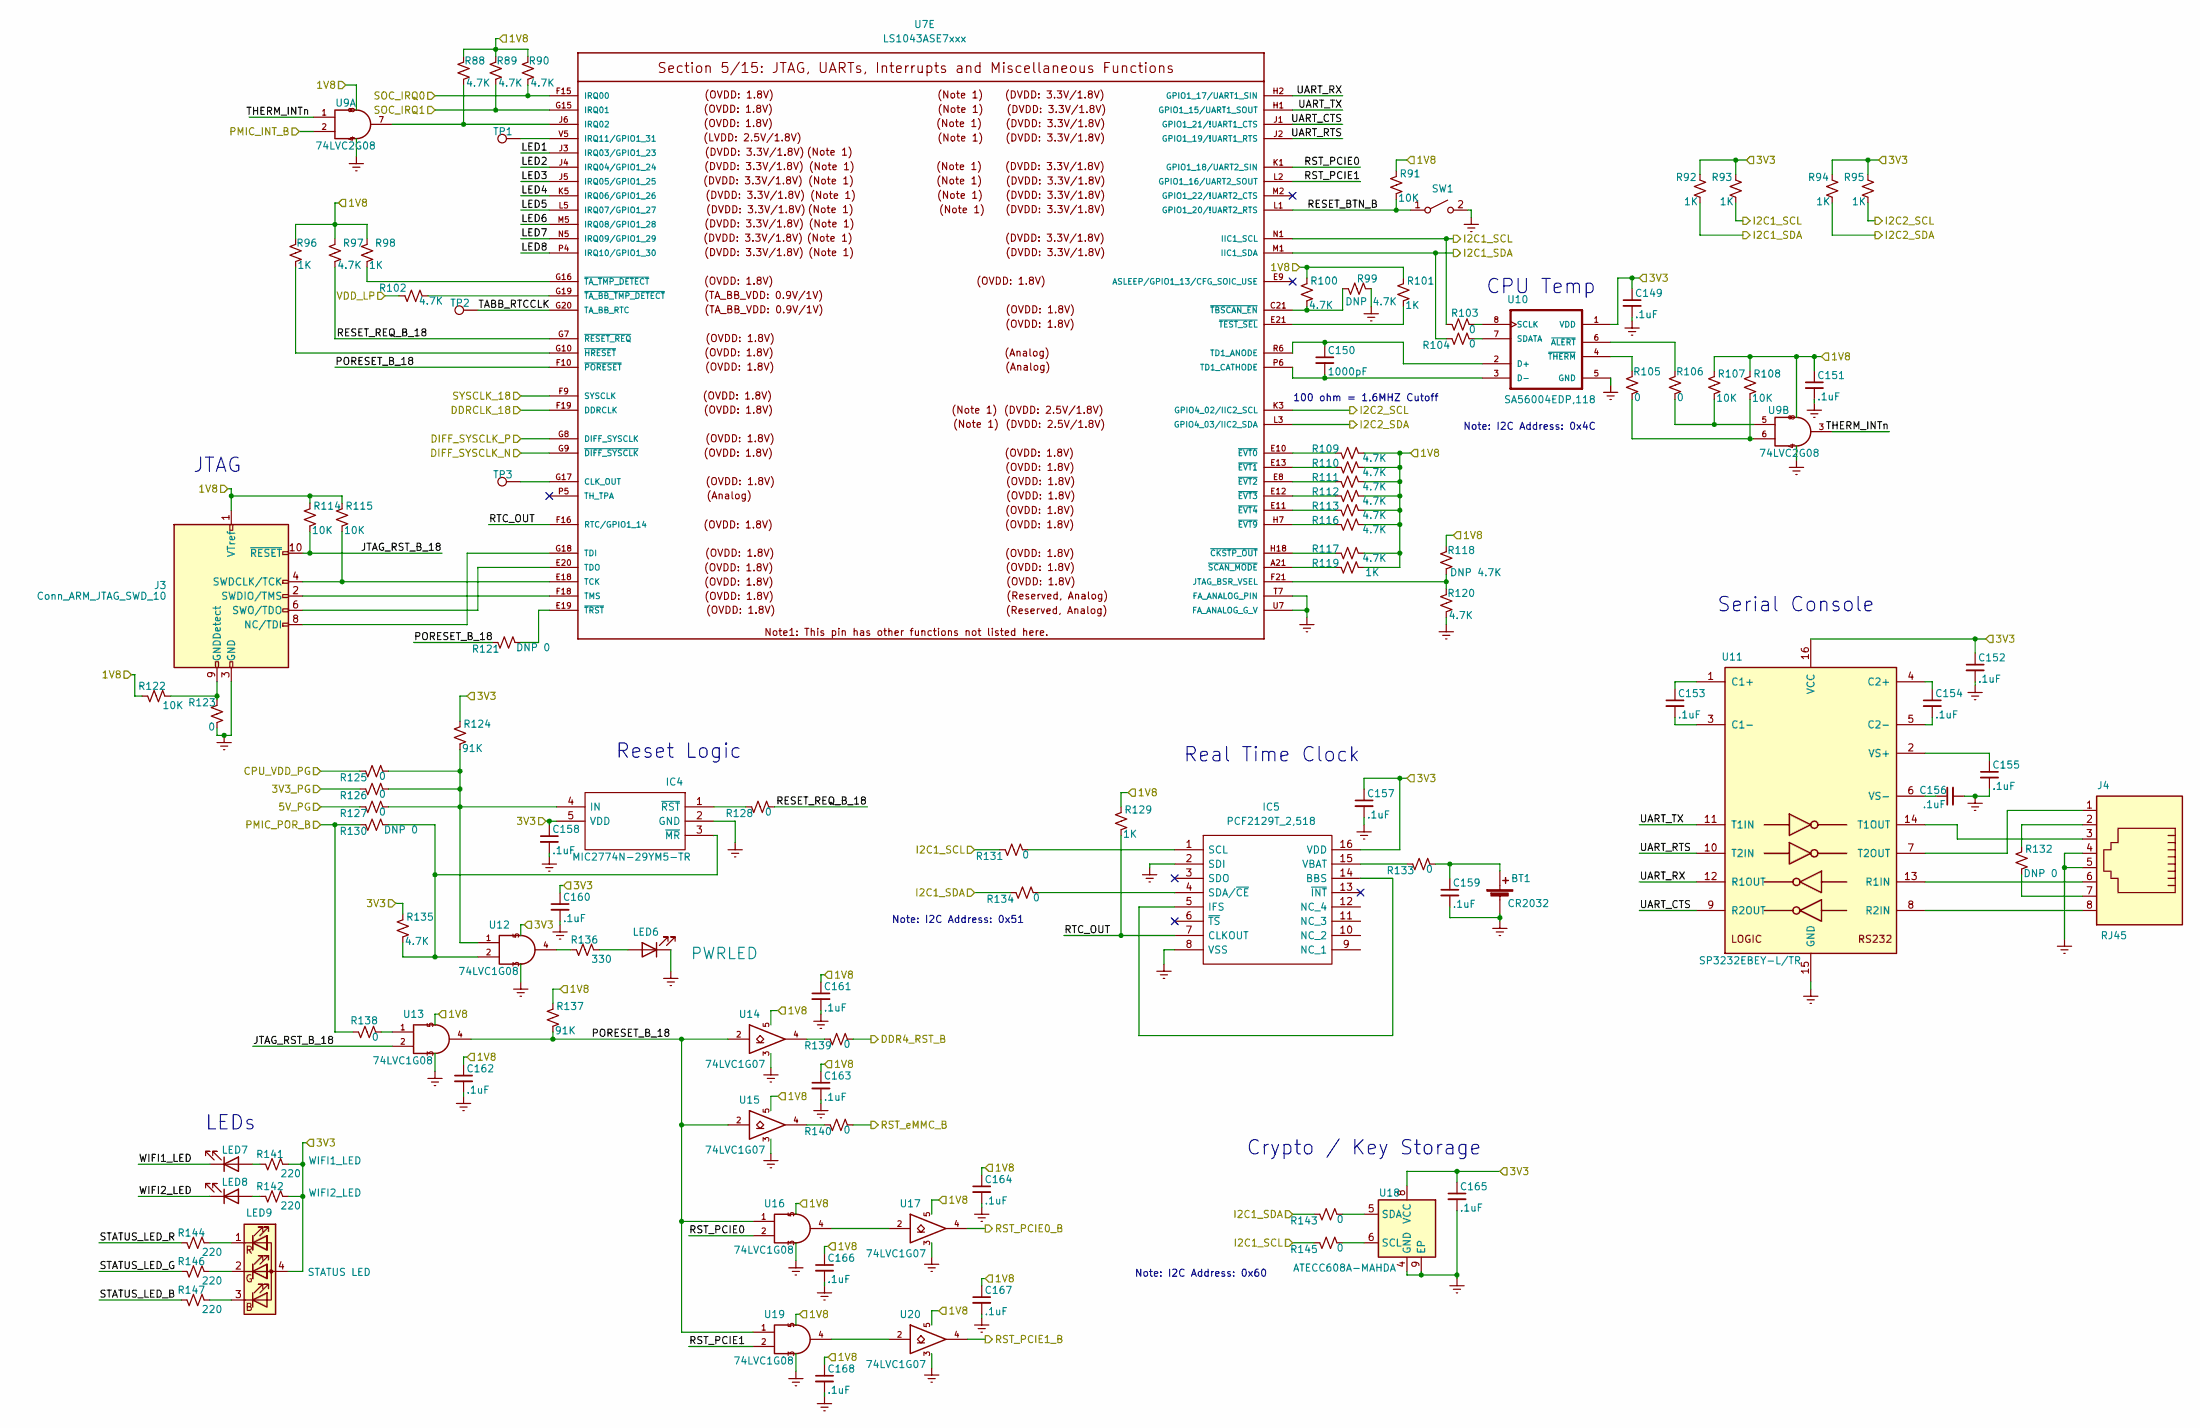
[picture p134: schematic reset.kicad_sch, AP2100]

Parts:
BT1: CR2032; BatteryHolder_Keystone_3034_1x20mm; PartsBoxID 3034
C149, C151, C152, C153, C154, C155, C156, C157, C158, C159, C160, C161, C162, C163, C164, C165, C166, C167, C168: .1uF; C_0402_1005Metric; PartsBoxID 0402-.1uF-X5R-25V
C150: 1000pF; C_0402_1005Metric; PartsBoxID 0402-1000pF-X5R-25V
IC4: MIC2774N-29YM5-TR; SOT95P280X145-5N; Manufacturer_Part_Number MIC2774N-29YM5-TR; Mouser Part Number 998-MIC2774N-29YM5TR
IC5: PCF2129T_2,518; SOIC127P1032X265-16N; Manufacturer_Part_Number PCF2129T/2,518; Mouser Part Number 771-PCF2129T/2,518
J3: Conn_ARM_JTAG_SWD_10; Tag-Connect_TC2050-IDC-NL_2x05_P1.27mm_Vertical
J4: RJ45; RJ45_Amphenol_54602-x08_Horizontal; PartsBoxID 54602-908LF
LED6: PWRLED; LED_0805_2012Metric; PartsBoxID 0805-LED-BLUE
LED7: WIFI1_LED; LED_0805_2012Metric; PartsBoxID 0805-LED-GREEN
LED8: WIFI2_LED; LED_0805_2012Metric; PartsBoxID 0805-LED-GREEN
LED9: STATUS LED; LED_Cree-PLCC4_2x2mm_CW; PartsBoxID CLMVC-FKC-CGJJM569ABB7A343
R88, R89, R90, R97, R100, R102, R109, R110, R111, R112, R113, R116, R117, R120, R135: 4.7K; R_0402_1005Metric; PartsBoxID 0402-4.7K-1%
R91, R107, R108, R114, R115, R122: 10K; R_0402_1005Metric; PartsBoxID 0402-10K-1%
R92, R93, R94, R95, R96, R98, R101, R119, R129: 1K; R_0402_1005Metric; PartsBoxID 0402-1K-1%
R99, R118: DNP 4.7K; R_0402_1005Metric; PartsBoxID 0402-4.7K-1%
R103, R104, R105, R106, R123, R125, R126, R127, R128, R131, R133, R134, R138, R139, R140, R143, R145: 0; R_0402_1005Metric; PartsBoxID 0402-0R-1%
R121, R130, R132: DNP 0; R_0402_1005Metric; PartsBoxID 0402-0R-1%
R124, R137: 91K; R_0402_1005Metric; PartsBoxID 0402-91K-1%
R136: 330; R_0402_1005Metric; PartsBoxID 0402-330R-1%
R141, R142, R144, R146, R147: 220; R_0402_1005Metric; PartsBoxID 0402-220R-1%
SW1: RESET; Panasonic_EVQPUJ_EVQPUA; PartsBoxID 436351045816
TP1, TP2, TP3: TestPoint; TestPoint_Pad_D1.0mm
U7: LS1043ASE7xxx; BGA621C80P25X25_2100X2100X192N; PartsBoxID LS1043ASE7
U9: 74LVC2G08; VSSOP-8_3.0x3.0mm_P0.65mm; PartsBoxID 74LVC2G08DC,125
U10: SA56004EDP,118; TSSOP-8_3x3mm_P0.65mm; PartsBoxID SA56004EDP,118
U11: SP3232EBEY-L/TR; TSSOP-16_4.4x5mm_P0.65mm; PartsBoxID SP3232EBEY-L/TR
U12, U13, U16, U19: 74LVC1G08; SC70; PartsBoxID SN74LVC1G08DCKT
U14, U15, U17, U20: 74LVC1G07; SC70; PartsBoxID 74LVC1G07
U18: ATECC608A-MAHDA; DFN-8-1EP_3x2mm_P0.5mm_EP1.3x1.5mm; PartsBoxID ATECC608A-MAHDA-T

Connections:
/1V8: C151.1, C161.1, C162.1, C163.1, C164.1, C166.1, C167.1, C168.1, J3.1 (VTref), R88.1, R89.1, R90.1, R91.2, R96.1, R97.1, R98.1, R100.2, R101.2, R107.2, R108.2, R109.2, R110.2, R111.2, R112.2, R113.2, R114.2, R115.2, R116.2, R117.2, R118.1, R119.2, R122.2, R129.2, R137.2, U9.8, U13.5, U14.5, U15.5, U16.5, U17.5, U19.5, U20.5; also elsewhere on the board
/3V3: C149.1, C152.1, C157.1, C158.1, C160.1, C165.1, IC4.5 (VDD), IC5.16 (VDD), LED9.4 (A), R92.2, R93.2, R94.2, R95.2, R124.2, R135.2, R141.1, R142.1, U10.1 (VDD), U11.16 (VCC), U12.5, U18.8 (VCC); also elsewhere on the board
/3V3_PG: R126.1; also elsewhere on the board
/5V_PG: R127.1; also elsewhere on the board
/CPU_VDD_PG: R125.1; also elsewhere on the board
/CPU_VDD_SENSE: R102.1; also elsewhere on the board
/DDR4_RST_B: R139.2; also elsewhere on the board
/DDRCLK_18: U7.F19 (DDRCLK); also elsewhere on the board
/DIFF_SYSCLK_N: U7.G9 (~DIFF_SYSCLK~); also elsewhere on the board
/DIFF_SYSCLK_P: U7.G8 (DIFF_SYSCLK); also elsewhere on the board
/I2C1_SCL: R93.1, R103.1, R131.1, R145.1, U7.N1 (IIC1_SCL); also elsewhere on the board
/I2C1_SDA: R92.1, R104.1, R134.1, R143.1, U7.M1 (IIC1_SDA); also elsewhere on the board
/I2C2_SCL: R95.1, U7.K3 (GPIO4_02/IIC2_SCL); also elsewhere on the board
/I2C2_SDA: R94.1, U7.L3 (GPIO4_03/IIC2_SDA); also elsewhere on the board
/PMIC_INT_B: U9.2; also elsewhere on the board
/PMIC_POR_B: R130.1, R138.1; also elsewhere on the board
/RST_PCIE0_B: U17.4; also elsewhere on the board
/RST_PCIE1_B: U20.4; also elsewhere on the board
/RST_eMMC_B: R140.2; also elsewhere on the board
/Reset/JTAG_RST_B_18: J3.10 (~RESET~), R114.1, U13.2
/Reset/LED1: U7.J3 (IRQ03/GPIO1_23)
/Reset/LED2: U7.J4 (IRQ04/GPIO1_24)
/Reset/LED3: U7.J5 (IRQ05/GPIO1_25)
/Reset/LED4: U7.K5 (IRQ06/GPIO1_26)
/Reset/LED5: U7.L5 (IRQ07/GPIO1_27)
/Reset/LED6: U7.M5 (IRQ08/GPIO1_28)
/Reset/LED7: U7.N5 (IRQ09/GPIO1_29)
/Reset/LED8: U7.P4 (IRQ10/GPIO1_30)
/Reset/PORESET_B_18: R121.1, R137.1, U7.F10 (~PORESET~), U13.4, U14.2, U15.2, U16.1, U19.1
/Reset/RESET_BTN_B: R91.1, SW1.1 (A), U7.L1 (GPIO1_20/!UART2_RTS)
/Reset/RESET_REQ_B_18: R97.2, R128.2, U7.G7 (~RESET_REQ~)
/Reset/RST_PCIE0: U7.K1 (GPIO1_18/UART2_SIN), U16.2
/Reset/RST_PCIE1: U7.L2 (GPIO1_16/UART2_SOUT), U19.2
/Reset/RTC_OUT: IC5.7 (CLKOUT), R129.1, U7.F16 (RTC/GPIO1_14)
/Reset/STATUS_LED_B: R147.2
/Reset/STATUS_LED_G: R146.2
/Reset/STATUS_LED_R: R144.2
/Reset/TABB_RTCCLK: TP2.1, U7.G20 (TA_BB_RTC)
/Reset/THERM_INTn: U9.1, U9.3
/Reset/UART_CTS: U7.J1 (GPIO1_21/!UART1_CTS), U11.9 (R2OUT)
/Reset/UART_RTS: U7.J2 (GPIO1_19/!UART1_RTS), U11.10 (T2IN)
/Reset/UART_RX: U7.H2 (GPIO1_17/UART1_SIN), U11.12 (R1OUT)
/Reset/UART_TX: U7.H1 (GPIO1_15/UART1_SOUT), U11.11 (T1IN)
/Reset/WIFI1_LED: LED7.1 (K)
/Reset/WIFI2_LED: LED8.1 (K)
/SOC_IRQ0: R90.2, U7.F15 (IRQ00); also elsewhere on the board
/SOC_IRQ1: R89.2, U7.G15 (IRQ01); also elsewhere on the board
/SYSCLK_18: U7.F9 (SYSCLK); also elsewhere on the board
unnamed: BT1.1 (+), C159.1, R133.2
unnamed: C150.1, U7.R6 (TD1_ANODE), U10.2 (D+)
unnamed: C150.2, U7.P6 (TD1_CATHODE), U10.3 (D-)
unnamed: C153.1, U11.1 (C1+)
unnamed: C153.2, U11.3 (C1-)
unnamed: C154.1, U11.4 (C2+)
unnamed: C154.2, U11.5 (C2-)
unnamed: C155.1, U11.2 (VS+)
unnamed: C156.1, U11.6 (VS-)
unnamed: IC4.1 (~RST), R128.1
unnamed: IC4.3 (~MR), R130.2, R135.1, U12.2
unnamed: IC4.4 (IN), R124.1, R125.2, R126.2, R127.2, U12.1
unnamed: IC5.1 (SCL), R131.2
unnamed: IC5.4 (SDA/~CE), R134.2
unnamed: IC5.5 (IFS), IC5.14 (BBS)
unnamed: IC5.15 (VBAT), R133.1
unnamed: J3.2 (SWDIO/TMS), U7.F18 (TMS)
unnamed: J3.4 (SWDCLK/TCK), R115.1, U7.E18 (TCK)
unnamed: J3.6 (SWO/TDO), U7.E20 (TDO)
unnamed: J3.8 (NC/TDI), U7.G18 (TDI)
unnamed: J3.9 (GNDDetect), R122.1, R123.2
unnamed: J4.1, U11.7 (T2OUT)
unnamed: J4.2, R132.2
unnamed: J4.3, U11.14 (T1OUT)
unnamed: J4.6, U11.13 (R1IN)
unnamed: J4.7, R132.1
unnamed: J4.8, U11.8 (R2IN)
unnamed: LED6.2 (A), R136.1
unnamed: LED7.2 (A), R141.2
unnamed: LED8.2 (A), R142.2
unnamed: LED9.1 (RK), R144.1
unnamed: LED9.2 (GK), R146.1
unnamed: LED9.3 (BK), R147.1
unnamed: R88.2, U7.J6 (IRQ02), U9.7
unnamed: R96.2, U7.G10 (~HRESET~)
unnamed: R98.2, U7.G16 (~TA_TMP_DETECT~)
unnamed: R99.2, R100.1, U7.C21 (~TBSCAN_EN~)
unnamed: R101.1, U7.E21 (~TEST_SEL~)
unnamed: R102.2, U7.G19 (~TA_BB_TMP_DETECT~)
unnamed: R103.2, U10.8 (SCLK)
unnamed: R104.2, U10.7 (SDATA)
unnamed: R105.1, U10.4 (~THERM)
unnamed: R105.2, R108.1, U9.6
unnamed: R106.1, U10.6 (~ALERT)
unnamed: R106.2, R107.1, U9.5
unnamed: R109.1, U7.E10 (~EVT0~)
unnamed: R110.1, U7.E13 (~EVT1~)
unnamed: R111.1, U7.E8 (~EVT2~)
unnamed: R112.1, U7.E12 (~EVT3~)
unnamed: R113.1, U7.E11 (~EVT4~)
unnamed: R116.1, U7.H7 (~EVT9~)
unnamed: R117.1, U7.H18 (~CKSTP_OUT~)
unnamed: R118.2, R120.1, U7.F21 (JTAG_BSR_VSEL)
unnamed: R119.1, U7.A21 (~SCAN_MODE~)
unnamed: R121.2, U7.E19 (~TRST~)
unnamed: R136.2, U12.4
unnamed: R138.2, U13.1
unnamed: R139.1, U14.4
unnamed: R140.1, U15.4
unnamed: R143.2, U18.5 (SDA)
unnamed: R145.2, U18.6 (SCL)
unnamed: TP1.1, U7.V5 (IRQ11/GPIO1_31)
unnamed: TP3.1, U7.G17 (CLK_OUT)
unnamed: U16.4, U17.2
unnamed: U19.4, U20.2

Notes on the sheet:
JTAG
LEDs
Reset Logic
Note: I2C Address: 0x51
Note: I2C Address: 0x60
Real Time Clock
100 ohm = 1.6MHZ Cutoff
Crypto / Key Storage
CPU Temp
Note: I2C Address: 0x4C
Serial Console
