imagestream/kicad/AP2100.ls1043/AP2100.kicad_pcb

## KiCad design AP2100.ls1043/AP2100.kicad_pcb (continued)

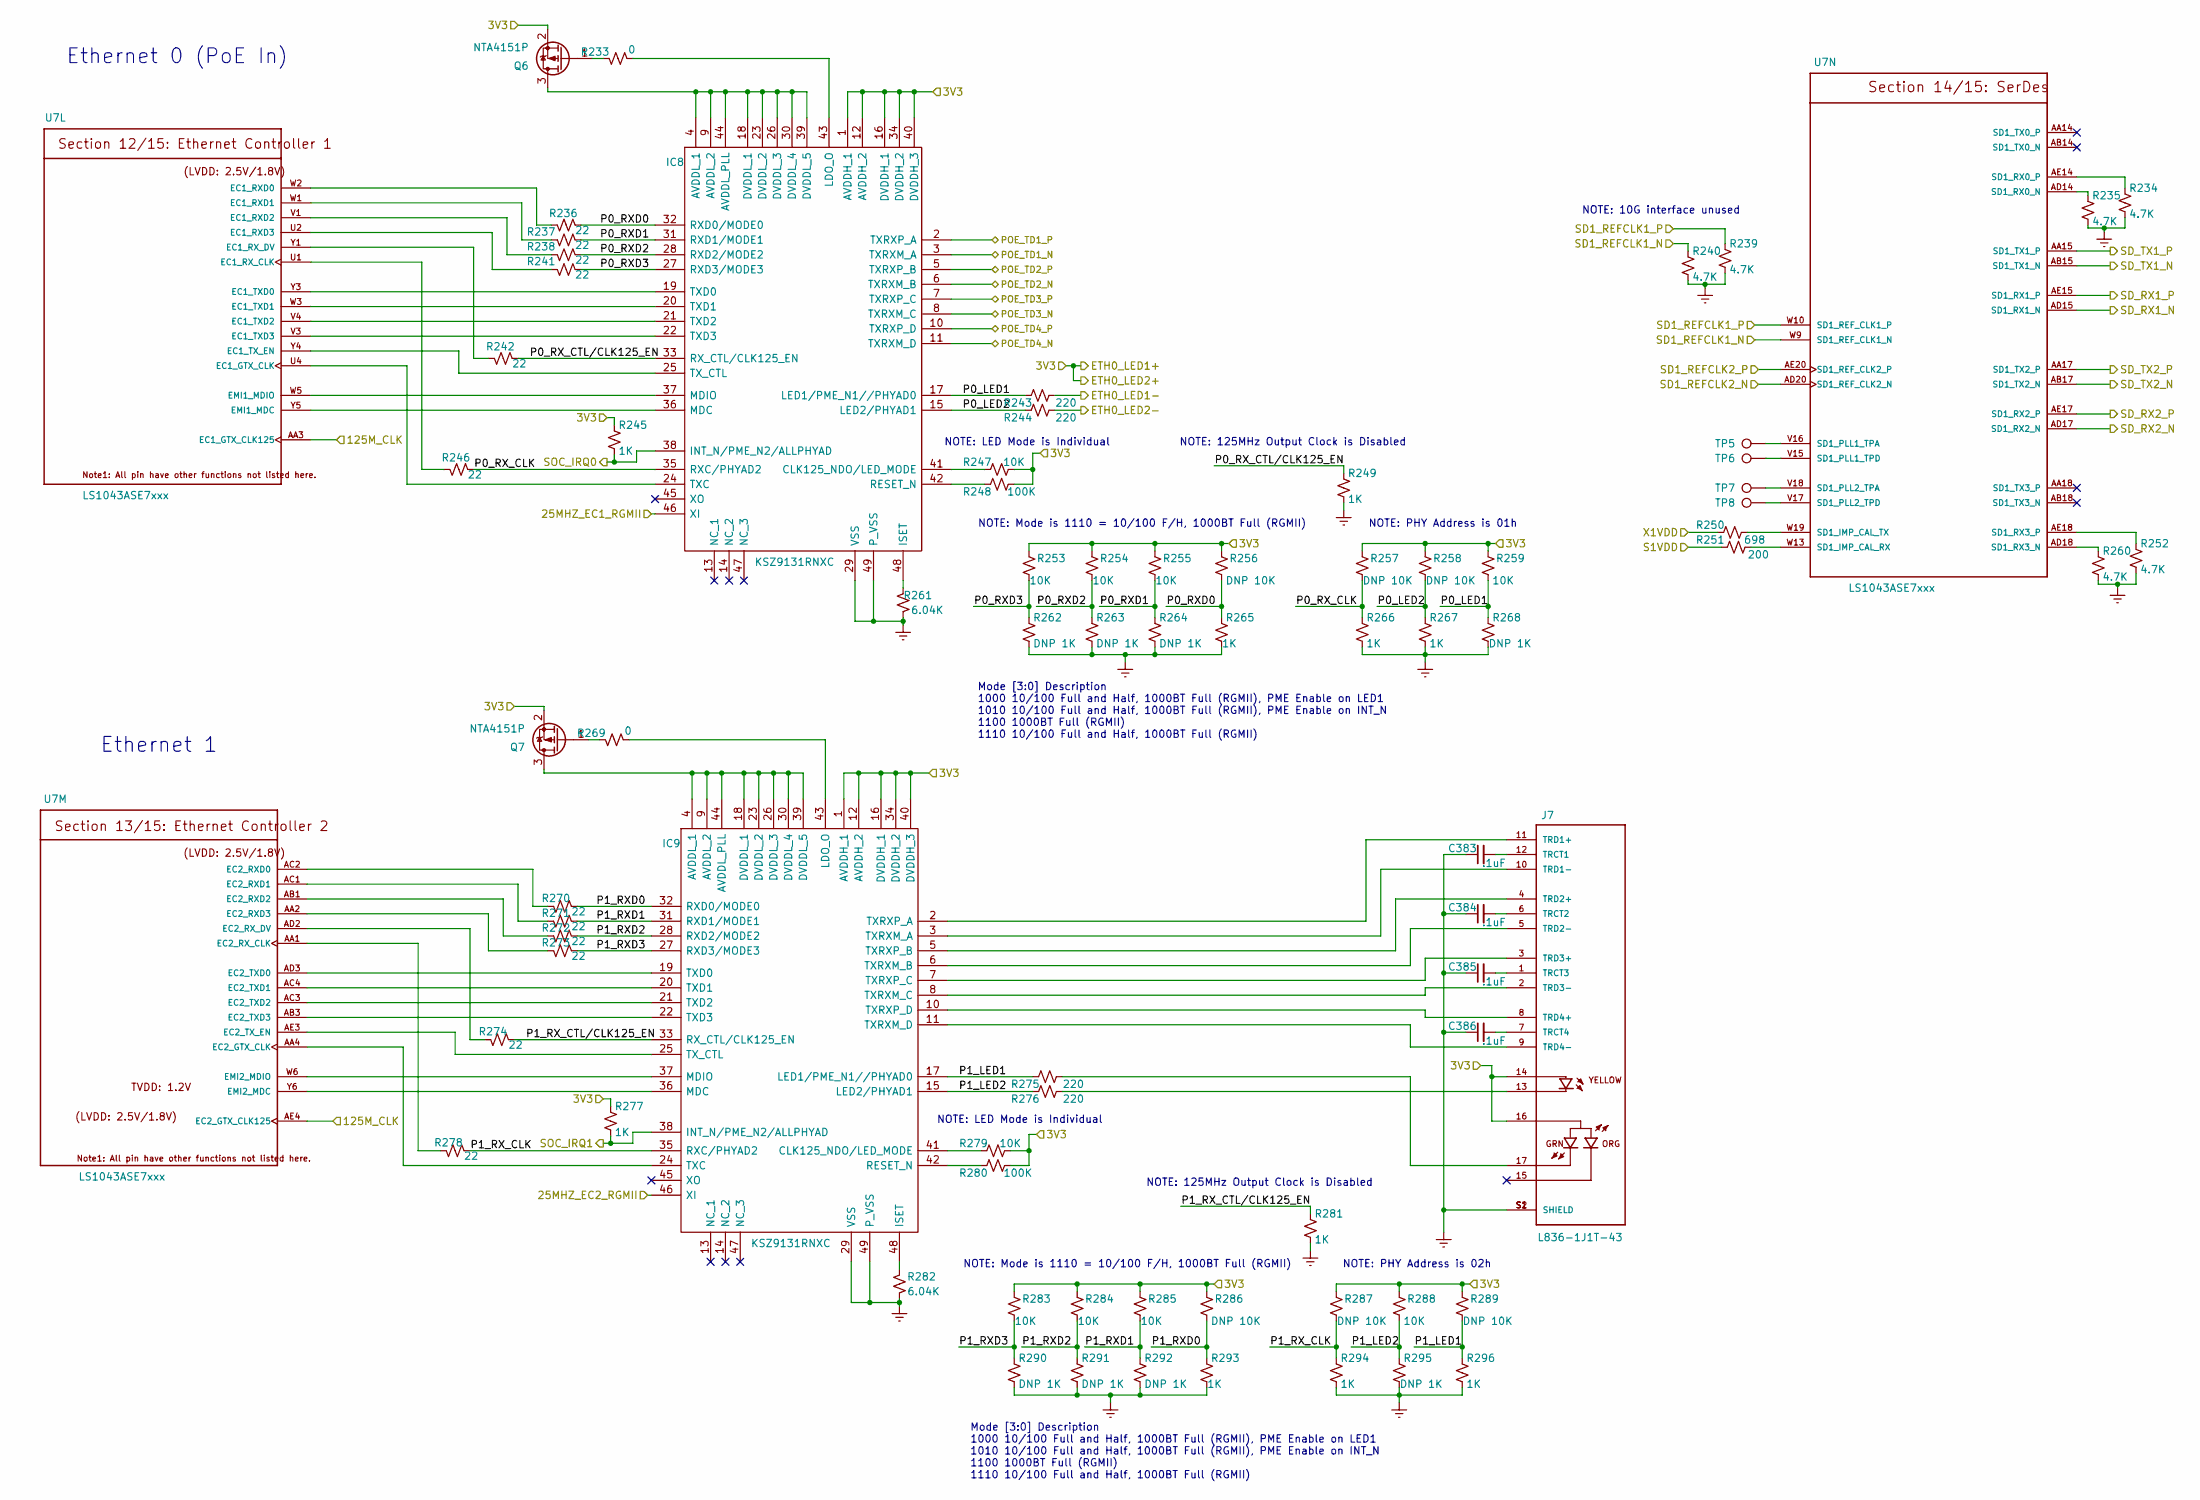
[picture p135: schematic SerDes_RGMII.kicad_sch, AP2100]

Parts:
C383, C384, C385, C386: .1uF; C_0402_1005Metric; PartsBoxID 0402-.1uF-X5R-25V
IC8, IC9: KSZ9131RNXC; QFN50P700X700X90-49N; Manufacturer_Part_Number KSZ9131RNXC; Mouser Part Number 579-KSZ9131RNXC
J7: L836-1J1T-43; BEL_L836-1J1T-43; PartsBoxID L836-1J1T-43
Q6, Q7: NTA4151P; SOT-416; PartsBoxID NTA4151PT1G
R233, R269: 0; R_0402_1005Metric; PartsBoxID 0402-0R-1%
R234, R235, R239, R240, R252, R260: 4.7K; R_0402_1005Metric; PartsBoxID 0402-4.7K-1%
R236, R237, R238, R241, R242, R246, R270, R271, R272, R273, R274, R278: 22; R_0402_1005Metric; PartsBoxID 0402-22R-1%
R243, R244, R275, R276: 220; R_0402_1005Metric; PartsBoxID 0402-220R-1%
R245, R249, R265, R266, R267, R277, R281, R293, R294, R296: 1K; R_0402_1005Metric; PartsBoxID 0402-1K-1%
R247, R253, R254, R255, R259, R279, R283, R284, R285, R288: 10K; R_0402_1005Metric; PartsBoxID 0402-10K-1%
R248, R280: 100K; R_0402_1005Metric; PartsBoxID 0402-100K-1%
R250: 698; R_0402_1005Metric; PartsBoxID 0402-698R-1%
R251: 200; R_0402_1005Metric; PartsBoxID 0402-200R-1%
R256, R257, R258, R286, R287, R289: DNP 10K; R_0402_1005Metric; PartsBoxID 0402-10K-1%
R261, R282: 6.04K; R_0402_1005Metric; PartsBoxID 0402-6.04K-1%
R262, R263, R264, R268, R290, R291, R292, R295: DNP 1K; R_0402_1005Metric; PartsBoxID 0402-1K-1%
TP5, TP6, TP7, TP8: TestPoint; TestPoint_Pad_D1.0mm
U7: LS1043ASE7xxx; BGA621C80P25X25_2100X2100X192N; PartsBoxID LS1043ASE7

Connections:
/3V3: IC8.1 (AVDDH_1), IC8.12 (AVDDH_2), IC8.16 (DVDDH_1), IC8.34 (DVDDH_2), IC8.40 (DVDDH_3), IC9.1 (AVDDH_1), IC9.12 (AVDDH_2), IC9.16 (DVDDH_1), IC9.34 (DVDDH_2), IC9.40 (DVDDH_3), J7.14, J7.16, Q6.2 (S), Q7.2 (S), R245.1, R247.2, R248.2, R253.1, R254.1, R255.1, R256.1, R257.1, R258.1, R259.1, R277.1, R279.2, R280.2, R283.1, R284.1, R285.1, R286.1, R287.1, R288.1, R289.1; also elsewhere on the board
/25MHZ_EC1_RGMII: IC8.46 (XI); also elsewhere on the board
/25MHZ_EC2_RGMII: IC9.46 (XI); also elsewhere on the board
/125M_CLK: U7.AA3 (EC1_GTX_CLK125), U7.AE4 (EC2_GTX_CLK125); also elsewhere on the board
/ETH0_LED1-: R243.2; also elsewhere on the board
/ETH0_LED2-: R244.2; also elsewhere on the board
/POE_TD1_N: IC8.3 (TXRXM_A); also elsewhere on the board
/POE_TD1_P: IC8.2 (TXRXP_A); also elsewhere on the board
/POE_TD2_N: IC8.6 (TXRXM_B); also elsewhere on the board
/POE_TD2_P: IC8.5 (TXRXP_B); also elsewhere on the board
/POE_TD3_N: IC8.8 (TXRXM_C); also elsewhere on the board
/POE_TD3_P: IC8.7 (TXRXP_C); also elsewhere on the board
/POE_TD4_N: IC8.11 (TXRXM_D); also elsewhere on the board
/POE_TD4_P: IC8.10 (TXRXP_D); also elsewhere on the board
/S1VDD: R251.1; also elsewhere on the board
/SD1_REFCLK1_N: R240.1, U7.W9 (SD1_REF_CLK1_N); also elsewhere on the board
/SD1_REFCLK1_P: R239.1, U7.W10 (SD1_REF_CLK1_P); also elsewhere on the board
/SD1_REFCLK2_N: U7.AD20 (SD1_REF_CLK2_N); also elsewhere on the board
/SD1_REFCLK2_P: U7.AE20 (SD1_REF_CLK2_P); also elsewhere on the board
/SD_RX1_N: U7.AD15 (SD1_RX1_N); also elsewhere on the board
/SD_RX1_P: U7.AE15 (SD1_RX1_P); also elsewhere on the board
/SD_RX2_N: U7.AD17 (SD1_RX2_N); also elsewhere on the board
/SD_RX2_P: U7.AE17 (SD1_RX2_P); also elsewhere on the board
/SD_TX1_N: U7.AB15 (SD1_TX1_N); also elsewhere on the board
/SD_TX1_P: U7.AA15 (SD1_TX1_P); also elsewhere on the board
/SD_TX2_N: U7.AB17 (SD1_TX2_N); also elsewhere on the board
/SD_TX2_P: U7.AA17 (SD1_TX2_P); also elsewhere on the board
/SOC_IRQ0: IC8.38 (INT_N/PME_N2/ALLPHYAD), R245.2; also elsewhere on the board
/SOC_IRQ1: IC9.38 (INT_N/PME_N2/ALLPHYAD), R277.2; also elsewhere on the board
/SerDes / RGMII Ethernet/P0_LED1: IC8.17 (LED1/PME_N1//PHYAD0), R243.1, R259.2, R268.1
/SerDes / RGMII Ethernet/P0_LED2: IC8.15 (LED2/PHYAD1), R244.1, R258.2, R267.1
/SerDes / RGMII Ethernet/P0_RXD0: IC8.32 (RXD0/MODE0), R236.2, R256.2, R265.1
/SerDes / RGMII Ethernet/P0_RXD1: IC8.31 (RXD1/MODE1), R237.2, R255.2, R264.1
/SerDes / RGMII Ethernet/P0_RXD2: IC8.28 (RXD2/MODE2), R238.2, R254.2, R263.1
/SerDes / RGMII Ethernet/P0_RXD3: IC8.27 (RXD3/MODE3), R241.2, R253.2, R262.1
/SerDes / RGMII Ethernet/P0_RX_CLK: IC8.35 (RXC/PHYAD2), R246.2, R257.2, R266.1
/SerDes / RGMII Ethernet/P0_RX_CTL/CLK125_EN: IC8.33 (RX_CTL/CLK125_EN), R242.2, R249.1
/SerDes / RGMII Ethernet/P1_LED1: IC9.17 (LED1/PME_N1//PHYAD0), R275.1, R289.2, R296.1
/SerDes / RGMII Ethernet/P1_LED2: IC9.15 (LED2/PHYAD1), R276.1, R288.2, R295.1
/SerDes / RGMII Ethernet/P1_RXD0: IC9.32 (RXD0/MODE0), R270.2, R286.2, R293.1
/SerDes / RGMII Ethernet/P1_RXD1: IC9.31 (RXD1/MODE1), R271.2, R285.2, R292.1
/SerDes / RGMII Ethernet/P1_RXD2: IC9.28 (RXD2/MODE2), R272.2, R284.2, R291.1
/SerDes / RGMII Ethernet/P1_RXD3: IC9.27 (RXD3/MODE3), R273.2, R283.2, R290.1
/SerDes / RGMII Ethernet/P1_RX_CLK: IC9.35 (RXC/PHYAD2), R278.2, R287.2, R294.1
/SerDes / RGMII Ethernet/P1_RX_CTL/CLK125_EN: IC9.33 (RX_CTL/CLK125_EN), R274.2, R281.1
/X1VDD: R250.1; also elsewhere on the board
unnamed: C383.2, J7.12 (TRCT1)
unnamed: C384.2, J7.6 (TRCT2)
unnamed: C385.2, J7.1 (TRCT3)
unnamed: C386.2, J7.7 (TRCT4)
unnamed: IC8.4 (AVDDL_1), IC8.9 (AVDDL_2), IC8.18 (DVDDL_1), IC8.23 (DVDDL_2), IC8.26 (DVDDL_3), IC8.30 (DVDDL_4), IC8.39 (DVDDL_5), IC8.44 (AVDDL_PLL), Q6.3 (D)
unnamed: IC8.19 (TXD0), U7.Y3 (EC1_TXD0)
unnamed: IC8.20 (TXD1), U7.W3 (EC1_TXD1)
unnamed: IC8.21 (TXD2), U7.V4 (EC1_TXD2)
unnamed: IC8.22 (TXD3), U7.V3 (EC1_TXD3)
unnamed: IC8.24 (TXC), U7.U4 (EC1_GTX_CLK)
unnamed: IC8.25 (TX_CTL), U7.Y4 (EC1_TX_EN)
unnamed: IC8.36 (MDC), U7.Y5 (EMI1_MDC)
unnamed: IC8.37 (MDIO), U7.W5 (EMI1_MDIO)
unnamed: IC8.41 (CLK125_NDO/LED_MODE), R247.1
unnamed: IC8.42 (RESET_N), R248.1
unnamed: IC8.43 (LDO_O), R233.1
unnamed: IC8.48 (ISET), R261.1
unnamed: IC9.2 (TXRXP_A), J7.11 (TRD1+)
unnamed: IC9.3 (TXRXM_A), J7.10 (TRD1-)
unnamed: IC9.5 (TXRXP_B), J7.4 (TRD2+)
unnamed: IC9.6 (TXRXM_B), J7.5 (TRD2-)
unnamed: IC9.7 (TXRXP_C), J7.3 (TRD3+)
unnamed: IC9.8 (TXRXM_C), J7.2 (TRD3-)
unnamed: IC9.10 (TXRXP_D), J7.8 (TRD4+)
unnamed: IC9.11 (TXRXM_D), J7.9 (TRD4-)
unnamed: IC9.4 (AVDDL_1), IC9.9 (AVDDL_2), IC9.18 (DVDDL_1), IC9.23 (DVDDL_2), IC9.26 (DVDDL_3), IC9.30 (DVDDL_4), IC9.39 (DVDDL_5), IC9.44 (AVDDL_PLL), Q7.3 (D)
unnamed: IC9.19 (TXD0), U7.AD3 (EC2_TXD0)
unnamed: IC9.20 (TXD1), U7.AC4 (EC2_TXD1)
unnamed: IC9.21 (TXD2), U7.AC3 (EC2_TXD2)
unnamed: IC9.22 (TXD3), U7.AB3 (EC2_TXD3)
unnamed: IC9.24 (TXC), U7.AA4 (EC2_GTX_CLK)
unnamed: IC9.25 (TX_CTL), U7.AE3 (EC2_TX_EN)
unnamed: IC9.36 (MDC), U7.Y6 (EMI2_MDC)
unnamed: IC9.37 (MDIO), U7.W6 (EMI2_MDIO)
unnamed: IC9.41 (CLK125_NDO/LED_MODE), R279.1
unnamed: IC9.42 (RESET_N), R280.1
unnamed: IC9.43 (LDO_O), R269.1
unnamed: IC9.48 (ISET), R282.1
unnamed: J7.13, R276.2
unnamed: J7.17, R275.2
unnamed: Q6.1 (G), R233.2
unnamed: Q7.1 (G), R269.2
unnamed: R234.1, U7.AE14 (SD1_RX0_P)
unnamed: R235.1, U7.AD14 (SD1_RX0_N)
unnamed: R236.1, U7.W2 (EC1_RXD0)
unnamed: R237.1, U7.W1 (EC1_RXD1)
unnamed: R238.1, U7.V1 (EC1_RXD2)
unnamed: R241.1, U7.U2 (EC1_RXD3)
unnamed: R242.1, U7.Y1 (EC1_RX_DV)
unnamed: R246.1, U7.U1 (EC1_RX_CLK)
unnamed: R250.2, U7.W19 (SD1_IMP_CAL_TX)
unnamed: R251.2, U7.W13 (SD1_IMP_CAL_RX)
unnamed: R252.1, U7.AE18 (SD1_RX3_P)
unnamed: R260.1, U7.AD18 (SD1_RX3_N)
unnamed: R270.1, U7.AC2 (EC2_RXD0)
unnamed: R271.1, U7.AC1 (EC2_RXD1)
unnamed: R272.1, U7.AB1 (EC2_RXD2)
unnamed: R273.1, U7.AA2 (EC2_RXD3)
unnamed: R274.1, U7.AD2 (EC2_RX_DV)
unnamed: R278.1, U7.AA1 (EC2_RX_CLK)
unnamed: TP5.1, U7.V16 (SD1_PLL1_TPA)
unnamed: TP6.1, U7.V15 (SD1_PLL1_TPD)
unnamed: TP7.1, U7.V18 (SD1_PLL2_TPA)
unnamed: TP8.1, U7.V17 (SD1_PLL2_TPD)

Notes on the sheet:
Ethernet 1
Ethernet 0 (PoE In)
Mode [3:0] Description 1000 10/100 Full and Half, 1000BT Full (RGMII), PME Enable on LED1 1010 10/100 Full and Half, 1000BT Full (RGMII), PME Enable on INT_N 1100 1000BT Full (RGMII) 1110 10/100 Full and Half, 1000BT Full (RGMII)
NOTE: LED Mode is Individual
NOTE: Mode is 1110 = 10/100 F/H, 1000BT Full (RGMII)
NOTE: 125MHz Output Clock is Disabled
NOTE: PHY Address is 02h
NOTE: PHY Address is 01h
NOTE: 10G interface unused

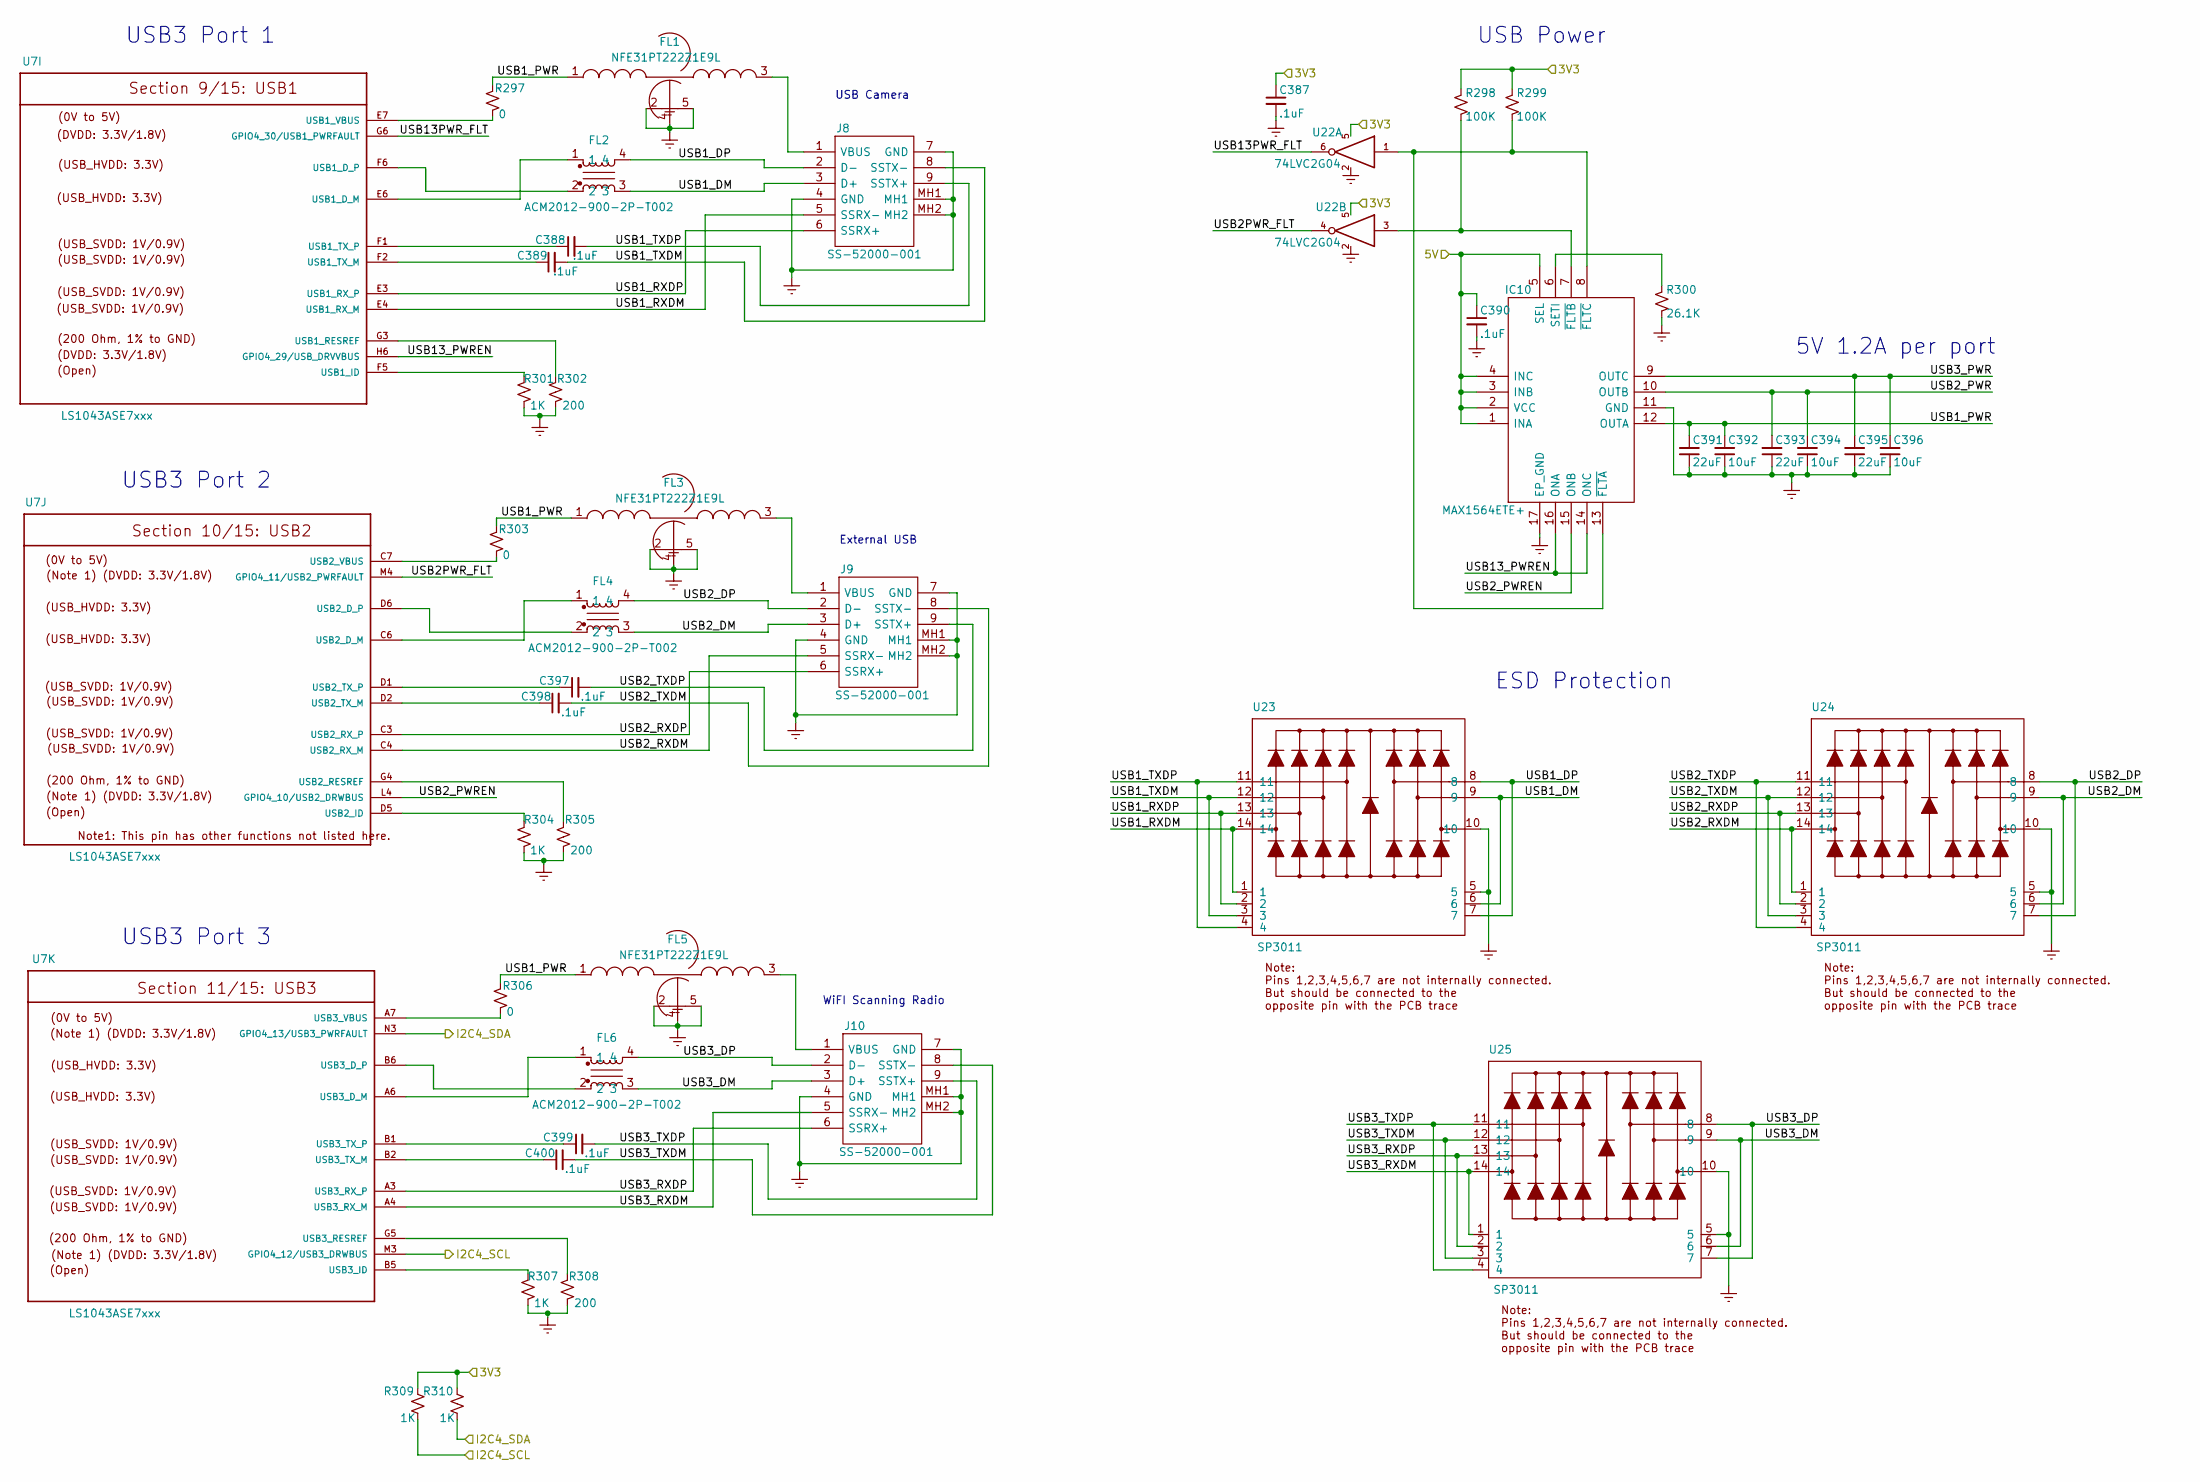
[picture p136: schematic USB.kicad_sch, AP2100]

Parts:
C387, C388, C389, C390, C397, C398, C399, C400: .1uF; C_0402_1005Metric; PartsBoxID 0402-.1uF-X5R-25V
C391, C393, C395: 22uF; C_0805_2012Metric; PartsBoxID 0805-22uF-X5R-25V
C392, C394, C396: 10uF; C_0805_2012Metric; PartsBoxID 0805-10uF-X7R-6.3V
FL1, FL3, FL5: NFE31PT222Z1E9L; NFE31; Manufacturer_Part_Number NFE31PT222Z1E9L; Mouser Part Number 81-NFE31PT222Z1E9L
FL2, FL4, FL6: ACM2012-900-2P-T002; ACM2012_1; Manufacturer_Part_Number ACM2012-900-2P-T002; Mouser Part Number 810-ACM20129002PT002
IC10: MAX1564ETE+; QFN65P400X400X80-17N; Manufacturer_Part_Number MAX1564ETE+; Mouser Part Number 700-MAX1564ETE
J8, J9, J10: SS-52000-001; SS52000001; Manufacturer_Part_Number SS-52000-001; Mouser Part Number 530-SS-52000-001
R297, R303, R306: 0; R_0402_1005Metric; PartsBoxID 0402-0R-1%
R298, R299: 100K; R_0402_1005Metric; PartsBoxID 0402-100K-1%
R300: 26.1K; R_0402_1005Metric; PartsBoxID 0402-26.1K-1%
R301, R304, R307, R309, R310: 1K; R_0402_1005Metric; PartsBoxID 0402-1K-1%
R302, R305, R308: 200; R_0402_1005Metric; PartsBoxID 0402-200R-1%
U7: LS1043ASE7xxx; BGA621C80P25X25_2100X2100X192N; PartsBoxID LS1043ASE7
U22: 74LVC2G04; SC70-6; PartsBoxID SN74LVC2G06DCKR
U23, U24, U25: SP3011; uDFN-14_1.35x3.5mm_P0.5mm; PartsBoxID SP3011-06UTG

Connections:
/3V3: C387.1, R298.1, R299.1, R309.2, R310.2, U22.5; also elsewhere on the board
/5V: C390.1, IC10.1 (INA), IC10.2 (VCC), IC10.3 (INB), IC10.4 (INC), IC10.5 (SEL); also elsewhere on the board
/I2C4_SCL: R309.1, U7.M3 (GPIO4_12/USB3_DRWBUS); also elsewhere on the board
/I2C4_SDA: R310.1, U7.N3 (GPIO4_13/USB3_PWRFAULT); also elsewhere on the board
/USB/USB1_DM: FL2.3, J8.3 (D+), U23.6, U23.9
/USB/USB1_DP: FL2.4, J8.2 (D-), U23.7, U23.8
/USB/USB1_PWR: C391.2, C392.2, FL1.1, FL3.1, FL5.1, IC10.12 (OUTA), R297.1, R303.1, R306.1
/USB/USB1_RXDM: J8.5 (SSRX-), U7.E4 (USB1_RX_M), U23.1, U23.14
/USB/USB1_RXDP: J8.6 (SSRX+), U7.E3 (USB1_RX_P), U23.2, U23.13
/USB/USB1_TXDM: C389.2, J8.8 (SSTX-), U23.3, U23.12
/USB/USB1_TXDP: C388.2, J8.9 (SSTX+), U23.4, U23.11
/USB/USB2PWR_FLT: U7.M4 (GPIO4_11/USB2_PWRFAULT), U22.4
/USB/USB2_DM: FL4.3, J9.3 (D+), U24.6, U24.9
/USB/USB2_DP: FL4.4, J9.2 (D-), U24.7, U24.8
/USB/USB2_PWR: C393.2, C394.2, IC10.10 (OUTB)
/USB/USB2_PWREN: IC10.15 (ONB), U7.L4 (GPIO4_10/USB2_DRWBUS)
/USB/USB2_RXDM: J9.5 (SSRX-), U7.C4 (USB2_RX_M), U24.1, U24.14
/USB/USB2_RXDP: J9.6 (SSRX+), U7.C3 (USB2_RX_P), U24.2, U24.13
/USB/USB2_TXDM: C398.2, J9.8 (SSTX-), U24.3, U24.12
/USB/USB2_TXDP: C397.2, J9.9 (SSTX+), U24.4, U24.11
/USB/USB3_DM: FL6.3, J10.3 (D+), U25.6, U25.9
/USB/USB3_DP: FL6.4, J10.2 (D-), U25.7, U25.8
/USB/USB3_PWR: C395.2, C396.2, IC10.9 (OUTC)
/USB/USB3_RXDM: J10.5 (SSRX-), U7.A4 (USB3_RX_M), U25.1, U25.14
/USB/USB3_RXDP: J10.6 (SSRX+), U7.A3 (USB3_RX_P), U25.2, U25.13
/USB/USB3_TXDM: C400.2, J10.8 (SSTX-), U25.3, U25.12
/USB/USB3_TXDP: C399.2, J10.9 (SSTX+), U25.4, U25.11
/USB/USB13PWR_FLT: U7.G6 (GPIO4_30/USB1_PWRFAULT), U22.6
/USB/USB13_PWREN: IC10.14 (ONC), IC10.16 (ONA), U7.H6 (GPIO4_29/USB_DRVVBUS)
unnamed: C388.1, U7.F1 (USB1_TX_P)
unnamed: C389.1, U7.F2 (USB1_TX_M)
unnamed: C397.1, U7.D1 (USB2_TX_P)
unnamed: C398.1, U7.D2 (USB2_TX_M)
unnamed: C399.1, U7.B1 (USB3_TX_P)
unnamed: C400.1, U7.B2 (USB3_TX_M)
unnamed: FL1.3, J8.1 (VBUS)
unnamed: FL2.1, U7.E6 (USB1_D_M)
unnamed: FL2.2, U7.F6 (USB1_D_P)
unnamed: FL3.3, J9.1 (VBUS)
unnamed: FL4.1, U7.C6 (USB2_D_M)
unnamed: FL4.2, U7.D6 (USB2_D_P)
unnamed: FL5.3, J10.1 (VBUS)
unnamed: FL6.1, U7.A6 (USB3_D_M)
unnamed: FL6.2, U7.B6 (USB3_D_P)
unnamed: IC10.6 (SETI), R300.1
unnamed: IC10.7 (~FLTB), R298.2, U22.3
unnamed: IC10.8 (~FLTC), IC10.13 (~FLTA), R299.2, U22.1
unnamed: R297.2, U7.E7 (USB1_VBUS)
unnamed: R301.1, U7.F5 (USB1_ID)
unnamed: R302.1, U7.G3 (USB1_RESREF)
unnamed: R303.2, U7.C7 (USB2_VBUS)
unnamed: R304.1, U7.D5 (USB2_ID)
unnamed: R305.1, U7.G4 (USB2_RESREF)
unnamed: R306.2, U7.A7 (USB3_VBUS)
unnamed: R307.1, U7.B5 (USB3_ID)
unnamed: R308.1, U7.G5 (USB3_RESREF)

Notes on the sheet:
USB3 Port 2
USB3 Port 3
USB3 Port 1
USB Camera
External USB
WiFI Scanning Radio
USB Power
ESD Protection
5V 1.2A per port

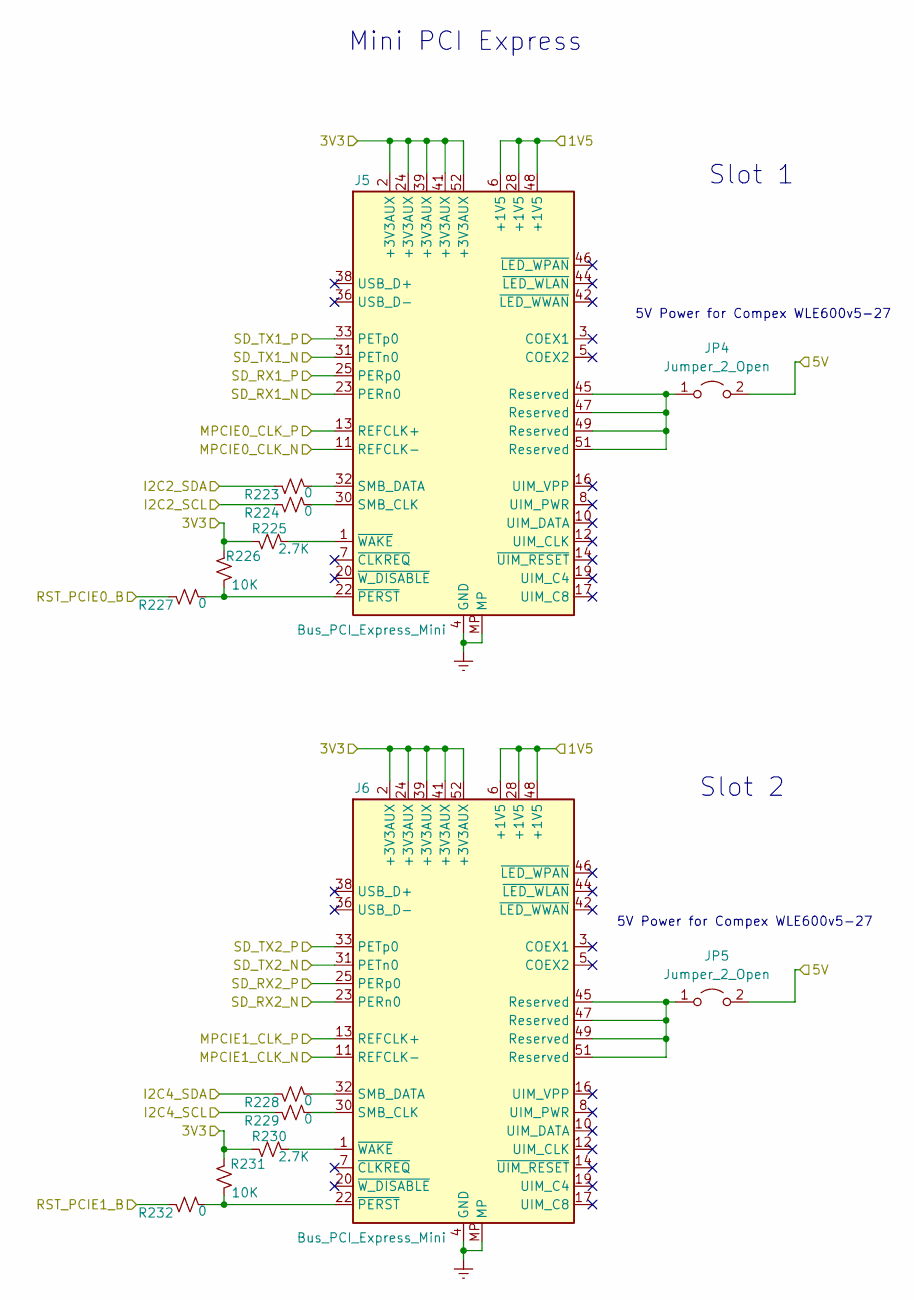
[picture p137: schematic PCIe.kicad_sch, AP2100]

Parts:
J5, J6: Bus_PCI_Express_Mini; BUS_PCI_Express_Mini_Full; PartsBoxID 1775838-2
JP4, JP5: Jumper_2_Open; PinHeader_1x02_P2.54mm_Vertical
R223, R224, R227, R228, R229, R232: 0; R_0402_1005Metric; PartsBoxID 0402-0R-1%
R225, R230: 2.7K; R_0402_1005Metric; PartsBoxID 0402-2.7K-1%
R226, R231: 10K; R_0402_1005Metric; PartsBoxID 0402-10K-1%

Connections:
/1V5: J5.6 (+1V5), J5.28 (+1V5), J5.48 (+1V5), J6.6 (+1V5), J6.28 (+1V5), J6.48 (+1V5); also elsewhere on the board
/3V3: J5.2 (+3V3AUX), J5.24 (+3V3AUX), J5.39 (+3V3AUX), J5.41 (+3V3AUX), J5.52 (+3V3AUX), J6.2 (+3V3AUX), J6.24 (+3V3AUX), J6.39 (+3V3AUX), J6.41 (+3V3AUX), J6.52 (+3V3AUX), R225.2, R226.1, R230.2, R231.1; also elsewhere on the board
/5V: JP4.2 (B), JP5.2 (B); also elsewhere on the board
/I2C2_SCL: R224.1; also elsewhere on the board
/I2C2_SDA: R223.1; also elsewhere on the board
/I2C4_SCL: R229.1; also elsewhere on the board
/I2C4_SDA: R228.1; also elsewhere on the board
/MPCIE0_CLK_N: J5.11 (REFCLK-); also elsewhere on the board
/MPCIE0_CLK_P: J5.13 (REFCLK+); also elsewhere on the board
/MPCIE1_CLK_N: J6.11 (REFCLK-); also elsewhere on the board
/MPCIE1_CLK_P: J6.13 (REFCLK+); also elsewhere on the board
/RST_PCIE0_B: R227.1; also elsewhere on the board
/RST_PCIE1_B: R232.1; also elsewhere on the board
/SD_RX1_N: J5.23 (PERn0); also elsewhere on the board
/SD_RX1_P: J5.25 (PERp0); also elsewhere on the board
/SD_RX2_N: J6.23 (PERn0); also elsewhere on the board
/SD_RX2_P: J6.25 (PERp0); also elsewhere on the board
/SD_TX1_N: J5.31 (PETn0); also elsewhere on the board
/SD_TX1_P: J5.33 (PETp0); also elsewhere on the board
/SD_TX2_N: J6.31 (PETn0); also elsewhere on the board
/SD_TX2_P: J6.33 (PETp0); also elsewhere on the board
unnamed: J5.1 (~WAKE), R225.1
unnamed: J5.22 (~PERST), R226.2, R227.2
unnamed: J5.30 (SMB_CLK), R224.2
unnamed: J5.32 (SMB_DATA), R223.2
unnamed: J5.45 (Reserved), J5.47 (Reserved), J5.49 (Reserved), J5.51 (Reserved), JP4.1 (A)
unnamed: J6.1 (~WAKE), R230.1
unnamed: J6.22 (~PERST), R231.2, R232.2
unnamed: J6.30 (SMB_CLK), R229.2
unnamed: J6.32 (SMB_DATA), R228.2
unnamed: J6.45 (Reserved), J6.47 (Reserved), J6.49 (Reserved), J6.51 (Reserved), JP5.1 (A)

Notes on the sheet:
Mini PCI Express
Slot 2
Slot 1
5V Power for Compex WLE600v5-27

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
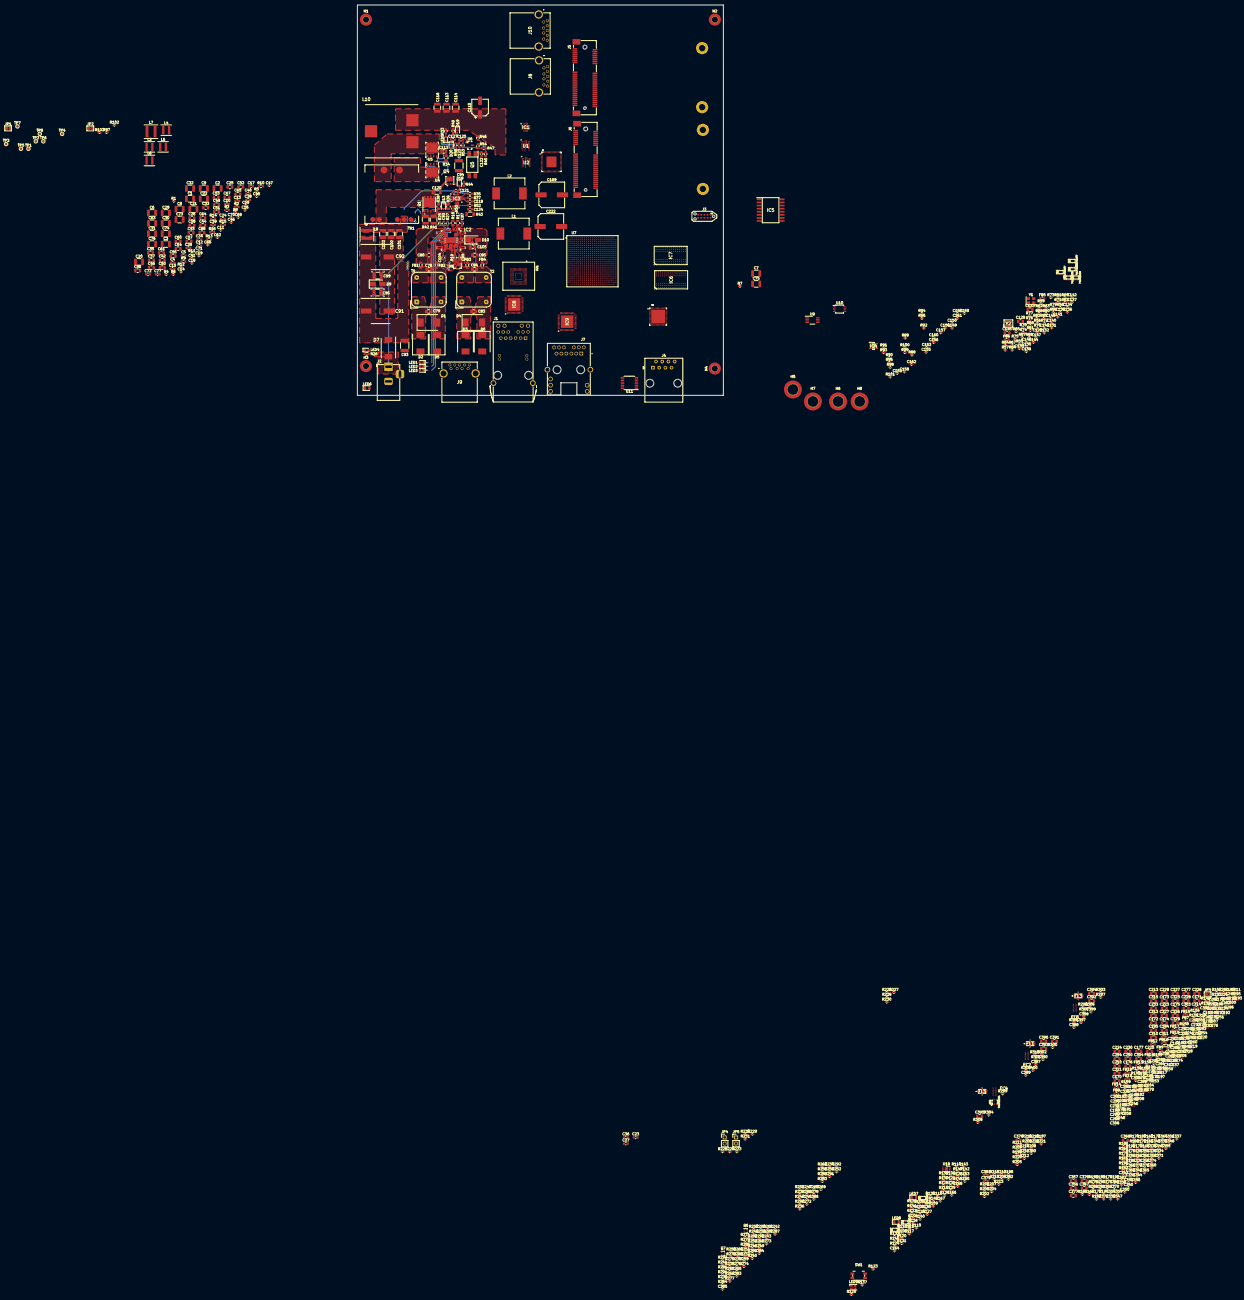
[picture p138: board AP2100.kicad_pcb from above]

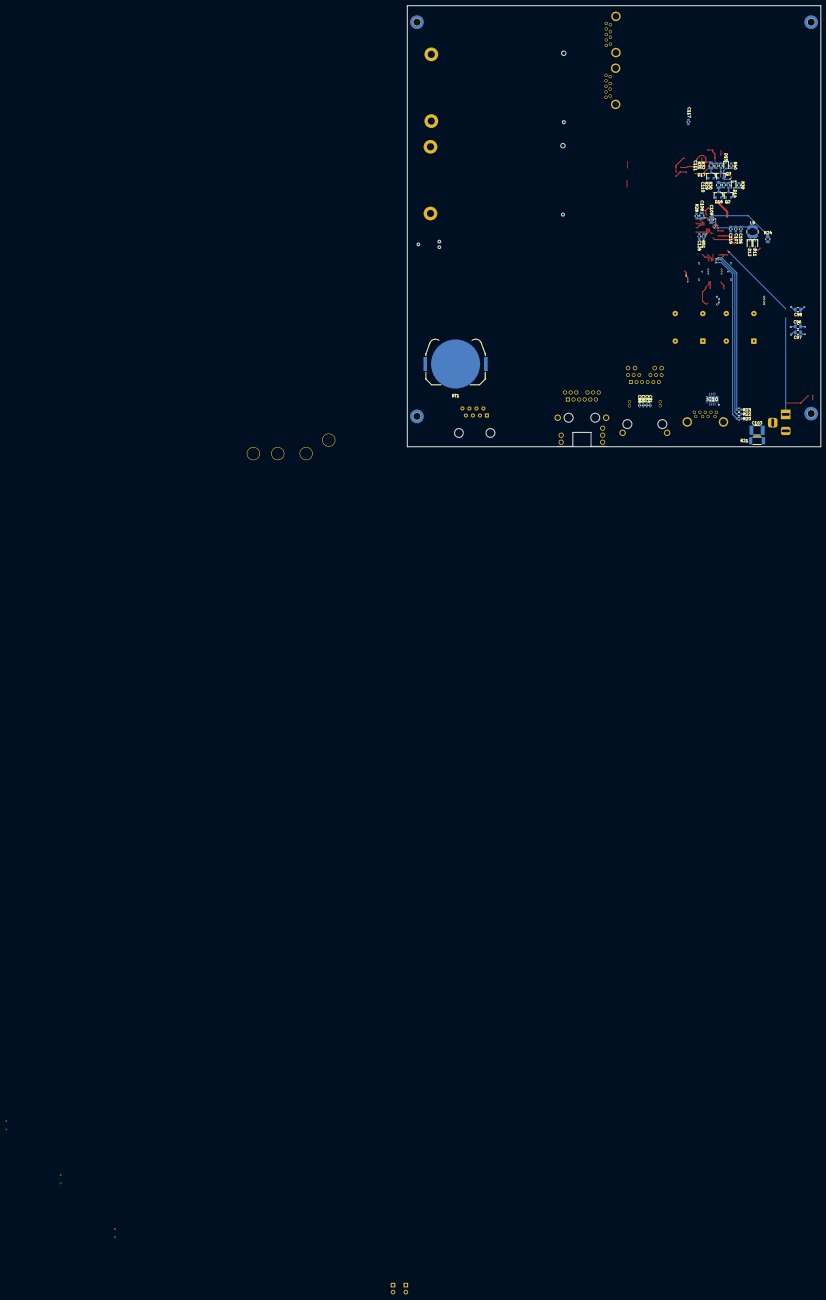
[picture p139: board AP2100.kicad_pcb from below]

Board: 6 copper layers, 150.0 x 160.0 mm, 854 parts (41 on the bottom side), 547 nets.
