imagestream/kicad/Hydroponics/Hydroponics.kicad_pcb

## KiCad design Hydroponics/Hydroponics.kicad_pcb (2020-06-23)

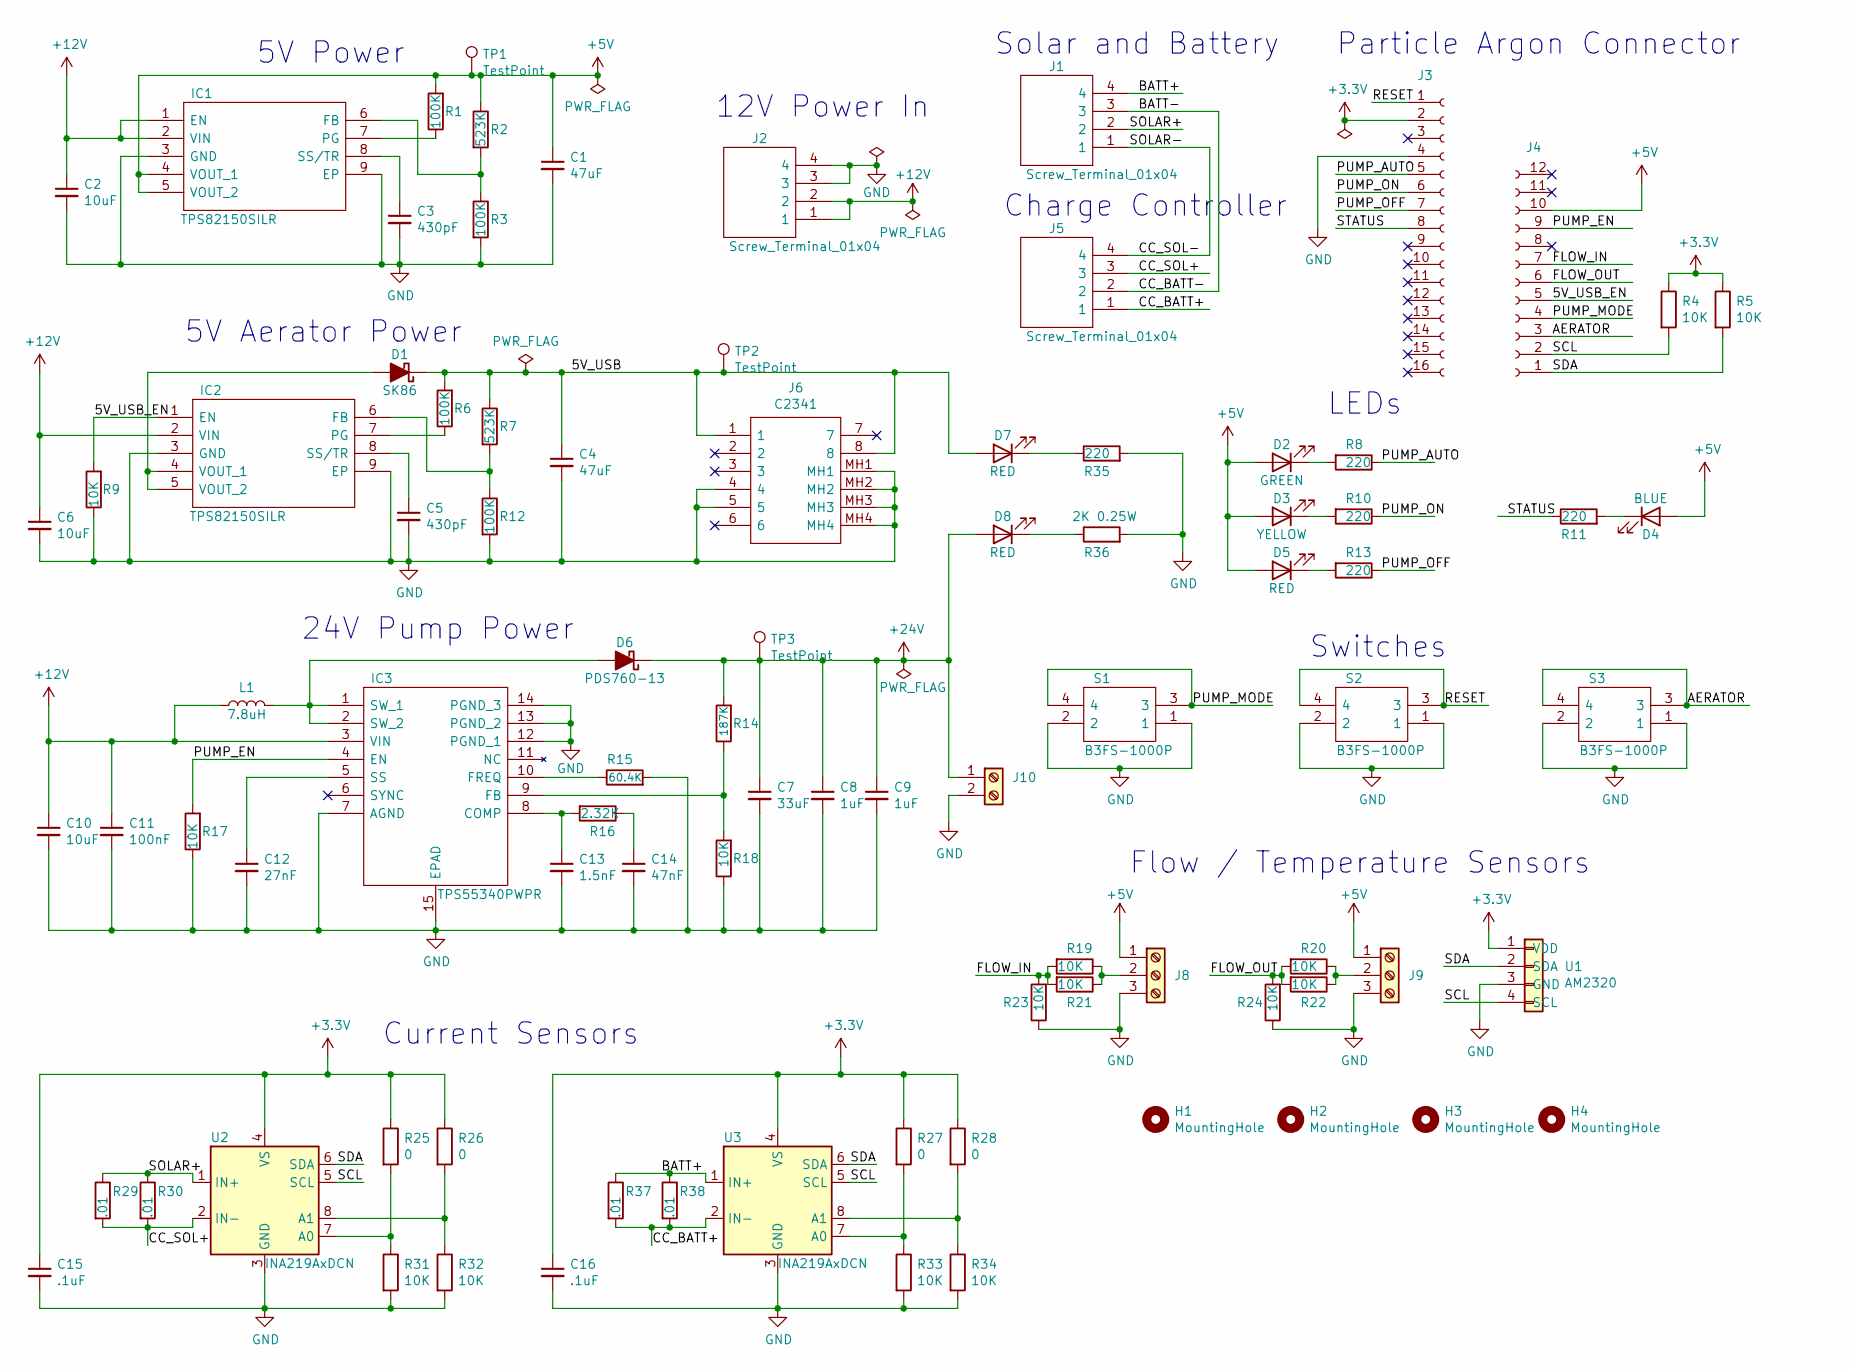
[picture p140: schematic Hydroponics.sch]

Parts:
C1, C4: 47uF; C_1206_3216Metric; MPN CL31A476MQHNNNE
C2, C6, C10: 10uF; C_1206_3216Metric; MPN CL31A106KOHNNNE
C3, C5: 430pF; C_0603_1608Metric; MPN 0603B431K500NT
C7: 33uF; C_Elec_6.3x7.7; MPN EEHZA1H330XP
C8, C9: 1uF; C_0805_2012Metric; MPN CL21B105KBFNNNE
C11: 100nF; C_0805_2012Metric; MPN 0805B104K500NT
C12: 27nF; C_0603_1608Metric; MPN CL10B273KB8NNNC
C13: 1.5nF; C_0805_2012Metric; MPN 0805B152K500NT
C14: 47nF; C_0805_2012Metric; MPN CL21B473KBANNNC
C15, C16: .1uF; C_0603_1608Metric; MPN 0603B104K500NT
D1: SK86; D_SMC; MPN SK86
D2: GREEN; LED_0805_2012Metric; MPN LTST-C171KGKT
D3: YELLOW; LED_0805_2012Metric; MPN LTST-C170YKT
D4: BLUE; LED_0805_2012Metric; MPN LTST-C171TBKT
D5, D7, D8: RED; LED_0805_2012Metric; MPN LTST-C170KRKT
D6: PDS760-13; D_PowerDI-5; MPN PDS760-13
H1, H2, H3, H4: MountingHole; MountingHole_3mm
IC1, IC2: TPS82150SILR; TPS82130SILT; Manufacturer_Part_Number TPS82150SILR; Mouser Part Number 595-TPS82150SILR
IC3: TPS55340PWPR; SOP65P640X120-15N; Manufacturer_Part_Number TPS55340PWPR; Mouser Part Number 595-TPS55340PWPR
J1, J2, J5: Screw_Terminal_01x04; 691313410004; MPN 1766259
J3: Conn_01x16_Female; PinSocket_1x16_P2.54mm_Vertical; MPN C66987
J4: Conn_01x12_Female; PinSocket_1x12_P2.54mm_Vertical; MPN A2541HWV-12P
J6: C2341; Manufacturer_Part_Number C2341
J8, J9: 282834-3; TerminalBlock_TE_282834-3_1x03_P2.54mm_Horizontal; MPN 282834-3
J10: 282834-2; TerminalBlock_TE_282834-2_1x02_P2.54mm_Horizontal; MPN 282834-2
L1: 7.8uH; L_TDK_RLF12560; MPN RLF12560T-7R8N8R2
R1, R3, R6, R12: 100K; R_0603_1608Metric; MPN CR0603-FX-1003ELF
R2, R7: 523K; R_0603_1608Metric; MPN CR0603-FX-5233ELF
R4, R5, R9, R17, R18, R19, R20, R21, R22, R23, R24, R31, R32, R33, R34: 10K; R_0603_1608Metric; MPN RS-03K103JT
R8, R10, R11, R13, R35: 220; R_0603_1608Metric; MPN 0603WAF2200T5E
R14: 187K; R_0603_1608Metric; MPN 0603WAF1873T5E
R15: 60.4K; R_0603_1608Metric; MPN 0603WAF6042T5E
R16: 2.32K; R_0603_1608Metric; MPN 0603WAF2321T5E
R25, R26, R27, R28: 0; R_0603_1608Metric; MPN 0603WAF0000T5E
R29, R37: .01; R_Shunt_Vishay_WSR2_WSR3; MPN WSR3R0100FEA
R30, R38: .01; R_2512_6332Metric; MPN 25121WJ010LT4E
R36: 2K 0.25W; R_0603_1608Metric; MPN ERJPA3J202V
S1, S2, S3: B3FS-1000P; Manufacturer_Part_Number B3FS-1000P; Mouser Part Number 653-B3FS-1000P
TP1, TP2, TP3: TestPoint; TestPoint_Plated_Hole_D2.0mm
U1: AM2320; PinHeader_1x04_P2.54mm_Vertical; MPN AM2320
U2, U3: INA219AxDCN; SOT-23-8; MPN INA219AIDCNR

Connections:
+3V3: C15.1, C16.1, J3.2, R4.1, R5.1, R25.1, R26.1, R27.1, R28.1, U1.1 (VDD), U2.4 (VS), U3.4 (VS)
+5V: C1.1, D2.2 (A), D3.2 (A), D4.2 (A), D5.2 (A), IC1.4 (VOUT_1), IC1.5 (VOUT_2), J4.10, J8.1, J9.1, R1.2, R2.1, TP1.1
+12V: C2.1, C6.1, C10.1, C11.1, IC1.1 (EN), IC1.2 (VIN), IC2.2 (VIN), IC3.3 (VIN), J2.1, J2.2, L1.1
+24V: C7.1, C8.1, C9.1, D6.1 (K), D8.2 (A), J10.1, R14.2, TP3.1
/5V_USB: C4.1, D1.1 (K), D7.2 (A), J6.1, J6.8, R6.2, R7.1, TP2.1
/5V_USB_EN: IC2.1 (EN), J4.5, R9.2
/AERATOR: J4.3, S3.3, S3.4
/BATT+: J1.4, R37.1, R38.1, U3.1 (IN+)
/BATT-: J1.3, J5.2
/CC_BATT+: J5.1, R37.2, R38.2, U3.2 (IN-)
/CC_SOL+: J5.3, R29.2, R30.2, U2.2 (IN-)
/CC_SOL-: J1.1, J5.4
/FLOW_IN: J4.7, R19.2, R21.2, R23.2
/FLOW_OUT: J4.6, R20.2, R22.2, R24.2
/PUMP_AUTO: J3.5, R8.1
/PUMP_EN: IC3.4 (EN), J4.9, R17.2
/PUMP_MODE: J4.4, S1.3, S1.4
/PUMP_OFF: J3.7, R13.1
/PUMP_ON: J3.6, R10.1
/RESET: J3.1, S2.3, S2.4
/SCL: J4.2, R4.2, U1.4 (SCL), U2.5 (SCL), U3.5 (SCL)
/SDA: J4.1, R5.2, U1.2 (SDA), U2.6 (SDA), U3.6 (SDA)
/SOLAR+: J1.2, R29.1, R30.1, U2.1 (IN+)
/STATUS: J3.8, R11.1
GND: C1.2, C2.2, C3.2, C4.2, C5.2, C6.2, C7.2, C8.2, C9.2, C10.2, C11.2, C12.2, C13.2, C14.2, C15.2, C16.2, IC1.3 (GND), IC1.9 (EP), IC2.3 (GND), IC2.9 (EP), IC3.7 (AGND), IC3.12 (PGND_1), IC3.13 (PGND_2), IC3.14 (PGND_3), IC3.15 (EPAD), J2.3, J2.4, J3.4, J6.4, J6.5, J6.MH1, J6.MH2, J6.MH3, J6.MH4, J8.3, J9.3, J10.2, R3.2, R9.1, R12.2, R15.2, R17.1, R18.1, R23.1, R24.1, R31.2, R32.2, R33.2, R34.2, R35.2, R36.2, S1.1, S1.2, S2.1, S2.2, S3.1, S3.2, U1.3 (GND), U2.3 (GND), U3.3 (GND)
unnamed: C3.1, IC1.8 (SS/TR)
unnamed: C5.1, IC2.8 (SS/TR)
unnamed: C12.1, IC3.5 (SS)
unnamed: C13.1, IC3.8 (COMP), R16.2
unnamed: C14.1, R16.1
unnamed: D1.2 (A), IC2.4 (VOUT_1), IC2.5 (VOUT_2)
unnamed: D2.1 (K), R8.2
unnamed: D3.1 (K), R10.2
unnamed: D4.1 (K), R11.2
unnamed: D5.1 (K), R13.2
unnamed: D6.2 (A), IC3.1 (SW_1), IC3.2 (SW_2), L1.2
unnamed: D7.1 (K), R35.1
unnamed: D8.1 (K), R36.1
unnamed: IC1.6 (FB), R2.2, R3.1
unnamed: IC1.7 (PG), R1.1
unnamed: IC2.6 (FB), R7.2, R12.1
unnamed: IC2.7 (PG), R6.1
unnamed: IC3.9 (FB), R14.1, R18.2
unnamed: IC3.10 (FREQ), R15.1
unnamed: J8.2, R19.1, R21.1
unnamed: J9.2, R20.1, R22.1
unnamed: R25.2, R31.1, U2.7 (A0)
unnamed: R26.2, R32.1, U2.8 (A1)
unnamed: R27.2, R33.1, U3.7 (A0)
unnamed: R28.2, R34.1, U3.8 (A1)

Notes on the sheet:
12V Power In
Solar and Battery
Charge Controller
Current Sensors
24V Pump Power
5V Aerator Power
5V Power
Particle Argon Connector
Switches
LEDs
Flow / Temperature Sensors

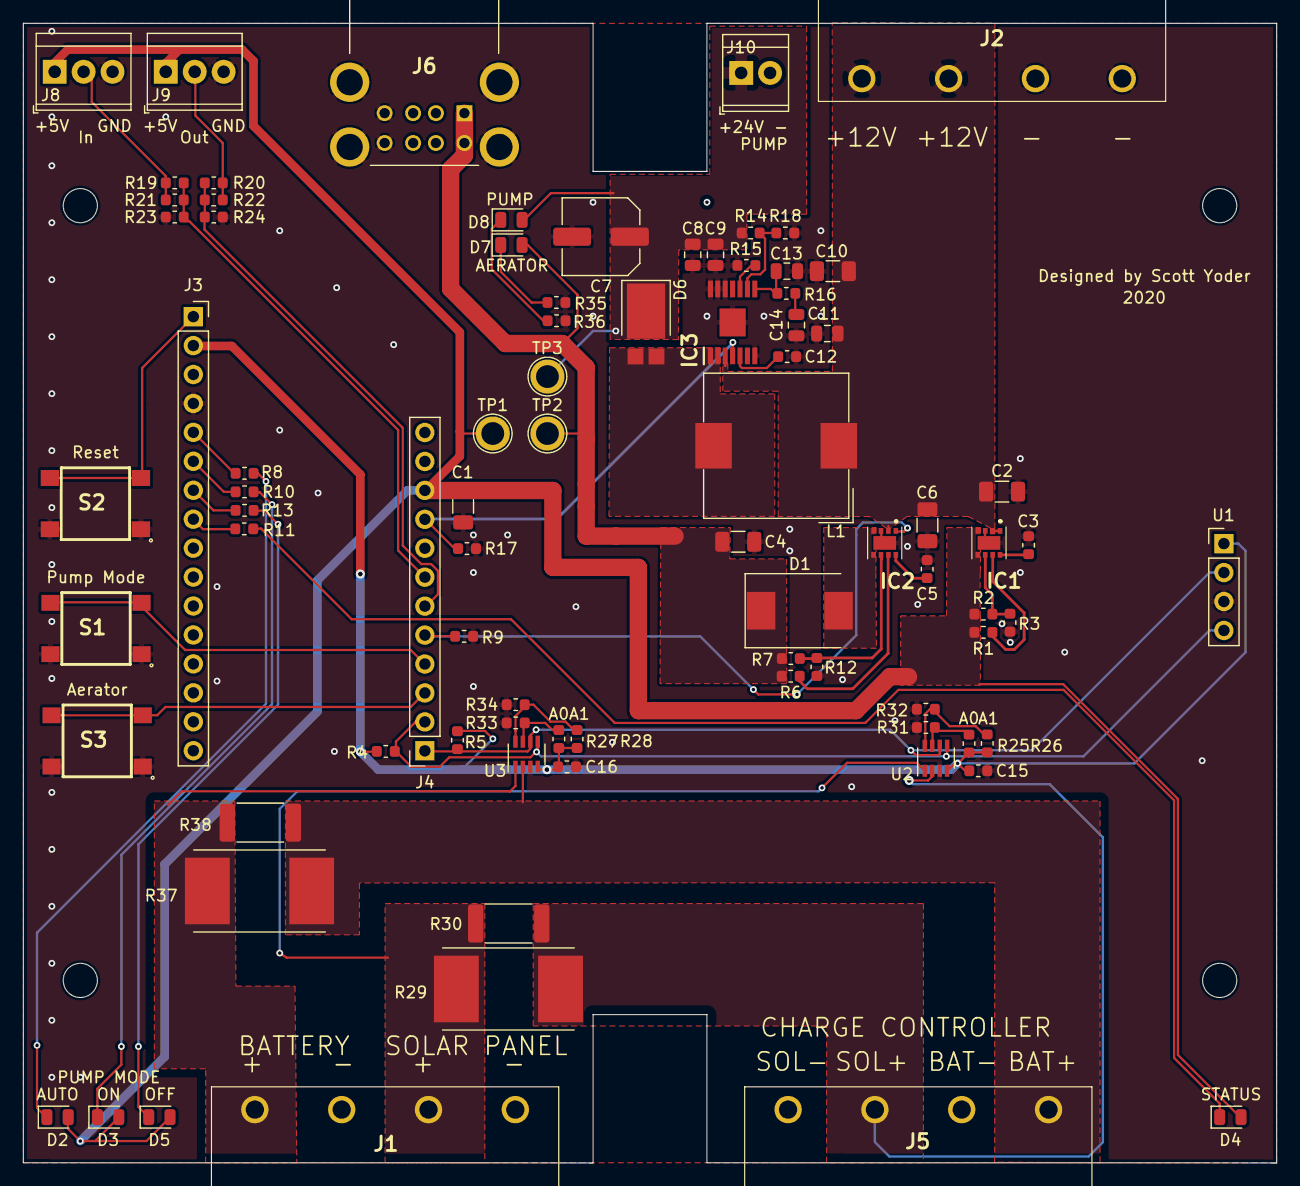
[picture p141: board Hydroponics.kicad_pcb from above]

Board: 2 copper layers, 110.0 x 100.0 mm, 88 parts (0 on the bottom side), 50 nets.
