imagestream/kicad/PowerRelayFeatherwing/Adafruit PowerRelay Wing.kicad_pcb

## KiCad design PowerRelayFeatherwing/Adafruit PowerRelay Wing.kicad_pcb (2020-06-22)

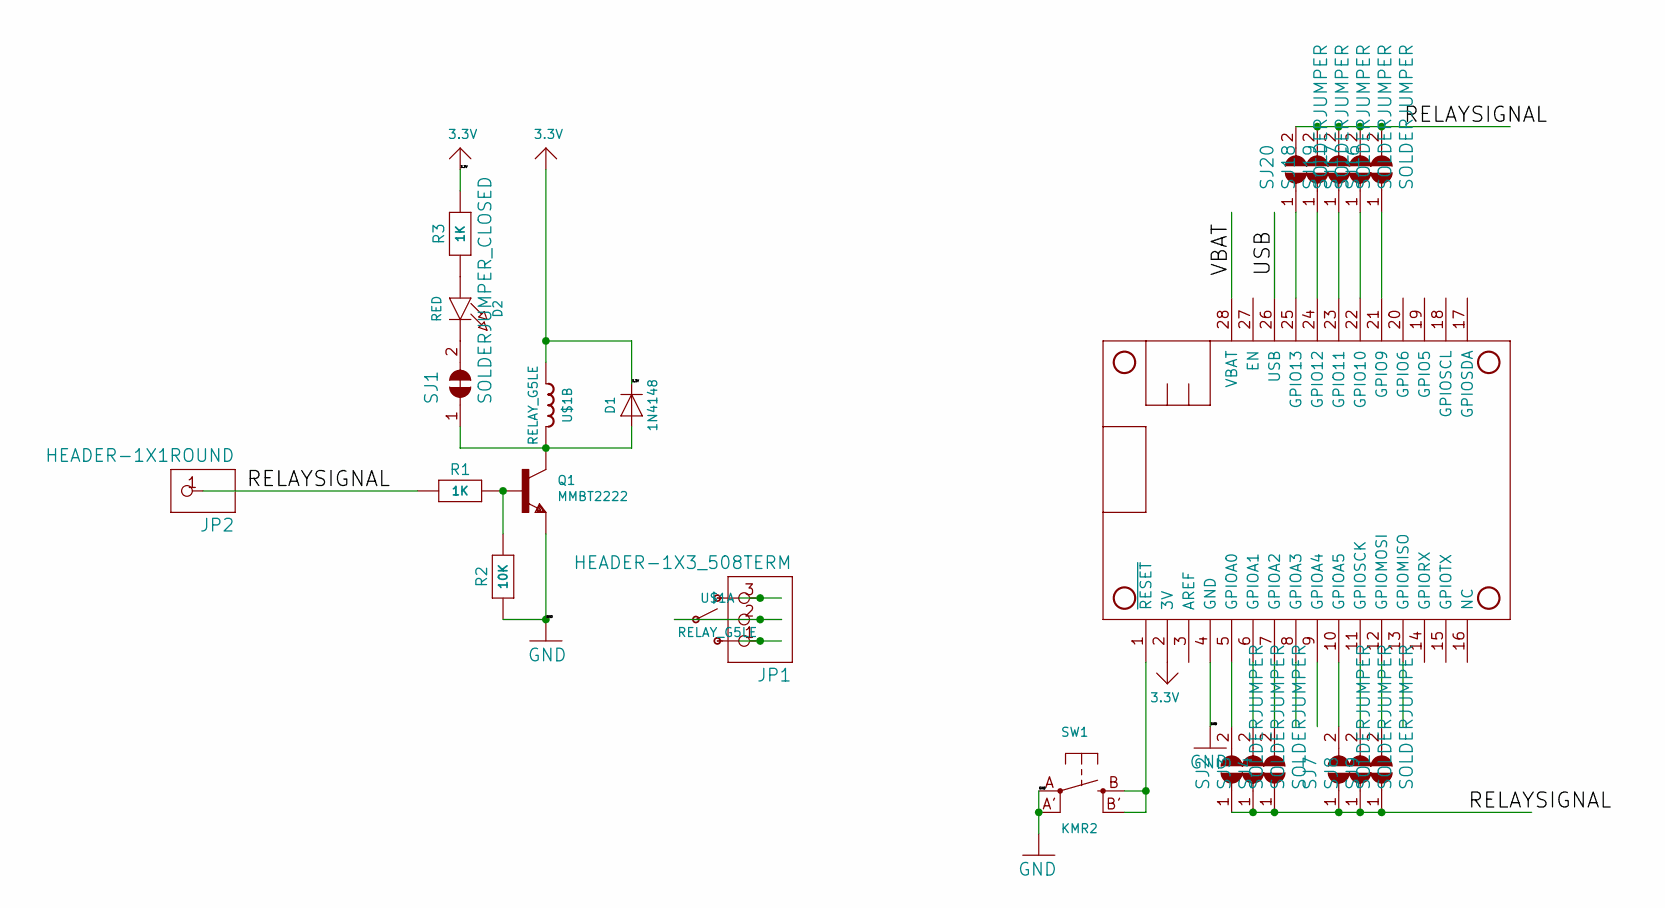
[picture p142: schematic Adafruit PowerRelay Wing.sch]

Parts:
D1: 1N4148; SOD-323
D2: RED; CHIPLED_0805_NOOUTLINE
JP1: HEADER-1X3_508TERM; TERMBLOCK_1X3_5.08MM
JP2: HEADER-1X1ROUND; 1X01_ROUND
MS2: FEATHERWING
Q1: MMBT2222; SOT23-R
R1, R3: 1K; 0805-NO
R2: 10K; 0805-NO
SJ1: SOLDERJUMPER_CLOSED; SOLDERJUMPER_CLOSEDWIRE
SJ2, SJ3, SJ4, SJ7, SJ8, SJ9, SJ16, SJ17, SJ18, SJ19, SJ20: SOLDERJUMPER; SOLDERJUMPER_ARROW_NOPASTE
SW1: KMR2; BTN_KMR2_4.6X2.8
U$1: RELAY_G5LE; RELAY_G5LE-1

Connections:
3.3V: D1.C, MS2.2 (3V), R3.2, U$1.2 (1)
/RELAYSIGNAL: JP2.1, R1.1, SJ2.1, SJ3.1, SJ4.1, SJ7.1, SJ8.1, SJ9.1, SJ16.2, SJ17.2, SJ18.2, SJ19.2, SJ20.2
/USB: MS2.26 (USB)
/VBAT: MS2.28 (VBAT)
GND: MS2.4 (GND), Q1.2 (E), R2.1, SW1.A, SW1.A' (P1)
unnamed: D1.A, Q1.3 (C), SJ1.1, U$1.5 (2)
unnamed: D2.A, R3.1
unnamed: D2.C, SJ1.2
unnamed: JP1.1, U$1.4 (S)
unnamed: JP1.2, U$1.1
unnamed: JP1.3, U$1.3 (O)
unnamed: MS2.1 (~RESET), SW1.B (S), SW1.B' (S1)
unnamed: MS2.5 (GPIOA0), SJ2.2
unnamed: MS2.6 (GPIOA1), SJ3.2
unnamed: MS2.7 (GPIOA2), SJ4.2
unnamed: MS2.10 (GPIOA5), SJ7.2
unnamed: MS2.11 (GPIOSCK), SJ8.2
unnamed: MS2.12 (GPIOMOSI), SJ9.2
unnamed: MS2.21 (GPIO9), SJ16.1
unnamed: MS2.22 (GPIO10), SJ17.1
unnamed: MS2.23 (GPIO11), SJ19.1
unnamed: MS2.24 (GPIO12), SJ18.1
unnamed: MS2.25 (GPIO13), SJ20.1
unnamed: Q1.1 (B), R1.2, R2.2

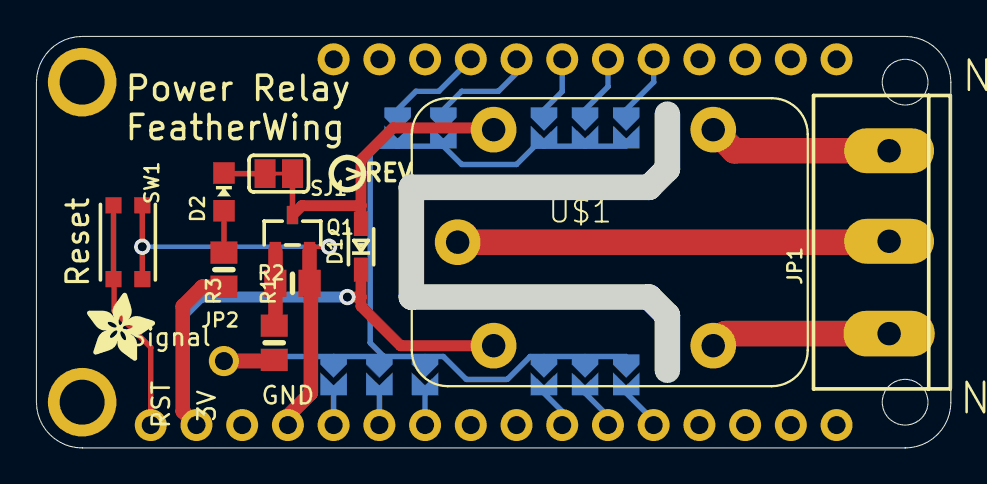
[picture p143: board Adafruit PowerRelay Wing.kicad_pcb from above]

Board: 2 copper layers, 50.8 x 22.9 mm, 26 parts (0 on the bottom side), 22 nets.

Other parts of the board:
U$5: PCBFEAT-REV-040
U$6: ADAFRUIT_3.5MM
U$7: FEATHERLOGO_MED
