imagestream/kicad/PowerRelayFeatherwing/Adafruit PowerRelay Wing.brd

## EAGLE design PowerRelayFeatherwing/Adafruit PowerRelay Wing.brd (2020-06-22)

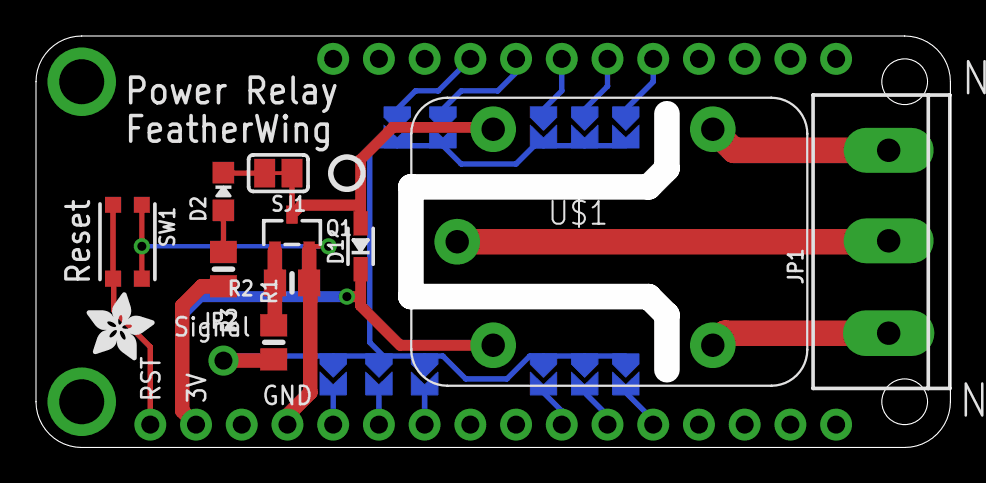
[picture p144: board Adafruit PowerRelay Wing.brd from above]

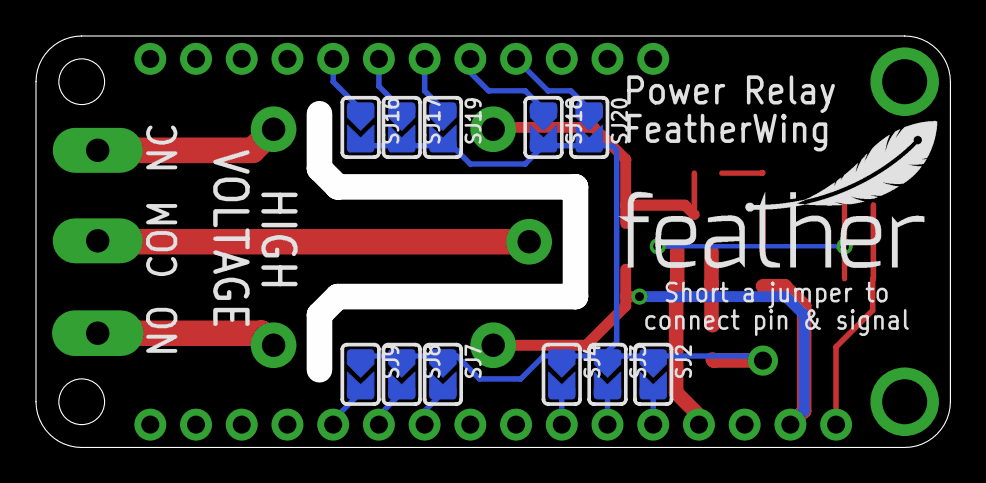
[picture p145: board Adafruit PowerRelay Wing.brd from below]

Board: 2 copper layers, 50.8 x 22.9 mm, 26 parts (12 on the bottom side), 22 nets.

Parts:
D1: 1N4148; SOD-323
D2: RED; CHIPLED_0805_NOOUTLINE
JP1: TERMBLOCK_1X3_5.08MM
JP2: 1X01_ROUND
MS2: FEATHERWING
Q1: MMBT2222; SOT23-R
R1, R3: 1K; 0805-NO
R2: 10K; 0805-NO
SJ1: SOLDERJUMPER_CLOSEDWIRE
SJ2, SJ3, SJ4, SJ7, SJ8, SJ9, SJ16, SJ17, SJ18, SJ19, SJ20: SOLDERJUMPER_ARROW_NOPASTE
SW1: KMR2; BTN_KMR2_4.6X2.8
U$1: RELAY_G5LE; RELAY_G5LE-1
U$5: PCBFEAT-REV-040
U$6: ADAFRUIT_3.5MM
U$7: FEATHERLOGO_MED

Connections:
3.3V: D1.C, MS2.2, R3.2, U$1.2
GND: MS2.4, Q1.2, R2.1, SW1.A, SW1.A'
unnamed: JP1.2, U$1.1
unnamed: JP1.3, U$1.3
unnamed: JP1.1, U$1.4
unnamed: D1.A, Q1.3, SJ1.1, U$1.5
unnamed: MS2.12, SJ9.2
unnamed: MS2.11, SJ8.2
unnamed: MS2.10, SJ7.2
unnamed: MS2.7, SJ4.2
unnamed: MS2.6, SJ3.2
unnamed: MS2.5, SJ2.2
unnamed: MS2.25, SJ20.1
unnamed: MS2.24, SJ18.1
unnamed: MS2.1, SW1.B, SW1.B'
unnamed: MS2.23, SJ19.1
unnamed: MS2.22, SJ17.1
unnamed: MS2.21, SJ16.1
unnamed: Q1.1, R1.2, R2.2
unnamed: D2.C, SJ1.2
unnamed: D2.A, R3.1
RELAYSIGNAL: JP2.1, R1.1, SJ2.1, SJ3.1, SJ4.1, SJ7.1, SJ8.1, SJ9.1, SJ16.2, SJ17.2, SJ18.2, SJ19.2, SJ20.2
