imagestream/kicad/(commit log)

2020-06-15 Initial commit of Hydroponics and early AP2100
    [AP2100-B_Cu.gbr, AP2100-B_Mask.gbr, AP2100-B_Paste.gbr, AP2100-B_SilkS.gbr, AP2100-Edge_Cuts.gbr, AP2100-F_Cu.gbr, AP2100-F_Mask.gbr, AP2100-F_Paste.gbr]
2020-06-22 Update AP2100 schematic. Make a copy for FutureElectronics recommendations but going to move quickly with TI solutions.
    [AP2100-B_Cu.gbr, AP2100-B_Mask.gbr, AP2100-B_Paste.gbr, AP2100-B_SilkS.gbr, AP2100-Edge_Cuts.gbr, AP2100-F_Cu.gbr, AP2100-F_Mask.gbr, AP2100-F_Paste.gbr]
2020-06-23 Update hydroponics BOM + pdf. Add PM8804/8805 library parts and schematic with them on it
    [Hydroponics.kicad_pcb, poe.sch]
2020-06-26 Add Magjack part
    [Power.sch, poe.sch]
2020-07-07 Update poe Add cap library
    [Power.sch, poe.sch]
2020-07-08 Update PoE section - almost done
    [AP2100.kicad_pcb, AP2100.kicad_sch, CPU_memory.kicad_sch, PCIe.kicad_sch, Power.kicad_sch, poe.kicad_sch]
2020-07-09 Finish PoE power
2020-07-09 Finish PoE
    [AP2100.kicad_sch, poe.kicad_sch]
2020-07-09 Not sure
    [AP2100.kicad_sch, poe.kicad_sch]
2020-07-09 Add partsbox.io bom generator script
    [AP2100.kicad_pcb, AP2100.kicad_sch, AP2100.sch, CPU_memory.sch, PCIe.sch, Power.kicad_sch, Power.sch, poe.kicad_sch]
2020-07-09 Add PartsBox part numbers to everything so far
    [AP2100.kicad_pcb, AP2100.kicad_sch, CPU_memory.kicad_sch, Power.kicad_sch, poe.kicad_sch]
2020-07-13 More work on memory
    [AP2100.kicad_pcb, AP2100.kicad_sch, CPU_memory.kicad_sch, PCIe.kicad_sch, Power.kicad_sch, poe.kicad_sch]
2020-07-14 Add + route first 16 memory data lines
    [AP2100.kicad_pcb, AP2100.kicad_sch, CPU_memory.kicad_sch, PCIe.kicad_sch, Power.kicad_sch, poe.kicad_sch]
2020-07-15 Almost finish memory section
    [AP2100.kicad_pcb, AP2100.kicad_sch, CPU_memory.kicad_sch, PCIe.kicad_sch, Power.kicad_sch, poe.kicad_sch]
2020-07-15 Finalize DDR4 memory section
    [CPU_memory.kicad_sch, poe.kicad_sch]
2020-07-16 Add new Flat Antenna element 2.4 GHz
2020-07-17 Finalize FlatAnt4x4
    [FlatAnt4x4-B_Cu.gbr, FlatAnt4x4-B_Mask.gbr, FlatAnt4x4-B_Paste.gbr, FlatAnt4x4-B_SilkS.gbr, FlatAnt4x4-Edge_Cuts.gbr, FlatAnt4x4-F_Cu.gbr, FlatAnt4x4-F_Mask.gbr, FlatAnt4x4-F_Paste.gbr]
2020-09-09 Add emmc library part but likely will delete
    [AP2100.kicad_sch, CPU_memory.kicad_sch, PCIe.kicad_sch, Power.kicad_sch, eMMC.kicad_sch, poe.kicad_sch]
2020-09-10 Add 1.2V and 5V power supplies
    [AP2100.kicad_sch, CPU_memory.kicad_sch, PCIe.kicad_sch, Power.kicad_sch, eMMC.kicad_sch, poe.kicad_sch]
2020-09-11 Add pmic chip to power section. Finish eMMC.
    [AP2100.kicad_sch, CPU_memory.kicad_sch, PCIe.kicad_sch, Power.kicad_sch, eMMC.kicad_sch, poe.kicad_sch]
2020-09-15 Add CPU Power block. Change global labels to hierarchical and link them at top page Add 5V USB power supply
    [AP2100.kicad_sch, CPU_power.kicad_sch, PCIe.kicad_sch, Power.kicad_sch, eMMC.kicad_sch, poe.kicad_sch, reset.kicad_sch]
2020-09-16 Add 2nd CPU power page. Start reset block
    [AP2100.kicad_sch, CPU_Power2.kicad_sch, CPU_power.kicad_sch, PCIe.kicad_sch, Power.kicad_sch, eMMC.kicad_sch, poe.kicad_sch, reset.kicad_sch]
2020-09-23 Add docs
    [Enclosure Bottom_2020-07-15_19-27-11.dxf, Enclosure top_2020-07-15_19-33-49.dxf, Enclosure_Top.FCStd, Front Cutout_2020-07-15_19-18-49.dxf]
2020-09-23 Add clocking and start of ethernet
    [AP2100.kicad_sch, CPU_Power2.kicad_sch, CPU_memory.kicad_sch, CPU_power.kicad_sch, PCIe.kicad_sch, Power.kicad_sch, SerDes_RGMII.kicad_sch, eMMC.kicad_sch]
2020-09-24 Finish reset section
    [AP2100.kicad_sch, CPU_memory.kicad_sch, CPU_power.kicad_sch, PCIe.kicad_sch, Power.kicad_sch, SerDes_RGMII.kicad_sch, clock.kicad_sch, eMMC.kicad_sch]
2020-09-26 Mostly done with USB - USB1 complete just duplicate to 2+3
    [AP2100.kicad_sch, CPU_memory.kicad_sch, CPU_power.kicad_sch, PCIe.kicad_sch, Power.kicad_sch, SerDes_RGMII.kicad_sch, USB.kicad_sch, clock.kicad_sch]
2020-09-26 Annotate and update PCB with current design
    [AP2100.kicad_pcb, AP2100.kicad_sch, CPU_memory.kicad_sch, CPU_power.kicad_sch, PCIe.kicad_sch, Power.kicad_sch, SerDes_RGMII.kicad_sch, USB.kicad_sch]
2020-09-28 RGMII ethernet section almost complete for 1st port Finish USB
    [AP2100.kicad_sch, CPU_memory.kicad_sch, PCIe.kicad_sch, Power.kicad_sch, SerDes_RGMII.kicad_sch, USB.kicad_sch, clock.kicad_sch, eMMC.kicad_sch]
2020-09-29 Finish Ethernet all that's left is SerDes
    [AP2100.kicad_sch, CPU_memory.kicad_sch, PCIe.kicad_sch, Power.kicad_sch, SerDes_RGMII.kicad_sch, USB.kicad_sch, clock.kicad_sch, eMMC.kicad_sch]
2020-10-01 Review / cleanup footprints, etc
    [AP2100.kicad_pcb, AP2100.kicad_sch, CPU_memory.kicad_sch, CPU_power.kicad_sch, PCIe.kicad_sch, Power.kicad_sch, SerDes_RGMII.kicad_sch, USB.kicad_sch]
2020-10-01 Added antenna mounting holes
    [AP2100.kicad_pcb, AP2100.kicad_sch, CPU_memory.kicad_sch, CPU_power.kicad_sch, PCIe.kicad_sch, SerDes_RGMII.kicad_sch, USB.kicad_sch, eMMC.kicad_sch]
2020-10-05 Added Thermal solutions PDF Fix DDRCLK pulldown
    [AP2100.kicad_sch, CPU_memory.kicad_sch, PCIe.kicad_sch, SerDes_RGMII.kicad_sch, clock.kicad_sch, eMMC.kicad_sch, ground.kicad_sch, poe.kicad_sch]
2020-10-06 More cleanups
    [AP2100.kicad_sch, CPU_memory.kicad_sch, CPU_power.kicad_sch, PCIe.kicad_sch, Power.kicad_sch, SerDes_RGMII.kicad_sch, USB.kicad_sch, clock.kicad_sch]
2020-10-06 More cleanups - fix incorrect serial console pinout Add netclasses
    [AP2100.kicad_pcb, AP2100.kicad_sch, CPU_memory.kicad_sch, CPU_power.kicad_sch, PCIe.kicad_sch, Power.kicad_sch, SerDes_RGMII.kicad_sch, USB.kicad_sch]
2020-10-08 Add power prototype for initial testing
    [AP2100-power-proto-B_Cu.gbr, AP2100-power-proto-B_Mask.gbr, AP2100-power-proto-B_Paste.gbr, AP2100-power-proto-B_SilkS.gbr, AP2100-power-proto-Edge_Cuts.gbr, AP2100-power-proto-F_Cu.gbr, AP2100-power-proto-F_Mask.gbr, AP2100-power-proto-F_Paste.gbr]
2020-10-09 Cleanups per ST Micro's review. Add old and old-old kinda by accident
    [AP2100-power-proto-B_Cu.gbr, AP2100-power-proto-B_Mask.gbr, AP2100-power-proto-B_Paste.gbr, AP2100-power-proto-B_SilkS.gbr, AP2100-power-proto-Edge_Cuts.gbr, AP2100-power-proto-F_Cu.gbr, AP2100-power-proto-F_Mask.gbr, AP2100-power-proto-F_Paste.gbr]
2020-10-15 Layout of PoE up to VDC - going to rework though
    [AP2100-power-proto.kicad_pcb, AP2100-power-proto.kicad_sch, clock.kicad_sch, poe.kicad_sch]
2020-10-16 More PoE layout
    [AP2100-power-proto.kicad_pcb, AP2100-power-proto.kicad_sch, CPU_memory.kicad_sch, PCIe.kicad_sch, SerDes_RGMII.kicad_sch, clock.kicad_sch, eMMC.kicad_sch, ground.kicad_sch]
2020-10-16 Finish Power PoE section layout
    [AP2100.kicad_pcb, AP2100.kicad_sch, CPU_memory.kicad_sch, PCIe.kicad_sch, SerDes_RGMII.kicad_sch, clock.kicad_sch, eMMC.kicad_sch, ground.kicad_sch]
2020-10-19 Fixup broken BSC100 footprint with missing pins Add mPCIE footprint with retainer holes Review / complete PartsBox info
    [AP2100.kicad_pcb, AP2100.kicad_sch, CPU_memory.kicad_sch, CPU_power.kicad_sch, PCIe.kicad_sch, Power.kicad_sch, SerDes_RGMII.kicad_sch, USB.kicad_sch]
2020-10-23 Revise BOM
    [AP2100-B_Cu.gbr, AP2100-B_Mask.gbr, AP2100-B_Paste.gbr, AP2100-B_SilkS.gbr, AP2100-B_Silkscreen.gbr, AP2100-Edge_Cuts.gbr, AP2100-F_Cu.gbr, AP2100-F_Mask.gbr]
2020-10-29 Rename AP2100 as AP2100.ls1043 shelving the Layerscape design and starting a new Raspberry Pi 4 compute module based board
    [AP2100-B_Cu.gbr, AP2100-B_Mask.gbr, AP2100-B_Paste.gbr, AP2100-B_SilkS.gbr, AP2100-B_Silkscreen.gbr, AP2100-Edge_Cuts.gbr, AP2100-F_Cu.gbr, AP2100-F_Mask.gbr]
2020-10-29 Finish PoE section Rename CM4IO library as AP2100
    [AP2100v4.kicad_pcb, AP2100v4.kicad_sch, CM4_GPIO.kicad_sch, CM4_HighSpeed.kicad_sch, PCIe-routing.kicad_sch, PSUs.kicad_sch, RTC.kicad_sch, USB2-HUB.kicad_sch]
2020-10-30 Finish PCie routing
    [AP2100v4.kicad_sch, CM4_GPIO.kicad_sch, CM4_HighSpeed.kicad_sch, PCIe-routing.kicad_sch, PSUs.kicad_sch, RTC.kicad_sch, USB2-HUB.kicad_sch, eth_add.kicad_sch]
2020-11-06 Add AP3000 single radio for security cameras. Add CM4IO Raspi board
    [AP2100v4.kicad_sch, AP3000.kicad_pcb, AP3000.kicad_sch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]
2020-11-06 Route all the high speed lines and most gpio
    [AP3000.kicad_pcb, AP3000.kicad_sch, CM4_GPIO.kicad_sch, CM4_HighSpeed.kicad_sch, PCIe-routing.kicad_sch, PSUs.kicad_sch, RTC.kicad_sch, USB2-HUB.kicad_sch]
2020-11-10 Forgot to add PCB cutout resulting in some components being moved
    [AP3000.kicad_pcb, AP3000.kicad_sch, CM4_GPIO.kicad_sch, CM4_HighSpeed.kicad_sch, PCIe-routing.kicad_sch, PSUs.kicad_sch, RTC.kicad_sch, USB2-HUB.kicad_sch]
2020-11-11 Route more
    [AP3000.kicad_pcb, AP3000.kicad_sch, CM4_GPIO.kicad_sch, CM4_HighSpeed.kicad_sch, PCIe-routing.kicad_sch, poe.kicad_sch]
2020-11-12 Almost done routing!
    [AP3000.kicad_pcb, AP3000.kicad_sch, CM4_GPIO.kicad_sch, CM4_HighSpeed.kicad_sch, PCIe-routing.kicad_sch]
2020-11-13 Finished routing board.
    [AP3000-B_Cu.gbr, AP3000-B_Mask.gbr, AP3000-Edge_Cuts.gbr, AP3000-F_Cu.gbr, AP3000-F_Mask.gbr, AP3000-F_Paste.gbr, AP3000-F_Silkscreen.gbr, AP3000-In1_Cu.gbr]
2020-11-21 AP3000: Fixup PartsBoxID linkage and placed first order Working on a design for a 5 GHz panel antenna array for a point-to-point replacement
    [AP3000-B_Cu.gbr, AP3000-B_Mask.gbr, AP3000-Edge_Cuts.gbr, AP3000-F_Cu.gbr, AP3000-F_Mask.gbr, AP3000-F_Paste.gbr, AP3000-F_Silkscreen.gbr, AP3000-In1_Cu.gbr]
2020-11-23 Add RF T and angle footprints
    [FlatAntPanel4x4.kicad_sch]
2020-11-23 Finish layout of 4x4 panel - bad ground plane yet
    [FlatAntPanel4x4-B_Cu.gbr, FlatAntPanel4x4-B_Mask.gbr, FlatAntPanel4x4-B_Paste.gbr, FlatAntPanel4x4-B_Silkscreen.gbr, FlatAntPanel4x4-Edge_Cuts.gbr, FlatAntPanel4x4-F_Cu.gbr, FlatAntPanel4x4-F_Mask.gbr, FlatAntPanel4x4-F_Paste.gbr]
2020-11-25 Finalize flat antenna and reflector. Sent to JLCPCB for fab.
    [FlatAntPanel4x4-B_Cu.gbr, FlatAntPanel4x4-B_Mask.gbr, FlatAntPanel4x4-B_Silkscreen.gbr, FlatAntPanel4x4-F_Cu.gbr, FlatAntPanel4x4-F_Mask.gbr, FlatAntPanel4x4-F_Paste.gbr, FlatAntPanel4x4-F_Silkscreen.gbr, FlatAntPanel4x4-NPTH.drl]
2020-12-21 Finalize 4x4 flat ant and director. Start dual polarity 4x4 antenna
    [FlatAntPanel4x4_Reflector.kicad_pcb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]
2020-12-24 Rework AP3000 PoE section, power section and change solder paste to -10% overall, -15% for small chips / mpcie and -20% for the raspi connector
    [AP3000-B_Cu.gbr, AP3000-B_Mask.gbr, AP3000-Edge_Cuts.gbr, AP3000-F_Cu.gbr, AP3000-F_Mask.gbr, AP3000-F_Paste.gbr, AP3000-F_Silkscreen.gbr, AP3000-In1_Cu.gbr]
2020-12-24 Ordered AP3000 PCBs Ordered FlatAntPanel4x4 PCBs Ordered FlatAntPanel4x4_Reflector PCBs
    [AP3000-B_Cu.gbr, AP3000-B_Mask.gbr, AP3000-Edge_Cuts.gbr, AP3000-F_Cu.gbr, AP3000-F_Mask.gbr, AP3000-F_Paste.gbr, AP3000-F_Silkscreen.gbr, AP3000-In1_Cu.gbr]
2020-12-28 Reduce paste and solder mask margins to 0
    [AP3000-B_Cu.gbr, AP3000-B_Mask.gbr, AP3000-Edge_Cuts.gbr, AP3000-F_Cu.gbr, AP3000-F_Mask.gbr, AP3000-F_Paste.gbr, AP3000-F_Silkscreen.gbr, AP3000-In1_Cu.gbr]
2021-01-19 Rework AP3000 board - ground planes instead of power planes internal
    [AP3000.kicad_pcb, AP3000.kicad_sch, CM4_GPIO.kicad_sch, CM4_HighSpeed.kicad_sch, PCIe-routing.kicad_sch, PSUs.kicad_sch, RTC.kicad_sch, Taylor's Water Layout.kicad_pcb]
2021-01-20 Added AP3500 board version to fit in twist-port adaptor
    [AP3500.kicad_pcb, AP3500.kicad_sch, CM4_GPIO.kicad_sch, CM4_HighSpeed.kicad_sch, PCIe-routing.kicad_sch, PSUs.kicad_sch, RTC.kicad_sch, USB2-HUB.kicad_sch]
2021-01-22 Almost done with new smaller AP3500 board
    [AP3500-B_Cu.gbr, AP3500-B_Mask.gbr, AP3500-Edge_Cuts.gbr, AP3500-F_Cu.gbr, AP3500-F_Mask.gbr, AP3500-F_Paste.gbr, AP3500-F_Silkscreen.gbr, AP3500-In1_Cu.gbr]
2021-01-23 Finalize AP3500 board
    [AP3500.kicad_pcb, AP3500.kicad_sch, CM4_GPIO.kicad_sch, PSUs.kicad_sch, poe.kicad_sch]
2021-01-23 Restore old 4x4 flat antenna. Modify 4 polarity to be 2 pol.
    [FlatAntPanel4x4-B_Cu.gbr, FlatAntPanel4x4-B_Mask.gbr, FlatAntPanel4x4-B_Paste.gbr, FlatAntPanel4x4-B_Silkscreen.gbr, FlatAntPanel4x4-Edge_Cuts.gbr, FlatAntPanel4x4-F_Cu.gbr, FlatAntPanel4x4-F_Mask.gbr, FlatAntPanel4x4-F_Paste.gbr]
2021-01-23 Add LEDs to AP3000
    [AP3000.kicad_pcb, AP3000.kicad_sch, CM4_GPIO.kicad_sch, CM4_HighSpeed.kicad_sch, PCIe-routing.kicad_sch, PSUs.kicad_sch, RTC.kicad_sch, USB2-HUB.kicad_sch]
2021-01-26 Placed AP3000 / AP3500 orders with JLCPCB
    [AP3000-B_Cu.gbr, AP3000-B_Mask.gbr, AP3000-B_Paste.gbr, AP3000-B_Silkscreen.gbr, AP3000-F_Cu.gbr, AP3000-F_Mask.gbr, AP3000-F_Paste.gbr, AP3000-F_Silkscreen.gbr]
2021-02-27 More work on Antennas - laying out the new panel as a 2x2 aperture coupled patch
    [AP3500.kicad_sch, CM4_GPIO.kicad_sch, CM4_HighSpeed.kicad_sch, Feeds.kicad_pcb, Feeds.kicad_sch, PCIe-routing.kicad_sch, PSUs.kicad_sch, Patches.kicad_pcb]
2021-02-27 Placed an order with JLCPCB for the Tighter 4pol version and the "Dual XPol" which actually was aperture coupled.
    [AP3000.kicad_pcb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]
2021-03-02 Create AP3000 schematic and PCB PDF as an aid for building boards
    [AP3000.kicad_sch, CM4_GPIO.kicad_sch, CM4_HighSpeed.kicad_sch, PCIe-routing.kicad_sch, PSUs.kicad_sch, RTC.kicad_sch, USB2-HUB.kicad_sch, poe.kicad_sch]
2021-03-23 Update JLCPCB components for AP3000
    [AP3000-B_Cu.gbr, AP3000-B_Mask.gbr, AP3000-B_Paste.gbr, AP3000-B_Silkscreen.gbr, AP3000-Edge_Cuts.gbr, AP3000-F_Cu.gbr, AP3000-F_Mask.gbr, AP3000-F_Paste.gbr]
2021-04-01 Fix antenna hole (again?) so that the feed isn't shorted to ground
    [Feeds-B_Cu.gbr, Feeds-B_Mask.gbr, Feeds-B_Paste.gbr, Feeds-B_Silkscreen.gbr, Feeds-Edge_Cuts.gbr, Feeds-F_Cu.gbr, Feeds-F_Mask.gbr, Feeds-F_Paste.gbr]
2021-05-14 Many enhancements to the AP3000 board. Reworking FlatAntPanel4x4 again with proper holes Made a connector test pcb
    [AP3000.kicad_sch, CM4_GPIO.kicad_sch, CM4_HighSpeed.kicad_sch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]
2021-05-20 Add area for passives to the flatant panel 4x4. Create new single polarity aperture coupled feed antenna
    [Feeds-B_Cu.gbr, Feeds-B_Mask.gbr, Feeds-B_Paste.gbr, Feeds-B_Silkscreen.gbr, Feeds-Edge_Cuts.gbr, Feeds-F_Cu.gbr, Feeds-F_Mask.gbr, Feeds-F_Paste.gbr]
2021-06-11 Add new single polarity aperture coupled 4x4 antenna. RasPiCNM4Connector test Gerbers for PCBWay Cleanups and optimixations for AP3500
    [AP3500.kicad_pcb, AP3500.kicad_sch, CM4_GPIO.kicad_sch, CM4_HighSpeed.kicad_sch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]
2021-06-11 Add dual transformer footprint
2021-06-14 Rework AP3500
    [AP3500-B_Cu.gbr, AP3500-B_Mask.gbr, AP3500-B_Paste.gbr, AP3500-B_Silkscreen.gbr, AP3500-Edge_Cuts.gbr, AP3500-F_Cu.gbr, AP3500-F_Mask.gbr, AP3500-F_Paste.gbr]
2021-06-14 Fix silkscreen
2021-06-19 Updates for JLCPCB components actually in stock at this time
    [AP3000.kicad_sch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]
2021-07-12 Finalize the Wurth Transformer Fixup board solving the pin numbering issue
    [WurthTransformerFix-B_Cu.gbr, WurthTransformerFix-B_Mask.gbr, WurthTransformerFix-B_Paste.gbr, WurthTransformerFix-B_Silkscreen.gbr, WurthTransformerFix-Edge_Cuts.gbr, WurthTransformerFix-F_Cu.gbr, WurthTransformerFix-F_Mask.gbr, WurthTransformerFix-F_Paste.gbr]
2021-07-14 Update AP3500 with new Wurth footprint - needed rerouted. Fix the gigabit ethernet problem with pair 4 center tap to ground instead of through cap.
    [AP3000.kicad_sch, AP3500.kicad_pcb, AP3500.kicad_sch, CM4_GPIO.kicad_sch, CM4_HighSpeed.kicad_sch, PCIe-routing.kicad_sch, PSUs.kicad_sch, RTC.kicad_sch]
2021-07-17 Add AP3100 initial project
    [AP3100-B_Cu.gbr, AP3100-B_Mask.gbr, AP3100-B_Paste.gbr, AP3100-B_Silkscreen.gbr, AP3100-Edge_Cuts.gbr, AP3100-F_Cu.gbr, AP3100-F_Mask.gbr, AP3100-F_Paste.gbr]
2021-09-22 Add first rev of AP2000 motherboard Update libraries - change mPCIE hole size
    [AP2000-B_Cu.dxf, AP2000-B_Mask.dxf, AP2000-B_Paste.dxf, AP2000-B_Silkscreen.dxf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]
2021-09-24 Mods to AP2000 for manufacturing. 50 PCBs ordered from JLCPCB with SMd assembly.
    [10118194-0001LF.step, AP2000-B_Cu.dxf, AP2000-B_Mask.dxf, AP2000-B_Paste.dxf, AP2000-B_Silkscreen.dxf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]
2021-09-24 Add top label (AP20000.ai) sent to JRPanel.
    [ISLogo.dxf, TopLabel-Body.dxf, TopLabel.FCStd]
2021-09-24 Fix up footprints due to changed components / out of stock components with JLCPCB
    [AP2000.kicad_pcb, AP2000.kicad_sch]
