imagestream/kicad/(notices)

Notices in the files:
FlatAntPanel4x4_Reflector_4pol/FlatAntPanel4x4_Reflector.kicad_pcb:
Copyright 2020 ISis ImageStream Internet Solutions, Inc.
Antennas/Panel_4x4_5GHz_Dual_XPol_1/Patches-Wider/Patches-Wider.kicad_pcb:
Copyright 2021 ISis ImageStream Internet Solutions, Inc.
parts and their libraries:
microbuilder: This work is placed in the public domain, and may be freely used for commercial and non-commercial work with the following conditions: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
Copyright 2016 Accelerated Designs. All rights reserved.
Copyright 2021 Accelerated Designs. All rights reserved.
